AquaBeacon/mechanical/parts/common/exterior/cots/td04a_transducer/ref/user_photo_metal_replacement_20261021.png

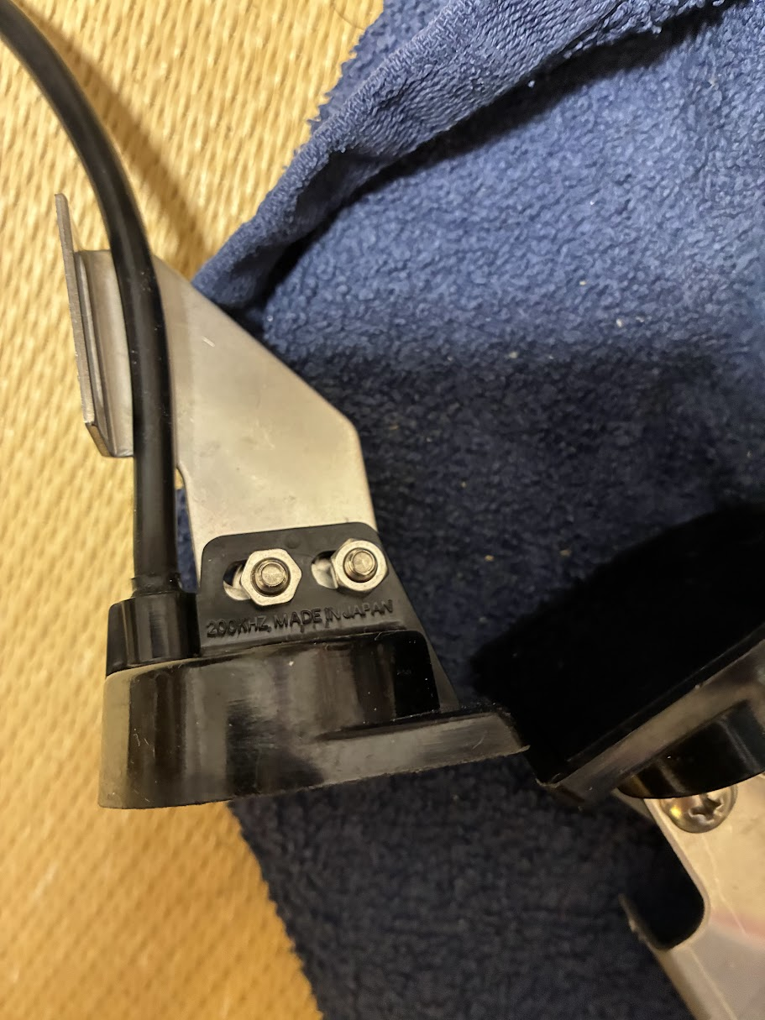
parts/common/exterior/cots/td04a_transducer/ref/user_photo_metal_replacement_20261021.png
