AquaBeacon/mechanical/docs/README.md

# 設計資料

- [AquaBeacon_機体設計](AquaBeacon_機体設計.md)
- [child_simple_mount_interface](child_simple_mount_interface.md)
- [子機横置き側面twist取付規格](child_horizontal_twist_interface.md)
- [design-workflow](design-workflow.md)
- [OpenSCAD / FreeCAD CAD基盤・編集手順・モデル分担](cad-foundation.md)
- [folder-organization](folder-organization.md)
- [X1C造形性監査](X1C造形性監査.md)
- [子機フランジねじ穴検証](子機フランジねじ穴検証.md)
- [子機内装_サービス設計](子機内装_サービス設計.md)
- [子機内装_収まり検討](子機内装_収まり検討.md)
- [子機外装_topopt実行計画_20260910](子機外装_topopt実行計画_20260910.md)
- [子機外装_改善要件](子機外装_改善要件.md)
- [子機外装フレーム再設計_要件](子機外装フレーム再設計_要件.md)
- [親機内装_収まり検討](親機内装_収まり検討.md)
- [部品一覧](部品一覧.md)
- [配線・ケーブル計画](配線・ケーブル計画.md)

- [親機・北側ペネトレータと床板の改訂](../assemblies/parent_hand_service/plate_access_report.md)（2026-10-27、現行の締結・着脱・印刷手順）
