AquaBeacon/mechanical/assemblies/parent_spar_concept/README.md

**印刷一式:** [parts/PRINT.md](parts/PRINT.md)（STL・数量・モディファイア） · **確認画像:** [_work/images/](_work/images/)

# parent_spar_concept

- [parent_spar_concept.md](parent_spar_concept.md)
- [adapter.step](adapter.step)
- [adapter.stl](adapter.stl)
- [coupler.step](coupler.step)
- [coupler.stl](coupler.stl)
- [disk.step](disk.step)
- [disk.stl](disk.stl)
- [fin.step](fin.step)
- [fin.stl](fin.stl)
- [hub.step](hub.step)
- [hub.stl](hub.stl)
- [parent_spar_concept.scad](parent_spar_concept.scad)

構成と既存の未検証事項は上の設計説明を参照してください。
