AquaBeacon/mechanical/spec/child_interior_reinforcement/README.md

> 2026-09-27現行: Bambu PLA Matte向け、60 mm根元・20 mm固定座・局所フランジ受け足、前側梁10 mm。印刷設定と解析の限界は spec/child_interior_reinforcement/PLA_MATTE_REVISION.md。以下の旧寸法・材料待ち記述は履歴です。

> 2026-09-27現行版：下リブ廃止、WetLink M10×5実配置、電池サービスねじをZ36へ移動。手順と検証は `spec/child_interior_reinforcement/SERVICE_REVISION.md`。以下は旧版の履歴を含みます。

> 現行版: 印刷部品による閉じた耳・31 mm根元補強。追加の金属スリーブ・板は廃止。強度解析は材料／荷重条件待ち。詳しくは `spec/child_interior_reinforcement/PRINTED_REINFORCEMENT.md`。以下は過去の履歴を含む。

# C-MAIN縦置き内装の固定部補強・LCD撤去

**現行は破損報告を受けた再補強版。[CRUSH_PROOF.md](CRUSH_PROOF.md)を参照。**
以下は最初の補強版の記録。

2026-09-26。対象構成はユーザー確認済み。

## 変更

デッキ左右ラグを丸い点状パッドから接線方向11.4 mmの丸端パッドへ変更。
基板端とチューブの間は狭いため、半径方向の最小肉厚は約0.8 mmを維持し、
接線方向の肉とデッキへ荷重を伝える斜めリブを増やした。
ラグ根元はX44.5..49.3、根元リブはZ20..29。
M3穴位置、MF10スペーサ、ラグ厚5.5、固定ねじM3×10は従来と同じ。

LCD、ベゼル、ヒンジ枠、上下アーチ、LCD専用ねじ・フォーム・ハーネスを組立から除外。
旧LCD部品ファイルは過去構成用に保存。
下アーチは専用child_flange_braceへ置換して3点固定を維持。
C-MAIN上側はM3×8なべねじ2本で固定する。

## 印刷と組立

交換する印刷部品はchild_vtray_deck_t200とchild_flange_brace。
デッキは板を寝かせてボス側を上、ブレースはZ5面をベッドへ。
外周5周以上を目安に固定耳と根元を密に充填する。
LCD用スペーサは下側のMF30 / MF17各1本のみ再使用し、上側は撤去。
新しくM3×8なべねじ2本を用意する。
フランジねじは樹脂が変形するほど締め込まない。

強度改善は形状に基づく設計判断。破壊荷重や安全率は未測定。
STL/STEP生成、基板穴照合、容器包絡、接触検査の結果は同フォルダのログに保存。
deck_before.scadとplacement_before.jsonは変更前の記録。

## 検証結果

- 基板3枚の取付穴位置・ねじ径：全点一致（holes.log）。
- チューブ包絡：干渉なし。デッキ最小すきま1.01 mm、ブレース1.11 mm。
  既存センタリングリブ0.50 mm、ライト配線0.54 mmは狭隙間WARN。
- 最終補強部：trimeshで水密、一体形状、周辺部品との新規干渉なし
  （changed_contacts.log）。スペーサ端面付近は梁を絞り、金属座の逃げを維持。
- 全内装接触検査：浮き部品なし。ただし既存の配線包絡同士、配線と基板等の
  重なりがあるため、全アセンブリを干渉ゼロと判定してはいない。
- OpenSCAD出力とFreeCAD STEP：外形・体積照合済み。
  旧inspect_meshの生エッジ判定はブレースの丸め誤差を開放辺と報告するが、
  頂点統合後のtrimesh検査では水密・1成分。
- 最終組立STEPを読み戻して配置照合：内装72部品、縦置き全体79部品とも
  NGゼロ（assembly_final.log）。

接触検査はサンプリング方式。実物の嵌合と耐荷重確認は未実施。
