AquaBeacon/mechanical/assemblies/parent_hand_service/retrofit_report.md

2026-10-24追補：Sony固定板は割れ対策の厚3.2 mm版を1個再印刷する。基板を1.6 mm上げる。再使用の対象からこの板を除外する。詳細は [増厚報告](sony_plate_thickening_report.md)。

# 親機内装・床板再利用改良（2026-10-24）

状態：実物嵌合確認用の試作設計。印刷入口は [parts/PRINT.md](parts/PRINT.md)。最終検査の機械可読記録は `_work/analysis/retrofit_20261024/release_record.json` と各 survey JSON。実物組立、積層強度、疲労、クリープ、防水性能は未認定。

## 再利用と交換

- 最下段 `floor_plate` はSCAD・STEP・STLのSHA-256を変更前と照合し、形状・穴を変更しない。再印刷・穴拡大・追加穴あけは不要。
- LiPo台・蓋・固定具、GNSS／磁気センサ支持枠、アンテナ鋼板を再利用する。
- MAIN固定板・アンテナラック・従来のMAIN/Sony/GNSSスペーサを新しい枠と固定柱へ交換する。
- コード巻リングはケーブル入口を上へ開いた `ann_mb1_coax_ring_service` に交換する。容器ねじの工具通路、床側の既存穴、巻き領域OD100/ID75/H10は維持する。
- 交換印刷は16種類16個。Sony固定板を含む。旧 `cradle_nut_keeper` 4個は使用しない。購入品の同軸ケーブル参照モデルは印刷しない。

## 配置

| 対象 | 変更 |
|---|---|
| MAIN基板 | 上へ3 mm、基板下面Z45。固定板の梁下面はZ37.1 |
| アンテナ・鋼板 | 南へ12 mm、上へ8.8 mm。アンテナ上端Z95.9 |
| 電源基板 | 元の向き（追加180°回転なし）のまま、南へ11 mm、上へ5.5 mm。基板下面Z33.8 |
| GNSS・磁気センサ支持枠と実装品 | 上へ16 mm。ユニバーサル基板下面Z72 |
| Sony・LiPo・TX | 位置を維持 |

RTCは現行CADの部品上端に10 mmを追加した予約空間で確認する。実測高さではない。アンテナ棚を南へ逃がし、ケーブルもこの予約空間から外す。

**ふた屋根Z97.1に対するアンテナ上の公称すきまは1.2 mm。** ケースの実寸・反り・アンテナ実物を確認し、ふたで押し込んで閉じない。既存ケースCADは図面由来で、実物測定済みを意味しない。

XTは差込方向20 mm、断面はCADコネクタ外形の各側へ2 mm追加した仮包絡。スイッチ操作は直径12 mmの西側進入包絡で検査する。実際のプラグ、指、工具の寸法は別途照合する。

## 締結の成立経路

床板上面へ開いた旧ナット穴を、上方向の引抜きを受ける面として使用しない。旧MAIN用4個とSony左奥の旧床ナットは取り除く。

| 締結 | 頭の座面から反力まで |
|---|---|
| GNSS/Sony柱の床固定 | 床裏のM3×20頭 → 座金 → 床板 → 柱下面 → 樹脂下穴。下側の公称かかり9.54 mm |
| コード巻・床側受け4点 | 床裏M3×20頭 → 座金 → 床板 → リング → 受けの樹脂下穴。公称かかり6.54 mm |
| 整備用4本 | M3×8頭Z36.84 → MAIN枠の足 → 床側受け上面Z33.4 → 樹脂下穴。公称かかり4.56 mm。床側ねじとの先端間隔0.50 mm |
| GNSS支持枠 | M3×10頭Z68.5 → 支持枠 → 柱上端Z66 → 樹脂下穴。キーを除く柱本体へのかかり7.5 mm |
| Sony固定板 | M3×10頭Z63.7 → 厚3.2 mmの固定板 → 柱上端Z60.5 → 樹脂下穴。キーを除く柱本体へのかかり6.8 mm |
| MAIN基板 | M3×8頭 → PCB → 一体ボス座面 → 樹脂下穴のねじ山。公称かかり6.35 mm、先端からボス下面まで1.5 mm |
| 電源基板 | M3×6頭 → PCB → アダプタ座面 → 樹脂下穴のねじ山。公称かかり4.35 mm、先端からボス下面まで1.15 mm |
| アダプタと床 | M3×8頭 → 1 mm沈めたねじ頭座面（残厚2 mm）→ アダプタ → 既存電源基板ボスの既存ねじ穴。公称かかり6 mm。樹脂ねじ部の保持力は実物未検証 |
| アンテナ棚とMAIN枠 | M3×30頭 → 棚 → Z50の接合面とキー → 下枠の樹脂下穴。キーを除く本体へのかかり7.6 mm。組立後はこの4本を整備で外さない |
| 鋼板・アンテナ | M3×8／M4×14頭 → 鋼板またはアンテナ足と鋼板 → 棚 → 下面から入れた六角ナット。上側の屋根が締付け力を受ける |

Sony左奥X144/Y211.5の床裏には容器ボスがあるため、そこへ裏ナット／ねじ頭を置かない。隣の既存GNSS床穴X135/Y219を使う低い連結部と2本の柱を一体化する。穴の追加はない。連結部の荷重下の変形・強度は未認定。

スペーサ・床側受け・MAIN枠の接合柱には内部ナット穴を設けない。旧ナットと抜け止めは使わない。アンテナ棚下面の6個は、印刷姿勢で上へ開く座のため継続する。樹脂下穴の締付け強度と繰返し着脱寿命は未検証。

## ねじとナット

改良部の必要数。既存部品から同じ規格のものは再利用できる。首下長の最大は30 mmで、50 mmを超えるねじは使わない。

| 金具 | 個数 | 用途 |
|---|---:|---|
| M3×6 | 4 | 電源基板を樹脂下穴へ直接固定 |
| M3×8 | 16 | 整備4、MAIN4、電源アダプタ4、鋼板4 |
| M3×10 | 8 | GNSS枠4、Sony固定板4 |
| M3×20 | 11 | 床裏から柱7・コード巻受け4 |
| M3×30 | 4 | アンテナ棚とMAIN枠 |
| M4×14 | 2 | アンテナ足 |
| M3ナット AF5.5×厚2.4 | 4 | アンテナ棚の鋼板固定。底面に開いた座のみ |
| M4ナット AF7×厚3.2 | 2 | アンテナ足 |
| M3座金 外径7／内径3.2／厚0.5 | 11 | 床裏 |
| M3×12 | 4 | 既存GNSSユニバーサル基板のM3×10から交換。既存M3ナット4個を再利用 |

ケース固定、LiPo、Sony基板、TX、磁気センサの金具は既存構成を引き継ぐ。新しい金具寸法は設計包絡であり、手持ち品の実測値ではない。六角穴頭の公称包絡はM3が径5.5×高さ3、M4が径7×高さ4。実物の頭・ナット・ねじ先端面取りを確認する。

## 組立順序

1. 電源とLiPoを外し、既存内装をケースから取り出す。床板・LiPo固定具を傷めず旧支柱と不要な床ナットを取り外す。
2. 内部ナット穴のない床側受け4個をコード巻リングに合わせ、床裏から座金＋M3×20を受けの下穴へ直接締める。床板とリングを確実に挟む。
3. GNSS/Sony固定柱を共有柱も含め床裏から7本のM3×20で直接固定する。上側の支持枠・固定板はM3×10を柱へ直接締める。
4. 電源アダプタを既存4穴にM3×8で固定し、元の向きの電源基板をM3×6で樹脂下穴へ直接取り付ける。XTの先20 mmとスイッチ操作路を空ける。
5. 既存GNSS／磁気センサ枠、新しい厚3.2 mmのSony固定板と実装品を新しい柱へ取り付ける。GNSSユニバーサル基板の4本はM3×12へ交換する。
6. MAIN基板をM3×8でMAIN枠の樹脂下穴へ直接取り付ける。アンテナ棚をキーに合わせて載せ、M3×30を4本締める。棚下面のナットを入れ、鋼板M3×8・アンテナM4×14を固定する。棚が分かれるので、実装済みMAINを狭い屋根の下へ滑り込ませる必要はない。
7. 同軸を巻き、左側の開いた入口へ2本の引出しを通す。アンテナ側の約235 mmの整備ループを確保する。ループを締め付けて固定しない。
8. 床をケースへ戻し、容器固定ねじを操作する。MAIN＋アンテナを載せ、整備用M3×8を4本締める。配線を戻し、ふたと各部品の実物クリアランスを確認する。

## 日常のコード巻整備

電源を切り、MAINにつながる必要な配線とGNSS側SMAを外す。床側受けへ締まる**M3×8の4本だけ**を外す。アンテナ側の余長を自由にし、MAIN＋アンテナを一緒に上へ持ち上げる。MAIN枠の側壁・アンテナ棚は一緒に残り、短い受けとコード巻は床側に残る。

上方120 mmの剛体部品の全経路を保守的な連続包絡で検査する。ケーブルは剛体移動させず、余長をゆっくり解く。端を引っ張らない。ケーブル変形・実際の巻き量・コネクタ取り外しの実物試験は未実施。

南西と北西の容器固定ねじはユニットを外してから既存の傾斜工具路で操作できる。南東側は既存LiPo台の手順を引き継ぐ。工具穴を配線で塞がない。

## 印刷

PETG、0.4 mmノズル、0.2 mm積層、壁4周、100%充填を基準とする。配布STLは製造設定の姿勢に合わせてベッド上へ移動済み。

- MAIN枠：下側をベッドへ。梁下面に必要な局所サポートは、組立前に開いた下面から除去する。
- アンテナ棚：鋼板の座面をベッドへ向ける。基本形状はこの姿勢で立ち上がる。
- 固定柱・受け・アダプタ・リング：平らな下面をベッドへ。細い柱にはブリムを付ける。
- 旧抜け止め4個：今回の内部ナット穴なし版では使用も印刷もしない。
- 側入れナット座の幅約6.7 mmは橋渡しとして扱い、取り出せない支持材を入れない。穴・座面・入口のバリを除去し、別体のナットで嵌合を確かめる。

閉メッシュ、CAD干渉、締結経路の形状検査は、実印刷や締付け強度の合格を意味しない。検査結果と未検証範囲は release_record と survey JSON を参照する。

## 再生成

形状の正本は `scad/lib/parent_service_retrofit.py`。既存 `spec/build_parent_hand_service.py --service-retrofit` から生成する。MAIN固定板の共通関数を再利用し、床板生成は実行しない。リング改訂は既存の `ann_mb1_coax_ring.step` への局所的な入口加工で、元のリングを上書きしない。各部品は従来の部品フォルダ内に1か所だけ置く。

独立FreeCAD検査用の入口は `spec/build_parent_service_retrofit_candidate.py`。配置、金具、サービス動作の検査後に `spec/publish_parent_service_retrofit.py` で反映し、assemblyを再ビルドして印刷一式を同期する。過去の裸の全体生成手順で古い配置へ戻さない。

## スライス確認結果（2026-10-24）

X1C／0.4 mm／Generic PETG／0.2 mm／壁4周／100%充填で2プレートをスライスした。設定済み [プレート1](print_jobs/retrofit_20261024/retrofit_plate_1.3mf) と [プレート2](print_jobs/retrofit_20261024/retrofit_plate_2.3mf) をプロジェクトとして開く。2枚で16個。予測は約161 g、合計約6時間20分（実印刷時間ではない）。

全19個に初層と上端付近の外周出力があり、造形範囲内に収まる。自動サポート45°、橋渡し除外OFF、局所支持材禁止を有効にした。ナット座・盲穴内部・抜け止め溝の検査域に支持材経路なし。MAIN枠の床面から3.7 mmまでの開いた梁下面、リング下面、Sony固定板の底面へ開いた位置決め凹部4か所の局所支持材は組立前に除去する。スペーサの縦下穴内には支持材経路がない。ボルト穴の下の空間にも支持材があるため、下側から完全に除去してからねじを入れる。

[実出力層・プレート1](_work/images/retrofit_plate_1_layers.png) と [プレート2](_work/images/retrofit_plate_2_layers.png) を確認した。小さな橋渡し、PETGの垂れ、嵌合と実締付けは実印刷で確認する。STLで再スライスする場合は parts/modifiers の該当ファイルを支持材禁止として読み込み、部品と同じ座標を保持する。モディファイア自体を印刷しない。

今回の基板直接固定版は2プレートともスライサが正常終了し、16個の実G-code経路と支持材禁止領域を検査した。前版の終了タイムアウトと回復検証は履歴として `_work/analysis/retrofit_20261024/slicing/timeout_recovery_review.json` に残す。

16種類のOpenSCAD再レンダリングは閉メッシュで、元STLとの外形差0.01 mm未満・体積差0.1%未満。棚下面のナット締結形状6箇所、基板の樹脂直接固定8箇所、支柱等の樹脂直接固定27箇所、床裏座面11箇所、選択した干渉1454組、剛体取り外し全経路を検査した。全組合せの接触検査、振動・衝撃強度や実物の合格を意味しない。

## 組立出力とリポジトリ検査

閉状態137部品、整備姿勢129部品のSTEP再読込・配置検査は不一致0。組立表示は [閉状態](closed.step) と [整備姿勢](service.step)。[閉状態画像](_work/images/retrofit_closed.png) と [取り外し画像](_work/images/retrofit_service.png) を確認済み。

親機改良の印刷一式と作業ファイル配置の検査は合格。全構成の検査には既存の別構成6件の更新不整合が残る（parent_integrated、parent_interior_p1/p2、parent_rope_float、parent_service_review、parent_spar_bolted）。対象は既存 parent_interior_layout.py や旧リポ固定具・説明の不一致で、今回の改良形状を反映する目的では変更していない。ツールテスト42件中41件合格、子機クランプの既存材料カード不足による1件のエラーは未解消。

改良前配置から検査を再実行するときは placement_before_retrofit.json を入力依存ファイルに含める。検証の元入力と生成元のハッシュは各release runのjob.jsonに保存されている。現行配置へ同じ移動量を二重に適用しない。

## 電源基板の元の向きとPico高さの追補

ユーザー指定により電源基板の追加180°回転を取り消した。旧位置から南11 mm・上5.5 mmに置き、XTの前方20 mm（断面はコネクタ外形に各側2 mm追加）を空ける。MAIN枠は後端中央だけに逃げを設け、四隅のボスと左右の支持経路を残した。床板・LiPo固定具は変更しない。直前版から設計形状を変更した印刷部品は main_service_frame と power_adapter。再生成時の面分割で他STLのハッシュが変わる場合がある。

Pico 2 WはMAIN基板上面Z46.6から17 mm、上端Z63.6の包絡で確認した。XYは22×54.6 mm（モデル外形へ片側0.5 mm追加）。アンテナ棚まで3.8 mm、鋼板まで8.8 mm。高さ18 mmの確認用包絡でも棚まで2.8 mm残る。Pico包絡を含む上方120 mmの整備動作も検査した。表示用MAIN基板の既存STEPには低いPico参照モデルが含まれるため、高さ判定は表示の見た目ではなくこの実測条件の包絡による。

今回の検査入力・出力は `_work/analysis/retrofit_20261024/orientation_review`、採用した各CAD runは更新済みrelease_record.json。14 mm以上の前方移動案には干渉があり採用していない。固定ねじの頭を1 mm沈めた4箇所は、下向き0.1 mmの反力面検査で頭と座面、アダプタと床ボスの接触を確認した。樹脂ねじ部の実物保持力、プラグ実物、手作業の取り回しは未試験。

## 基板の樹脂直接固定への変更

MAIN4か所・電源基板4か所のナット穴を廃止し、子機child_vtray_deckの公称Ø2.8 mmを参考に、内接径2.8 mmの補正八角下穴へM3ねじを直接締める。MAINはM3×8、電源基板はM3×6。穴入口は0.15 mm面取り。既存のボス外形・座面高さ・基板配置を維持し、初回は基板を載せる前にねじを垂直に手で馴染ませ、切粉を除く。電動工具で締め込まない。

締結経路はねじ頭→PCB→樹脂座面→下穴に形成されるねじ山。図面上のかかり長さは完全な有効ねじ山長さや強度保証ではない。実物のねじ形状、PETGの成形誤差、締付けトルク、繰返し脱着寿命は未確認。下穴とねじ山包絡の干渉は意図したかみ合いとして、他部品との干渉から区別して検査する。8か所の軸方向12断面、下穴の貫通、先端余裕、PCBを介した両座面の反力を記録する。

この段階では日常整備の4本・床側・棚接合をナット式としていたが、次節の改訂で樹脂直接固定へ変更した。既存のGNSS・Sony・磁気センサ固定具はこの変更の対象外。最下段プレートの再印刷・追加加工は不要。今回再印刷する変更部品はMAIN枠と電源アダプタの2種類。検査記録は `_work/analysis/retrofit_20261024/direct_pcb/`。

変更部品の確認画像：[MAIN枠](_work/images/main_service_frame_direct_pcb.png)、[電源アダプタ](_work/images/power_adapter_direct_pcb.png)。

## スペーサ内部ナット穴の廃止（現行）

造形失敗への対応として、GNSS/Sony支柱7部品、床側受け4部品、MAIN枠の棚接合柱4か所から、計27か所の内部ナット穴を撤去した。縦方向の内接径2.8 mm下穴へM3ねじを直接締める。側入れ穴・閉じた六角空洞・ナット抜け止め溝をなくした。抜け止め4個は構成から除外し、印刷一式は16種類16個となる。

床側受けは下M3×20／上M3×8で先端間隔0.50 mm（公称）。実ねじの長さ・先端を確認し、長いねじに置き換えない。底側の固定は床板とリングを挟み、整備時は上側の4本だけを外す。ナットが落ちる構造はなくなるが、樹脂ねじの摩耗寿命は未確認。最下段プレートとLiPo固定具の再印刷・加工は不要。

直前の基板直接固定版からの変更対象はMAIN枠、床側受け4種、GNSS/Sony支柱7種。アンテナ棚の下面に開いたナット座6個はスペーサ内部の空洞ではなく、印刷時に上へ開くため残す。既存GNSS基板・磁気センサ等の金具は継続。検査記録は `_work/analysis/retrofit_20261024/plain_spacers/`。

並行作業で確定したSony固定板の厚さ3.2 mm・基板高さ+1.6 mmも取り込み、印刷一式へSony固定板を追加する。支持面Z60.5は維持、上側M3×10の頭座はZ63.7。Sony板は旧品再使用ではなく新版を印刷する。基板下面はZ67.2となり、再生成後の周囲との干渉を追加検査する。

[スペーサの外観と縦断面](_work/images/plain_spacers_review.png)：手前は完成形、奥は検査用の半断面。床側受け・GNSS柱・Sony柱とも縦下穴だけで、内部ナット座と横挿入穴はない。断面モデル自体は印刷しない。
