AquaBeacon/mechanical/assemblies/parent_hand_service/sony_plate_thickening_report.md

現行スペーサは後続改訂で内部ナット穴を廃止し、M3×10を樹脂下穴へ直接締める。増厚寸法・座面高さは本書の値を継続する。最新の支柱固定・スライス結果は [内装改良報告](retrofit_report.md) を参照。以下のナット保持検査は増厚時点の履歴。

# SPRESENSE固定板の増厚 — 2026-10-24

ねじ止め時に固定板が割れた実物報告を受け、`sony_mount_plate` の肉抜き板と支柱ねじ座を厚1.6→3.2 mmへ変更した。設計寸法は `scad/lib/parent_gnss.py`、形状の正本は既存 `scad/lib/parent_corner_mounts.py` の `sony_shapes`。対象だけの再生成入口は `spec/build_parent_sony_plate.py`（既存CadServiceのbuild_native）。

再印刷は [parts/sony_mount_plate.stl](parts/sony_mount_plate.stl) **1個**。印刷入口は [parts/PRINT.md](parts/PRINT.md)。PETG、0.2 mm層、4周壁、100%充填、板下面をベッドへ向ける。既存の柱・穴位置・位置決めキー・板外形64×84 mmは維持する。キー穴入口は既存の取合い寸法、外周・肉抜き縁は既存0.15 mm面取り。

板下面Z60.5、板上面Z63.7、基板ねじ座上面Z67.15。基板原点はZ65.6→67.2、基板用M2.5×6ねじ頭の座面はZ68.8。基板裏面と板の公称余裕0.55 mm、TX予約上面と板下面の隙間0.305 mmは維持。基板と配線を外して交換し、上側の基板を元より1.6 mm高く取り付ける。

締結経路は、支柱固定用M3×10の頭座面Z63.7→厚3.2 mmの固定板→支柱上面Z60.5→支柱の反力部。ねじ先端Z53.7、支柱側の公称かかり6.8 mm。基板用M2.5×6は基板厚1.6 mmを挟み、ねじ座へ約4.35 mmかかる。ねじ先端Z62.8で板下面より2.3 mm上にある。上面へ抜けるナットだけに頼った固定として扱わず、今回の配置にある支柱ナットの+Z保持面と着座も検査した。支柱上部は組付け前にアクセスでき、板を外す際は基板を先に外す。

検査記録は [_work/analysis/sony_plate_thickening_20261024/geometry_checks.json](_work/analysis/sony_plate_thickening_20261024/geometry_checks.json)。FreeCAD有効単一ソリッド、保存・再読込、閉STL、周辺形状との干渉、支柱ねじ4本の頭座・穴通過・かかり、ナット保持面、基板ねじ4本の長さを確認した。旧薄板は同解析フォルダ内のhistoryへ保持する。

X1C・0.4 mm・Generic PETG・0.2 mm層・4壁・100%充填で実スライス済み。見積り9.34 g、30分29秒。45°自動支持・全表面・橋の支持除外なしで104移動の支持押出しがある。下面のキー穴付近の支持を除去し、座面と穴を確認する。初層・キー穴天井・板上面・ねじ座の実経路を確認した。[設定済み3MFと検査記録](print_jobs/sony_plate_thickening_20261024/README.md)。

厚くした形状の幾何・スライス検査であり、締付トルク・樹脂ねじの保持力・反復寿命・割れ防止の実物保証ではない。実印刷後は座面のバリや支持材を除去し、基板を反らせない範囲で締める。旧Sony板のスライス・強度記録を新版の合格根拠には使わない。

印刷一式は17種類20個（今回再印刷するのはSony板1個）。対象の出所・数量検査と作業ファイル整理検査は合格。全体出所チェックでは対象外の親機6構成に再ビルド／再同期の指摘が残る。共通テスト42件は41件合格、対象外 `child_wte4_suspension_clamp/spec/bambu_petg_basic_material.json` 欠落で1件エラー。今回の部品形状の不合格ではなく、全リポジトリ合格とは報告しない。ログは同解析フォルダの `global_parts_check.log` と `unittest.log`。

統合版のスライス確認：`print_jobs/retrofit_20261024/retrofit_plate_2.3mf` に厚3.2 mmの板を1個配置。X1C・Generic PETG・0.4 mmノズル・0.2 mm積層・壁4周・100%充填で実G-codeを確認。底面に開く位置決め凹部4か所の支持材は、組立前に下側から除去する。支持材不要ではなく、実印刷・嵌合・締付けは未確認。出力ハッシュは同フォルダmanifest.json。
