AquaBeacon/mechanical/assemblies/parent_hand_service/unified_support_report.md

# 2026-10-29 床板下面の開放ナット座

現行の印刷入口は [parts/PRINT.md](parts/PRINT.md)。床板の裏面からM3ナットを差し込める六角くぼみを11か所設け、上からの貫通ねじで固定する。ナットは印刷完了後に取り付ける。印刷途中の埋込みや横挿入トンネルはない。

## 形状と締結

ナットは対辺5.5 mm・厚さ2.4 mmの既存M3モデル、六角くぼみは対辺5.8 mm・深さ2.6 mm。入口に0.15 mmの案内面を設ける。床板下面Z8.84、ナット受け面Z11.44、床板上面Z18.8。受け面から床上面まで7.36 mmを残す。六角の回り止め面と平らな反力面は機能面として角を保持する。

右端2か所はケース壁へ部品を広げず、既存の床端にくぼみが一部開く。ナットの回転と締付け方向の移動が残る面で止まることを検査対象とする。緩めたナットを下向きに保持する構造ではないため、組立時はケース外で床を横向きにし、指でナットを押さえてねじを数山かける。接着剤は不要。

| 固定箇所 | ねじ・ナット | 締結経路 |
|---|---|---|
| MAINの4点 | M3×30＋M3ナット、各4 | 頭（Z35.6）→MAIN枠→床側受け→同軸リング→床板→下面ナット |
| GNSS支持枠4点 | M3×65＋M3ナット、各4 | 頭→GNSS固定板→50 mmの足→床板→下面ナット |
| Sony支持枠3点 | M3×65＋M3ナット、各3 | 頭→Sony固定板→50 mmの足→床板→下面ナット |
| Sony後左1点 | M3×10、1本 | 上板→足の樹脂下穴。ケースのボスを避け、床貫通ねじは追加しない |

締めると、上のねじ頭が上板／枠を下へ押し、下面ナットが床板内の受け面へ上向きに引かれる。この経路で床板を挟む。床用の座金9枚と、従来の下面からのねじ11本は使用しない。長いねじの経路は通し穴へ変更し、樹脂ねじとの二重締結にしない。

Sony/GNSSの各4本の足は一体構造のまま。床上面から上板下面まで50.0 mm、位置決めキーは別に0.8 mm。基板・配線の高さと配置、M4頭逃げ、北側ペネトレータ2個を残して内装を引き抜く形状は維持する。

## 組立・取り外し

ケース外で床板・受け・同軸リング・支持枠・上板を合わせる。下面からナットをくぼみへ入れ、上からねじを差し、床を横向きにしてナットを指で仮保持しながら数山かける。全ねじを軽く合わせてから締める。MAINはアンテナ棚を取り付ける前に固定する。Sony後右のねじはSPRESENSE基板が工具通路を塞ぐため、支持枠のねじを先に締め、その後で基板を取り付ける。分解・増締めは先にSPRESENSE基板の固定4本を外して基板を退避する。基板を載せたままでの工具アクセスは未達であり、保証しない。蓋を外した状態で上側から工具を入れる。

内装全体の取り出しはケース側配線とM4固定3本を外し、真上へ120 mm持ち上げる手順を維持する。ナットは締結中には床裏へ抜けない。支持枠やMAINを分解するときは内装をケース外へ出し、ねじを抜く前に床裏のナットを受ける。

## 印刷

再印刷は床板、MAIN枠、Sony支持枠、GNSS支持枠の4個。一式は15種類・各1個で、上板などは再使用する。PETG／X1C 0.4 mm／0.2 mm・壁4周・100%充填。下面をベッドへ置く元の印刷姿勢を維持する。床のナット座は下面へ開いており、天井の短い橋（最大約6.7 mm）は局所支持材禁止モディファイアを使って検査する。実造形の橋品質は試作確認。印刷途中でナットを挿入する停止工程はない。

変更前の形状・配置・文書は `_work/analysis/underside_nuts_20261029/history/` に保存。既存Python生成元を更新し、STLとSTEPを同じ形状から生成する。位置と個数はplacement.jsonが正本。

幾何検査と実物の締付け強度を区別する。樹脂の座面耐力・クリープ・波浪・実印刷・実工具・ハーネスの余裕は未認定。

## 検証記録（2026-10-29）

組立CADの357項目がPASS。11か所について、下面からの連続挿入、ナットとケースの非干渉、締付け方向への移動が床の受け面で止まること、両方向10°の回転が六角面で止まること、ねじの全ナット厚へのかかり、上側の座面と工具通路を検査した。足の一体性・50 mm、M4頭、蓋・実装部品との干渉、M10を残す引抜き経路も再検査した。

Sony後右は、基板を装着したままでは工具が干渉する。これは合格に読み替えず、SPRESENSE基板を外すことを作業の前提条件として記録した。締結済みのねじ頭と基板自体は非干渉。

根拠は [_work/analysis/underside_nuts_20261029/assembly_checks.json](_work/analysis/underside_nuts_20261029/assembly_checks.json)。[底面図](_work/images/underside_nut_floor.png)と[GNSS締結断面](_work/images/underside_nut_clamp_section.png)を保存した。

同時に変更された電池本体・蓋は上方取り外し版を保持する。電池側の交換部品と手順は [電池蓋の改訂報告](battery_top_lid_report.md) を参照。今回の床・支持枠4部品の交換とは別の変更である。

共通ツールの単体テストは42件中41件成功。既存の子機用bambu_petg_basic_material.json欠落により1件失敗。記録は `_work/logs/underside_nuts_unit_tests.log`。

### 印刷データの検査

変更4部品を2プレートへ配置し、支持材自動検出を有効にしてスライスした。ナット座11か所と検査対象のねじ通路に支持材押出しは0。床のナット座付近でブリッジの経路を確認した。4部品とも最初のモデル外周はZ0.2 mm、最終外周はモデル上端まで出力されている。実物のブリッジ品質と締付け強度は未確認。

- [プレート1：床板](print_jobs/underside_nuts_20261029/parent_underside_nuts_1.3mf)
- [プレート2：MAIN枠・Sony支持枠・GNSS支持枠](print_jobs/underside_nuts_20261029/parent_underside_nuts_2.3mf)
- [設定・STLハッシュ・G-code検査記録](print_jobs/underside_nuts_20261029/manifest.json)

局所支持材禁止モディファイアはparts/modifiersへ同梱。変更していない関連7部品は現行生成元から再生成し、既存STLと完全に同じSHA-256であることを確認して鮮度を揃えた（`_work/analysis/underside_nuts_20261029/unchanged_rebuild_checks.json`）。電池側の部品データは置換していない。

組立状態・サービス状態のSTL/STEPを再生成し、STEP照合も完了。印刷用4部品は3MF記録のSHA-256と一致。parent_hand_serviceの印刷一式検査と作業ファイル配置検査はPASS。全構成の検査では対象外7構成に既存の未同期／管理外ファイル等が残る（`_work/logs/underside_nuts_all_parts_check.log`）。

---

以下は2026-10-28以前の変更履歴。床下面から樹脂下穴へ締める手順・ねじ長・旧3MFを今回へ適用しない。

# 一体支持枠と埋め込みナット廃止（2026-10-27）

現行の設計方針と手順はこの文書を正本とする。[印刷入口はparts/PRINT.md](parts/PRINT.md)。前回の床内部へ横からナットを挿入する構造と、独立したSony／GNSS柱は廃止する。埋め込みナットを残した前回のSTL・3MFを今回の部品と混ぜない。検査結果は末尾へ追記する。実印刷・締付け・強度の認定ではなく、嵌合確認用の試作。

## 足を一部品へまとめる

SPRESENSE側はsony_support_frame、GNSS側はgnss_support_frameを各1個使う。それぞれ4本の足を下側の連結材でつないだ単一ソリッドで、組立時に個別の足を支えたり向きを合わせたりする必要をなくす。上の固定板は別部品として着脱する。

両方の足の長さは、床板上面Z18.8から固定板下面Z68.8までの50.0 mm。位置決めキーの高さ0.8 mmは足の長さに含めない。SPRESENSE固定板・基板一式は前回より8.3 mm、GNSS固定板・基板・磁気センサは2.8 mm上へ移動する。基板の穴配置と取付相手は維持する。配線には高さ変更分の余裕が必要。

Sony側は北へ開いたU字枠。前側の連結材は幅4 mm・高さ4 mm、中心Y131.4で、電池台の北端とTX基板の下面ピンの間を通す。TXの実取付穴に対応する床側座へ半径3.8 mmの逃げを設け、前側に公称2.3 mmの連結幅を残す。後側のTXねじ座と北側ペネトレータへ連結材を渡さない。GNSS側の左連結材は北西のM4頭とケース隅の柱を回避して曲げる。足と連結材は下面をベッドへ向ける原姿勢で印刷する。外周と接合部に0.1 mm、穴口に0.15 mmの面取りを設ける。ねじ下穴の指定断面と平らな接合面は機能寸法を優先する。

## 埋め込みナットを使わない締結

床板は普通の通し穴に戻し、内部の六角穴、横挿入口、ナットを覆う屋根をなくす。床の下面からねじを上向きに入れ、支持部品の樹脂下穴へ締める。頭と支持部品の間に床板を必ず挟む。樹脂下穴はM3用の内接径2.8 mm、8角形とし、既存の直接ねじ止めと同じ設計値を使う。ねじ山の耐力・適切な締付けトルク・繰返し着脱は実物確認が必要。

| 箇所 | ねじ | 固定の経路 |
|---|---|---|
| MAIN枠の床固定4点 | M3×30、下面から上向き | 頭 → 外付け座金 → 床 → 同軸リング → 床側受け → MAIN枠の樹脂下穴。公称かかり4.94 mm |
| GNSS支持枠の床固定4点 | M3×16、下面から上向き | 頭 → 外付け座金 → 床 → 一体支持枠の樹脂下穴。公称かかり5.54 mm |
| Sony支持枠の床固定3点 | M3×16、下面から上向き | 頭 → 床 → 一体支持枠の樹脂下穴。左前のみ外付け座金を使用し公称かかり5.54 mm、右2点は頭を直接座面に当て公称6.34 mm |
| GNSS固定板4点 | M3×10、上から | 頭 → 固定板 → 50 mmの足の上端・樹脂下穴。公称かかり7.5 mm |
| Sony固定板4点 | M3×10、上から | 頭 → 固定板 → 50 mmの足の上端・樹脂下穴。公称かかり6.8 mm |

Sony後左の足の下にはケースの既存ボスがあるため、新しい床貫通ねじは追加しない。床に着座させ、他の3本へ連続する枠で保持する。以前のGNSS／Sony共有柱と柱内部のナットは使わない。

右端のSony床ねじ2点は、座金と座面をケース壁へ拡張せず、既存のM3頭径5.5 mmを床下面の深さ0.3 mm・径5.7 mmの開放座ぐりへ直接当てる。旧穴入口の面取りを座面から除去し、平らな環状座面で受ける。これは埋め込みナット穴ではない。座ぐりの反力面の縁は機能面として保持する。頭の座面と穴の間の公称半径方向肉厚は1.0 mm。座面の接触とケースとの干渉を検査対象に含める。この寸法を締付け強度の保証として扱わない。

前回のM3×60／65の長い貫通ねじ、床ナット11個、Sony共有柱のナットは使用しない。床固定用のM3座金は外径7・厚0.5 mmを9枚使用する。固定板の上向き位置決めキーはねじの代わりの抜け止めではない。

ほかの印刷部品のナット埋め込みも廃止する。電池蓋は従来のM3×12を、電池台の縦2.8 mm下穴へ直接締める（公称かかり9 mm）。アンテナ棚の鋼板とアンテナは、棚下面へ露出したナットと座金で挟む。鋼板用はM3×10／M3ナット／M3座金を各4、アンテナ用はM4×18／M4ナット／M4座金を各2。ナットは棚をMAIN枠へ載せる前に外から保持して締める。磁気センサも底面へ露出したナイロンM2ナット・厚0.5 mmの座金とM2×10で固定する。GNSS基板の既存の下面露出ナット、ケースの購入品インサート、WetLink付属ナットは維持する。

## 組立と取外し

1. 床板をケースの外で組む。2個の支持枠とMAIN側の受け・同軸リングを載せ、床下面からねじで固定する。ナットの挿入や仮保持は不要。
2. 各上板へ基板を取り付ける。GNSS基板と磁気センサのナットは、上板を足へ載せる前に下から保持して締める。
3. 上板を4本の足のキーへ合わせ、それぞれ4本のM3×10で固定する。
4. アンテナ棚は外付けナットで鋼板・アンテナを先に固定し、その後でMAIN枠へ取り付ける。
5. 電池蓋をM3×12で台の縦下穴へ固定する。下穴を空回りさせる締付けや長すぎるねじを使わない。
6. WetLink M10と付属ナットを2個ともケースへ残し、北側の切欠きを合わせて内装を下ろす。ケースのM4固定3本を締め、配線を接続する。
7. 内装を取り出すときは配線とM4固定3本を外し、真上へ120 mm持ち上げてから箱の横へ移す。床下面のねじを外す必要はない。WetLinkナットへの専用レンチ操作は内装取外し後に行う。

北側穴は、A面を外から見た左端から35／60 mm、箱座標X175／150、外底面から高さ30〜35 mm。M4頭の逃げ10.8 mmと北側の開放切欠きは維持する。実M4の頭高さ・首下長さは未測定で、頭10×高さ5 mm、首下12 mmの参照包絡を継続する。専用M10レンチの通路は検査するが、任意のスパナ、ラチェットの柄、実ケーブルは共通の保証対象ではない。

## 印刷するもの

一式は15種類15個。変更する印刷部品は、床板、MAIN枠、アンテナ棚、電池台、GNSS固定板、Sony一体支持枠、GNSS一体支持枠の7個。Sony上板、同軸リング、電池蓋、電源アダプタ、MAIN側の床受け4個は同じ形状の既存品を再使用できる。

PETG／X1C 0.4 mm／0.2 mm積層／壁4周／100%充填を引き継ぐ。アンテナ棚は上面をベッドへ向けて反転、それ以外の変更部品は下面をベッドへ向ける。同梱STLは製造姿勢へ変換済みで、部品配置の回転を追加しない。支持枠には3 mmの外ブリムを使用する。ナットをまたぐ大きい屋根はなく、縦の樹脂下穴の止まり部分だけに最大約3.2 mmの小さい橋が残る。これはナット埋め込み穴ではない。実際の橋の品質とねじの嵌合は試作で確認する。

印刷一式の支持材禁止モディファイアも同じparts内へ含める。スライスでは支持材検出を有効にして下穴内の押出しを検査する。単に支持材を無効化した結果を造形成立の証拠にしない。

## 正本と検証

寸法と締結表はscad/lib/parent_service_datums.py、支持枠とMAIN／棚は既存parent_service_retrofit.py、床はparent_floor_access.py、電池台とGNSS上板は既存の生成元を更新する。出力SCAD、印刷STL、STEPを別々に設計しない。配置・数量の正本はplacement.json。

再生成は次の順で、各段階の成功を確認する。

```powershell
python spec/revise_parent_floor_access.py
python spec/revise_parent_floor_access.py --related
python spec/publish_parent_plate_access.py --prepare
python spec/revise_parent_floor_access.py --verify
python spec/publish_parent_plate_access.py
python spec/publish_parent_plate_access.py --assemblies
python spec/slice_parent_plate_access.py
python tools/assembly_parts.py check parent_hand_service
```

今回の変更前の原本と印刷形状は、_work/analysis/unified_support_20261027/history/へ保存する。前回のplate_access_report.mdと解析記録は履歴として保持する。STLの閉メッシュ、配置照合、干渉、締結経路、造形、実物の強度を区別して報告する。材料下穴の耐力、締付けトルク、クリープ、波浪、実配線、密閉・防水は未確認。

## 2026-10-28 引継ぎ後の検証結果

組立CADの239項目がすべてPASS。各4本の足は肩まで50.0 mm、キーを含むSTL高さは50.8 mm。両支持枠は単一ソリッド・閉メッシュ。床・上板との着座、樹脂下穴のかかりと底付き余裕、外付けナットの反力面、蓋との非干渉、M4頭、M10を残した連続引抜きとケース外での専用工具経路を確認した。

引継ぎ候補にあったSony前側連結材とTX取付座の干渉を、連結材移動と取付座の局所逃げで解消。右側床ねじ2点の座面は浅い座ぐりで平面化し、接触面積13.610 mm²を確認した。接触面積のみで強度を認定していない。全形状の新規剛性解析・実締付け・実印刷・実配線は未確認。

検査詳細は [_work/analysis/unified_support_20261027/assembly_checks.json](_work/analysis/unified_support_20261027/assembly_checks.json)。各生成と検査の入力ハッシュ・STEP/STL再読込は同フォルダのfloor_run.json、related_run.json、verification_run.jsonが指す独立runへ保持。確認画像は [_work/images/unified_support_assembly.png](_work/images/unified_support_assembly.png)（支持枠を青、対象基板を緑で表示。他部品は一部省略）。

共通ツールの単体テストは42件中41件成功。子機用のbambu_petg_basic_material.jsonが存在しないため1件失敗しており、親機の形状検査とは別の既存リソース欠落として記録する。

### スライスと納品

変更7部品をX1C／0.4 mm／PETG／0.2 mm・壁4周・100%充填で3プレートへ配置。支持材自動検出45°と橋の支持を有効にし、機能穴だけを局所モディファイアで除外した。全7部品で最初のモデル外周がZ0.2 mm、最後の外周が外形高さまであること、検査対象の下穴・座ぐりに支持材押出しが0であることをG-codeで確認。Sony/GNSSの止まり穴の短い橋の出力も記録した。実造形の橋品質と樹脂ねじの嵌合は未確認で、全面サポート不要とは認定していない。

- [プレート1：床板](print_jobs/unified_support_20261027/parent_unified_support_1.3mf)
- [プレート2：MAIN枠・アンテナ棚・Sony支持枠](print_jobs/unified_support_20261027/parent_unified_support_2.3mf)
- [プレート3：電池台・GNSS支持枠・GNSS固定板](print_jobs/unified_support_20261027/parent_unified_support_3.3mf)

STLハッシュ・配置・設定・検査結果は [スライスmanifest](print_jobs/unified_support_20261027/manifest.json)。同じ部品をpartsのSTLから重複印刷しない。追加した座ぐり・MAIN下穴・電池蓋下穴の支持材禁止形状はspec/slice_parent_plate_access.pyが生成し、parts/modifiersへ同梱する。印刷部品ではない。

現行parent_hand_serviceの出所・数量・鮮度チェックはPASS。全構成チェックでは他の7構成に不一致が残る。parent_integrated等の派生／旧構成は今回更新していない。詳細は [_work/logs/unified_support_all_parts_check.log](_work/logs/unified_support_all_parts_check.log)。画像・中間ファイルの整理検査はPASS。

閉状態のparent_hand_service.step／closed.stepと整備状態service.stepを配置正本から再生成し、各STEPの再読込検査が成功。今回起動したCAD・OpenSCAD・スライサの記録PIDと開始時刻を照合し、残存プロセスがないことを確認した。
