AquaBeacon/mechanical/assemblies/parent_hand_service/battery_box_report.md

# 親機LiPoボックス：左右端から出るコードへの対応

2026-10-11。子機内装の端面リード逃げ・着脱板を参考にし、親機は既存の上蓋を維持して配線側端面を全面開放した。中央16 mmの窓と上の屋根では左右端の線が通らないため、床より上を内幅40 mm×高さ26 mmで開放。0.2 mm面取り。配線側の端フォーム2枚も省いた。

ボックスの開放端

電池と蓋の上抜き（確認用の分解表示）

## 変更範囲

変更した形状はbattery_baseと、同じボックスに入れる非印刷フォームbattery_pads_open_endだけ。外形・床厚3 mm・床固定4穴・蓋4穴・蓋・ねじ・ナット・電池の位置は維持。MAIN、SPRESENSE、TX、PWR、GNSS、アンテナ、容器、スペーサは変更しない。配置JSONの変更行はlipo_ret_padsの参照先だけ。全体STEP（closed 128項目・service 126項目）はこの配置から再出力し、各配置と一致した。

変更前の他形状/印刷コピーのSHA-256は維持。共有フォルダのSTL鮮度確認のため兄弟部品は既存STEPから実際に再メッシュし、元と同一バイト列であることを確認した。形状は変更していない。

## 収納・組立

内寸106×40×26 mm、公称電池102×34×23 mm。商品公差上限104×36×25 mmの剛体も干渉0。最大個体では公称向けフォームをそのまま使えないので、端・側・上の厚みを現物に合わせて選ぶ。配線端は開放され剛性ストッパがないため、残したフォームを軽く圧縮して保持する。保持力と波浪・クリープの実証は今回行っていない。

電源を外す→蓋のM3ねじ4本を外す→上蓋を上へ抜く→左右の線と電池を一緒に上へ抜く。箱を容器に入れたまま操作できる（容器の蓋は開ける）。

## 検証

23項目の局所検査PASS：開口全面、端フォーム除去、公称と最大電池本体、取付穴、周辺全部品、変更範囲。別途、独立OpenSCADレンダリングとSTEP/STLの一致、閉メッシュ、既存の電池上抜き・蓋・工具・両SD、スイッチ・TX上20 mm・容器閉蓋の再検査もPASS。証跡は_work/analysis/battery_box_20261011/と既存チェックJSON。線径・端子外形・外部曲げは未実測なので、実ケーブル全経路の干渉合格とは扱わない。

## 印刷

入口は[parts/PRINT.md](parts/PRINT.md)。交換用はそのフォルダのbattery_base.stlを1個。床下面をベッドへ、既存PETG・0.2 mm・4周・100%インフィル。自動サポート45°の同一X1Cプロファイルでは45.20 g、うちサポート1.89 g。ナット横穴等の短い屋根にはサポートが残るので除去後に穴・開口を確認。蓋・ほかの部品は再印刷不要。フォームは印刷しない。

設計正本：spec/build_parent_hand_service.pyのbuild_battery_base()。単独生成は--battery-only。全体生成元も同じフォームバリアントを選ぶ。旧ボックスは_work/analysis/battery_box_20261011/history/に保存。

現在の親機印刷一式・作業ファイル整理はPASS。全体の印刷一式検査では既存のchild_interior未管理3MF、parent_oneplate/parent_service_reviewの古い出力が残る。tools/testsは42件中、既存の子機材料JSON欠落で1件エラー。対象外部品は変更していない。旧ボックスのユーザー保存3MFはprint_jobs/battery_box_before_20261011/へ同一バイト列で移し保持した。
