AquaBeacon/mechanical/assemblies/parent_hand_service/battery_side_grooves_report.md

# 親機バッテリーボックス：端から全長差込みの側溝

2026-10-13。ユーザー指定の「端から全長分差し込む方式」を採用。長い側壁2面へ溝を掘り、蓋の両縁を配線側の端から107.4 mm全長にわたって案内する。突き当ててM3×12ねじ1本で固定する。

## 形状

溝は内面から深さ1.2 mm。外側に1.3 mmの壁を残す。溝の上面と蓋の縁を45°の斜面にし、片側の公称すきま0.3 mmを設けた。蓋は幅44.8 mmの平板に両側レールとねじ座の耳を一体化。両側レールが上への抜けを止め、既存位置のねじ1本が端方向への抜けを止める。

扱い縁は蓋0.15 mm、側溝0.025 mmの面取り。小さな側溝と既存の入口面取りが交差するため、外形・すきまを保持する局所寸法を選んだ。ねじ穴入口は0.15 mm、ナット差込み口は0.1 mm。ナット保持角と斜め天井内部の機能稜を維持する。

電池寸法、公称102×34×23 mm・最大剛体包絡104×36×25 mm、フォーム4枚、電池下の8 mm工具穴、配線端40×26 mm開口、蓋上面Z52を維持。最下段、MAIN固定板、同軸巻き部のSCAD・STEP・STLは変更前と同一SHA-256。

途中まで差し込んだ蓋

両側溝と蓋の断面

## 操作

取り付けは電池とフォームを収め、両側の縁を溝へ合わせて配線側から北へ約108 mm差し込み、M3×12ねじとM3ナット各1個で固定する。ナットは六角方向を合わせて側面から入れる。

**全長分の引出し空間が必要なため、防水容器内の取付位置では蓋を引き抜けない。** 電池交換は以下の順序で行う。

1. ケースのふたを開け、電源を切って電池リードを外す。
2. 蓋を付けたまま、電池台の既存M3×8固定ねじ4本を外す。
3. 閉じた電池ボックスを上へ約90 mm持ち上げ、容器の上で保持する。他の基板は外さない。
4. 蓋のM3×12ねじ1本を外し、配線側へ約108 mm引き抜く。
5. 電池を上へ取り出す。戻すときは逆順。

台の固定ねじ4本と、蓋の固定ねじ1本を区別する。南東の容器固定ねじは、電池ボックスを持ち上げると露出する。南西・北西の容器固定ねじへの従来の工具姿勢は維持する。ボックスを持ち上げる経路へ配線を結束しない。

## 印刷

入口は [parts/PRINT.md](parts/PRINT.md)。**電池台 `battery_base` と蓋 `parent_lipo_retainer_lid_slide` を各1個再印刷する。** 以前の2 mmフック版と組み合わせない。

電池台は [設定済み3MF](print_jobs/battery_side_grooves_20261013/battery_base.3mf) をBambu Studioでプロジェクトとして開く。ナット座と両側溝の支持材禁止パーツを組込み済み。STLなら、`parts/modifiers/` の2種類を電池台へ支持材禁止パーツとして追加し、同梱座標を維持する。モディファイアは印刷しない。以前のねじ穴対策を引き継ぎ、側溝内部に支持材を生成しない設定を追加した。

蓋は [設定済み3MF](print_jobs/battery_side_grooves_20261013/parent_lipo_retainer_lid_slide.3mf) または同梱STLを使用。平らな上面をベッドへ向けた姿勢に変換済み。指定スライスでは蓋の支持材は0 g。電池台は底面を下にし、他の取付座の支持材を除去する。

PETG、X1Cの0.4 mmノズル、0.2 mm積層、4周壁、100%インフィル、自動支持45°／ブリッジ除外。3MFと対応STLのSHA-256を同じ `print_jobs` の `manifest.json` に記録する。実印刷で溝のバリ・反り・全長の嵌合を確認する。

## 検証

`battery_slide_lid_checks.json`：実配置の静的干渉、閉じた電池ボックスの連続90 mm上抜き、蓋を付けたままの台固定ねじ4本への工具経路、持上げ後の蓋の連続108 mm引抜き、両側レールによる直接持上げの阻止、ねじによるスライド阻止、最大電池包絡、ナット挿入と保持を検査。

スライド経路には斜め断面を保つレールの正確な連続押出しを使い、面取り済みの実蓋が検査包絡に収まることも確認する。動作位置の飛び飛びのサンプルだけで判定していない。ボックスの上抜きはソリッドごとの保守的な直方体包絡を用いる。

`battery_nut_print_checks.json`：実G-codeを読み、ナット座・ねじ通路・左右の側溝に支持材の押出しが0件であることを確認。閉メッシュ、OpenSCAD独立レンダリングとSTEP/STL外形・体積、両組立STEPと配置も確認する。集約は `validation_current.json`。

幾何形状と指定スライス設定の検証であり、実印刷の嵌合・反り・摩耗・締付け・強度は未検証。以前の2 mm方式の操作記録は履歴。現行の電池交換は上記の全長差込み方式を使う。

解析・変更前原本は `_work/analysis/battery_side_grooves_20261013/`。再生成は既存 `spec/build_parent_hand_service.py --battery-only`、`spec/export_parent_lipo_retainer.py --slide-lid-only`、`spec/refresh_parent_case_screw_meshes.py --battery-side-grooves`、`spec/slice_parent_simple_stack.py --battery-side-grooves after battery_base parent_lipo_retainer_lid_slide`、`spec/prepare_parent_battery_support_project.py --battery-side-grooves`。印刷一式を同期・検査して使用する。
