AquaBeacon/mechanical/assemblies/parent_hand_service/case_fit_report.md

> 履歴：MAIN/Sony支持簡略化前の結果です。現行は[corner_mount_report.md](corner_mount_report.md)を参照。容器形状と訂正履歴は保持しています。

# 親機：防水容器CADと内装嵌合の訂正

2026-10-11。メーカーPDF/DXFを読み直した参照CADで、床・ボス・四隅と本体／ふたの誤りを修正した。メーカー製STEPではなく、未図示の成形勾配と実物公差は未確認。原本は[メーカー図面](https://www.takachi-el.co.jp/assets/attachments/images/BCAS212310G.pdf)、再生成元はspec/build_bcas212310g.py。

| 訂正 | 現行 |
|---|---|
| 床 | 厚3 mm。誤っていた中央中実台を撤去 |
| 内側ボス | 床上7 mm、上面Z10。インサート4＋タップ12 |
| 四隅・壁 | DXFのC形隔壁と断面の側壁勾配 |
| ふた | 本体と別体、屋根下面Z97.1 |
| 内装床 | 四隅0.5 mm逃げ、全ボス逃げ、4座面がZ10へ接触 |
| 固定 | M4×12ボタン4本、公称ねじ込み5.2 mm。型番・実深さ要確認 |
| 配置 | LiPo北3.6、TX南4、GNSS後左脚東2.6 mm。基板高さ維持 |
| GNSS工具 | 後左脚と磁気センサの支柱の間に上方工具逃げ |

床と容器の平面確認

## 検証

図面由来CADに対し、部品の実STEP干渉、床板の上からの連続挿入、本体／ふたの閉鎖、4接触座、LiPoと蓋の取り出し、両SD・両電源スイッチ、TX実装全外形の上20 mm、箱外MAIN USB、GNSS／LIS3MDL操作、取付穴・工具、組立順、8本ランナーを検査しPASS。結果はvalidation_current.jsonと個別JSON。実物の嵌合や配線の把持を保証するものではない。

M3ナット座は床格子下面までつながる。Sony後左座の下面の一部は近傍タップボスを逃がし、残る3方向は格子下面まで連続、ボス上面より上は4方向とも連続。床自体は1連結ソリッド。旧「4方向とも全高」の検査は必須ボス逃げを不具合と数えたため、実ボス高さで区切って検証する。剛性の認定には使用しない。

## 印刷

入口は[parts/PRINT.md](parts/PRINT.md)。11種類各1個、ランナー切離し後18部品。PETG・0.4 mmノズル・0.2 mm積層・4周壁・100%インフィル。全11形状を実スライスし、STLハッシュを照合した。
使用量合計560.87 g、うちサポート11.64 g。8本スペーサセットのサポートは0 g。首の2層の押出し経路を確認。結果・3MF・ログは_work/analysis/case_cad_correction_20261010/slicing/。

## 適用限界

今回変更した床・Sony／GNSS台・支持位置の剛性解析は未実施。旧2g解析を現行合格として表示しない。旧Sony20Nの変位・強度不合格は履歴に保持し、解消済みと扱わない。メッシュ収束、実締結・緩み・クリープ・波浪試験も未完了。製造リリースは取合い試作。

ユーザーはメーカーSTEPを所有していないと確認済み。四隅の未図示断面・成形公差、実インサートとねじ、XH・LiPo実寸とリード、5 m同軸の実巻きは現物照合が必要。容器モデルを共有する他の旧内装・外装構成は今回再検証していない。旧CAD・入力・検査は各_work/analysis/内のbeforeに保持。
