AquaBeacon/mechanical/assemblies/parent_hand_service/corner_mount_report.md

> 履歴：固定板を付ける前の形状です。現行は[fixed_plate_report.md](fixed_plate_report.md)を参照。

# 親機：MAIN／SPRESENSEの支持簡略化

2026-10-11。MAIN/Sonyの広いキャリアを撤去し、ねじ穴付近だけの支持へ変更。MAINは直立スペーサ3本＋前左支持腕1個、Sonyは外側の柱4本＋独立支持腕4個。基板高さ42/65.6 mm、4点固定、既存ねじと床ナットを維持。ピンの配置に沿った逃げ加工は不要。

MAIN前左穴の真下は同軸収納環に重なるため、小さな支持腕で外側の床座から支える。Sony穴直下はTXの上方20 mm予約に重なるため、外側の柱から腕を伸ばす。MAIN腕下面Z33.1（同軸上面32.3）、Sony腕下面Z60.5（TX予約上面60.195）。実公差は未検証。

MAIN支持・基板を12 mm浮かせた確認図

Sony支持・基板を12 mm浮かせた確認図

印刷入口は[parts/PRINT.md](parts/PRINT.md)。9種類各1枚、16個の小部品を1枚のランナーで印刷し、切離し後は合計24個。PETG0.2 mm、4周壁、100%インフィル。座面・穴・キーを削らず、側面の首とバリだけを除く。実切離し力・嵌合・締付け・波浪・クリープと現行剛性は未認定。

検証集約はvalidation_current.json。容器の未図示成形形状・公差、配線把持、実巻きは現物確認。旧支持板と変更前の解析は履歴として保持。

## 検証結果

図面由来容器CADと閉蓋、部品間干渉、4点の実取付穴、床固定、連続した組立経路、工具経路、LiPo・両SD・両電源スイッチ、箱外MAIN USB、GNSS取出し、TX上方20 mm、同軸収納包絡を再検査しPASS。実物の公差・配線把持を保証するものではない。

OpenSCAD独立レンダリングとSTEP/STL外形・体積、閉メッシュ、2つの組立STEP、16個のランナー部品と切離し後17連結成分（廃棄ランナー含む）も確認。首の0.2/0.4 mm両層に実G-codeの押出しを確認した。

X1 Carbon・0.4 mmノズル・PETG・0.2 mm積層・4周壁・100%インフィルで全9形状を実スライス。合計459.19 g（前版560.87 gから101.68 g削減）、サポート8.66 g。16個ランナーのサポートは1.77 g。結果・3MF・設定は_work/analysis/corner_mounts_20261011/slicing/。

右側Sony座の床側はTX予約外へ収める。組立検査ではMAIN円柱に角箱を当てて生じた偽干渉を、連続円柱包絡で再検査し、Sonyは実形状が空けるキー穴を検証した連続包絡で再検査した。途中の不合格結果も同解析フォルダへ保存。小部品を世界座標で評価するとFreeCAD Mesh.Volumeの丸め誤差が大きいため、メッシュ頂点を局所原点へ移し倍精度で体積を求めた。許容値は緩和していない。

現行支持の剛性解析・メッシュ収束、実締結・波浪・クリープは未実施。旧解析は現行の合格根拠に使用しない。取合い試作の状態を維持する。既存スライサプロジェクトを変更せずprint_jobs/history_from_parts_20261011へ保存し、移動元とSHAをmigration.jsonに記録した。
