AquaBeacon/mechanical/assemblies/parent_hand_service/rigidity_report.md

> **旧昇降キャリアの履歴です。現行の固定式内装には適用しません。** 2026-10-09以降の波揺れ対策は [wave_rigidity_report.md](wave_rigidity_report.md) を参照。

# 20 N・ケース基準変位0.2 mm以下の検証状況

**保証は未成立。製造リリースなし。** 本文・CAD・解析ログは試作改訂の記録であり、保証書ではない。

ユーザー条件は、USB・SDへの20 N荷重でケースを基準にしたコネクタ変位0.2 mm以下。主要部材は3Dプリント、金属ねじ締結は許可済み。ケース内への収納、蓋の閉鎖、基板を外さず整備位置で操作できること、電池の6面保持を継承する。

## 今回のCAD改訂

- デッキ：下面54.5 mm、上面58.8 mm、厚さ4.3 mm。MAINの裏面部品それぞれに0.4 mmの逃げを持つ剛性ベッドを追加。実際のKiCad部品ソリッドを読み込み、保守的な部品外形で逃げを生成する。PCBデータ自体は変更しない。
- Sony側：下段TX上端40.2 mmを避け、下面41.5 mmからデッキへ繋がる下面補強を追加。Sony MAIN/EXTのWeb取得STEPは継続使用。IMUは包絡形状のため詳細支持の根拠にしない。
- 支柱：5本、断面8×26 mm、長さ96.7 mm。中心(11.5,88)、(132,88)、(21,187)、(127.5,190)、(142,110) mm。第五支柱はSony側補強の支持を増やす。工具経路を確保するため基板間へ配置する。
- 締結：各支柱に購入金属M3×110六角穴付きねじ2本、床の捕捉ナット2個、上下ワッシャ各2枚。合計ねじ10本、ナット10個、ワッシャ20枚。床ナットは設置前に捕捉ポケットへ挿入し、その後は上方だけから締結する。
- [ねじメーカー寸法](https://products.coldheaders.com/item/alloy-steel-metric-head-screws/alloy-steel-metric-socket-head-cap-screws/m3-0-5-diameter-and-110-millimeter-mm-length-all)の最大頭径5.5 mm、頭高3 mm、六角穴2.5 mmをCADへ反映。メーカーHTMLをrefに保存。ねじ山・締付け予圧・実際の捕捉ナット保持力は再現していない。
- 支柱・長ねじ・上側ワッシャをケース内南側へ5段で収納する。ストラップ上端60.8 mm。底側ナットとワッシャは床へ固定して残す。

解析入力のPETG材料カードは未測定の基準値。キャリアはbuild_axis=Z、4周壁・100%インフィルを想定する。印刷機・実際の樹脂・含水状態・積層方向・温度・締付け・クリープは実測で確定する。疎なインフィルを、この実体ソリッド解析と同じ剛性として扱わない。

## 解析の適用範囲

既存topoptのGmsh・CalculiX経路を使用する。デッキ単体の支柱上面を理想的に固定し、MAINのUSB/SD近傍支持とSonyの前後取付ポストへ20 Nを与える。これは**コネクタ変位の全体解析ではない**。基板のたわみ、Sony内部接合、床・支柱・長ねじ・ケースのたわみ、接触・ねじ締結のすべりを含まない。

`rigidity/baseline_study.json`は改訂前の入力。最初の8 mm指定メッシュでは大きなたわみが出たが、次の4 mm指定メッシュでGmshが異常終了したため、収束済み結果は得られていない。途中値を最終値に使わない。

`rigidity/revised_ccx.log`は最初の増厚・リブ改訂の試行記録であり、現在のCADの解析結果ではない。その形状はその後さらに変更した。`rigidity/iteration_*/`に各試行のSTEP/STL・study・SHA256・実行コマンド・終了コード・ログを保存する。最新CADと解析入力のSHA256が一致することを確認する。旧ログから現行CADの合格を推定しない。

通常のHXT方式でメッシュ生成が繰り返し失敗したため、[Gmsh公式文書](https://gmsh.info/doc/texinfo/)のAlgorithm3D=1（Delaunay）でも試行する。`run_ccx_delaunay.py`は既存のwrite_geo関数へalgorithm=1を渡す設定用アダプターで、ソルバや有限要素計算を再実装・改変していない。表面細分化、荷重写像、CalculiX、収束判定は同じ既存処理を使う。

ツールのPASS表示だけでは0.2 mmの合否を判断しない。最大変位、最悪要素の強度、メッシュ品質、メッシュ収束、解析範囲、現在の形状との一致を別に確認する。単体解析が通っても全体保証にはしない。

## 実物確認と受入記録

`rigidity_acceptance.json`が保証判定の台帳。`rigidity_physical_tests.csv`は空欄の実測記録様式であり、測定値を仮定して記入していない。収納・整備の2姿勢×5ポート×XYZ両方向＝60ケース。実際のコネクタ許容荷重を確認し、まず同等のダミー基板・荷重治具で検証する。

荷重は0→5→10→15→20→0 N。ケースへ固定した変位計でコネクタ部を測定する。20 N時は変位の絶対値＋校正で確定した測定不確かさが0.2 mm以下、すべり・緩み・割れなし、除荷後の残留変位0.02 mm以下を受入条件とする。実測で問題があればCADへ反映して再試験する。

Sony MAIN/IMUの実際の積層・固定方法、ケースの床ボスと蓋形状、印刷材料の実特性、全体荷重経路が未確定。現状で「20 N・0.2 mm以下を保証済み」と宣言する根拠はない。

## 記録済み解析と現行改訂の区別

4支柱版のiteration_06では、STEPをGmsh OpenCASCADEで読み、既存CalculiX経路で8/4/2 mm指定の3メッシュを解析した。Sony後方Z荷重の最大変位は0.43642 / 0.45766 / 0.46423 mm、最細メッシュの最悪要素安全率は0.372。0.2 mmを超え、強度・メッシュ収束も不合格。この値は現行5支柱版の解析値ではない。

run_ccx_native_step.pyはメッシュ入力生成だけをSTEP方式に置き換える。既存の荷重写像・有限要素計算・判定は変更していない。mesher_override.jsonのSTEP SHA256と設定が実際のメッシュ入力であり、既存CLIが出力するSTL表面細分化の記録はこの方式のメッシュ根拠には使わない。

Sony公式組立説明ではMAINとEXTの間に4個の付属スペーサを使用する。現行モデルはその内部取付の詳細を未再現。Sonyの内部固定、IMU詳細形状、MAIN基板の上向き荷重、ケース・床・支柱・締結部の全体変位は未検証であり、キャリア単体の解析だけでは保証できない。

5支柱版のiteration_07は現行キャリアとSHA256が一致する粗メッシュ確認。8 mm指定で最大変位0.14176 mm、ツール判定PASS。ただし単一メッシュで収束を確認しておらず、設計保証に使用しない。iteration_08は同じ現行形状の3段階メッシュ確認。最終結果はrigidity_analysis_status.jsonと原本ccx_summary.jsonを参照する。

## 保証判定を更新できる条件

実物の樹脂・印刷条件・基板積層・ケース寸法を確定し、閉じた収納姿勢のガイド遊びと、整備姿勢の締結部を含めた荷重経路を評価する。現在の片側0.3 mmのガイド隙間は0.2 mmの保証根拠にはならない。MAIN下面支持の上向き拘束も未検証。これらを解消する前にキャリア単体の合格を全体の合格へ転記しない。

rigidity_physical_tests.csvの60行には実測値のみを記入する。実際の組立品・荷重治具・校正済み変位計の測定が必要なため、CAD作業と数値解析だけではこの欄は埋まらない。現在は0/60ケースのままである。

## 現行5支柱版の完了した解析（iteration_08）

| メッシュ指定 mm | 最大変位 mm | p99.5基準最小安全率 | 最悪要素最小安全率 | ツール判定 |
|---:|---:|---:|---:|---|
| 8.0 | 0.14176 | 15.969 | 2.140 | PASS |
| 4.0 | 0.14335 | 24.947 | 1.917 | PASS |
| 2.0 | 0.14242 | 32.474 | 1.207 | FAIL |

最細メッシュのSony後方Z荷重は最悪要素安全率1.207で、ツールの絶対最小1.5を下回る。p99.5値が高くても、この不合格を打ち消さない。4→2 mmの最大変位変化は0.653%だが、p99.5応力変化は37.01%で収束基準5%を満たさない。収束した強度結果として扱わず、保証・製造承認なし。ホットスポットは(131.4,74.95,54.5) mmの切欠き付近。有限の角丸・実際の荷重伝達を含む再設計と解析が残る。

この解析は現行キャリアSTEP/STLと照合済み。12条件は理想固定されたキャリアに対する正方向荷重であり、線形・接触なしの単体モデル内で逆向きの変位絶対値は同じでも、実際の接触・抜去・基板の挙動を保証しない。全体保証はNOT_ESTABLISHEDを維持する。
