AquaBeacon/mechanical/assemblies/parent_hand_service/simple_stack_report.md

> 履歴：2026-10-11の容器訂正前の形状・結果です。現行の床・台・支持位置の剛性根拠に使用しないでください。現行は[case_fit_report.md](case_fit_report.md)を参照。

# 親機：ナット座とスペーサ積み上げ改訂

2026-10-10。ナット座下面の隙間をなくし、基板高さを維持。Sonyの3面壁を外して印刷スペーサ4本と上台へ分割した。位置決め突起と既存M3×45の共締めを使用する。GNSS既存4支柱と合わせ8本を1枚の切離しランナーで印刷する。

印刷は11種類・各1個、切離し後18部品。ランナーは組立に使用しない。側面接続部1.2×0.4×自由長1 mm。首をCADで切ると8支柱＋ランナーの9連結成分となり、各支柱の元形状・座面・キーを欠損しないことを検査する。実切離し力は未測定。

| 変更部品 | 使用量g | サポートg |
|---|---:|---:|
| floor_plate | 235.68 | 0.88 |
| sony_upper_carrier | 21.19 | 1.61 |
| parent_stack_spacer_set | 13.01 | 0.00 |

同じローカルX1C／0.4 mm／PETG／0.2 mm・4周壁・100%インフィル設定。前版合計621.09 g→今回560.45 g（9.76%削減）、サポート21.16→11.97 g。今回変更した3種を実スライスし、残る8種はSTLハッシュ一致を確認して前回の同設定結果を参照した。スペーサセットのサポートは0 g、全体には局所支持が残る。

入口は[parts/PRINT.md](parts/PRINT.md)。実際の解析・3MF・ログは`_work/analysis/simple_stack_20261010/`、集約は[simple_stack_checks.json](simple_stack_checks.json)。3MFは比較用の解析出力で、印刷入口は同梱STL。前版の結果は履歴。

参考剛性ではSonyの波2gは約0.070 mm、20Nは約1.13 mmで旧目標未達。予圧・すべり・メッシュ密度収束と実物試験は未完了。詳細は[wave_rigidity_report.md](wave_rigidity_report.md)。
