AquaBeacon/mechanical/assemblies/parent_spar_bolted/hardware_contacts.txt

part                         nearest                          gap  status
disk                         hub_-295                        0.00  ok
fin_0                        disk                            0.12  ok
fin_90                       hub_-295                        0.25  ok
fin_180                      disk                            0.18  ok
fin_270                      disk                            0.08  ok
hub_-295                     disk                            0.00  ok
hub_-202                     washer_m5x1_030                 0.01  ok
beam_lower                   beam_upper                      0.00  ok
beam_upper                   beam_lower                      0.00  ok
coupler_front                washer_m5x1_062                 0.01  ok
coupler_back                 washer_m6x1_046                 0.01  ok
float_bottom                 washer_m6x1_178                 0.02  ok
float_body_0                 float_lid_0                     0.00  ok
float_lid_0                  float_body_0                    0.00  ok
float_body_1                 float_lid_0                     0.00  ok
float_lid_1                  float_body_1                    0.00  ok
float_top                    float_lid_1                     0.00  ok
ballast_body                 disk                            0.00  ok
ballast_lid                  ballast_body                    0.00  ok
camera_bridge                washer_m5x1_230                 0.01  ok
gps_bridge                   gps_ann_mb1                     0.00  ok
deck                         float_top                       0.01  ok
camera_mount                 washer_m5x1_221                 0.01  ok
gps_ann_mb1                  gps_bridge                      0.00  ok
ballast_rings                washer_m8x1_102                 0.03  ok
screw_m5x40_000              nut_m5_003                      0.01  ok
washer_m5x1_001              screw_m5x40_000                 0.01  ok
washer_m5x1_002              nut_m5_003                      0.01  ok
nut_m5_003                   washer_m5x1_002                 0.01  ok
screw_m5x40_004              washer_m5x1_005                 0.01  ok
washer_m5x1_005              screw_m5x40_004                 0.01  ok
washer_m5x1_006              nut_m5_007                      0.01  ok
nut_m5_007                   washer_m5x1_006                 0.01  ok
screw_m5x40_008              nut_m5_011                      0.01  ok
washer_m5x1_009              hub_-295                        0.01  ok
washer_m5x1_010              nut_m5_011                      0.01  ok
nut_m5_011                   washer_m5x1_010                 0.01  ok
screw_m5x40_012              washer_m5x1_013                 0.02  ok
washer_m5x1_013              hub_-202                        0.01  ok
washer_m5x1_014              nut_m5_015                      0.01  ok
nut_m5_015                   washer_m5x1_014                 0.01  ok
screw_m5x40_016              washer_m5x1_017                 0.01  ok
washer_m5x1_017              screw_m5x40_016                 0.01  ok
washer_m5x1_018              nut_m5_019                      0.01  ok
nut_m5_019                   washer_m5x1_018                 0.01  ok
screw_m5x40_020              nut_m5_023                      0.01  ok
washer_m5x1_021              hub_-202                        0.01  ok
washer_m5x1_022              nut_m5_023                      0.00  ok
nut_m5_023                   washer_m5x1_022                 0.00  ok
screw_m5x40_024              washer_m5x1_025                 0.01  ok
washer_m5x1_025              hub_-295                        0.01  ok
washer_m5x1_026              nut_m5_027                      0.00  ok
nut_m5_027                   washer_m5x1_026                 0.00  ok
screw_m5x40_028              nut_m5_031                      0.01  ok
washer_m5x1_029              screw_m5x40_028                 0.01  ok
washer_m5x1_030              nut_m5_031                      0.00  ok
nut_m5_031                   washer_m5x1_030                 0.00  ok
screw_m6x100_032             washer_m6x1_033                 0.02  ok
washer_m6x1_033              hub_-295                        0.02  ok
washer_m6x1_034              nut_m6_035                      0.01  ok
nut_m6_035                   washer_m6x1_034                 0.01  ok
screw_m6x100_036             nut_m6_039                      0.01  ok
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
washer_m4x1_255              screw_m4x16_254                 0.00  ok
screw_m5x20_256              nut_m5_257                      0.01  ok
nut_m5_257                   screw_m5x20_256                 0.01  ok

penetrations (surface samples inside the other part):
  none
