AquaBeacon/mechanical/spec/child_interior_reinforcement/BOLTED_MOUNT_REVISION.md

# 電池締結とフランジ根元の印刷補強（2026-10-01着手）

対象は確認済みの200 mm縦置き内装、35×26×110 mm電池、BR-101040下フランジ。
M3ねじ・普通ナットを使用し、補強構造は3Dプリントで作る方針をユーザー確認済み。
印刷入口は [child_interior/parts/PRINT.md](../../assemblies/child_interior/parts/PRINT.md)。
同じ内装を使う `child_vertical_assembly` にも反映する。300 mm版は対象外。

## 設計変更

- 電池ケースの4つの取付部を、樹脂への4 mmセルフタップからM3×12＋普通M3ナットへ変更。
  穴位置X±24 / 世界Z32・110は維持。各耳に深さ8 mm・Z長14 mmの一体パッドを設け、
  ナット座よりデッキ側に5.5 mmの樹脂断面を残す。取付面をデッキへ密着させて締結する。
  樹脂ねじ山の抜けが主固定を決める構成を改める。
- 床板はM3×10皿＋普通M3ナット1個。側面ボスはZ長14 mm・Y深さ9 mm、床板タブもZ長14 mm。
  ねじ軸は従来のX22.5 / 世界Z36。ボスを電池・フォームの外側へ置き、窓とフックを維持する。
  ナット座までの樹脂厚3.5 mm、床板厚3 mm、皿頭の差し込みを含むねじ先端突出は公称1.1 mm。
  +X側フォームの既存切欠きをR3.1→R3.4へ広げ、六角ナットの角を逃がす。
- デッキ左右の根元をX37→28から接続し、軸方向60→80 mm、通常部の厚み6.5→7.5 mmへ変更。
  広い一体リブと既存のフランジ受け足で曲げと圧縮を分担する。基板裏の2.54 mmピン列6本を逃がす。
  基板自体を補強材として扱わない。ケーブルスリットとレールのねじ頭の逃げは維持する。
- 前側ブレースの梁10→12 mm、ウェブ20→24 mm、フランジ座の接線方向12→20 mm。
  MF30/MF12スペーサとM3×12なべねじは維持する。
- 前側フランジねじはM3×18→M3×16。座厚12 mmに対するフランジねじ込みを6→4 mmへ修正。
  既存記録の4〜5 mmかかり・6 mm超禁止に従う。左右MF10スペーサとM3×18は維持する。

`scad/lib/child_interior_mounts.scad` が電池締結位置と普通ナット受け寸法の共通定義。
ナットは既存購入品モデルの二面幅5.5 mm・厚さ2.4 mm。ナット受けは5.7 mm・深さ2.6 mm。
ナイロックやフランジナットはこのポケットに適合しない。

## 組立・電池交換

1. 電池ケース取付部4か所とサービスボス1か所に普通M3ナットを入れる。
   ポケットの口は外側Xへ開く。回り止めの形状であり、未締結時の脱落を保証するスナップではない。
   ナットを押さえながら仮締めする。工具経路を確保するためケーブルレールは後から取り付ける。
2. ケースをデッキ下面へ密着させ、デッキ側からM3×12を4本入れる。
   ナットが座ったところで止める。印刷樹脂を潰して増し締めしない。
3. 既存のフランジ受け足を面へ当て、左右MF10とM3×18、前側M3×16で固定する。
   反りで受け足が浮く場合は締付けで引き寄せない。PCB取付とレール・配線を復旧する。
4. 電池交換はチューブを外し、XT30を抜く→床板M3×10皿を外す→床板を−Zへ2 mmスライド→−Yへ抜く。
   フランジ固定・ケース・基板は外さない。サービスナットの紛失に注意する。

追加で必要な普通M3ナットは5個。電池ケースのM3×8を4本ともM3×12へ、床板のM3×8皿をM3×10皿へ、
前側フランジのM3×18をM3×16へ交換する。その他の既存ねじとスペーサは組立配置どおり使う。
補強用金属板・スリーブ・インサートは追加しない。

## 印刷

印刷一式のSTLは指定姿勢へ回転済み。デッキ+90°、ケース−90°、床板+90°、ブレース0°。
PLA Matte・0.4 mmノズル・0.2 mm層、壁8周、上下面6層を引き継ぐ。
ケース・床板・ブレースは100%充填を試作条件とする。デッキ通常部15%、左右の根元は同梱モディファイアで100%。
モディファイアも拡幅・延長済み。ケースのナット受けは短いブリッジを含むので、スライス断面で屋根と空洞を確認する。
実スライサのサポート量・実造形での締付けは未測定。

外周パッド・床板は面取り0.3 mm、根元・梁の独立プリズム端縁も0.3 mmの丸め、窓の平面角はR0.6。
根元の凹側R3を維持。ナット回り止めの六角角部、ねじ平座、フック・壁の指定嵌合面、
フランジ環状接触面は機能面として既存の形状・寸法を優先する。
既存形状の全稜線を仕上げ直した変更ではなく、全稜線の仕上げ確認は未完了。

## 検証と強度の扱い

幾何検証の結果は `assemblies/child_interior/_work/logs/bolted_*` に保存。
最終形状の4部品は水密・一体、STEPは読み戻して有効な1ソリッドを確認。
STEP/STLの外形差は0.001 mm未満、体積差は0.001%未満。
追加ねじ・ナット・挿入の122交差、周辺・工具・床板移動の107交差、ねじ頭の78交差でエラー0。
MAIN/PWR実取付穴とRX外周クランプは一致、印刷姿勢の平坦な底面も確認済み。
OpenSCADレンダリング、閉メッシュ・一体性、STEP/STL外形・体積、周辺部品の干渉、
実ナットの取付と挿入経路、ねじ頭、工具、床板の2 mmスライドを確認する。
既存の基板取付穴検査、全体組立の配置検査、印刷一式の出所・ハッシュ検査も実行する。
最終組立STEPは内装構成84項目・子機全体91項目で配置不一致0件。
内装だけの既存別名STEPも再生成し、74項目で配置不一致0件。
管理ツールの14テスト合格、画像・中間ファイルの配置検査合格。
対象2構成の印刷一式検査は合格。リポジトリ全体検査では作業中に別構成の
`over_center_latch`、`parent_hand_service`、`child_clamp_suspension` の未同期を検出しており、全体合格とはしていない。
この記録は今回の対象以外の設計・生成データの整合性を保証しない。
ケース最小径方向すきま2.89 mm、ブレース1.00 mm、床板0.71 mm。
既存のデッキ0.59 mm・上リブ0.50 mm・上RXクランプ0.70 mm・LED配線0.54 mmも狭隙間として残る。

200 g・腕180 mm・5gは過去の比較条件で、根元曲げモーメントは約1.77 N·m。
電池単体の質量・実衝撃条件は未確定であり、この200 g条件を電池質量の確定値とはしない。
以前のPLA Matte解析は未収束。今回の形状へその安全率を転用しない。
今回の変更は締結先と荷重を分散する形状の改善であり、許容荷重・締付トルク・反復寿命の保証ではない。

仮組みでは普通ナットの嵌合、チューブとの狭隙間、受け足の全面接触を確認する。
電池を入れる前にダミー重量で各横方向を静荷重から確認し、白化・耳の浮き・残留変形を点検する。
反復交換後もナット座と皿座の変形を確認する。5gの実物試験とメッシュ収束を伴う材料・接触解析は未実施。

再生成時は元SCADをビルドし、`sync_bolted_mount.py` で既存配置へこの締結を反映する。
旧 `scad/lib/sync_child_interior.py` はLCDありの履歴構成を生成するため、この現行構成へ使用しない。
旧3MFは履歴として保持し、今回のSTLを再読み込みしてスライスする。

グループ限定STEPはグループ限定の配置JSONで照合する。全体91項目の配置で内装だけの74項目STEPを
照合した初回診断は17件MISSINGとなるが、その17項目は容器・外装・ペネトレータであり、内装限定には含めない。
正しい照合は `bolted_interior_step_filtered_check.log`（74項目・0 NG）。初回ログは解析フォルダへ保持する。
