AquaBeacon/mechanical/spec/over_center_latch/HOLDING_CALCULATION.md

# 継ぎ目から7.5 mmへ寄せたDJI式ラッチ（2026-10-10）

爪・受けを継ぎ目へ移動。接触面中心X=9.6、継ぎ目X=2.1で7.5 mm。受け基準X=12.4、閉角150°、開き角100°。保持段を抜けてから上蓋を18°持ち上げる検査軌道です。台の外形と世界座標の6取付穴、80°面、台厚6/8 mm、後端操作部を維持。閉時40 Nはゴム概算による目標で、実測校正が必要です。

機構とCADの最新結果は下記の生成記録を参照。構造解析は位置変更前の記録を保存し、今回の強度評価として使用しません。

- 機構：assemblies/over_center_latch/_work/analysis/kinematics/report.json
- CAD：同_work/analysis/verification/transverse_sweep.json、step_report.json
- 変更前一式：parts/common/jigs/over_center_latch/_work/analysis/dji_groove40N_near_seam_20261010/before

今回の実STL検査：7種類は閉メッシュ・正体積・単一成分・ゼロ面積面なし。273姿勢／51断面／292,383組の干渉検査、取付穴6本と工具通路、ゴム全面支持、後端の直接着座は合格。

## 今回の機構概算

| 項目 | 値 |
|---|---:|
| 閉時水平締付力 | 40.00 N |
| 死点角 | 137.209° |
| 死点から閉位置まで | 12.791° |
| 途中最大水平締付力 | 57.25 N |
| 最大リンク合計圧縮力 | 80.12 N |
| 最大鉛直操作力 | 3.80 N |
| 閉時の台着座反力 | 2.34 N |
| 閉時ゴム圧縮 | 0.4328 mm |
| 最大局所ゴム圧縮 | 0.6724 mm |

摩擦・PETGの変形・ゴム積層の接着と横膨れ・軸のガタを含まない公称概算です。実測校正と今回の形状に対する強度検証が必要です。短くした水平距離だけで力倍率を求めず、80°面と保持段の反力を含むB回りのモーメントを解いています。

## 材料と構造解析の前提

[Bambu PETG Basic TDS V3.0](https://store.bblcdn.com/s1/default/cb94589bf7994fdcbfa833badefae9cd/Bambu_PETG_Basic_Technical_Data_Sheet.pdf)の既存カードを使用。XY/Z引張強度51±1/35±6 MPa、弾性率2780±65/2550±100 MPaから、50/29 MPaと2715/2450 MPaを採用。統計的な保証下限ではない。ポアソン比0.35、せん断弾性率、圧縮強度、せん断強度は既存の推定値で実測ではない。

X1C、PETG Basic、0.4 mmノズル、0.2 mm層、6周壁、100%充填、乾燥材料。積層法線Y、ラスタX。主な締付荷重X/Zを層内へ置く。通常荷重の要求安全率3、最大変位0.5 mm。これを下げて合格を作らない。

解析は既存topoptのSTL用ボクセルFEA。最適化や単純形状への置換は行わない。爪位置変更前のSTLを閉配置へ変換して独立解析用STLを作り、原本と解析入力のSHA-256を記録する。

- レバー：B穴周囲を支持し、最大リンク荷重・最大操作力の姿勢を閉フレームへ変換したゴム、保持段、手の力を別々の領域へ与える。閉40 N＋手100 Nでは後端の台着座をZ拘束で加える。
- リンク：左右共通の1個をAで支持し、最大リンク荷重の半分をBへ与える。
- 固定台：4個の取付座を支持し、Aの反力と閉時の後端着座反力を別々に与える。100 Nの手押しをすべてA軸へ載せない。
- 受け：2個の取付座を支持し、80°面のゴム反力と保持段の反力を別領域へ与える。

穴の周囲の固定は実ピンの片側接触・回転を近似する。保持段の角の接触、ゴム層のせん断・偶力伝達、造形公差と締付力の連成、クリープ、湿潤条件、疲労は未解決。実物の定格保証を行わない。

## 旧形状の検証結果（現在の形状の強度根拠には使用しない）

**形状検査は合格。強度検証は未完了で、実用強度を保証する完成版ではない。** 古い200 N版の数値は今回の根拠に使わない。

変更前STLは全7種類が閉メッシュ、単一成分、正体積で、ゼロ面積三角形なし。273姿勢・51断面、292,383組の断面干渉検査、6個の取付穴・工具通路、ゴムの全面支持、後端の直接着座、底肉2 mmを検査した。変更前STEPも全7種類が単一の有効なソリッド。STLとの体積差は最大0.00063%、4姿勢の最大剛体交差体積は0.000371 mm³で、検査上限0.005 mm³以内。組立は8ソリッドで配置体積が一致する。これらは形状検査であり強度の証明ではない。

解析用STLのSHA-256、変更前STLと解析時の原本の一致をreport_strength.pyで照合した。再ビルドでSTLの面の保存順序が変わった部品は、保存した原本と全頂点・全三角形面が厳密に一致することを確認している。この照合結果を、assembly内のverification/strength_report.jsonへ保存した。下表は最も細かいメッシュの参考値。各部品で最悪要素安全率とp99.5安全率の最小、最大変位の最大を示す。これらの項目は必ずしも同じ荷重ケースで最大になるとは限らない。

| 部品 | 粗／中／細 mm | 最悪要素SF | p99.5 SF | 最大変位 mm | メッシュ収束 |
|---|---|---:|---:|---:|---|
| 左右共通リンク1個 | 0.6 / 0.3 / 0.15 | 4.03 | 16.94 | 0.0112 | FAIL |
| 爪付き上蓋レバー | 1.0 / 0.5 / 0.25 | 3.30 | 11.62 | 0.2924 | 全ケースではFAIL |
| 固定台 | 1.0 / 0.5 / 0.25 | 0.47 | 7.37 | 0.3732 | FAIL |
| 受け付き台 | 1.2 / 0.6 / 0.3 | 1.80 | 21.75 | 0.0517 | FAIL |

レバーは通常最大リンク荷重と閉40 N＋手100 Nを含め、最悪要素SF3以上・変位0.5 mm未満まで改善した。ただし通常最大操作力だけが収束PASSで、他のケースは最大応力位置の移動が許容値を越える。固定台の通常最大リンク荷重は最悪SF1.14、変位0.1802 mm。追加100 N手押しでは取付座を固定した領域の端に最悪SF0.47が出ており、局所強度を合格として扱わない。受けの通常開閉最大荷重も溝端の局所SF1.80で、接触・局所応力の検証が残る。ネイティブの単一メッシュ判定がp99.5基準でPASSでも、最悪要素値や収束FAILを隠して完成扱いしない。

CalculiXの別メッシュによる照合は、Gmshが再分割したSTLシェルを生成できず失敗した。CCXの強度結果はない。修復の試行で形状体積が変わった解析用メッシュも不採用で、印刷データへ反映していない。0.2 mmの細分割はメモリ不足、並列試行はメモリ確保のため中断し、0.25 mmの逐次実行へ変更した。合格閾値・荷重・材料は下げていない。

実用へ進めるには、実際の台取付・ねじ座面・ピン接触を定義した局所解析と収束確認、印刷した試験体での締付力40 Nの校正、死点付近の最大荷重、繰返しとへたりを確認する。100 Nの手押し耐力は認定しない。

機構テスト2件は合格。全体テスト21件は20件合格、今回のラッチとは無関係の既存PETG材料カード欠落で1件エラー。ラッチの印刷一式検査と作業ファイル整理検査は合格。全assembly検査にはchild_interiorの既存3MF未管理2件が残り、削除・変更していない。

- 機構計算：assembly内_work/analysis/kinematics/report.json。
- CAD：assembly内_work/analysis/verification/transverse_sweep.json、step_report.json。
- 構造：リンク・レバー・固定台は部品内_work/analysis/dji_groove40N_20261010_ribs55_plate6_h05_serial、受けはdji_groove40N_20261010_ribs55_plate6。CCX失敗ログは同名末尾_ccx。初期形状・補強途中・中断した解析も保持する。
- 旧版：同ケースのbefore。以前の解析・印刷履歴も保持。
