AquaBeacon/mechanical/spec/over_center_latch/REFERENCE_REVIEW.md

# 一般的な印刷用トグルラッチの参照

以下は日付ごとの設計履歴。最新寸法と保持力計算は[HOLDING_CALCULATION.md](HOLDING_CALCULATION.md)と部品parameters.jsonを正本とする。

2026-10-01。ユーザー指定検索語：`over center latch 3D print`。防水ケース交換部品の外形より、一般的なドローラッチ／トグルラッチの操作と形状を参考にする。

## 候補

| 作者の公開ページ | 取得できた情報 | 設計への参照点 |
|---|---|---|
| [Over-Center Draw Latch / enrohtkcalb](https://www.thingiverse.com/thing:1321152) | 作者ページのタイトルと検索結果。本文・ファイルの内容は未取得 | 検索語に一致する箱用ドローラッチの候補。未取得の寸法やライセンスを決めつけない |
| [Self-Locking Toggle Latch / Xphi21](https://makerworld.com/en/models/1054989-self-locking-toggle-latch) | 検索エンジン経由の作者ページ画像・説明。φ3 mm金属軸、試験台、弾性材を用いた予圧の説明 | 金属軸を用いた印刷ラッチと、固定側・受け側を別々に取り付ける構成。説明中のTPUを手持ちの厚1 mm EPDMと同一特性として扱わない |
| [Toggle latch / Flasheek](https://www.printables.com/model/1493099-toggle-latch) | 検索取得の作者本文：汎用にも使用するケース用ラッチ、PETG、側面を下に印刷、フックはサポート使用、M3取付ねじ。取得本文ではCC0 | PETGのケース用ラッチとしての形状と印刷姿勢。印刷軸をそのまま採用せず、今回のM3金属軸条件を維持する |
| [Over-Center Toggle Latch / TECbot](https://www.printables.com/model/1548353-over-center-toggle-latch) | 2026-10-02にユーザー指定。ブラウザで作者本文・斜視画像・側面画像を確認。一体のループ、小さい固定受け、起倒レバー。作者は受けを低く取り付けてループが中央ピボットを越える必要を説明。90°取付の受け、M5主要軸。CC BY-NC-SA | 一体の樹脂U字フックと小さい受けの構成、死点を越えられる取付高さ、軸周辺の干渉回避を照合。今回のM3設計に寸法やメッシュを転用しない |
| [Heavy Duty Toggle Latch / ddarcyy](https://makerworld.com/en/models/556603-heavy-duty-toggle-latch) | 作者ページ画像と検索説明：M4金具、腕の長さ・ナット位置で張力調整 | 予圧調整を操作とは独立させる構成の参考。作者の強度・材料設定は今回の試作品へ移さない |

検索結果には印刷用モデルと金属製品の可視化CADが混在するため、商品タイトルのみで造形可能性や機構成立を判断しない。初回のページ直接取得にはエラーがあり、検索索引の作者説明・画像情報を使用した。TECbotの指定ページについては2026-10-02にブラウザで本文と画像を直接確認した。STL/STEPファイルはダウンロード・寸法測定していない。

## 今回の設計基準への反映

- 通常のレバー起倒と、リンク／ループを受けから外す操作を参考にする。
- 前回試作の横方向のフック振りと厚い積層台座は、一般的なケース用ラッチの操作姿勢として採用を確定していない。前回の幾何検査は、一般的な製品との形状・操作の一致を示さない。
- 実用部分は固定側台座、起倒レバー、引張リンク／ループ、独立した小さい受け。確認用のスライドガイドは実用部品と分ける。
- リンクがレバーを閉じる終盤で死点を越え、張力が閉ストッパー方向へ働く条件、M3金属軸、EPDMの予圧、素手での脱着を維持する。
- レバー解除後、リンク／ループを受けから持ち上げて外す方式を採用した。現行の実配置・掃引検査と操作動画をassembly側に保存している。
- AB≈15、BC≈20 mmは試作の開始値であり、金属軸と受けの干渉回避が必要ならパラメータで調整し、変更理由を記録する。

## 指定参考モデルとの照合（2026-10-02）

現在の設計は上下起倒レバー、左右アームと丸い掛かり部を一体化した樹脂U字フック、上方へ外せる小さい中央受け。金属ねじはA・BのM3軸だけで、Cは樹脂の接触部の仮想中心とする。BCはA支持部・Bスペーサーと受け先端の離隔を確保するため26 mmに変更済み。

指定モデルの作者説明で注意されている取付高さの問題を、今回のモデルではA/B/C座標と受け位置の計算で確認する。現行の閉角度183.8226°、Bの死点越え1.0 mm、張力1 N当たりの閉方向モーメント0.42362 N·mm。C高さの片側0.15 mmの変動を含む幾何検査でも死点越えは最小0.79598 mm。ただし軸穴・取付穴など全公差を含む保証ではない。

指定モデルの受けは作者の用途に合わせた90°取付。今回は同一面上へのねじ取付を前提とし、閉時全高13.5 mmとした。1 mm EPDMを受けの引張荷重経路に挟み、閉時0.15 mm、死点で最大0.16413 mm圧縮する。取付先の硬い基準面が接触した状態で予圧を持たせ、横ずれ・高さずれは取付先の位置決め形状で拘束する。EPDMの反力とPETGの耐荷重・長期保持力は実物で未測定。

この照合でCAD寸法を変更する必要はなく、参照記録を現行設計に更新した。設計元、配置、印刷データ、操作動画は現行の樹脂U字フック版。機構計算と実形状の検証は `assemblies/over_center_latch/_work/analysis/` の各reportを参照する。検索例の寸法やSTLは流用していない。

### 追加改良：幅広の操作端（2026-10-02）
指定ページの作者説明を再取得し、死点越えと軸頭の干渉回避を再確認した。現行の機構を保ち、細い4 mm幅のレバー先端を12 mmへ拡幅した。これは今回の独自の操作性改善であり、参考STLの転用ではない。取付寸法とM3軸を保持し、再生成後の実メッシュで動作掃引を検査する。

## カバー形レバーへの変更（2026-10-03）
ユーザーが前回提示のGoProハウジング風の方向を採用。[randeng / GoPro Hero 3 case latch](https://cults3d.com/en/3d-model/gadget/gopro-hero-3-case-latch)の公開説明と画像を外形の参考とした。STLのコピーや寸法転用は行わず、既存M3/EPDM/台一体機構に独自の幅広押し面・側縁・フック逃げ溝を追加した。2本の逃げ溝は既存のU字フックの起倒・離脱を通すため。B軸ねじ頭は側縁内に収めるが工具穴から見える。受け側フックはカバー外に残る。実メッシュの全高は20.898 mm（台底基準）で、旧版18.498 mmから約2.4 mm増加。操作力・防水・耐荷重は未検証。

## 追加ロックを使わない保持改善（2026-10-04）

ユーザーの実物評価を受け、外観の変更だけでは初期保持力が小さいことを計算で確認。[Southcoの説明](https://southco.com/latches/draw-latches)にあるガスケット圧縮とオーバーセンター作用を参考に、AB/BC=12/23 mm、死点越え3 mm、カバー端23 mm、初期圧縮0.30 mmへ変更。独立した二次ロックは追加しない。具体的なカメラケースの内部寸法を実測したものではない。条件付き計算と実測で残る項目は上記計算書へ記録した。
