AquaBeacon/mechanical/assemblies/child_horizontal_plate_frame/parts/DESIGN_NOTES.md

# 設計・印刷条件の控え（自動生成）

以下は設計元の文書を転記したものです。リンク先は元フォルダ基準です。印刷条件と未検証事項を確認してください。

## child_horizontal_plate_frame/README.md

## 2026-10-29 素手で着脱するカメラ接続（試作・現行）

子機の接続中心は (-122, 113, 130) mm。既存の4穴を使い、側板側2本はM3×18、ガード共締め2本は従来のM3×25からM3×30へ交換する。フレームとガードの形状は変更しない。

カメラ1台分の新しい印刷品は、共通カメラ本体1個、その機体用の受け1個、指掛け付きUスペーサ2個、手回しノブ2個、ノブ蓋2個。前側押さえは後続の右5 mm追加移動で更新。フレーム・ガード・ライトは維持。変更した本体と押さえは `print_jobs/camera_clamp_right5_20261029/`、受けと手回し部品は `print_jobs/camera_hand_release_20261029/` を参照する。購入金具は各機に六角頭M3×30 2本（頭部二面幅5.5 mm・厚さ2 mmを仮定）とM3普通ナット2個。従来のソケットねじ・ワッシャはこの接続に使わない。部品の入手状態と現物寸法は未確認。

初回のみ受けを既存フレームに固定し、各ねじをノブ上側から通して蓋を押し込み、六角頭を囲む。蓋の突起は保持用で、締付力はねじ頭→ノブの厚1 mmの印刷床→カメラ耳→Uスペーサ→受け→ナット屋根で受ける。初回の受け固定には工具が必要。ノブ床の強度、クリープ、蓋の弾性と繰り返し保持は未検証。蓋は中央円盤に4本の弧状アームを持つ。アームを長さ約6.8 mm・幅1.75 mmの直線片とみなし、先端を0.15 mm曲げた簡易見積りは表面ひずみ約0.9%であり、曲がった実形状や積層を含む強度解析ではない。

通常の取外しはカメラを支え、各ノブをねじ山が外れるまで緩める。必要に応じてノブを約0.5 mm持ち上げ、頭の座面が約3.8 mm上がった状態にする。先にUスペーサの指掛けをつまんで接続座標の−Xへ抜き、次に各ねじ・ノブを受けの外側へ横に滑らせて外す。その後カメラを60°回して軸方向に引き抜く。取付は逆順で、カメラを回してからねじを横から入れ、スペーサを入れてノブを手で締める。落下防止コードを別に取り付ける。

親子の実メッシュで、接触・ナット反力・ノブの六角回り止め・蓋の引抜き障害と、上記の離散位置を検査した。指先φ9 mmからφ16 mmへ広がる長さ25 mmの指2本を同時に仮定した進入・引抜きも検査した。手全体、連続掃引、実物寸法、濡れた手での操作、締付力、振動・強度・爪の耐久は未認定。ケース幅95 mmは仮値、厚さ41 mmは既存実測値。特に解除途中のノブと仮ケースのZ方向すきまは約0.4 mmのため、現物の形状と寸法で確認する。詳しい結果は `_work/analysis/clamp_right5_20261029/geometry_hand_checks.json`。既存節の数値・94項目等は旧版の履歴であり今回に流用しない。

## 履歴：2026-10-29 工具締付け版（上記の素手着脱版に置換）

**履歴：この節は前側押さえの追加移動前の工具締付け版。** 各機で共通カメラ本体1個、専用受け1個、Uスペーサ2個を交換する。旧カメラの3MFを使わない。全機体のSTL一覧と今回の交換分を混同しない。

子機受けは既存穴Y60/Z100・160と、前側ガードのY98/Z100・176を使う2列4点支持。取付列の間隔38 mm。既存側板・ガードの穴・形状・配置を維持し、ガード固定のM3×25をM3×30へ2本交換して厚4 mmの治具を共締めする。最初の2点は既存M3×18を使用。カメラの向きは維持し、治具の接続中心だけを前方へ10 mm移して(-122,105,130)とする。Y60/Z120・140には直径8 mmの工具通路を残す。

回転後、Uスペーサ2個を差し込み、M3×30ソケット2本・外径7×厚0.5 mmワッシャ2枚・M3普通ナット2個で接合面を締め付ける。旧横ロックねじ・ノブ・ゴム2枚は廃止。解除はカメラを支え、両ねじとワッシャを外し、スペーサを接続座標−Xへ14 mm以上抜いてから60°回して引き抜く。独立落下防止コードを使用する。

[設計寸法・締結経路・組立手順](../../parts/child/exterior/printed/dji_osmo_action6_mount_m3/README.md)。ケース厚さ41 mmのみ実測、幅95 mm・高さ75 mmなどは既存仮値。仮ケースと直径8 mm工具の横方向余裕は0.5 mm。実物で工具が通ることと接触位置を確認する。

### 検証状況

最終R1の正式STLで、閉メッシュ・単一連結、両機の静止干渉、接触座面、ナットの回り止めと引抜き反力、横挿入の掃引包絡、ねじのかかりと底付き、子機4点の締結経路、工具通路、スペーサ抜去と回転解除を検査し94項目PASS。非カメラSTL90件は作業前SHA-256と一致。回転は5°刻み、スペーサ抜去は0.5 mm刻みのサンプル検査であり、連続すきまの保証ではない。実物の締結力・濡れた状態の保持・クリープ・疲労・強度は未認定。

[機械可読検査結果](../child_horizontal_plate_frame/_work/analysis/camera_fixture_20261029/fixture_checks.json) / [設計条件](../child_horizontal_plate_frame/_work/analysis/camera_fixture_20261029/design_contract.json)。STEP・スライス・印刷セットの最終検査状況はこの節末の納品記録を参照。

### 再生成

共通治具：`python spec/build_camera_mount_m3.py --twist-only`。子機受けは既存SCADの`part="camera_receiver"`をレンダー、親機受けは既存`qr_source()`から生成してfemaleをレンダーする。旧`spec/configure_camera_twist.py`は廃止。配置は`python spec/configure_camera_fixture_clamp.py`、検査は`python spec/verify_camera_fixture_clamp.py`、STEPと組立は`python spec/export_camera_fixture_clamp.py`。変更しない既存バリアントは同値再レンダーで元のSTLバイト列を維持する。最後に対象assemblyの`tools/assembly_parts.py sync`と`check`を行う。

印刷入口：[parts/PRINT.md](parts/PRINT.md)。カメラ本体は底板下、受けは取付面下、スペーサは平面下。Generic PETG・0.1 mm・6壁・15% Gyroidを検証条件とする。カメラ裏側・C爪の支持材、受けナット溝屋根のブリッジを確認し、機能面を傷つけず支持材を除去する。

### 納品検査（2026-10-29）

変更4形状のSTEPは保存後に再読込し、全て有効な1ソリッド、STLとの外形差0.01 mm未満・体積差0.0025未満を確認。[STEP照合](../child_horizontal_plate_frame/_work/analysis/camera_fixture_20261029/step_checks.json)。親機全体STEPは107配置・0 NG、両機の組立STLと確認SCADを更新済み。

X1C／0.4 mm／Generic PETG／0.1 mm／6壁／15% Gyroid／自動支持（ベッドのみ）で4形状をスライスし、警告なし・造形域内。壁・支持・ナット溝屋根前後の層を確認した。スペーサは支持検出を有効にして支持0。これは実印刷の成功保証ではない。親受けの張り出し下面とカメラ裏側の支持材を除去し、ナット挿入溝と締結面を確認する。

[今回のスライス記録](print_jobs/camera_fixture_clamp_20261029/README.md)。3MFは1形状1個ずつ。スペーサは各機2個、両機で計4個必要。共通カメラ本体は両機で計2個必要。旧3MFは履歴として保持する。

対象2構成の印刷一式の出所・個数・更新状態はPASS。workspace整理検査もPASS。全体チェックには今回触れていない親機内装系6構成の既存未同期が残る。tools/testsは42件中41件PASS、既存材料カード`child_wte4_suspension_clamp/spec/bambu_petg_basic_material.json`欠落による1件ERROR。今回の治具検査とは分けて扱う。

治具の取付状態

---

## 2026-10-29 カメラ前側押さえの追加移動

前側L字押さえと本体取付床・M4穴を正面から右へさらに5 mm移動。局所座標の接触帯 X=5.5..30.5、M4軸 X=11.5, 24.5。M5爪への干渉を避けるため足に局所逃げを設ける。カメラ姿勢と素手で着脱する回転接続は維持。変更した本体・押さえの3MFは print_jobs/camera_clamp_right5_20261029/、それ以外は従来の手操作版を使う。実物での締付け・保持・干渉は未確認。

## 2026-10-26 カメラ押さえ（履歴：下記の右5 mm追加移動で置換）

現行の印刷一式は21種類29個。

背板に追加していた四角い突出パッドを撤去。元の背板を後側の当たり面とし、前側押さえも位置を合わせて41 mmの間隔を維持する。実物のM5軸からケース背面までの距離は未測定。実測厚さ41 mmに合わせ、幅25 mmの前側押さえと取付穴・ねじを正面から見て右へ12 mm移動。左端から12〜37 mmの範囲を前後で挟む。中央M5固定爪と横方向に2.85 mm離し、20 mm移動版の足の切欠きは廃止。camera_mount_twist本体1個とcamera_front_clamp前側押さえ1個へ更新。追加はM4×16ソケット2本、M4ナット2個、外径9×厚0.8 mmワッシャ2枚。前側のL字足をカメラ下側へ反転し、元の左右底面受けを撤去。前方への張り出しは16 mm短縮。前側は0..3 mm開けて位置合わせし、下面からM4ねじを締める。ねじ頭とワッシャは底面に埋め込み、ナットは足の上側へ入れる。R1外縁・R3根元フィレット付き。背面下側20 mmの逃げを維持する。

[寸法・締結経路・印刷・検証](../../parts/child/exterior/printed/dji_osmo_action6_mount_m3/README.md)。ケースの幅・高さ・M5軸からの位置は既存仮値で、実物の新方式の保持力は未認定。親子共通2部品の印刷ジョブはparent_exterior/print_jobs/camera_clamp_clearance_20261026/。印刷入口はparts/PRINT.md。旧カメラ用3MFは使わない。

## 2026-10-25 カメラ旧版の実物評価（履歴）

2026-10-24版は実物で十分に回転を止められなかった。旧版の再印刷指示は取り消し、上記の前後押さえ方式へ更新した。

## 2026-10-25 TD04A固定治具 Rev.6（現行）

TD04A改訂時点の印刷一式は20種類28個。共通治具をM4・12 mmピッチ（実測前）、穴列基準でケーブル逃げ60 mmへ更新。親機は送受信面下向き、子機は上向き。旧TD04Aモデルは使用しない。[設計・ねじ・未確認事項](../../parts/common/exterior/printed/td04a_bracket_mount/README.md)。現行データはparts/PRINT.md。下記の旧TD04A支持・押さえ金具の記述と古い全体個数は今回の配置に適用しない。実物の耳厚・正確なピッチ・本体・配線根元・締結・強度は未検証。

# 子機・横置き4枚フレーム＋ライト・C式カメラ

## 2026-10-24 カメラ底面受けの更新（旧版）

カメラ背面下側の突起に対し、左右受けを背面から20.5 mm前方へ退避した共通camera_mount_twistへ更新。背板・C接続・M5軸・配置は維持。カメラ治具1個を再印刷する。左右受けの範囲で床上Z=8..36.5の背面20 mm空間を確保し、中央M5爪と床は残す。実ケースの突起高さ・幅、接触と締結・回転保持力・強度は未検証。

[寸法と検証の詳細](../../parts/child/exterior/printed/dji_osmo_action6_mount_m3/README.md)。2026-10-21のカメラ3MFは旧形状の履歴。現行STLはparts/内を使い、新しい共通カメラ3MFは親機のprint_jobs/camera_bottom_clearance_20261024/に保存する。下記の旧カメラの支持位置・スライス時間・質量は今回の結果に適用しない。

2026-10-21。改良済みcamera_mountにCオスを一体化し、ライトと同じ60°回転・横ノブで固定する。ライトは右前の上向きを維持し、カメラは左前に追加。外側から見て右へ90°回し、カメラ上方向が機体+Zを向く通常の横向きへ修正。外側の「○△○」回転止めと不要な底板延長を取り除き、マウントを88×61.45×84.5 mmへ小型化した。配置の正本は[placement.json](placement.json)、現行の印刷入口は[parts/PRINT.md](parts/PRINT.md)。19種類27個、未印刷15種類22個。印刷済みの側板2・底板1・クランプ上下各1の設計元STLはSHAを保持する。

左前カメラと右前ライト

## カメラの取付とネジ

- 左側板外面X=-122、既存Y=60・Z=100/160の2穴を利用。専用バリアントchild_horizontal_twist_mount_camera_receiverは厚4 mmの平坦な取付足とCメスを一体化し、M3×18ソケット2本、頭側φ7×0.5ワッシャ2枚、内側M3ナット2個で固定する。穴あけと印刷済み側板の再印刷は不要。
- C中心は(-122,95,130)。左側U=-Y方向へ35 mmオフセットし、Cの面内角は90°。ノブ軸を機体+Zへ向け、中央Y±45の手の進入域を空ける。カメラケースの既存仮包絡はY=47.5..142.5・Z=126.5..201.5、マウントはY=51..139・Z=90..174.5にある。
- camera_mount_twistは親機と同じSTL。底面受けを上記の前方位置へ更新し、M5軸を維持して、Cオスと接続板を一体化する。背面M3穴に取付ねじは使わない。
- ロックは六角頭M3×40、既存φ16ノブ、M3ナット、φ7×厚0.5ワッシャ、5×8×厚1 mmゴム2枚。メス固定2本を先に締め、カメラを差込位置から60°回して停止してから横ノブで固定する。
- 解除はカメラを支え、ノブ・ロックボルト・ワッシャを+Zへ45 mm以上抜き、左外側から見て時計回り60°、機体外側の-Xへ抜く。CADは80 mm抜去まで確認する。落下防止コードは別に掛ける。

2本の固定ねじはメス足4＋ワッシャ0.5＋側板12を通り、内側ナット先端へ1.9 mm突出する。実ネジ・ナット・ワッシャを含む静止干渉、カメラ装着前のφ3×70 mm直線六角キー、上向きロックボルト45 mm抜去、5°刻み60°回転・80 mm抜去、ノブ全周＋半径3 mmの局所操作余裕、中央の手の予約領域と既存ケーブル予約領域を検査した。[今回の幾何検査](_work/analysis/camera_twist_20261021/geometry_checks.json)。φ3は直線工具包絡でありL字キーの曲がり・手全体の実物適合ではない。

## 既存フレームとライト

基本フレームは左右側板2・底板1・上部1。244×230×230 mm、前後の保護延長込み244×350×230 mm。厚8の4枚の延長は側板内側に固定。後端配線保護はエンドキャップ外面から50 mmで、既存φ75×50 mmの予約空間を維持する。上部フレームのφ10工具穴6本はクランプ締付ねじの真上を維持する。

右前ライトのC中心(122,80,130)、ライト軸X161/Y80、上向き+Z、保持区間Z89.5..170.5、側板からの突出59.5 mm、横ノブ+Yを維持する。33×81 mmの既存保持半割と押さえを流用。[側面twist規格](../../docs/child_horizontal_twist_interface.md)と[一体治具説明](../../parts/child/exterior/printed/child_horizontal_twist_mount/README.md)を参照。ライトの再生成でもカメラの配置・取付位置の状態・行順を保持する。

## 印刷・再生成

印刷データはparts内に実ファイルとして揃える。一体カメラは底板下、専用メスは取付足下。追加2部品はX1C・0.4 mm・Generic PETG、0.1 mm層・6壁・15% Gyroid・5 mmブリム、45°のベッドからの自動サポートを有効にしてスライス。カメラ背面の接続板・軸・爪の外部支持を除去してからCに入れる。メスの支持経路は最初の0.2 mm層のみで、側面・嵌合域へ支持は生成されていない。[専用メス3MF](print_jobs/camera_twist_20261021/child_horizontal_twist_mount_camera_receiver/child_horizontal_twist_mount_camera_receiver.3mf)は1個入り、約1時間16分・20.5 g。カメラ3MFは[親機側](../parent_exterior/print_jobs/camera_twist_20261021/camera_mount_twist/camera_mount_twist.3mf)の同一STL用を使えるが、STL一式はこのparts内だけで揃う。追加ノブは既存品をもう1個印刷する。

既存フレームとライトは従来のX1C・Bambu PETG Basic、8壁・100%、製造メタデータの姿勢を継続する。既存のprint_jobsはライトまでの旧構成であり、全19種類27個入りのジョブではない。今回のメス・カメラとノブを旧ジョブだけで揃えた扱いにしない。

parts直下にあった既存ライト用メスの3MFは、元のバイト列を保持して[print_jobsの履歴](print_jobs/history/imported_20261021/README.md)へ移動する。出所とSHAを同所に記録し、今回のカメラ用メス3MFと混ぜない。

python spec/build_camera_mount_m3.py --twist-only → python spec/configure_camera_twist.py → python spec/verify_camera_twist.py。ライトの回帰検査はpython tools/check_child_horizontal_accessories.py。全体SCADとSTLを更新し、python tools/assembly_parts.py sync child_horizontal_plate_frame → checkを実行する。交換用STEPは追加2部品で有効ソリッド・外形・体積を確認し、子機全体のSTEPは従来どおり未納品。全体SCAD/STLを確認用に使う。既存フレームの生成・検査は[基本部品説明](../../parts/child/exterior/printed/child_horizontal_plate_frame/README.md)。

今回の実メッシュ・警告なしスライスは合格。実印刷・C嵌合・実ケース・M5つまみ・画角・水流荷重・層間強度・クリープは未認定。95×45.9×75 mmのケースと底面高さは既存仮値。ライト実物の頭部・ボタン・配線と手袋は未モデル化。共通42テストは41件合格・既存の材料JSON欠落1件でエラー。[変更前の説明・配置・印刷一式](_work/analysis/camera_twist_20261021/history/snapshot.json)も保持する。

90°回転前の配置・説明・メス形状は[_workの履歴](_work/analysis/camera_upright_20261021/history/snapshot.json)、旧メス3MFは[portrait履歴](print_jobs/history/camera_portrait_20261021/)へ保持する。Cの取付位置と面内90°の向きを維持する。今回カメラ本体STLは前壁なしの小型版へ更新する。

前壁付きカメラの旧配置・説明は[_workの履歴](_work/analysis/compact_camera_20261021/history/)。現行の前壁なしカメラを1個印刷し、旧「○△○」前壁付きSTL/3MFへ戻さない。メス・ノブ・側板の再印刷は不要。

[TD04A改訂後の全体確認画像](_work/images/td04a_cable_r6.png)。幾何・STL/STEP・外装側ナット保持・スライス結果は[共通治具の検証](../td04a_fixture/_work/analysis/validation_summary.json)。センサー側の実締結成立・実物適合・強度は未検証。

parts直下の既存ノブ3MFをバイト列を保持してprint_jobs/history/imported_during_td04a_r6/へ移動。移動元・先とSHA-256は同所のmove_record.jsonに記録した。STLへの適合やスライス設定は未確認の履歴。

## parts/child/exterior/printed/child_horizontal_plate_frame/README.md

# 子機・横向き容器の4枚フレーム

2026-10-12更新。トップフレームにクランプ締付ねじ用の工具穴6か所を追加。X1 Carbon / Bambu PETG Basicの嵌合・荷重試験用（fit_prototype）。[組立説明](../../../../../assemblies/child_horizontal_plate_frame/README.md)、[配置正本](../../../../../assemblies/child_horizontal_plate_frame/placement.json)、[印刷入口](../../../../../assemblies/child_horizontal_plate_frame/parts/PRINT.md)を参照する。

寸法・取合いは共通 [child_horizontal_plate_interfaces.scad](../../../../../scad/lib/child_horizontal_plate_interfaces.scad)、形状は [SCAD](child_horizontal_plate_frame.scad)。元の生成ツール [prepare_child_horizontal_plate_frame.py](../../../../../tools/prepare_child_horizontal_plate_frame.py)を使う。

## 印刷済みと未印刷

側板2枚・底板1枚と、別設計元の上下クランプ各1個は印刷済み。形状・配置・設計元STLのSHA-256を固定する。共通SCAD更新後は照合用メッシュを別出力し、元STLと一致することを検証してバイト列を保持する。側板・底板のナット受けと丸穴は既存形状を継続する。共通のef_boreを変更せず、未印刷部品だけef_poly_boreを使う。

これから印刷するのは上部1、前保護延長左右各1、後保護延長左右各1、回転止め左右各1、支持治具4、C押さえ4の計15個。全体数量20個と取り違えない。左右側板・支持治具は180°回転で同じSTL、延長と回転止めは左右鏡像を別STLへ反映する。

## 開放ナット式

上部・支持治具・回転止めの六角ナット保持溝を廃止する。ナットを回り止めする埋込み形状を設けず、貫通ねじと普通M3ナットを使い、開放部からスパナで押さえる。既存取付穴位置は保持する。

支持治具は取付足厚8 mm、側板厚12 mm、ピッチ20×24 mm、ねじ中心Y=±50/±70・Z42/66。下クランプ取付面Z75.2と40×20 mm穴配置、支持梁厚17 mmを保持する。ナット側にもφ7×0.5 mmワッシャを置き、M3×25各4本。M3×30も幾何検査する。上段の梁には側端へ開いた工具通路と、ねじ先端を逃がす貫通穴を設ける。支持治具は広いガセット面をベッドへ向ける。

回転止めは広い底面が印刷ベッドに接するよう、manufacturing.jsonで設計元STLからX=90°回転する。配布STLではこの回転を反映済み。組立姿勢は保持する。回転止めは取付足厚8 mm、Y−98・Z122/142。M3×25各2本、M3×30も幾何検査する。工具は+Y側から入れる。公式蓋輪郭・隙間0.55 mm・受け奥行7.1 mmは保持する。取付足と受けの根元のR/面取りを継続する。

上部→側板は厚12 mmの接合座へ普通ナットとワッシャを置き、上から工具を入れる。側板厚12 mmを含みM3×30各2本、計4本。M3×40も幾何検査する。ねじ先端を逃がす穴は開放部の先まで通す。上クランプ→上部の8本は印刷済みクランプの受けを使い、M3×18を保持する。

## クランプ締付ねじへの上側工具穴

トップフレーム `top` に、クランプ上下を締めるM3×30の6軸と同軸の工具穴を追加した。既存8か所のクランプ取付穴とは用途が異なる。正本SCADの `hf_stations` と `hf_ear_rows` を使い、穴位置を別に手入力しない。機体XYの中心は左X−67.8481/Y−70・−50・50・70、右X67.8481/Y−60・60。厚10 mmを鉛直に貫通する。

工具軸は既存の仮包絡φ8×長70 mmを使い、半径1 mmの隙間から穴の内接円径φ10 mmを導出する。穴は補正した正12角形、両入口0.4 mm面取り。工具の持ち手をフレーム上へ出せる軸長を実物で確認する。縁に近い左側の内寄り2軸の周囲は局所的に広げ、穴中心から外周までの公称半径9.5 mmを確保した。外周のR2と0.6 mm面取りを維持し、入り隅も共通仕上げを通す。元のフレーム外形、接合座、取付穴、上面Z210.8は保持する。

[工具・穴断面の検査](../../../../../assemblies/child_horizontal_plate_frame/_work/analysis/top_clamp_access/validation.json)と[上面図](../../../../../assemblies/child_horizontal_plate_frame/_work/images/top_clamp_access.png)を参照。6本すべてのねじ頭からフレーム上まで、容器・クランプ・金具・ライトを装着した状態で工具軸の干渉を検査する。穴の両入口と中央断面、隣の輪郭までの残存肉厚、既存8か所の取付ねじの座面も照合する。工具径は仮定、PETGの強度認定は含まない。

6軸の工具進入、内接円径10の中央断面と入口面取り、既存8か所の座面は合格。両入口から0.001 mm内側と厚さ中央で調べた残存肉厚は最小3.3008 mm。変更したトップは閉メッシュ・単一連結・退化面0、従来の底面を下に実スライスしサポート押出0。0.2 mm層・PETG Basicの1個見積りは291.77 g・約6時間。その他9バリアントの頂点・外形・体積は変更前と一致し、全品の位置と全ねじ配置を保持した。再生成で変わったSTLの並びに合わせてスライスも更新した。

## 穴・面取り・印刷

未印刷6種類のM3穴は正八角形、内接円径3.5 mm、頂点径約3.788 mm。共通ef_poly_boreで半径をcos(180/8)により補正し、入口を0.3 mm面取りする。既存工具通路は保持し、新しい上側の工具穴φ10は正12角形・両入口0.4 mm面取り。外形R2・0.6 mm面取り、開放部のR0.5・0.3 mm面取りを使用する。印刷済み受けの六角角部は回り止めの機能形状として保持する。

保護延長厚8、前端Y174・後端Y−176、持ち手90×34、後方配線予約50 mmを保持する。C押さえの穴位置と既存底板の受けを保持する。B4個のM5固定、C2個の53 mm胴部保持、在庫質量2.24 kgは変更しない。

manufacturing.jsonの印刷姿勢を使用し、0.2 mm・8周・100%・5 mmブリム・サポート無効を使用する。支持治具の開放部の奥行を14→8 mmへ短縮し、短いブリッジとする。小径横穴は八角形の屋根を短いブリッジで印刷する。ブリムを除去して実物嵌合を確認する。旧3MFは履歴へ保存し、未印刷9種類・15個だけを現行スライス対象とする。印刷済み部品の再印刷は不要。

## 検証と制限

[開放ナット検査](../../../../../assemblies/child_horizontal_plate_frame/_work/analysis/open_nut_fastening/validation.json)は印刷済みSTLと配置、32組の開放ナット、代替ねじ、各種類の八角穴断面・座面の残存材料を検査する。スパナは頭幅10・厚2.6 mm・到達35 mmの仮包絡で、実工具を照合する。側板の取付穴・容器の挿入・回転止め・持ち手・配線予約・M5固定は既存検査を再実行する。

開放部付近の断面プローブで支持治具3.70 mm、回転止め2.50 mm、上部側方材8.50 mmの残存肉厚を確認する。開放部で支持梁の局所断面が変わるため、PETGの実荷重・締付け・層間強度・湿潤保持・クリープ試験が必要。強度認証を主張しない。全種類のSTEP変換・読戻しは未完了で、旧STEPは現行形状として使わない。

2026-10-10までの設計・検査・スライス説明は[変更前履歴](../../../../../assemblies/child_horizontal_plate_frame/_work/intermediate/history/before_open_nut_fastening/parts/child/exterior/printed/child_horizontal_plate_frame/README.md)に保持する。

[サポートなし検査](../../../../../assemblies/child_horizontal_plate_frame/_work/analysis/support_free/validation.json)は未印刷9種類・15個すべて合格。3MFのenable_support=0とG-codeのサポート押出量0、現STLのSHA、造形範囲を確認し、屋根の投影局所幅は最大7.71 mm。物理的なブリッジ品質は初回印刷で確認する。

## 内側の保護延長（Rev.3）

現構成はguard_front_inner / guard_rear_innerを使い、左X−110〜−102・右X102〜110の側板内面へ取り付ける。固定穴Y±98・Z100/176は従来位置、外側からM3×25、内側に普通ナットと0.5 mmワッシャ。左右各前後2本ずつ計8本、両側ワッシャ16枚。旧側板内側のナット受けは延長で覆われ、延長の内向き面でナットを工具保持する。M3×30も幾何検査する。

上部の12×28接合座と後部回転止めの24×35取付足には1 mmの逃げを設け、端から開ける。後部の工具は+Y側へ通せる。前後の端位置・厚8・既存固定穴は保持し、幅は260→244 mm。旧guard_front / guard_rearは外側配置の履歴用バリアントとして保持し、現行placementと印刷一式へ含めない。

後部延長の回転止めの逃げは、取付足に加えて斜めの腕まで開き、既存窓につなぐ。細い残材を作らず、上下・後端の外周材で連結する。

## parts/child/exterior/printed/child_horizontal_twist_mount/README.md

## 2026-10-29 素手着脱への改訂（現行）

カメラ専用の受けは外向きのねじ横抜き溝付き。初回固定は工具を使用し、以後のカメラ着脱はノブと指掛けスペーサで行う。現行条件・締結経路・制約は各assembly READMEの最上段を参照。旧横ボルト・旧ゴム方式は使用しない。

# 2026-10-29 カメラ専用4点支持受け

カメラ専用 `camera_receiver` 分岐を追加。既存 `frame_receiver` と `light_twist` はライト用として形状・配置を維持する。カメラ用STLは `child_horizontal_twist_mount_camera_receiver.stl`。

子機外面X=-122上の既存穴だけを使う。Y60/Z100・160のM3×18を維持し、Y98/Z100・176の前側ガード固定を共締めする。後者はM3×25をM3×30へ2本交換し、頭側ワッシャを受けの外へ4 mm移す。内側ガード・ワッシャ・ナット位置はそのまま。38 mm離れた2列4点で受けを支える。側板・ガードに加工や再印刷は不要。

取付足厚4 mm。Y60/Z120・140には直径8 mmの工具通路を残す。C中心は(-122,105,130)へ前方10 mm移動し、カメラの向きを維持。カメラ側の全構成部品を一緒に移し、ライトは移さない。中央の手の予約域Y=-45..45を避ける。

各締結経路はねじ頭→頭側ワッシャ→受け足→側板→（ガード側の2点はガード・内側ワッシャ）→ナット。側板側2点のナットは内面の既存六角座へ入り、締付方向の底面を使う。ガード側は既存内側ワッシャとナットで受け・側板・ガードを共締めする。

共通接続形状は `scad/lib/camera_rotary_joint.scad`。組立・解除は[カメラ共通説明](../dji_osmo_action6_mount_m3/README.md)、検証結果と印刷入口は[子機assembly](../../../../../assemblies/child_horizontal_plate_frame/README.md)。実物の保持力・材料強度は未認定。後続の旧日付の記録は履歴。

---

# 子機側面・一体型twist治具 Rev.4

正本は child_horizontal_twist_mount.scad。frame_receiver（フレーム台座＋Cメス）、light_twist（既存ライト保持半割＋Cオス）の2バリアント。各1個、単一連結の印刷部品。既存33×81筒と押さえを流用。差し込み姿勢から60°回して停止すると上向き、その横の水平ノブで締めて固定する。QR面内角0°、ノブ軸は機体+Y。

[組立SCAD](../../../../../assemblies/child_horizontal_plate_frame/child_horizontal_plate_frame_light_view.scad) をOpenSCADで開きF5。`pose="locked"` は固定位置、`pose="entry"` は差込位置、`show_frame=false` は治具単体。こちらは配置正本から生成される確認ビュー。

寸法・取合い・中央の手の予約空間・印刷・金具・検証は [共通規格](../../../../../docs/child_horizontal_twist_interface.md)。位置・数量の正本は [assembly](../../../../../assemblies/child_horizontal_plate_frame/placement.json)。C形状は既存公開モジュールを再利用し、ライトは元のhalf_holder(front,mount_plate)を呼ぶ。寸法は共通SCADへ生成される。

製造メタデータの姿勢：frame_receiverは0°、light_twistはX90°で筒軸垂直・下端をベッドへ。一体2部品は0.1 mm層。メスは厚4の平坦な一体足、N=0で段差なし・サポート無効。ライトオスだけベッドからの外部サポートを使う。新しい接続部はR2・面取り0.6、M3穴入口0.3。C爪・カム・ゴム座と既存ホルダーの嵌合形状を保持する。

旧frame_adapter/light_adapterの設計と印刷一式はassembly内のRev.1履歴へ保持。現行variantsとplacementには含めない。カメラは2026-10-21に一体Cオス付き部品を追加した。下のカメラ用メス節を参照。TD04Aは今後の設計。

一体部品のCGAL出力に生じる数値的なT頂点の退化三角形は、既存clean_stl_degenerates.pyのEdge Flipだけで処理する。頂点・面数を保持し、外形・体積・双方向表面誤差0.001 mm以内、閉メッシュ、単一連結を検査する。Rev.4ではメス10面・オス1面を処理し、表面誤差最大4.00e−8 mm、体積・外形差0。底板同士は中央部だけ0.05 mm重ね、旧底板の角を重複させない。再生成ツールと製造メタデータへ同じ処理を組み込んだ。

Rev.4：追加フレーム4枚は引き続き側板内側、台座M3×18各2本、ライト軸X161/Y80、突出59.5 mm。ノブ中心(136,105.5,130)、水平+Y軸。平坦な厚4足の入り隅をR2に仕上げ、既存32×32のC底板4穴を復元する。CのN=4以上の嵌合形状は保持する。Rev.3までの生成元・配置・印刷一式をassemblyのside_twist_r3履歴へ保存。

## カメラ用メス（2026-10-21）

camera_receiverバリアントは同じframe_receiver()にreceiver_u=-35、dock_rotation=90を与える。左前の既存Y60/Z100・160穴、厚4の足、M3×18・内側ナットを流用。C中心(-122,95,130)、ノブ軸+Z。カメラを外側から見て右へ90°回し、通常の横向きにする。ライト用の2バリアントのメッシュは別途再レンダリング・全頂点比較し、元のバイト列を保持した。カメラ側は同じcamera_mount_twistを親子で共用。専用メスは取付足下、0.1 mm・Generic PETG・6壁・15% Gyroid・5 mmブリム、自動支持有効・ベッドからのみ。実支持経路は0.2 mmの初層だけ。部品STEPは単一有効ソリッドで外形・体積がSTLと一致。配置・数量・組付けは[assembly説明](../../../../../assemblies/child_horizontal_plate_frame/README.md)。

## parts/child/exterior/printed/child_simple_light_mount/child_simple_light_mount.md

# 子機シンプル筐体用 水中ライトマウント（試作）

2026-10-11：ユーザー確認により、この本体・押さえを [横置きフレームのtwist取付](../../../../../docs/child_horizontal_twist_interface.md)へ形状変更なしで流用する。上向き、内径33・保持長81。配置と数量は新assemblyのplacement.json、印刷入口は `assemblies/child_horizontal_plate_frame/parts/PRINT.md`。これはライト実物の実測寸法を新たに確定したという意味ではない。過去のシンプル筐体構成も保持する。

2026-09-17 r2：サポート削減・控えめな肉抜き。ユーザー確認済み：背面中央のM3・40×40 mm接続、参考STLの短い筒がライト用。
元STLは `ref/Light_Gassyli_Holder.stl` に保存。短い筒の内径33・外径39・高さ81 mmを測定。
**33 mmは参考ホルダーの内径であり、ライト実物の測定値ではない。**
ガスボンベ保持部は含めず、ライトを横から着脱する二分割クランプとして再設計した。

完成形

## データ

- 本体：[STL](child_simple_light_mount_base.stl) / [STEP](child_simple_light_mount_base.step)
- 押さえ：[STL](child_simple_light_mount_cap.stl) / [STEP](child_simple_light_mount_cap.step)
- [パラメトリックSCAD](child_simple_light_mount.scad)
- [筐体に取り付けた組立STEP](../../../../../assemblies/child_simple_light_mount/child_simple_light_mount.step)
- [印刷用STL・手順](../../../../../print_jobs/child_simple_light_mount/PRINT.md)

## 寸法と取り付け

| 項目 | mm |
|---|---:|
| クランプ公称内径 / 保持長 | 33 / 81 |
| 筒の肉厚 | 4 |
| 半割間の締め隙間 | 1.5 |
| 接続板の規格座面 / 下側の造形用延長 | 60×60×6 / 10.5 |
| 筐体接続穴 | 40×40、4×Ø3.45（24角補正） |
| 全体外形 | 65×61×81 |
| 接続面からライト中心まで | 40.5 |
| 接続板と筒の最小隙間 | 14 |

CHILD-SIMPLE-M3-40x40 Rev.1に対応。共通寸法は `scad/lib/child_simple_frame.scad` から読み込む。
ローカル原点は接続面中心。+Yが筐体から外向き、Zがライト軸。
機体配置は `translate([0,-82,100]) rotate([0,0,180])`。
ライト軸は機体 (0,-122.5) に位置し、保持部はz=59.5～140.5。
TD04A座面下端z=160に対してマウント本体は19.5 mm下。
取付穴配列は上下反転取付可。r2の造形向きは必ず指定の+Zを上にする。ライトの発光端・スイッチ・頭部形状と照射方向は未確定。

## 締結と組立

- 筐体接続：M3×20ボルト4本、M3ナット4個、平ワッシャ8枚。
- クランプ：M3×20ボルト4本、M3ナット4個、平ワッシャ8枚。
- ナット厚は3～4 mm、ワッシャは各0.5 mm想定。実際のねじ先端と掛かりを確認する。
- 埋め込みナット・インサートは不要。

1. 穴のバリとサポートを取り、必要ならØ3.4～3.5で通し穴を仕上げる。
2. 接続板の外側からボルトを通し、筐体裏にワッシャとナットを取り付ける。
   外側は14 mmの隙間へ短腕のL型六角レンチを横差しする。長いドライバーの直進経路は筒が遮る。
3. ライトを本体の半円へ載せて押さえを取り付け、4本を均等に締める。
   半割の隙間を無理にゼロにしない。33 mmより細い場合は実測して `lm_holder_id` を変更する。
   肉厚、レンズ、ボタン、防水シール部を圧迫しない。
4. ライト自身のストラップ穴から機体へ独立した落下防止コードを掛ける。
   この部品は底止めのない摩擦保持なので、上下方向の抜け止めを実物で確認する。

## r2：サポート削減・肉抜き

保持径33、長さ81、M3・40×40の穴中心、筐体上の位置は維持。
接続板と中央支持部を印刷底面までつなぎ、下側のねじ耳の1 mmの浮きを解消。
上側の耳は約54°で立ち上がる斜面。横向きの穴はM3円形クリアランスを含む尖り屋根付きに変更。
接続板に20×30の菱形窓を2個、筒の側面に幅14×高さ46の菱形窓を追加。
上下のクランプ帯、中央支持部、ねじ座を残した。印刷底面が広がり、初層で全体が連続する。

X1C / Generic PETG / 0.20 mm / 6壁 / 100%充填 / 5 mmブリム、2部品同時のオフライン比較：

| 比較 | 旧r1 | 新r2 |
|---|---:|---:|
| 材料（ブリム・サポート込み） | 99.87 g | 86.52 g |
| 時間 | 3時間00分11秒 | 2時間52分45秒 |
| 自動サポートでのサポート生成 | あり | 0 |

材料約13.4%減、時間約4.1%短縮。スライサー見積りで、実機測定ではない。
自動サポート有効/無効の両方でr2の時間・材料は同値、警告なし。
[比較ログ](../../../../../print_jobs/child_simple_light_mount/slice_validation/comparison.json)。
印刷用3MFはサポートOFF。旧データは `ref/r1/` に履歴として保存（印刷には使わない）。

## 荷重と検証

仮定：ライト0.5 kg、取り回し係数5、25 N。実重量・水流・引っ掛け荷重は未確定。
本体の4ボルト周辺を固定し保持部に3方向から25 Nを加え、PETG充実材・Z積層で再解析した。

- 本体・押さえ：trimeshで閉メッシュ・各1連結ソリッド、FreeCADで有効ソリッドを確認。
  簡易inspect_meshの1 µm丸め検査は微小辺を潰し「open edge」を表示するが、
  高精度頂点による全辺の共有数検査とFreeCAD検査では閉じている。
- STEPは今回CSG変換器の押出し処理が失敗したため、STLからのファセットソリッド。
  パラメトリック修正はSCADを使用する。STLとSTEPの形状を照合する。
- [CAD検査](verification/cad_checks.json)：23/23 PASS。筐体接触、干渉、穴・頭・横差しレンチ・裏側工具空間。
- [FEA収束結果](verification/fea/child_simple_light_mount_base_fea_convergence.json)：3/1.5/0.75 mm。
  **3ケースとも収束未合格。改訂前の解析値はこの形状に適用しない。**
  最細格子の横荷重変位0.215 mmは参考値に留め、強度認定には使用しない。
  接触/摩擦、押さえ、締付け力、疲労・クリープは未評価で、引き続き嵌合確認用試作。

## 部品外の考慮・要確認

参考は保持具だけなので、ライト頭部の外形・長さ・ボタン位置・電池交換方向・ケーブルの有無は不明。
ライト実体を含めたTD04A・ケーブル・照射範囲との干渉確認は完了していない。
端部は貫通して水抜きを確保。実際のケーブルは筒端から出し、曲げ半径と余長を実物で決め、筐体側へ別固定する。
筒で覆われる長さは81 mm。放熱部や操作部がこの区間にあるライトは、保持位置または窓形状の変更が必要。
まず嵌合と脱着を確認する試作とし、実使用前に抜け・緩み・変形を実物で確認する。

## 横置きRev.2の一体型への流用

2026-10-11ユーザー指定：固定治具とtwistを一体化し、上向き照射。half_holder(front=false,mount_plate=false)で既存台座・背骨を省き、筒・耳・窓・穴を同じ形状で再利用する。押さえは既存STLを共用。元のbase/capは別レンダリングで頂点・体積一致を確認しSTLハッシュを保持した。一体型の位置・造形向き・外部サポートは[Rev.2規格](../../../../../docs/child_horizontal_twist_interface.md)を参照。

## parts/child/exterior/printed/child_wte4_petg_clamp/README.md

# 公式4インチ取合いのPETGクランプ

2026-10-07ユーザー指定「Blue Robotics公式4インチクランプを元に、PETG用の改良版を今回作る」を実装する独立部品。**fit_prototype**。既存 `child_wte4_suspension_clamp` の最適化メッシュや原本を変更せず、この新設計を最適化後処理と称さない。

公式 [製品](https://bluerobotics.com/store/watertight-enclosures/enclosure-clamp/) と [取付ガイド](https://bluerobotics.com/learn/watertight-enclosure-clamps-guide/) の4インチを参照する。メーカーSTEP原本は [BR-102678-004 Rev C](../child_wte4_suspension_clamp/ref/WTE4_CLAMP_BR-102710-004/BR-102678-004_RevC.STEP) にある。元の取付面は中心から62.8 mm、取付軸X±20・軸方向±10（40×20 mm）。締結軸X−67.848に2本、X+67.848に1本を解析面から読み取った。参照は購入品寸法の利用で、メーカー材質/耐荷重を印刷品へ引き継がない。

## 改良内容

- 取付面62.8 mm・40×20 mmの穴配置を保持する。クランプからフレームに向かう延長脚・長い耳を作らない。フレームの支持面をこの位置へ合わせる。
- 帯幅を30から40 mm、外周肉厚を8 mmにする。取付面では外周を62.8 mmに切りそろえる。最大横幅は元CADより増えるが、増分はリング・締結部の局所肉厚でありフレームへ届かせる腕ではない。耳のねじへφ8工具を入れる通路を確保する。
- アルミ用M4ねじ穴をM3普通ナット方式へ変更する。φ3.5穴、二面幅5.8・厚2.8のポケット。M3 AF5.5・厚2.4普通ナットのモデルで確認する。取付ナットは軸方向両面から差す。溝の二面幅を保ち、上下ナットの入口を分離する。
- 2026-10-08ユーザー指定で、前後120 mm間隔の2組を上側どうし・下側どうしで連結する。`upper_linked` と `lower_linked` を各1個、計2個印刷する。帯幅40 mmと前後の取付位置を保ち、全長160 mm。左右45°の肩に幅12×厚5.2 mmの連結材を2本ずつ設け、根元は1 mmの45°面取り、縦の稜線はR2、端部は0.6 mm面取りとする。連結材と根元は既存リングの肉厚範囲内に収める。
- 下側だけ耳の外面に普通ナットの受けを持つ。耳の締結はM3×30、各位置3本・計6本。上下は分離でき、下側を側板へ固定して容器を上から載せ、前後一体の上側を被せる。取付ねじ、ナット差込み溝、保護材4枚は従来どおり。単独の `upper` / `lower` は同じ設計元に比較・履歴用バリアントとして保持し、このassemblyの印刷対象から外す。
- ゴム厚は1 mmで確定（2026-10-08ユーザー確認）。内径は114.3 mmの容器と1 mm保護材を前提にφ115.9 mm。これは片側のゴムを1.0から0.8 mmへ圧縮する計算で、圧縮量0.2 mm（20%）と合わせ面隙間1.6 mmは仮値。容器の径公差±0.8 mmを締付けで無理に吸収せず、実物の寸法と保持力を確認して保護材/圧縮設定を調整する。

寸法は [共有インターフェース](../../../../../scad/lib/child_horizontal_plate_interfaces.scad)、形状は [SCAD](child_wte4_petg_clamp.scad)。上固定はM3×18を各半体4本、下固定はM3×25を各半体4本。φ7・厚0.5ワッシャを使用し、変更するとねじ先端余裕が変わる。取付ねじ先端はアクリル外形と直接干渉しないことを実メッシュでも確認する。締付トルク値はまだ指定しない。

X1 Carbon / PETG Basic / 0.4 mmノズル / 0.2 mm積層 / 8周 / 100%インフィル / 5 mmブリム。断面をベッドへ、軸方向+Zに160 mm積層する。上の帯の下面、横穴、ナット溝と連結材の内側は自動サポートを検査・除去する。80 mmの帯間を無支持で橋渡ししない。外周/断面入口0.6 mm、穴0.3 mm、ナット入口0.25 mm、面内R2。ナット回り止めの内角・平面座面は機能上保持する。

印刷一式・配置・ねじ数量は [assembly](../../../../../assemblies/child_horizontal_plate_frame/README.md) の正本へ集約する。荷重解析・造形実験・湿潤保持/クリープ試験による認証はまだない。保護材の実厚と圧縮量を確認してから本容器を締める。

STEPの全体変換は未完了。今回の現行モデルはSCADとSTLを参照する。

`python tools/check_child_horizontal_clamp_links.py` は既存半体2個ぶんの材料保持、前後一体の閉メッシュ、中央断面の連結材2本と寸法、容器の上からの挿入を検査する。全体のねじ・工具・配線予約はassemblyの通常検査を併用する。軸方向連結の追加による強度向上は実物試験前で主張しない。

## X1 Carbon向けトポロジー最適化（2026-10-08〜09、試行不採用）

ユーザー指定により対象を前後一体のクランプ上下に限定する。現行STLは軸方向+Z、全長160 mmで縦に印刷している。24姿勢の造形性比較でも+Zが最良だが、これは荷重未入力の印刷指標だけの順位で、強度による順位ではない。上側の帯の下面と穴にはサポートが必要。上半体の45°判定で、ベッド接触を除く要サポート表面は2144.7 mm²。

`spec/prepare_topology_inputs.py` は既存SCADの輪郭と各半体から、連続した半円筒状の設計領域、ゴム接触面・取付座・締結耳の保持領域、既存の穴とナット差込み経路を生成する。探索を既存2本の連結材の形だけに制限しない。入力形状は `_work/analysis/topology_print/`、入力生成SCADは `_work/intermediate/topology_print/` に保存し、印刷用部品として配布しない。

条件正本は `spec/print_topology_request.json`。材料はBambu PETG Basic、X1C 0.4 mmノズル・0.2 mm積層を引き継ぎ、Z積層の異方性と自己支持条件を入れる。密度場を直接平滑化し、機能寸法だけ局所復元する。長い水平ブリッジ、閉じ込めたサポート、接触面のサポート傷、連結性・最小肉厚を検査し、完成形状を再解析・実スライスしてから採用する。

容器と中身は1 kg未満、取り扱いは自重の2倍で十分とのユーザー回答（2026-10-08）により、上限1 kg・2g・合力19.6133 Nとする。`spec/author_print_topology_studies.py` が上下のnative topopt studyを生成する。3軸の取り扱い、組立途中で片側ステーションだけが固定された場合の3軸伝達、仮の締付軸力150 N/本を別ケースで扱う。線形解析で50/100/150 N/本の感度を確認するが、実測値や締付トルクの指定ではない。要求安全率2、変位上限1 mmは解析上の仮条件。汎用PETG異方性カードを用い、X1C実測の層間特性・湿潤滑り・クリープを保証しない。

実行済みの探索は2 mm解析ボクセル・6 mmフィルタ・+Z自己支持条件・自由領域体積率0.35、100反復。保持領域は予想完成体積の約63%を占め、主な自由領域は帯間の接続と非機能部分である。上下とも700回の線形ソルブは収束したが、最適化の終了理由は `max_iterations`。密度変数の収束、しきい値0.5の体積上限、4 mm部分を2 mmボクセルで評価する解像度は不合格であり、全体合格とは扱わない。

`upper_run03` と `lower_run05` の保存密度場をnative `extract` で直接平滑化し、`finish_print_topology.py` で機能CADを局所復元した。下側にはplacementから算出したC押さえのφ8工具通路＋片側0.5 mm余裕を設計障害物として加えた。単純な梁・リングへの再構成は行っていない。`quality_finish_surface.py` は密度由来の表面をMeshLabで整理する。数値不正面を除くためのMeshFixは体積・連結・Euler数を検査し、穴が埋まった試行は棄却した。

干渉検査を通った候補は `_work/analysis/topology_print/upper_run03/local_finish_clearance/simplified_0.0001.stl` と `lower_run05/local_finish_clearance/finished_interfaces.stl`。各1個の閉メッシュで自己交差なし。ナット入口に片側0.05 mmの仕上げ余裕（平行面間5.9 mm、深さ2.9 mm）を追加し、上側ワッシャ座面を0.05 mmだけ局所的にさらった。`check_topology_assembly.py` で構造部品、ねじ、工具、ナット挿入、配線・手・保護帯、容器の10段階の持上げ経路を検査した。これは現行の印刷用STLではない。

候補上側を実際のBambu Studioで縦向き・0.2 mm・8周・100%・PETG Basicとしてスライスした結果、樹状サポート込み238.78 g・28,914秒（約8時間2分）、サポート25.44 g。現行上側も同じ樹状設定で比較すると216.26 g・24,419秒（約6時間47分）、サポート24.95 g。候補は総量が約10.4%、時間が約18.4%増え、印刷改善にならなかった。記録は `baseline/slice_upper_tree` と `upper_run03/slice_local_tree`。通常サポートと樹状サポートを混ぜた比較で軽量化を主張しない。樹状設定は比較試験のみで、現行の製造設定は変更していない。

完成形状のCalculiX再解析は収束を確認できず、不採用とした。上側の局所仕上げ後メッシュに対し、片側固定X荷重の最悪要素安全率は12 mmで1.027、6 mmで0.447。3 mmではGmshが終了コード3221225477で停止し、収束結果はない。p99.5の値だけで局所不合格を隠さない。下側でも数値不正面やメモリ不足が生じ、完成品の強度を確認できていない。記録は `upper_run03/ccx_finished_bounded`。解析領域を狭めて軽くする操作は行っていない。

最初の最適化で仮定した広い締付パッチの一部が拘束領域と重なっていた。元studyは `_work/intermediate/topology_print/*_study_preload_broad_patch.json` に保存した。現在のstudyは実際の6か所のねじ座面へ150 Nずつ（合計900 N）を与える条件で、荷重を減らしていない。下記の連結部分の再最適化は、この修正済み条件で最初から実行した。

次に `spec/prepare_connection_topology.py` で、元の滑らかな40 mm帯を全体保持領域とし、帯間だけを自由領域にした。これは再最適化前の入力条件であり、最適化結果を単純な帯・梁へ置き換える処理ではない。現行CADの体積から1%減を目標に自由領域率を約0.0514と算出した。保持領域は予想完成体積の約95%なので、クランプ全体を最適化したとは扱わない。上下とも2 mmボクセル・6 mmフィルタ・+Z自己支持・100反復を実行し、700/700ソルブ、保持領域の連結、体積制約は合格した。しかし密度・目的関数・形状は未収束で、終了理由は `max_iterations`。

この連結案も不採用。両端固定の取り扱いでは変位約0.052 mm以下だが、片側ステーションだけの固定では、上側は57.6〜106.5 mm、下側は252.2〜421.5 mmの線形解析変位となり、仮の1 mm上限を大幅に超える。この大変形値は実際の変形量の予測には使わず、連結部の剛性が不足する診断とする。片側固定のp99.5安全率も上側最小1.15・下側最小0.59で要求2を満たさない。全ケースで最小4 mm部分が2要素しかなく、解像度検査も不合格。これを平滑化・局所復元だけで合格品にすることはしない。完成形状のCalculiX収束・実スライス・サポート除去性の検査へ進めていない。記録は `connection_only/{upper,lower}_run01/opt` と `connection_only/rejection_summary.json`。

**トポロジー最適化による採用形状は得られていない。** 現行の連結版SCAD/STL・印刷姿勢・製造設定を保持し、探索メッシュを印刷一式へ配布しない。現行品も耐荷重認証済みではない。再開する場合は、必要な組立荷重条件、自由領域の体積配分・最小部材厚、ボクセル解像度と反復収束を見直し、完成形状の再解析と同条件のスライス比較をやり直す。状態の記録は `_work/analysis/topology_print/execution.json`。

## parts/child/exterior/printed/dji_osmo_action6_mount_m3/README.md

## 2026-10-29 素手で着脱するカメラ接続（試作・現行）

カメラ1台分の新しい印刷品は、共通カメラ本体1個、その機体用の受け1個、指掛け付きUスペーサ2個、手回しノブ2個、ノブ蓋2個。前側押さえ、フレーム、ガード、ライトは変更していない。旧カメラ接続用3MFは使わず、今回の `print_jobs/camera_hand_release_20261029/` を参照する。購入金具は各機に六角頭M3×30 2本（頭部二面幅5.5 mm・厚さ2 mmを仮定）とM3普通ナット2個。従来のソケットねじ・ワッシャはこの接続に使わない。部品の入手状態と現物寸法は未確認。

初回のみ受けを既存フレームに固定し、各ねじをノブ上側から通して蓋を押し込み、六角頭を囲む。蓋の突起は保持用で、締付力はねじ頭→ノブの厚1 mmの印刷床→カメラ耳→Uスペーサ→受け→ナット屋根で受ける。初回の受け固定には工具が必要。ノブ床の強度、クリープ、蓋の弾性と繰り返し保持は未検証。蓋は中央円盤に4本の弧状アームを持つ。アームを長さ約6.8 mm・幅1.75 mmの直線片とみなし、先端を0.15 mm曲げた簡易見積りは表面ひずみ約0.9%であり、曲がった実形状や積層を含む強度解析ではない。

通常の取外しはカメラを支え、各ノブをねじ山が外れるまで緩める。必要に応じてノブを約0.5 mm持ち上げ、頭の座面が約3.8 mm上がった状態にする。先にUスペーサの指掛けをつまんで接続座標の−Xへ抜き、次に各ねじ・ノブを受けの外側へ横に滑らせて外す。その後カメラを60°回して軸方向に引き抜く。取付は逆順で、カメラを回してからねじを横から入れ、スペーサを入れてノブを手で締める。落下防止コードを別に取り付ける。

親子の実メッシュで、接触・ナット反力・ノブの六角回り止め・蓋の引抜き障害と、上記の離散位置を検査した。指先φ9 mmからφ16 mmへ広がる長さ25 mmの指2本を同時に仮定した進入・引抜きも検査した。手全体、連続掃引、実物寸法、濡れた手での操作、締付力、振動・強度・爪の耐久は未認定。ケース幅95 mmは仮値、厚さ41 mmは既存実測値。特に解除途中のノブと仮ケースのZ方向すきまは約0.4 mmのため、現物の形状と寸法で確認する。詳しい結果は 各assemblyの `_work/analysis/camera_hand_release_20261029/geometry_checks.json`。既存節の数値・94項目等は旧版の履歴であり今回に流用しない。

# 履歴：2026-10-29 工具締付け版（上記の素手着脱版に置換）

対象はカメラ固定治具だけ。既存の親機外装・子機フレーム・ガード・ライトは形状と配置を維持する。以下は工具締付け版の履歴であり、現在は上記の素手着脱版を使う。**この改訂の検証状況は両assembly READMEを参照。実物の保持力・強度は未認定。**

## 交換部品と締結

各機で共通カメラ本体 `camera_mount_twist` 1個、専用受け1個、共通 `camera_rotary_spacer` 2個を印刷する。ケースを挟む既存 `camera_front_clamp` はそのまま使用。ケースの実測厚さ41 mm、M5軸、前後押さえは変更しない。ケース幅95 mm・高さ75 mm等は既存仮値であり、実物での工具余裕を確認する。

回転接続は60°の着脱を残し、固定後にM3×30ソケットねじ2本、外径7×厚0.5 mmワッシャ2枚、M3普通ナット（AF5.5・厚2.4 mm）2個で締め付ける。旧横ロックねじ・ノブ・ゴム2枚は使用しない。

受け座標の締付軸はX=0,Y=±52 mm。締結経路は、ねじ頭座面Z31→ワッシャZ30.5..31→カメラ側耳Z18.5..30.5→着脱UスペーサZ8..18.5→受け側耳Z0..8→ナット上面の屋根Z4.8。ナットは横から挿入し、締結時に+Zへ引かれて屋根で止まる。締結位置のナットはZ2.4..4.8。ねじ先端Z1、穴底Z0.5、ナットから1.4 mm突出。ねじ山はナット全厚2.4 mmにかかる。

ナットの回り止めと上向き抜け止めを別々に検査する。ナットの外向き挿入溝は組立用なので、ねじを外したときにナットが横へ落ちないよう扱う。接着剤を締結反力の代用にしない。スペーサの公称厚さ10.5 mmは面間寸法と一致する。印刷後、支持材や初層の張り出しを除去し、手で挿入できることを確認する。入らないものをねじで無理に押し込まない。

## 組立と解除

1. 受けを外装へ取り付ける。子機はカメラを取り付ける前に4点を締結する。
2. 受けのナット2個を横から入れる。カメラを差し込み、60°回して固定位置へ合わせる。
3. Uスペーサ2個を接続座標の+X方向へ差し込み、M3×30とワッシャを装着する。左右を交互に締め、各接触面が着座していることを確認する。規定トルク・保持荷重は実測未認定。
4. 解除時はカメラを支え、両ねじとワッシャを完全に取り外す。Uスペーサを接続座標の−Xへ14 mm以上抜く。その後に60°回して外へ引き抜く。スペーサを残したまま回さない。独立落下防止コードを使う。

## 正本・印刷・検証

共通接続形状の正本は `scad/lib/camera_rotary_joint.scad`、カメラ本体とスペーサの生成は `spec/build_camera_mount_m3.py`。子機受けは既存 `child_horizontal_twist_mount.scad` の `camera_receiver` 専用分岐、親機受けは `spec/parent_exterior_revision_sources.py` の `qr_source()`。ライトの旧Cモジュールは変更しない。

配置は各assemblyの `placement.json`、配置更新は `spec/configure_camera_fixture_clamp.py`。旧 `configure_camera_twist.py` は旧形状へ戻すため実行禁止。検証は `spec/verify_camera_fixture_clamp.py`。交換部品STEPと組立の更新は `spec/export_camera_fixture_clamp.py`。印刷一式の入口は各assemblyの `parts/PRINT.md`。

カメラ本体は既存と同じ底板下、受けは外装取付面を下、Uスペーサは厚さ10.5 mm方向を積層方向にする。新規耳は面取り0.4 mm、外周R2、スペーサ外周R1.2・面取り0.4 mm、穴入口0.25 mm。Cの機能面は接触・挿入条件を優先する。カメラ背面とC爪、受けのナット溝屋根は支持／ブリッジの確認対象。スライスの有無と結果はassemblyの検証欄に記録する。

CADの閉メッシュ・干渉・締結経路・スライスと、実印刷・濡れた状態の保持力・クリープ・疲労は区別する。荷重、材料物性、積層方向を使う強度解析は今回未実施。

---

# 2026-10-29 前側押さえをさらに右へ5 mm移動

前側L字押さえと本体取付床・M4穴をローカル −X へ5 mm移動。接触帯 X=5.5..30.5、M4軸 X=11.5, 24.5。M5爪を避ける局所逃げを追加し、カメラ姿勢と素手着脱式回転接続を維持する。実物の締結・保持は未確認。

# 履歴：幅25 mm・右へ12 mm移動した前後押さえ（2026-10-29で置換）

2026-10-26位置改訂。前側押さえ・床延長・取付穴を正面から見て右へ12 mm（ローカルX=-12 mm）移動。背板から前へ張り出していた四角い追加パッドを撤去し、元の背板を直接後側の当たり面として使う。前側押さえの足をカメラ側へ反転し、元の左右底面受けは撤去。前方端をY=45.49から29.49へ16 mm短縮。ユーザー実測のケース厚さ41 mmを採用。2026-10-24の底面受けだけでは回転保持が不十分だったため、正面から見て左端から12〜37 mmの幅25 mmを後側受けと別体の前側押さえで挟む。実物での新方式の回転保持・強度はまだ未検証。

## 現行の部品と位置

親機・子機は共通でcamera_mount_twist（Cオス一体の本体）1個とcamera_front_clamp（前側押さえ）1個を使う。追加購入品は各機M4×16ソケットねじ2本、M4普通ナット2個（二面幅7・厚3.2）、外径9・内径4.3・厚0.8 mmワッシャ2枚。元のカメラM5固定とCロックは継続する。

座標は+Yがカメラ正面、+Zがカメラ上。正面側から見る左は+X。ケース幅95 mmは既存仮値なので、押さえの対象域はX=10.5..35.5（旧X=22.5..47.5）。ねじ中心はX=16.5,29.5。背板の既存面Y=-23.45を後側基準とし、前側の当たり面をY=17.55に合わせ、公称41 mmの間隔を維持する。ケース参照モデルも同じ背面基準へ移した。実物のM5軸とケース背面の距離は未測定なので、実物の取付角・当たりの確認が必要。旧45.9 mmはC接続／背板位置の互換用寸法だけに残し、ケース厚さとして使わない。

前後受けの公称間隔41 mm。前側押さえは長穴で外向きに0..3 mm開け、ケースに当ててから固定する。後側は追加パッドではなく元の背板。前側25 mmの接触帯に対し、背板との重なり幅は25 mm（X=10.5..35.5、中央開口と既存取付穴があるため全面接触ではなく、右寄りの帯と上側で受ける）。前側接触高さはケース底から約1..30.5 mm。ケース幅95・高さ75、M5軸から底まで12.5 mm、実物のM5軸からケース背面までの距離は引き続き未測定。今回確認できた実測値は厚さ41 mmだけ。左右／上下の正確な接触位置とボタン・ケース継ぎ目・画角は実物確認が必要。

左右の底面受けを撤去し、背面下側の突起に対する背面20 mmの空間も維持する。前側押さえの内向き足はY=0.55..25.55、床延長はY=3..29.5。中央M5爪と床は残す。中央固定爪と押さえを横方向に分離し、公称2.85 mmの隙間を確保。20 mm移動版で追加した切欠きを廃止し、通常のL字足へ戻した。元の背板がケース背面を受け、底面の突起を挟まない。

## フィレットと印刷

新しい前側押さえ・前側床延長の外縁はR1の3Dフィレット。前側押さえの立ち上がり根元はR3の凹フィレット。既存背板の外縁もR1、後側補強リブの輪郭もR1に変更。ねじ座面・ナットの回り止め・M5嵌合・C摺動面は機能面を保持し、穴／長穴入口は0.25〜0.3 mm面取り。メッシュ近似による外形誤差は約0.01 mm。

本体は底板、前側押さえは足の下面をベッドへ向ける。X1C・0.4 mm・Generic PETG・0.1 mm層・6壁・15% Gyroid・ブリム5 mm、ベッドからの自動支持。本体下面のねじ頭用座ぐりとC部の支持材を除去してから組む。前側押さえも自動支持を有効にしてスライスする。足・ナット座付近の支持材を除去し、ナットが座面まで挿入できることを確認する。印刷入口は各assemblyのparts/PRINT.md。旧camera_clamp_right20_20261026、camera_left_clamp_flush_20261025、camera_left_clamp_inward_20261025、camera_left_clamp_20261025、camera_bottom_clearance_20261024、camera_twist_20261021のカメラ3MFは旧形状であり今回使わない。

## 締結と組立（内向きL字・下面から締付け）

1. 前側押さえの足の上側からM4ナット2個を入れる。ナットはZ=10.6..13.8、長穴状の六角座はX方向で回り止めし、下側の座面Z=10.6が締付け時の下向き反力を受ける。座の下の肉厚は2.6 mm。ケース装着前にナットを入れる。
2. 本体下面からワッシャとM4×16ソケットねじを入れ、前側押さえへ仮止めする。ケースをM5取付部へ装着して背側受けへ当て、前側押さえを寄せてから下面から2本を交互に締める。0..3 mmの位置調整は手で行う。
3. 締結経路はねじ頭座面Z=4→ワッシャ0.8→本体床の反力面Z=4.8→本体床上面Z=8→前側足の下面→ナット下面Z=10.6。ナットは-Zへ引かれて足の座面で止まり、ねじ頭・ワッシャは+Zへ引かれて本体の段付き穴の天井で止まる。D9.6の座ぐりに頭とワッシャを収納し、ねじ頭下面はZ=0で突出しない。段付き穴上の肉厚3.2 mm。M4×16を流用し、先端Z=20、ナット上端から6.2 mm突出するがケース底Z=36.5まで16.5 mm残す。かかりはナット全厚3.2 mm。工具はY=11.5の穴に本体下面側から入れる。
4. 前後の押さえがケースの回転に反力を与える。長穴部の位置保持はねじの締付けによる摩擦に依存するため、濡れた状態での滑り・締付トルク・長期クリープは実物試験が必要。防水ケースを変形させる過大な締付けは避ける。独立落下防止コードを使う。

## 正本と検証

正本：spec/build_camera_mount_m3.py。camera_mount.scad、camera_left_clamp.scad、camera_front_clamp.scad、camera_case_41mm.scadは生成物。再生成はpython spec/build_camera_mount_m3.py --parts-only。配置はspec/configure_camera_left_clamp.py、検証はspec/verify_camera_left_clamp.py、STEP・組立はspec/export_camera_left_clamp.py。支持形状を変更したため旧底面受け検査のPASSを流用しない。

結果は_work/analysis/clamp_clearance_20261026/。閉メッシュ、前後接触、±0.5°の剛体回転阻止、背面退避、ねじ・工具、ナットの挿入／回り止め／-Z保持、親子組立干渉、C離脱経路を分けて検査する。離脱経路は離散検査で連続掃引保証ではない。CAD接触・回転阻止は実物の締結成立や保持力の保証ではない。旧版と文書の原本は同解析フォルダのhistory/に保存。

## parts/common/exterior/printed/td04a_bracket_mount/README.md

# TD04A固定治具 Rev.6：12 mmピッチ・ケーブル逃げ60 mm

2026-10-25ユーザー指定。正本はtd04a_bracket_mount.scad。旧TD04A本体モデルは使用しない。過去の10 mmピッチと親機形状保持の条件を今回の指定で更新した。旧データはassemblies/td04a_fixture/_work/analysis/cable_clearance_r6/history/に保持。

- TD04A取付はM4貫通ねじ＋普通ナット2組、CADの穴中心間隔12 mm、内接クリアランス径4.5 mm。「約12 mm」の指定であり実測一致の認定ではない。
- 送受信面は親機-Z、子機+Z。取付面はその面に直角という既存の取合いを引き継ぐ。本体の仮形状は表示しない。
- 穴列から外装側へ60 mmを確保。板厚5 mm、穴列オフセット65 mm、治具長75 mm。親機はフランジ下面から穴列まで60 mm。子機は穴列より下へ60 mmの予約域。図の幅12×奥行15 mmは検査用の仮幅で、実ケーブルの根元・曲げ半径まで確認した意味ではない。

## 実配置と締結経路

親機：parent_exteriorの既存XY=(65,-55),(85,-55)のM5穴を使用。治具原点(53,-55,-20)、Z回転-90度。接触面Z=-20、治具下面Z=-25、M4穴列Z=-85。M5×40皿頭→主プレート→治具5 mm→M5ワッシャ1 mm→M5ナット4 mm。ワッシャZ=-26..-25、ナットZ=-30..-26。皿ねじの先端Z=-40.8、ナット下面からの突出10.8 mm。防水容器を外して上から皿頭へ工具を入れ、下からナットを保持して組み立てる。既存ねじ先端の突出は長めなので、TD04A実物との干渉を初回確認する。ナットは下から工具で保持し、締付時の+Z移動はワッシャと治具下面で受け、主プレートを挟む。旧押さえ金具・クランプねじ・TD04A参照モデルは今回の配置から外す。親機内外装統合等の旧構成へは自動反映しない。

子機：child_horizontal_plate_frameの既存右後側M3縦2穴を使用。治具原点(122,-74,108)、穴列X=148/160・Y=-74・Z=173。M3×20頭→φ7×0.5ワッシャ→治具5 mm→側板12 mm（内側2.8 mmナット座）→M3ナット。既存のナット座肩が締付時の+Xを受ける。内側からナットを入れ、外側から締める。側板加工なし。ねじ先端はナットから2.9 mm突出。穴位置・工具通路・ナット挿入・ケースとの干渉を検査し、軸方向保持は連続掃引形状でも検査する。

センサー側は後方からM4ねじ頭→φ9×0.8ワッシャ→治具5 mm→実物の取付耳→φ9×0.8ワッシャ→ナット3.2 mm。耳厚3 mmの仮定ではM4×14、先端突出1.2 mm。ナットはスパナで回り止めし、締付時に取付耳をワッシャ越しに受ける。耳厚・座面・穴縁肉厚は未採寸のため、センサー側の締結成立は未達。実物に合わせてねじ長さを決める。接着剤を保持に使わない。

## 印刷と検証の範囲

親機外形26×42×75、子機45×26×75 mm。親機[0,-90,0]でL字側面下、子機[0,0,0]でL字下端下。外周R1.5、内角R3、端面取り0.6、穴入口0.3、穴先端R0.15 mm。横穴は印刷+Zへ屋根を向ける。PETG Basic/X1C/0.4ノズル/0.2層/8壁/100%/ブリム5 mmを試作条件とする。実造形・荷重・クリープは未検証。

印刷入口は各assemblyのparts/PRINT.md。各外装に1個ずつを同梱し、td04a_fixtureのpartsは同じ2部品の比較用一式。両方を重複印刷しない。旧Rev.5の3MFは現行形状に使わない。

再生成：python spec/rebuild_td04a_fixture.py → python spec/install_td04a_fixture.py → python spec/check_td04a_fixture.py → python spec/check_td04a_exteriors.py。外装組立はbuild.ps1 -Assembliesで再生成、印刷一式を同期する。SCADが正本、STEPは交換形状。閉メッシュ・外形・干渉・ナット保持・スライスと実物締結・強度は別の検査。

Rev.6検証：部品67項目・外装8項目・STEP読戻しは合格。スライスと実G-codeの監査も合格。自動支持は少量を提案しており、支持無効試作の実印刷は未確認。共通42テストは41合格、既存材料JSON欠落1エラー。

## parts/common/jigs/quick_release_prototypes/quick_release_prototypes.md

# 小型オス／メス脱着インターフェース3案

2026-10-11：側面機器接続用 `twist_male_mount` を同じSCADのバリアントとして追加。[取付規格](../../../../docs/child_horizontal_twist_interface.md)。既存9種類の比較試作は保持する。追加オスの裏側32×32の4穴へ90°皿座（深1.45）を設け、M3×18皿ねじの頭を回転面の0.425 mm内側へ置く。裏へナットや普通ねじ頭を出すとメス側壁へ当たる。これはRev.1の別体接続用バリアントとして保持する。現行Rev.2は公開twist_male/femaleモジュールを治具へ直接unionして一体化し、別体オスと皿ねじを使わない。軸・爪・カム・ゴム・横穴は元と同じ。[既存9分岐の形状照合](_work/analysis/mount_variant_equivalence/validation.json)。追加オスにSTEPはなく、標準オスのSTEPを使わない。

使用構成: [quick_release_trials](../../../../assemblies/quick_release_trials/README.md)。印刷入口: [PRINT.md](../../../../assemblies/quick_release_trials/parts/PRINT.md)。原本は同階層のquick_release_prototypes.scad、単位mm。公開モジュールをuseして組み込む。荷重集中の少ない機体・テザー固定用の比較試作で、取付先・金具寸法は仮定。耐荷重・疲労・実物の脱着は未検証。

## 2026-09-28: 固定ナット内蔵と取付面

従来の固定側金具は六角ボルト頭だった。今回、左右を入れ替え、左に固定ナット、右に手回しボルトを置く。突出した薄い頭受けを廃止し、40 mmプレート外形内の一体ブロックへ六角ナットを埋め込む。締付力はナットの内側端面と本体壁で受け、圧入の引抜き抵抗には依存しない。

ナットポケットは対辺5.75、深さ2.55、上向き開放。仮定のナット対辺5.5・厚さ2.4に対し、軸方向余裕0.15を外側に設け、内側端面を荷重受けにする。左外側の残り壁厚はA=3.35、C=4.35。接着前には上へ抜ける。初回に金属と使用樹脂に対応する少量のエポキシをナットの外側端面・ポケット外壁側に点付けして脱落を防ぐ。ねじ山、荷重受け端面、摺動面へ付けない。六角輪郭が回転を抑え、接着剤は脱落防止だけを担当する。接着保持は実物で検証する。接着なしの固定ふたは含まない。

ノブにはボルト頭を入れる。底厚3.8で頭を受け、六角輪郭でトルクを伝える。頭にも少量の接着剤を点付けしてノブとボルトを一体で持てるようにする。硬化後に使用する。初回組付け後の脱着は素手。

## A: 蟻溝と可動押さえ

オス、メス、可動押さえslide_gib、Ø22ノブの4点。蟻溝は長さ20、首幅14、頭幅22、高さ6。上側オス板4→10 mm、下側メス板4 mm。オス外形40×40×16。

締結配置はオスtranslate([-0.5,0,25]) rotate([180,0,0])、押さえはネイティブ座標、ノブtranslate([18.5,0,12]) rotate([0,90,0])。軸X方向、Y=0、Z=12。固定ナットX=-16.5〜-14.1、頭下面X=22.3、M3×40先端X=-17.7。右ワッシャ1枚を介して押さえを締め、斜面と床へレールを押し付ける。スライド方向の保持は摩擦に依存する。

約3回転緩め（1.5 mm）、押さえを+Xへ1 mm指でずらし、オスを-Yへ約23 mm以上引く。オスのØ4.0開放スロットによりボルトを抜かず解除できる。3回転緩めた公称ねじ掛かり2.1 mm。緩め過ぎるとボルトが外れる。押さえは自動復帰しない。

取付はオス後端M3二穴（ネイティブX=±16、Y=+16）、メス32×32四穴。ノブ回転包絡Z=1〜23は下側取付面Z=0から1 mm、上側Z=25から2 mm内側。厚くしたオス板の取付ねじ長さは取付先に合わせて増やす。

## B: 窓から出る爪

爪の機能形状は維持し、取付板・メス外周を丸めた。腕長36、厚1.4、高さ4、中心舌幅6・長さ24。オス40×48×4、メス40×39×10。メス外側X=±13.8に対し爪端X=±15.3、片側1.5 mm突出。窓前縁Y=15.0に爪肩Y=15.15が掛かる。

オス配置translate([0,-0.15,3.3])。両爪を内側につまんで-Yへ約40 mm引く。検査の先端6 mmせん断は運動包絡の近似で、弾性・操作力の証明ではない。オス取付32ピッチ二穴、メスX=±16・Y=-8/23の四穴、頭逃げØ6.3。白化・亀裂・永久変形を実物で確認する。

## C: 整列板と横貫通ロック

オス、メス、Ø16ノブの3点。オス板4→6 mm、メス板4 mm、双方40×40・32×32四穴。軸Ø14×8、二爪外端半径10.5・厚3、リングØ28×14。メス外形40×40×18（突出受け廃止）、オス40×40×14。

固定状態translate([0,0,24.5]) rotate([180,0,0])、Z回転0°で上下板が整列。差込時Z回転-60°、反時計回り60°で整列。上面中央の締結穴はない。M3×40を右から右メス壁→オス横穴→左固定ナットへ入れる。軸X方向、Y=0、Z=14、Ø3.45。ナットX=-15.5〜-13.1、頭下面X=24.3、先端X=-15.7。右ワッシャ1枚、ノブtranslate([20.5,0,14]) rotate([0,90,0])。

約5.2回転でねじを外し、ノブ付きボルトを右へ抜く。右へ約45 mmの抜去空間を仮確保。右ワッシャを回収し、時計回り60°戻して+Zへ約10 mm持上げる。固定ナットはメス内に残る。ボルトを残して回転しない。横ねじは回転・軸方向移動を形状で止め、傾斜溝で回すほどオスを引き込み、蓋下面のくぼみに収めた2か所のゴムパッドを圧縮して軸方向の遊びを詰める。

ノブ回転包絡Z=6〜22は下側Z=0から6 mm、上側Z=24.5から2.5 mm内側。側面の指用空間は別途必要。

## 内部サポートを減らす形状・姿勢

- ナット挿入口は上向き開放で天井なし。
- 横穴は上向き45°屋根付き。A押さえは外側X面を下にして穴を縦向きに印刷。
- C爪下面に高さ1.5 mmの45°斜面を設け、回転溝天井も対応する斜面にする。爪の外端2 mmは平らな接触面とし、溝の外端約2 mmに平らな受け面を残す。短い橋と小さな穴縁張出しはスライスで確認する。
- Aオスの開放スロットには約4 mmの短い橋が残る。Bメスは入口を上にする。
- まずサポートOFFでスライスし、橋の第一層と爪根元を確認。必要なら除去できる外側だけ手動サポート、ナットポケット・横穴・C回転溝内はサポート禁止にする。全プリンタでサポート不要を保証しない。

## 金具・造形（仮定、実物を測る）

A/C合計M3×40六角ボルト2本、M3六角ナット2個、M3平ワッシャ2枚。旧CのM3×50は長過ぎるため使わない。並目0.5、頭対辺5.5・高さ2.12、ナット対辺5.5・厚2.4、ワッシャ外径7・内径3.2・厚0.5。SCADのmetal_*とポケット寸法は仮定。所有金具を実測する。キャップボルト頭は別形状。取付先へのM3ねじ・ナットは別途。

9種類9点。PETG、0.4 mmノズル、0.2 mm層、5周壁、上下6層、40% infillを比較開始条件とする。Bの腕がスライスで途切れないことを確認。A押さえとBメスに5 mm brimを仮推奨。STLは姿勢変換・接地済み。姿勢の正本はmanufacturing.json。

公開モジュール: slide_male, slide_female, slide_gib, snap_male, snap_female, twist_male, twist_female, hand_knob, placed_knob, fixed_nut。取付面は原則ネイティブZ=0。SCADをuseしunionで組み込む。寸法変更時は両側・配置・検証を再生成する。

## 検証範囲

OpenSCADレンダリング、閉メッシュ・単一連結体・外形・体積、離散解除経路、ナット挿入、金具干渉、取付穴、ノブと上下取付面の空間、STEP整合を検査する。締結接触は微小な仮移動で検出し、強度計算ではない。実公差、接着保持、保持力・疲労・操作力は未検証。無荷重10回→100回で緩み、脱落、ガタ、白化、亀裂を確認してから実荷重条件を決める。

## 外周フィレット

2026-09-28追加: A/B/Cの取付板外周の縦角をR3、露出する上側の縁をR0.8で丸めた。固定ナット受け・C側面の受け・Bメス外周は縦角R1／上縁R0.8。手回しノブの自由端もR0.8。SCADのtouch_filletとplate_corner_rで調整する。円弧は15°ごとの断面で近似した。取付面・印刷底面は平坦を保ち、爪の係止面、蟻溝、六角ポケットと穴径は維持する。反対側の縁も円弧で丸め、底面側は45°面取りへ接続する（既定の底面逃げ約0.47 mm、最小0.35 mm）。取付面の中央は平坦を保ち、新しい内部サポート形状を追加しない。

フィレット版の干渉・接触検査は、レンダリング済みの閉メッシュとplacement.jsonの締結配置を再利用する。金具形状と押さえの運動はSCAD、Bの変形包絡は従来のせん断近似を使う。

## C: 蓋下面のくぼみと1 mmゴム（2026-10-01）

厚さ1 mmのゴムを**5×8×1 mm、2枚**切り、Cオス（蓋）の下面、中心からX=±10.5 mmにある**5.4×8.4 mm、深さ0.40 mm**の開放くぼみに入れる。片側0.20 mmの横余裕を設け、ゴムを平らな底へ薄く接着する。各40 mm²、合計80 mm²の貼付面積（初期案の約3.3倍）。くぼみの壁が剥がれ・ずれを抑える。角は手切りの矩形ゴムが入るよう直角に残した機能面。ゴム、接着剤は印刷部品に含めない。

リング上面Z=18.0、固定時の蓋下面Z=18.5。ゴム1.0 mmのうち0.40 mmをくぼみに収め、0.60 mmを突出させる。平坦なメス上面との公称圧縮量は**0.10 mm**（厚さの10%）。差込位置の蓋下面Z=19.1から60°の回転で0.60 mm引き込み、固定位置Z=18.5、上側取付面Z=24.5になる。横M3の軸Z=14とM3×40ボルトは維持し、オス横穴のネイティブ高さを追従させた。解除時は横ねじを抜き、60°戻してゴム圧縮を解く。

くぼみは蓋を造形すると上向きに開放され、内部サポートは不要。くぼみの下に1 mm以上連続した床があること、2枚とも取り付け先の受け面が連続していることをメッシュで検査する。接着層の厚さは公称圧縮量に含めず、薄く塗布して底まで押し込む。実測厚さ・材質・硬さと印刷誤差により手応えは変わる。ゴムが抜ける、はみ出す、固くて終端へ届かない場合は無理に回さない。

形状検査は蓋を0.005 mm刻みで持ち上げ、カム接触が公称圧縮0.10 mmの範囲内で生じることを確認する。実際の圧縮力・接着保持力・耐荷重・疲労は未検証。Cオス・メスは0.1 mm層を試作開始条件とする。調整は`twist_pad_depth`（くぼみ深さ）か`twist_pad_compression`（公称圧縮）で行い、変更後はSCAD・横穴・配置・STL/STEPを一緒に再生成する。

## parts/child/exterior/printed/child_horizontal_plate_frame/README.md

# 子機・横向き容器の4枚フレーム

2026-10-12更新。トップフレームにクランプ締付ねじ用の工具穴6か所を追加。X1 Carbon / Bambu PETG Basicの嵌合・荷重試験用（fit_prototype）。[組立説明](../../../../../assemblies/child_horizontal_plate_frame/README.md)、[配置正本](../../../../../assemblies/child_horizontal_plate_frame/placement.json)、[印刷入口](../../../../../assemblies/child_horizontal_plate_frame/parts/PRINT.md)を参照する。

寸法・取合いは共通 [child_horizontal_plate_interfaces.scad](../../../../../scad/lib/child_horizontal_plate_interfaces.scad)、形状は [SCAD](child_horizontal_plate_frame.scad)。元の生成ツール [prepare_child_horizontal_plate_frame.py](../../../../../tools/prepare_child_horizontal_plate_frame.py)を使う。

## 印刷済みと未印刷

側板2枚・底板1枚と、別設計元の上下クランプ各1個は印刷済み。形状・配置・設計元STLのSHA-256を固定する。共通SCAD更新後は照合用メッシュを別出力し、元STLと一致することを検証してバイト列を保持する。側板・底板のナット受けと丸穴は既存形状を継続する。共通のef_boreを変更せず、未印刷部品だけef_poly_boreを使う。

これから印刷するのは上部1、前保護延長左右各1、後保護延長左右各1、回転止め左右各1、支持治具4、C押さえ4の計15個。全体数量20個と取り違えない。左右側板・支持治具は180°回転で同じSTL、延長と回転止めは左右鏡像を別STLへ反映する。

## 開放ナット式

上部・支持治具・回転止めの六角ナット保持溝を廃止する。ナットを回り止めする埋込み形状を設けず、貫通ねじと普通M3ナットを使い、開放部からスパナで押さえる。既存取付穴位置は保持する。

支持治具は取付足厚8 mm、側板厚12 mm、ピッチ20×24 mm、ねじ中心Y=±50/±70・Z42/66。下クランプ取付面Z75.2と40×20 mm穴配置、支持梁厚17 mmを保持する。ナット側にもφ7×0.5 mmワッシャを置き、M3×25各4本。M3×30も幾何検査する。上段の梁には側端へ開いた工具通路と、ねじ先端を逃がす貫通穴を設ける。支持治具は広いガセット面をベッドへ向ける。

回転止めは広い底面が印刷ベッドに接するよう、manufacturing.jsonで設計元STLからX=90°回転する。配布STLではこの回転を反映済み。組立姿勢は保持する。回転止めは取付足厚8 mm、Y−98・Z122/142。M3×25各2本、M3×30も幾何検査する。工具は+Y側から入れる。公式蓋輪郭・隙間0.55 mm・受け奥行7.1 mmは保持する。取付足と受けの根元のR/面取りを継続する。

上部→側板は厚12 mmの接合座へ普通ナットとワッシャを置き、上から工具を入れる。側板厚12 mmを含みM3×30各2本、計4本。M3×40も幾何検査する。ねじ先端を逃がす穴は開放部の先まで通す。上クランプ→上部の8本は印刷済みクランプの受けを使い、M3×18を保持する。

## クランプ締付ねじへの上側工具穴

トップフレーム `top` に、クランプ上下を締めるM3×30の6軸と同軸の工具穴を追加した。既存8か所のクランプ取付穴とは用途が異なる。正本SCADの `hf_stations` と `hf_ear_rows` を使い、穴位置を別に手入力しない。機体XYの中心は左X−67.8481/Y−70・−50・50・70、右X67.8481/Y−60・60。厚10 mmを鉛直に貫通する。

工具軸は既存の仮包絡φ8×長70 mmを使い、半径1 mmの隙間から穴の内接円径φ10 mmを導出する。穴は補正した正12角形、両入口0.4 mm面取り。工具の持ち手をフレーム上へ出せる軸長を実物で確認する。縁に近い左側の内寄り2軸の周囲は局所的に広げ、穴中心から外周までの公称半径9.5 mmを確保した。外周のR2と0.6 mm面取りを維持し、入り隅も共通仕上げを通す。元のフレーム外形、接合座、取付穴、上面Z210.8は保持する。

[工具・穴断面の検査](../../../../../assemblies/child_horizontal_plate_frame/_work/analysis/top_clamp_access/validation.json)と[上面図](../../../../../assemblies/child_horizontal_plate_frame/_work/images/top_clamp_access.png)を参照。6本すべてのねじ頭からフレーム上まで、容器・クランプ・金具・ライトを装着した状態で工具軸の干渉を検査する。穴の両入口と中央断面、隣の輪郭までの残存肉厚、既存8か所の取付ねじの座面も照合する。工具径は仮定、PETGの強度認定は含まない。

6軸の工具進入、内接円径10の中央断面と入口面取り、既存8か所の座面は合格。両入口から0.001 mm内側と厚さ中央で調べた残存肉厚は最小3.3008 mm。変更したトップは閉メッシュ・単一連結・退化面0、従来の底面を下に実スライスしサポート押出0。0.2 mm層・PETG Basicの1個見積りは291.77 g・約6時間。その他9バリアントの頂点・外形・体積は変更前と一致し、全品の位置と全ねじ配置を保持した。再生成で変わったSTLの並びに合わせてスライスも更新した。

## 穴・面取り・印刷

未印刷6種類のM3穴は正八角形、内接円径3.5 mm、頂点径約3.788 mm。共通ef_poly_boreで半径をcos(180/8)により補正し、入口を0.3 mm面取りする。既存工具通路は保持し、新しい上側の工具穴φ10は正12角形・両入口0.4 mm面取り。外形R2・0.6 mm面取り、開放部のR0.5・0.3 mm面取りを使用する。印刷済み受けの六角角部は回り止めの機能形状として保持する。

保護延長厚8、前端Y174・後端Y−176、持ち手90×34、後方配線予約50 mmを保持する。C押さえの穴位置と既存底板の受けを保持する。B4個のM5固定、C2個の53 mm胴部保持、在庫質量2.24 kgは変更しない。

manufacturing.jsonの印刷姿勢を使用し、0.2 mm・8周・100%・5 mmブリム・サポート無効を使用する。支持治具の開放部の奥行を14→8 mmへ短縮し、短いブリッジとする。小径横穴は八角形の屋根を短いブリッジで印刷する。ブリムを除去して実物嵌合を確認する。旧3MFは履歴へ保存し、未印刷9種類・15個だけを現行スライス対象とする。印刷済み部品の再印刷は不要。

## 検証と制限

[開放ナット検査](../../../../../assemblies/child_horizontal_plate_frame/_work/analysis/open_nut_fastening/validation.json)は印刷済みSTLと配置、32組の開放ナット、代替ねじ、各種類の八角穴断面・座面の残存材料を検査する。スパナは頭幅10・厚2.6 mm・到達35 mmの仮包絡で、実工具を照合する。側板の取付穴・容器の挿入・回転止め・持ち手・配線予約・M5固定は既存検査を再実行する。

開放部付近の断面プローブで支持治具3.70 mm、回転止め2.50 mm、上部側方材8.50 mmの残存肉厚を確認する。開放部で支持梁の局所断面が変わるため、PETGの実荷重・締付け・層間強度・湿潤保持・クリープ試験が必要。強度認証を主張しない。全種類のSTEP変換・読戻しは未完了で、旧STEPは現行形状として使わない。

2026-10-10までの設計・検査・スライス説明は[変更前履歴](../../../../../assemblies/child_horizontal_plate_frame/_work/intermediate/history/before_open_nut_fastening/parts/child/exterior/printed/child_horizontal_plate_frame/README.md)に保持する。

[サポートなし検査](../../../../../assemblies/child_horizontal_plate_frame/_work/analysis/support_free/validation.json)は未印刷9種類・15個すべて合格。3MFのenable_support=0とG-codeのサポート押出量0、現STLのSHA、造形範囲を確認し、屋根の投影局所幅は最大7.71 mm。物理的なブリッジ品質は初回印刷で確認する。

## 内側の保護延長（Rev.3）

現構成はguard_front_inner / guard_rear_innerを使い、左X−110〜−102・右X102〜110の側板内面へ取り付ける。固定穴Y±98・Z100/176は従来位置、外側からM3×25、内側に普通ナットと0.5 mmワッシャ。左右各前後2本ずつ計8本、両側ワッシャ16枚。旧側板内側のナット受けは延長で覆われ、延長の内向き面でナットを工具保持する。M3×30も幾何検査する。

上部の12×28接合座と後部回転止めの24×35取付足には1 mmの逃げを設け、端から開ける。後部の工具は+Y側へ通せる。前後の端位置・厚8・既存固定穴は保持し、幅は260→244 mm。旧guard_front / guard_rearは外側配置の履歴用バリアントとして保持し、現行placementと印刷一式へ含めない。

後部延長の回転止めの逃げは、取付足に加えて斜めの腕まで開き、既存窓につなぐ。細い残材を作らず、上下・後端の外周材で連結する。

## parts/child/exterior/printed/child_wte4_petg_clamp/README.md

# 公式4インチ取合いのPETGクランプ

2026-10-07ユーザー指定「Blue Robotics公式4インチクランプを元に、PETG用の改良版を今回作る」を実装する独立部品。**fit_prototype**。既存 `child_wte4_suspension_clamp` の最適化メッシュや原本を変更せず、この新設計を最適化後処理と称さない。

公式 [製品](https://bluerobotics.com/store/watertight-enclosures/enclosure-clamp/) と [取付ガイド](https://bluerobotics.com/learn/watertight-enclosure-clamps-guide/) の4インチを参照する。メーカーSTEP原本は [BR-102678-004 Rev C](../child_wte4_suspension_clamp/ref/WTE4_CLAMP_BR-102710-004/BR-102678-004_RevC.STEP) にある。元の取付面は中心から62.8 mm、取付軸X±20・軸方向±10（40×20 mm）。締結軸X−67.848に2本、X+67.848に1本を解析面から読み取った。参照は購入品寸法の利用で、メーカー材質/耐荷重を印刷品へ引き継がない。

## 改良内容

- 取付面62.8 mm・40×20 mmの穴配置を保持する。クランプからフレームに向かう延長脚・長い耳を作らない。フレームの支持面をこの位置へ合わせる。
- 帯幅を30から40 mm、外周肉厚を8 mmにする。取付面では外周を62.8 mmに切りそろえる。最大横幅は元CADより増えるが、増分はリング・締結部の局所肉厚でありフレームへ届かせる腕ではない。耳のねじへφ8工具を入れる通路を確保する。
- アルミ用M4ねじ穴をM3普通ナット方式へ変更する。φ3.5穴、二面幅5.8・厚2.8のポケット。M3 AF5.5・厚2.4普通ナットのモデルで確認する。取付ナットは軸方向両面から差す。溝の二面幅を保ち、上下ナットの入口を分離する。
- 2026-10-08ユーザー指定で、前後120 mm間隔の2組を上側どうし・下側どうしで連結する。`upper_linked` と `lower_linked` を各1個、計2個印刷する。帯幅40 mmと前後の取付位置を保ち、全長160 mm。左右45°の肩に幅12×厚5.2 mmの連結材を2本ずつ設け、根元は1 mmの45°面取り、縦の稜線はR2、端部は0.6 mm面取りとする。連結材と根元は既存リングの肉厚範囲内に収める。
- 下側だけ耳の外面に普通ナットの受けを持つ。耳の締結はM3×30、各位置3本・計6本。上下は分離でき、下側を側板へ固定して容器を上から載せ、前後一体の上側を被せる。取付ねじ、ナット差込み溝、保護材4枚は従来どおり。単独の `upper` / `lower` は同じ設計元に比較・履歴用バリアントとして保持し、このassemblyの印刷対象から外す。
- ゴム厚は1 mmで確定（2026-10-08ユーザー確認）。内径は114.3 mmの容器と1 mm保護材を前提にφ115.9 mm。これは片側のゴムを1.0から0.8 mmへ圧縮する計算で、圧縮量0.2 mm（20%）と合わせ面隙間1.6 mmは仮値。容器の径公差±0.8 mmを締付けで無理に吸収せず、実物の寸法と保持力を確認して保護材/圧縮設定を調整する。

寸法は [共有インターフェース](../../../../../scad/lib/child_horizontal_plate_interfaces.scad)、形状は [SCAD](child_wte4_petg_clamp.scad)。上固定はM3×18を各半体4本、下固定はM3×25を各半体4本。φ7・厚0.5ワッシャを使用し、変更するとねじ先端余裕が変わる。取付ねじ先端はアクリル外形と直接干渉しないことを実メッシュでも確認する。締付トルク値はまだ指定しない。

X1 Carbon / PETG Basic / 0.4 mmノズル / 0.2 mm積層 / 8周 / 100%インフィル / 5 mmブリム。断面をベッドへ、軸方向+Zに160 mm積層する。上の帯の下面、横穴、ナット溝と連結材の内側は自動サポートを検査・除去する。80 mmの帯間を無支持で橋渡ししない。外周/断面入口0.6 mm、穴0.3 mm、ナット入口0.25 mm、面内R2。ナット回り止めの内角・平面座面は機能上保持する。

印刷一式・配置・ねじ数量は [assembly](../../../../../assemblies/child_horizontal_plate_frame/README.md) の正本へ集約する。荷重解析・造形実験・湿潤保持/クリープ試験による認証はまだない。保護材の実厚と圧縮量を確認してから本容器を締める。

STEPの全体変換は未完了。今回の現行モデルはSCADとSTLを参照する。

`python tools/check_child_horizontal_clamp_links.py` は既存半体2個ぶんの材料保持、前後一体の閉メッシュ、中央断面の連結材2本と寸法、容器の上からの挿入を検査する。全体のねじ・工具・配線予約はassemblyの通常検査を併用する。軸方向連結の追加による強度向上は実物試験前で主張しない。

## X1 Carbon向けトポロジー最適化（2026-10-08〜09、試行不採用）

ユーザー指定により対象を前後一体のクランプ上下に限定する。現行STLは軸方向+Z、全長160 mmで縦に印刷している。24姿勢の造形性比較でも+Zが最良だが、これは荷重未入力の印刷指標だけの順位で、強度による順位ではない。上側の帯の下面と穴にはサポートが必要。上半体の45°判定で、ベッド接触を除く要サポート表面は2144.7 mm²。

`spec/prepare_topology_inputs.py` は既存SCADの輪郭と各半体から、連続した半円筒状の設計領域、ゴム接触面・取付座・締結耳の保持領域、既存の穴とナット差込み経路を生成する。探索を既存2本の連結材の形だけに制限しない。入力形状は `_work/analysis/topology_print/`、入力生成SCADは `_work/intermediate/topology_print/` に保存し、印刷用部品として配布しない。

条件正本は `spec/print_topology_request.json`。材料はBambu PETG Basic、X1C 0.4 mmノズル・0.2 mm積層を引き継ぎ、Z積層の異方性と自己支持条件を入れる。密度場を直接平滑化し、機能寸法だけ局所復元する。長い水平ブリッジ、閉じ込めたサポート、接触面のサポート傷、連結性・最小肉厚を検査し、完成形状を再解析・実スライスしてから採用する。

容器と中身は1 kg未満、取り扱いは自重の2倍で十分とのユーザー回答（2026-10-08）により、上限1 kg・2g・合力19.6133 Nとする。`spec/author_print_topology_studies.py` が上下のnative topopt studyを生成する。3軸の取り扱い、組立途中で片側ステーションだけが固定された場合の3軸伝達、仮の締付軸力150 N/本を別ケースで扱う。線形解析で50/100/150 N/本の感度を確認するが、実測値や締付トルクの指定ではない。要求安全率2、変位上限1 mmは解析上の仮条件。汎用PETG異方性カードを用い、X1C実測の層間特性・湿潤滑り・クリープを保証しない。

実行済みの探索は2 mm解析ボクセル・6 mmフィルタ・+Z自己支持条件・自由領域体積率0.35、100反復。保持領域は予想完成体積の約63%を占め、主な自由領域は帯間の接続と非機能部分である。上下とも700回の線形ソルブは収束したが、最適化の終了理由は `max_iterations`。密度変数の収束、しきい値0.5の体積上限、4 mm部分を2 mmボクセルで評価する解像度は不合格であり、全体合格とは扱わない。

`upper_run03` と `lower_run05` の保存密度場をnative `extract` で直接平滑化し、`finish_print_topology.py` で機能CADを局所復元した。下側にはplacementから算出したC押さえのφ8工具通路＋片側0.5 mm余裕を設計障害物として加えた。単純な梁・リングへの再構成は行っていない。`quality_finish_surface.py` は密度由来の表面をMeshLabで整理する。数値不正面を除くためのMeshFixは体積・連結・Euler数を検査し、穴が埋まった試行は棄却した。

干渉検査を通った候補は `_work/analysis/topology_print/upper_run03/local_finish_clearance/simplified_0.0001.stl` と `lower_run05/local_finish_clearance/finished_interfaces.stl`。各1個の閉メッシュで自己交差なし。ナット入口に片側0.05 mmの仕上げ余裕（平行面間5.9 mm、深さ2.9 mm）を追加し、上側ワッシャ座面を0.05 mmだけ局所的にさらった。`check_topology_assembly.py` で構造部品、ねじ、工具、ナット挿入、配線・手・保護帯、容器の10段階の持上げ経路を検査した。これは現行の印刷用STLではない。

候補上側を実際のBambu Studioで縦向き・0.2 mm・8周・100%・PETG Basicとしてスライスした結果、樹状サポート込み238.78 g・28,914秒（約8時間2分）、サポート25.44 g。現行上側も同じ樹状設定で比較すると216.26 g・24,419秒（約6時間47分）、サポート24.95 g。候補は総量が約10.4%、時間が約18.4%増え、印刷改善にならなかった。記録は `baseline/slice_upper_tree` と `upper_run03/slice_local_tree`。通常サポートと樹状サポートを混ぜた比較で軽量化を主張しない。樹状設定は比較試験のみで、現行の製造設定は変更していない。

完成形状のCalculiX再解析は収束を確認できず、不採用とした。上側の局所仕上げ後メッシュに対し、片側固定X荷重の最悪要素安全率は12 mmで1.027、6 mmで0.447。3 mmではGmshが終了コード3221225477で停止し、収束結果はない。p99.5の値だけで局所不合格を隠さない。下側でも数値不正面やメモリ不足が生じ、完成品の強度を確認できていない。記録は `upper_run03/ccx_finished_bounded`。解析領域を狭めて軽くする操作は行っていない。

最初の最適化で仮定した広い締付パッチの一部が拘束領域と重なっていた。元studyは `_work/intermediate/topology_print/*_study_preload_broad_patch.json` に保存した。現在のstudyは実際の6か所のねじ座面へ150 Nずつ（合計900 N）を与える条件で、荷重を減らしていない。下記の連結部分の再最適化は、この修正済み条件で最初から実行した。

次に `spec/prepare_connection_topology.py` で、元の滑らかな40 mm帯を全体保持領域とし、帯間だけを自由領域にした。これは再最適化前の入力条件であり、最適化結果を単純な帯・梁へ置き換える処理ではない。現行CADの体積から1%減を目標に自由領域率を約0.0514と算出した。保持領域は予想完成体積の約95%なので、クランプ全体を最適化したとは扱わない。上下とも2 mmボクセル・6 mmフィルタ・+Z自己支持・100反復を実行し、700/700ソルブ、保持領域の連結、体積制約は合格した。しかし密度・目的関数・形状は未収束で、終了理由は `max_iterations`。

この連結案も不採用。両端固定の取り扱いでは変位約0.052 mm以下だが、片側ステーションだけの固定では、上側は57.6〜106.5 mm、下側は252.2〜421.5 mmの線形解析変位となり、仮の1 mm上限を大幅に超える。この大変形値は実際の変形量の予測には使わず、連結部の剛性が不足する診断とする。片側固定のp99.5安全率も上側最小1.15・下側最小0.59で要求2を満たさない。全ケースで最小4 mm部分が2要素しかなく、解像度検査も不合格。これを平滑化・局所復元だけで合格品にすることはしない。完成形状のCalculiX収束・実スライス・サポート除去性の検査へ進めていない。記録は `connection_only/{upper,lower}_run01/opt` と `connection_only/rejection_summary.json`。

**トポロジー最適化による採用形状は得られていない。** 現行の連結版SCAD/STL・印刷姿勢・製造設定を保持し、探索メッシュを印刷一式へ配布しない。現行品も耐荷重認証済みではない。再開する場合は、必要な組立荷重条件、自由領域の体積配分・最小部材厚、ボクセル解像度と反復収束を見直し、完成形状の再解析と同条件のスライス比較をやり直す。状態の記録は `_work/analysis/topology_print/execution.json`。

## parts/child/exterior/printed/child_horizontal_twist_mount/README.md

## 2026-10-29 素手着脱への改訂（現行）

カメラ専用の受けは外向きのねじ横抜き溝付き。初回固定は工具を使用し、以後のカメラ着脱はノブと指掛けスペーサで行う。現行条件・締結経路・制約は各assembly READMEの最上段を参照。旧横ボルト・旧ゴム方式は使用しない。

# 2026-10-29 カメラ専用4点支持受け

カメラ専用 `camera_receiver` 分岐を追加。既存 `frame_receiver` と `light_twist` はライト用として形状・配置を維持する。カメラ用STLは `child_horizontal_twist_mount_camera_receiver.stl`。

子機外面X=-122上の既存穴だけを使う。Y60/Z100・160のM3×18を維持し、Y98/Z100・176の前側ガード固定を共締めする。後者はM3×25をM3×30へ2本交換し、頭側ワッシャを受けの外へ4 mm移す。内側ガード・ワッシャ・ナット位置はそのまま。38 mm離れた2列4点で受けを支える。側板・ガードに加工や再印刷は不要。

取付足厚4 mm。Y60/Z120・140には直径8 mmの工具通路を残す。C中心は(-122,105,130)へ前方10 mm移動し、カメラの向きを維持。カメラ側の全構成部品を一緒に移し、ライトは移さない。中央の手の予約域Y=-45..45を避ける。

各締結経路はねじ頭→頭側ワッシャ→受け足→側板→（ガード側の2点はガード・内側ワッシャ）→ナット。側板側2点のナットは内面の既存六角座へ入り、締付方向の底面を使う。ガード側は既存内側ワッシャとナットで受け・側板・ガードを共締めする。

共通接続形状は `scad/lib/camera_rotary_joint.scad`。組立・解除は[カメラ共通説明](../dji_osmo_action6_mount_m3/README.md)、検証結果と印刷入口は[子機assembly](../../../../../assemblies/child_horizontal_plate_frame/README.md)。実物の保持力・材料強度は未認定。後続の旧日付の記録は履歴。

---

# 子機側面・一体型twist治具 Rev.4

正本は child_horizontal_twist_mount.scad。frame_receiver（フレーム台座＋Cメス）、light_twist（既存ライト保持半割＋Cオス）の2バリアント。各1個、単一連結の印刷部品。既存33×81筒と押さえを流用。差し込み姿勢から60°回して停止すると上向き、その横の水平ノブで締めて固定する。QR面内角0°、ノブ軸は機体+Y。

[組立SCAD](../../../../../assemblies/child_horizontal_plate_frame/child_horizontal_plate_frame_light_view.scad) をOpenSCADで開きF5。`pose="locked"` は固定位置、`pose="entry"` は差込位置、`show_frame=false` は治具単体。こちらは配置正本から生成される確認ビュー。

寸法・取合い・中央の手の予約空間・印刷・金具・検証は [共通規格](../../../../../docs/child_horizontal_twist_interface.md)。位置・数量の正本は [assembly](../../../../../assemblies/child_horizontal_plate_frame/placement.json)。C形状は既存公開モジュールを再利用し、ライトは元のhalf_holder(front,mount_plate)を呼ぶ。寸法は共通SCADへ生成される。

製造メタデータの姿勢：frame_receiverは0°、light_twistはX90°で筒軸垂直・下端をベッドへ。一体2部品は0.1 mm層。メスは厚4の平坦な一体足、N=0で段差なし・サポート無効。ライトオスだけベッドからの外部サポートを使う。新しい接続部はR2・面取り0.6、M3穴入口0.3。C爪・カム・ゴム座と既存ホルダーの嵌合形状を保持する。

旧frame_adapter/light_adapterの設計と印刷一式はassembly内のRev.1履歴へ保持。現行variantsとplacementには含めない。カメラは2026-10-21に一体Cオス付き部品を追加した。下のカメラ用メス節を参照。TD04Aは今後の設計。

一体部品のCGAL出力に生じる数値的なT頂点の退化三角形は、既存clean_stl_degenerates.pyのEdge Flipだけで処理する。頂点・面数を保持し、外形・体積・双方向表面誤差0.001 mm以内、閉メッシュ、単一連結を検査する。Rev.4ではメス10面・オス1面を処理し、表面誤差最大4.00e−8 mm、体積・外形差0。底板同士は中央部だけ0.05 mm重ね、旧底板の角を重複させない。再生成ツールと製造メタデータへ同じ処理を組み込んだ。

Rev.4：追加フレーム4枚は引き続き側板内側、台座M3×18各2本、ライト軸X161/Y80、突出59.5 mm。ノブ中心(136,105.5,130)、水平+Y軸。平坦な厚4足の入り隅をR2に仕上げ、既存32×32のC底板4穴を復元する。CのN=4以上の嵌合形状は保持する。Rev.3までの生成元・配置・印刷一式をassemblyのside_twist_r3履歴へ保存。

## カメラ用メス（2026-10-21）

camera_receiverバリアントは同じframe_receiver()にreceiver_u=-35、dock_rotation=90を与える。左前の既存Y60/Z100・160穴、厚4の足、M3×18・内側ナットを流用。C中心(-122,95,130)、ノブ軸+Z。カメラを外側から見て右へ90°回し、通常の横向きにする。ライト用の2バリアントのメッシュは別途再レンダリング・全頂点比較し、元のバイト列を保持した。カメラ側は同じcamera_mount_twistを親子で共用。専用メスは取付足下、0.1 mm・Generic PETG・6壁・15% Gyroid・5 mmブリム、自動支持有効・ベッドからのみ。実支持経路は0.2 mmの初層だけ。部品STEPは単一有効ソリッドで外形・体積がSTLと一致。配置・数量・組付けは[assembly説明](../../../../../assemblies/child_horizontal_plate_frame/README.md)。

## docs/child_horizontal_twist_interface.md

# 子機横置きフレーム・側面twist取付規格 Rev.4

## カメラの追加（2026-10-21）

改良camera_mountを再利用した一体Cオスを親機と子機で共用。子機はleft_front、取付足の2穴をそのまま使い、U=-35、C面内90°、中心(-122,95,130)、ノブ軸+Z。メスは同一SCADのcamera_receiverバリアント。C機能面・カム移動・横ボルトは上記Rev.4と同じ。機器の実寸は既存の仮ケース包絡を引き継ぎ、実測済みへ昇格しない。ライト用right_frontの位置とメッシュバイト列は保持。

カメラの静止干渉、持ち手、ケーブル予約、+Zへ45 mmロックボルト抜去、5°刻み60°回転と80 mm外向き抜去、ノブ周囲3 mmを検査。カメラ側の接続板にのみ1.2 mmの局所逃げを加え、元C形状を保持する。詳細・現行数量・印刷条件は[子機外装](../assemblies/child_horizontal_plate_frame/README.md)、[共有カメラ部品](../parts/child/exterior/printed/dji_osmo_action6_mount_m3/README.md)を優先。以下の「カメラ未設計」と数量は2026-10-12時点のライト単独記録。

2026-10-12。**CHILD-HORIZONTAL-TWIST-C-R4**。対象は [child_horizontal_plate_frame](../assemblies/child_horizontal_plate_frame/README.md)。フレーム台座とtwistメス、ライト保持半割とtwistオスをそれぞれ一体化。差し込み位置から60°回して停止した位置でライトが上を向き、その横の水平ノブを締める。カメラ・TD04Aも機器治具にCオスを直接組み込む。

表示は [全体SCAD](../assemblies/child_horizontal_plate_frame/child_horizontal_plate_frame_view.scad) または [ライトSCAD](../assemblies/child_horizontal_plate_frame/child_horizontal_plate_frame_light_view.scad) をOpenSCADで開きF5。ライトSCADの `pose="locked"` が固定位置、`pose="entry"` が差し込み位置。`show_frame=false` でライト治具だけ表示する。全体ビューの `show_accessories=true` は生成元の配置JSONで定義する。

## 配置と持ち手

単位mm。機体X=左右、Y=容器軸、+Y=ドーム、Z=上。今回の右側ローカルU=+Y、V=+Z、N=+X。配置の正本はassemblyの `placement.json`。

| 項目 | Rev.4 |
|---|---|
| 既存側板外面 | X=122 |
| フレーム固定穴 | Y=60、Z=100/160、60ピッチの既存2穴 |
| 一体台座のフレーム接触部 | 24×84、厚4、外周R2、縁0.6面取り |
| 台座固定 | M3×18 2本、既存側板内側のM3ナット受け、頭側ワッシャ厚0.5 |
| twist中心 | (122,80,130)、側板外面からN=0 |
| 固定時のオス外側面 | 側板外面からN=24.5 |
| ライト軸 | X=161、Y=80、Z方向上向き |
| ノブ軸と中心 | 水平+Y、中心(136,105.5,130)、ライト軸の横・高さ130 |
| 保持区間 | Z=89.5〜170.5、参考内径33・長さ81 |
| ホルダー最外面 | X=181.5、側板から59.5 |
| 変更前との差 | Rev.2の68.5→59.5、9 mm削減。Rev.1の123.5からは64 mm削減 |
| 側面中央の予約領域 | Y=−45〜45、Z=40〜210、側板外面から外側150の手の進入域 |

既存の90×34の指通し穴と内側の手の予約領域を維持する。追加部品は前端側へ寄せ、外側からの中央90幅の通路を空ける。照合対象はCADの予約領域で、実際の手袋・手の大きさの適合は実物で確認する。フレーム台座の最も中央寄りの端はY=48、ホルダー耳の端はY=47.5。

前後・左右4枚の保護延長は側板の内面へ固定する（左X−110〜−102、右X102〜110）。上部フレームと後部の回転止めに1 mmの設計逃げを設けたinnerバリアントを使う。延長固定は外側からM3×25、内向き面に普通M3ナットとワッシャ、両側ワッシャ計2枚。保護延長込みの幅は260→244。メスの底面N=0は側板外面へ直接接し、厚4の固定足とCの底板が同一平面で一体化する。段差・張出し台座下の支持部を設けない。既存側板・底板・クランプ上下の印刷済み5個は形状・STLハッシュを保持する。

右前の1組を実装・検証した。他の側のY=±60列はカメラ・TD04A用の接続候補で、機器型番・寸法・画角・音響面は未確定。左右や前後を変える場合、中央から離す方向の台座オフセットと金具、保護延長、着脱経路を再設計・検査する。Rev.4のライト配置を無検査で反転しない。

## 一体化するCインターフェース

形状の正本は [quick_release_prototypes.scad](../parts/common/jigs/quick_release_prototypes/quick_release_prototypes.scad)。今回のSCADは公開モジュール `twist_female()` と `twist_male()` を直接利用し、元のCの爪・カム・ロック穴・ゴムくぼみを維持する。共通寸法は生成ツールが `scad/lib/child_horizontal_twist_interface.scad` へ出力し、手入力でコピーしない。

| 項目 | 値 |
|---|---|
| 基準板 | 40×40、既存32×32穴は位置基準として残る |
| 軸と爪 | 軸φ14×8、爪外半径10.5、リングφ28 |
| メス底面からオス外側面 | 24.5 |
| QR面内角 | U/V面で0°、横ロック穴を水平U方向へ向ける |
| 着脱 | 横ボルト全体を抜く→時計回り60°解除→外側N方向へ抜く |
| 回転中のカム移動 | 60°でN方向へ0.60 |
| ロック | 六角頭M3×40、AF5.5×厚2.4ナット、φ7×厚0.5ワッシャ、既存φ16ノブ |
| ゴム | 5×8×1を2枚、オスくぼみに薄く接着、公称圧縮0.10 |

qX=U、qY=V、qZ=N。オスはqX回り180°反転して固定する。ノブ付きボルトはqX正方向（機体+Y）へ45 mm以上抜く。ワッシャは脱落防止式ではない。回転方向は機体の右外側から側板へ見た向きで記す。

メスの非嵌合底板N=0〜4だけを、固定足と共通の平坦な外形へ置き換える。足と40×40板の入り隅をR2、縁を0.6面取りに仕上げ、既存32×32の4穴を最後に復元する。N=4以上のCリング・爪受け・カム・ロック穴は元モジュールのまま。オスの爪・カム・ゴム座も保持し、検査では元のCメッシュとの局所差分を照合する。

機器側治具はオス板の外側へ直接unionし、裏面の爪・カム・ゴム面へ材料や金具を出さない。Rev.1のライト変換板、メス取付4本、皿ねじ4本、ホルダー台座取付4本は廃止。別体オス・別体メスも今回の印刷一式に含めない。`twist_male_mount` は旧版の別体接続用として保持し、Rev.4のライトには使わない。

## ライト保持部

ユーザー確認済みの既存33×81ホルダーを流用し、上向きに照射する。元の `half_holder()` に台座を省く引数を追加した。既存ベースと押さえ分岐の外形・全頂点・体積が同じことを別出力で確認し、既存STLのバイト列を保持する。一体オスは同じ筒・耳・穴・窓を使い、旧60×60取付板と14の工具隙間を省き、C板の外側6 mmを筒の背面へ重ねて一体化する。C板側だけ筒の空間を切り抜き、既存の33径筒をunionする。重なる円周の数値的な一致を避けるため、C板の切抜きだけ半径0.02の逃げを加える。筒内径は元の33のまま、背面C板は最も薄い中央で約4 mmを残す。既存押さえをそのまま使用する。

半割の締結はM3×20 4本、ナット4個、両側ワッシャ8枚。耳の中心はローカル横±26、上下±32.5、厚6、分割隙間1.5。保持は摩擦式で底止めがなく、上下は開放。ライトから機体へ独立した落下防止コードを掛ける。

33は参考ホルダー内径で、ライト実測径ではない。実ライトの頭・ボタン・全長・電池交換部・ケーブルをモデル化していない。新しい台座接続部は外周R2、縁0.6面取り。既存の筒端・耳・窓は確認済み保持形状を維持する。Cの爪・カム・ゴムくぼみと既存ホルダーの耳・分割面・窓・端部は、確認済みの嵌合形状を保持する例外。全体への一括平滑化は行わない。

## 組立と印刷

追加の印刷部品は4種類各1個：一体フレームメス、一体ライトオス、既存押さえ、既存ノブ。追加金具はM3×18 2本、M3×20 4本、六角頭M3×40 1本、M3ナット7個、φ7×0.5ワッシャ11枚、ゴム2枚。金具・ゴムは印刷しない。

1. 一体台座を側板のY60/Z100・160へM3×18で固定する。内側の既存ナット受けを使い、ライトユニットを装着する前に締める。
2. ナットとノブ内の六角ボルト頭を元のCの手順で少量のエポキシで保持する。ゴム2枚をオスのくぼみに薄く接着し硬化させる。
3. ライトを一体オスの筒へ置き、既存押さえを4本のM3×20で均等に締める。1.5の隙間を無理に潰さない。
4. 固定姿勢から時計回り60°傾けた差込姿勢で取り付け、反時計回り60°でカムの端まで回す。ライトの照射軸が鉛直上向きに整列したら、ライト横の水平ノブ・M3ボルトとワッシャで固定する。斜めの差込位置では横ボルトが貫通しない。

印刷入口は [parts/PRINT.md](../assemblies/child_horizontal_plate_frame/parts/PRINT.md)。X1C / Bambu PETG Basic、0.4ノズル、8壁、100%充填、5 mmブリム。一体2部品は0.1 mm、押さえとノブは0.2 mm。一体メスはフレーム接触面を下、一体オスは筒軸を垂直・下端を下（製造X90°回転）。印刷STLへ姿勢を反映する。

段差をなくした一体メスは接触面全体をベッドへ置き、サポート無効。一体ライトオスだけベッドからの外部サポートを使い、横向き軸・爪・C板下面を支える。造形物上からのサポートは無効、上下離隔0.2。垂直の33径筒内へサポートを入れない。C摺動面は除去後に実物で照合する。Rev.2の段差付きメスの3MFは現行形状へ流用しない。機構内の短い橋・横穴は初回印刷で確認する。

[実メッシュ検査](../assemblies/child_horizontal_plate_frame/_work/analysis/side_twist_mount/validation.json)は閉メッシュ・単一連結、既存部品・金具の干渉、参考ゲージφ32.98×81、中央の手の予約空間、工具、5°刻みの解除回転、ボルト45抜去、N40抜去、固定時の上向き軸、水平ノブの全周回転と半径方向3 mmの操作余裕を検査する。3 mmは局所的な指の余裕で、手全体・手袋の適合モデルではない。[実スライスとサポート検出](../assemblies/child_horizontal_plate_frame/_work/analysis/side_twist_mount/slicing.json)に形状ハッシュ、積層と実3MFの設定を記録する。離散的な剛体CAD検査とスライサー検査であり、実嵌合・強度・接着・摩擦・クリープ・水流荷重は未認定。元のライト治具のFEA収束未合格を流用で合格と扱わない。

## 再生成と履歴

Rev.3の斜めノブ・段差なし台座の生成元、配置、文書、STL、検査を [side_twist_r3履歴](../assemblies/child_horizontal_plate_frame/_work/intermediate/history/side_twist_r3/) へ、3MFを [印刷履歴](../assemblies/child_horizontal_plate_frame/print_jobs/history/side_twist_r3/) へ保存した。

`python tools/build_child_horizontal_accessories.py` → `python tools/check_child_horizontal_accessories.py` → `python tools/review_child_horizontal_accessories.py` → `python tools/assembly_parts.py sync child_horizontal_plate_frame`。全フレームも生成する場合は最初に `--rebuild-frame` を付ける。

Rev.2の段差付き台座・外側延長の配置、生成元、印刷一式、検証は[_work/intermediate/history/side_twist_r2/](../assemblies/child_horizontal_plate_frame/_work/intermediate/history/side_twist_r2/)に保存し、3MFは[print_jobs/history/side_twist_r2/](../assemblies/child_horizontal_plate_frame/print_jobs/history/side_twist_r2/)に保存した。

Rev.1の配置・設計元・印刷一式・検証記録は [履歴](../assemblies/child_horizontal_plate_frame/_work/intermediate/history/side_twist_r1/history.json)へ保持した。現行の配置・印刷には使用しない。

一体部品のCGAL出力に生じる数値的なT頂点の退化三角形は、既存clean_stl_degenerates.pyのEdge Flipだけで処理する。頂点・面数を保持し、外形・体積・双方向表面誤差0.001 mm以内、閉メッシュ、単一連結を検査する。Rev.4の表面誤差は最大4.00e−8 mm、体積・外形差0。メス底板の結合は中央部だけ0.05 mm重ね、旧底板の角を重複させない。形状の単純化・穴埋め・一括平滑化は行わない。再生成ツールと製造メタデータへ同じ処理を組み込んだ。

後部延長の回転止めの逃げは、取付足に加えて斜めの腕まで開き、既存窓につなぐ。細い残材を作らず、上下・後端の外周材で連結する。
