AquaBeacon/mechanical/assemblies/child_simple_assembly/parts/DESIGN_NOTES.md

# 設計・印刷条件の控え（自動生成）

以下は設計元の文書を転記したものです。リンク先は元フォルダ基準です。印刷条件と未検証事項を確認してください。

## child_simple_assembly/README.md

**印刷一式:** [parts/PRINT.md](parts/PRINT.md)（STL・数量・モディファイア） · **確認画像:** [_work/images/](_work/images/)

# 子機のシンプル筐体 — M3拡張マウント付き

2026-09-17 r3。rear中央にライト用M3 40×40穴を追加。印刷済みfrontとガードの形状・締結位置は維持。ユーザー確認済みの **WTE4 Ø114.3 × 200 mm・縦置き**用。
前枠・後枠・下部ガードの3部品構成。カメラ、TD04Aとその専用マウントは後付けする。
既存の複雑な外装とは別の設計。形状ソースは [共有SCAD](../../scad/lib/child_simple_frame.scad)。

**r2の接続変更**：灰色ガードの4支柱に枠を載せる段差を追加。各支柱はM3×35の貫通ボルト2本と外から手が届くナットで固定する。インサートの熱圧入・ナットの埋め込み・先入れは不要。容器を入れた後でもナットを交換できる。

前側からの組立

## 開くファイル

- [組立STEP](child_simple_assembly.step)：Fusion 360等で確認。耐圧容器を含む8部品。
- [組立SCAD](child_simple_assembly_view.scad)：色分け表示。`placement.json`から生成。
- [印刷用STL](../../print_jobs/child_simple/PRINT.md)：各部品を印刷向きに配置済み。
- [スライス済み3MFと印刷手順](../../print_jobs/child_simple/START_HERE.md)：X1 Carbon／PETG、3部品を個別プレートで印刷。
- [前枠](../../parts/child/exterior/printed/child_simple_front/child_simple_front.step) / [後枠](../../parts/child/exterior/printed/child_simple_rear/child_simple_rear.step) / [ガード](../../parts/child/exterior/printed/child_simple_guard/child_simple_guard.step)

## 寸法と構成

単位mm。X=左右、+Y=カメラ正面、Z=上。チューブ下端をz=0とする。

| 項目 | 寸法・仕様 |
|---|---|
| 外装本体 | 幅220 × 奥行168 × 高さ305（z=-85～220、マウント・ねじ頭を除く） |
| 参考ドームを含む高さ | 約346.25（z=-85～261.25） |
| 前枠 | 220 × 82 × 238 |
| 後枠 | 220 × 82 × 239 |
| 下部ガード | 220 × 168 × 97 |
| 保持内径 | Ø116.7、2 mm EVAを片側1.2 mm程度に圧縮する想定 |
| 下キャップ～接地面 | 71.2（キャップ下面z=-13.8、接地面z=-85） |
| 下キャップ～ガード上面 | 51.2（ただし中央の180×128開口は下まで貫通） |
| 輪郭 | 上下の段差受け＋中央帯＋縦リブ。側面・底面は水が抜ける開放構造 |
| 分割締結 | 左右各2本、合計M3×4。ヒンジは使わず前枠を取り外す |
| 吊り下げ | 左右2点、各Ø10穴。前後の穴を一緒に通す |

**この外装自体は防水・耐圧容器ではない。** 防水は既存のチューブ、キャップ、シールで行う。

## 後付けマウントの穴位置

**規格参照：[CHILD-SIMPLE-M3-40x40 / Rev.1](../../docs/child_simple_mount_interface.md)**。後付けマウント設計時はこの文書の寸法・座標・締結方法に合わせる。

3か所とも **M3通し穴4個（設計径Ø3.45）、40 × 40ピッチ、座面60 × 60、厚さ8**。
FDMの穴縮みを考慮した通し穴であり、樹脂ねじ山ではない。別体のM3ナットを使う。
既存HP40のM5マウントとはねじ規格が異なる。

| 用途 | 外側座面中心 | 穴中心座標 | ボルト軸 |
|---|---|---|---|
| カメラ用ブリッジ | (0, +82, 100) | x=±20、z=80/120、y=82 | Y |
| TD04A用マウント | (0, -82, 190) | x=±20、z=170/210、y=-82 | Y |
| 水中ライト用マウント（r3追加） | (0, -82, 100) | x=±20、z=80/120、y=-82 | Y |

カメラ2台の150 mm基線は後付けブリッジ側で決める。筐体の40 mmピッチは基線ではない。
TD04Aは背面の縦座面にL字マウントを追加し、振動面を上へ向ける想定。
マウントはドームと干渉させず、カメラのレンズ前に筐体を出さないよう設計する。
マウントの裏にM3ナットと外径10 mmの工具が入る空間を検査する。

## ねじ・消耗品

| 品目 | 数量 | 用途 |
|---|---:|---|
| M3×30ボルト | 4 | 前後枠の締結：樹脂合計20 mm |
| M3×35ボルト | 8 | ガード固定：樹脂合計28 mm。支柱ごとに縦ピッチ12 mmで2本 |
| M3ナット／ロックナット | 12 | 枠4個＋ガード8個。ガードは対辺5.5・厚4 mm以下で検査。すべて外から装着 |
| M3平ワッシャ（厚0.5 mm想定） | 24 | 枠締結8枚＋ガード16枚。各ボルトの頭側・ナット側 |
| M3ボルト＋ナット | 12組、後日 | カメラ4・TD04A4・ライト4。ねじ長さはマウント厚が決まってから選ぶ |
| 2 mm EVAまたは同等の緩衝材 | 適量 | チューブに当たる上下帯・中央帯。段差受けには厚く貼らない |
| 結束バンド・保護スリーブ | 適量 | 下部支柱のスロットで配線保持 |
| 吊りロープ | 2点分 | 前後枠のØ10穴を一緒に通し、擦れ対策を行う |

ねじ長の確認：`挟む樹脂厚＋マウント厚＋ワッシャ厚＋ナット厚＋約1 mm`。
ガードのボルトはチューブから離れたx=±100を前後方向に通す。ねじ長・両側ワッシャを確認する。

### 灰色ガードとの接続

接続部拡大・金色は外付けナット

図は接続1か所の切り出し。金色が外付けナット、青が枠、灰色がガード。ねじ・ナットは説明用の簡略表示。

- 枠の張り出し部：厚16 mm。ガード側の重ね部：厚12 mm。貫通穴Ø3.45。
- 各接続の穴中心はx=±100、z=-7/+5、軸はY。前側はy=17～45、後側はy=-45～-17。
- ボルト頭とナットは露出し、外径10 mm工具の直線進入空間を確保する。
- 枠の下面z=-19がガードの段差に載る。1支柱あたり20×16=320 mm²の受け面、4支柱合計1280 mm²。
- 静置時の下向き荷重は受け面で伝え、ボルトは抜け・横ずれを押さえる。2本のボルトで接続の回転を抑える。
- 受け面は引き離す力を負担しない。落下・横荷重・持ち上げ時も含めた実使用強度は検証結果の制約に従う。

## 組立・取り外し

1. 印刷サポートとバリを除去。M3穴を確認し、必要ならØ3.4～3.5のドリルで仕上げる。
2. 内周の保持帯に緩衝材を貼る。後枠へ容器を入れ、下キャップと上ドームリングの段差を溝に合わせる。
3. 前枠を被せ、M3×30の4本を交互に締める。合わせ面が当たるまで均等に締め、アクリルを局所的に押さない。
4. 枠をガードの4つの段差に載せる。各支柱にM3×35を2本ずつ通し、両側ワッシャと外付けナットで締める。埋め込み作業はない。
5. 下キャップからの配線をガード内へ収め、支柱へ結束する。吊りロープは左右とも前後2枚を貫通させる。

容器の取り外し：前側のガードボルト4本と前後締結4本を外し、前枠を+Yへ外して容器を取り出す。
前側マウントに配線がある場合はサービスループを確保し、コネクタを引っ張らない。

## 部品外の考慮・未反映

- 下キャップの中央を開放。ペネトレータ突出20 mm仮定で、先端から接地面まで51.2 mm。
- ケーブル外径・最小曲げ半径・実際のペネトレータは未確定。中央開口と前後の窓で逃がすが、実配線で床に触れないことを確認する。
- テザー主張力をペネトレータへ掛けない。スロットは配線整理用で、テザー用ストレインリリーフの荷重能力は未検証。
- ドームの上部は露出させる。輸送時は緩衝材で保護する。
- カメラ、TD04A、専用マウント、ライト、バラスト、内装、ねじ・ロープ・EVA・実配線は組立STEPに含めていない。
- 外形220×168は外装だけの寸法。後付けマウントまで含めた外形・視野・音響遮蔽は後工程で確認する。
- バラストの保持機構と全備状態の吊り姿勢は未設計。このモデルだけでは水中姿勢・浮力を保証しない。

## 寸法の確認が残る箇所

ユーザーが確認したのは縦置き構成とチューブ径・長さ。
ドーム参考モデルはリングØ114.3×6、旧外装はØ120.3×6.5を仮定していた。
本設計は外径120.3＋逃げで溝を作り、上端の内半径49のリップで小さい方のリングも受ける。
実物の `dome_ring_clearance_od` / `dome_ring_height` / `dome_neck_radius` は印刷前に確認する。
チューブ径公差とEVAの硬さに合わせ、`eva_compression`を調整する。

## 検証

最終結果は [検証結果](verification.md)。形状の検査と実使用の強度認定は分けて記載している。

再生成：リポジトリ直下から各部品フォルダを`build.ps1 -Paths`へ渡し、次に
`build.ps1 -Assemblies -Paths assemblies/child_simple_assembly`を実行する。
`spec/verify_child_simple_cad.py`はFreeCADCmdで実行し、`spec/check_child_simple.py`はPythonで実行する。

## parts/child/exterior/printed/child_simple_front/child_simple_front.md

# child_simple_front

前枠。カメラ用ブリッジのM3 40×40穴を前面中央に設置。

## 主要寸法・インタフェース

- マウント共通規格：[CHILD-SIMPLE-M3-40x40 / Rev.1](../../../../../docs/child_simple_mount_interface.md)。後付けカメラマウント設計時に参照する。

- 外形：220 × 82 × 238 mm。樹脂実体の体積：469.6 cm³。
- 設計の正本：[共有パラメータ](../../../../../scad/lib/child_simple_frame.scad)。
- 対象：WTE4 Ø114.3×200の縦置き子機。2026-09-16ユーザー確認済み。
- 寸法と穴座標・ねじ一覧：[組立仕様](../../../../../assemblies/child_simple_assembly/README.md)。

## 印刷向き

[印刷条件と配置済みSTL](../../../../../print_jobs/child_simple/PRINT.md)。PETG、サポートあり。未スライス・未印刷。

## 検証・荷重ケース

STL閉メッシュ、単一連結体。STEPソリッド検査と容器・ねじの干渉検査は通過。
100 Nのマウント荷重、300 Nの保持／着底・輸送荷重のうち該当ケースをFEAで検査した。
**メッシュ収束は不合格。要求安全率4を下回る最悪要素もあり、強度合格品ではない。**
たわみ・安全率と境界条件の限界：[検証結果](../../../../../assemblies/child_simple_assembly/verification.md)。

## 部品外の考慮・要確認

ナット、工具、配線用の空間を確保。ガードのナットは外付けで、容器の装着後でも交換できる。
ドームリング実寸、EVA締め代、実配線、ねじの緩み対策、吊り状態は現物確認が必要。
カメラ・TD04Aと専用マウント、バラスト、ケーブルの最終配置は未反映。

## parts/child/exterior/printed/child_simple_guard/child_simple_guard.md

# child_simple_guard

下部配線ガードr2。4支柱の段差で枠を支え、M3×35の8本と外付けナットで固定。埋め込み・先入れ不要。

## 主要寸法・インタフェース

- 外形：220 × 168 × 97 mm。樹脂実体の体積：407.9 cm³。
- 設計の正本：[共有パラメータ](../../../../../scad/lib/child_simple_frame.scad)。
- 対象：WTE4 Ø114.3×200の縦置き子機。2026-09-16ユーザー確認済み。
- 寸法と穴座標・ねじ一覧：[組立仕様](../../../../../assemblies/child_simple_assembly/README.md)。

## 印刷向き

[印刷条件と配置済みSTL](../../../../../print_jobs/child_simple/PRINT.md)。PETG、サポートあり。未スライス・未印刷。

## 検証・荷重ケース

STL閉メッシュ、単一連結体。STEPソリッド検査と容器・ねじの干渉検査は通過。
100 Nのマウント荷重、300 Nの保持／着底・輸送荷重のうち該当ケースをFEAで検査した。
**メッシュ収束は不合格。要求安全率4を下回る最悪要素もあり、強度合格品ではない。**
たわみ・安全率と境界条件の限界：[検証結果](../../../../../assemblies/child_simple_assembly/verification.md)。

## 部品外の考慮・要確認

ナット、工具、配線用の空間を確保。ガードのナットは外付けで、容器の装着後でも交換できる。
ドームリング実寸、EVA締め代、実配線、ねじの緩み対策、吊り状態は現物確認が必要。
カメラ・TD04Aと専用マウント、バラスト、ケーブルの最終配置は未反映。

## parts/child/exterior/printed/child_simple_rear/child_simple_rear.md

# child_simple_rear

後枠r3。TD04A用M3 40×40穴を背面上部、ライト用M3 40×40穴を中央に設置。ライト用穴は2026-09-17ユーザー確認済み。穴径Ø3.45、中心x=±20・z=80/120、外側座面y=-82。外付けM3ナットを使用し、埋め込み不要。

## 主要寸法・インタフェース

- マウント共通規格：[CHILD-SIMPLE-M3-40x40 / Rev.1](../../../../../docs/child_simple_mount_interface.md)。TD04A用・ライト用の取り違え防止に参照する。

- 外形：220 × 82 × 239 mm。樹脂実体の体積：520.2 cm³。
- 設計の正本：[共有パラメータ](../../../../../scad/lib/child_simple_frame.scad)。
- 対象：WTE4 Ø114.3×200の縦置き子機。2026-09-16ユーザー確認済み。
- 寸法と穴座標・ねじ一覧：[組立仕様](../../../../../assemblies/child_simple_assembly/README.md)。

## 印刷向き

[印刷条件と配置済みSTL](../../../../../print_jobs/child_simple/PRINT.md)。PETG、サポートあり。r3スライス済み・未印刷。frontは既に印刷済みで変更不要。

## 検証・荷重ケース

STL閉メッシュ、単一連結体。STEPソリッド検査と容器・ねじの干渉検査は通過。
旧r2について100 Nのマウント荷重、300 Nの保持／着底・輸送荷重をFEAで検査した。r3形状のFEAは未実施。
**メッシュ収束は不合格。要求安全率4を下回る最悪要素もあり、強度合格品ではない。**
たわみ・安全率と境界条件の限界：[検証結果](../../../../../assemblies/child_simple_assembly/verification.md)。

## 部品外の考慮・要確認

ナット、工具、配線用の空間を確保。ガードのナットは外付けで、容器の装着後でも交換できる。
ドームリング実寸、EVA締め代、実配線、ねじの緩み対策、吊り状態は現物確認が必要。
カメラ・TD04A・ライトと専用マウント、バラスト、ケーブルの最終配置は未反映。
