AquaBeacon/mechanical/assemblies/child_vertical_assembly/parts/DESIGN_NOTES.md

# 設計・印刷条件の控え（自動生成）

以下は設計元の文書を転記したものです。リンク先は元フォルダ基準です。印刷条件と未検証事項を確認してください。

## child_vertical_assembly/README.md

**印刷一式:** [parts/PRINT.md](parts/PRINT.md)（STL・数量・モディファイア） · **確認画像:** [_work/images/](_work/images/)

2026-10-07：未使用ケーブルレール2本と固定ねじ8本を撤去。デッキの既存穴は残置（使用不要）。バッテリーの普通M3ナット5個は横差しポケットに収まり、樹脂との重なり・横挿入・床板着脱の122検査で干渉なし。ナットの熱圧入や造形途中の埋込みは不要。 詳細は[ねじ組立手順](../../spec/child_interior_reinforcement/FASTENER_ASSEMBLY.md)。

# child_vertical_assembly

- [child_vertical_assembly.md](child_vertical_assembly.md)
- [child_lcd_service_view.scad](child_lcd_service_view.scad)
- [child_vertical_assembly.step](child_vertical_assembly.step)
- [child_vertical_assembly.stl](child_vertical_assembly.stl)
- [child_vertical_assembly_interior.step](child_vertical_assembly_interior.step)
- [child_vertical_assembly_interior.stl](child_vertical_assembly_interior.stl)
- [child_vertical_assembly_view.scad](child_vertical_assembly_view.scad)

構成と既存の未検証事項は上の設計説明を参照してください。

現行内装はM3統一・サポート削減版。[変更と印刷設定](../../spec/child_interior_reinforcement/M3_SUPPORT_REVISION.md)。RXのØ2.2基板穴は未使用、M3外周クランプ4組で保持。印刷一式には必要な鏡像STLとモディファイアを含み、印刷姿勢へ回転済みです。

現行締結は [電池・フランジ補強改訂](../../spec/child_interior_reinforcement/BOLTED_MOUNT_REVISION.md)。電池ケースM3×12＋普通ナット4組、床板M3×10皿＋普通ナット1組、前側フランジM3×16。デッキ根元80 mm・一体リブ拡幅、ブレース梁12 mm。強度試験は未実施です。

2026-10-04：RXクランプを左右連結して8→4個、フランジブレースの途中のくびれを補強、床板窓とケース取付部を改訂。[設計・印刷・配線変更](../../spec/child_interior_reinforcement/PRINT_STRENGTH_REVISION.md)。

2026-10-06：[ねじ一覧・工具条件・組立順](../../spec/child_interior_reinforcement/FASTENER_ASSEMBLY.md)を追加。レールねじの工具通路を修正。MF10スペーサのオス突出長は現物確認待ち。
# 2026-10-21 子機内装スペーサ更新

2026-10-21 通し穴改訂：スペーサ外側を二面幅5.5 mmの六角、穴を内接径3.5 mmに変更。M3ねじが滑って通り、タップ不要。10 mm×2・12 mm×1・30 mm×1をつなぎ付き1セットで印刷する。左右フランジは首下26 mmのM3なべねじ2本（必要ならM3×30を26 mmに切断・面取り）、ブレースはM3×30／×45スタッド各1本＋普通M3ナット2個で固定。以前の短いスタッドと上ねじ4本は使わない。[設計・取付・印刷条件](../../parts/child/interior/printed/child_spacer_set/child_spacer_set.md)。実物の嵌合・締結強度は未検証。

## parts/child/exterior/printed/child_bottom_guard/child_bottom_guard.md

# child_bottom_guard — 下部ガード / 脚 / バラスト座

| 項目 | 値 |
|---|---|
| 区分 | 子機 / 外装 / 3Dプリント |
| 設計ソース | `child_bottom_guard.scad` |
| 個数 | 1 |
| 外形 | **Ø198 × 55 mm** (z -37..18) |
| 体積 | 250.8 cm³ (STEP) → PETG 約 190 g |
| STEP | 1 ソリッド / 130 面 |

## 役割

縦置き子機の一番下。**4 つの役目を 1 部品で持つ**。

1. **アルミエンドキャップとペネトレータを着底衝撃から守る**
   (スキッド底面 z=-37 が、ペネトレータ先端より約 3mm 下)
2. **容器の重量を 3 点パッド (r 42..50) で受ける** — シェルのクランプ力に頼らない
   軸方向ストッパ。アクリルチューブに軸方向の摩擦荷重を掛けない
3. **陸上で自立させる脚** (スキッドリング Ø198)。ドームを接地させずに置ける
4. **バラスト (鉛) の取付座**。M6 ×5 の取付位置を変えて**吊り姿勢をトリムする**

## ケーブルの逃げ (★ 最重要)

**中央 r<42 は完全に素通し。後方 (-Y) ±40° のセクタには構造物を置いていない。**

| ケーブル | 経路 |
|---|---|
| テザー | キャップ → 真下 → リング後方の結束スロット (±10°) でストレインリリーフ → 機体外周を上へ |
| TD04A | キャップ → 後方セクタ → 後半シェルのパイロン内 (導管) → 上のソケット |
| ライト | キャップ → 後方セクタ → 機体外周 → 前半シェルのデッキ結束スロット → ライト |

**ペネトレータの締付け (バルクヘッド 3.5 N·m / プラグ 約 14 N·m) は、
このガードを外した状態で行うこと。** ガードは M5 ×4 で後半シェルの底フレアに
留まっているだけなので、工具アクセスのために外せる。

## 主要寸法

| 変数 | 値 | 意味 |
|---|---|---|
| `cap_z` | -13.8 | アルミキャップ下面 (STL 実測から導出) |
| `pad_r0..r1` / `pad_w` | 42..50 / 24 | キャップ支持パッド ×3 |
| `pen_or` | 39 | ペネトレータ外形の外端半径 (BCD/2 28 + 六角半幅 11) |
| `cap_scr_bcd` | 108 | キャップ取付 M3 の BCD **要確認** |
| `ring_r0..r1` / `ring_z0..z1` | 79..99 / -37..-25 | スキッドリング |
| `spoke_w` / `spoke_t` | 30 / 6 | スポーク ×3 (リング ↔ 支柱) |
| `arm_a` | 60 / 180 / 300 | スポーク・支柱の方位角 (0 = 真後ろ) |
| `lug_r` / `lug_a` / `lug_z1` | 70 / ±40, ±68 / 18 | シェルへの取付ラグ ×4 |
| `leg_w` / `leg_t` / `leg_ang` | 24 / 20 / 21.6° | 脚 ×4 (垂直からの傾き) |
| `bal_d` / `bal_r` / `bal_a` | 6.5 / 89 / 0, ±100, ±140 | バラスト M6 ×5 |

支持パッドの半径は「**ペネトレータ (r≤39) より外、キャップの M3 頭 (r=54) より内**」
の隙間に置いてある。r 42..50 はこの窓のほぼ中央。

## インタフェース (**二重定義。片方だけ直さないこと**)

`child_shell_aft` と共有: `lug_r=70` ↔ `guard_r=70`、`lug_a=[40,-40,68,-68]` ↔
`guard_a`、`lug_z1=18` ↔ `shell_z0=18`。

締結は **M5 ×4 (M5×30)**。ナットは後半シェル側のフレア上面のポケットに入る。

## 干渉チェック (`.scad` 冒頭の assert — 実際に止まったもの)

1. **脚の根元がリングの帯幅からはみ出して宙に浮く** → リング幅を 12 → 20mm に広げた
   (Ø190 → Ø198)。「assert を緩める」のではなく形状を直した
2. **バラスト穴の干渉判定が方位角の巻き戻しを扱えていなかった** (a=0 と a=180 を
   「同じ角度」と誤判定) → `angdiff()` を導入して弦長で判定するよう直した

常時検査しているもの:

- 支持パッドがペネトレータにもキャップの M3 頭にも掛からないこと
- **真後ろのケーブル用セクタが ±25° 以上開いていること** (**現在 ±40°**)
- 支柱がスポークの上に載ること / 支柱の下端がスポーク上面と一致すること
- 脚の傾き < 45° (**現在 21.6°** → 無サポート) / 脚がラグ下面を支えられる太さか
- スキッド径 ≤250 / 全高が 300 枠を超えないこと / ベッド高さに入ること
- バラスト穴・結束スロットが脚/スポークに掛からないこと

## 強度

| 項目 | 値 |
|---|---|
| 容器の自重 (1.85kg × 3g = 54N) を 4 本の脚で受ける | 脚断面 24×20 → **0.03 MPa** |
| 陸上で自立 (全備 5.7kg) | リング全周で受ける → 無視できる |
| 着底衝撃 | **塑性変形で吸収する前提の消耗品**。割れたら刷り直す |

ガードは「壊れることで容器とペネトレータを守る」部品。
**強度を上げすぎない方がよい** (硬くすると衝撃がキャップへ抜ける)。

## 印刷向き

**このまま。** スキッドリング底面 (z=-37) が約 6700mm² のベッド接地面。
脚は垂直から 21.6° なのでサポート不要。スポークもベッドに接する層にある。

## 部品外の考慮

- **バラストは 1.1〜2.2 kg の鉛**を M6 ×5 の好きな位置に付ける
  (浮力の見積りは `docs/AquaBeacon_機体設計.md`)。
  **前後の取付位置で吊り姿勢 (前傾/後傾) をトリムできる** — 重心が吊り点より
  約 6mm 前にあるので、後ろ寄り (a=0 付近) に置くと水平に近づく。
- 鉛は**海水で溶出する**。エポキシで包むか、ステンレスの錘を使うこと。
- **陸上での置き方**: 3 本脚 + リングで自立する。傾転角は約 33°
  (重心 z≈69 / 脚半径 99)。**波打ち際や船上では必ず固縛すること。**
- リング後方の結束スロット ×2 は**テザーのストレインリリーフ**。
  張力はここで受け、ペネトレータのシール部には掛けない。
- 砂地に着底するとリングの中に砂が入る。**引き上げ後に真水で洗うこと**
  (中央が開いているので流し落とせる)。
- ガードを外さないとペネトレータの工具が入らない。**分解順序**:
  ガード (M5×4) → 前半シェル (M5 蝶ボルト ×4) → 容器を真上へ。
  ただし**内部アクセスだけならドームを開ければよく、ガードもシェルも外さない**。

## 要確認

1. **キャップ取付 M3 の BCD** (`cap_scr_bcd = 108` は公称からの推定)。
   実物で M3 頭の位置を測り、支持パッド r 42..50 と当たらないことを確認する
2. **ペネトレータの突出量**。`ring_z0 = -37` は「キャップ下面から 23.2mm」で
   決めている。実物が長ければ `ring_z0` を下げる (ただし全高 300 の枠を食う)
3. 実際に必要なバラスト量 (浮力計算は仮値だらけ)。**進水前にプールで実測すること**
4. M5×30 ×4 / M6 ボルト (バラスト用、長さは鉛の厚みによる)

## parts/child/exterior/printed/child_cam_lid/child_cam_lid.md

# child_cam_lid — カメラポッド 押え蓋

| 項目 | 値 |
|---|---|
| 区分 | 子機 / 外装 / 3Dプリント |
| 設計ソース | `child_cam_lid.scad` |
| 個数 | **2** (左右。形状は X 対称なので同じ物) |
| 外形 | 90.4 × 47.7 × 15 mm (板 10 + 押えパッド 5) |
| 体積 | 42.9 cm³ (STEP) → PETG 約 38 g |
| STEP | 1 ソリッド / 36 面 |

## 役割

`child_shell_fwd` のカメラポッドに落とし込んだ DJI Osmo Action 6 を上から押さえる。
**M4 蝶ボルト 2 本で着脱 (数秒)。**

押えパッドの下面に **EVA スポンジ 2mm** を貼る。締めると 0.6mm 潰れて、
カメラをポッド底の位置決めパッド ×3 へ押し付ける = **Z の再現性**が出る。

## 主要寸法

| 変数 | 値 | 意味 |
|---|---|---|
| `lid_t` | 10 | 板厚 |
| `lid_ov` | 1.5 | ポッド側壁より外へ出す量 (ねじの端距離 + 水切り) |
| `lid_hw` (導出) | 45.2 | 半幅 |
| `pad_h` (導出) | 5.0 | 押えパッド高さ = `gap 6.4 − foam 2.0 + preload 0.6` |
| `rim_t` / `rim_h` / `rim_clr` | 3 / 2 / 0.5 | 位置決めリム (クレードルに落として蓋の XY を決める) |
| `sc_x` / `sc_y` (導出) | ±40.2 / 19.7 | M4 蝶ボルト |
| `win_hw` / `win_y0..y1` | 25 / 4..20 | 上面ボタンのアクセス窓 **位置は要実測** |

## インタフェース (**二重定義。片方だけ直さないこと**)

`child_shell_fwd` と共有: `cam_w=72.8` / `cam_h=47.2` / `cam_d=33.1` / `cam_clr=0.6` /
`lens_y=110` / `cam_ax_z=115` / `pod_wall=7` / `pod_rear=6` / `hood=8` /
`pod_top=145` / `lid_sc_y=90`。

ねじは **M4 蝶ボルト ×2**、相手はポッド側壁上面の **Ø3.3 下穴へのタッピング**
(深さ 12mm)。着脱を繰り返すなら Ø5.6×8 の M4 熱圧入インサートに置換すること。

## アセンブリ配置

`translate([±75, 70.3, 145])` (= `[±(base_line/2 − lens_dx), in_y0 − pod_rear, pod_top]`)。

## 干渉チェック (`.scad` 冒頭の assert)

- 押えパッド高さが正 (`pod_top` を上げすぎるとパッドが伸びて折れる)
- 押え代の計算整合 (`pad_h + foam − preload == gap`)
- 位置決めリムがカメラ上面に当たらないこと (リム 2mm < gap 6.4)
- **蓋ねじがクレードル内腔に掛からないこと** / 外側端距離 ≥2mm
  → ここで実際に 0.25mm 足りずに止まり、`lid_ov = 1.5` を追加した
- 位置決めリムがクレードルに落ちる幅であること
- **蓋込みの全幅 ≤ 250** (蓋がポッドより広いので、機体の最大幅を決めるのはこの部品)
- アクセス窓がリム/ねじに掛からないこと

## 印刷向き

**上下逆さま** (z=`lid_t` の平面をベッドに置く)。押えパッドと位置決めリムが
上を向くのでサポート不要。接地面 90.4 × 47.7 で安定。

## 部品外の考慮

- **上面ボタンのアクセス窓の位置は仮値**。実機で合わなければ `win_*` を直すか、
  `win_on = false` で塞ぐ (窓なしの方が保護は良い)。
- 蓋を開けないと電池・SD が触れない。**入水前に充電・設定・時刻同期を済ませる**。
- EVA スポンジは消耗品。潰れたら交換する (BOM に予備を入れること)。
- 蓋の水抜き穴 (Ø6 ×2、前寄り) は塞がないこと。クレードルは水没する前提。
- 蝶ボルトは水中で回すことがある。**ステンレス (A2/A4) を使い、
  PETG のタッピング部が痩せてきたらインサートへ移行する**。

## 要確認

1. Osmo Action 6 の**上面ボタンの位置** → `win_*`
2. カメラ上面が本当に平らか (突起があると押えパッドが当たる) → `pad_h`
3. M4 蝶ボルトの入手 (M4×20、4 本)

## parts/child/exterior/printed/child_light_clamp/child_light_clamp.md

# child_light_clamp — 水中ライト 割りクランプ 上半分

| 項目 | 値 |
|---|---|
| 区分 | 子機 / 外装 / 3Dプリント |
| 設計ソース | `child_light_clamp.scad` |
| 個数 | 1 |
| 外形 | 70 × 40 × 28.5 mm |
| 体積 | 52.9 cm³ (STEP) → PETG 約 47 g |
| STEP | 1 ソリッド / 20 面 |

## 役割

水中ライトの胴を挟む割りクランプの**上半分**。下半分は `child_shell_fwd` の
鞍座 (`light_saddle`) と一体。M4 ×4 で締める。

ライトはカメラと**同じ +Y 方向**を向く。ライト軸 = Y なので、**鞍座の 40mm の範囲で
前後にスライドできる** (スロットは不要)。バックスキャッタが出たら後ろへ下げる。

## 主要寸法

| 変数 | 値 | 意味 |
|---|---|---|
| `light_d` | **40** | ライト胴径 **要選定・要実測** |
| `grip_clr` | 0.4 | 締め代を残すためのすきま (ゴムシート前提) |
| `blk_h` | 30 | ライト軸から上のブロック高さ (頂部肉厚 9.8) |
| `gap_z` | 1.5 | 合わせ面のすきま。締めるとゴムが潰れて効く |
| `light_m4x` / `light_m4y` | ±28 / 86, 110 | M4 (グローバル座標) |
| `tie_x` / `tie_w` / `tie_h` | ±30 / 4 / 8 | 結束スロット (前後 M4 の中間) |

## インタフェース (**二重定義。片方だけ直さないこと**)

`child_shell_fwd` と共有: `light_d=40` / `light_y0=78` / `light_y1=118` /
`light_m4x=28` / `light_m4y=[86,110]` / `light_blk=35` / `light_z=58`。

**`light_d` を変えたら両方を再ビルドすること。** シェル側は鞍座の半円と、
ライトが画角に入らないかの assert がこの値に依存している。

M4 ×4 の相手はシェル側鞍座の **Ø3.3 下穴へのタッピング** (深さ 14mm)。

## アセンブリ配置

`translate([0, 78, 58])` (= `[0, light_y0, light_z]`)。

## 干渉チェック (`.scad` 冒頭の assert)

- 鞍の頂部肉厚 ≥8mm (**現在 9.8mm**)
- M4 が鞍の半円に掛からないこと / 外側端距離
- **結束スロットがブロックからはみ出さないこと** → ここで実際に止まり、
  スロットを M4 の外側から**前後 M4 の中間**へ移した
- 結束スロットが M4 に掛からないこと
- 合わせ面のすきま `gap_z > 0.8` (締め代が取れること)

## 印刷向き

**上下逆さま** (z=`blk_h` の平面をベッドに置く)。鞍の半円が上を向くのでサポート不要。

## 部品外の考慮

- **ライトは未選定。`light_d = 40` は仮値。** 製品が決まるまでこのクランプは仮設計。
  胴が円筒でない製品 (角形・フランジ付き) なら形状から作り直しになる。
- **ゴム/EVA シート (1〜2mm) を鞍面に貼る**こと。樹脂とアルミ胴が直接こすれると
  ライトに傷が付き、締め付けも滑る。`gap_z = 1.5` はその圧縮代。
- ライトの**配線はクランプの結束スロット → デッキの結束スロット → 機体外周 →
  下のキャップのペネトレータ**。前半シェルを外すときに突っ張らないよう
  **サービスループ 150mm 以上**。
- **光量は控えめでよい** (`../docs/AquaBeacon_確定仕様メモ.md`: 親機カメラ用ビーコン、数W)。
  発熱は水中なら問題ないが、**空中での連続点灯は避ける**。
- カメラ同期用に「潜行前後に既知時刻でブリンク」させる運用がある。
  **点滅を制御できる製品か、外部から給電/制御できる製品を選ぶこと。**

## 要確認

1. **製品の選定** → 胴径・胴長・重量・配光・ケーブル外径
2. ケーブル外径 → WetLink ペネトレータの型番 (4.5〜8.5mm)
3. 点滅制御の方式 (容器内の基板から制御するか、独立電源か)
4. 浮力。ライトは中身が詰まっていて負の浮力が大きいことが多い。
   バラスト量の見積り (`docs/AquaBeacon_機体設計.md`) に反映すること

## parts/child/exterior/printed/child_shell_aft/child_shell_aft.md

# child_shell_aft — 子機 外装 後半シェル (縦置き構成)

| 項目 | 値 |
|---|---|
| 区分 | 子機 / 外装 / 3Dプリント |
| 設計ソース | `child_shell_aft.scad` |
| 個数 | 1 |
| 外形 | 196 × 121 × 234 mm (x ±98 / y -115..+6 / z 18..252) |
| 体積 | 781.7 cm³ (STEP) → PETG 実重量の目安 **約 500 g** |
| STEP | 1 ソリッド / 301 面 |
| 素材 | PETG (X1-Carbon) |

## 役割

耐圧容器 (WTE4 4″×200mm) を縦置きで抱える 2 枚シェルの**常設側**。
manafish ROV と同じく「容器を 3Dプリント部品で挟む」構成で、
前半シェル (`child_shell_fwd`) を M5 蝶ボルト 4 本で外すと容器が真上に抜ける。

1 部品で以下を兼ねる。

| 機能 | 実装 |
|---|---|
| 容器の保持 | 内径 Ø116.7 の半円筒スキン (肉厚 6)。EVA/ゴムシート 1.2mm を貼って締める |
| **吊り点** | 吊り耳 ×2 (x=±80, z=234, Ø16 穴)。ロープは**2点ブライドル**で上へ |
| **取っ手** | 後部パイロン内の六角バー (握り径 26、指スペース 43mm) |
| TD04A の保持 | パイロン屋根 (z=182, y=-86) に `xdcr_socket` を M5×4 で上向き固定 |
| ケーブル導管 | パイロン内部が後方に開いた空洞。下から上まで素通し |
| 下部ガード取付 | 底フレアのボス ×4 (r=70, 方位角 ±40 / ±68) |
| ドームの保護 | 吊り耳がドーム両脇に立ち上がり、横倒し時の当たりを受ける |

## 主要寸法

| 変数 | 値 | 意味 |
|---|---|---|
| `bore_d` (導出) | 116.7 | `tube_od 114.3 + 2×pad_t 1.2` |
| `skin_t` / `skin_r` | 6 / 64.35 | スキン肉厚 / 外半径 |
| `shell_z0` / `shell_z1` | 18 / 190 | シェル下端 / 上端 |
| `flare_r` / `flare_h` | 78 / 10 | 底フレア (ベッド接地面 + ガード取付座) |
| `rail_x0..x1` / `rail_t` | 56..80 / 10 | 合わせ面レール |
| `bolt_x` / `bolt_z` | 70 / [42, 150] | 締結 M5 ×4 (蝶ボルト M5×35) |
| `pin_z` / `pin_d` | 100 / 6 | 位置決めピン (前半シェル側は Ø6.4 穴) |
| `eye_x` / `eye_z` / `eye_d` | 80 / 234 / 16 | ロープ穴 (Ø10 ロープ / M10 シャックル) |
| `py_x` / `py_y` / `py_z1` | 50 / -115 / 182 | パイロン (半幅 / 後端 / 屋根上面) |
| `grip_z` / `grip_d` | 118 / 30 | 取っ手バー (六角・頂点下向き) |
| `xd_y` / `xd_pitch` | -86 / 40 | TD04A ソケットの中心 y / M5 4穴ピッチ |
| `guard_r` / `guard_a` | 70 / [40,-40,68,-68] | 下部ガード取付ボス |

## インタフェース (**二重定義。片方だけ直さないこと**)

| 相手 | 共有している値 |
|---|---|
| `child_shell_fwd` | `skin_t=6` / `shell_z0=18` / `shell_z1=190` / `rail_x0=56` / `rail_x1=80` / `rail_t=10` / `bolt_x=70` / `bolt_z=[42,150]` / `pin_z=100` / `flare_r=78` / `flare_h=10` / `tube_od=114.3` / `pad_t=1.2` |
| `child_bottom_guard` | `guard_r=70` / `guard_a=[40,-40,68,-68]` / `shell_z0=18` (= ガードの `lug_r` / `lug_a` / `lug_z1`) |
| `xdcr_socket` | `base_w=60` / `hole_p=40` (ソケット側) ↔ `xd_pitch=40` |
| `wte4_dome_cap` | `dome_ring_od=114.3` → 逃げ径 Ø122.3 |

ボルトボスは **y = -24..0 の 24mm 厚**。前半シェルのボス 14mm と合わせて
M5×35 蝶ボルトが、後半シェルのナットトラップ (y=-16..-20.4、横挿し) に届く。

## 干渉チェック (`.scad` 冒頭の assert — 実際に止まったもの)

自動チェック (watertight / ソリッド数) では**捕まらない**ものだけを assert にしてある。
下の 3 つは今回の設計中に実際に assert が止めて、**形状の方を直した**。

1. **取っ手バーが屋根の中央リブと干渉** → リブ下端を 128 → 145 へ上げた
2. **TD04A の前側取付穴の真上をスキンの外向きカラーが覆い、下穴が「閉じた空洞」になった**
   → 上カラーを廃止 (丸めは Fusion で付ける)。ソリッドが 3 個に分離していた
3. **結束スロットの角がパイロン下面の 45° 斜面にちょうど接して非マニフォールド**
   → スロット z を 70 → 74 に逃がし、斜面との離れを検査する assert を追加

そのほか常時検査しているもの:

- 吊り耳ボスの最内点がドーム抜き取り経路 (Ø122.3) の外にあること (**現在 r=65.8 / 必要 62.2**)
- 締結 M5 とナットがチューブ穴に噛まないこと / ナットがレール内に収まること
- 吊り耳がボルトボスと重ならないこと (重なるとナットの横挿しスロットが塞がれて**組めない**)
- 取っ手の指スペース ≥ 35mm (**現在 43mm**)、握り径 24〜34 (**現在 26.0**)
- 内部空洞がスキンを食わないこと (食うとチューブが露出して保護にならない)
- ガード取付ボスが空洞/レールに掛からないこと・底フレア内に収まること
- 通水穴・結束スロットがレール/パイロン/吊り耳/45°斜面に掛からないこと
- 全幅 ≤ 250 / 後端 ≤ 125

ビルド後は `_work/images/child_shell_aft_preview.png` の front / top / side を目視すること。

## 強度

| 項目 | 値 |
|---|---|
| PETG 設計許容応力 | XY 12 MPa / Z(層間) 6 MPa (極限 45 / 25 MPa に安全率 4) |
| 吊り荷重 (全備 5.7kg × 動的 3g、ブライドル 30°) | **1 耳あたり 99 N** |
| ロープ穴上部のせん断抜け (10mm × 24mm × 2面) | 0.21 MPa → **安全率 29** |
| Ø16 穴の支圧 (16 × 24) | 0.26 MPa |
| 吊り耳 根元の曲げ (16 × 40 断面、腕 50mm) | 1.17 MPa → 安全率 10 |

吊り耳は**積層に垂直な引張**を受ける最悪方向なので、スライサで
**壁 5 本以上・インフィル 40% 以上**にすること。それでも上表の余裕がある。

## 印刷向き

- **このまま (Z が積層方向)。サポート不要。**
- 底フレア (z 18..28) がベッド接地面。**ブリム 3mm 推奨**
- パイロン下面は 45°、吊り耳の外側下面も 45° に逃がしてある
- 取っ手バーは六角の頂点下向き (下面 60°)、横穴はすべてティアドロップ

## 部品外の考慮

- **ロープは 2 点ブライドル**。1 点吊りにすると吊り耳 1 個に全荷重が掛かり、
  さらに機体が回りやすくなる。ブライドルの脚長で吊り姿勢 (前後の傾き) を調整する。
  重心が吊り点より約 6mm 前にあるので、**バラストを後ろ寄りに置いて合わせる**
  (`child_bottom_guard` の M6 穴 5 箇所)。
- **テザーは下のキャップから出て、機体の外を回って上へ戻る**。パイロン側壁の
  結束スロット (y=-85/-100 × z=74/92/158) に沿わせ、上端でロープに巻き付ける。
  **テザーの張力はロープで受け、ペネトレータには掛けない。**
- **TD04A のビーム (指向角 22°) は上向き**。ドーム・吊り耳・ロープのどれも
  ビーム内に入らない配置にしてある (振動子軸 r=86、最寄りの吊り耳まで 110mm、
  11° の円錐がそこへ届くのは面から 567mm 上)。**ただしブライドルのロープは
  約 440mm 上でビームに入る** — 細径なので影響は小さいが、実験時に確認すること。
- **取っ手はパイロンの後ろから手を入れて握る**。窓は下端 (45°斜面) から z=140 まで
  開いているので、グローブをしたままでも入る。
- パイロン内部は下も後ろも開いているので**水は溜まらない**。前面には Ø16 の
  通水穴 ×6 を開けてチューブの目視点検もできるようにしてある。
- **陸上ではドームが上を向く**。`child_bottom_guard` の脚で自立するので、
  ドームを直接接地させない。
- アクリル/PC は有機溶剤に弱い。スキン内面に貼る EVA シートの接着剤に注意。

## 要確認

1. `wte4_dome_cap` の押えリング OD → 逃げ径 Ø122.3 の妥当性 (現在 114.3+8 で設計)
2. TD04A の胴長 → 振動子上端が z=243 でドーム頂点 (261) より低いことの確認。
   胴長 73mm を超えるとドームより高くなる (全高は変わらないが見た目と保護が変わる)
3. M5 蝶ボルトの入手 (M5×35、4 本)。ナットは M5 六角 ×4 (横挿し)
4. スキン内面の EVA/ゴムシートの厚み実測 → `pad_t = 1.2` の調整

## parts/child/exterior/printed/child_shell_fwd/child_shell_fwd.md

# child_shell_fwd — 子機 外装 前半シェル (縦置き構成)

| 項目 | 値 |
|---|---|
| 区分 | 子機 / 外装 / 3Dプリント |
| 設計ソース | `child_shell_fwd.scad` |
| 個数 | 1 |
| 外形 | 237.4 × 122 × 172 mm (x ±118.7 / y 0..122 / z 18..190) |
| 体積 | 945.4 cm³ (STEP) → PETG 実重量の目安 **約 600 g** |
| STEP | 1 ソリッド / 270 面 |
| 素材 | PETG (X1-Carbon) |

## 役割

耐圧容器を挟む 2 枚シェルの**ゲート側**。M5 蝶ボルト 4 本を外すと、
カメラ 2 台とライトごと丸ごと前へ抜け、容器が真上に取り出せる。

### ★ 基線 150.0mm を 1 部品で持つ

左右のカメラポッドを**分けずに 1 部品に一体化**してある。
組立誤差でレンズ間隔が変わらないので、**基線 150.0mm は「単一部品の寸法」として
後の解析で信頼できる**。レンズ位置は機体座標で **(±75.0, 110.0, 115.0)**。

ただし絶対値の保証は設計の役目ではない。**運用前にステレオキャリブレーションで
実測すること。** この部品の役目は「基線を安定させ、着脱で変わらないようにする」こと。

## 主要寸法

| 変数 | 値 | 意味 |
|---|---|---|
| `base_line` | **150** | レンズ間隔 |
| `lens_y` / `cam_ax_z` | 110 / 115 | レンズ面の y / レンズ軸の z |
| `cam_w/h/d` | 72.8 / 47.2 / 33.1 | Osmo Action 6 実寸 |
| `cam_clr` | 0.6 | クレードルのクリアランス (両側合計) |
| `lens_dx` | 0 | レンズ軸の本体X中心からのずれ **要実測** |
| `pod_wall` / `pod_floor` / `pod_rear` | 7 / 6 / 6 | ポッド 側壁 / 床 / 後壁 |
| `hood` | 8 | 側壁・床がレンズ面より前へ出る量 |
| `pod_top` | 145 | 側壁上端 (= 蓋の座。カメラ上面 +6.4) |
| `tab_t` / `tab_z1` | 3 / 102 | 前抜け止めタブ |
| `fin_x` | 34.3 / 60 / 90 / 115.2 | 縦フィン (片側 4 枚) |
| `deck_z1` / `deck_y1` / `deck_ch` | 30 / 122 / 45 | 底デッキ (= 前方バンパ) |
| `rim_y0` / `rim_z1` | 114 / 46 | 前縁リム |
| `light_d` / `light_z` | 40 / 58 | ライト胴径 **要選定** / 軸 z |

## インタフェース (**二重定義。片方だけ直さないこと**)

| 相手 | 共有している値 |
|---|---|
| `child_shell_aft` | `skin_t=6` / `shell_z0=18` / `shell_z1=190` / `rail_x0=56` / `rail_x1=80` / `rail_t=10` / `bolt_x=70` / `bolt_z=[42,150]` / `pin_z=100` / `flare_r=78` / `flare_h=10` / `tube_od=114.3` / `pad_t=1.2` |
| `child_cam_lid` | `cam_w/h/d` / `cam_clr` / `lens_y` / `cam_ax_z` / `pod_wall` / `pod_rear` / `hood` / `pod_top=145` / `lid_sc_y=90` |
| `child_light_clamp` | `light_d=40` / `light_y0=78` / `light_y1=118` / `light_m4x=28` / `light_m4y=[86,110]` / `light_blk=35` / `light_z=58` |
| `action_camera` | `cam_*` / `cam_fov_d=155` |

## カメラの保持

上から落とし込むクレードル + 押え蓋 (M4 蝶ボルト ×2)。**着脱 5 秒**。

| 基準 | 実装 |
|---|---|
| Z | 床の位置決めパッド ×3 (Ø8 × 0.8)。カメラ底面が z=91.4 |
| XY | クレードル内寸 73.4 × 33.7 (片側 0.3mm クリア) |
| 押え | 蓋のパッドに EVA 2mm → 締結で 0.6mm 潰れて予圧 |
| 前抜け止め | 側壁内側の 3mm タブ (z 90.6..102)。上から落とし込むときは当たらない |

## 画角 (FOV 155° 対角) の扱い

**前面は完全開放**。155° の画角を蹴らずにレンズの前へ構造物を置くのは幾何学的に
不可能なので、「前は開ける・横と上下と下からの衝撃だけ受ける」という割り切りにした。

- **フード**: 側壁と床がレンズ面より 8mm 前へ出る。
  `8 × tan(77.5°) = 36.1mm < 対角基準 43.8mm` → **余裕 7.7mm** で画角を蹴らない (assert)
- **前方衝突**: 底デッキ前縁 (y=122) がカメラ (y=118) より 4mm 前に出て最初に当たる
- **画角に入らないことを assert で検査しているもの**: フード側壁 / フード床 /
  前抜け止めタブ / ライト (上端 z=78, 前端 y=118) / 前縁リム (z=46) / 底デッキ (z=30)

**VSLAM では自機の写り込みを必ずマスクすること。** 上記は「画角の外」を計算で
保証しているが、`cam_fov_h/v` は 155° 対角からの**推定値**なので実機で 1 枚撮って確認する。

## 干渉チェック (`.scad` 冒頭の assert — 実際に止まったもの)

1. **ポッド後壁がスキンに 0.05mm 食い込む** → `lens_y` を 106 → 110 に前進させた
2. **蓋ねじの外側端距離が 0.25mm 足りない** → 蓋を側壁より 1.5mm 広げた (`lid_ov`)

そのほか常時検査しているもの: 全幅 ≤250 / 前端 ≤125 / **ベッド 256 に入ること** /
フードの画角余裕 / ライト・リム・デッキが画角外 / 締結 M5 とピン穴の位置 /
左右ポッドが中央で衝突しないこと / ライト鞍座とポッドの干渉 (Z で逃げている) /
**フィン間隔 ≤40mm** (ポッド床をブリッジで架けられる上限) / 通水穴がフィン・レール・鞍座に
掛からないこと / 蓋ねじまわりの側壁残肉。

**カメラポッドの前面開放カットがフード側壁と抜け止めタブまで削っていた**のは
assert では捕まらず、モジュールの読み直しで見つけた。preview の目視は必須。

## 強度

| 項目 | 値 |
|---|---|
| カメラ+ポッドの片持ち (0.3kg × 3g = 9N、腕 100mm) | フィン 4 枚で受けて **0.005 MPa** |
| 底デッキ (バンパ) の局所曲げ | 衝撃は塑性変形で吸収する前提。**割れたら刷り直す消耗品** |

構造的な律速はここではなく、**大面積 (237mm) の反り**。ブリム必須。

## 印刷向き

- **このまま (Z が積層方向)。サポート不要。**
- 底デッキ (z 18..30) が約 200cm² のベッド接地面 → 反りに強い
- カメラクレードルは**開口が上**なので無サポート
- ポッド床はフィン間 (最大 34mm) のブリッジ
- **幅 237.4mm は X1-Carbon (256) にブリム 3mm 込みでぎりぎり。ベッド中央に置くこと**
  (`assert(2*half_w + 6 <= 256)` で検査している)

## 部品外の考慮

- **ライトのケーブル**: 下のキャップ → ガード後方 → 機体外周 → デッキの結束スロット
  (x=±60/±100, y=96) → ライト。**前半シェルを外すときに突っ張らないよう、
  サービスループを 150mm 以上取ること。**
- **バックスキャッタ**: ライトがレンズから 75mm しか離れていない。濁った水では
  後方散乱が出る。ライトは鞍座の 40mm 範囲で軸方向に下げられるので現場で調整する。
- **ライトの光がレンズに直接入らない**こと。ライト上端 z=78 はレンズ軸 115 より
  37mm 下、かつ前へ 8mm しか出ていないので直射は入らない。
- カメラの**背面スクリーンは装着状態では見えない** (ポッド後壁の Ø14 通水穴から
  一部のみ)。**前面スクリーンは前が開いているので見える** → 録画状態はこれで確認する。
- 電池・SD の交換は蓋を開けてカメラを外して行う。**入水前に充電・設定・時刻同期を済ませる**。
- 前半シェルを外すと**カメラ 2 台ごと外れる**。基線は変わらないが、
  **容器に対する相対位置は再現しない**ので、外部標定が要る用途では毎回較正する。

## 要確認

1. **レンズ軸の本体X中心からのずれ** → `lens_dx` (現在 0)。ずれると全幅が変わる
2. 水平/垂直の実画角 → `cam_fov_h=145` / `cam_fov_v=105` (155° 対角からの推定)
3. **ライトの選定** → `light_d = 40` は仮値。決まったら
   `child_light_clamp` と**両方**再ビルドする
4. レンズ前面が本体前面からどれだけ凹んでいるか (フード 8mm の余裕に効く。有利側)
5. PETG 237mm 幅の反り。1 枚目でだめならブリム幅を増やす / `base_line` を 120 に落とす

## parts/child/interior/printed/child_flange_brace/child_flange_brace.md

> 2026-10-04現行：小部品連結・フランジ梁・床板窓・ケース耳の改訂は [設計記録](../../../../../spec/child_interior_reinforcement/PRINT_STRENGTH_REVISION.md)。以下の旧版寸法・個数・配線記述より優先します。

> 現行：電池はM3ねじ＋普通ナット5個による締結、デッキ根元と前側ブレースを印刷補強。詳細は `spec/child_interior_reinforcement/BOLTED_MOUNT_REVISION.md`。以下の旧寸法・ねじ・PASS記述は履歴で、今回の強度保証には使わない。

> 現行: M3統一・サポート削減版。印刷姿勢・変更は spec/child_interior_reinforcement/M3_SUPPORT_REVISION.md。以下は旧版履歴を含みます。

> 2026-09-27現行: Bambu PLA Matte向け、60 mm根元・20 mm固定座・局所フランジ受け足、前側梁10 mm。印刷設定と解析の限界は spec/child_interior_reinforcement/PLA_MATTE_REVISION.md。以下の旧寸法・材料待ち記述は履歴です。

> 現行版: 印刷部品による閉じた耳・31 mm根元補強。追加の金属スリーブ・板は廃止。強度解析は材料／荷重条件待ち。詳しくは `spec/child_interior_reinforcement/PRINTED_REINFORCEMENT.md`。以下は過去の履歴を含む。

# child_flange_brace — LCD撤去後の下フランジ固定ブレース

現行再補強版：本体8 mm厚、前側フォーク12 mm厚、皿ねじなし。
左右はM3 MF30/MF12、M3×12なべ、5.7 mm鋼製スリーブと1 mm押さえ板を使用。
前側は12.2 mm鋼製スリーブと1.5 mm押さえ板、M3×18なべ。
各押さえ板と樹脂の隙間0.2 mm。以下の旧寸法は履歴。

2026-09-26。旧LCD支持アーチの下側を構造専用に置換した。
既存BR-101040下フランジ、200 mm縦置き内装をユーザー確認済み。

- C-MAINの下側2穴をM3 MF30 / MF17スペーサで共締め。
- ブレースのねじは従来どおりM3×10皿ねじ。
- フランジBCD94の90°穴へM3×12。座面Z27、ねじ込み4 mm。
- アーチ幅4.8→6.4 mm、固定耳ウェブ幅5.2→12 mm。
- 固定耳は接線方向に11.2 mmへ拡幅。チューブまで約1.1 mm。
- LCDヒンジとLCD固定用の下穴を撤去。

印刷はモデル上面Z5をベッドへ向けて裏返す。0.4 mmノズル、
外周5周以上、0.2 mm積層を目安にし、固定耳は密な充填にする。
形状補強であり、許容荷重を実験で保証したものではない。

## parts/child/interior/printed/child_rx_edge_clamp/child_rx_edge_clamp.md

> 2026-10-04現行：小部品連結・フランジ梁・床板窓・ケース耳の改訂は [設計記録](../../../../../spec/child_interior_reinforcement/PRINT_STRENGTH_REVISION.md)。以下の旧版寸法・個数・配線記述より優先します。

# child_rx_edge_clamp — RX基板のM3外周クランプ

2026-09-27、ユーザー承認の基板無加工方式。RXの既存Ø2.2穴は使用しない。左右2か所ずつ、計4組のベースと押さえ板を使う。

ベースM3×8はデッキ4 mmを通り樹脂へ4 mm、押さえM3×8は板2.6 mmを通り樹脂へ5.4 mmかかる。両ねじ軸をZ方向6 mmずらして先端同士の衝突を防ぐ。通し穴Ø3.4、樹脂下穴Ø2.5。露出するなべ頭はØ6.6の空間を確保する。

基板外縁X±34に対し外側柱は0.35 mm離す。押さえは外縁から2.2 mmだけ内側に掛かる。支持面Y-16、押さえ面Y-17.6。基板形状モデルとの体積干渉は検査するが、実物の外縁にある部品・銅箔・配線は仮組みでも確認する。基板がたわむほど締め込まない。

基準部品は右上。assemblyの鏡像で左右と下側を生成する。印刷一式には変換済みの別STLを含む。ベースはY=-10面を下、押さえ板はY=-20.6面を下にする。45°の受けでサポートを減らす。PLA Matte、0.2 mm、壁8周、100%インフィルを出発点とする。

## parts/child/interior/printed/child_spacer_set/child_spacer_set.md

# child_interior：六角・M3通し穴スペーサ4個セット

2026-10-21 通し穴改訂。正本は`child_spacer_set.scad`。配置・製造参照は
`spec/child_interior_reinforcement/sync_printed_spacers.py`で更新する。
ユーザー指定に従い、外側は二面幅5.5 mmの六角、穴はM3ねじが滑って通る
**内接径3.5 mmの12角補正穴**に変更。タップ加工は不要。

| 本体長さ | 個数 | 取付先 | 通しスタッド | 下端突出 | 上側固定 |
|---|---:|---|---|---:|---|
| 10 mm | 2 | 左右フランジ、Z19..29 | M3×26なべねじ | フランジへ4 mm | 12 mm座の上のねじ頭 |
| 12 mm | 1 | ブレース右、Y4.6..16.6 | 金属M3×30 | 6 mm | 5.5 mm座の上に普通M3ナット |
| 30 mm | 1 | ブレース左、Y4.6..34.6 | 金属M3×45 | 6 mm | 5.5 mm座の上に普通M3ナット |

**印刷は`child_spacer_set_set.stl`を1個だけ。** 左から10/10/12/30 mm。
個別body STLは組立モデル用。切離し用ランナーと幅0.8×厚さ0.4 mmのつなぎを維持する。
外形の6面は平面、縦の角はR0.2、上下端と穴入口は0.2 mm面取り。
穴の頂点径は約3.624 mm、内接径3.5 mm。M3呼び径に対して直径0.5 mmの余裕。
中央部の保守的な最小肉厚は約0.94 mm。面取り端の座面はさらに狭いため、締め潰さない。
12角穴の縦稜線は機能断面を維持し、ねじ山を利かせず使用する。

## 金属部品と組立

左右フランジは**首下26 mmのM3なべねじ2本**。12 mm座＋10 mm本体を貫通して
フランジに4 mm入る。必要なら既存M3×30を首下26 mmに切り、切断端を面取りする。
M3×25ではかかりが3 mmとなるため使用しない。M3×30をそのままねじ込まない。
ここは周囲のデッキに通常ソケットが当たるため、従来と同じなべ頭＋軸径4 mmドライバーを使う。

ブレースは金属M3×30／×45の全ねじスタッド各1本と普通M3ナット2個
（二面幅5.5／厚さ2.4 mm）。平先の全ねじ棒または頭なしねじを使用する。
スタッドの工具用穴／把持方法は実物に合わせ、スペーサの穴内でねじ止めしない。
以前の短いM3×8／×10スタッドと、左右M3×16・ブレースM3×12の上ねじ4本は使わない。

1. スペーサを冷却後にランナーから折り離し、つなぎ跡とバリを面一に除く。
2. M3ねじが全長を手で滑って通ることを確認する。実印刷の収縮は機種・材料に依存する。
   渋い場合は穴だけを3.5 mmドリルで軽くさらう。圧入・ねじ込みはしない。
3. 左右フランジはM3×26なべねじを12 mm座とスペーサへ通し、フランジに4 mm入れる。
   フランジの底付きと着座を確認する。
4. ブレース用スタッドの下端はMAIN基板1.6 mm＋デッキ4.4 mmの計6 mm入れる。
   スペーサと5.5 mm取付座を通し、上側から普通M3ナットを締める。
   座面が接したところで止める。緩み・樹脂の潰れは実物確認。

ナット外側への公称ねじ突出はブレース右4.1 mm、左1.1 mm。
相対する2本のねじを穴内で突き合わせる構成は廃止。ブレース右は長めの先端を指や配線へ当てない。
ブレースの工具検査は外径8 mm／内径6.6 mm／長さ50 mmのソケット包絡。
左右フランジを含むなべねじには軸径4 mm／長さ50 mmドライバー包絡。
チューブを外して締める。ソケット実物とナットの回転・保持は仮組みで確認する。

## 印刷

PETG、0.4 mmノズル、積層0.20 mm、壁4周以上、100%充填を推奨。
軸をZに立て、Z0をベッドへ置く。つなぎは2層、ランナーは幅2×厚0.6 mm。
本体の根元を支えてランナーを曲げて折る。長い本体の先端を持ってねじらず、
折れにくければニッパーでつなぎのみ切る。破断用のつなぎの縁は面取りの例外。
スライサのオブジェクト分割は使わない。支持が必要な閉じた屋根や水平穴は設けていない。

## 検証と履歴

今回の幾何・穴ゲージ・干渉・ソケット通路の結果は
`assemblies/child_interior/_work/analysis/printed_spacers_clearance/`。
スライスのSHA-256・プリセット・G-code・3MFは
`assemblies/child_interior/print_jobs/child_spacer_set/`。
確認画像は本部品の`_work/images/`。STLから検証付きで作成するSTEPはファセット形状で、設計履歴ではない。

旧Ø2.5タップ式の設計説明は上記解析フォルダの`previous_tapped_design.md`、
旧スライス一式は`print_jobs/child_spacer_set_tapped_20261021/`に保持した。
旧方式の検証結果を今回へ流用しない。

実物の滑り、折り取りやすさ、締付けトルク、クリープ・締結強度は未検証の取合い試作。
幾何検査や追加サポート0というスライス結果は、実印刷成功や強度の保証ではない。

### 通し穴改訂の確認結果

- 3寸法と連結セットは閉メッシュ・各1連結成分。セット36.29×8.75×30 mm、約1052 mm³。
  中央断面の穴内接径は約3.500 mm。直径3.0／3.5 mmの全長ゲージと重なりなし。
- 六角本体は旧購入品六角胴の外形内。取付済み本体・ねじ・ナットの未解決干渉0。
  ブレースの外径8 mmソケット2経路、なべねじの軸径4 mm工具23本分で未解決干渉0。
  左右フランジの通常ソケットはデッキへ当たるため不採用とし、M3×26なべで固定する。
- X1C／Bambu PETG Basic／0.20 mm／壁4周／100%で20分24秒、1.27 gの見積り。
  サポートnormal(auto)、閾値45°、全面自動検出有効でサポート材押出0。
  最初の2層に4本すべてのつなぎ経路が残ることをG-codeと経路画像で確認。
- 基板取付穴の照合・内装包絡検査に合格。実印刷の滑り・強度は未検証。

管理ツール42テスト中41成功、1件は対象外の旧クランプ材料JSON欠落による既存エラー。全体印刷一式検査にも対象外の親機構成の未同期が残る。詳細は今回の_work/logs/spacer_clearance_*。

## parts/child/interior/printed/child_vtray_batt_box/child_vtray_batt_box.md

> 2026-10-04現行：小部品連結・フランジ梁・床板窓・ケース耳の改訂は [設計記録](../../../../../spec/child_interior_reinforcement/PRINT_STRENGTH_REVISION.md)。以下の旧版寸法・個数・配線記述より優先します。

2026-10-07確認：普通M3ナット5個は横差しポケット。熱圧入・造形途中の埋込みは不要。ケース4個は左右外側から、床板用1個は右外側から挿入する。CADの樹脂重なり・挿入経路・床板着脱は122検査で干渉なし。ケースねじ先端の公称突出0.1 mmは実物で確認。詳細は spec/child_interior_reinforcement/FASTENER_ASSEMBLY.md。

> 現行：電池はM3ねじ＋普通ナット5個による締結、デッキ根元と前側ブレースを印刷補強。詳細は `spec/child_interior_reinforcement/BOLTED_MOUNT_REVISION.md`。以下の旧寸法・ねじ・PASS記述は履歴で、今回の強度保証には使わない。

> 現行: M3統一・サポート削減版。印刷姿勢・変更は spec/child_interior_reinforcement/M3_SUPPORT_REVISION.md。以下は旧版履歴を含みます。

> 2026-09-27現行版：下リブ廃止、WetLink M10×5実配置、電池サービスねじをZ36へ移動。手順と検証は `spec/child_interior_reinforcement/SERVICE_REVISION.md`。以下は旧版の履歴を含みます。

# child_vtray_batt_box — 子機 縦置き内装 LiPo ベイ (∩ チャンネル、2026-09-03 作り直し)

| 項目 | 値 |
|---|---|
| 区分 | 子機 / 内装 / 3Dプリント |
| 設計ソース | `child_vtray_batt_box.scad` |
| 個数 | 1 |
| 外形 | **54.0 × 33.0 × 119.5 mm** (耳込み。箱本体幅 46、世界 z 14..133.5) |
| 体積 | **30.0 cm³** (PLA 約 37 g) |
| STEP | 1 ソリッド (cube / cylinder のみ。STL と体積一致 0.0 %) |
| 相手部品 | [`child_vtray_batt_floor`](../child_vtray_batt_floor/child_vtray_batt_floor.md) (着脱床板) |

## 役割

`child_vtray_deck` の**下面**にボルト留めして、
[`lipo_35x26x110`](../../cots/lipo_35x26x110/lipo_35x26x110.md) (35 × 26 × 110、
ユーザー指定 2026-09-03) を抱える ∩ チャンネル。上 (+Y) はデッキ板、下 (−Y) は
**着脱床板** `child_vtray_batt_floor` が塞ぐ。**皿ねじ 1 本で床板が外れ、電池だけを
−Y へ取り出せる** (箱・MAIN・RX はそのまま)。

旧設計 (Zeee 102 × 34 × 23、+Z ゲートで軸方向に抜く) からの変更点:

| 項目 | 旧 | 新 | 理由 |
|---|---|---|---|
| 電池の向き | リード +Z (上) 出し | **リード −Z (下) 出し** | リードは電池上面の 35mm 辺の両端から出る。+Z 側は RX 基板 (z=134) まで 4mm しか無く曲げられない |
| −Z 端 | 固定端壁 z 20..23 | **固定端壁 z 14..20** (幅広部の外、貫通口 Ø88.5 の中)。外形を r=43.5 の円で切る | 電池 110 + 端部 2 で軸長 112 が要る。6t にして床板の皿ねじ下穴 (Ø2.5) を受ける |
| −Z 端壁 | 全面 | **中央の柱 (x ±10.5) だけ**。両端は床板上面〜電池上面 (y −40..−14) を外壁まで抜く**リード切欠き** | 両リードが端壁の中で ±X に曲がって出る (下ポケットに落とさない) |
| +Z 端 | ゲート板 (M3×2) | **床から立つリップ** 1.5t × 10 (y −43..−33、z 132..133.5) + 両端に床板フックのスロット | RX まで 0.5mm。リップ上面は RX 部品の Y 帯 (≥ −31.4) に入らない |
| 床 | 一体 | **別部品 (着脱)** | 電池を頻繁に出し入れする |
| 内幅 | 37 | **40** (側面フォーム 2t ×2) | 床板のフック (x 18.4..19.7) を電池 (半幅 ≤ 18) の外に置く |
| 床角 | 角 | 壁の外側下角 45° 面取り 3 | 電池が厚くなった分の径方向余裕 |
| 取付耳 | 3t、下面 45° 楔 | **4t 角形** | 立てずに耳の面を下にして印刷するので楔不要 |

## 主要寸法

| 変数 | 値 | 意味 |
|---|---|---|
| `lipo_w / lipo_h / lipo_l` | 35 / 26 / 110 | LiPo 外形 (ユーザー指定。**実測で確定**) |
| `lipo_tol` | 1 | ばらつき見込み (フォームの圧縮で吸収) |
| `pad_t / fit_clear / end_slack` | 3 / 4 / 2 | 上面フォーム 3t / 側面フォーム 2t ×2 / 端面フォーム 1t ×2 |
| 導出: 内寸 | **40 × 30 × 112** | W × H × (端壁上面〜リップ) |
| `wall_t / floor_t / end_t` | 3 / 3 / 6 | 側壁 / 床板厚 (壁がこの分下へ伸びる) / −Z 端壁 |
| `slot_x0` | 10.5 | リード切欠きの内側 X (±)。外側は外壁 (23) まで貫通 |
| `lip_t / lip_h` | 1.5 / 7 | +Z リップ (床板上面から 7、床板厚を含めて 10) |
| `hook_w / hook_h / hook_clear` | 1.3 / 3 / 0.3 | 床板フックのスロット (x 18.1..20、y −40.8..−37.2) |
| `floor_pilot_d / floor_pilot_l` | 2.5 / 6 | 床板の皿ねじ下穴 (柱の下面 y −40 から +Y、x 0 / z 17) |
| `ear_x / ear_t / ear_hx / ear_hz` | 27 / 4 / ±24 / [12, 90] | 取付耳 (ねじ穴は世界 z 32 / 110) |
| `r_end` (導出) | 43.5 | 端壁外形の円半径 = (88.5 − 1)/2 − 0.25 |

座標は `child_vtray_deck` と同じ。原点は箱の Z 始点 (= 幅広部下端 z=20)・軸心。
アセンブリでは `translate([0,0,20])` → **世界 z 14..133.5**。

## インタフェース

| 相手 | 締結 / 取合い |
|---|---|
| `child_vtray_deck` | デッキ上から M3×8 ×4 → 耳の Ø2.8 セルフタップ (X ±24, 世界 Z 32 / 110)。デッキ 4 + 耳 4 でねじ先端が耳下面と面一 |
| `child_vtray_batt_floor` | 床板は壁の間 (x ±19.7) に入り、+Z 端のフック 2 個がリップのスロットへ (2mm)、−Z 端のタブが柱の下 (z 14..20) で **M3×8 皿ねじ 1 本** |
| `lipo_35x26x110` | 嵌合のみ。床板に載り、−Z は端壁の柱、+Z はリップ、上はデッキ (フォーム 3t) |
| `foam_pad` `clipo_top / clipo_side ×2 / clipo_end ×2` | 上 3t (106×33) / 側 2t (106×24) / 端 1t (20×24、柱の範囲) |
| RX 基板 (デッキ下面 z ≥ 134) | 箱上端 133.5 → すきま 0.5 |
| 下フランジ貫通口 Ø88.5 | 端壁 (z 14..19 が貫通口の中) は r 43.5 |
| ハーネス | 電源リードは +X の切欠きから +X レールの XT30 ペア (z 25..55) へ、充電リードは −X の切欠きから下リブの結束スロットへ (`parts/common/cabling/child_harness`) |

**`child_vtray_deck.scad` の `box_hx` / `box_hz` / `box_len` (113.5) / `box_below` (6) / `deck_y0`、
`child_vtray_batt_floor.scad` の `cav_x` (20) / `floor_y1` / `floor_t` / `cav_l` / `lip_t` / `end_t` / `slot_x0` / `hook_w`
と同じ値をこのファイルにも書いている。片方だけ直さないこと。**

## 干渉チェック (`.scad` の assert)

- 面取り後の壁の角 2 点がチューブ内壁 (r 48.3) の内側 → 最小すきま **3.4mm**
- 内寸が LiPo の最大寸法以上 / 端壁が下リブ帯 (z 9) に入らない / 柱が円で細くならない / 耳の帯まで円の内側
- リード切欠きが電池の縁を覆わない / 皿ねじ下穴の周りに 1.75mm 以上の肉
- 箱上端 + 0.5 ≤ RX 基板 z 134 / リップ上面 ≤ RX 部品 Y 帯 − 1
- フックスロットの下の肉 ≥ 2.0 (片持ち 1.7 で 25 N に耐える最小) / フックが電池 (半幅 18) の外
- 耳のねじ穴が耳の中 (縁 0.6 以上)

## 荷重ケースと強度

| ケース | 荷重 | 受ける部位 | 結果 (`quick_strength.py`, PLA) |
|---|---|---|---|
| 電池自重 (約 250 g 想定、型番未確定) × 落下係数 10 | 25 N (−Z) | −Z 端壁の柱 21 × 6t、スパン 26 | **PASS** (余裕大) |
| 径方向の衝撃 (−Y、床板が押される) | 25 N → フック 2 個 + 皿ねじで分担 | リップのフック下の肉 (片持ち 1.7、断面 1.5 × 2.2)、分布荷重 12.5 N | σ ≈ 11 MPa (面内、許容 23) **PASS** |
| 径方向の慣性 | 25 N / 4 本 | 耳の M3 セルフタップ 4mm | **PASS** |

## 印刷向き・条件

**耳の面 (y = −10) を下にして印刷** (足場 54 × 119.5、高さ 33)。壁・端壁・柱・耳は垂直、
リップ (40 幅 × 1.5t) だけが壁間をブリッジする。サポート無し・PLA・0.2mm 層・壁 4 本・
インフィル 25〜30 % Gyroid。皿ねじ下穴 (Ø2.5、深さ 6) は水平の穴になるので、必要なら Ø2.5 で
さらってからねじ込む。

## 部品外の考慮

- **電池の出し入れ** (内装をチューブから抜いた状態): XT30 を抜く → 床板の皿ねじ (−Z 端、y −42 面) を
  外す → 床板を −Z へ 2mm ずらしてフックを外し −Y へ抜く → 電池を −Y へ引き出す。
  入れるときは電池を箱へ押し込み (側面フォームで仮保持)、床板を −Z に 2mm ずらした位置で
  当てて +Z へ押し、皿ねじ。**MAIN も箱も外さない。**
- **リードの経路**: 電池の −Z 端面 (z 21) から両リードが −Z へ出て、端壁の切欠き (z 14..20) の中で
  ±X に曲がる。電源リード (+X) は +X レールの XT30 ペア (z 25..55) へ (切って 60〜70mm に詰め、
  XT30 メスを付ける)。充電リード (−X、約 50mm) は下リブの結束スロット (−26, −19) へ。
  詳細は `parts/common/cabling/child_harness`。
- **充電は内装をチューブから抜いて**充電リードで行うか、電池を取り出して行う。容器内では充電しない。
- LiPo は膨らむ。上面フォーム 3t を必ず入れる。
- 床板の窓は軽量化と目視点検用。

## 要確認

1. 電池の型番・容量・質量・実測外形 (35 × 26 × 110 はユーザー指定値)
2. リード出口の正確な位置 (35mm 辺の端から何 mm か) と線径 → `slot_x0` の確定
3. 充電リードのコネクタ種別と寸法
4. フックとスロットの嵌合 (片側 0.3) は印刷後に現物合わせ

## 履歴

- 2026-08-03: ゲートを box_len の内側へ / 2026-08-28: フランジアンカーをデッキへ移設
- 2026-09-03 (1): 電池 35 × 26 × 110・リード −Z 出しに合わせて作り直し (+Z リップ、端壁 z 16..20)
- 2026-09-03 (2): 電池だけを取り出せるよう ∩ + 着脱床板に変更。内幅 40、端壁 6t、耳の面を下にして印刷。
  旧 `child_vtray_batt_gate` は廃止 (フォルダは履歴として残置)

## parts/child/interior/printed/child_vtray_batt_floor/child_vtray_batt_floor.md

> 2026-10-04現行：小部品連結・フランジ梁・床板窓・ケース耳の改訂は [設計記録](../../../../../spec/child_interior_reinforcement/PRINT_STRENGTH_REVISION.md)。以下の旧版寸法・個数・配線記述より優先します。

> 現行：電池はM3ねじ＋普通ナット5個による締結、デッキ根元と前側ブレースを印刷補強。詳細は `spec/child_interior_reinforcement/BOLTED_MOUNT_REVISION.md`。以下の旧寸法・ねじ・PASS記述は履歴で、今回の強度保証には使わない。

> 現行: M3統一・サポート削減版。印刷姿勢・変更は spec/child_interior_reinforcement/M3_SUPPORT_REVISION.md。以下は旧版履歴を含みます。

> 2026-09-27現行版：下リブ廃止、WetLink M10×5実配置、電池サービスねじをZ36へ移動。手順と検証は `spec/child_interior_reinforcement/SERVICE_REVISION.md`。以下は旧版の履歴を含みます。

# child_vtray_batt_floor — 子機 縦置き内装 LiPo ベイの着脱床板

| 項目 | 値 |
|---|---|
| 区分 | 子機 / 内装 / 3Dプリント |
| 設計ソース | `child_vtray_batt_floor.scad` |
| 個数 | 1 |
| 外形 | **39.4 × 5.0 × 119.5 mm** (板 39.4 × 3 × 111.5 + −Z タブ + フック) |
| 体積 | **10.3 cm³** (PLA 約 13 g) |
| STEP | 1 ソリッド (cube / cylinder のみ) |
| 相手部品 | [`child_vtray_batt_box`](../child_vtray_batt_box/child_vtray_batt_box.md) |

## 役割

∩ チャンネルの電池箱の底を塞ぐ板。**皿ねじ 1 本**で着脱でき、外すと電池が −Y へ出る。

| 端 | 保持 |
|---|---|
| +Z | 板の両縁のフック (1.3 × 3 × 2mm 突出、x 18.4..19.7 / y −40.5..−37.5) がリップのスロットに入り、−Y への抜けを止める |
| −Z | 板を端壁の下 (z 14..20) まで延ばしたタブ (x ±7、3t) に **M3×8 皿ねじ**。端壁の柱の下穴 (Ø2.5、深さ 6) へ +Y に締める |

着脱: 皿ねじを外す → 板を −Z へ 2mm ずらしてフックを外す → −Y へ抜く。
取付は逆: 電池を箱へ入れて押さえ、板を −Z に 2mm ずらした位置で −Y から当て、+Z へ 2mm 押して
フックを入れ、皿ねじ。

## 主要寸法

| 変数 | 値 | 意味 |
|---|---|---|
| `cav_x / floor_y1 / floor_t` | 20 / −40 / 3 | 箱の内幅の半分 / 板の上面 / 板厚 (箱と共通) |
| `side_clear / end_clear` | 0.3 / 0.5 | 壁との片側すきま / +Z 端とリップのすきま |
| 導出: 板 | **39.4 × 3 × 111.5** | x ±19.7、y −43..−40、z 20..131.5 (世界) |
| `hook_w / hook_h / hook_l / hook_base` | 1.3 / 3 / 2 / 4 | フック (厚み / 高さ / スロットへの突出 / 板上の根元) |
| `tab_x / tab_t / screw_z` | 7 / 3 / −3 | −Z タブ (半幅 / 厚み / ねじの Z = 世界 17) |
| `screw_d / csk_d` | 3.4 / 5.8 | M3 バカ穴 / 90° 皿座ぐり (JIS M3 頭 5.5) |
| `win_z / win_l / win_w` | [34, 78] / 26 / 20 | 軽量化・確認窓 |

タブの半幅を 7 に絞ってあるのは、タブが下フランジ貫通口 (r 43.75) の中 (z 14..19) にあるため
(rad(7, −43) = 43.6)。板と面一 (3t) なので寝かせて印刷してもサポート不要。皿頭 (1.25) は板に沈む。

## インタフェース

| 相手 | 取合い |
|---|---|
| `child_vtray_batt_box` | 壁の間 x ±19.7 / リップのスロット (x 18.1..20、y −40.8..−37.2) / 柱の下穴 (x 0、z 17) |
| `lipo_35x26x110` | 電池 (x ±17.5、公差 +0.5) が板に載る。フックは電池の外 (x ≥ 18.4) |
| `screw_m3x8_flat` | 皿ねじ。頭は y −43 面に面一 → 貫通口の中で r 43.1 |

**`child_vtray_batt_box.scad` の `cav_x` / `floor_y1` / `floor_t` / `cav_l` / `lip_t` / `end_t` / `slot_x0` / `hook_w` / `hook_h`
と同じ値を書いている。片方だけ直さないこと。**

## 干渉チェック (`.scad` の assert)

- タブが柱 (x ±10.5) より狭い / 皿座ぐりがタブの縁・厚みを抜かない / タブが貫通口 r 43.75 の中 (rad(7, −43) = 43.6)
- フックがリップを突き抜けない (hook_l ≤ lip_t + 0.5) / 窓が板の端にかからない

## 荷重ケースと強度

| ケース | 荷重 | 部位 | 結果 |
|---|---|---|---|
| 径方向の衝撃 (−Y) 25 N (電池 250 g × 10) | 単純支持 (両端) スパン 111.5、板 39.4 × 3 | 手計算: σ ≈ 6 MPa、中央たわみ ≈ 1.4 mm (フォームが吸収) | PASS |
| 同 | フック 1 個 12.5 N、断面 1.3 × 3 (せん断) | ≈ 3 MPa | PASS |
| 同 | 皿ねじ M3、柱への食い込み 5mm | `quick_strength.py boss` PASS | PASS |

## 印刷向き・条件

**板を寝かせ、フックとタブを上**にして印刷。サポート不要。PLA・0.2mm 層・壁 3 本・インフィル 30 %。
皿座ぐりは下面側 (ベッド側) に来るので、ベッドの初層が座ぐりのエッジを潰さないようブリム無しで印刷する。

## 部品外の考慮

- 皿ねじは −Z 端の y −43 面 (電池箱の下、下リブの 8mm 上) にあり、内装をチューブから抜けば
  −Y 側からドライバが届く。下キャップ側のハーネス (リブの開口 x ±20) が上を通るので、
  結束は皿ねじの真上を避ける。
- フックのスロット嵌合 (片側 0.3) は印刷後に現物合わせ。きつければフックを削る。

## 要確認

1. フック / タブの嵌合クリアランス (印刷後)
2. 電池の実寸 (幅 35 + 公差) とフック (x ≥ 18.4) の干渉

## parts/child/interior/printed/child_vtray_deck/child_vtray_deck.md

> 2026-10-06：200 mm版にレール固定ねじ用φ4.6工具通路を追加。ねじ座は維持。[締結手順](../../../../../spec/child_interior_reinforcement/FASTENER_ASSEMBLY.md)。

> 現行：電池はM3ねじ＋普通ナット5個による締結、デッキ根元と前側ブレースを印刷補強。詳細は `spec/child_interior_reinforcement/BOLTED_MOUNT_REVISION.md`。以下の旧寸法・ねじ・PASS記述は履歴で、今回の強度保証には使わない。

> 現行: M3統一・サポート削減版。印刷姿勢・変更は spec/child_interior_reinforcement/M3_SUPPORT_REVISION.md。以下は旧版履歴を含みます。

> 2026-09-27現行: Bambu PLA Matte向け、60 mm根元・20 mm固定座・局所フランジ受け足、前側梁10 mm。印刷設定と解析の限界は spec/child_interior_reinforcement/PLA_MATTE_REVISION.md。以下の旧寸法・材料待ち記述は履歴です。

> 現行版: 印刷部品による閉じた耳・31 mm根元補強。追加の金属スリーブ・板は廃止。強度解析は材料／荷重条件待ち。詳しくは `spec/child_interior_reinforcement/PRINTED_REINFORCEMENT.md`。以下は過去の履歴を含む。

# child_vtray_deck — 子機 縦置き内装スレッドの背骨

現行再補強版：左右フォーク12 mm厚、根元幅8.7 mm・接続長21 mm。
C-MAINボス9 mm。金属スリーブ／押さえ板を使って樹脂への締め付けを逃がす。
以下の旧ラグ寸法を現行版へ適用しないこと。

2026-09-26：左右フランジ固定ラグを接線方向11.4 mmへ拡幅し、
Z20..29に斜め根元リブを追加。半径方向は基板とチューブの制約があり、
最小肉厚約0.8 mmを維持する。穴位置・ラグ厚5.5・MF10・M3×10は変更なし。
下記のラグ寸法は旧版の履歴。現行値はSCADと補強記録を参照。

| 項目 | 値 |
|---|---|
| 区分 | 子機 / 内装 / 3Dプリント |
| 設計ソース | `child_vtray_deck.scad` |
| 個数 | 1 |
| バリアント | `t200` (97 × 14 × 204 / 64.7 cm³ / 136面) / `t300` (97 × 14 × 304 / 101.9 cm³ / 136面) |
| 対象アセンブリ | `assemblies/child_vertical_assembly` (**縦置き構成 B 専用**) |

## 役割

WTE4 アクリルチューブ (ID 101.6) へ**立てたまま上から落とし込む**内装の背骨。
配置の根拠は `docs/子機内装_収まり検討.md`。

| 面 | 載るもの |
|---|---|
| 上面 下部 (z 20..124) | `CHILD_MAIN v4.1` 104 × 88 — M3 ボス ×4 (高さ7) |
| 上面 上部 (z 126..188) | `CHILD_PWR v2.1` 62 × 70 — M3 ボス ×4 (高さ10) |
| 下面 下部 (z 20..132) | `child_vtray_batt_box` を M3 ×4 でボルト留め (シェル 20..129 + ゲート 129..132) |
| 下面 上部 (z 134..180) | `RX_improved_mini` 68 × 46 を **90度回して吊る** — Ø2.4 貫通穴 + **M2 スペーサ 6mm (購入品)**。★実基板の穴は Ø2.2 = M2 で、M3 は通らない |
| 左右 | ケーブル通路 (デッキのスリット 14 × 26 ×3箇所で上下面をつなぐ) |
| 下面 左右 | `child_vtray_cable_rail` ×2 を M3 ×4 (X = ±30.3 / ±41.7、Z = 37 / 77) |

**RX をデッキ下面へ移したのが `CHILD_PWR` の面積を稼ぐ肝。**
3 枚とも上面に並べると PWR の軸長が 18mm しか残らない
([収まり検討](../../../../../docs/子機内装_収まり検討.md) §4)。

## 軸方向の位置決め — ねじを使わない

デッキ中央部の幅 **93mm はフランジ貫通口 Ø88.5 を通らない**。
これを利用して、**上下フランジのピストン内端面 (z = 19 / tube_len − 19) に
突き当てて軸方向を止めている**。両端の幅 76mm の細い部分だけが貫通口へ入る。

→ 追加の固定具は不要。内装は上フランジを抜いて上から落とし込むだけ。

## 主要寸法

| 変数 | 値 | 意味 |
|---|---|---|
| `tube_id` | 101.6 | アクリル内径 (実測) |
| `tube_len` | 200 / 300 | バリアントで切替 |
| `wall_clear` | 2.5 | アクリル内壁と内装・部品の最小すきま |
| `deck_w / deck_wn / sh_w` | 93 / 76 / 84 | 中央部 / 端部 / リブ位置決めショルダー の幅 |
| `deck_t / deck_y0` | 4 / −10 | 板厚 / 下面 Y |
| `main_boss_h` | 7 | MAIN の裏面リード 4.75 の逃げ |
| `pwr_boss_h` | 10 | PWR の裏面リード 8.15 の逃げ |
| `rx_stand` | 6 | RX を吊る **M2** スペーサ (購入品) の長さ |
| `pwr_l` | 56 (t200) / 100.4 (t300) | **CHILD_PWR の軸長予算** |
| `pwr_tip_h` | 21.0 | 貫通口へ出る先端 10mm の高さ上限 |
| `pad_x / pad_len` | 48.5 / 12 | 振れ止めパッド (3箇所) |
| `cable_x / cable_w / cable_l` | 36 / 14 / 26 | 配線スリット (Z = 58 / 96 / 157) |
| `rail_x / rail_hx / rail_hz` | 36 / 5.7 / [37, 77] | ケーブルレール取付 Ø3.4 |

座標は **X = 幅 / Y = 積み方向 / Z = チューブ軸 (Z=0 はアクリル下端面)**。
アセンブリでの変換が不要になるよう、最初からチューブ座標で書いてある。

## インタフェース

| 相手 | 締結 | 共有している値 |
|---|---|---|
| `child_vtray_batt_box` | デッキ上から M3 ×4 (X = ±24, Z = box_z0 + 12 / 90) | `box_hx` / `box_hz` / `box_len` / `deck_y0` |
| `child_vtray_rib` ×2 | 先端から差し込み → 内側ショルダー (幅 84) 1 本に当てる。先端側は板を貫く M2.5×6 なべ (下穴 Ø2.0、`stop_z`) で抜け止め。2026-09-03 に先端側ショルダーを廃止 (スロット 76.4 を越えられず嵌まらなかった) | `deck_wn` / `deck_t` / `deck_y0` / `rib_thk` |
| `child_main` | M3 セルフタップ ×4 | 取付穴ピッチ 95 × 61.5 |
| `rx_improved_mini` | **M2 スペーサ 6mm ×4** (デッキ下面へ吊る) | 取付穴ピッチ 63 × 41 |
| `child_vtray_cable_rail` ×2 | デッキ上から M3 ×4 → レール側壁へセルフタップ | `rail_x` ↔ `mount_x` / `rail_hz` ↔ `mount_y + 20` |
| `child_pwr` (t200) | M3 セルフタップ ×4 | 取付穴ピッチ **54 × 62** |

**`child_vtray_batt_box.scad` と `child_vtray_rib.scad` に同じ値を書いている
箇所がある** (`deck_y0` / `deck_t` / `deck_wn` / `ear_hx` ↔ `box_hx`)。
片方だけ直さないこと。

## 干渉チェック (`.scad` の assert)

- 断面のすべての角の**軸心距離**をチューブ内壁と比較 (デッキ隅・MAIN の高背/低背
  ゾーン・裏面リード・RX・ボス・振れ止めパッド)
- 端部とショルダーが**貫通口 Ø88.5 を通る**こと / 中央部が**通らない**こと
  (通ってしまうと軸方向ストッパにならない)
- ボス高さが各基板の裏面リード突出より大きいこと
- 軸方向に基板同士が重ならないこと、幅広部からはみ出さないこと
- **配線スリットがボスの足元を抜いていないこと** ← これを外すと
  ボスがデッキから切り離されて別ソリッドになる。**実際に起きた**ので assert を追加した
- `CHILD_PWR` が上リブ帯に食い込まないこと。**assert のメッセージが
  「軸長は最大 ○○mm」を直接教えてくれる** (t200 で 57mm)
- `CHILD_PWR` の先端が貫通口へ出るなら、その部分が Ø87.5 に収まる高さであること
- `RX` (デッキ下面) が幅広部を超えないこと (下面の RX は断面が大きく貫通口へ出せない)

ビルド後は `_preview.png` の front / top でボスとスリットが離れているか目視すること。

### 最小すきま (t200 / t300 とも同じ)

| 箇所 | アクリル内壁まで |
|---|---|
| `CHILD_MAIN` 高背ゾーン (DS3231) | **3.8 mm** |
| `CHILD_PWR` 高背部 (予算いっぱい) | 5.3 mm |
| `RX` (デッキ下面) の部品先端 | 4.5 mm |
| デッキ中央部の隅 | 3.2 mm |
| 振れ止めパッド | 1.5 mm (意図的) |

## 印刷向き

**デッキ板をベッドに寝かせ、ボス側を上。サポート不要。**
t200 で 204mm、t300 で 304mm と長いので**ブリム必須・ベッド中央**。
反りやすいので大面積の 1 層目に注意すること。

全てのスタンドオフは Ø8 の円筒ボスで、デッキ上面から立ち上がるだけ。
RX 用は貫通穴なので下向きの張り出しは無い → 片面だけに構造がある形になり、
寝かせて印刷できる。

## 部品外の考慮

- **内部にアクセスするには上フランジを抜く必要がある。** 幅 93mm の中央部は
  貫通口を通らないため。ドームの M3 を外すだけでは基板に手が届かない。
  ロッキングコードを抜く工具スペースを実物で確認すること。
- **ケーブルは全部 下キャップから**来る。下リブの大開口 → デッキ左右の
  配線スリット → 基板側。リブの結束スロットでストレインリリーフを取る。
- **LiPo のリードは +Z (上) 向き**。`CHILD_MAIN` の `J_PWR1` は基板下端 (z≈21) に
  あるので **110mm 以上の余長**が要る。足りなければ LiPo を逆向きに入れる。
- **上面の基板は真上 (+Y) から、RX は真下 (−Y) からねじが入る。**
  MAIN の上に棚を張り出さないので、どの基板も工具が入る。
- 組立順は **箱 → RX (スペーサ) → デッキ上面の基板 → LCD支持アーチ**。
  箱の取付ねじ頭は `CHILD_MAIN` の下に隠れるが、通常の電池交換は＋Zゲートだけを
  外すのでMAINを外す必要はない。
- RX と MAIN をつなぐ 6 芯 (`J_RX1` ↔ RX `J2`) は**デッキを貫通する**。
  配線スリット (X = ±36, Z = 159) を通すこと。
- デッキは中央 149mm が無支持。LiPo 箱 (深さ 31mm の U 溝) が梁として効いている。
  箱を外した状態で長時間立てて置かないこと。

## 要確認

1. LiPo の実測 (102 × 34 × 23 ±2) → `child_vtray_batt_box` のベイ内寸
2. 下フランジM3 BCD94の穴位相・タップ深さと10mmスペーサの現物確認
3. 上フランジを抜く運用の工具アクセス
4. 印刷後の反り。204mm の細長い板なので、実物で真直度を確認すること

## 2026-08-28 固定: 下フランジ固定ラグを追加

`child_vtray_batt_box` の二股アンカーはデッキ板とケーブルレールを貫通していた (`check_asm_contacts.py` で
2.7 mm) ので、アンカーを**デッキ側のラグ**へ移した。デッキ上面 (y=-6) から x 44.8..48.5 に張り出し、
BCD94 (±47, 0) に Ø3.4 の穴、z 29..34.5 (厚 5.5)。下フランジ内面 (z=19) に立てた M3 MF10 スペーサの
上端 (z=29) に直接載せ、M3×10 なべで締める (シム・ワッシャ無し: Ø7 ワッシャは MAIN 基板端 44 に当たる)。
assert: チューブまで ≥1 mm、MAIN 基板端まで ≥0.5、幅広部内、MAIN/PWR ボスと不干渉。
変数: `flange_bcd` / `anchor_spacer` / `anchor_t` / `anchor_od` / `anchor_x_in` / `anchor_x_out` / `main_edge_x`。

## 2026-09-03: 下フランジ固定は 3 点 (このラグ 0°/180° + 下 LCD アーチの耳 90°)

フランジ BR-101040 内面の 4× M3 BCD94 のうち、90° (0, +47) はデッキから届かない (C-MAIN が間にあり、
r=47 の弧は DS3231 スタック (42, 21.1) に当たる) ので `child_lcd_support_lower` の耳が受け持つ。
270° (0, −47) は電池箱の床 (y −43) が塞ぐため未使用。詳細は `assemblies/child_interior/child_interior.md`。
`flange_bcd` / `flange_ins` は `child_lcd_support.scad` の `flange_bcd` / `flange_face_z` と二重定義。

## parts/child/interior/printed/child_vtray_rib/child_vtray_rib.md

> 現行: M3統一・サポート削減版。印刷姿勢・変更は spec/child_interior_reinforcement/M3_SUPPORT_REVISION.md。以下は旧版履歴を含みます。

# child_vtray_rib — 子機 縦置き内装 センタリング バルクヘッド

| 項目 | 値 |
|---|---|
| 区分 | 子機 / 内装 / 3Dプリント |
| 設計ソース | `child_vtray_rib.scad` |
| 個数 | **2** (上下フランジの貫通口内に 1 枚ずつ) |
| 外形 | Ø87.5 × t6 |
| 体積 | 26.5 cm³ |
| STEP | 1 ソリッド / 21 面 |

## 役割

`child_vtray_deck` の**両端 (幅 76mm の細い部分)** に挿して、内装を
フランジ貫通口 (Ø88.5) の中心に保持する。上下 2 枚で内装の姿勢が決まる。

軸方向は、デッキ先端から差し込んで**内側ショルダー (幅 84mm) 1 本**に当て、先端側は
デッキ板を貫く **M2.5×6 なべ (頭 Ø4.5、板上面に座る)** で抜け止めする。
**2026-09-03 変更**: 以前は先端側にもショルダーがあり、リブのスロット (76.4) が
幅 84 のショルダーを越えられず物理的に嵌められなかった (人間指摘)。先端側ショルダーを
廃止し、止めねじに置き換えた。組立: リブをデッキ先端に通す → ショルダーまで押し込む →
M2.5 を板上面から締める (先端が板下面に 2mm 出てリブを止める)。
挿入経路の掃引検査 (デッキ ∩ リブ掃引体積 = 空) は `assemblies/child_interior/views/rib_sweep.scad`。

中央下寄りは**ケーブル通路**として大きく開けてある。下キャップのペネトレータから
来るケーブルはすべてここを通る。

## 主要寸法

| 変数 | 値 | 意味 |
|---|---|---|
| `flange_bore / bore_clear` | 88.5 / 1.0 | 貫通口Ø (実測) / 径クリアランス → 外径 Ø87.5 |
| `rib_t` | 6 | 板厚 |
| `lead_chamfer` | 0.8 | 両面外周の挿入ガード面取り |
| `deck_wn / deck_t / deck_y0` | 76 / 4 / −10 | デッキ端部の断面 (deck と一致させること) |
| `slot_clear` | 0.4 | 嵌合クリアランス (片側 0.2) → スロット 76.4 × 4.4 |
| `duct_w / duct_y0 / duct_y1` | 40 / −36 / −14 | ケーブル通路 (40 × 22) |
| `tie_x / tie_y / tie_w / tie_l` | ±26 / −19 / 3.5 / 10 | 結束バンド スロット |
| `side_d / side_x / side_y` | 14 / ±29 / 12 | 上側の補助通し穴 (基板側へ上げる線用) |

導出: スロット横に残る肉 **5.55mm** — ここでリブの上下がつながっている。

## インタフェース

| 相手 | 締結 |
|---|---|
| `child_vtray_deck` | 嵌合 + M2.5×6 止めねじ。内側ショルダーと止めねじ頭の間 (Z 方向 7mm) に収まる |
| アクリルチューブ / フランジ | Ø87.5 で貫通口 Ø88.5 に対し片側 0.5mm |

**`child_vtray_deck.scad` の `deck_wn` / `deck_t` / `deck_y0` と同じ値を
このファイルにも書いている。片方だけ直さないこと。**

## 干渉チェック (`.scad` の assert)

- 嵌合スロットの角が円板の縁からはみ出さないこと
  (はみ出すとリブが 2 枚に割れる)
- スロット横に残る肉が `min_web` 以上 ← **最初 `deck_wn = 82` で 2.55mm しか
  残らず assert が止まった**。デッキ端部を 76 に細くして 5.55mm を確保した
- ケーブル通路・結束スロット・補助通し穴が円板の中に収まること
- 各開口が嵌合スロットに食い込まないこと

## 印刷向き

**円板を寝かせて (Z を上に) 印刷。** 全フィーチャが貫通なのでサポート不要。
外周両面の0.8mm面取りが、フランジ穴とアクリル内壁への引っ掛かりを防ぐ。

## 部品外の考慮

- **下側のリブがケーブルの要**。テザー / 振動子 / ライトの 3 本 + 予備が
  下キャップのペネトレータ (M10 ×5) からここを通って基板側へ上がる。
  通路 40 × 22 = 880mm² に対し、Ø7.5 のケーブル 4 本で約 177mm² なので余裕はある。
- **ストレインリリーフは結束スロット (±26) で取る。** ペネトレータのシール部に
  引張をかけないこと。
- リブは薄い (t6) わりに開口が多い。**印刷は壁 4 本以上・インフィル 30% 以上**を
  推奨。とくにスロット横の 5.55mm の肉は割れやすい。
- 上側のリブは配線が通らないなら塞いでもよいが、**同じ部品を 2 枚使う**方が
  管理が楽なので同形状にしてある。

## 要確認

1. 貫通口 Ø88.5 の実物ノギス確認 (STL からの読み取り値)
2. ケーブル実本数・実外径 → 通路 40 × 22 の妥当性
3. ショルダー嵌合のがたつき (Z 方向 1mm の遊びがある)。大きければ
   `child_vtray_deck.rib_gap` を詰める

## parts/common/exterior/printed/xdcr_socket/xdcr_socket.md

# xdcr_socket — TD04A 振動子ソケット (子機/親機 共用)

| 項目 | 値 |
|---|---|
| 区分 | 共通 / 外装 / 3Dプリント |
| 設計ソース | `xdcr_socket.scad` (バリアント定義 `variants.txt`) |
| 個数 | 子機 1 (`_child`) / 親機 1 (`_parent`) |
| 外形 (`_child` / `_parent`) | **50 × 50 × 38 mm** (2026-09-04 base_w 60→50。親機バリアントも同形状 tilt 0) |
| 体積 (`_child`) | 36.1 cm³ |
| STEP (`_child`) | 1 ソリッド / 31 面 |

## 役割

円筒ソケットに TD04A を差し込み、結束バンド 2 本で保持する。

| バリアント | `tilt_deg` | 取付先 | 状態 |
|---|---|---|---|
| `xdcr_socket_child` | 0 (垂直)、**base_w=50** (2026-09-04) | frame2: `child_core_frame` ペデスタル HP1 (0, −85, z218.5) へ M5×4。開口 = 上向き。(旧: `child_frame_plate` 後方コーナー) | **ビルド可** |
| `xdcr_socket_parent` | **0** (2026-09-04) | `parent_deck` キール南 HP40 座 (0, −70, −60) の下面。開口 = 下向き (X 軸 180° 回転) | **ビルド可** (child と同形状 50 × 50 × 38) |

## 親機バリアント (2026-09-04 改訂: tilt 0)

親機は支柱 (マスト) 無しになり、TD04A はデッキ下面の HP40 座 (M5 ×4 @ 40 = 本部品の
`hole_p`) に**傾き無し・開口下向き**で付ける。`variants.txt` の `parent` は
`tilt_deg=0 base_w=50` で child と同形状 (アセンブリが参照する名前として分けている)。

旧 parent (tilt_deg = 20、マストヘッド用) は assert
「M5頭がスカートと干渉: 頭内縁 24.03 < スカート半径 34.03」で停止したまま**廃止**
(傾きが要るなら HP40 側に楔アダプタを作る)。
底の Ø9 は下向きでは水抜きにならないが、ソケット開口が下なので水は溜まらない。

## 主要寸法

| 変数 | 値 | 意味 |
|---|---|---|
| `tilt_deg` | 0 / 20 | ソケット軸の傾き |
| `base_w / base_t` | 60 / 6 | 取付ベース |
| `hole_p / m5_d` | 40 / 5.3 | M5 4 穴ピッチ ← `child_frame_plate.xd_pitch` |
| `xdcr_d` | 26.4 | TD04A 胴径 26.0 (**要実測**) + 0.4 |
| `wall / depth / floor_t` | 5 / 32 / 6 | ソケット肉厚 / 差込み深さ / 底厚 |
| `cable_d` | 9 | 底のケーブル/水抜き穴 |
| `tie_w / tie_t / tie_z` | 5.5 / 3 / [12, 24] | 結束バンドスロット |

## 干渉チェック (`.scad` 冒頭の assert)

- 傾き ≤ 25°
- M5 穴の端距離
- 傾きでソケットがベースから大きくはみ出さないこと
- **M5 頭 (Ø8.5) がスカートに乗り上げないこと** ← 親機バリアントはここで止まる

## 印刷向き

ベースを下に平置き。ソケットは垂直円筒で無サポート
(tilt > 0 のときはスカートが 45° を保証する形状になっている)。

## 部品外の考慮

- 底の Ø9 は**ケーブル出しと水抜きを兼ねる**。塞がないこと。
  親機 (下向き) では水抜きにならないので、別途排水を考えること。
- 振動子の**放射面を塞がない**。ソケットは胴を掴むだけで、放射面は開口から出る。
- **ケーブル 3m + 3P プラグ**が付いてくる (`td04a_transducer.md` 参照)。
  プラグは水中コネクタではないので、子機では容器内 or 水面上に収める。
- 結束バンド (4.8mm 帯) は消耗品。締め直しのため**工具/指が入る**こと。
- 気泡が振動子面に残ると測距できない。設置後に**面を撫でて泡を抜く**運用手順が要る。

## 要確認

1. TD04A 胴径・胴長の実測 → `xdcr_d` / `depth` の確定 (最重要)
2. 親機バリアントの設計方針決定 (上記 3 案)
3. ケーブル外径 → ペネトレータ型番

## spec/child_interior_reinforcement/PLA_MATTE_REVISION.md

# PLA Matte向けの固定根元補強（2026-09-27）

現行部品は `child_vtray_deck_t200` と `child_flange_brace`。STL / STEP / SCADを更新する。LCDと下側の円形リブは廃止したまま。

## 形状

- デッキ左右の固定座を接線方向20 mmへ拡大。根元をX37から始め、Z20..80の60 mmにわたってデッキへつなぐ。根元の内側フィレットR3、自由外縁R0.8を維持。
- 局所的な受け足を左右に追加。フランジの環状面に当たる公称Z19の面から固定座まで接続し、圧縮荷重を分散する。内径側はR44.6で逃がす。円形フレームは復活させない。
- 受け足はY-10..10に限定し、ケーブルレールと干渉しない。スペーサには直径6.8 mmの逃げを設け、既存MF10とM3×18を使用する。
- 前側ブレースの梁幅を8→10 mm、取付部のウェブ幅を16→20 mmへ拡大。
- PCB裏面ピン2本、レールねじ頭、ケーブルスリットを逃がす。取付穴位置は変更しない。

受け足の接触面は平面のまま残す。ねじを締めても割れない絶対的なトルク上限は未測定。印刷樹脂が沈むまで締め込まず、座面が接したところで止める。既存スペーサを省略しない。

## 印刷設定の出発点

0.4 mmノズルを想定。Bambu Lab PLA Matte、積層0.20 mm、壁8周、上下面6層、通常インフィル15%。デッキは板を寝かせ、ボス側を上にする（解析の積層軸Y）。ブレースは広い平面を下に置き、100%インフィル。

`pla_matte_lever/root_dense_modifier.stl` をデッキと同じオブジェクトに読み込み、Bambu Studioで「モディファイア」に変更。座標を保持し、左右の根元・受け足・固定座を100%インフィルに指定する。自動整列でモディファイアだけを移動させない。スライス断面で空洞が残らないことを確認する。壁数を増やすだけでは大型の座の内部が埋まるとは限らないため、局所100%を併用する。

寸法穴の仕上がりと受け足の接触を仮組みで確認する。造形収縮や反りで足が浮く場合は、ねじの締め付けで引き寄せない。

## 荷重と解析の限界

200 gを固定面から180 mm離した静荷重は約0.35 N·m。解析では200 gに5gの加速度を仮定した9.81 Nを先端に与え、部品自重も5gとしている。この5gは比較用の設計仮定で、実測の衝撃条件ではない。

[Bambu公式PLA Matte TDS V3.0](https://store.bblcdn.com/eff154c269404bf6a7baf48385a16e5a.pdf) はXY引張強さ30±5 MPa、Z方向22±4 MPaを掲載している。ただし試験片は100%インフィル、試験前に55℃・8時間の処理を受けている。通常15%インフィルの未処理部品へそのまま適用できない。

topoptの既存一般PLAカードで補助解析を実行する。Matte専用カードではなく、モデルは全面100%充填である。局所密度やねじの締付け、スペーサの柔軟性、接触の開閉は表現しない。左右ねじ穴のみを拘束し、前側ブレースと受け足の接触には解析上の支持を与えていない。したがって材料・組立の実物強度保証には使用しない。メッシュ収束判定と生データは `pla_matte_lever` に保存する。

更新形状を1.6 / 0.8 / 0.4 mmで計算した結果、topoptの収束判定は全4ケースFAIL。最細メッシュでは板に垂直な5g荷重の変位約12.5 mm、p99.5安全率5.39以上に対し、最悪要素の安全率は約1.3である。安全率4・変位1 mmの仮要求を満たす保証は得られていない。ねじ拘束端のホットスポットもメッシュで移動しており、これらは未収束の参考値である。以前の形状とは包絡とグリッド原点も異なるため、改善率は算出しない。

この解析を「PLA Matteで安全率5以上」として使用しない。受け足と前側支持の実接触、および通常部15%の内部構造を含む組立状態での評価と実物試験が必要。今回の納品は根元の断面拡大・荷重分散を行った試作形状であり、強度認証済み部品ではない。

## 組立とサービス

WetLink M10×5と出口付近の配線逃げ、電池サービスねじへの直径6 mm工具アクセス、床板の2 mm下降と引き抜き経路を維持する。サービス作業はアクリルチューブを外して行う。配線の全経路と曲げ半径は実配線に合わせて確認が必要。

最終の実物確認は200 g相当を搭載し、横向きの各方向で根元の浮き・白化・残留変形を確認する。初回は静荷重から始める。反復荷重と締付けに対する寿命は未測定。

## 今回の幾何検証

デッキとブレースのSTLは水密の一体形状。対応するSTEPは有効な単一ソリッドで、STLとの体積差は0.001%未満。組立STEPは内装75項目、子機全体82項目、いずれも配置検査0 NG。対象は200 mm構成（t200）。t300の既存出力は今回更新していない。

基板取付穴12点は一致。容器包絡に新規の干渉なし。元からの上側リブ0.50 mm・LED配線0.54 mmの狭隙間WARNは残る。変更した印刷部品と周辺部品の実体交差、配線出口の予約空間、工具・床板の移動検査は83交差チェックでエラー0。これは全ハーネスの実配線確認を置き換えるものではない。

ログ: `pla_matte_lever/assemblies.log`, `service.log`, `holes.log`, `envelope.log`。解析FAILは `after.log` および `after_fea/deck_after_fea_convergence.json` に保存。

## spec/child_interior_reinforcement/SERVICE_REVISION.md

> 2026-09-27現行: Bambu PLA Matte向け、60 mm根元・20 mm固定座・局所フランジ受け足、前側梁10 mm。印刷設定と解析の限界は spec/child_interior_reinforcement/PLA_MATTE_REVISION.md。以下の旧寸法・材料待ち記述は履歴です。

# 下フランジ固定状態でのバッテリー交換 / ペネトレータ対応

2026-09-27現行版。200 mm縦置き構成。ユーザー確認：WetLink M10を5穴に実装、配線の余裕も必要。

## 構造と交換手順

下円形センタリングリブとその抜け止めねじを廃止。デッキ下尾部も廃止し、デッキ材料の始点を世界Z20に変更。
左右の補強耳と前側ブレースの3点で下フランジへ固定。上リブは保持。
キャップの外面Z-13.8、板厚10。WetLink M10ねじ長20なので内側先端はZ6.2。
ナットはAF16 / 高さ8（Z-3.8..4.2）。全5穴に占有モデルを実配置した。
外側形状は総高26の保守的占有モデル、頭とプラグの境界は仮値。

電池のサービスねじは世界(X,Y,Z)=(22.5,-43,36)へ移設。既存M3×8皿ねじを使用。
床板の下端はZ22.5。ねじを外し、床板を-Zへ2 mm動かすと下端Z20.5となり、
フランジ内面Z19に対して1.5 mmの余裕が残る。その後-Yへ抜いて電池を取り出す。
箱側壁にはスライドするタブの逃げと深さ6の下穴を追加。
側面フォームは長さ102、Z23..125に短縮し、+X側は新ボス周辺に切欠きを追加。
チューブとバッテリーのXT30を外して交換する。内装の下フランジ固定は外さない。
チューブ装着中の交換には対応しない。

## 配線空間 / 検証

非製造の配線余裕モデル：5本それぞれ直径9、内側先端から中心Z14まで。
球状端を含む上端はZ18.5で、デッキ始点まで1.5 mmの余裕。
これは出口付近の余裕空間であり、全コネクタまでの配線形状を確定したものではない。
実配線束径・曲げ半径・サービスループ量は実機に合わせて確認する。

verify_service_access.py / service_checks.json：体積交差をManifoldカーネルで確認。
- 変更した印刷部品と近傍剛体・フォーム：交差なし（ねじの噛み合い・既存ハーネス包絡は対象外）。
- 5本のペネトレータとキャップ穴：交差体積0。
- 直径9の配線余裕と変更印刷部品：交差なし。
- 直径6の工具軸、-Y側からねじ座まで：交差なし（チューブを外した状態）。
- 床板の-Z 2 mm / -Y 45 mmまで、29姿勢で干渉なし。
- PCB穴12箇所はKiCad基板と一致。変更部品STLは閉じた一体立体。
- 組立STEPはchild_interior 75部品、child_vertical_assembly 82部品、いずれも配置検証0 NG。
- 箱・床板STEPはFreeCADでvalid / 1 solid。デッキSTEPは検証済みのファセットソリッド。
- 旧サンプル検査で見逃していたMAIN裏面ピンとの小さな交差も、デッキの局所逃げで解消。

新しい補強部の強度解析は、材料・搭載重量・荷重条件の回答待ち。安全率・締付トルクは未保証。
既存ハーネス包絡モデル同士やPCBとの重なりは残り、本検証は配線全体の無干渉を保証しない。

寸法出典：https://bluerobotics.com/wp-content/uploads/2026/04/WLP-DATASHEET-v1.5.pdf

## spec/child_interior_reinforcement/M3_SUPPORT_REVISION.md

# M3統一とサポート削減（2026-09-27）

現行対象は200 mm耐圧容器の子機縦置き内装。印刷の入口は `assemblies/child_interior/parts/PRINT.md`。このpartsフォルダには印刷姿勢を反映したSTL・鏡像部品・モディファイアを実ファイルとして同梱する。

## 変更

- デッキ左右固定座のY=-10より下の張り出しをなくし、板と固定座の印刷底面をそろえた。デッキ全体を浮かせるサポートを避ける。
- 横向きのフランジねじ穴・頭の逃げ・スペーサ逃げに45°屋根を追加。ブレースの横向きM3穴にも屋根を追加。
- 前側ブレースの梁底面を固定耳とそろえ、梁下のサポートを避ける。
- 電池箱の約40 mmの横桁を、左右の45°付き端受けに置き換える。床板フック先端の下面も45°へ変更。
- RX基板は外周を押さえるM3クランプ4組へ変更。元のØ2.2穴はそのまま残し、使用しない。PCBのドリル径や購入基板を変更していない。
- 上側リブの抜け止めはM3×6へ変更し、デッキ先端に0.5 mmの肉を追加。リブ側にねじ頭の逃げを設けた。
- なべ頭の空間はØ6.6 mmで検査。加工する逃げ穴は多角形の誤差を見込みØ6.8 mm。電池サービスねじの皿頭座は既存Ø5.8、直径6 mm工具経路を維持。

「M3」は呼び径。通し穴はØ3.4、樹脂セルフタップ下穴はØ2.5〜2.8であり、すべての穴を直径3 mmにする意味ではない。既存ねじ・スペーサ以外の金属補強を追加しない。

## 印刷

| 部品 | 設計座標からのX回転 | ベッド面 |
|---|---:|---|
| デッキt200 | +90° | Y=-10 |
| 前側ブレース | 0° | Z=-3 |
| 電池箱 | -90° | Y=-10 |
| 電池床板 | +90° | Y=-43 |
| RXベース | -90° | Y=-10 |
| RX押さえ板 | +90° | Y=-20.6 |

印刷一式は上記回転済みなので、スライサで再度90°回転しない。平面を下に置く。壁8周、層0.2 mm、通常インフィル15%、固定根元は同梱モディファイアで100%、ブレースとRXクランプは100%を出発点とする。

長い浮いた面をなくし、横穴の屋根と張り出しを45°へ変更した。小さい角丸・フックの切欠きなどには短いブリッジが残る。スライサ実行によるサポート量の測定はしていないため、全条件でサポートゼロとは断定しない。最初はサポートOFFでプレビューし、必要な箇所だけペイント指定する。ねじ穴・座面・PCBの当たり面にサポートを詰め込まない。

## 取付と検証

RXはベースを先にデッキへM3×8で固定し、基板を受けに載せ、押さえ板をM3×8で留める。PWR基板を載せる前にベース側ねじを締める。基板が反るほど締め込まない。外縁の部品・銅箔は実物も確認する。

上側RX取付座はフランジの貫通口へ入るため、デッキ側の追加幅とクランプの尾部を容器内へ絞った。最小公称隙間はデッキ0.59 mm、上側クランプ0.70 mm。既存の上側リブ0.50 mmとLED配線0.54 mmも狭隙間なので、反り・バリを除いて仮組みする。デッキ先端Z202.5は上キャップ内面Z203.8より内側に収まる。

根元は60 mm・固定座20 mmを維持。今回形状の強度解析は更新しておらず、以前の未収束解析を今回の安全率として流用しない。

## 最終検査

- 変更した印刷STLは水密、一体形状。対応STEPは有効な単一ソリッドで、STLとの体積差0.005%未満。
- MAIN / PWRの取付穴8点は実KiCadと一致。RXクランプの4か所は実基板外形・組立ねじ配置と一致し、既存穴を使わないことを検査。
- 印刷部品と周辺部品・工具・床板移動の107交差検査でエラー0。上側リブと上下フランジも対象。
- なべ頭Ø6.6予約空間の78交差検査でエラー0。内装の固定ねじにM2 / M2.5が残っていない。
- 主要6部品の指定姿勢で平坦なベッド接触面を確認。スライサによる実サポート量の測定は未実施。
- 組立STEPの内装79項目、子機全体86項目で配置検査0 NG。容器包絡にFAILなし。狭隙間WARNは上記のとおり。

証跡は `assemblies/child_interior/_work/logs/m3_*.log` と `m3_print_check.json`。管理ツールの既存9テストも合格。

## spec/child_interior_reinforcement/BOLTED_MOUNT_REVISION.md

# 電池締結とフランジ根元の印刷補強（2026-10-01着手）

対象は確認済みの200 mm縦置き内装、35×26×110 mm電池、BR-101040下フランジ。
M3ねじ・普通ナットを使用し、補強構造は3Dプリントで作る方針をユーザー確認済み。
印刷入口は [child_interior/parts/PRINT.md](../../assemblies/child_interior/parts/PRINT.md)。
同じ内装を使う `child_vertical_assembly` にも反映する。300 mm版は対象外。

## 設計変更

- 電池ケースの4つの取付部を、樹脂への4 mmセルフタップからM3×12＋普通M3ナットへ変更。
  穴位置X±24 / 世界Z32・110は維持。各耳に深さ8 mm・Z長14 mmの一体パッドを設け、
  ナット座よりデッキ側に5.5 mmの樹脂断面を残す。取付面をデッキへ密着させて締結する。
  樹脂ねじ山の抜けが主固定を決める構成を改める。
- 床板はM3×10皿＋普通M3ナット1個。側面ボスはZ長14 mm・Y深さ9 mm、床板タブもZ長14 mm。
  ねじ軸は従来のX22.5 / 世界Z36。ボスを電池・フォームの外側へ置き、窓とフックを維持する。
  ナット座までの樹脂厚3.5 mm、床板厚3 mm、皿頭の差し込みを含むねじ先端突出は公称1.1 mm。
  +X側フォームの既存切欠きをR3.1→R3.4へ広げ、六角ナットの角を逃がす。
- デッキ左右の根元をX37→28から接続し、軸方向60→80 mm、通常部の厚み6.5→7.5 mmへ変更。
  広い一体リブと既存のフランジ受け足で曲げと圧縮を分担する。基板裏の2.54 mmピン列6本を逃がす。
  基板自体を補強材として扱わない。ケーブルスリットとレールのねじ頭の逃げは維持する。
- 前側ブレースの梁10→12 mm、ウェブ20→24 mm、フランジ座の接線方向12→20 mm。
  MF30/MF12スペーサとM3×12なべねじは維持する。
- 前側フランジねじはM3×18→M3×16。座厚12 mmに対するフランジねじ込みを6→4 mmへ修正。
  既存記録の4〜5 mmかかり・6 mm超禁止に従う。左右MF10スペーサとM3×18は維持する。

`scad/lib/child_interior_mounts.scad` が電池締結位置と普通ナット受け寸法の共通定義。
ナットは既存購入品モデルの二面幅5.5 mm・厚さ2.4 mm。ナット受けは5.7 mm・深さ2.6 mm。
ナイロックやフランジナットはこのポケットに適合しない。

## 組立・電池交換

1. 電池ケース取付部4か所とサービスボス1か所に普通M3ナットを入れる。
   ポケットの口は外側Xへ開く。回り止めの形状であり、未締結時の脱落を保証するスナップではない。
   ナットを押さえながら仮締めする。工具経路を確保するためケーブルレールは後から取り付ける。
2. ケースをデッキ下面へ密着させ、デッキ側からM3×12を4本入れる。
   ナットが座ったところで止める。印刷樹脂を潰して増し締めしない。
3. 既存のフランジ受け足を面へ当て、左右MF10とM3×18、前側M3×16で固定する。
   反りで受け足が浮く場合は締付けで引き寄せない。PCB取付とレール・配線を復旧する。
4. 電池交換はチューブを外し、XT30を抜く→床板M3×10皿を外す→床板を−Zへ2 mmスライド→−Yへ抜く。
   フランジ固定・ケース・基板は外さない。サービスナットの紛失に注意する。

追加で必要な普通M3ナットは5個。電池ケースのM3×8を4本ともM3×12へ、床板のM3×8皿をM3×10皿へ、
前側フランジのM3×18をM3×16へ交換する。その他の既存ねじとスペーサは組立配置どおり使う。
補強用金属板・スリーブ・インサートは追加しない。

## 印刷

印刷一式のSTLは指定姿勢へ回転済み。デッキ+90°、ケース−90°、床板+90°、ブレース0°。
PLA Matte・0.4 mmノズル・0.2 mm層、壁8周、上下面6層を引き継ぐ。
ケース・床板・ブレースは100%充填を試作条件とする。デッキ通常部15%、左右の根元は同梱モディファイアで100%。
モディファイアも拡幅・延長済み。ケースのナット受けは短いブリッジを含むので、スライス断面で屋根と空洞を確認する。
実スライサのサポート量・実造形での締付けは未測定。

外周パッド・床板は面取り0.3 mm、根元・梁の独立プリズム端縁も0.3 mmの丸め、窓の平面角はR0.6。
根元の凹側R3を維持。ナット回り止めの六角角部、ねじ平座、フック・壁の指定嵌合面、
フランジ環状接触面は機能面として既存の形状・寸法を優先する。
既存形状の全稜線を仕上げ直した変更ではなく、全稜線の仕上げ確認は未完了。

## 検証と強度の扱い

幾何検証の結果は `assemblies/child_interior/_work/logs/bolted_*` に保存。
最終形状の4部品は水密・一体、STEPは読み戻して有効な1ソリッドを確認。
STEP/STLの外形差は0.001 mm未満、体積差は0.001%未満。
追加ねじ・ナット・挿入の122交差、周辺・工具・床板移動の107交差、ねじ頭の78交差でエラー0。
MAIN/PWR実取付穴とRX外周クランプは一致、印刷姿勢の平坦な底面も確認済み。
OpenSCADレンダリング、閉メッシュ・一体性、STEP/STL外形・体積、周辺部品の干渉、
実ナットの取付と挿入経路、ねじ頭、工具、床板の2 mmスライドを確認する。
既存の基板取付穴検査、全体組立の配置検査、印刷一式の出所・ハッシュ検査も実行する。
最終組立STEPは内装構成84項目・子機全体91項目で配置不一致0件。
内装だけの既存別名STEPも再生成し、74項目で配置不一致0件。
管理ツールの14テスト合格、画像・中間ファイルの配置検査合格。
対象2構成の印刷一式検査は合格。リポジトリ全体検査では作業中に別構成の
`over_center_latch`、`parent_hand_service`、`child_clamp_suspension` の未同期を検出しており、全体合格とはしていない。
この記録は今回の対象以外の設計・生成データの整合性を保証しない。
ケース最小径方向すきま2.89 mm、ブレース1.00 mm、床板0.71 mm。
既存のデッキ0.59 mm・上リブ0.50 mm・上RXクランプ0.70 mm・LED配線0.54 mmも狭隙間として残る。

200 g・腕180 mm・5gは過去の比較条件で、根元曲げモーメントは約1.77 N·m。
電池単体の質量・実衝撃条件は未確定であり、この200 g条件を電池質量の確定値とはしない。
以前のPLA Matte解析は未収束。今回の形状へその安全率を転用しない。
今回の変更は締結先と荷重を分散する形状の改善であり、許容荷重・締付トルク・反復寿命の保証ではない。

仮組みでは普通ナットの嵌合、チューブとの狭隙間、受け足の全面接触を確認する。
電池を入れる前にダミー重量で各横方向を静荷重から確認し、白化・耳の浮き・残留変形を点検する。
反復交換後もナット座と皿座の変形を確認する。5gの実物試験とメッシュ収束を伴う材料・接触解析は未実施。

再生成時は元SCADをビルドし、`sync_bolted_mount.py` で既存配置へこの締結を反映する。
旧 `scad/lib/sync_child_interior.py` はLCDありの履歴構成を生成するため、この現行構成へ使用しない。
旧3MFは履歴として保持し、今回のSTLを再読み込みしてスライスする。

グループ限定STEPはグループ限定の配置JSONで照合する。全体91項目の配置で内装だけの74項目STEPを
照合した初回診断は17件MISSINGとなるが、その17項目は容器・外装・ペネトレータであり、内装限定には含めない。
正しい照合は `bolted_interior_step_filtered_check.log`（74項目・0 NG）。初回ログは解析フォルダへ保持する。

## spec/child_interior_reinforcement/PRINT_STRENGTH_REVISION.md

# 子機内装：小部品の連結・フランジ補強・配線逃げ（2026-10-04）

対象は既存の200 mm構成、PLA Matte／0.4 mmノズル／X1C。
ユーザーの重点は「小さすぎる部品」「フランジねじ固定部」「固定後のペネトレータ干渉」。
既存の電池・基板・WetLink M10×5・M3普通ナット締結を引き継ぐ。

## 設計変更

- RXクランプを左右それぞれ連結。個別ベース4個＋押さえ4個から、連結ベース2個＋押さえ2個へ。
  接触点Z140.5/174.5、基板支持面Y−16、押さえ面Y−17.6と全ねじ軸は維持する。
  連結部は幅3 mm、外側X39.2..42.2（左側は鏡像）。電線を通すX36周辺を開ける。
  ベースは約53 mm長、押さえは41 mm長。新規部品の正本は既存SCADの`base_pair`/`cap_pair`。
  旧`base`/`cap`は履歴として保持し、現行印刷一式には入れない。
- 前側フランジブレースの途中の折れ曲がりは、旧4.8 mmのくびれから12 mmの梁で連続させる。
  スペーサ座付近の逃げ、フランジ座12 mm厚、M3×16のねじ込み4 mmは維持する。
  既存XH9電源コネクタとの重なりを除くため、X35.1/Y19.7までの貫通逃げを設ける。
- 電池床板の確認窓を20×26→14×22 mm、平面角R0.6→R3、両面入口0.3 mm面取り。
  窓脇の公称帯幅は9.7→12.7 mm。板厚3 mm、フック・皿座・着脱経路は維持する。
- ケースの4つの取付パッドは、両端各4 mmの45°斜面で耳へつなぐ。
  穴・ナット座・電池空間・最大外形を維持する。

変更した連結梁の縁は0.2 mm、薄い押さえ接触部は0.1 mmの面取り。
既存の基板接触面・ねじ座・下穴・フック嵌合形状は機能を優先する。
全既存部品の全稜線を仕上げ直したものではない。

## 配線と組立

左右クランプはベースをデッキへ固定→基板→連結押さえの順で組む。
左右の鏡像STLは別ファイル。既存M3×8の本数は変わらない。
両端を交互に少しずつ締め、基板をたわませない。

RX/LED/電池配線は下側クランプの外面より外（Y−25.5付近）へ迂回する。
クランプの連結梁と基板の間へ束を無理に押し込まない。
温度配線のレール進入口は既存窓の世界Z90..104へ合わせる。
配線占有モデルは`parts/common/cabling/child_harness/child_harness.scad`を更新する。
実ケーブルの曲げ半径と固定点は現物で確認する。CADの折れ線は配線経路の占有モデル。

## 印刷

入口は各assemblyの`parts/PRINT.md`。STLは印刷姿勢へ回転済み。
連結ベースはY−10面、連結押さえはY−20.6面をベッドへ向ける。
PLA Matte／0.4 mmノズル／0.2 mm層、壁8周、上下面6層を継続。
連結クランプ・ブレース・ケース・床板は100%充填。
デッキは通常15%、同梱の根元モディファイア領域100%。
新しい連結梁と床板窓は平置きし、追加の支持材を必要とする屋根を作らない。
短いナットポケットのブリッジなど既存箇所はスライス断面で確認する。
実スライサのサポート量・反り・実物嵌合は未検証。

## 検証

再生成後に`verify_print_strength.py`、既存の締結・工具・床板移動検査、
ねじ頭空間、実基板穴、STEP/STL照合、組立配置、印刷一式検査を実行する。
今回のログ・比較用原本は`assemblies/child_interior/_work/`に保存する。
形状を補強した設計変更であり、許容荷重や強度倍率を保証しない。
PLA Matteの材料試験・積層方向を含む収束解析・実物荷重試験は未実施。
フランジ受け足の全面接触、ねじ穴の嵌合、締付けによる白化は仮組みで点検する。

再生成：変更部品を`build.ps1`でビルドし、`sync_paired_clamps.py`で現行2構成を更新。
旧`sync_bolted_mount.py`等で個別クランプの配置に戻さないこと。

## 生成データの扱い

フランジブレースと配線モデルは`manufacturing.json`の`step_coplanar_merge`で検証済みSTLからSTEPを生成する。CSG取り込みによる体積差・配線外形差を避けるため。ケースは既存の微小退化三角形を数値溶接＋Edge Flipで除去し、移動量・体積差・面の一致と閉メッシュを検査する。設定は設計元に保存済み。

既存の`parts/child_flange_brace.3mf`は内容を変えず`print_jobs/child_flange_brace.3mf`へ移動。移動元とSHA-256は`print_jobs/retained_flange_job.json`へ記録。今回のSTL・設定との一致を保証しない履歴であり、再読み込みしてスライスする。

## 最終部品検証結果

- 変更した印刷5形状は閉メッシュ・一体。ネイティブ検査でも非多様体・退化面なし。
- 印刷5形状と変更した配線4形状は有効なSTEP。STL外形との差は最大0.000001 mm未満、体積差は最大0.025%未満。
- ペネトレータ5本×印刷部品11個の55組は、すべて少なくとも7.8 mmの軸方向分離がある。これはモデル寸法に基づく保守的な距離下限で、実測値ではない。
- ハーネスとの境界箱が重なる36組で体積干渉なし。既存の直径9 mm配線予約空間、工具、床板2 mmスライドを含む95交差と、ナット・挿入・ねじの122交差もエラー0。
- なべねじ頭の78交差、MAIN/PWRの実基板穴、RX外周クランプ配置も合格。穴検査は連結部品の元SCADからピッチを読み、4接触点を確認するよう更新。
- 管理ツール14テスト合格。実スライス・実造形・実荷重試験は未実施。

ログは`assemblies/child_interior/_work/logs/print_strength_*`、比較数値は`_work/analysis/print_strength_20261004/geometry.json`と`step.json`。

対象2構成の印刷一式は出所・個数・SHA-256・更新状態の検査に合格。内装80項目と内装限定70項目のSTEP配置照合は不一致0件。リポジトリ全体検査では対象外の`child_exterior_structure`と`over_center_latch`に未同期を検出したため、全体合格とはしていない。

子機全体87項目も最終STEP配置照合で不一致0件。内装・子機全体・内装限定の3つのSTEPを更新済み。配線STLは再生成時の桁丸めによる微小接続不良を避けるため、バイナリ出力を設計元の製造設定に保存した。

## spec/child_interior_reinforcement/FASTENER_ASSEMBLY.md

# 子機内装：ねじ固定・工具・組立順（2026-10-21）

2026-10-21 通し穴改訂：スペーサ外側を二面幅5.5 mmの六角、穴を内接径3.5 mmに変更。M3ねじが滑って通り、タップ不要。10 mm×2・12 mm×1・30 mm×1をつなぎ付き1セットで印刷する。左右フランジは首下26 mmのM3なべねじ2本（必要ならM3×30を26 mmに切断・面取り）、ブレースはM3×30／×45スタッド各1本＋普通M3ナット2個で固定。以前の短いスタッドと上ねじ4本は使わない。[設計・取付・印刷条件](../../parts/child/interior/printed/child_spacer_set/child_spacer_set.md)。実物の嵌合・締結強度は未検証。

現行200 mm構成用。ねじ頭が収まるだけではドライバーが通らない箇所があったため、工具通路と組立順を追加検証した。

## 必要なねじ

| 固定先 | ねじ | 個数 | 公称かかり・条件 |
|---|---|---:|---|
| 左右フランジ／印刷10 mmスペーサ | M3×26なべ | 2 | 首下26 mm＝座12＋スペーサ10＋フランジかかり4。M3×30を切断・面取りしてもよい |
| 前側フランジ | M3×16なべ | 1 | 樹脂座12 mmを通り4 mm |
| ブレース／印刷30・12 mmスペーサ | 左M3×45／右M3×30通しスタッド＋普通M3ナット | 各1組 | 下端突出6 mm、スペーサと5.5 mm座を貫通。ナット先端突出1.1／4.1 mm |
| 電池ケース | M3×12なべ | 4 | デッキ4 mm＋ナット座前5.5 mm、普通ナット2.4 mm。ねじ先端の公称突出0.1 mm |
| 着脱床板 | M3×10皿 | 1 | 普通M3ナット。公称突出1.1 mm。皿ねじは頭込み長さ |
| RXベース | M3×8なべ | 4 | デッキ4 mmを通り樹脂へ4 mm |
| RX押さえ | M3×8なべ | 4 | 押さえ2.6 mmを通り樹脂へ5.4 mm |
| PWR基板 | M3×8なべ | 4 | 基板を通して既存樹脂ボスへ固定 |
| MAIN上側 | M3×8なべ | 2 | 基板を通して既存樹脂ボスへ固定 |
| 上リブ抜け止め | M3×6なべ | 1 | 既存デッキ下穴へ固定 |

合計23本＋金属通しスタッド2本、普通M3ナット7個（二面幅5.5／厚2.4 mm）。
電池ケースのナット先の余裕は小さいため、実ねじの先端面取り・長さ公差・ナットの完全な着座を仮組みで確認する。
図の公称かかりを、そのまま有効ねじ山長さや締結強度とは見なさない。
樹脂下穴を使うRX・基板固定は、繰返し脱着寿命・許容トルクを未検証。

## 工具と順序

検査した工具包絡は、頭から外へ伸びる軸径4 mm・長さ50 mmの直線円柱。
先端はねじ頭に合うものを使う。実物のビット先端、段付き部分、ハンドル形状までは保証しない。
太い6 mm軸は左右フランジねじと上リブなどで干渉する。無理に斜め締めしない。

1. チューブと上フランジを外した状態で組む。
2. 電池ケースの普通ナットを入れ、MAIN基板・ハーネスを付ける前にケースをデッキへ固定する。
3. 基板・RXベース・ブレースを取り付ける。PWR上側2本とRX上側ベース2本は、上フランジを戻す前に締める。
4. RX押さえを締める際は、下側ねじの正面にあるRX・LED・電池ハーネスを退避させる。締結後に既定経路へ戻す。
5. 左右フランジはM3×26なべを12 mm座＋10 mm滑り穴スペーサへ通してフランジに4 mm入れる。ブレースは左M3×45／右M3×30を基板＋デッキへ6 mm入れ、滑り穴スペーサと取付座を通し上ナットで固定する。底付きと完全着座を仮組みで確認する。樹脂をねじで潰さない。
6. 基板をたわませず、各ねじを交互に少しずつ締める。上フランジとチューブは最後に戻す。

電池交換は従来どおり、チューブを外し、XT30を抜き、床板の皿ねじ1本を外して床板を−Zへ2 mm、その後−Yへ抜く。
ケース固定ねじの再締結はMAIN基板を外して行う。

## 2026-10-06の形状変更（履歴：レールは撤去済み）

デッキの既存レールねじ頭用Ø6.8×深さ4 mmの逃げより上へ、Ø4.6 mmの工具通路を延長。
ねじ座面を残し、φ4 mm軸に片側0.3 mmの隙間を確保した。実際に工具を塞いでいたのは世界Z37の4か所。
変更は`tube_len=200`に限定。300 mm版の形状は変更しない。
造形時はデッキを既定の姿勢へ寝かせるため、追加通路は造形方向に開口する。
STLは元SCADから再レンダリングし、STEPは検証済みメッシュから生成する。

## 旧購入品の履歴：MF10のオスねじ突出長（印刷本体では上記の4 mmを使用）

現行購入品モデルは`stud_l=6`。一方、既存取付記録はフランジへ4〜5 mmのねじ込みを指定している。
ユーザーへ実物の突出長を確認中。フランジの底付き・スペーサの完全着座は確定していない。
6 mmをそのまま使用可能と判断しない。実物寸法が分かってから、適合するスペーサ／取合いを確定する。
勝手に購入品モデルを4 mmへ短縮したり、樹脂を締付けで潰して帳尻を合わせたりしない。

## 検証の範囲

`verify_fastener_access.py`は25本×3種類の工具包絡を記録する。
φ4 mm軸と上記の組立順を受入条件とし、工具と部品の未解決干渉0件。
φ6 mmと先端φ2.5／軸φ4 mmは比較用であり、全工具が使用可能という結果ではない。
ログと詳細は`assemblies/child_interior/_work/logs/fastener_*`と
`_work/analysis/fastener_access_20261006/access.json`。
ねじ頭・ナット・工具・床板の運動・基板取付穴も再検査する。
材料強度、適正締付トルク、有効ねじ山、実物の底付きはCADの干渉検査だけでは確定しない。

変更後のデッキは一体の閉メッシュ（ネイティブ検査で開境界・非多様体・退化面0）。工具通路の除去体積は約278 mm³、外形差は0.00001 mm未満。これは形状差の記録で、強度を保証する数値ではない。ねじ頭・ナット挿入・床板着脱・実基板穴の再検査は合格、管理ツール14テスト合格。

`parts/child_flange_brace.3mf`に再保存されていた別版は、以前の履歴を上書きせず`print_jobs/child_flange_brace_20261006.3mf`へ内容を変えず移動。SHA-256と移動記録は同じフォルダの`retained_flange_job_20261006.json`。現行STLとの一致は未検証。

対象2構成の印刷一式検査は合格。全体検査では対象外の`child_clamp_suspension`、`child_exterior_structure`に未同期があり、リポジトリ全体合格とはしていない。

2026-10-06時点の組立STEP読み戻し照合（撤去前の履歴）：内装80項目、全体87項目、内装限定70項目すべて配置不一致0件。MF10実物の突出長確認は、この幾何検証とは別に未完了。

## 2026-10-07：レール撤去とナットの挿入

現行2構成からレール2本・M3×10なべ8本を除外。内装のねじは25本、普通ナットは5個。既存デッキの穴・工具逃げはそのまま残し、印刷済みデッキも流用できる。穴へねじを入れる必要はない。レールの設計元は履歴として保持する。

ナットは樹脂内の空洞に収まるため、一部が隠れて見える。熱圧入・造形途中の埋込みはしない。ケース4個は左右外側から中央へ、床板用1個は右側外側から中央へスライドして入れる。普通M3ナット（二面幅5.5 mm／厚2.4 mm）に対し、ポケット二面幅5.7 mm／厚さ2.6 mm。ケースのポケットは下面にも開いているので、締結前は指などで脱落を防ぐ。

CAD検査ではナットと樹脂の重なりなし。5個を外側6 mmから0.5 mm刻みで挿入し、床板の着脱も含む122検査で干渉なし。実印刷の穴収縮は含まないため、ナットを押し込む前にバリを除き、無理な圧入はしない。ケースねじの公称突出0.1 mmという小さい余裕は引き続き仮組み確認が必要。

ケーブル経路の形状は維持する。旧レールの結束点・窓位置は現行の固定箇所として使わない。実際の配線保持箇所は仮組みで確認し、ペネトレータや基板コネクタに引張力が掛からないようにする。

確認図：[ケース側ナットの着座／挿入方向](../../assemblies/child_interior/_work/images/battery_nut_insertion.png)。部分切り出し表示。

2026-10-07検証結果：内装70／全体77／内装限定60項目のSTEP読み戻しはすべて配置不一致0。工具75経路（25本×3径）、受入対象のφ4 mmで未解決干渉0。ナット・挿入122、サービス95、なべ頭62の干渉検査でエラー0。基板取付穴照合と管理ツール14テストに合格。対象2構成の印刷一式検査に合格。全体検査では対象外の child_clamp_suspension、child_exterior_structure、over_center_latch、parent_hand_service に未同期が残る。実物の強度・ねじ締付トルク・MF10突出長は未検証。

## parts/child/interior/printed/child_spacer_set/child_spacer_set.md

# child_interior：六角・M3通し穴スペーサ4個セット

2026-10-21 通し穴改訂。正本は`child_spacer_set.scad`。配置・製造参照は
`spec/child_interior_reinforcement/sync_printed_spacers.py`で更新する。
ユーザー指定に従い、外側は二面幅5.5 mmの六角、穴はM3ねじが滑って通る
**内接径3.5 mmの12角補正穴**に変更。タップ加工は不要。

| 本体長さ | 個数 | 取付先 | 通しスタッド | 下端突出 | 上側固定 |
|---|---:|---|---|---:|---|
| 10 mm | 2 | 左右フランジ、Z19..29 | M3×26なべねじ | フランジへ4 mm | 12 mm座の上のねじ頭 |
| 12 mm | 1 | ブレース右、Y4.6..16.6 | 金属M3×30 | 6 mm | 5.5 mm座の上に普通M3ナット |
| 30 mm | 1 | ブレース左、Y4.6..34.6 | 金属M3×45 | 6 mm | 5.5 mm座の上に普通M3ナット |

**印刷は`child_spacer_set_set.stl`を1個だけ。** 左から10/10/12/30 mm。
個別body STLは組立モデル用。切離し用ランナーと幅0.8×厚さ0.4 mmのつなぎを維持する。
外形の6面は平面、縦の角はR0.2、上下端と穴入口は0.2 mm面取り。
穴の頂点径は約3.624 mm、内接径3.5 mm。M3呼び径に対して直径0.5 mmの余裕。
中央部の保守的な最小肉厚は約0.94 mm。面取り端の座面はさらに狭いため、締め潰さない。
12角穴の縦稜線は機能断面を維持し、ねじ山を利かせず使用する。

## 金属部品と組立

左右フランジは**首下26 mmのM3なべねじ2本**。12 mm座＋10 mm本体を貫通して
フランジに4 mm入る。必要なら既存M3×30を首下26 mmに切り、切断端を面取りする。
M3×25ではかかりが3 mmとなるため使用しない。M3×30をそのままねじ込まない。
ここは周囲のデッキに通常ソケットが当たるため、従来と同じなべ頭＋軸径4 mmドライバーを使う。

ブレースは金属M3×30／×45の全ねじスタッド各1本と普通M3ナット2個
（二面幅5.5／厚さ2.4 mm）。平先の全ねじ棒または頭なしねじを使用する。
スタッドの工具用穴／把持方法は実物に合わせ、スペーサの穴内でねじ止めしない。
以前の短いM3×8／×10スタッドと、左右M3×16・ブレースM3×12の上ねじ4本は使わない。

1. スペーサを冷却後にランナーから折り離し、つなぎ跡とバリを面一に除く。
2. M3ねじが全長を手で滑って通ることを確認する。実印刷の収縮は機種・材料に依存する。
   渋い場合は穴だけを3.5 mmドリルで軽くさらう。圧入・ねじ込みはしない。
3. 左右フランジはM3×26なべねじを12 mm座とスペーサへ通し、フランジに4 mm入れる。
   フランジの底付きと着座を確認する。
4. ブレース用スタッドの下端はMAIN基板1.6 mm＋デッキ4.4 mmの計6 mm入れる。
   スペーサと5.5 mm取付座を通し、上側から普通M3ナットを締める。
   座面が接したところで止める。緩み・樹脂の潰れは実物確認。

ナット外側への公称ねじ突出はブレース右4.1 mm、左1.1 mm。
相対する2本のねじを穴内で突き合わせる構成は廃止。ブレース右は長めの先端を指や配線へ当てない。
ブレースの工具検査は外径8 mm／内径6.6 mm／長さ50 mmのソケット包絡。
左右フランジを含むなべねじには軸径4 mm／長さ50 mmドライバー包絡。
チューブを外して締める。ソケット実物とナットの回転・保持は仮組みで確認する。

## 印刷

PETG、0.4 mmノズル、積層0.20 mm、壁4周以上、100%充填を推奨。
軸をZに立て、Z0をベッドへ置く。つなぎは2層、ランナーは幅2×厚0.6 mm。
本体の根元を支えてランナーを曲げて折る。長い本体の先端を持ってねじらず、
折れにくければニッパーでつなぎのみ切る。破断用のつなぎの縁は面取りの例外。
スライサのオブジェクト分割は使わない。支持が必要な閉じた屋根や水平穴は設けていない。

## 検証と履歴

今回の幾何・穴ゲージ・干渉・ソケット通路の結果は
`assemblies/child_interior/_work/analysis/printed_spacers_clearance/`。
スライスのSHA-256・プリセット・G-code・3MFは
`assemblies/child_interior/print_jobs/child_spacer_set/`。
確認画像は本部品の`_work/images/`。STLから検証付きで作成するSTEPはファセット形状で、設計履歴ではない。

旧Ø2.5タップ式の設計説明は上記解析フォルダの`previous_tapped_design.md`、
旧スライス一式は`print_jobs/child_spacer_set_tapped_20261021/`に保持した。
旧方式の検証結果を今回へ流用しない。

実物の滑り、折り取りやすさ、締付けトルク、クリープ・締結強度は未検証の取合い試作。
幾何検査や追加サポート0というスライス結果は、実印刷成功や強度の保証ではない。

### 通し穴改訂の確認結果

- 3寸法と連結セットは閉メッシュ・各1連結成分。セット36.29×8.75×30 mm、約1052 mm³。
  中央断面の穴内接径は約3.500 mm。直径3.0／3.5 mmの全長ゲージと重なりなし。
- 六角本体は旧購入品六角胴の外形内。取付済み本体・ねじ・ナットの未解決干渉0。
  ブレースの外径8 mmソケット2経路、なべねじの軸径4 mm工具23本分で未解決干渉0。
  左右フランジの通常ソケットはデッキへ当たるため不採用とし、M3×26なべで固定する。
- X1C／Bambu PETG Basic／0.20 mm／壁4周／100%で20分24秒、1.27 gの見積り。
  サポートnormal(auto)、閾値45°、全面自動検出有効でサポート材押出0。
  最初の2層に4本すべてのつなぎ経路が残ることをG-codeと経路画像で確認。
- 基板取付穴の照合・内装包絡検査に合格。実印刷の滑り・強度は未検証。

管理ツール42テスト中41成功、1件は対象外の旧クランプ材料JSON欠落による既存エラー。全体印刷一式検査にも対象外の親機構成の未同期が残る。詳細は今回の_work/logs/spacer_clearance_*。
