AquaBeacon/mechanical/assemblies/nut_driver_af10/parts/DESIGN_NOTES.md

# 設計・印刷条件の控え（自動生成）

以下は設計元の文書を転記したものです。リンク先は元フォルダ基準です。印刷条件と未検証事項を確認してください。

## nut_driver_af10/README.md

# 対辺10 mm 六角ナット回し（片面蓋・指穴付き）

独立した手回し治具1個。構成の正本は `placement.json`、設計正本は [共通治具](../../parts/common/jigs/nut_driver_af10/README.md)。2026-10-25に片面蓋と指穴を追加した現行版。

印刷は [parts/PRINT.md](parts/PRINT.md) から。本体72 × 32 × 10 mm、六角ポケット対辺10.05 mm、指穴径22 mmを両端に配置。ナット軸から20 mmの位置に指先を掛けてぐるぐる回す。

片面の一体蓋は厚さ3 mmでナットの飛び出しを止める。開口側からは取り外せる。**ポケット深さ7 mmと蓋のボルト逃げ穴径7 mmは、ナット厚み・ボルト径未確認の仮設定**。実寸を確認して印刷する。

蓋の平面をベッドへ、六角開口を上に印刷する。PETGまたはPLA、0.4 mmノズル、0.2 mm積層、外周6周以上、充填80〜100%を試作条件とする。CAD上のナット挿入・蓋方向の通過阻止と閉メッシュを確認。実物嵌合・スライス・操作感・実機干渉・許容トルクは未検証。手回しの仮締め用。

2026-10-26：対辺全体の余裕を0.05 mm（片側0.025 mm）に変更。

## parts/common/jigs/nut_driver_af10/README.md

# 対辺10 mm 六角ナット回し（片面蓋・指穴付き）

正本は `nut_driver_af10.scad`。2026-10-25改訂：旧貫通六角穴から、片面蓋を一体化した六角ポケットへ変更し、両端に指穴を追加。旧版の44 × 24 mmモデルは現行印刷対象ではない。

## 寸法と仮設定

- 本体72 × 32 × 10 mm。六角穴対辺10.05 mm（指定ナット対辺10 mm、合計すきま0.05 mm（片側0.025 mm））。
- 六角ポケット深さ7 mm、蓋厚3 mm。**ナット厚み未確認のため深さ7 mmは仮設定**。実ナットが7 mmを超える場合は開口側へ突出する。直線駆動面は入口面取りを除いて約6.5 mm。
- 蓋のボルト逃げ穴：対辺径7 mmの補正32角穴。**ボルト径未確認のため7 mmは仮設定**。M6と確定したものではない。検査では径6.5 mmの包絡が通ることを確認。
- 指穴：内接径22 mm、中心X=±20 mm（ナット軸から20 mm）。大きい指や手袋の寸法は未確認。
- 外周上下・指穴入口面取り0.6 mm、六角入口0.4 mm、ボルト穴両入口0.3 mm、六角頂点R0.05 mm、ポケット底の角は0.01 mm面取り。底の面取りはナットすきま内で平らな受け面を維持。

## 使い方と保持経路

六角の開口側をナットへかぶせ、片方の指穴に指先を掛けて円を描くように回す。指穴は握りと一体で、独立した回転軸やベアリングではない。もう片方の指穴は持ち替えや逆回転に使える。周囲には本体の回転包絡（半径約36 mm）と指の空間が必要。実機干渉は未検証。

蓋は印刷座標Z=0〜3 mm、六角開口はZ=10 mm。ナットがZ負方向へ進むと、その端面が蓋内側の受け面に当たり、径7 mmのボルト穴からは抜けない。ボルトのみが蓋を通過する。開口側（Z正方向）への抜け止めはなく、両側保持の構造ではない。ナットは軸方向から挿入・取り外しできる。接着剤・追加ねじ・着脱蓋は不要。

駆動経路は指→指穴周囲→中央の肉→六角面→ナット。蓋は一方向の抜け止めであり、固定対象を締め付けるためのナット座ではない。手回しの仮締め用で、許容トルクや本締め強度は未評価。

## 印刷と検証

蓋側の平面を下（Z=0）、六角開口を上に印刷する。上下反転するとポケットの天井が生じるため、指定姿勢を守る。鉛直の指穴・ボルト穴・上面開放ポケットで、横穴や閉じた天井はない。下側の外周面取りは約45度。PETGまたはPLA、0.4 mmノズル、0.2 mm積層、外周6周以上、充填80〜100%を試作開始条件とする。サポートなしの実スライス、実ナット嵌合、指の操作感は未検証。

OpenSCAD出力成功。STLは閉メッシュ、法線方向整合、単一成分、外形72 × 32 × 10 mm。高さ0.01〜9.99 mmの11断面を検査。ポケット最下部を含め対辺10 mmのナット包絡が入る。蓋内部の全形状区間を断面と単調な面取り形状で追い、ナット包絡と蓋の重なり面積は各検査断面で35 mm²超。これは幾何学的な通過阻止の確認で、破壊強度・本締め成立を示さない。数値は `_work/analysis/geometry/validation.json`、画像は `_work/images/nut_driver_af10_preview.png`。

再生成入口は `./build.ps1 parts/common/jigs/nut_driver_af10 -NoStep`。この環境でランチャー経由のOpenSCAD read_symlinkエラーが出る場合、同じOpenSCAD CLIへ絶対パスと部品フォルダの作業ディレクトリを渡す。検証は `python spec/verify_nut_driver_af10.py`、納品同期は `python tools/assembly_parts.py sync nut_driver_af10`。

印刷の入口は [PRINT.md](../../../../assemblies/nut_driver_af10/parts/PRINT.md)。寸法を変えるときは正本SCADを変更し、STLを再生成してから同期する。

2026-10-26改訂：指定により対辺全体の余裕を0.05 mmへ縮小。実物嵌合は未検証。細かな角仕上げはCAD上の寸法であり、造形再現性は未評価。
