AquaBeacon/mechanical/assemblies/parent_exterior/parts/DESIGN_NOTES.md

# 設計・印刷条件の控え（自動生成）

以下は設計元の文書を転記したものです。リンク先は元フォルダ基準です。印刷条件と未検証事項を確認してください。

## parent_exterior/README.md

## 2026-10-29 素手で着脱するカメラ接続（試作・現行）

カメラ1台分の新しい印刷品は、共通カメラ本体1個、その機体用の受け1個、指掛け付きUスペーサ2個、手回しノブ2個、ノブ蓋2個。前側押さえは後続の右5 mm追加移動で更新。フレーム・ガード・ライトは維持。変更した本体と押さえは `print_jobs/camera_clamp_right5_20261029/`、受けと手回し部品は `print_jobs/camera_hand_release_20261029/` を参照する。購入金具は各機に六角頭M3×30 2本（頭部二面幅5.5 mm・厚さ2 mmを仮定）とM3普通ナット2個。従来のソケットねじ・ワッシャはこの接続に使わない。部品の入手状態と現物寸法は未確認。

初回のみ受けを既存フレームに固定し、各ねじをノブ上側から通して蓋を押し込み、六角頭を囲む。蓋の突起は保持用で、締付力はねじ頭→ノブの厚1 mmの印刷床→カメラ耳→Uスペーサ→受け→ナット屋根で受ける。初回の受け固定には工具が必要。ノブ床の強度、クリープ、蓋の弾性と繰り返し保持は未検証。蓋は中央円盤に4本の弧状アームを持つ。アームを長さ約6.8 mm・幅1.75 mmの直線片とみなし、先端を0.15 mm曲げた簡易見積りは表面ひずみ約0.9%であり、曲がった実形状や積層を含む強度解析ではない。

通常の取外しはカメラを支え、各ノブをねじ山が外れるまで緩める。必要に応じてノブを約0.5 mm持ち上げ、頭の座面が約3.8 mm上がった状態にする。先にUスペーサの指掛けをつまんで接続座標の−Xへ抜き、次に各ねじ・ノブを受けの外側へ横に滑らせて外す。その後カメラを60°回して軸方向に引き抜く。取付は逆順で、カメラを回してからねじを横から入れ、スペーサを入れてノブを手で締める。落下防止コードを別に取り付ける。

親子の実メッシュで、接触・ナット反力・ノブの六角回り止め・蓋の引抜き障害と、上記の離散位置を検査した。指先φ9 mmからφ16 mmへ広がる長さ25 mmの指2本を同時に仮定した進入・引抜きも検査した。手全体、連続掃引、実物寸法、濡れた手での操作、締付力、振動・強度・爪の耐久は未認定。ケース幅95 mmは仮値、厚さ41 mmは既存実測値。特に解除途中のノブと仮ケースのZ方向すきまは約0.4 mmのため、現物の形状と寸法で確認する。詳しい結果は `_work/analysis/clamp_right5_20261029/geometry_hand_checks.json`。既存節の数値・94項目等は旧版の履歴であり今回に流用しない。

## 履歴：2026-10-29 工具締付け版（上記の素手着脱版に置換）

**履歴：この節は前側押さえの追加移動前の工具締付け版。** 各機で共通カメラ本体1個、専用受け1個、Uスペーサ2個を交換する。旧カメラの3MFを使わない。全機体のSTL一覧と今回の交換分を混同しない。

親機外装の40×40 mm取付穴、受け背面、カメラの配置は維持する。外装プレートの加工・再印刷は不要。既存受けを新しい受けへ交換する。

回転後、Uスペーサ2個を差し込み、M3×30ソケット2本・外径7×厚0.5 mmワッシャ2枚・M3普通ナット2個で接合面を締め付ける。旧横ロックねじ・ノブ・ゴム2枚は廃止。解除はカメラを支え、両ねじとワッシャを外し、スペーサを接続座標−Xへ14 mm以上抜いてから60°回して引き抜く。独立落下防止コードを使用する。

[設計寸法・締結経路・組立手順](../../parts/child/exterior/printed/dji_osmo_action6_mount_m3/README.md)。ケース厚さ41 mmのみ実測、幅95 mm・高さ75 mmなどは既存仮値。仮ケースと直径8 mm工具の横方向余裕は0.5 mm。実物で工具が通ることと接触位置を確認する。

### 検証状況

最終R1の正式STLで、閉メッシュ・単一連結、両機の静止干渉、接触座面、ナットの回り止めと引抜き反力、横挿入の掃引包絡、ねじのかかりと底付き、子機4点の締結経路、工具通路、スペーサ抜去と回転解除を検査し94項目PASS。非カメラSTL90件は作業前SHA-256と一致。回転は5°刻み、スペーサ抜去は0.5 mm刻みのサンプル検査であり、連続すきまの保証ではない。実物の締結力・濡れた状態の保持・クリープ・疲労・強度は未認定。

[機械可読検査結果](../child_horizontal_plate_frame/_work/analysis/camera_fixture_20261029/fixture_checks.json) / [設計条件](../child_horizontal_plate_frame/_work/analysis/camera_fixture_20261029/design_contract.json)。STEP・スライス・印刷セットの最終検査状況はこの節末の納品記録を参照。

### 再生成

共通治具：`python spec/build_camera_mount_m3.py --twist-only`。子機受けは既存SCADの`part="camera_receiver"`をレンダー、親機受けは既存`qr_source()`から生成してfemaleをレンダーする。旧`spec/configure_camera_twist.py`は廃止。配置は`python spec/configure_camera_fixture_clamp.py`、検査は`python spec/verify_camera_fixture_clamp.py`、STEPと組立は`python spec/export_camera_fixture_clamp.py`。変更しない既存バリアントは同値再レンダーで元のSTLバイト列を維持する。最後に対象assemblyの`tools/assembly_parts.py sync`と`check`を行う。

印刷入口：[parts/PRINT.md](parts/PRINT.md)。カメラ本体は底板下、受けは取付面下、スペーサは平面下。Generic PETG・0.1 mm・6壁・15% Gyroidを検証条件とする。カメラ裏側・C爪の支持材、受けナット溝屋根のブリッジを確認し、機能面を傷つけず支持材を除去する。

### 納品検査（2026-10-29）

変更4形状のSTEPは保存後に再読込し、全て有効な1ソリッド、STLとの外形差0.01 mm未満・体積差0.0025未満を確認。[STEP照合](../child_horizontal_plate_frame/_work/analysis/camera_fixture_20261029/step_checks.json)。親機全体STEPは107配置・0 NG、両機の組立STLと確認SCADを更新済み。

X1C／0.4 mm／Generic PETG／0.1 mm／6壁／15% Gyroid／自動支持（ベッドのみ）で4形状をスライスし、警告なし・造形域内。壁・支持・ナット溝屋根前後の層を確認した。スペーサは支持検出を有効にして支持0。これは実印刷の成功保証ではない。親受けの張り出し下面とカメラ裏側の支持材を除去し、ナット挿入溝と締結面を確認する。

[今回のスライス記録](print_jobs/camera_fixture_clamp_20261029/README.md)。3MFは1形状1個ずつ。スペーサは各機2個、両機で計4個必要。共通カメラ本体は両機で計2個必要。旧3MFは履歴として保持する。

対象2構成の印刷一式の出所・個数・更新状態はPASS。workspace整理検査もPASS。全体チェックには今回触れていない親機内装系6構成の既存未同期が残る。tools/testsは42件中41件PASS、既存材料カード`child_wte4_suspension_clamp/spec/bambu_petg_basic_material.json`欠落による1件ERROR。今回の治具検査とは分けて扱う。

治具の取付状態

---

## 2026-10-29 カメラ前側押さえの追加移動

前側L字押さえと本体取付床・M4穴を正面から右へさらに5 mm移動。局所座標の接触帯 X=5.5..30.5、M4軸 X=11.5, 24.5。M5爪への干渉を避けるため足に局所逃げを設ける。カメラ姿勢と素手で着脱する回転接続は維持。変更した本体・押さえの3MFは print_jobs/camera_clamp_right5_20261029/、それ以外は従来の手操作版を使う。実物での締付け・保持・干渉は未確認。

## 2026-10-26 カメラ押さえ（履歴：下記の右5 mm追加移動で置換）

現行の印刷一式は13種類16個。

背板に追加していた四角い突出パッドを撤去。元の背板を後側の当たり面とし、前側押さえも位置を合わせて41 mmの間隔を維持する。実物のM5軸からケース背面までの距離は未測定。実測厚さ41 mmに合わせ、幅25 mmの前側押さえと取付穴・ねじを正面から見て右へ12 mm移動。左端から12〜37 mmの範囲を前後で挟む。中央M5固定爪と横方向に2.85 mm離し、20 mm移動版の足の切欠きは廃止。camera_mount_twist本体1個とcamera_front_clamp前側押さえ1個へ更新。追加はM4×16ソケット2本、M4ナット2個、外径9×厚0.8 mmワッシャ2枚。前側のL字足をカメラ下側へ反転し、元の左右底面受けを撤去。前方への張り出しは16 mm短縮。前側は0..3 mm開けて位置合わせし、下面からM4ねじを締める。ねじ頭とワッシャは底面に埋め込み、ナットは足の上側へ入れる。R1外縁・R3根元フィレット付き。背面下側20 mmの逃げを維持する。

[寸法・締結経路・印刷・検証](../../parts/child/exterior/printed/dji_osmo_action6_mount_m3/README.md)。ケースの幅・高さ・M5軸からの位置は既存仮値で、実物の新方式の保持力は未認定。親子共通2部品の印刷ジョブはparent_exterior/print_jobs/camera_clamp_clearance_20261026/。印刷入口はparts/PRINT.md。旧カメラ用3MFは使わない。

## 2026-10-25 カメラ旧版の実物評価（履歴）

2026-10-24版は実物で十分に回転を止められなかった。旧版の再印刷指示は取り消し、上記の前後押さえ方式へ更新した。

## 2026-10-25 TD04A固定治具 Rev.6（現行）

TD04A改訂時点の印刷一式は12種類15個。共通治具をM4・12 mmピッチ（実測前）、穴列基準でケーブル逃げ60 mmへ更新。親機は送受信面下向き、子機は上向き。旧TD04Aモデルは使用しない。[設計・ねじ・未確認事項](../../parts/common/exterior/printed/td04a_bracket_mount/README.md)。現行データはparts/PRINT.md。下記の旧TD04A支持・押さえ金具の記述と古い全体個数は今回の配置に適用しない。実物の耳厚・正確なピッチ・本体・配線根元・締結・強度は未検証。

# 親機外装・後付け位置決めプレート Rev.7

## 2026-10-24 カメラ底面受けの更新（旧版）

カメラ背面下側の突起に対し、左右受けを背面から20.5 mm前方へ退避した共通camera_mount_twistへ更新。背板・C接続・M5軸・配置は維持。カメラ治具1個を再印刷する。左右受けの範囲で床上Z=8..36.5の背面20 mm空間を確保し、中央M5爪と床は残す。実ケースの突起高さ・幅、接触と締結・回転保持力・強度は未検証。

[寸法と検証の詳細](../../parts/child/exterior/printed/dji_osmo_action6_mount_m3/README.md)。2026-10-21のカメラ3MFは旧形状の履歴。現行STLはparts/内を使い、新しい共通カメラ3MFは親機のprint_jobs/camera_bottom_clearance_20261024/に保存する。下記の旧カメラの支持位置・スライス時間・質量は今回の結果に適用しない。

2026-10-22。防水容器の下側プレートから位置決め部を分離し、左右レール2個・前後アーム2個を後からねじ止めする方式へ変更。配置の正本は[placement.json](placement.json)、印刷入口は[parts/PRINT.md](parts/PRINT.md)。全体は13種類16個。

**上側押さえ1個と脚2個は印刷済み。形状と配置を維持し、旧印刷データとの形状差0を確認した。再印刷は不要。今回変更した印刷物は下側プレート1個と位置決め部4個の計5個。** カメラは2026-10-21の小型・Cオス一体型を継続し、別体オス・旧角度ストップを追加しない。

parts/に保存されていた上側押さえと脚の3MFは、3部品とも回転・平行移動を除いて現行STLと一致することを照合し、[印刷済みジョブの履歴](print_jobs/printed_upper_and_skids_20261021/README.md)へ原本のまま移動した。元の保存層厚0.28 mmは保持する。

## 下側プレートと後付け位置決め部

主プレートはタブ込み240×134×20 mmの平板。三点支持Z=0、主面Z=-0.8、下面Z=-20、既存のM5全ねじ穴・カメラCメス・TD04A・ロープ穴と予備M4穴15箇所は維持する。元の一体アームや柱はプレートに残さない。

下側プレート単体

| 別体部品 | 個数 | プレートへの固定 | ナットの装着 |
|---|---:|---|---|
| 左右レール | 各1 | M4×20ソケット 各2本・上から | プレート下面の六角ポケット、脚より先に挿入 |
| 前後アーム | 各1 | M4×25ソケット 各2本・下から | プレート上面の六角ポケット、箱を載せる前に挿入 |

取付用は合計M4×20が4本、M4×25が4本、M4普通ナット（二面幅7・厚3.2 mm）が8個。左右のねじ座面Z=1.3、ナット上面Z=-12.3、ねじ先端Z=-18.7で、脚上面Z=-20に対し1.3 mmの隙間。下面から入れたナットを六角穴の天井で受けるため、締付時に上へ抜けない。

前後アームは厚12 mm、下面Z=-32・プレートとの接触面Z=-20。ねじ頭座面Z=-27.3、ナット底Z=-7.3、先端Z=-2.3で箱底へ出ない。固定端Y=115、左側基準X=-105、押しねじの位置と既存圧力パッド3個は維持する。横方向の押しねじは位置調整用で、上記8本の取付ねじとは別。

左右レールは長さ98 mmの一体部品。ロープ穴の外周を回る約3.2 mm以上の背骨を設け、小さな分断片を作らない。前後アームも小片へ分割せず、根元の丸め・補強を維持する。箱・カメラ・TD04Aを外し、ナット・位置決め部を締結してから脚と箱を装着する。既存の脚を加工する必要はない。

今回の5個の3MF・材料・設定・STLハッシュは[変更分の印刷ジョブ](print_jobs/removable_locators_20261022/README.md)。旧Rev.6主プレートの3MFを新しい平板として使わない。

位置決め部をねじ止めした状態

今回の5個はX1C・0.4 mm・PETG Basic・0.2 mm層・8壁・100%充填。前後アームはY=90°で側面を下、左右レールと平板は底面を下。45°の自動支持を有効・モデル上も許可した検査では、ナット穴・通し穴と縁/補強部に少量の支持材が残る。印刷ジョブに実経路の図と見積りを記載する。箱・脚を付ける前に穴内と座面から除去する。全品支持材0という条件ではない。

下面のカメラ接続

## カメラの接続とネジ

- 印刷するカメラ部品はcamera_mount_twist.stl。60×60×厚6 mmの接続板とCオスを一体化し、旧別体QRオス、M3×14ねじ4本・ナット4個を省く。左右受けは上記の前方位置へ更新し、M5軸とC接続位置は保持する。元の背面M3穴には取付ねじを追加しない。
- Cメスは現行主プレートの40×40 mm穴へM3×25・M3ナット各4個で固定。頭座面Z=-27.4、ナット底Z=-6.5、先端Z=-2.4で箱底Z=0へ出ない。箱を載せる前にナットを入れる。
- 六角頭M3×40、既存φ16ノブ、M3ナット、φ7×厚0.5ワッシャ、5×8×厚1 mmゴム2枚を流用。カメラを支え、横ボルト・ワッシャ・ノブを機体+Yへ45 mm以上抜き、下から見て時計回り60°回して下へ抜く。独立落下防止コードを使う。
- 接続板だけに深さ1.2 mm・入口0.3 mmの開放逃げを追加し、ノブ周囲の操作余地を作る。C爪・カム・ゴム座の機能形状は変更しない。
- 外側の「○△○」前壁と不要な底板延長を廃止。親機の別体角度ストップ、左右の橋固定ねじ・調整M4ねじ・ナット類も取り外す。M5固定とZ=36.5の左右底面受けは維持する。

## その他の外装と取付

Rev.7平板の主面232×134 mm、公称厚20 mm、Z=-20..-0.8。三点基準のみZ=0。予備M4穴15個は[穴配置JSON](../../spec/parent_oneplate_mounting_pattern.json)が正本。厚7 mm・径12 mmの参考治具とM4×25の例のみ検証済み。未知の治具全体の干渉・荷重まで保証しない。予備穴のナットは箱を載せる前に入れる。

TD04A支持はXY=(65,-55),(85,-55)、上面Z=-20へM5×40皿ねじ2本・ワッシャ・ナット各2個で固定。頭上面Z=-0.8、ワッシャZ=-29、ナット底Z=-33。M4クランプ中心Z=-35、金属ブラケット基準X=43・Z=-27を維持。M5全ねじ180 mmを4本、下側ワッシャZ=-31・ナットZ=-35、上側ワッシャZ=122.3・ナットZ=123.3。地上自立時はカメラユニットとTD04A本体・押さえ板・M4押さえねじを外す。接地面Z=-72より上へ配線を保持する。

## 印刷・検証・再生成

parts内の現行STLをPRINT.mdの数量だけ使う。一体カメラは底板下、X1C・0.4 mm・Generic PETG、0.1 mm層、6壁、15% Gyroid、ブリム5 mm、ベッドからの自動サポート。背面接続板・軸・爪の外部支持を除去できる姿勢で、実G-codeの支持はZ=0.2..34.7にある。C摺動面を傷つけずに取り除き、初回は実メスとの嵌合を確認する。[今回のカメラ3MF](print_jobs/camera_twist_20261021/camera_mount_twist/camera_mount_twist.3mf)は1個入り、約5時間18分・106.0 g。他部品は従来のPETG Basic・8壁・100%充填と製造メタデータの姿勢を継続する。

旧[x1c_petg_rev6](print_jobs/x1c_petg_rev6/README.md)の6プレートは変更前の履歴。旧カメラ・別体オス・旧一体位置決め主プレートを含むため、現行一式として印刷しない。camera_twist_20261021の3MFは現行カメラ1個用。Rev.7の5個の3MFは今回変更したプレートと位置決め部だけで、全13種類16個のジョブではない。

C一体化時点（2026-10-21）は全配置73部品のSTEP照合0 NG、当時9種類のSTEP有効性・外形・体積、ネジを含む干渉、Cの60°回転・80 mm抜去、ロック45 mm抜去を検査した。[当時の幾何検査](_work/analysis/support_reduction/geometry_checks.json)、[当時のSTEP検査](_work/analysis/support_reduction/step_checks.json)、[現行カメラのスライス](print_jobs/camera_twist_20261021/camera_mount_twist/validation.json)。実印刷・実ケース・ケーブル・画角・強度・クリープは未認定。

Rev.7では全配置93部品・現行13種類のSTEPとSTLを照合。実体の干渉0、取付8穴の通過・頭/ナット座・ねじ先端と工具、予備15穴・ロープ4箇所、Cの脱着経路を再検査した。印刷済み上側押さえ・脚の形状差は0。[今回の幾何検査](_work/analysis/removable_locators_20261022/geometry_checks.json)、[STEP検査](_work/analysis/removable_locators_20261022/step_checks.json)、[保存3MFと全層の経路検査](_work/analysis/removable_locators_20261022/slice_checks.json)。直前の73部品・9種類の記録はC一体化時点の履歴。

今回の再生成はspec/prepare_parent_oneplate.py、配置はspec/configure_parent_exterior_removable_locators.py。検査はspec/verify_parent_exterior_removable_locators.py、交換用STEP・組立はspec/export_parent_exterior_removable_locators.py、スライスはspec/slice_parent_exterior_removable_locators.py、印刷ジョブ説明はspec/finalize_parent_exterior_removable_locators.py。その後tools/assembly_parts.py sync parent_exteriorを実行する。[変更前の正本・印刷済み部品の参照](_work/analysis/removable_locators_20261022/history/snapshot.json)を保持する。

Rev.7の対象印刷一式はcheck合格、整理検査も合格。全体チェックでは対象外の既存構成に出所不整合・未管理3MFが残る。共通テスト42件は41件合格・既存child_wte4_suspension_clampの材料JSON欠落1件でエラー。今回のログは_work/logs/removable_locators_global_parts_check.log、removable_locators_tidy_check.log、removable_locators_unittest.log。

設計元はspec/build_camera_mount_m3.py --twist-only。既存camera_mount.scadを再利用する生成バリアントで、出力を手編集しない。配置はspec/configure_camera_twist.py、検査はspec/verify_camera_twist.pyとspec/verify_parent_exterior_support_reduction.py、交換用STEPと組立STLの更新はspec/export_camera_twist.py、スライスはspec/slice_camera_twist.py。その後tools/assembly_parts.py sync parent_exteriorとcheckを行う。主プレート等は既存spec/prepare_parent_oneplate.py系統が正本のまま。

[変更前の配置・説明・印刷一式](_work/analysis/camera_twist_20261021/history/snapshot.json)を保持。共通42テストは41件合格・既存の材料JSON欠落1件でエラー。対象外の印刷一式には既存の出所不整合があり、今回の検査と分けて記録する。

前壁付きの設計元・STL・STEPはカメラ部品の_work/analysis/compact_front_20261021/history/、親機の旧配置・説明は[_workの履歴](_work/analysis/compact_camera_20261021/history/)、旧カメラ3MFは[print_jobsの履歴](print_jobs/history/camera_with_front_stop_20261021/)へ保持する。別体角度ストップを現行印刷一式へ戻さない。

[TD04A改訂後の全体確認画像](_work/images/td04a_cable_r6.png)。幾何・STL/STEP・外装側ナット保持・スライス結果は[共通治具の検証](../td04a_fixture/_work/analysis/validation_summary.json)。センサー側の実締結成立・実物適合・強度は未検証。

## parts/child/exterior/printed/dji_osmo_action6_mount_m3/README.md

## 2026-10-29 素手で着脱するカメラ接続（試作・現行）

カメラ1台分の新しい印刷品は、共通カメラ本体1個、その機体用の受け1個、指掛け付きUスペーサ2個、手回しノブ2個、ノブ蓋2個。前側押さえ、フレーム、ガード、ライトは変更していない。旧カメラ接続用3MFは使わず、今回の `print_jobs/camera_hand_release_20261029/` を参照する。購入金具は各機に六角頭M3×30 2本（頭部二面幅5.5 mm・厚さ2 mmを仮定）とM3普通ナット2個。従来のソケットねじ・ワッシャはこの接続に使わない。部品の入手状態と現物寸法は未確認。

初回のみ受けを既存フレームに固定し、各ねじをノブ上側から通して蓋を押し込み、六角頭を囲む。蓋の突起は保持用で、締付力はねじ頭→ノブの厚1 mmの印刷床→カメラ耳→Uスペーサ→受け→ナット屋根で受ける。初回の受け固定には工具が必要。ノブ床の強度、クリープ、蓋の弾性と繰り返し保持は未検証。蓋は中央円盤に4本の弧状アームを持つ。アームを長さ約6.8 mm・幅1.75 mmの直線片とみなし、先端を0.15 mm曲げた簡易見積りは表面ひずみ約0.9%であり、曲がった実形状や積層を含む強度解析ではない。

通常の取外しはカメラを支え、各ノブをねじ山が外れるまで緩める。必要に応じてノブを約0.5 mm持ち上げ、頭の座面が約3.8 mm上がった状態にする。先にUスペーサの指掛けをつまんで接続座標の−Xへ抜き、次に各ねじ・ノブを受けの外側へ横に滑らせて外す。その後カメラを60°回して軸方向に引き抜く。取付は逆順で、カメラを回してからねじを横から入れ、スペーサを入れてノブを手で締める。落下防止コードを別に取り付ける。

親子の実メッシュで、接触・ナット反力・ノブの六角回り止め・蓋の引抜き障害と、上記の離散位置を検査した。指先φ9 mmからφ16 mmへ広がる長さ25 mmの指2本を同時に仮定した進入・引抜きも検査した。手全体、連続掃引、実物寸法、濡れた手での操作、締付力、振動・強度・爪の耐久は未認定。ケース幅95 mmは仮値、厚さ41 mmは既存実測値。特に解除途中のノブと仮ケースのZ方向すきまは約0.4 mmのため、現物の形状と寸法で確認する。詳しい結果は 各assemblyの `_work/analysis/camera_hand_release_20261029/geometry_checks.json`。既存節の数値・94項目等は旧版の履歴であり今回に流用しない。

# 履歴：2026-10-29 工具締付け版（上記の素手着脱版に置換）

対象はカメラ固定治具だけ。既存の親機外装・子機フレーム・ガード・ライトは形状と配置を維持する。以下は工具締付け版の履歴であり、現在は上記の素手着脱版を使う。**この改訂の検証状況は両assembly READMEを参照。実物の保持力・強度は未認定。**

## 交換部品と締結

各機で共通カメラ本体 `camera_mount_twist` 1個、専用受け1個、共通 `camera_rotary_spacer` 2個を印刷する。ケースを挟む既存 `camera_front_clamp` はそのまま使用。ケースの実測厚さ41 mm、M5軸、前後押さえは変更しない。ケース幅95 mm・高さ75 mm等は既存仮値であり、実物での工具余裕を確認する。

回転接続は60°の着脱を残し、固定後にM3×30ソケットねじ2本、外径7×厚0.5 mmワッシャ2枚、M3普通ナット（AF5.5・厚2.4 mm）2個で締め付ける。旧横ロックねじ・ノブ・ゴム2枚は使用しない。

受け座標の締付軸はX=0,Y=±52 mm。締結経路は、ねじ頭座面Z31→ワッシャZ30.5..31→カメラ側耳Z18.5..30.5→着脱UスペーサZ8..18.5→受け側耳Z0..8→ナット上面の屋根Z4.8。ナットは横から挿入し、締結時に+Zへ引かれて屋根で止まる。締結位置のナットはZ2.4..4.8。ねじ先端Z1、穴底Z0.5、ナットから1.4 mm突出。ねじ山はナット全厚2.4 mmにかかる。

ナットの回り止めと上向き抜け止めを別々に検査する。ナットの外向き挿入溝は組立用なので、ねじを外したときにナットが横へ落ちないよう扱う。接着剤を締結反力の代用にしない。スペーサの公称厚さ10.5 mmは面間寸法と一致する。印刷後、支持材や初層の張り出しを除去し、手で挿入できることを確認する。入らないものをねじで無理に押し込まない。

## 組立と解除

1. 受けを外装へ取り付ける。子機はカメラを取り付ける前に4点を締結する。
2. 受けのナット2個を横から入れる。カメラを差し込み、60°回して固定位置へ合わせる。
3. Uスペーサ2個を接続座標の+X方向へ差し込み、M3×30とワッシャを装着する。左右を交互に締め、各接触面が着座していることを確認する。規定トルク・保持荷重は実測未認定。
4. 解除時はカメラを支え、両ねじとワッシャを完全に取り外す。Uスペーサを接続座標の−Xへ14 mm以上抜く。その後に60°回して外へ引き抜く。スペーサを残したまま回さない。独立落下防止コードを使う。

## 正本・印刷・検証

共通接続形状の正本は `scad/lib/camera_rotary_joint.scad`、カメラ本体とスペーサの生成は `spec/build_camera_mount_m3.py`。子機受けは既存 `child_horizontal_twist_mount.scad` の `camera_receiver` 専用分岐、親機受けは `spec/parent_exterior_revision_sources.py` の `qr_source()`。ライトの旧Cモジュールは変更しない。

配置は各assemblyの `placement.json`、配置更新は `spec/configure_camera_fixture_clamp.py`。旧 `configure_camera_twist.py` は旧形状へ戻すため実行禁止。検証は `spec/verify_camera_fixture_clamp.py`。交換部品STEPと組立の更新は `spec/export_camera_fixture_clamp.py`。印刷一式の入口は各assemblyの `parts/PRINT.md`。

カメラ本体は既存と同じ底板下、受けは外装取付面を下、Uスペーサは厚さ10.5 mm方向を積層方向にする。新規耳は面取り0.4 mm、外周R2、スペーサ外周R1.2・面取り0.4 mm、穴入口0.25 mm。Cの機能面は接触・挿入条件を優先する。カメラ背面とC爪、受けのナット溝屋根は支持／ブリッジの確認対象。スライスの有無と結果はassemblyの検証欄に記録する。

CADの閉メッシュ・干渉・締結経路・スライスと、実印刷・濡れた状態の保持力・クリープ・疲労は区別する。荷重、材料物性、積層方向を使う強度解析は今回未実施。

---

# 2026-10-29 前側押さえをさらに右へ5 mm移動

前側L字押さえと本体取付床・M4穴をローカル −X へ5 mm移動。接触帯 X=5.5..30.5、M4軸 X=11.5, 24.5。M5爪を避ける局所逃げを追加し、カメラ姿勢と素手着脱式回転接続を維持する。実物の締結・保持は未確認。

# 履歴：幅25 mm・右へ12 mm移動した前後押さえ（2026-10-29で置換）

2026-10-26位置改訂。前側押さえ・床延長・取付穴を正面から見て右へ12 mm（ローカルX=-12 mm）移動。背板から前へ張り出していた四角い追加パッドを撤去し、元の背板を直接後側の当たり面として使う。前側押さえの足をカメラ側へ反転し、元の左右底面受けは撤去。前方端をY=45.49から29.49へ16 mm短縮。ユーザー実測のケース厚さ41 mmを採用。2026-10-24の底面受けだけでは回転保持が不十分だったため、正面から見て左端から12〜37 mmの幅25 mmを後側受けと別体の前側押さえで挟む。実物での新方式の回転保持・強度はまだ未検証。

## 現行の部品と位置

親機・子機は共通でcamera_mount_twist（Cオス一体の本体）1個とcamera_front_clamp（前側押さえ）1個を使う。追加購入品は各機M4×16ソケットねじ2本、M4普通ナット2個（二面幅7・厚3.2）、外径9・内径4.3・厚0.8 mmワッシャ2枚。元のカメラM5固定とCロックは継続する。

座標は+Yがカメラ正面、+Zがカメラ上。正面側から見る左は+X。ケース幅95 mmは既存仮値なので、押さえの対象域はX=10.5..35.5（旧X=22.5..47.5）。ねじ中心はX=16.5,29.5。背板の既存面Y=-23.45を後側基準とし、前側の当たり面をY=17.55に合わせ、公称41 mmの間隔を維持する。ケース参照モデルも同じ背面基準へ移した。実物のM5軸とケース背面の距離は未測定なので、実物の取付角・当たりの確認が必要。旧45.9 mmはC接続／背板位置の互換用寸法だけに残し、ケース厚さとして使わない。

前後受けの公称間隔41 mm。前側押さえは長穴で外向きに0..3 mm開け、ケースに当ててから固定する。後側は追加パッドではなく元の背板。前側25 mmの接触帯に対し、背板との重なり幅は25 mm（X=10.5..35.5、中央開口と既存取付穴があるため全面接触ではなく、右寄りの帯と上側で受ける）。前側接触高さはケース底から約1..30.5 mm。ケース幅95・高さ75、M5軸から底まで12.5 mm、実物のM5軸からケース背面までの距離は引き続き未測定。今回確認できた実測値は厚さ41 mmだけ。左右／上下の正確な接触位置とボタン・ケース継ぎ目・画角は実物確認が必要。

左右の底面受けを撤去し、背面下側の突起に対する背面20 mmの空間も維持する。前側押さえの内向き足はY=0.55..25.55、床延長はY=3..29.5。中央M5爪と床は残す。中央固定爪と押さえを横方向に分離し、公称2.85 mmの隙間を確保。20 mm移動版で追加した切欠きを廃止し、通常のL字足へ戻した。元の背板がケース背面を受け、底面の突起を挟まない。

## フィレットと印刷

新しい前側押さえ・前側床延長の外縁はR1の3Dフィレット。前側押さえの立ち上がり根元はR3の凹フィレット。既存背板の外縁もR1、後側補強リブの輪郭もR1に変更。ねじ座面・ナットの回り止め・M5嵌合・C摺動面は機能面を保持し、穴／長穴入口は0.25〜0.3 mm面取り。メッシュ近似による外形誤差は約0.01 mm。

本体は底板、前側押さえは足の下面をベッドへ向ける。X1C・0.4 mm・Generic PETG・0.1 mm層・6壁・15% Gyroid・ブリム5 mm、ベッドからの自動支持。本体下面のねじ頭用座ぐりとC部の支持材を除去してから組む。前側押さえも自動支持を有効にしてスライスする。足・ナット座付近の支持材を除去し、ナットが座面まで挿入できることを確認する。印刷入口は各assemblyのparts/PRINT.md。旧camera_clamp_right20_20261026、camera_left_clamp_flush_20261025、camera_left_clamp_inward_20261025、camera_left_clamp_20261025、camera_bottom_clearance_20261024、camera_twist_20261021のカメラ3MFは旧形状であり今回使わない。

## 締結と組立（内向きL字・下面から締付け）

1. 前側押さえの足の上側からM4ナット2個を入れる。ナットはZ=10.6..13.8、長穴状の六角座はX方向で回り止めし、下側の座面Z=10.6が締付け時の下向き反力を受ける。座の下の肉厚は2.6 mm。ケース装着前にナットを入れる。
2. 本体下面からワッシャとM4×16ソケットねじを入れ、前側押さえへ仮止めする。ケースをM5取付部へ装着して背側受けへ当て、前側押さえを寄せてから下面から2本を交互に締める。0..3 mmの位置調整は手で行う。
3. 締結経路はねじ頭座面Z=4→ワッシャ0.8→本体床の反力面Z=4.8→本体床上面Z=8→前側足の下面→ナット下面Z=10.6。ナットは-Zへ引かれて足の座面で止まり、ねじ頭・ワッシャは+Zへ引かれて本体の段付き穴の天井で止まる。D9.6の座ぐりに頭とワッシャを収納し、ねじ頭下面はZ=0で突出しない。段付き穴上の肉厚3.2 mm。M4×16を流用し、先端Z=20、ナット上端から6.2 mm突出するがケース底Z=36.5まで16.5 mm残す。かかりはナット全厚3.2 mm。工具はY=11.5の穴に本体下面側から入れる。
4. 前後の押さえがケースの回転に反力を与える。長穴部の位置保持はねじの締付けによる摩擦に依存するため、濡れた状態での滑り・締付トルク・長期クリープは実物試験が必要。防水ケースを変形させる過大な締付けは避ける。独立落下防止コードを使う。

## 正本と検証

正本：spec/build_camera_mount_m3.py。camera_mount.scad、camera_left_clamp.scad、camera_front_clamp.scad、camera_case_41mm.scadは生成物。再生成はpython spec/build_camera_mount_m3.py --parts-only。配置はspec/configure_camera_left_clamp.py、検証はspec/verify_camera_left_clamp.py、STEP・組立はspec/export_camera_left_clamp.py。支持形状を変更したため旧底面受け検査のPASSを流用しない。

結果は_work/analysis/clamp_clearance_20261026/。閉メッシュ、前後接触、±0.5°の剛体回転阻止、背面退避、ねじ・工具、ナットの挿入／回り止め／-Z保持、親子組立干渉、C離脱経路を分けて検査する。離脱経路は離散検査で連続掃引保証ではない。CAD接触・回転阻止は実物の締結成立や保持力の保証ではない。旧版と文書の原本は同解析フォルダのhistory/に保存。

## parts/common/exterior/printed/td04a_bracket_mount/README.md

# TD04A固定治具 Rev.6：12 mmピッチ・ケーブル逃げ60 mm

2026-10-25ユーザー指定。正本はtd04a_bracket_mount.scad。旧TD04A本体モデルは使用しない。過去の10 mmピッチと親機形状保持の条件を今回の指定で更新した。旧データはassemblies/td04a_fixture/_work/analysis/cable_clearance_r6/history/に保持。

- TD04A取付はM4貫通ねじ＋普通ナット2組、CADの穴中心間隔12 mm、内接クリアランス径4.5 mm。「約12 mm」の指定であり実測一致の認定ではない。
- 送受信面は親機-Z、子機+Z。取付面はその面に直角という既存の取合いを引き継ぐ。本体の仮形状は表示しない。
- 穴列から外装側へ60 mmを確保。板厚5 mm、穴列オフセット65 mm、治具長75 mm。親機はフランジ下面から穴列まで60 mm。子機は穴列より下へ60 mmの予約域。図の幅12×奥行15 mmは検査用の仮幅で、実ケーブルの根元・曲げ半径まで確認した意味ではない。

## 実配置と締結経路

親機：parent_exteriorの既存XY=(65,-55),(85,-55)のM5穴を使用。治具原点(53,-55,-20)、Z回転-90度。接触面Z=-20、治具下面Z=-25、M4穴列Z=-85。M5×40皿頭→主プレート→治具5 mm→M5ワッシャ1 mm→M5ナット4 mm。ワッシャZ=-26..-25、ナットZ=-30..-26。皿ねじの先端Z=-40.8、ナット下面からの突出10.8 mm。防水容器を外して上から皿頭へ工具を入れ、下からナットを保持して組み立てる。既存ねじ先端の突出は長めなので、TD04A実物との干渉を初回確認する。ナットは下から工具で保持し、締付時の+Z移動はワッシャと治具下面で受け、主プレートを挟む。旧押さえ金具・クランプねじ・TD04A参照モデルは今回の配置から外す。親機内外装統合等の旧構成へは自動反映しない。

子機：child_horizontal_plate_frameの既存右後側M3縦2穴を使用。治具原点(122,-74,108)、穴列X=148/160・Y=-74・Z=173。M3×20頭→φ7×0.5ワッシャ→治具5 mm→側板12 mm（内側2.8 mmナット座）→M3ナット。既存のナット座肩が締付時の+Xを受ける。内側からナットを入れ、外側から締める。側板加工なし。ねじ先端はナットから2.9 mm突出。穴位置・工具通路・ナット挿入・ケースとの干渉を検査し、軸方向保持は連続掃引形状でも検査する。

センサー側は後方からM4ねじ頭→φ9×0.8ワッシャ→治具5 mm→実物の取付耳→φ9×0.8ワッシャ→ナット3.2 mm。耳厚3 mmの仮定ではM4×14、先端突出1.2 mm。ナットはスパナで回り止めし、締付時に取付耳をワッシャ越しに受ける。耳厚・座面・穴縁肉厚は未採寸のため、センサー側の締結成立は未達。実物に合わせてねじ長さを決める。接着剤を保持に使わない。

## 印刷と検証の範囲

親機外形26×42×75、子機45×26×75 mm。親機[0,-90,0]でL字側面下、子機[0,0,0]でL字下端下。外周R1.5、内角R3、端面取り0.6、穴入口0.3、穴先端R0.15 mm。横穴は印刷+Zへ屋根を向ける。PETG Basic/X1C/0.4ノズル/0.2層/8壁/100%/ブリム5 mmを試作条件とする。実造形・荷重・クリープは未検証。

印刷入口は各assemblyのparts/PRINT.md。各外装に1個ずつを同梱し、td04a_fixtureのpartsは同じ2部品の比較用一式。両方を重複印刷しない。旧Rev.5の3MFは現行形状に使わない。

再生成：python spec/rebuild_td04a_fixture.py → python spec/install_td04a_fixture.py → python spec/check_td04a_fixture.py → python spec/check_td04a_exteriors.py。外装組立はbuild.ps1 -Assembliesで再生成、印刷一式を同期する。SCADが正本、STEPは交換形状。閉メッシュ・外形・干渉・ナット保持・スライスと実物締結・強度は別の検査。

Rev.6検証：部品67項目・外装8項目・STEP読戻しは合格。スライスと実G-codeの監査も合格。自動支持は少量を提案しており、支持無効試作の実印刷は未確認。共通42テストは41合格、既存材料JSON欠落1エラー。

## parts/parent/exterior/printed/parent_oneplate_bar/README.md

# 親機・一体型上側押さえフレーム Rev.3

正本はspec/parent_exterior_revision_sources.py（prepare_parent_oneplate.py経由）。従来の中実バー2本を、幅16 mm・厚20 mmの左右レールで一体化する。外形244×146×20 mm、中央開口は直線部180×74 mm、内隅R4。バー断面244×36×20 mm、M5穴4個のピッチ220×110 mm、箱上パッド4箇所と座面高さは維持する。追加レールは箱の蓋上面から2 mm離す設計。旧バー2個の代わりに本品1個を使用する。

平坦面Z=0を下にPETG Basic、0.2 mm層・8壁・100%充填・3 mmブリム、サポートなしで印刷する。外周・内隅を丸め、上下0.6 mmとねじ穴入口0.3 mmを面取り。M5×180全ねじ4本と金属ワッシャを使用し、対角順に軽く締める。許容トルク・クリープ・実保持力は未認定。

旧バーと配置・検証資料はassemblies/parent_exterior/_work/analysis/upper_clamp/history/に保存。既存部品名parent_oneplate_barは参照互換のため維持する。

## parts/parent/exterior/printed/parent_oneplate_box_locator/README.md

# 親機箱の後付け位置決め部 Rev.7

2026-10-22。side_left/side_right/end_fixed/end_pushの4個を主プレートへ後からねじ止めする。正本はspec/prepare_parent_oneplate.pyとspec/parent_oneplate_frame_sources.py。既存バリアントを更新し、旧一体版を現行印刷物へ混ぜない。

左右レールは長さ98 mm・幅15/14.5 mm。固定基準X=-105、押しねじ中心Z=12/Y=±38を維持。主プレート上面Z=-0.8へ載せ、上からM4×20ソケット各2本。頭座面Z=1.3。ロープ穴を迂回する約3.2 mm以上の外側背骨を残し、内側の薄い三日月部分を開放。小さな分断片を作らない。根元の局所補強は0.7 mm。

前後アームは幅20 mm・長さ74/80 mm・厚12 mm、下面Z=-32、接触面Z=-20。固定端Y=115、押しねじ高さZ=9を維持。下からM4×25ソケット各2本、頭座面Z=-27.3。ナットはプレート上面へ。既存の脚は変更しない。

左右は底面を下、前後はY=90°で側面を下に印刷。ねじ穴と前後アームのナット屋根は、その印刷上向きへ55°形状を向ける。外周R1〜2、縁0.4 mm・穴入口0.3 mm。PETG Basic・0.4 mm・0.2 mm層・8壁・100%・ブリム3 mm。自動支持では縁・補強部に少量が残るため、印刷ジョブの図で確認して除去する。座面・基準面へ残さない。

pressure_padは従来のM4ねじ頭径7×高さ4 mm用カップを3個継続し、独立した固定ねじは不要。底を下、0.2 mm層。箱を外すと脱落し得るため回収する。

取付金具はM4×20が4本・M4×25が4本・M4普通ナット（二面幅7×厚3.2）8個。横押し調整ねじとは別。ナットと位置決め部を締結してから脚と箱を装着する。実箱の補正値は未実測のまま0。実印刷・強度・反復位置決めは未認定。検査と印刷入口はassemblies/parent_exterior/README.md。

## parts/parent/exterior/printed/parent_oneplate_camera_qr/README.md

## 2026-10-29 素手着脱への改訂（現行）

カメラ専用の受けは外向きのねじ横抜き溝付き。初回固定は工具を使用し、以後のカメラ着脱はノブと指掛けスペーサで行う。現行条件・締結経路・制約は各assembly READMEの最上段を参照。旧横ボルト・旧ゴム方式は使用しない。

# 2026-10-29 カメラ受け・軸方向締付け改訂

既存親機外装の40×40 mm穴配置、受け背面Z=-10、カメラの配置は維持する。受けとカメラ側治具を交換し、2本の軸方向M3×30と着脱Uスペーサで締め付ける。既存外装の加工・再印刷は不要。旧横ロック・ノブ・ゴムは使わない。

正本は `spec/parent_exterior_revision_sources.py` の `qr_source()` と、共通の `scad/lib/camera_rotary_joint.scad`。生成SCADを手編集しない。既存の別体QRオスは現行assemblyに追加しない。

締結・解除・材料と仮寸法は[カメラ共通説明](../../../../child/exterior/printed/dji_osmo_action6_mount_m3/README.md)、検証状況と印刷入口は[親機assembly](../../../../../assemblies/parent_exterior/README.md)。後続の旧日付の記録は履歴。

---

> 2026-10-21：親機外装の現行構成はfemaleのみを使用する。maleは旧別体アダプタのバリアントとして保持し、現行のオスはcamera_mount_twistへ一体化した。下記male用M3×14・ナット各4個は現行構成では使わない。取付・数量は[親機外装](../../../../../assemblies/parent_exterior/README.md)を参照。

# 親機カメラ・C式クイックリリース

正本はspec/parent_exterior_revision_sources.py。共通quick_release_prototypes.scadのtwist_female()/twist_male()を直接再利用する。子機のC式と同じ60°回転・M3横ロック・厚1 mmゴム2枚。嵌合面・爪・カム・ゴム座は形状保持の例外とし、加工や一括丸めをしない。追加60×60取付板（female厚10、male厚6 mm）はR3・縁0.5 mm、穴入口0.3 mm。

Rev.4のfemaleは60×60×10 mm取付板で、平板下面Z=-20へM3×25 4本・ナット4個で直接固定する。ナット底Z=-6.5、ねじ先端Z=-2.4で箱底へ出ない。maleの取付板は厚6 mmのまま、既存マウント背面40×40穴へM3×14 4本・ナット4個。カメラ・C嵌合部・回転軸の位置はRev.3から維持し、マウント・角度ストップごと着脱する。オスのカメラ接触面はZ=-60.5。

横ロックは六角頭M3×40、M3ナット、φ7×0.5ワッシャ、既存φ16ノブ。横ボルト・ワッシャを抜き、下から見て時計回り60°回し、下へ抜く。取付けは逆手順。カメラに独立落下防止コードを付ける。ケース/TD04A参照形状は既存仮寸法を引き継ぐ。実ケーブル、手袋、締結・嵌合試験は別途必要。

female/maleとも追加板の平坦な外側面を下に印刷。PETG Basic・0.1 mm層。閉じたC機構内部へサポートを詰めない。初回に爪・カム・ゴム圧縮と横ボルトの通りを確認する。

## parts/parent/exterior/printed/parent_oneplate_frame/README.md

# 親機・後付け位置決め用の下側プレート Rev.7

2026-10-22。正本はspec/prepare_parent_oneplate.pyとspec/parent_oneplate_frame_sources.py。主面232×134 mm、公称厚20 mm、主面Z=-20..-0.8、三点支持のみZ=0。ロープタブ込み240×134×20 mm。位置決め部4個は別体とし、印刷後にねじ止めする。印刷済みの上側押さえ・脚の取合いを維持。

左右レール：XY=(±110,±8)、上からM4×20ソケット4本。下面の六角穴は天井Z=-12.3、ナット底Z=-15.5。ねじ先端Z=-18.7で脚より1.3 mm上。下面からナットを入れ、レールを締結してから脚を付ける。ナット上面を天井で受けるため締付時に上へ抜けない。

前後アーム：XY=(94,52),(94,62),(-94,-52),(-94,-62)、下からM4×25ソケット4本。ナット底Z=-7.3、頭座面Z=-27.3、先端Z=-2.3で箱底へ出ない。箱を載せる前に上面へナットを入れる。M4普通ナットは計8個。ねじ長さを変更した場合は再検査する。

径10.5 mmの縦ロープ穴4個（X=±111.5/Y=±23）、M5ロッド穴、TD04AとカメラCメス、予備M4穴15箇所を維持。穴配置はspec/parent_oneplate_mounting_pattern.json。厚7 mm・径12 mm治具とM4×25の取付例は先端Z=-2。未知の治具全体は別途検査する。

下面をベッドへ。PETG Basic・X1C・0.4 mm・0.2 mm層・8壁・100%・2 mmブリム。45°自動支持・モデル上も許可したスライスでは、下面ナット座の天井に少量の支持材が残る。六角穴から除去しナットが天井まで入ることを確認する。外周R3・縁0.4 mm・穴入口0.3 mm、機能座面を保持する。

実ねじ・工具・ロープ・印刷済み脚の検査と印刷入口はassemblies/parent_exterior/README.md。実印刷・嵌合・締結・強度・クリープ・浮力は未認定。

## parts/parent/exterior/printed/parent_oneplate_stand/README.md

# 親機・地上自立用スキッド

正本はspec/parent_exterior_revision_sources.py。同じ部品を2個。機体X=±116へ配置し左だけZ180°回転する。M5ロッド穴は機体X=±110/Y=±55。上面Z=-20、接地面Z=-72。カメラユニットとTD04A本体を外して置く。TD支持部は残せる。設計上の底面すきまと支持多角形はassemblyの検査記録を参照。内装の実質量・重心による転倒余裕は実測が必要。

X側面を下にする製造Y90°姿勢。穴軸は水平なので上向き屋根を付ける。R2の内側接続、縁0.6 mm面取り。M5×180全ねじ4本と上下ワッシャ・ナットでフレーム、脚、上側バーを共締めする。旧150 mm全ねじは長さ不足。
