AquaBeacon/mechanical/assemblies/parent_hand_service/parts/DESIGN_NOTES.md

# 設計・印刷条件の控え（自動生成）

以下は設計元の文書を転記したものです。リンク先は元フォルダ基準です。印刷条件と未検証事項を確認してください。

## parent_hand_service/README.md

## 2026-10-29 電池蓋を上方取り外しへ変更

電池蓋はM3×12ねじ1本を外し、真上に持ち上げる方式へ変更。本体の固定ねじ4本は外さない。本体と蓋を各1個再印刷する。旧スライド手順は履歴。詳しくは [電池蓋の改訂報告](battery_top_lid_report.md)。

# 親機内装：床板下面の開放ナット座（2026-10-29）

現行は [改訂報告](unified_support_report.md) と [印刷入口](parts/PRINT.md)。床板裏面にM3ナット用の六角くぼみ11か所を設け、上からの貫通ねじで固定する。印刷後にナットを入れられる。Sony/GNSSの一体支持枠と足長50 mmは維持する。

再印刷は床板・MAIN枠・Sony支持枠・GNSS支持枠の4個。一式は15種類15個。MAIN用M3×30を4本、支持枠用M3×65を7本、床下面M3ナット11個。Sony後左は既存M3×10。実物の締付け強度は未確認。

---

以下は改訂履歴。旧締結手順と旧3MFを混ぜない。

# 親機内装：50 mm一体支持枠・埋め込みナット廃止（2026-10-28）

現行手順は [一体支持枠の改訂報告](unified_support_report.md)、印刷入口は [parts/PRINT.md](parts/PRINT.md)。SPRESENSEとGNSSの足はそれぞれ4本を一体化し、床板上面から固定板下面まで50.0 mmを確保する。埋め込みナットを廃止し、床下面から樹脂下穴へねじ止めする。上板は着脱式。

変更部品は床板・MAIN枠・アンテナ棚・電池台・GNSS固定板・Sony支持枠・GNSS支持枠の7個。一式は15種類15個。北側ペネトレータ2個を残して取り出す切欠きとM4頭径10 mm用の逃げを維持する。前版の独立柱・ナット埋め込みSTL/3MFは混ぜない。

配置の正本はplacement.json。実印刷・樹脂ねじの締付け耐力・実配線・強度は未確認。検証記録と試作用3MFは改訂報告を参照。

---

以下は改訂履歴。旧数量・ナット・独立柱の手順を現行へ適用しない。

# 親機内装：2026-10-27 北側ペネトレータ対応

現行の変更と組立手順は [床板改訂報告](plate_access_report.md)、印刷入口は [parts/PRINT.md](parts/PRINT.md)。床板を交換し、WetLink M10の本体・付属ナットを残して内装を上へ抜ける構成へ改訂する。M4頭逃げは10.8 mm。床ナット11個を横挿入・屋根保持にする。

再印刷は床板、Sony固定板、Sony前左柱0、共有柱、電池台、同軸リングを各1個、計6個。一式は20種類20個。TXは西1／南5 mm、Sony側の2軸も改訂報告の位置へ移動する。ケース側配線とM4固定3本を外して内装を引き抜き、空いたケース内でM10専用レンチを操作する手順を対象とする。

試作用3MFは [床板のプレート1](print_jobs/plate_access_20261027/parent_plate_access_1.3mf) と [残り5部品のプレート2](print_jobs/plate_access_20261027/parent_plate_access_2.3mf)。X1C／0.4 mm・PETGの設定、STLハッシュ、ナット通路の支持材検査は同フォルダのmanifest.jsonを参照。ナット座の屋根の実造形・保持耐力は未確認。

[閉状態](parent_hand_service.step)／[箱外の整備確認姿勢](service.step)。位置・バリアント・必要個数はplacement.jsonが正本。実ねじの頭高さ・首下長さ、実工具・印刷・締付け・強度は未確認で、状態は嵌合確認用試作。

---

以下は変更前の記録。床板の再使用、床裏の座金、旧配置・旧数量の指示は今回の改訂に使わず、上の報告を参照する。

2026-10-24 追補：工具穴周囲の薄壁を残さず、案内筒と接する外壁を半径7 mmの範囲・底板上面Z3 mmから上へ除去。外周へ開いた切欠き。底板と4取付座は保持。110°の電源側開放を維持。単一ソリッド・閉メッシュ・STEP再読込・工具通路・案内壁除去を確認。印刷は本リング1個のみ。実物と再スライスは未確認。一式全体の鮮度検査は前回同様未完了。

2026-10-24 同軸リングのみ改訂：工具通路を4.2→8 mmへ拡大。電源基板側（+Y）の外側壁を35〜145°の110°分開放。底板・4か所の取付座は保持。原姿勢で1個再印刷。工具通路・単一ソリッド・閉メッシュ・STEP再読込を確認。実工具、XT実物、再スライス、強度は未確認。全体STEPは今回再生成していない。切欠き縦端0.2 mm面取り。工具口と既存面取り交差の微小縁は造形後にバリを除去。

2026-10-24 MAIN下面・独立スペーサ改訂：格子下面の3.7 mmの浮きを解消。独立スペーサ12軸は対辺3.5 mmの通し穴と多角形外形。一体の基板ねじ座は2.8 mm下穴を維持。現行の金具・手順は assemblies/parent_hand_service/frame_spacer_printability_report.md を参照。床裏のナットを保持して締める構成に変更。以下の全スペーサ直接締結・整備用M3×8・最長30 mmの記述は変更前の履歴。

2026-10-24 SPRESENSE固定板増厚：ねじ止め時の割れに対応し、板厚1.6→3.2 mm。固定板1個を再印刷。基板とねじ座を1.6 mm上げ、支柱接合面は維持。現行手順は assemblies/parent_hand_service/sony_plate_thickening_report.md（リポジトリ基準）。下記の厚1.6 mm・Sony板再印刷不要の記述は変更前の履歴。

2026-10-24 現行：スペーサ・床側受け・棚接合柱の内部ナット穴27か所を廃止。内接径2.8 mmの縦下穴へ直接締結する。抜け止め4個は不要。印刷一式は16種類16個。以下のナット式の記述は変更履歴であり、現行の手順と数量は改良報告・parts/PRINT.mdを参照。

2026-10-24 基板直接固定：MAINはM3×8を4本、電源基板はM3×6を4本で樹脂下穴（内接径2.8 mm）へ直接固定。基板用ナット8個を廃止。MAIN枠と電源アダプタだけ変更し、床板・LiPo・整備ねじ4本の構造は維持。現行の数量と手順はretrofit_report.mdおよびparts/PRINT.mdを参照。

2026-10-24追補：電源基板は元の向きへ戻し、南11 mm・上5.5 mm。Pico 2 Wは基板上17 mm（追加確認18 mm）で干渉なし。更新内容と金具は [改良報告](retrofit_report.md)。

# 2026-10-24 親機内装改良・嵌合確認用試作

現行配置は `placement.json`。印刷入口は [parts/PRINT.md](parts/PRINT.md)、組立と締結の詳細は [改良報告](retrofit_report.md)。以下の旧柱・旧MAIN固定板の印刷案内は履歴であり、今回の改良部品と混ぜない。

最下段床板とLiPo固定具を無加工で再使用する。MAIN＋アンテナは4本の整備ねじと配線を外して一緒に持ち上げる。新規締結は最長30 mm。RTCの追加10 mm包絡、XT前方20 mm、電源スイッチ操作路を検査した配置を採用する。アンテナ上面と蓋の公称すきまは1.2 mmで、実物嵌合・ケーブルの取り回し・締付け強度は未確認。

追加印刷は16種類19個。床裏からの組み直しが必要。旧全長貫通ねじと上面開放ナット座を改良構成に使わない。

# 親機内装：操作アクセスとスペーサ積み上げ

追加依頼のMAIN用4本だけの多角形STLは [MAIN_spacers_polygon_4.stl](print_jobs/main_polygon_4/MAIN_spacers_polygon_4.stl)。外側六角形、穴は対辺3.45 mmの八角形、高さ14.3 mm、2×2配置でつなぎなし。このファイルを1個読み込むと4本を印刷できる。以下の従来の丸柱・12本セットとの重複印刷を避ける。全体組立は元の参照構成を保持し、今回の4本は同じ高さ・取付包絡の印刷バリアント。

2026-10-22：MAIN用14.3 mm柱4本を含む全スペーサを、種類別STLとして印刷一式へ追加した。MAIN×4、Sony左／右各2、GNSS前／後各2、計12本。内装一式は13種類20個。Sony右2本は、ナット穴へ落ち込まない5×9×高さ1.2 mmの下端を追加。取付位置・軸外径・キー・組立高さは維持。旧ランナーとの重複印刷を避ける。詳細は [スペーサ印刷・取付一覧](spacer_delivery_report.md)。

2026-10-13 全長側溝改訂：蓋を端から全長107.4 mmの両側溝へ差し込み、M3×12ねじ1本で固定。開く際は台の固定ねじ4本を外して閉じた電池ボックスを上へ約90 mm持ち上げ、蓋を南108 mm引き抜く。基板・最下段・同軸巻き部は変更なし。電池台と蓋を各1個再印刷。現行手順はbattery_side_grooves_report.md。

2026-10-13：電池下の工具穴を8 mmへ拡大。蓋は2 mmスライド＋M3×12ねじ1本。ナット差込み口を50°の斜め天井にし、局所サポート禁止設定を同梱。電池台の設定済み3MFと詳しい手順はbattery_tool_nut_access_report.md。最下段とコード巻き部の形状は変更なし。

2026-10-12 子機参照改訂：現行child_vtray_batt_floorの2本の端フック（厚1.3・高さ3・差込2・根元4 mm）と片側0.3 mmのすきまを親機へ反映。蓋を南2 mmの位置から下ろし、北へ2 mm差し込んでM3×12ねじ1本を締める。外すときはねじを外し南2 mm戻して上へ抜く。電池台と蓋だけ再印刷。床板・MAIN固定板・子機部品は変更なし。 現行詳細は [battery_slide_lid_report.md](battery_slide_lid_report.md)。

2026-10-12：容器固定ねじは南西・南東・北西のM4×12を各1本、計3本。最下段floor_plateはSCAD/STEP/STLすべて変更前と同一。再印刷はmain_mount_plate、battery_base、ann_mb1_coax_ring各1個だけ。長軸2.5 mmボールポイント六角レンチを使い、南西は南西方向へ10°、北西は西方向へ10°傾ける。南東は電池蓋とねじ1本、LiPo、上面フォームを外して電池台のØ4.2穴から操作する。北東ねじは使用しない。工具穴へコードを通さず、同軸束は新しい囲いの外へ収める。リング下面の局所支持を除去し工具穴を確認。実工具の嵌合、5 m巻き容量・R20曲げと3点固定の強度は未認定。 詳細は [case_screw_access_report.md](case_screw_access_report.md)。

2026-10-11センサ治具改訂：ユニバーサル基板の実測穴ピッチ75×55 mm、四隅から2.5 mmに合わせ、M3×10／M3ナット各4で貫通固定。前後押さえ2個を廃止。GNSS一式を西へ6 mm移し、基板下面Z56は維持。LIS3MDLは同じZ56へ20 mm下げ、四隅の座を結ぶ低い矩形枠をGNSS側梁と後梁へ接続した。持ち上げる片持ち棚は廃止。変更部の印刷はGNSS台1個だけ。詳細は [sensor_mount_report.md](sensor_mount_report.md)。

2026-10-11改訂。BCAS212310GのメーカーPDF/DXFを読み直し、床厚3 mm、ボス上面Z10、12個のタップボス、四隅の成形壁、本体とふたを修正した。メーカーSTEPは未入手で、図面にない成形勾配と公差は未確認。床板は四隅と全ボスを逃がし、4点の座をボス上面まで延ばす。LiPoを北へ3.6 mm、TXを南へ4 mm、GNSS後左脚を東へ2.6 mm移動。基板高さ、ナット座下面の連結、開放積み上げを維持する。今回のMAIN/Sony固定板は、大きな矩形肉抜きと4点の ねじ座で構成し、ピンごとの逃げ加工を使わない。LiPo配線端の最新修正は [battery_box_report.md](battery_box_report.md)。固定板の記録は [fixed_plate_report.md](fixed_plate_report.md)。容器訂正の履歴は [case_fit_report.md](case_fit_report.md)。

印刷入口は [parts/PRINT.md](parts/PRINT.md)。組立は [closed.step](closed.step)、箱外確認は [service.step](service.step)。位置・バリアント・必要個数の正本は `placement.json`。現行サービス姿勢はMAIN＋アンテナをZ方向へ120 mm持ち上げた確認姿勢。配線と4本の整備ねじを外し、ケーブルを解放してから持ち上げる。

## 印刷とスペーサ

**13種類のSTL、計20個**を表の数量だけ印刷する。スペーサは `main_corner_column.stl` ×4、`sony_column_left.stl`／`sony_column_right.stl`／`gnss_column_front.stl`／`gnss_column_rear.stl` を各2本、計12本。他の8部品は各1個。旧 `parent_stack_spacer_set.stl` にも12本が含まれるため、追加印刷しない。旧版を印刷済みならSony右2本だけ新版へ交換する。MAINの基板直下の座は `main_mount_plate.stl` に一体化しており、この板も必要。PWR・TX・電池・アンテナの支持は既存印刷部品に一体化しており、購入hex_spacerは使用しない。

PETG、0.2 mm積層、4周壁、100%インフィル。アンテナ台はX180°。MAIN/Sony固定板は下面をベッドへ向ける原姿勢。柱も原姿勢で、平らな下面をベッドへ、穴と突起を上向きにする。印刷向きは設計元 `manufacturing.json` が正本、同梱STLはその向きへ変換済み。柱には外側3 mmブリムを付け、冷却後に取り除く。座面・突起・穴を削らない。旧ランナーを印刷済みの場合は、側面の接続首だけを切り離して使用できる。嵌合と締付けは試作確認。

個別スペーサの検証は [spacer_delivery_report.md](spacer_delivery_report.md)、[spacer_delivery_checks.json](spacer_delivery_checks.json)。他部品のスライスと検証は [fixed_plate_report.md](fixed_plate_report.md) と電池・センサ等の各改訂レポートを参照。サポートは局所的に残る。`stack_spacer_checks.json` は旧ランナーの記録。`simple_stack_report.md`、`print_economy_report.md` は改訂前履歴で、今回の形状にそのまま適用しない。

## 操作と配置

- **LiPo：** 箱内でふたを開け、電源を切りリードを外す。電源リードと台固定ねじ4本を外し、閉じた電池ボックスを上へ約90 mm持ち上げる。蓋のM3ねじ1本を外し、南108 mmへ引き抜いて電池を取り出す。公称102×34×23、X153–187/Y22.6–124.6/Z23–46、蓋Z49–52。他の基板と同軸を動かさない。
- **両microSD：** 箱内の設置高さで南へ水平に抜き、上へ取り出す。MAIN口X62/Y26.29/Z44.5、Sony口X165.16/Y134.72/Z68。
- **両電源スイッチ：** PWR原点X25.8/Y115/Z28.3、Z回転90°。SW_PWR中心X33.26/Y199.54、SW_TX中心X63.34/Y130.46。Ø20の指の進入経路とØ12のレバー動作包絡を確保。
- **TX：** 原点X148/Y140.5/Z24.8、Z回転90°。実装上端40.195、予約Z40.195–60.195、X148–198/Y136.5–211.926。印刷スペーサはこのXY外形の外に置く。
- **SPRESENSE：** 原点X202.34/Y208/Z65.6、Z回転180°。厚1.6 mmの肉抜き固定板と4点のねじ座。板下面Z60.5、上面62.1、ねじ座上面65.55。TX予約上面60.195との間は0.305 mm、裏面部品最下端62.65との間は0.55 mm。左右スペーサ本体41.7 mm＋位置決め突起0.8 mm、床上18.8から接合面60.5へ。左Ø7、右Ø5.4、穴Ø3.45。専用追加バッテリーなし。
- **MAIN固定板：** 厚2.4 mm、下面33.1、上面35.5、ねじ座上面41.95。裏面部品最下端37.245との余裕1.745 mm。柱4本は14.3 mm、ねじ穴に対応する上の座だけを浮かせる。
- **MAIN USB：** MAIN原点X18/Y112/Z42、USB口X39.11/Y24.73/Z46.6。内装を箱から取り出して南から接続する。無分解での取り出しではなく、各上部モジュールとケース側ハーネスを先に外す。
- **GNSS：** 60×80ユニバーサル基板X69–129/Y139–219/Z56–57.6。穴はX71.5／126.5、Y141.5／216.5、ピッチ55×75 mm（箱のX/Y）。M3×10／M3ナット各4で四隅を貫通固定。印刷穴は対辺3.45 mmの補正八角穴、入口0.2 mm逃げ。ねじとナット、SMA/XHを外して基板一式を上へ取り出す。GNSS受信基板・ヘッダー・SMAも西6 mm、同軸の端の直線だけ6 mm短縮。基板穴径3.2 mmはM3用の仮包絡で、実穴径は未実測。
- **アンテナと同軸：** ANN-MB1は箱内、中心X60/Y60、下面64.6・上端87.1。88×60×1鋼板上。切らない5 m同軸用にOD100/ID75/H10、Z22.3–32.3を予約し、中心Ø75を全高で空洞にする。外壁4窓へ柔らかい糸を通し、結び目を含め包絡内に収める。指定包絡は実際の5 m巻き容量を保証しない。設計曲げ半径R20以上、MAIN固定板下面Z33.1との公称隙間0.8 mm。
- **LIS3MDL：** Adafruit4479／SwitchScience6266の公式完成基板STEP。原点X62.78/Y195/Z56、Z回転90°、下面はGNSSユニバーサル基板と同じ高さ。公式Ø2.5穴、ピッチ20.32×12.7へナイロンM2×8／M2ナット各4で固定。四隅の座を低い矩形枠でつなぎ、両縦梁をGNSS後梁、前後横梁をGNSS西側梁へ接続。後ろ2座の下は既存M2ナット用に局所的に逃がす。南QTの指の把持空間はSMAと重なるため、SMAを外し同軸をアンテナ後方へ退避してからQTを抜く。北QTは箱内で使わない。ANN-MB1は磁石内蔵のため通電・送信状態で測定と校正を行い、精度は未認定。

ケースはBCAS212310G、公称外形210×230×100.3。図面由来のふた屋根下面Z97.1、アンテナ上の余裕10 mm。外底面基準Z0に対して外側のボス足はZ−1まで伸びるため、モデル総高さ101.3と公称高さを区別する。南壁のテザーX28／TD04A X120、Z65は加工計画で、ケース原本は未加工。アンテナ引込みは不要。図面の内寸は全高さに共通する直方体の空間ではなく、四隅に張り出しがある。

## 組立

1. 床板を上から入れ、M4×12低頭ボタン3本でケースへ固定（南西25/25・南東185/25・北西25/205、頭座16.8）。北東185/205はねじを入れない。床板の座下面は実ボス上面Z10へ接する。公称ねじ込み5.2 mm、購入ねじ型番・インサート実深さは実物確認。床上からM3ナット16個を六角穴へ入れる（AF5.5、厚2.4、下面16.2、Z回転30°）。東端の一部開放穴は台を載せるまで仮保持する。
2. 同軸リング、空のアンテナラックをキーで合わせ、M3×50の4本で共締め。MAIN柱4本と固定板を、北92 mm／上14.2 mmから南へ滑らせ下げる。MAIN基板は北92 mm／上4.8 mmから南へ滑らせ下げる。固定板前左M3×25を1本、柱と基板共締めM3×30を3本、残る基板穴M3×8を1本。鋼板は上からM3×6／ナット各4、アンテナはM4×12／ナット各2で固定する。
3. PWRとTXを固定した後、切り離したSonyスペーサ4本を床へ置く。固定板のキー穴を合わせ、M3×50を4本、頭座62.1で床ナットへ締める。Sony基板はM2.5×6の4本。TXの周囲に壁はない。
4. GNSS前支柱2本・後支柱2本を床へ置き、上台のキー穴を合わせ、M3×40を4本、頭座52.5で共締め。GNSS基板をM3×10／ナット各4で四隅固定し、LIS3MDLをナイロンM2×8／ナット各4で固定して、同軸・配線を取り付ける。
5. 電池台と電池を取り付け、蓋を配線側の端から両側溝へ全長分滑らせ、M3×12ねじ1本を締める。配線をスイッチ・SD・電池の取り出し経路へ結束しない。整備は逆順。南西・北西のケース固定ねじは内装を組み付けたまま、南東はLiPo・蓋・上面フォームだけを外して操作する。詳しい工具姿勢はcase_screw_access_report.mdを参照。

今回の工具穴は電池台・同軸リング0.2 mm、MAIN固定板0.15 mm面取り。囲い外周0.2 mm、長い縦の根元0.1 mm面取り。外周は既存0.05–0.25 mm面取り、新スペーサは0.1–0.15 mm面取り。座面・穴・キーと切離し首の機能寸法は保持。配線の正本は [配線・ケーブル計画](../../docs/配線・ケーブル計画.md)。

## 検証と適用限界

個別レポートは `switch_tx_access_checks.json`、`battery_sd_access_checks.json`、`gnss_access_checks.json`、`magnetometer_access_checks.json`、`mount_axis_checks.json`、`wave_retention_checks.json`、`wave_assembly_checks.json`、`stack_spacer_checks.json`、`scad_step_checks.json`、`assembly_checks.json`。センサ改訂は `sensor_mount_checks.json` と [sensor_mount_report.md](sensor_mount_report.md)、今回の集約は `validation_current.json`。

旧形状の剛性結果は [wave_rigidity_report.md](wave_rigidity_report.md) に保持する。今回の床板・MAIN/Sony支持・GNSS台と支持位置の変更には適用しない。ねじ、接触座、位置決めキーの幾何学的保持を再検査するが、現行形状の剛性解析と収束検証、実ボルト予圧・すべり・緩み・クリープ・波浪試験は未完了。旧SonyのUSB/SD20N不合格も解消済みと扱わない。製造リリースは取合い試作のまま。

XH極数・取付辺・高さ、ヘッダー高さ、LiPo実寸とプラグ、同軸径・実巻き・尾線、ケースボス、ハーネス保持、QT配線先は未確定。閉蓋受信・磁気精度・防水・放熱も実物確認。前版の正本・印刷一式・解析は `_work/analysis/simple_stack_20261010/history/` に保存。旧昇降構成、探索モデル、最適化生メッシュを現行部品へ昇格していない。

## 2026-10-11 LiPo配線端の全面開放

変更はLiPoボックスだけ。子機の着脱板と端面リード逃げを参考に、親機の配線側（ボックス局所−X、箱座標では南側）を内幅40 mm、床上26 mmの全域で開放した。従来の中央16 mm窓とその屋根を廃止し、左右端から出るコードを塞がない。開口縁は0.2 mm面取り。床厚3 mm、箱外形、4取付穴、蓋、ねじ・ナット、電池位置は維持した。基板・容器・アンテナ・スペーサは変更していない。

配線側の端フォーム2枚を省いた非印刷バリアント `battery_pads_open_end` を使用する。上面・側面・反対端の4枚は従来形状のまま。蓋の4本を外して電池と左右の線を一緒に上へ出し入れできる。開放端に剛性ストッパはなく、残したフォームを実物に合わせて軽く圧縮し保持する。

収納は公称102×34×23 mm、商品公差上限104×36×25 mmの剛体包絡を確認する。最大個体では端/側/上フォームを公称の2/3/3 mmのまま使えないので現物に合わせて薄くする。線径・端子外形・外部への曲げ経路は未実測。組立や強度の実物検証を済ませた扱いにはしない。

設計元は `spec/build_parent_hand_service.py --battery-only`。既存の全体ビルドもこの同じボックスとフォームを生成する。検証と印刷入口は assemblies/parent_hand_service/battery_box_report.md と同assemblyのparts/PRINT.md。

## parts/parent/interior/printed/ann_mb1_internal_rack/README.md

# 2026-10-29 床下面ナットへの貫通固定

現行は [改訂報告](../../../../../assemblies/parent_hand_service/unified_support_report.md)。床の下面開放六角くぼみへM3ナットを入れ、上からの貫通ねじで床板まで挟む。MAIN枠とSony/GNSS支持枠の対象穴は通し穴。足の一体化・50 mmは維持。以下は変更前の履歴。

# 2026-10-28 埋め込みナット廃止

現行のアンテナ棚は鋼板・アンテナ用のナットを棚下面へ露出させ、外付け座金で反力を受ける。MAIN枠の床固定は下面からM3×30を入れ、床・同軸リング・床側受けを挟んで枠の樹脂下穴へ締める。埋め込みナットは使用しない。

金具・組立順・未検証範囲は [改訂報告](../../../../../assemblies/parent_hand_service/unified_support_report.md)。以下は旧版履歴。

2026-10-27 北側ペネトレータ対応：parent_hand_serviceのann_mb1_coax_ring_serviceは、ケースM4の約10 mm頭に合わせて下面の逃げを拡大。8 mmの工具通路と110°の側壁開放、4支持点は維持。床ナットは床内部へ横挿入して屋根で保持する構成に追従する。実物・強度は未確認。詳しくは assemblies/parent_hand_service/plate_access_report.md（リポジトリ基準）。

2026-10-24 追補：工具穴周囲の薄壁を残さず、案内筒と接する外壁を半径7 mmの範囲・底板上面Z3 mmから上へ除去。外周へ開いた切欠き。底板と4取付座は保持。110°の電源側開放を維持。単一ソリッド・閉メッシュ・STEP再読込・工具通路・案内壁除去を確認。印刷は本リング1個のみ。実物と再スライスは未確認。一式全体の鮮度検査は前回同様未完了。

2026-10-24 同軸リングのみ改訂：工具通路を4.2→8 mmへ拡大。電源基板側（+Y）の外側壁を35〜145°の110°分開放。底板・4か所の取付座は保持。原姿勢で1個再印刷。工具通路・単一ソリッド・閉メッシュ・STEP再読込を確認。実工具、XT実物、再スライス、強度は未確認。全体STEPは今回再生成していない。切欠き縦端0.2 mm面取り。工具口と既存面取り交差の微小縁は造形後にバリを除去。

2026-10-24 MAIN下面・独立スペーサ改訂：格子下面の3.7 mmの浮きを解消。独立スペーサ12軸は対辺3.5 mmの通し穴と多角形外形。一体の基板ねじ座は2.8 mm下穴を維持。現行の金具・手順は assemblies/parent_hand_service/frame_spacer_printability_report.md を参照。床裏のナットを保持して締める構成に変更。以下の全スペーサ直接締結・整備用M3×8・最長30 mmの記述は変更前の履歴。

2026-10-24 現行parent_hand_service：固定柱・床側受けは内部ナット穴を廃止し、内接径2.8 mmの縦下穴へ直接締結する。cradle_nut_keeperは旧版部品で現行構成では使用しない。数量・ねじ長・手順は assemblies/parent_hand_service/retrofit_report.md と parts/PRINT.md を参照。

## 2026-10-24 内装改良バリアント

設計元は `scad/lib/parent_service_retrofit.py`、生成入口は `spec/build_parent_hand_service.py --service-retrofit`。旧部品は保持し、現行内装の選択は `assemblies/parent_hand_service/placement.json` に従う。新規バリアントの手順・再使用範囲・金具は [改良報告](../../../../../assemblies/parent_hand_service/retrofit_report.md)。STLの姿勢は manufacturing.json を使い、支持材禁止モディファイアは部品として印刷しない。実物検証前の試作。

# ann_mb1_internal_rack：現行の印刷削減改訂

2026-10-12：容器固定ねじは南西・南東・北西のM4×12を各1本、計3本。最下段floor_plateはSCAD/STEP/STLすべて変更前と同一。再印刷はmain_mount_plate、battery_base、ann_mb1_coax_ring各1個だけ。長軸2.5 mmボールポイント六角レンチを使い、南西は南西方向へ10°、北西は西方向へ10°傾ける。南東は電池蓋とねじ4本、LiPo、上面フォームを外して電池台のØ4.2穴から操作する。北東ねじは使用しない。工具穴へコードを通さず、同軸束は新しい囲いの外へ収める。リング下面の局所支持を除去し工具穴を確認。実工具の嵌合、5 m巻き容量・R20曲げと3点固定の強度は未認定。 設計条件はscad/lib/parent_case_access.py、生成は既存spec/build_parent_hand_service.pyとspec/build_parent_gnss.pyを継続。

2026-10-09。現行はann_mb1_internal_rack（天板＋柱、X180°印刷）とann_mb1_coax_ring（底を下）に分割。柱脚とリングをØ5.4×H0.8キー／Ø5.6穴で合わせ、既存4本M3×50で床ナットへ共締め。リングの原点・コイル占有領域と4留め窓は従来通り。

生成元、共通寸法、配置は既存の一か所を継続。印刷姿勢の正本はmanufacturing.json、印刷入口はassemblies/parent_hand_service/parts/PRINT.md。PETG0.2 mm・4周壁・100%インフィル、局所自動支持。操作／同軸包絡／工具経路は再検査。解析・実締結の適用限界は同assemblyのwave_rigidity_report.mdとprint_economy_report.md。新しいキーの嵌合と揺動・緩みを実物で確認する。

## 改訂前の説明（履歴、現行印刷には上記を適用）

# ANN-MB1箱内アンテナ台

生成元`spec/build_parent_gnss.py`、共通寸法`scad/lib/parent_gnss.py`。現行parent_hand_service専用の配置はassemblyのplacement.jsonを参照。

ユーザー指定の同軸占有領域OD100/ID75/H10、中心X60/Y60、Z22.3–32.3を確保。中心Ø75はこの全高で空洞。切らない5 mケーブルの実巻き容量・尾線は現物確認。ラック外径106の環状底と、MAINの横を通るX12/134・Y25/95の4支柱、鋼板下面Z63.6の支持天板を持つ。MAIN実装部品の下側包絡に0.4 mm逃げを付けて天板下面を局所切欠きする。

鋼板88×60×1は購入素材から加工し、印刷しない。穴はX20/Y38.5、100/35、20/85、100/75。前左はMAIN取付工具、後右は実部品を避ける。アンテナはM4×12を2本、鋼板はM3×6を4本。ナットはラック上から六角ポケットへ入れる（M3下面Z61.2、M4下面Z60.4）。ラック主要形状を結合前0.2 mm面取り、STLは閉メッシュを検査。

PETG 0.2 mm・4周壁、天板と横梁にサポート。放熱・受信・構造強度は未認定。`stored_prop_rail`は旧保管案で現行印刷に含めない。メーカー資料は購入品ref/、確認画像はassembly _work/images/。

2026-10-09 波揺れ改訂：現行assemblyのREADMEとwave_rigidity_report.mdを参照。床下面に高さ5 mmの格子・外周リブ、ケースM4×8ボタンねじ4点固定、MAINの支持面をZ41.95へ変更、Sony台に3面の壁と実部品逃げ付きベッドを追加。アンテナ台は左Ø7.8／右Ø6.8支柱・側梁・厚5 mm天板、南西ケースねじ頭の下面逃げØ8.4貫通、外壁4か所の編糸窓を持つ。主要扱い稜は結合前0.2 mm面取り、後加工の部品逃げ・座面・留め穴は機能寸法を保持しバリを除く。巻き束は糸込みでOD100/ID75/H10に保持。PETG 0.2 mm・4周壁・100%インフィル、積層Z。取付ねじの締付け・緩み・実寸・樹脂クリープは実物で確認する。

上締め改訂：床側16個のM3六角ナットへ長ねじで締結。MAINは台前左M3×25＋基板共締めM3×30×3、SonyはM3×45×4、GNSSはM3×40×4、アンテナはM3×50×4。床下面から締める旧M3×8×16は現行に使用しない。組立は現行assemblyのREADMEの順序を守る。

MAIN基板はZ+4.8で北から92 mmスライド後、最終XYで下げる。その連続実部品包絡を天板の北へ抜けるチャンネルとして確保。天板前左にMAIN短ねじ用Ø6工具穴。鋼板・アンテナはMAIN固定後に載せる。右前の床側ラジアル腕には実取付穴へ合わせたMAIN支持脚Ø9.6の逃げを追加した。鋼板が支持面へ当たること、六角ポケットの回り止め・ねじ締付けは実物で照合する。

## parts/parent/interior/printed/gnss_universal_carrier/README.md

# 2026-10-29 床下面ナットへの貫通固定

現行は [改訂報告](../../../../../assemblies/parent_hand_service/unified_support_report.md)。床の下面開放六角くぼみへM3ナットを入れ、上からの貫通ねじで床板まで挟む。MAIN枠とSony/GNSS支持枠の対象穴は通し穴。足の一体化・50 mmは維持。以下は変更前の履歴。

# 2026-10-28 GNSS一体支持枠

現行はgnss_support_frameの一部品で4本の足を連結し、床上面から固定板下面まで50.0 mmを確保。旧共有柱・独立柱は現行配置では使わない。床下面のM3×16と上板のM3×10を樹脂下穴へ締める。磁気センサのナットは屋根付き穴を廃止し、下面へ露出したナットと座金へ変更。

設計正本はparent_service_retrofit.pyと既存build_parent_gnss.py。寸法・組立・検証は [改訂報告](../../../../../assemblies/parent_hand_service/unified_support_report.md)、印刷入口はassemblyのparts/PRINT.md。以下は旧版履歴。

2026-10-27 北側ペネトレータ対応：parent_hand_serviceのgnss_sony_shared_columnを改訂。Sony側の軸はX142.5／Y202.5。GNSS側X135／Y219から西寄りの折れた下端橋で接続し、M10とTXの通り道を避ける。Sony側ナットの屋根Z58.1と側面挿入、支柱上面は維持。床側のGNSS軸は新しい床内部のM3ナットで固定し、床裏座金は使わない。詳しくは assemblies/parent_hand_service/plate_access_report.md（リポジトリ基準）。

2026-10-24 MAIN下面・独立スペーサ改訂：格子下面の3.7 mmの浮きを解消。独立スペーサ12軸は対辺3.5 mmの通し穴と多角形外形。一体の基板ねじ座は2.8 mm下穴を維持。現行の金具・手順は assemblies/parent_hand_service/frame_spacer_printability_report.md を参照。床裏のナットを保持して締める構成に変更。以下の全スペーサ直接締結・整備用M3×8・最長30 mmの記述は変更前の履歴。

2026-10-24 現行parent_hand_service：固定柱・床側受けは内部ナット穴を廃止し、内接径2.8 mmの縦下穴へ直接締結する。cradle_nut_keeperは旧版部品で現行構成では使用しない。数量・ねじ長・手順は assemblies/parent_hand_service/retrofit_report.md と parts/PRINT.md を参照。

## 2026-10-24 内装改良バリアント

設計元は `scad/lib/parent_service_retrofit.py`、生成入口は `spec/build_parent_hand_service.py --service-retrofit`。旧部品は保持し、現行内装の選択は `assemblies/parent_hand_service/placement.json` に従う。新規バリアントの手順・再使用範囲・金具は [改良報告](../../../../../assemblies/parent_hand_service/retrofit_report.md)。STLの姿勢は manufacturing.json を使い、支持材禁止モディファイアは部品として印刷しない。実物検証前の試作。

# GNSS・磁気センサの同じ高さの四隅固定台

2026-10-11現行改訂。設計正本は `spec/build_parent_gnss.py`、寸法は `scad/lib/parent_gnss.py`。部分ビルドはFreeCADCmdに `spec/build_parent_gnss.py --pass --fixtures-only` を渡す。生成SCADとSTLを手編集しない。配置・数量は `assemblies/parent_hand_service/placement.json`。

60×80 mm基板の四隅から2.5 mm、箱X/Yの穴ピッチ55×75 mm（ユーザー確認）。基板X69–129/Y139–219/Z56–57.6。穴X71.5／126.5、Y141.5／216.5。対辺3.45 mmの補正八角貫通穴と0.2 mm入口逃げ。M3×10とM3ナット各4、ナット下面Z47.6、頭座57.6。前後押さえは現行構成から外し、旧ファイルは履歴として保持。支柱・床側4取合いは維持し、GNSS一式だけ西6 mmへ移動。

LIS3MDL基板下面Z56。公式4穴へ既存ナイロンM2×8／ナット各4で貫通固定。厚4 mm・幅5.8 mmの低い矩形枠が四隅をつなぎ、両縦梁は後梁、前後横梁はGNSS西側梁へ接続する。4座の上面Z56、枠下面51.5。後梁の下でナットが干渉しないよう局所逃げを設ける。立ち上げるマストは廃止。南QTは先にSMAを外し同軸を退避してから把持する。

印刷姿勢は下面Z50をベッド、キー穴が下、四隅の座が上。PETG、0.2 mm、4周壁、100%インフィル。センサ枠下面Z51.5の張出しとM2ナット座の屋根は局所支持を確認し、支持は開放部から除去する。外形と穴・根元は生成時に面取り、実面取り値はdimensions.json。既存M3柱キー・ねじ座の機能面は寸法を維持する。印刷入口は assembly parts/PRINT.md。現行の結果と限界は sensor_mount_report.md。強度・剛性解析、繰返し荷重、クリープ、実印刷・磁気校正は未検証。

## 以下は改訂前の履歴

2026-10-11：訂正した容器の北西成形壁を避け、後左脚と上台のキー軸を(22.6,219)へ移動し、後梁を短縮。基板と棚の高さは維持。現行親機の前／後支柱は各2本を共通のparent_stack_spacer_setへ含める。個別支柱STLを重複印刷しない。原形・取合いはこのフォルダの既存STEPから参照し、ランナー側で再定義しない。旧剛性結果は改訂形状に適用しない。

# gnss_universal_carrier：現行の印刷削減改訂

2026-10-09。現行はgnss_universal_carrier（上台・一体LIS3MDL棚）、gnss_column_front×2、gnss_column_rear×2、前後押さえ各1。上台下面Z50、柱本体H31.2＋キー0.8。前柱9×9、後柱8×6、キーは各幅／奥行から2を引いた寸法、ポケットは0.2大きい。全て底を下、支柱キーを上に印刷。既存4本M3×40で床側M3ナットへ共締め。GNSS長梁下の支持は不要、LIS3MDL棚など局所支持は残す。

生成元、共通寸法、配置は既存の一か所を継続。印刷姿勢の正本はmanufacturing.json、印刷入口はassemblies/parent_hand_service/parts/PRINT.md。PETG0.2 mm・4周壁・100%インフィル、局所自動支持。操作／同軸包絡／工具経路は再検査。解析・実締結の適用限界は同assemblyのwave_rigidity_report.mdとprint_economy_report.md。新しいキーの嵌合と揺動・緩みを実物で確認する。

## 改訂前の説明（履歴、現行印刷には上記を適用）

# GNSS 60×80ユニバーサル基板台・LIS3MDL固定棚

生成元`spec/build_parent_gnss.py`、共通寸法`scad/lib/parent_gnss.py`。基板X75–135/Y139–219/Z56–57.6、脚(13,145)/(135,145)/(20,219)/(135,219)。電源基板の両スイッチとTX上方20 mmを避け、GNSS一式を上方へ抜ける位置。

未知のユニバーサル基板取付穴は仮定せず、前後押さえ2個・M2×6ねじ4本で端を保持。前側は`gnss_edge_cap_front`、後側は`gnss_edge_cap`。異なる穴位置を混同しない。脚は床下面からM3×8で固定。最終面取りは台0.05 mm、押さえ0.15 mm。基板挿入面は機能寸法を保持する。

SMA・XHを外し、押さえを外して基板一式をまっすぐ上へ抜く。MAIN／Sonyの取り外し・昇降は不要。XH型番・極数・辺・高さとヘッダー7 mmは未確定。PETG、梁と端の段差にサポート。強度と実ケーブル保持は未認定。操作手順と印刷入口はassembly READMEとparts/PRINT.md。

2026-10-09：後梁X28/Y219からLIS3MDL用の片持ち棚を追加。基板はX45–62.78/Y195–220.4、下面Z76。棚下面Z71.5、厚4 mm、幅5.8 mmの2本の腕と4座面。メーカーEAGLE由来の穴軸はX47.54／60.24、Y197.54／217.86。支持穴Ø2.45へナイロンM2×8ボルト・M2ナットを各4個で貫通締結する。基板裏にナットを入れ、上から締める。近傍の鋼製締結具は避ける。

GNSSの基板保持・取り出し領域には棚を張り出さない。同軸の設計経路より上に棚を置き、Ø5の同軸クリアランス包絡、両スイッチ、電池・SD経路を再検査する。センサは南向きQTを外し4本のねじ・ナットを外せば上へ取り出せる。PETG、追加棚下面もサポートを使用。面取りは生成結果の`ann_mb1_internal_rack/dimensions.json`に実値を記録する。基板挿入面のみ機能寸法を保持する。

ANN-MB1底面の磁石から距離を取るため北西後端に配置。センサ・ねじ・QTプラグの詳細と磁気校正条件は[購入品説明](../../cots/adafruit_lis3mdl/README.md)。棚の強度・繰返し耐久・方位精度は未認定。

2026-10-09 波揺れ改訂：前支柱9×9／後8×6 mm、梁下面Z50・上面Z56。側面ストッパー4個は片側公称0.2 mmの空きでユニバーサル基板の横ずれを止める。XH領域Y168–192には張り出さない。前梁に3×3の留め穴2個（X65/70、Y143–146）を設け、線を柔らかく保持する。PETG 0.2 mm・4周壁・100%インフィル、組立Z方向を積層Zとする。解析と実物受入条件は現行assemblyのwave_rigidity_report.md。

上締め改訂：床側16個のM3六角ナットへ長ねじで締結。MAINは台前左M3×25＋基板共締めM3×30×3、SonyはM3×45×4、GNSSはM3×40×4、アンテナはM3×50×4。床下面から締める旧M3×8×16は現行に使用しない。組立は現行assemblyのREADMEの順序を守る。

## parts/parent/interior/printed/parent_hand_service/README.md

## 2026-10-29 電池蓋を上方取り外しへ変更

電池蓋はM3×12ねじ1本を外し、真上に持ち上げる方式へ変更。本体の固定ねじ4本は外さない。本体と蓋を各1個再印刷する。旧スライド手順は履歴。詳しくは [電池蓋の改訂報告](../../../../../assemblies/parent_hand_service/battery_top_lid_report.md)。

# 2026-10-29 床下面ナットへの貫通固定

現行は [改訂報告](../../../../../assemblies/parent_hand_service/unified_support_report.md)。床の下面開放六角くぼみへM3ナットを入れ、上からの貫通ねじで床板まで挟む。MAIN枠とSony/GNSS支持枠の対象穴は通し穴。足の一体化・50 mmは維持。以下は変更前の履歴。

# 2026-10-28 一体支持枠・埋め込みナット廃止

現行の説明は [改訂報告](../../../../../assemblies/parent_hand_service/unified_support_report.md)。Sonyの4本の足をsony_support_frameの1部品へ統合し、肩まで50.0 mm、キー0.8 mmを別に確保。床の内部ナット穴と電池蓋用ナット穴を廃止。床は通し穴、支持部品と電池蓋は内接径2.8 mmの樹脂下穴へ締結する。

設計正本は既存Python生成元。製造姿勢はmanufacturing.json、使用バリアントと数量はassemblyのplacement.json。印刷入口はassemblyのparts/PRINT.md。以下は旧版履歴。

# 2026-10-27 北側ペネトレータ対応

現行の説明・寸法・締結手順は [床板改訂報告](../../../../../assemblies/parent_hand_service/plate_access_report.md)。印刷入口は [PRINT.md](../../../../../assemblies/parent_hand_service/parts/PRINT.md)。この改訂ではfloor_plate、sony_mount_plate、sony_fixed_column_0、battery_baseを交換する。共有柱と同軸リングは各共通部品フォルダの同じ正本を更新する。

床の生成元はspec/build_parent_hand_service.py／spec/parent_switch_tx_body.py、局所形状はscad/lib/parent_floor_access.py。既存の同じ生成元から作り、出力SCADを手編集しない。床M3ナット11か所は対辺5.8 mmの横挿入穴、上の屋根で+Zの抜けを受ける。M4頭口10.8 mm、電池台は配線端へ開放した頭通路。床・固定板・柱は原姿勢の下面をベッドへ向ける。

以下の床板無加工再使用・床裏座金・旧取付軸は改訂履歴。実ねじ・工具・嵌合・印刷・強度は試作確認。

2026-10-24 MAIN下面・独立スペーサ改訂：格子下面の3.7 mmの浮きを解消。独立スペーサ12軸は対辺3.5 mmの通し穴と多角形外形。一体の基板ねじ座は2.8 mm下穴を維持。現行の金具・手順は assemblies/parent_hand_service/frame_spacer_printability_report.md を参照。床裏のナットを保持して締める構成に変更。以下の全スペーサ直接締結・整備用M3×8・最長30 mmの記述は変更前の履歴。

2026-10-24 SPRESENSE固定板増厚：ねじ止め時の割れに対応し、板厚1.6→3.2 mm。固定板1個を再印刷。基板とねじ座を1.6 mm上げ、支柱接合面は維持。現行手順は assemblies/parent_hand_service/sony_plate_thickening_report.md（リポジトリ基準）。下記の厚1.6 mm・Sony板再印刷不要の記述は変更前の履歴。

2026-10-24 現行：スペーサ・床側受け・棚接合柱の内部ナット穴27か所を廃止。内接径2.8 mmの縦下穴へ直接締結する。抜け止め4個は不要。印刷一式は16種類16個。以下のナット式の記述は変更履歴であり、現行の手順と数量は改良報告・parts/PRINT.mdを参照。

2026-10-24 基板直接固定：MAINはM3×8を4本、電源基板はM3×6を4本で樹脂下穴（内接径2.8 mm）へ直接固定。基板用ナット8個を廃止。MAIN枠と電源アダプタだけ変更し、床板・LiPo・整備ねじ4本の構造は維持。現行の数量と手順はretrofit_report.mdおよびparts/PRINT.mdを参照。

## 2026-10-24 内装改良バリアント

設計元は `scad/lib/parent_service_retrofit.py`、生成入口は `spec/build_parent_hand_service.py --service-retrofit`。旧部品は保持し、現行内装の選択は `assemblies/parent_hand_service/placement.json` に従う。新規バリアントの手順・再使用範囲・金具は [改良報告](../../../../../assemblies/parent_hand_service/retrofit_report.md)。STLの姿勢は manufacturing.json を使い、支持材禁止モディファイアは部品として印刷しない。実物検証前の試作。

電源基板は元の向きで南11 mm・上5.5 mm。MAIN枠の後端中央に逃げを追加し、電源アダプタの床固定はM3×8を4本、頭を1 mm沈める。Pico 2 Wの基板上17 mm包絡からアンテナ棚まで3.8 mmを確認。床板とLiPo固定具は変更しない。

# 親機：固定板とねじ座

2026-10-13 全長側溝改訂：蓋を端から全長107.4 mmの両側溝へ差し込み、M3×12ねじ1本で固定。開く際は台の固定ねじ4本を外して閉じた電池ボックスを上へ約90 mm持ち上げ、蓋を南108 mm引き抜く。基板・最下段・同軸巻き部は変更なし。電池台と蓋を各1個再印刷。現行手順はbattery_side_grooves_report.md。

2026-10-13：電池下の工具穴を8 mmへ拡大。蓋は2 mmスライド＋M3×12ねじ1本。ナット差込み口を50°の斜め天井にし、局所サポート禁止設定を同梱。電池台の設定済み3MFと詳しい手順はbattery_tool_nut_access_report.md。最下段とコード巻き部の形状は変更なし。

2026-10-12 子機参照改訂：現行child_vtray_batt_floorの2本の端フック（厚1.3・高さ3・差込2・根元4 mm）と片側0.3 mmのすきまを親機へ反映。蓋を南2 mmの位置から下ろし、北へ2 mm差し込んでM3×12ねじ1本を締める。外すときはねじを外し南2 mm戻して上へ抜く。電池台と蓋だけ再印刷。床板・MAIN固定板・子機部品は変更なし。 共通生成元scad/lib/parent_battery_slide.pyが子機の現行SCADを直接読み、フック寸法を引き継ぐ。

2026-10-12：容器固定ねじは南西・南東・北西のM4×12を各1本、計3本。最下段floor_plateはSCAD/STEP/STLすべて変更前と同一。再印刷はmain_mount_plate、battery_base、ann_mb1_coax_ring各1個だけ。長軸2.5 mmボールポイント六角レンチを使い、南西は南西方向へ10°、北西は西方向へ10°傾ける。南東は電池蓋とねじ1本、LiPo、上面フォームを外して電池台のØ4.2穴から操作する。北東ねじは使用しない。工具穴へコードを通さず、同軸束は新しい囲いの外へ収める。リング下面の局所支持を除去し工具穴を確認。実工具の嵌合、5 m巻き容量・R20曲げと3点固定の強度は未認定。 設計条件はscad/lib/parent_case_access.py、生成は既存spec/build_parent_hand_service.pyとspec/build_parent_gnss.pyを継続。

2026-10-11。MAIN/Sonyの両方に固定板を設ける。大きな矩形肉抜きで材料を減らし、ねじ座4点で基板を浮かせる。ピンごとの切欠きは使わない。板下面を平らにし、下の柱を分離して印刷支持を減らす。

MAIN板はmain_mount_plate、厚2.4・下面33.1・座上面41.95。main_corner_columnは高さ14.3を4本。Sony板はsony_mount_plate、厚1.6・下面60.5・座上面65.55。Sony柱4本は41.7＋キー0.8。Sony床ねじはM3×50を4本、頭座62.1。基板高さ42/65.6とMAIN/PCBねじは維持。

正本はspec/build_parent_hand_service.py、spec/parent_switch_tx_body.py、共通形状はscad/lib/parent_corner_mounts.py、共通寸法はscad/lib/parent_gnss.py。配置はassemblyのplacement.json。旧支持板・独立支持腕は履歴で現行の非印刷ファイル。旧解析を現行剛性の認定に使わない。

両板と柱は下面をベッドへ向ける。扱い稜と穴入口は0.15 mm面取り、座面・キー・パイロットは機能寸法を保持。GNSSを含む12本の柱をランナー1枚へまとめる。印刷入口はassemblies/parent_hand_service/parts/PRINT.md、最新検証はfixed_plate_report.md。実締付け・嵌合・波浪・クリープは未認定。

## 過去の説明（履歴）

# 親機：ねじ穴付近だけの基板支持

2026-10-11。MAINは直立スペーサ3本と前左支持腕1個、SPRESENSEは床からの柱4本に載る独立支持腕4個へ変更。PCB高さ42/65.6 mmを維持し、広い支持板と部品・ピンごとの逃げ加工を撤去。MAIN前左は同軸リングを避け、Sonyの柱はTX予約外に置き、腕下面をZ60.5へ置く。基板下に全体を覆う板はない。

正本は既存spec/build_parent_hand_service.pyとspec/parent_switch_tx_body.py、支持形状の共通関数はscad/lib/parent_corner_mounts.py。配置・数量はassemblies/parent_hand_service/placement.json。main_corner_columnを3個、main_offset_cornerを1個、sony_corner_0..3を各1個使う。これらはGNSS/Sony柱とともに16個のランナー1枚へ組み込む。個別STLを追加印刷しない。

扱い稜と穴入口は0.15 mm面取り。座面・パイロット・キーの機能寸法は保持。MAIN直立柱はZ上向き、支持腕はX180度、Sony角3だけさらにZ90度。印刷・サポートは同assemblyのparts/PRINT.mdとcorner_mount_report.mdを参照。旧main_lower_carrier/sony_upper_carrierは履歴の非印刷ファイルで、現行配置に含めない。

実嵌合、締付け、波浪、樹脂クリープと現行剛性は未認定。

## 過去の説明（履歴）

# parent_hand_service：容器図面の訂正に対応

2026-10-11。メーカーPDF/DXF由来のBCAS本体・ふたに合わせ、床四隅の成形壁と全16ボスを逃がし、M4接触座をZ10まで延長した。M4×12ボタン4本で固定する。LiPo北3.6 mm、TX南4 mm、GNSS後左脚東2.6 mmの移動とSony後梁の短縮を生成元へ反映。PCB高さ、床M3ナット座下面の連結、開放積み上げを維持。印刷入口はassemblies/parent_hand_service/parts/PRINT.md、現行検証は同assemblyのcase_fit_report.md。過去の剛性解析は変更形状には適用できず、実物公差と剛性は未認定。

## スペーサ積み上げ改訂の履歴

2026-10-10。Sony囲い壁を撤去して、上台と独立した印刷スペーサ4本で積み上げる。床ナット座は格子下面Z8.84までつなぎ、ケースボスとの重なりだけを逃がす。床上18.8、PCB高さ・ねじ頭座・ナット高さは維持。MAIN・PWR・TX・電池の一体支持は印刷部品のまま。スペーサセットは parts/common/interior/printed/stack_spacers に一か所だけ定義し、GNSS既存支柱も再利用して8本を切離しランナーへまとめる。

生成元はspec/build_parent_hand_service.py、spec/parent_switch_tx_body.py、共通寸法はscad/lib/parent_gnss.py。印刷入口と今回の条件はassemblies/parent_hand_service/parts/PRINT.md。実印刷と実波浪での保持は未認定。

## 以前の説明（履歴）

# parent_hand_service：現行の印刷削減改訂

2026-10-09。現行床は幅7.5・高さ9.96 mmの開放格子。PWR/TX/LiPo支持座とM4座・M3ナット座を維持。MAIN/Sonyは支持面を下にするX180°で印刷。Sony配線窓は幅24・最大高さ13、印刷時45°の屋根。MAINのSD/USB領域は支持板を残す。

生成元、共通寸法、配置は既存の一か所を継続。印刷姿勢の正本はmanufacturing.json、印刷入口はassemblies/parent_hand_service/parts/PRINT.md。PETG0.2 mm・4周壁・100%インフィル、局所自動支持。操作／同軸包絡／工具経路は再検査。解析・実締結の適用限界は同assemblyのwave_rigidity_report.mdとprint_economy_report.md。新しいキーの嵌合と揺動・緩みを実物で確認する。

## 改訂前の説明（履歴、現行印刷には上記を適用）

# 親機内装の共通設計元

`spec/build_parent_hand_service.py`と`spec/parent_switch_tx_body.py`が同じパラメータからSTEP/STL/SCADを生成。寸法の正本は`scad/lib/parent_gnss.py`、配置は`assemblies/parent_hand_service/placement.json`。

現行は`floor_plate`、`battery_base`、`main_lower_carrier`、`sony_upper_carrier`。MAINをアンテナ下へ移し、電源2スイッチの上方を空ける。Sony棚下面Z61.5で、TX実装上端Z40.195から20 mmの予約領域を避ける。MAIN USBは箱外、両SDとLiPoは箱内で操作する。

2026-10-09：LIS3MDL磁気センサをX62.78/Y195/Z76・Z回転90°へ追加。固定棚は[既存GNSS台](../gnss_universal_carrier/README.md)の一体バリアントとして生成し、このフォルダに重複定義しない。公式完成基板STEP、ナイロンM2×8／M2ナット各4個を組立へ追加した。磁気精度・実プラグは実機確認。

旧`lift_carrier`、`guide_*`、`service_prop_*`は履歴。現行構成へ混ぜない。金属ピン・長ねじ・ストラップ・蓋予約・`tx_top_keepout`は印刷しない。LiPoフォームと捕捉ナット、`lid_narrow`は既存設計を再利用。

PETG 0.2 mm・4周壁の取合い試作。床下面とキャリア棚／段差にサポート。新キャリア外周・支柱0.15 mm、床外周0.25、穴入口0.4 mm逃げ。実部品の逃げ、基板接触・ねじ座・パイロット・フォーム／ナット保持の機能稜は寸法を維持。強度・熱・反復操作は未認定。詳しくはassembly READMEとparts/PRINT.mdを参照。

2026-10-09 波揺れ改訂：現行assemblyのREADMEとwave_rigidity_report.mdを参照。床下面に高さ5 mmの格子・外周リブ、ケースM4×8ボタンねじ4点固定、MAINの支持面をZ41.95へ変更、Sony台に3面の壁と実部品逃げ付きベッドを追加。アンテナ台は左Ø7.8／右Ø6.8支柱・側梁・厚5 mm天板、南西ケースねじ頭の下面逃げØ8.4貫通、外壁4か所の編糸窓を持つ。主要扱い稜は結合前0.2 mm面取り、後加工の部品逃げ・座面・留め穴は機能寸法を保持しバリを除く。巻き束は糸込みでOD100/ID75/H10に保持。PETG 0.2 mm・4周壁・100%インフィル、積層Z。取付ねじの締付け・緩み・実寸・樹脂クリープは実物で確認する。

上締め改訂：床側16個のM3六角ナットへ長ねじで締結。MAINは台前左M3×25＋基板共締めM3×30×3、SonyはM3×45×4、GNSSはM3×40×4、アンテナはM3×50×4。床下面から締める旧M3×8×16は現行に使用しない。組立は現行assemblyのREADMEの順序を守る。

## 2026-10-11 LiPo配線端の全面開放

変更はLiPoボックスだけ。子機の着脱板と端面リード逃げを参考に、親機の配線側（ボックス局所−X、箱座標では南側）を内幅40 mm、床上26 mmの全域で開放した。従来の中央16 mm窓とその屋根を廃止し、左右端から出るコードを塞がない。開口縁は0.2 mm面取り。床厚3 mm、箱外形、4取付穴、蓋、ねじ・ナット、電池位置は維持した。基板・容器・アンテナ・スペーサは変更していない。

配線側の端フォーム2枚を省いた非印刷バリアント `battery_pads_open_end` を使用する。上面・側面・反対端の4枚は従来形状のまま。蓋の4本を外して電池と左右の線を一緒に上へ出し入れできる。開放端に剛性ストッパはなく、残したフォームを実物に合わせて軽く圧縮し保持する。

収納は公称102×34×23 mm、商品公差上限104×36×25 mmの剛体包絡を確認する。最大個体では端/側/上フォームを公称の2/3/3 mmのまま使えないので現物に合わせて薄くする。線径・端子外形・外部への曲げ経路は未実測。組立や強度の実物検証を済ませた扱いにはしない。

設計元は `spec/build_parent_hand_service.py --battery-only`。既存の全体ビルドもこの同じボックスとフォームを生成する。検証と印刷入口は assemblies/parent_hand_service/battery_box_report.md と同assemblyのparts/PRINT.md。
# MAINスペーサ4本の多角形STL（2026-10-22追加依頼）

`main_corner_column_polygon_4.stl` はMAIN用4本だけを並べた印刷バリアント。外側は六角形（元のØ7 mm包絡内、頂点と上下縁は0.1 mm面取り）、高さ14.3 mm、穴は内接径／対辺3.45 mmの補正八角形、穴口0.15 mm面取り。穴の縦8稜は指定の機能形状として保持する。元のM3通しねじとMAIN固定板を使い、柱にタップしない。

生成元は `spec/build_parent_main_polygon.py`。既存 `main_corner_column.step` から高さ・外形・穴径を取得する。単体の `main_corner_column_polygon` と4本入りの同名 `_4` は同じ生成元の出力で、4本のピッチ12 mm、2×2配置、つなぎなし、平らな下面Z0・穴は上向き。配布STLは `assemblies/parent_hand_service/print_jobs/main_polygon_4/MAIN_spacers_polygon_4.stl`。SHAと検証結果は隣のmanifest.json。PETG・0.4 mmノズル・0.2 mm積層・壁4周・100%充填を想定し、小さい接地面には3 mmブリムを推奨。実物の嵌合・締付けは未検証。

今回の依頼用の4本だけを印刷する場合に、このSTLを1個読み込む。従来の単体丸柱4本や12本入り3MFと重複印刷しない。既存の全体組立・13種類20個の一式は丸柱の参照構成を保持する。4か所すべてで床への着座・上側の接触・干渉を検証した多角形の印刷バリアントであり、全体の再配置は行っていない。

## parts/parent/interior/printed/parent_lipo_retainer/parent_lipo_retainer.md

# parent_lipo_retainer — 親機LiPoの6面保持

2026-10-13 全長側溝改訂：蓋を端から全長107.4 mmの両側溝へ差し込み、M3×12ねじ1本で固定。開く際は台の固定ねじ4本を外して閉じた電池ボックスを上へ約90 mm持ち上げ、蓋を南108 mm引き抜く。基板・最下段・同軸巻き部は変更なし。電池台と蓋を各1個再印刷。現行手順はbattery_side_grooves_report.md。

2026-10-13：電池下の工具穴を8 mmへ拡大。蓋は2 mmスライド＋M3×12ねじ1本。ナット差込み口を50°の斜め天井にし、局所サポート禁止設定を同梱。電池台の設定済み3MFと詳しい手順はbattery_tool_nut_access_report.md。最下段とコード巻き部の形状は変更なし。

2026-10-12 子機参照改訂：現行child_vtray_batt_floorの2本の端フック（厚1.3・高さ3・差込2・根元4 mm）と片側0.3 mmのすきまを親機へ反映。蓋を南2 mmの位置から下ろし、北へ2 mm差し込んでM3×12ねじ1本を締める。外すときはねじを外し南2 mm戻して上へ抜く。電池台と蓋だけ再印刷。床板・MAIN固定板・子機部品は変更なし。 共通生成元scad/lib/parent_battery_slide.pyが子機の現行SCADを直接読み、フック寸法を引き継ぐ。

2026-10-02：親機引上げ内装では`parent_lipo_retainer_lid_narrow`を使用。元のlidに`west_trim=0.6`を適用し、西縁だけ0.6 mm狭めてガイドと離す。元のボルト穴・フォーム接触・厚み3 mmは保持。`spec/prepare_parent_lipo_retainer.py`と`export_parent_lipo_retainer.py`で再生成。旧構成の標準lidは変更しない。現行配置は`assemblies/parent_hand_service/placement.json`を参照。

子機の `child_vtray_batt_box` と `child_vtray_batt_floor` の「端壁・側壁・着脱板＋フォーム」を参考にした。
親機のZeee 102×34×23 mmを、床・両端・両側・ねじ止め上蓋で保持する。
ベルクロによる固定から、**M3×12ねじ4本で閉じる剛性上蓋**へ変更。
ねじは側面から挿入するM3ナット4個で受ける。上蓋は支柱上端に当たって止まり、締め付け量で電池厚を決めない。

| 部位 | 公称パックに対する設計 |
|---|---|
| 前後（X） | 片側2 mmの端フォーム。西端はリード開口を避けて2分割 |
| 左右（Y） | 片側3 mm、長さ63 mmの側フォーム |
| 上下（Z） | 床で下面を支持、上面3 mmフォーム＋3 mm厚の固定蓋 |
| トレイ固定 | 従来のMAIN穴103×75.5 mmとM3 MF25×4。M3×8×4で支持スペーサへ固定 |
| 蓋固定 | M3×12なべねじ×4、M3ナット（対辺5.5、厚2.4）×4 |
| 外形 | ベイ111×45 mm、蓋111×53×3 mm。ベースは従来の支持レールを含む |
| 高さ | トレイ下面51.4、蓋下面80.4、蓋上面83.4、ねじ頭上85.4 mm（箱座標） |
| 箱蓋まで | パッキン面90.9を基準として5.5 mm |

原点とMAIN取付穴は旧 `parent_lipo_tray` と同じ。現行のサービス改訂では箱(20,48.5,51.4)へ配置。
ベースのMAIN固定穴は全高さの工具逃げを設け、ねじの頭は床厚3 mmの座に載る。
上蓋のナットは上下2.5 mmの横穴へ挿入。上蓋を締めるとナット上面が横穴の屋根に当たる。
ねじを電池へ向ける部品はない。工具は全て蓋開放後に上から入れられる。

## 電池交換

1. 電源コネクタを外す。
2. 上蓋のM3×12ねじ4本を外し、蓋（上面フォーム付き）を真上へ持ち上げる。
3. 電池を真上へ引き出す。トレイ、MAIN、Sony基板は外さない。
4. 電池とリードを収め、上蓋を支柱に当たるまで締める。

フォームは剛性部品側へ薄いテープで固定し、電池には貼り付けない。
上記フォーム厚は**装着時の厚み**。公称寸法に対する自由厚の例は上3.5、側3.5、端2.5 mmで、0.5 mmの軽い圧縮を想定。
実購入パックの寸法は未実測・商品値±2 mmなので、実寸に合わせフォームと薄いシムを選ぶ。
厚い個体へ同じフォームを無理に押し込まない。上蓋の高さは `lipo_h` と `top_gap` で調整する。
リード出口の現物位置も未確定。西端16 mmの開口は旧トレイのリード逃げを継承した位置。

## 検証

`verification.json`：公称パックの6方向すべてで床／フォームとの距離0、剛性ベースへの食い込み0。
上面フォームと上蓋、上蓋と支柱は接触。ベース／蓋は各STEP 1有効ソリッド、STL閉メッシュ。
STEP/STLの外形差ほぼ0、体積差0.013%未満。
詳細な振動・落下・フォーム保持力の実測は未実施。6面保持を検証した機械レビュー形状である。

## 出力と印刷

`parent_lipo_retainer.scad` の `part` を base / lid / pads / assembly で切り替える。
ベースと蓋をPETGで別々に平置き印刷。padsはフォームの裁断・配置用モデルで、印刷しない。
ベースのナット横穴は2.5 mm高の短いブリッジ。必要なら糸引きを除去してナットを挿す。
寸法データは `dimensions.json`、生成元は `spec/prepare_parent_lipo_retainer.py` と `spec/export_parent_lipo_retainer.py`。

組立状態の追加検査：`assemblies/parent_service_review/battery_retention_checks.json`。
新ベース／上蓋と既存部品の18組、直径8 mmのドライバー4経路、上蓋30 mm／電池35 mmの上抜き経路はすべて干渉0。
`support_checks.json` でM3ナット4個と屋根、ベースとMAIN支持スペーサ4個の接触も確認した。
アセンブリSTEPは28部品で読み戻し、配置不一致0。

## assemblies/parent_hand_service/unified_support_report.md

# 2026-10-29 床板下面の開放ナット座

現行の印刷入口は [parts/PRINT.md](parts/PRINT.md)。床板の裏面からM3ナットを差し込める六角くぼみを11か所設け、上からの貫通ねじで固定する。ナットは印刷完了後に取り付ける。印刷途中の埋込みや横挿入トンネルはない。

## 形状と締結

ナットは対辺5.5 mm・厚さ2.4 mmの既存M3モデル、六角くぼみは対辺5.8 mm・深さ2.6 mm。入口に0.15 mmの案内面を設ける。床板下面Z8.84、ナット受け面Z11.44、床板上面Z18.8。受け面から床上面まで7.36 mmを残す。六角の回り止め面と平らな反力面は機能面として角を保持する。

右端2か所はケース壁へ部品を広げず、既存の床端にくぼみが一部開く。ナットの回転と締付け方向の移動が残る面で止まることを検査対象とする。緩めたナットを下向きに保持する構造ではないため、組立時はケース外で床を横向きにし、指でナットを押さえてねじを数山かける。接着剤は不要。

| 固定箇所 | ねじ・ナット | 締結経路 |
|---|---|---|
| MAINの4点 | M3×30＋M3ナット、各4 | 頭（Z35.6）→MAIN枠→床側受け→同軸リング→床板→下面ナット |
| GNSS支持枠4点 | M3×65＋M3ナット、各4 | 頭→GNSS固定板→50 mmの足→床板→下面ナット |
| Sony支持枠3点 | M3×65＋M3ナット、各3 | 頭→Sony固定板→50 mmの足→床板→下面ナット |
| Sony後左1点 | M3×10、1本 | 上板→足の樹脂下穴。ケースのボスを避け、床貫通ねじは追加しない |

締めると、上のねじ頭が上板／枠を下へ押し、下面ナットが床板内の受け面へ上向きに引かれる。この経路で床板を挟む。床用の座金9枚と、従来の下面からのねじ11本は使用しない。長いねじの経路は通し穴へ変更し、樹脂ねじとの二重締結にしない。

Sony/GNSSの各4本の足は一体構造のまま。床上面から上板下面まで50.0 mm、位置決めキーは別に0.8 mm。基板・配線の高さと配置、M4頭逃げ、北側ペネトレータ2個を残して内装を引き抜く形状は維持する。

## 組立・取り外し

ケース外で床板・受け・同軸リング・支持枠・上板を合わせる。下面からナットをくぼみへ入れ、上からねじを差し、床を横向きにしてナットを指で仮保持しながら数山かける。全ねじを軽く合わせてから締める。MAINはアンテナ棚を取り付ける前に固定する。Sony後右のねじはSPRESENSE基板が工具通路を塞ぐため、支持枠のねじを先に締め、その後で基板を取り付ける。分解・増締めは先にSPRESENSE基板の固定4本を外して基板を退避する。基板を載せたままでの工具アクセスは未達であり、保証しない。蓋を外した状態で上側から工具を入れる。

内装全体の取り出しはケース側配線とM4固定3本を外し、真上へ120 mm持ち上げる手順を維持する。ナットは締結中には床裏へ抜けない。支持枠やMAINを分解するときは内装をケース外へ出し、ねじを抜く前に床裏のナットを受ける。

## 印刷

再印刷は床板、MAIN枠、Sony支持枠、GNSS支持枠の4個。一式は15種類・各1個で、上板などは再使用する。PETG／X1C 0.4 mm／0.2 mm・壁4周・100%充填。下面をベッドへ置く元の印刷姿勢を維持する。床のナット座は下面へ開いており、天井の短い橋（最大約6.7 mm）は局所支持材禁止モディファイアを使って検査する。実造形の橋品質は試作確認。印刷途中でナットを挿入する停止工程はない。

変更前の形状・配置・文書は `_work/analysis/underside_nuts_20261029/history/` に保存。既存Python生成元を更新し、STLとSTEPを同じ形状から生成する。位置と個数はplacement.jsonが正本。

幾何検査と実物の締付け強度を区別する。樹脂の座面耐力・クリープ・波浪・実印刷・実工具・ハーネスの余裕は未認定。

## 検証記録（2026-10-29）

組立CADの357項目がPASS。11か所について、下面からの連続挿入、ナットとケースの非干渉、締付け方向への移動が床の受け面で止まること、両方向10°の回転が六角面で止まること、ねじの全ナット厚へのかかり、上側の座面と工具通路を検査した。足の一体性・50 mm、M4頭、蓋・実装部品との干渉、M10を残す引抜き経路も再検査した。

Sony後右は、基板を装着したままでは工具が干渉する。これは合格に読み替えず、SPRESENSE基板を外すことを作業の前提条件として記録した。締結済みのねじ頭と基板自体は非干渉。

根拠は [_work/analysis/underside_nuts_20261029/assembly_checks.json](_work/analysis/underside_nuts_20261029/assembly_checks.json)。[底面図](_work/images/underside_nut_floor.png)と[GNSS締結断面](_work/images/underside_nut_clamp_section.png)を保存した。

同時に変更された電池本体・蓋は上方取り外し版を保持する。電池側の交換部品と手順は [電池蓋の改訂報告](battery_top_lid_report.md) を参照。今回の床・支持枠4部品の交換とは別の変更である。

共通ツールの単体テストは42件中41件成功。既存の子機用bambu_petg_basic_material.json欠落により1件失敗。記録は `_work/logs/underside_nuts_unit_tests.log`。

### 印刷データの検査

変更4部品を2プレートへ配置し、支持材自動検出を有効にしてスライスした。ナット座11か所と検査対象のねじ通路に支持材押出しは0。床のナット座付近でブリッジの経路を確認した。4部品とも最初のモデル外周はZ0.2 mm、最終外周はモデル上端まで出力されている。実物のブリッジ品質と締付け強度は未確認。

- [プレート1：床板](print_jobs/underside_nuts_20261029/parent_underside_nuts_1.3mf)
- [プレート2：MAIN枠・Sony支持枠・GNSS支持枠](print_jobs/underside_nuts_20261029/parent_underside_nuts_2.3mf)
- [設定・STLハッシュ・G-code検査記録](print_jobs/underside_nuts_20261029/manifest.json)

局所支持材禁止モディファイアはparts/modifiersへ同梱。変更していない関連7部品は現行生成元から再生成し、既存STLと完全に同じSHA-256であることを確認して鮮度を揃えた（`_work/analysis/underside_nuts_20261029/unchanged_rebuild_checks.json`）。電池側の部品データは置換していない。

組立状態・サービス状態のSTL/STEPを再生成し、STEP照合も完了。印刷用4部品は3MF記録のSHA-256と一致。parent_hand_serviceの印刷一式検査と作業ファイル配置検査はPASS。全構成の検査では対象外7構成に既存の未同期／管理外ファイル等が残る（`_work/logs/underside_nuts_all_parts_check.log`）。

---

以下は2026-10-28以前の変更履歴。床下面から樹脂下穴へ締める手順・ねじ長・旧3MFを今回へ適用しない。

# 一体支持枠と埋め込みナット廃止（2026-10-27）

現行の設計方針と手順はこの文書を正本とする。[印刷入口はparts/PRINT.md](parts/PRINT.md)。前回の床内部へ横からナットを挿入する構造と、独立したSony／GNSS柱は廃止する。埋め込みナットを残した前回のSTL・3MFを今回の部品と混ぜない。検査結果は末尾へ追記する。実印刷・締付け・強度の認定ではなく、嵌合確認用の試作。

## 足を一部品へまとめる

SPRESENSE側はsony_support_frame、GNSS側はgnss_support_frameを各1個使う。それぞれ4本の足を下側の連結材でつないだ単一ソリッドで、組立時に個別の足を支えたり向きを合わせたりする必要をなくす。上の固定板は別部品として着脱する。

両方の足の長さは、床板上面Z18.8から固定板下面Z68.8までの50.0 mm。位置決めキーの高さ0.8 mmは足の長さに含めない。SPRESENSE固定板・基板一式は前回より8.3 mm、GNSS固定板・基板・磁気センサは2.8 mm上へ移動する。基板の穴配置と取付相手は維持する。配線には高さ変更分の余裕が必要。

Sony側は北へ開いたU字枠。前側の連結材は幅4 mm・高さ4 mm、中心Y131.4で、電池台の北端とTX基板の下面ピンの間を通す。TXの実取付穴に対応する床側座へ半径3.8 mmの逃げを設け、前側に公称2.3 mmの連結幅を残す。後側のTXねじ座と北側ペネトレータへ連結材を渡さない。GNSS側の左連結材は北西のM4頭とケース隅の柱を回避して曲げる。足と連結材は下面をベッドへ向ける原姿勢で印刷する。外周と接合部に0.1 mm、穴口に0.15 mmの面取りを設ける。ねじ下穴の指定断面と平らな接合面は機能寸法を優先する。

## 埋め込みナットを使わない締結

床板は普通の通し穴に戻し、内部の六角穴、横挿入口、ナットを覆う屋根をなくす。床の下面からねじを上向きに入れ、支持部品の樹脂下穴へ締める。頭と支持部品の間に床板を必ず挟む。樹脂下穴はM3用の内接径2.8 mm、8角形とし、既存の直接ねじ止めと同じ設計値を使う。ねじ山の耐力・適切な締付けトルク・繰返し着脱は実物確認が必要。

| 箇所 | ねじ | 固定の経路 |
|---|---|---|
| MAIN枠の床固定4点 | M3×30、下面から上向き | 頭 → 外付け座金 → 床 → 同軸リング → 床側受け → MAIN枠の樹脂下穴。公称かかり4.94 mm |
| GNSS支持枠の床固定4点 | M3×16、下面から上向き | 頭 → 外付け座金 → 床 → 一体支持枠の樹脂下穴。公称かかり5.54 mm |
| Sony支持枠の床固定3点 | M3×16、下面から上向き | 頭 → 床 → 一体支持枠の樹脂下穴。左前のみ外付け座金を使用し公称かかり5.54 mm、右2点は頭を直接座面に当て公称6.34 mm |
| GNSS固定板4点 | M3×10、上から | 頭 → 固定板 → 50 mmの足の上端・樹脂下穴。公称かかり7.5 mm |
| Sony固定板4点 | M3×10、上から | 頭 → 固定板 → 50 mmの足の上端・樹脂下穴。公称かかり6.8 mm |

Sony後左の足の下にはケースの既存ボスがあるため、新しい床貫通ねじは追加しない。床に着座させ、他の3本へ連続する枠で保持する。以前のGNSS／Sony共有柱と柱内部のナットは使わない。

右端のSony床ねじ2点は、座金と座面をケース壁へ拡張せず、既存のM3頭径5.5 mmを床下面の深さ0.3 mm・径5.7 mmの開放座ぐりへ直接当てる。旧穴入口の面取りを座面から除去し、平らな環状座面で受ける。これは埋め込みナット穴ではない。座ぐりの反力面の縁は機能面として保持する。頭の座面と穴の間の公称半径方向肉厚は1.0 mm。座面の接触とケースとの干渉を検査対象に含める。この寸法を締付け強度の保証として扱わない。

前回のM3×60／65の長い貫通ねじ、床ナット11個、Sony共有柱のナットは使用しない。床固定用のM3座金は外径7・厚0.5 mmを9枚使用する。固定板の上向き位置決めキーはねじの代わりの抜け止めではない。

ほかの印刷部品のナット埋め込みも廃止する。電池蓋は従来のM3×12を、電池台の縦2.8 mm下穴へ直接締める（公称かかり9 mm）。アンテナ棚の鋼板とアンテナは、棚下面へ露出したナットと座金で挟む。鋼板用はM3×10／M3ナット／M3座金を各4、アンテナ用はM4×18／M4ナット／M4座金を各2。ナットは棚をMAIN枠へ載せる前に外から保持して締める。磁気センサも底面へ露出したナイロンM2ナット・厚0.5 mmの座金とM2×10で固定する。GNSS基板の既存の下面露出ナット、ケースの購入品インサート、WetLink付属ナットは維持する。

## 組立と取外し

1. 床板をケースの外で組む。2個の支持枠とMAIN側の受け・同軸リングを載せ、床下面からねじで固定する。ナットの挿入や仮保持は不要。
2. 各上板へ基板を取り付ける。GNSS基板と磁気センサのナットは、上板を足へ載せる前に下から保持して締める。
3. 上板を4本の足のキーへ合わせ、それぞれ4本のM3×10で固定する。
4. アンテナ棚は外付けナットで鋼板・アンテナを先に固定し、その後でMAIN枠へ取り付ける。
5. 電池蓋をM3×12で台の縦下穴へ固定する。下穴を空回りさせる締付けや長すぎるねじを使わない。
6. WetLink M10と付属ナットを2個ともケースへ残し、北側の切欠きを合わせて内装を下ろす。ケースのM4固定3本を締め、配線を接続する。
7. 内装を取り出すときは配線とM4固定3本を外し、真上へ120 mm持ち上げてから箱の横へ移す。床下面のねじを外す必要はない。WetLinkナットへの専用レンチ操作は内装取外し後に行う。

北側穴は、A面を外から見た左端から35／60 mm、箱座標X175／150、外底面から高さ30〜35 mm。M4頭の逃げ10.8 mmと北側の開放切欠きは維持する。実M4の頭高さ・首下長さは未測定で、頭10×高さ5 mm、首下12 mmの参照包絡を継続する。専用M10レンチの通路は検査するが、任意のスパナ、ラチェットの柄、実ケーブルは共通の保証対象ではない。

## 印刷するもの

一式は15種類15個。変更する印刷部品は、床板、MAIN枠、アンテナ棚、電池台、GNSS固定板、Sony一体支持枠、GNSS一体支持枠の7個。Sony上板、同軸リング、電池蓋、電源アダプタ、MAIN側の床受け4個は同じ形状の既存品を再使用できる。

PETG／X1C 0.4 mm／0.2 mm積層／壁4周／100%充填を引き継ぐ。アンテナ棚は上面をベッドへ向けて反転、それ以外の変更部品は下面をベッドへ向ける。同梱STLは製造姿勢へ変換済みで、部品配置の回転を追加しない。支持枠には3 mmの外ブリムを使用する。ナットをまたぐ大きい屋根はなく、縦の樹脂下穴の止まり部分だけに最大約3.2 mmの小さい橋が残る。これはナット埋め込み穴ではない。実際の橋の品質とねじの嵌合は試作で確認する。

印刷一式の支持材禁止モディファイアも同じparts内へ含める。スライスでは支持材検出を有効にして下穴内の押出しを検査する。単に支持材を無効化した結果を造形成立の証拠にしない。

## 正本と検証

寸法と締結表はscad/lib/parent_service_datums.py、支持枠とMAIN／棚は既存parent_service_retrofit.py、床はparent_floor_access.py、電池台とGNSS上板は既存の生成元を更新する。出力SCAD、印刷STL、STEPを別々に設計しない。配置・数量の正本はplacement.json。

再生成は次の順で、各段階の成功を確認する。

```powershell
python spec/revise_parent_floor_access.py
python spec/revise_parent_floor_access.py --related
python spec/publish_parent_plate_access.py --prepare
python spec/revise_parent_floor_access.py --verify
python spec/publish_parent_plate_access.py
python spec/publish_parent_plate_access.py --assemblies
python spec/slice_parent_plate_access.py
python tools/assembly_parts.py check parent_hand_service
```

今回の変更前の原本と印刷形状は、_work/analysis/unified_support_20261027/history/へ保存する。前回のplate_access_report.mdと解析記録は履歴として保持する。STLの閉メッシュ、配置照合、干渉、締結経路、造形、実物の強度を区別して報告する。材料下穴の耐力、締付けトルク、クリープ、波浪、実配線、密閉・防水は未確認。

## 2026-10-28 引継ぎ後の検証結果

組立CADの239項目がすべてPASS。各4本の足は肩まで50.0 mm、キーを含むSTL高さは50.8 mm。両支持枠は単一ソリッド・閉メッシュ。床・上板との着座、樹脂下穴のかかりと底付き余裕、外付けナットの反力面、蓋との非干渉、M4頭、M10を残した連続引抜きとケース外での専用工具経路を確認した。

引継ぎ候補にあったSony前側連結材とTX取付座の干渉を、連結材移動と取付座の局所逃げで解消。右側床ねじ2点の座面は浅い座ぐりで平面化し、接触面積13.610 mm²を確認した。接触面積のみで強度を認定していない。全形状の新規剛性解析・実締付け・実印刷・実配線は未確認。

検査詳細は [_work/analysis/unified_support_20261027/assembly_checks.json](_work/analysis/unified_support_20261027/assembly_checks.json)。各生成と検査の入力ハッシュ・STEP/STL再読込は同フォルダのfloor_run.json、related_run.json、verification_run.jsonが指す独立runへ保持。確認画像は [_work/images/unified_support_assembly.png](_work/images/unified_support_assembly.png)（支持枠を青、対象基板を緑で表示。他部品は一部省略）。

共通ツールの単体テストは42件中41件成功。子機用のbambu_petg_basic_material.jsonが存在しないため1件失敗しており、親機の形状検査とは別の既存リソース欠落として記録する。

### スライスと納品

変更7部品をX1C／0.4 mm／PETG／0.2 mm・壁4周・100%充填で3プレートへ配置。支持材自動検出45°と橋の支持を有効にし、機能穴だけを局所モディファイアで除外した。全7部品で最初のモデル外周がZ0.2 mm、最後の外周が外形高さまであること、検査対象の下穴・座ぐりに支持材押出しが0であることをG-codeで確認。Sony/GNSSの止まり穴の短い橋の出力も記録した。実造形の橋品質と樹脂ねじの嵌合は未確認で、全面サポート不要とは認定していない。

- [プレート1：床板](print_jobs/unified_support_20261027/parent_unified_support_1.3mf)
- [プレート2：MAIN枠・アンテナ棚・Sony支持枠](print_jobs/unified_support_20261027/parent_unified_support_2.3mf)
- [プレート3：電池台・GNSS支持枠・GNSS固定板](print_jobs/unified_support_20261027/parent_unified_support_3.3mf)

STLハッシュ・配置・設定・検査結果は [スライスmanifest](print_jobs/unified_support_20261027/manifest.json)。同じ部品をpartsのSTLから重複印刷しない。追加した座ぐり・MAIN下穴・電池蓋下穴の支持材禁止形状はspec/slice_parent_plate_access.pyが生成し、parts/modifiersへ同梱する。印刷部品ではない。

現行parent_hand_serviceの出所・数量・鮮度チェックはPASS。全構成チェックでは他の7構成に不一致が残る。parent_integrated等の派生／旧構成は今回更新していない。詳細は [_work/logs/unified_support_all_parts_check.log](_work/logs/unified_support_all_parts_check.log)。画像・中間ファイルの整理検査はPASS。

閉状態のparent_hand_service.step／closed.stepと整備状態service.stepを配置正本から再生成し、各STEPの再読込検査が成功。今回起動したCAD・OpenSCAD・スライサの記録PIDと開始時刻を照合し、残存プロセスがないことを確認した。

## assemblies/parent_hand_service/battery_top_lid_report.md

# 電池ボックス：上方取り外し蓋（2026-10-29）

全長スライド溝を廃止し、蓋を真上へ外す構造へ変更。ボックスを持ち上げるために底の固定ねじ4本を外す操作は不要。防水容器の外蓋を開け、電池蓋のM3×12を1本外してから、蓋を上へ取り外す。

再印刷は **battery_base と parent_lipo_retainer_lid_slide を各1個**。後者は既存参照との互換性のためファイル名だけを保持しており、形状はスライド式ではない。旧蓋と新本体、または新蓋と旧本体を組み合わせない。印刷用データの入口は [parts/PRINT.md](parts/PRINT.md)。

## 構造と締結

- 蓋厚3 mm、上面補強リブ高さ3 mm。下面は平面で、電池上面の既存フォームに接する。
- M3×12はボックス局所座標X50／Y5の1か所。蓋の通し穴は対辺3.45 mmの補正八角形、ボックスの樹脂下穴は直径2.8 mm。新しいナットは不要。
- ねじ頭座面Z32 → 蓋3 mm → ボックス一体ボス上面Z29 → ボス内部の樹脂ねじ部、の順に荷重を伝える。ねじ先端Z20、下穴底Z18で底付き余裕2 mm、名目ねじかかり9 mm。ねじは蓋をボックスへ押さえ付ける。
- 4本の位置決めピンは局所X12／91、Y5／50。1.4 mm角、高さ2 mm。蓋の2.0 mm角の穴に片側0.3 mmのすきまで入り、横ずれを抑える。ピンに上向きの抜け止めはなく、ねじを外せば真上へ離れる。
- 電池の位置、既存フォーム、配線側の開口、床への取付4か所は維持。配線をねじ座や位置決めピンへ挟まない。

樹脂への直接ねじ固定は既存方式を継承する。CADで確認できるのは座面・経路・名目かかり長さであり、ねじ山の破損荷重、繰返し開閉、蓋のたわみ、波浪荷重やPETGのクリープの保証ではない。実物で過締めせず、嵌合と保持を確認する。

## 印刷とエッジ

ボックスは底面をベッド、蓋は平らな下面をベッドとして双方とも原姿勢（回転0°）。位置決めピンとリブは上へ積層する。旧側溝用・旧ナット用のサポート禁止モディファイアは使用しない。ねじ下穴は縦向きの盲穴で、空洞上の屋根を持たない。下穴底の既存45°逃げにスライサが微小な支持材を生成するため、`battery_lid_pilot_support_blocker` を新しい穴位置X50／Y5へ移動して同梱した。これは印刷する部品ではなく、穴内だけのサポート禁止設定として使う。

蓋の縁・リブ・穴口は0.15 mmを基本に面取り、ピンは0.1 mm面取り。ボックスの既存面取りと機能接触面は継承する。樹脂下穴は既存の円形2.8 mmの嵌合を保持する。

## 生成と証拠

正本は `scad/lib/parent_battery_slide.py` と `spec/build_parent_hand_service.py` の電池生成部。新しい基盤レシピ `spec/build_parent_battery_top_lid.py` は同じ正本を呼び出す。SCAD／STEP／STLは同じ形状からの生成物。過去の解析・印刷ジョブは履歴として残す。

再生成：`python -X utf8 spec/revise_parent_battery_top_lid.py`。配置検証：同コマンドに `--verify`。検証後の同期：`python -X utf8 spec/publish_parent_battery_top_lid.py`。

今回の記録は [_work/analysis/battery_top_lid_20261029/](_work/analysis/battery_top_lid_20261029/)。`build_run.json` は形状の保存・再読込、`checks.json` は取外しと締結経路、`mesh_checks.json` は閉メッシュとOpenSCAD照合、`slice_checks.json` はスライサ処理結果。実物の印刷・実配線・保持強度は未検証。

X1C／0.4 mm・PETG・積層0.2 mm、4壁、充填100%の既存プロファイルでスライスを確認した。支持材検出45°を有効にし、本体は上記穴内禁止設定を併用。最終結果は本体・蓋とも支持材0。実造形の保証ではない。PC上の一時CAD／スライサ処理はタイムアウト付きで実行し、PIDと終了状態を解析フォルダへ記録している。

全体の既存ツールテストは42件中41件成功。電池変更とは別の `test_clamp_bambu_material` は、子機クランプの既存材料JSON欠落でエラー。今回そのファイルや子機形状は変更していない。

対象 `parent_hand_service` の印刷一式チェックと作業ファイル配置チェックはPASS。全構成チェックには子機の未管理3MF、および旧親機構成の出所・文書不一致が残る（`_work/logs/battery_top_lid_all_parts_check.log`）。この電池変更で旧構成を一括更新せず、検証済み範囲を本構成へ限定した。共有生成元の更新をフォルダ単位で検出するため、同梱の他部品は既存STEPを再メッシュし、形状の保存・再読込と閉メッシュを照合した。これらの部品を新設計へ置き換えたものではない。

本体と蓋の分解表示

## assemblies/parent_hand_service/plate_access_report.md

# 北側ペネトレータと床板の改訂（2026-10-27）

印刷入口は [parts/PRINT.md](parts/PRINT.md)。この改訂では床板も交換する。以前の「床板は無加工で再使用」「床裏のナットと座金を押さえて締める」という手順に優先する。状態は実物嵌合確認用の試作。強度・実印刷・実工具での操作は未認定。

## 確認した取合い

- WetLink M10をA側（北壁。本体側面外面Y=228.3、蓋外形の北端Y=230）に2個。A面を外から見た左端から35／60 mmで、箱座標X=175／150 mm。穴中心高さは外底面から30〜35 mm。表示モデルは32.5 mm、引抜き検査は高さ範囲全体を含む包絡で行う。
- 付属ナットも取付状態のまま残す。メーカーのナット・専用レンチのSTEPを使用する。対辺16 mmは[メーカーの組立資料](https://bluerobotics.com/learn/wetlink-penetrator-installation-guide/)でも確認した。
- ケース固定ねじはM4、頭径は約10 mm。頭の逃げは内接径10.8 mm。検査用の頭包絡は直径10×高さ5 mm、首下12 mmは旧モデルから引き継いだ仮定。高さ5 mmや首下12 mmを実物の確定寸法として扱わない。実ねじの頭高さ・首下長さ・工具は要確認。

ケース購入品の原本は未加工の参照モデルを維持する。ペネトレータは指定された既存穴の取付位置へ表示しており、ケース壁と本体ねじ部が重なる箇所は穴加工を前提とする。この改訂でケースへの穴加工や密閉の検証を完了した意味ではない。

## 変更した形状と配置

床の北端に、ねじ部とナットの通過幅を分けた開放切欠きを作った。ねじ部はX=144.2〜180.8、Y=207.2125から北側へ、ナット部はX=140.2〜184.8、Y=215.2から北側へ開放する。内部突出部に片側0.8 mmの設計すきまを取る。2本の溝の間に孤立する格子片を残さず、まとめて取り除く。ケース取付の使用3点は維持し、北東のM4穴は従来どおり使わない。

TX基板は西1 mm・南5 mmへ移動し、原点をX147／Y135.5／Z24.8にした。取付穴と床の支持座、上部20 mmの予約空間も追従する。基板自体のCAD・穴配置は変更しない。

Sony側の床取付軸は次のとおり。基板の4穴と高さ、板厚3.2 mm、支柱接合面Z60.5は維持する。移動後の格子から離れるPCBねじ座には短い支持腕をつなぎ、浮いたねじ座を残さない。

| 軸 | 改訂後X／Y [mm] | 対応する支持部品 |
|---|---|---|
| 前左0 | 142.5／134.5 | sony_fixed_column_0 |
| 前右1 | 201／134.5 | sony_fixed_column_1（形状・位置は従来どおり） |
| 後左2 | 142.5／202.5 | gnss_sony_shared_column |
| 後右3 | 201／204.5 | sony_fixed_column_3（形状・位置は従来どおり） |

同軸リング下面もM4頭に合わせて逃がす。電池台の旧8 mm工具穴は10.8 mmへ広げ、配線側の端まで開放して薄い残片を作らない。電池の収納・蓋の固定・ケースのM4座面高さは維持する。

## ナットの保持と締結経路

床側のM3ナット11か所を、上面開放穴と床裏の座金から、床の内部へ横から挿入するナット座へ変更した。六角穴は対辺5.8 mm、底Z13.0、屋根下面Z15.6。標準の対辺5.5×厚2.4 mmナットは締結後の下面Z13.2／上面Z15.6。屋根厚は端部面取りを除いて公称3.2 mm。

| 締結 | 継続使用するねじ | 反力までの経路 |
|---|---|---|
| MAIN枠4軸 | M3×30、4本 | 頭 → MAIN枠 → 床側受け → 同軸リング → 床 → 床の屋根 → M3ナット |
| GNSS4軸 | M3×65、4本 | 頭 → GNSS台 → 支柱 → 床 → 床の屋根 → M3ナット |
| Sony独立3軸 | M3×60、3本 | 頭 → Sony固定板 → 支柱 → 床 → 床の屋根 → M3ナット |
| 共有柱のSony側1軸 | M3×10、1本 | 頭 → Sony固定板 → 共有柱の上面・屋根 → 側面挿入ナット。共有柱は連続した橋と隣のGNSS床軸で固定 |

床ナット11個は再使用できる。従来の床裏の座金11枚はこの改訂では使わない。他の基板・アンテナ・電池のナットと混同しない。ねじ長さと先端位置は従来と同じで、GNSSねじ先端とケース床との公称余裕は0.5 mm。実ねじ長さ・有効ねじ部・実ケース床との余裕は実物で確認する。

六角面は回り止め、屋根は締付け時の+Z方向の抜け止め、底は逆向きの脱落止めとなる。挿入中は横口から出られるため、ねじが掛かるまでは指・工具で仮保持する。ねじが掛かった後は軸が横抜けを止める。ナットの挿入口、平らな反力面、六角の機能稜は指定断面を維持し、面取りで保持面を削らない。床外周・切欠き・M4口の扱い稜は面取りする。

挿入方向と作業セルの座標は [_work/analysis/plate_access_20261027/candidate_checks.json](_work/analysis/plate_access_20261027/candidate_checks.json) の各ラベルに記録する。床をケースへ入れる前に、上の板・支柱を載せない状態でナットを入れる。

## 組立と整備

1. 床板をケースの外で組む。床ナット11個を横から入れ、ねじが掛かるまで仮保持する。共有柱のSony側ナットも側面から入れる。
2. 支柱・同軸リング・固定板を載せ、表のM3ねじで固定する。固定対象の床を必ず締結経路に含める。TX基板を改訂後の4座へ取り付ける。
3. 2個のペネトレータとナットをケースへ残した状態で、北側切欠きを合わせて内装を下ろす。M4ねじ3本でケースへ固定し、配線を接続する。
4. 取り出すときは、蓋を外し、電源を切り、ケース側の配線を解放する。M4固定3本を外し、内装一式をまっすぐ上へ120 mm持ち上げてから横へ移す。ナット座の横口を配線で塞がない。ケーブルを引っ張って取り出さない。
5. ペネトレータのナットを操作する場合は内装を取り出してから、ケース内側へレンチを入れる。口をケース内面から約0.5 mm控え、ナットの軸長8 mmのうち約7.5 mmへ掛ける工具位置とする。検査対象はメーカーのM10専用レンチ（外径20.5、軸方向60 mm）と、挿入・360°回転の包絡。2個とも残した状態を検査する。ラチェット・横棒・任意のスパナまで共通に保証したものではない。外側本体を保持する工具も実物で確認する。

service.stepは、ケースとペネトレータを残し、内装一式を箱の横へ出した確認姿勢。実際の引抜きは最初に上方向へ行う。

## 再印刷する部品

床板、Sony固定板、Sony前左柱0、共有柱、電池台、同軸リングを各1個、計6個交換する。Sony右柱1／3など、形状が同じ部品まで重複して印刷しない。一式の入口はparts/PRINT.md。新しい床板を加えた全一式は20種類20個。既存の蓋とGNSS台も含め、このpartsだけで全体を印刷できる。既に使っている同じ形状の部品は再使用し、再印刷は上の6個に限る。

PETG、X1C／0.4 mm、0.2 mm積層、壁4周、100%充填を従来条件として引き継ぐ。6部品は原姿勢の下面をベッドへ向ける。同梱STLはベッドへ変換済み。ナット座・通し穴の支持材禁止モディファイアも同じparts内に同梱する。橋の造形と実物のねじ嵌合は試作確認が必要。

ナット座の屋根は短いブリッジを含む。G-codeの線分端と下層断面の照合では、すべての端が下層に載るという条件を満たしていない。サポートをナットの通路から排除できても、屋根の造形成立や保持耐力を保証しない。試作時は横口から屋根の垂れ・空洞・層間剥離を観察し、ナットの挿入と締付けを確認する。現段階を「サポートなし造形を実証済み」と扱わない。

床板の確認画像：

改訂床板

内装取外し後の専用レンチ位置：

ペネトレータを残した工具進入

## 正本と検証記録

床の既存生成元はspec/build_parent_hand_service.py／spec/parent_switch_tx_body.pyを継続する。新しい局所形状はscad/lib/parent_floor_access.py、寸法はscad/lib/parent_gnss.py。Sonyの支持形状、同軸リング、電池台も既存モジュールを更新した。生成SCADと印刷用STLを手編集しない。

メーカー原本はparts/common/exterior/cots/wetlink_penetrator_m10/ref/へ保存。ナットとレンチはメーカーSTEPを用いる。本体のメーカーSTEPは開いた面モデルを含むため、ソリッドへ補修して採用せず、従来のSCAD本体参考形状を継続する。STEPと同梱STLでは原点が異なるため、使用したSTEPからSTLを再生成する。

再生成・検証入口：

```powershell
python spec/revise_parent_floor_access.py
python spec/revise_parent_floor_access.py --related
python spec/publish_parent_plate_access.py --prepare
python spec/revise_parent_floor_access.py --verify
python spec/publish_parent_plate_access.py
python spec/publish_parent_plate_access.py --assemblies
python spec/slice_parent_plate_access.py
python spec/check_parent_plate_access_delivery.py
python tools/assembly_parts.py check parent_hand_service
```

段階ごとに成功を確認してから次のコマンドへ進む。解析・検査は_work/analysis/plate_access_20261027/、CAD基盤の入力スナップショット・再読込結果は同フォルダの*_run.jsonから参照できる。source hashを照合した床の基礎形状キャッシュのみ再利用し、条件が変われば作り直す。

閉メッシュ、STEP/STL整合、ナットの連続挿入と軸方向保持、締結座面、変更部の干渉、引抜きと工具包絡、スライス、実物試験は別々に評価する。最終の実行結果はassembly_checks.jsonとpublication.json、スライスの記録を参照。ケーブル実寸とサービスループ、実ねじ・実工具・印刷品、公差、締付けトルク、屋根の耐力、クリープ、波浪、密閉防水は未確認。旧形状のFEA・実験結果を今回の強度認定に流用しない。

## 最終検証の範囲

| 検査 | 結果と根拠 |
|---|---|
| 部品の再生成・交換形式 | 既存Python正本から再生成し、OpenSCADレンダリング、STL閉メッシュ、STEP再読込と外形・体積を確認。関連13部品は旧形状との外形・体積の差が0。床・関連部品の*_run.jsonとpublication.jsonに記録 |
| 干渉・締結・整備経路 | [149項目すべて合格](_work/analysis/plate_access_20261027/assembly_checks.json)。連続したナット挿入・引抜き、締結方向の抜け止め、座面、ペネトレータを残す引抜き、専用レンチの進入・回転を含む |
| 全体STEP | 閉状態127項目、整備状態126項目とも配置との照合で0 NG。これは全体STEPの配置照合であり、全ての旧部品の強度・実物嵌合の再認定ではない |
| 印刷一式 | 20種類20個、モディファイア17個。対象の出所・数量・古さ・コピー一致検査が合格 |
| スライス | [試作3MFと設定](print_jobs/plate_access_20261027/manifest.json)。6部品を2プレートに分け、全品の初層・最終層と、ナット通路を横切る支持材の押出しが0であることを確認。3MFのハッシュと最終STL6個のハッシュを照合 |
| 下向き面の抽出 | 最終印刷姿勢で6部品を45°条件で解析。[_work/analysis/plate_access_20261027/overhang/](_work/analysis/plate_access_20261027/overhang/)に数値を保存。面積の抽出はブリッジの造形成立の認定と区別する |
| 作業ファイル | tidy_workspace検査合格。確認画像・ログ・中間ファイルは_work内 |
| ツールの単体検査 | 42件中、失敗0・エラー1。子機クランプの既存材料ファイルbambu_petg_basic_material.jsonが欠落しており、test_clamp_bambu_materialがエラー。今回の変更で仮の材料値を作って通していない |

全構成の印刷一式検査には、対象外の7構成の指摘が残る。parent_integrated、parent_interior_p1、parent_interior_p2、parent_rope_float、parent_service_review、parent_spar_boltedはCAD／設定と印刷一式の不一致、child_horizontal_plate_frameは管理外camera_front_clamp.3mf。旧構成をこの改訂の現行部品へ昇格・再生成して解消した扱いにはしない。[全構成の結果](_work/analysis/plate_access_20261027/all_print_sets_check.log)と[単体検査の詳細](_work/analysis/plate_access_20261027/unittest.log)を保持する。

parts内に以前からあった2026-10-24の単品3MF2個は、ハッシュを保持して[print_jobsの履歴](print_jobs/single_part_history_20261024/manifest.json)へ移動した。元STL・材料・設定との対応は未確認で、今回の試作3MFとして使わない。

実物試験と屋根の造形確認が残るため、状態は嵌合確認用試作を維持する。今回起動したCAD・スライサー・検査の一時プロセスは検査後に終了する。

## assemblies/parent_hand_service/retrofit_report.md

2026-10-24追補：Sony固定板は割れ対策の厚3.2 mm版を1個再印刷する。基板を1.6 mm上げる。再使用の対象からこの板を除外する。詳細は [増厚報告](sony_plate_thickening_report.md)。

# 親機内装・床板再利用改良（2026-10-24）

状態：実物嵌合確認用の試作設計。印刷入口は [parts/PRINT.md](parts/PRINT.md)。最終検査の機械可読記録は `_work/analysis/retrofit_20261024/release_record.json` と各 survey JSON。実物組立、積層強度、疲労、クリープ、防水性能は未認定。

## 再利用と交換

- 最下段 `floor_plate` はSCAD・STEP・STLのSHA-256を変更前と照合し、形状・穴を変更しない。再印刷・穴拡大・追加穴あけは不要。
- LiPo台・蓋・固定具、GNSS／磁気センサ支持枠、アンテナ鋼板を再利用する。
- MAIN固定板・アンテナラック・従来のMAIN/Sony/GNSSスペーサを新しい枠と固定柱へ交換する。
- コード巻リングはケーブル入口を上へ開いた `ann_mb1_coax_ring_service` に交換する。容器ねじの工具通路、床側の既存穴、巻き領域OD100/ID75/H10は維持する。
- 交換印刷は16種類16個。Sony固定板を含む。旧 `cradle_nut_keeper` 4個は使用しない。購入品の同軸ケーブル参照モデルは印刷しない。

## 配置

| 対象 | 変更 |
|---|---|
| MAIN基板 | 上へ3 mm、基板下面Z45。固定板の梁下面はZ37.1 |
| アンテナ・鋼板 | 南へ12 mm、上へ8.8 mm。アンテナ上端Z95.9 |
| 電源基板 | 元の向き（追加180°回転なし）のまま、南へ11 mm、上へ5.5 mm。基板下面Z33.8 |
| GNSS・磁気センサ支持枠と実装品 | 上へ16 mm。ユニバーサル基板下面Z72 |
| Sony・LiPo・TX | 位置を維持 |

RTCは現行CADの部品上端に10 mmを追加した予約空間で確認する。実測高さではない。アンテナ棚を南へ逃がし、ケーブルもこの予約空間から外す。

**ふた屋根Z97.1に対するアンテナ上の公称すきまは1.2 mm。** ケースの実寸・反り・アンテナ実物を確認し、ふたで押し込んで閉じない。既存ケースCADは図面由来で、実物測定済みを意味しない。

XTは差込方向20 mm、断面はCADコネクタ外形の各側へ2 mm追加した仮包絡。スイッチ操作は直径12 mmの西側進入包絡で検査する。実際のプラグ、指、工具の寸法は別途照合する。

## 締結の成立経路

床板上面へ開いた旧ナット穴を、上方向の引抜きを受ける面として使用しない。旧MAIN用4個とSony左奥の旧床ナットは取り除く。

| 締結 | 頭の座面から反力まで |
|---|---|
| GNSS/Sony柱の床固定 | 床裏のM3×20頭 → 座金 → 床板 → 柱下面 → 樹脂下穴。下側の公称かかり9.54 mm |
| コード巻・床側受け4点 | 床裏M3×20頭 → 座金 → 床板 → リング → 受けの樹脂下穴。公称かかり6.54 mm |
| 整備用4本 | M3×8頭Z36.84 → MAIN枠の足 → 床側受け上面Z33.4 → 樹脂下穴。公称かかり4.56 mm。床側ねじとの先端間隔0.50 mm |
| GNSS支持枠 | M3×10頭Z68.5 → 支持枠 → 柱上端Z66 → 樹脂下穴。キーを除く柱本体へのかかり7.5 mm |
| Sony固定板 | M3×10頭Z63.7 → 厚3.2 mmの固定板 → 柱上端Z60.5 → 樹脂下穴。キーを除く柱本体へのかかり6.8 mm |
| MAIN基板 | M3×8頭 → PCB → 一体ボス座面 → 樹脂下穴のねじ山。公称かかり6.35 mm、先端からボス下面まで1.5 mm |
| 電源基板 | M3×6頭 → PCB → アダプタ座面 → 樹脂下穴のねじ山。公称かかり4.35 mm、先端からボス下面まで1.15 mm |
| アダプタと床 | M3×8頭 → 1 mm沈めたねじ頭座面（残厚2 mm）→ アダプタ → 既存電源基板ボスの既存ねじ穴。公称かかり6 mm。樹脂ねじ部の保持力は実物未検証 |
| アンテナ棚とMAIN枠 | M3×30頭 → 棚 → Z50の接合面とキー → 下枠の樹脂下穴。キーを除く本体へのかかり7.6 mm。組立後はこの4本を整備で外さない |
| 鋼板・アンテナ | M3×8／M4×14頭 → 鋼板またはアンテナ足と鋼板 → 棚 → 下面から入れた六角ナット。上側の屋根が締付け力を受ける |

Sony左奥X144/Y211.5の床裏には容器ボスがあるため、そこへ裏ナット／ねじ頭を置かない。隣の既存GNSS床穴X135/Y219を使う低い連結部と2本の柱を一体化する。穴の追加はない。連結部の荷重下の変形・強度は未認定。

スペーサ・床側受け・MAIN枠の接合柱には内部ナット穴を設けない。旧ナットと抜け止めは使わない。アンテナ棚下面の6個は、印刷姿勢で上へ開く座のため継続する。樹脂下穴の締付け強度と繰返し着脱寿命は未検証。

## ねじとナット

改良部の必要数。既存部品から同じ規格のものは再利用できる。首下長の最大は30 mmで、50 mmを超えるねじは使わない。

| 金具 | 個数 | 用途 |
|---|---:|---|
| M3×6 | 4 | 電源基板を樹脂下穴へ直接固定 |
| M3×8 | 16 | 整備4、MAIN4、電源アダプタ4、鋼板4 |
| M3×10 | 8 | GNSS枠4、Sony固定板4 |
| M3×20 | 11 | 床裏から柱7・コード巻受け4 |
| M3×30 | 4 | アンテナ棚とMAIN枠 |
| M4×14 | 2 | アンテナ足 |
| M3ナット AF5.5×厚2.4 | 4 | アンテナ棚の鋼板固定。底面に開いた座のみ |
| M4ナット AF7×厚3.2 | 2 | アンテナ足 |
| M3座金 外径7／内径3.2／厚0.5 | 11 | 床裏 |
| M3×12 | 4 | 既存GNSSユニバーサル基板のM3×10から交換。既存M3ナット4個を再利用 |

ケース固定、LiPo、Sony基板、TX、磁気センサの金具は既存構成を引き継ぐ。新しい金具寸法は設計包絡であり、手持ち品の実測値ではない。六角穴頭の公称包絡はM3が径5.5×高さ3、M4が径7×高さ4。実物の頭・ナット・ねじ先端面取りを確認する。

## 組立順序

1. 電源とLiPoを外し、既存内装をケースから取り出す。床板・LiPo固定具を傷めず旧支柱と不要な床ナットを取り外す。
2. 内部ナット穴のない床側受け4個をコード巻リングに合わせ、床裏から座金＋M3×20を受けの下穴へ直接締める。床板とリングを確実に挟む。
3. GNSS/Sony固定柱を共有柱も含め床裏から7本のM3×20で直接固定する。上側の支持枠・固定板はM3×10を柱へ直接締める。
4. 電源アダプタを既存4穴にM3×8で固定し、元の向きの電源基板をM3×6で樹脂下穴へ直接取り付ける。XTの先20 mmとスイッチ操作路を空ける。
5. 既存GNSS／磁気センサ枠、新しい厚3.2 mmのSony固定板と実装品を新しい柱へ取り付ける。GNSSユニバーサル基板の4本はM3×12へ交換する。
6. MAIN基板をM3×8でMAIN枠の樹脂下穴へ直接取り付ける。アンテナ棚をキーに合わせて載せ、M3×30を4本締める。棚下面のナットを入れ、鋼板M3×8・アンテナM4×14を固定する。棚が分かれるので、実装済みMAINを狭い屋根の下へ滑り込ませる必要はない。
7. 同軸を巻き、左側の開いた入口へ2本の引出しを通す。アンテナ側の約235 mmの整備ループを確保する。ループを締め付けて固定しない。
8. 床をケースへ戻し、容器固定ねじを操作する。MAIN＋アンテナを載せ、整備用M3×8を4本締める。配線を戻し、ふたと各部品の実物クリアランスを確認する。

## 日常のコード巻整備

電源を切り、MAINにつながる必要な配線とGNSS側SMAを外す。床側受けへ締まる**M3×8の4本だけ**を外す。アンテナ側の余長を自由にし、MAIN＋アンテナを一緒に上へ持ち上げる。MAIN枠の側壁・アンテナ棚は一緒に残り、短い受けとコード巻は床側に残る。

上方120 mmの剛体部品の全経路を保守的な連続包絡で検査する。ケーブルは剛体移動させず、余長をゆっくり解く。端を引っ張らない。ケーブル変形・実際の巻き量・コネクタ取り外しの実物試験は未実施。

南西と北西の容器固定ねじはユニットを外してから既存の傾斜工具路で操作できる。南東側は既存LiPo台の手順を引き継ぐ。工具穴を配線で塞がない。

## 印刷

PETG、0.4 mmノズル、0.2 mm積層、壁4周、100%充填を基準とする。配布STLは製造設定の姿勢に合わせてベッド上へ移動済み。

- MAIN枠：下側をベッドへ。梁下面に必要な局所サポートは、組立前に開いた下面から除去する。
- アンテナ棚：鋼板の座面をベッドへ向ける。基本形状はこの姿勢で立ち上がる。
- 固定柱・受け・アダプタ・リング：平らな下面をベッドへ。細い柱にはブリムを付ける。
- 旧抜け止め4個：今回の内部ナット穴なし版では使用も印刷もしない。
- 側入れナット座の幅約6.7 mmは橋渡しとして扱い、取り出せない支持材を入れない。穴・座面・入口のバリを除去し、別体のナットで嵌合を確かめる。

閉メッシュ、CAD干渉、締結経路の形状検査は、実印刷や締付け強度の合格を意味しない。検査結果と未検証範囲は release_record と survey JSON を参照する。

## 再生成

形状の正本は `scad/lib/parent_service_retrofit.py`。既存 `spec/build_parent_hand_service.py --service-retrofit` から生成する。MAIN固定板の共通関数を再利用し、床板生成は実行しない。リング改訂は既存の `ann_mb1_coax_ring.step` への局所的な入口加工で、元のリングを上書きしない。各部品は従来の部品フォルダ内に1か所だけ置く。

独立FreeCAD検査用の入口は `spec/build_parent_service_retrofit_candidate.py`。配置、金具、サービス動作の検査後に `spec/publish_parent_service_retrofit.py` で反映し、assemblyを再ビルドして印刷一式を同期する。過去の裸の全体生成手順で古い配置へ戻さない。

## スライス確認結果（2026-10-24）

X1C／0.4 mm／Generic PETG／0.2 mm／壁4周／100%充填で2プレートをスライスした。設定済み [プレート1](print_jobs/retrofit_20261024/retrofit_plate_1.3mf) と [プレート2](print_jobs/retrofit_20261024/retrofit_plate_2.3mf) をプロジェクトとして開く。2枚で16個。予測は約161 g、合計約6時間20分（実印刷時間ではない）。

全19個に初層と上端付近の外周出力があり、造形範囲内に収まる。自動サポート45°、橋渡し除外OFF、局所支持材禁止を有効にした。ナット座・盲穴内部・抜け止め溝の検査域に支持材経路なし。MAIN枠の床面から3.7 mmまでの開いた梁下面、リング下面、Sony固定板の底面へ開いた位置決め凹部4か所の局所支持材は組立前に除去する。スペーサの縦下穴内には支持材経路がない。ボルト穴の下の空間にも支持材があるため、下側から完全に除去してからねじを入れる。

[実出力層・プレート1](_work/images/retrofit_plate_1_layers.png) と [プレート2](_work/images/retrofit_plate_2_layers.png) を確認した。小さな橋渡し、PETGの垂れ、嵌合と実締付けは実印刷で確認する。STLで再スライスする場合は parts/modifiers の該当ファイルを支持材禁止として読み込み、部品と同じ座標を保持する。モディファイア自体を印刷しない。

今回の基板直接固定版は2プレートともスライサが正常終了し、16個の実G-code経路と支持材禁止領域を検査した。前版の終了タイムアウトと回復検証は履歴として `_work/analysis/retrofit_20261024/slicing/timeout_recovery_review.json` に残す。

16種類のOpenSCAD再レンダリングは閉メッシュで、元STLとの外形差0.01 mm未満・体積差0.1%未満。棚下面のナット締結形状6箇所、基板の樹脂直接固定8箇所、支柱等の樹脂直接固定27箇所、床裏座面11箇所、選択した干渉1454組、剛体取り外し全経路を検査した。全組合せの接触検査、振動・衝撃強度や実物の合格を意味しない。

## 組立出力とリポジトリ検査

閉状態137部品、整備姿勢129部品のSTEP再読込・配置検査は不一致0。組立表示は [閉状態](closed.step) と [整備姿勢](service.step)。[閉状態画像](_work/images/retrofit_closed.png) と [取り外し画像](_work/images/retrofit_service.png) を確認済み。

親機改良の印刷一式と作業ファイル配置の検査は合格。全構成の検査には既存の別構成6件の更新不整合が残る（parent_integrated、parent_interior_p1/p2、parent_rope_float、parent_service_review、parent_spar_bolted）。対象は既存 parent_interior_layout.py や旧リポ固定具・説明の不一致で、今回の改良形状を反映する目的では変更していない。ツールテスト42件中41件合格、子機クランプの既存材料カード不足による1件のエラーは未解消。

改良前配置から検査を再実行するときは placement_before_retrofit.json を入力依存ファイルに含める。検証の元入力と生成元のハッシュは各release runのjob.jsonに保存されている。現行配置へ同じ移動量を二重に適用しない。

## 電源基板の元の向きとPico高さの追補

ユーザー指定により電源基板の追加180°回転を取り消した。旧位置から南11 mm・上5.5 mmに置き、XTの前方20 mm（断面はコネクタ外形に各側2 mm追加）を空ける。MAIN枠は後端中央だけに逃げを設け、四隅のボスと左右の支持経路を残した。床板・LiPo固定具は変更しない。直前版から設計形状を変更した印刷部品は main_service_frame と power_adapter。再生成時の面分割で他STLのハッシュが変わる場合がある。

Pico 2 WはMAIN基板上面Z46.6から17 mm、上端Z63.6の包絡で確認した。XYは22×54.6 mm（モデル外形へ片側0.5 mm追加）。アンテナ棚まで3.8 mm、鋼板まで8.8 mm。高さ18 mmの確認用包絡でも棚まで2.8 mm残る。Pico包絡を含む上方120 mmの整備動作も検査した。表示用MAIN基板の既存STEPには低いPico参照モデルが含まれるため、高さ判定は表示の見た目ではなくこの実測条件の包絡による。

今回の検査入力・出力は `_work/analysis/retrofit_20261024/orientation_review`、採用した各CAD runは更新済みrelease_record.json。14 mm以上の前方移動案には干渉があり採用していない。固定ねじの頭を1 mm沈めた4箇所は、下向き0.1 mmの反力面検査で頭と座面、アダプタと床ボスの接触を確認した。樹脂ねじ部の実物保持力、プラグ実物、手作業の取り回しは未試験。

## 基板の樹脂直接固定への変更

MAIN4か所・電源基板4か所のナット穴を廃止し、子機child_vtray_deckの公称Ø2.8 mmを参考に、内接径2.8 mmの補正八角下穴へM3ねじを直接締める。MAINはM3×8、電源基板はM3×6。穴入口は0.15 mm面取り。既存のボス外形・座面高さ・基板配置を維持し、初回は基板を載せる前にねじを垂直に手で馴染ませ、切粉を除く。電動工具で締め込まない。

締結経路はねじ頭→PCB→樹脂座面→下穴に形成されるねじ山。図面上のかかり長さは完全な有効ねじ山長さや強度保証ではない。実物のねじ形状、PETGの成形誤差、締付けトルク、繰返し脱着寿命は未確認。下穴とねじ山包絡の干渉は意図したかみ合いとして、他部品との干渉から区別して検査する。8か所の軸方向12断面、下穴の貫通、先端余裕、PCBを介した両座面の反力を記録する。

この段階では日常整備の4本・床側・棚接合をナット式としていたが、次節の改訂で樹脂直接固定へ変更した。既存のGNSS・Sony・磁気センサ固定具はこの変更の対象外。最下段プレートの再印刷・追加加工は不要。今回再印刷する変更部品はMAIN枠と電源アダプタの2種類。検査記録は `_work/analysis/retrofit_20261024/direct_pcb/`。

変更部品の確認画像：[MAIN枠](_work/images/main_service_frame_direct_pcb.png)、[電源アダプタ](_work/images/power_adapter_direct_pcb.png)。

## スペーサ内部ナット穴の廃止（現行）

造形失敗への対応として、GNSS/Sony支柱7部品、床側受け4部品、MAIN枠の棚接合柱4か所から、計27か所の内部ナット穴を撤去した。縦方向の内接径2.8 mm下穴へM3ねじを直接締める。側入れ穴・閉じた六角空洞・ナット抜け止め溝をなくした。抜け止め4個は構成から除外し、印刷一式は16種類16個となる。

床側受けは下M3×20／上M3×8で先端間隔0.50 mm（公称）。実ねじの長さ・先端を確認し、長いねじに置き換えない。底側の固定は床板とリングを挟み、整備時は上側の4本だけを外す。ナットが落ちる構造はなくなるが、樹脂ねじの摩耗寿命は未確認。最下段プレートとLiPo固定具の再印刷・加工は不要。

直前の基板直接固定版からの変更対象はMAIN枠、床側受け4種、GNSS/Sony支柱7種。アンテナ棚の下面に開いたナット座6個はスペーサ内部の空洞ではなく、印刷時に上へ開くため残す。既存GNSS基板・磁気センサ等の金具は継続。検査記録は `_work/analysis/retrofit_20261024/plain_spacers/`。

並行作業で確定したSony固定板の厚さ3.2 mm・基板高さ+1.6 mmも取り込み、印刷一式へSony固定板を追加する。支持面Z60.5は維持、上側M3×10の頭座はZ63.7。Sony板は旧品再使用ではなく新版を印刷する。基板下面はZ67.2となり、再生成後の周囲との干渉を追加検査する。

[スペーサの外観と縦断面](_work/images/plain_spacers_review.png)：手前は完成形、奥は検査用の半断面。床側受け・GNSS柱・Sony柱とも縦下穴だけで、内部ナット座と横挿入穴はない。断面モデル自体は印刷しない。

## docs/配線・ケーブル計画.md

2026-10-28 親機内装：Sony足とGNSS足を50 mmへ統一。Sony一式は前版から8.3 mm、GNSS・磁気センサは2.8 mm上昇。同軸の参照経路を更新し、実ハーネスの余長・曲げ・抜差しは実物確認。現行手順は assemblies/parent_hand_service/unified_support_report.md。

2026-10-24 親機整備手順更新：MAIN枠の独立スペーサは通し穴・M3×30・床裏ナットへ変更。MAINを外す際は配線とSMAを解放し、床板をケースから取り出して裏ナットを保持する。旧M3×8の4本だけを上から外す手順は使わない。配置とケーブル形状は維持。詳しくは ../assemblies/parent_hand_service/frame_spacer_printability_report.md。

## 2026-10-24 親機内装改良

電源基板は元の向きのまま南へ11 mm、上へ5.5 mm。XT差込口前方20 mmを空ける。MAINは上へ3 mm、GNSS／磁気センサ一式は上へ16 mm、アンテナは南へ12 mm・上へ8.8 mm。現行配置は parent_hand_service/placement.json。

同軸はR20 mmの引出しとアンテナ側約235 mmの自由な整備ループを確保する。新リングの上面開放入口を使い、工具路を塞がない。整備時は電源・MAIN配線・受信機側SMAを外し、ループを解放してMAIN＋アンテナを持ち上げる。ケーブルの実変形と巻き量は未検証。詳細は [改良報告](../assemblies/parent_hand_service/retrofit_report.md)。

# 配線・ケーブル計画 (部品外事項)

## C一体カメラの着脱域（2026-10-21）

親機は既存カメラ位置を維持し、横ロックの+Yへ45 mm抜去、下から見て時計回り60°回転、下へ80 mmの経路を保持。子機は通常の横向きへ右90°修正。左前のC中心(-122,95,130)、ロックボルト+Zへ45 mm、左外側から見て時計回り60°、外側-Xへ80 mm。既存の後端予約空間と中央Y±45の持ち手進入域はCADで避ける。実カメラのケーブル有無・外径・曲げ半径・視野は未確認。カメラと機体の独立落下防止コード、配線と張力逃がしをこの回転・抜去域へ固定横断させない。現行カメラは取付済みで、下のライト単独節の「カメラ予約」は旧記録。

## 横置きフレームの上向きライト（2026-10-12）

[側面twist規格](child_horizontal_twist_interface.md) Rev.4でright_frontへ既存33×81保持形状を一体twistとして配置。一体化したライト軸の参考位置X161/Y80、保持区間Z89.5〜170.5。60°回して固定すると上向き、横のノブは水平+Y。実ライトのケーブル有無・端子・曲げ半径は未確定。配線がある場合は筒の端から出し、機体側に別の張力逃がしと着脱用余長を設ける。+Y方向45 mmの横ボルト抜去、時計回り60°のユニット回転、N方向40 mmの検査済み持上げ経路へ固定配線を渡さない。独立した落下防止コードもこの経路を妨げないよう調整する。側面中央Y±45の手の通路にも固定配線を渡さない。カメラ・TD04Aは取付位置の予約で、機器と実配線は今後設計する。後部の既存φ75×長50 mm予約空間は保持する。

## 親機・箱位置決めフレーム（2026-10-10）

[parent_oneplate](../assemblies/parent_exterior/README.md)は箱を三点支持と左右・端面ストップで位置決めする。既存の南壁ペネトレータ2個と箱内の配線配置は変更しない。TD04A線は支持金具から箱側へ既存引込み経路に沿わせ、フレーム・箱の位置決め面や圧力パッドの下を通さない。カメラストップ周辺にもケーブルを挟まない。今回のCADはケーブル外径、実曲げ半径、コネクタ、余長を確定していないため、実配線を通して接触・張力逃がし・箱の着脱経路を確認する。

## 子機4枚フレームの後端保護（2026-10-08）

[child_horizontal_plate_frame](../assemblies/child_horizontal_plate_frame/README.md)の配線保護長さは、ユーザー指定の**エンドキャップ外面から50 mm**。容器軸はY、キャップ外面Y=−114、配線予約の後端Y=−164、側面の保護延長はY=−176までとして12 mmの余裕を取る。予約空間は軸中心のφ75×50 mm円筒。φ75は仮値で、コネクタ・ケーブル外径・曲げ半径・保持具の実物確認が残る。

5個のM10穴の実CAD軸にφ26×26 mmの仮ペネトレータ包絡、φ30×35 mmの仮工具包絡を置き、延長部と回転止めとの干渉を検査する。蓋のM3ねじ6本にはφ8×35 mmの工具経路を確認する。左右の窪みは蓋外周の突起だけを受け、中央の配線空間を通らない。延長部は前後左右に分割して着脱できる。テザーの張力保持・曲げ半径の承認経路や防水性能の検証は含まない。既存の80 mm保護長の旧ガードへこの50 mm指定を遡って適用しない。

## 親機ケース内GNSS・電源操作・LIS3MDL（2026-10-09・現行内装）

[parent_hand_service](../assemblies/parent_hand_service/README.md)が正本。GNSSとアンテナは箱内。ふたを開け、電源基板のSW_PWR・SW_TX、LiPo、両SDを設置高さのまま操作。各スイッチのØ20指経路とTX実装上端から上20 mmの予約領域へ配線・保持具を通さない。

| 接続 | 現行計画 | 未確定・検証 |
|---|---|---|
| ANN-MB1 → GNSS | 付属約5 mを切らずSMA接続。中心X60/Y60、OD100/ID75/H10、Z22.3–32.3へ余長を収納。アンテナ後方から西側X20付近を経てSMAへ接続 | 同軸外径2.8は仮、実巻き・尾線・根元保持は現物確認。設計R20以上、メーカー許容の認定ではない |
| GNSS → 親機基板 | 60×80基板X75–135/Y139–219/Z56のXHから配線。西辺L字型14.8×24×6.6の仮包絡 | 極数・型番・実装辺・高さ・電気的極割当未定。昇降配線は廃止、上方抜出し前にXH/SMAを外す |
| LIS3MDL磁気センサ | X44–61.78/Y195–220.4/下面Z76、GNSS台北西後端の一体棚。南向きQT端に幅6×奥行15×高さ5 mmを確保。北端QTは箱内で使用しない | ケーブル・接続先・実プラグ未定。近傍に鋼製締結具を使わず、電源・大電流配線を束ねない。ANN-MB1の内蔵磁石を含め、完成・通電・送信状態で測定範囲・飽和の有無を確認し磁気測定・校正。操作経路とGNSS抜出し領域を横断しない |
| 親機LiPo | 電池X153–187/Y22.6–124.6/Z23–46。リードを外し、蓋4ねじを外して上へ抜く | 実プラグ・リード長・結束位置は未定。電池と蓋の上方経路を横断しない |
| MAIN / SPRESENSE | 両SDは南向き、箱内でカードを抜き上げる。MAIN USBは箱外で南側から接続 | ケース側ハーネスとケース固定部を解放して取り出す。ケース固定方法と無分解取り出し手順は未認定 |
| 外部引込み | 南壁テザーX28 / TD04A X120、Z65の加工計画 | テザー位置はMAIN SDの手前経路を避け変更。ケース原本未加工、既加工ケースとの実位置照合が必要 |

2026-10-11容器訂正：LiPoを北3.6 mm、TXを南4 mm、GNSS後左脚を東2.6 mm移動した。TX予約空間X148–198/Y136.5–211.926/Z40.195–60.195を配線禁止とする。ケースは本体とふたを分けた未加工の図面由来モデルで、南壁の実肉厚・成形勾配・ペネトレータの座面を実物で照合する。旧穴位置や仮壁厚を現行加工寸法に転用しない。

SPRESENSE専用追加バッテリーは省略し、親機LiPoは残す。閉蓋GNSS受信、放熱、実スイッチ把持、反復接続、配線保持は実機確認。旧61 mm昇降・GNSS東方向抜出し・旧グランド／ブリッジトレイ計画を現行構成へ適用しない。

## 子機外装Blenderイメージ（2026-10-07・横置き案）

[クランプ穴固定の外装試作](../assemblies/child_exterior_horizontal/README.md)は、下記の仮配線をplacement.jsonへ引き継ぎます。クランプ24軸には接続部・側板・中央接合板を通るØ10.5工具通路を用意し、配線をこの通路へ結束しません。振動子の支柱を右後方Y=−110へ離し、上の交換橋板で機器位置へ渡してクランプ・工具経路を避けます。後部バンパーは固定ねじで着脱。端末の抜差し、実ケーブル曲げ半径と保持具は未確定で、完成機のケーブル干渉確認は未完了です。ライトの配線は実電源方式の決定後に追加し、カメラ保持ストラップの位置はレンズ・ラッチ・ケース開閉を遮らない実物取合いで決めます。

[child_exterior_concept](../assemblies/child_exterior_concept/README.md)は探索構成。容器軸は+Y、後部5穴キャップは−Y。上向きTD04Aから桃色経路を右後側へ降ろし、後部キャップへ渡します。黄緑テザーは後部キャップから左後側、フレーム後方上部へ抜きます。仮経路の正本はplacement.json。ライトは上向きですが型番・電源方式が未選定で、今回はライト線を表示していません。カメラは前方の独立防水ケースです。

旧可動ガード・A/Cへの結束経路は履歴へ保存。横置き案の後部バンパーは固定・着脱想定で、旧86姿勢の検査結果は適用しません。具体的な貫通穴、コネクタ、テザーの張力保持、ケーブル外径・曲げ半径・余長、バンパーの工具アクセスは製作前に確認。内装と内部ハーネスは今回変更しておらず、横置き時の固定と接続方向の検証が別途必要です。以下の従来構成の配線表は履歴・共通情報として保持します。

## テザーの保管・輸送治具（2026-09-26）

[両側開口リール](../parts/common/jigs/tether_open_reel/tether_open_reel.md)は標準Fathom 30 m用の独立した保管治具。一つの巻き収納部、中央開口と横入れ溝を両側に設け、側板は爪2個、外周カバーは印刷クリップ4個で着脱する。巻き始めの端は中央側、巻き終わりは外側に残す。両端接続時は必要な長さを手でほどき、機器を回してねじれを逃がさない。溝縁へ折り返さず端末の余長と曲げ半径75 mm以上を確保する。実巻き・コネクタの収まり・繰返し嵌合は未確認。

## 子機シンプル筐体案（2026-09-16）

[新しい3部品外装r2](../assemblies/child_simple_assembly/README.md)では、下キャップ下面から接地面まで71.2 mm、中央開口180×128 mmを確保した。ガード支柱4本に結束用スロット各2個。配線を支柱へ沿わせ、容器取り出し時の余長を残す。前枠の取り外しには前側ガードボルト4本と前後締結4本を外す。ガードは段差で支え、外付けM3ナットで固定するため先入れは不要。テザー主張力用の固定、ケーブル外径と曲げ半径、コネクタ、ライト・TD04Aの実配線は未検証。ガードがあっても中央開口からケーブルが床に垂れないよう現物で確認する。

親機の現行外装は[最下部の下向きカメラ・TD04A版](../assemblies/parent_bottom_sensors/README.md)。TD04Aケーブルは下部支持板の背面から支柱に沿わせ、既存デッキの南縁へ上げる。下部支持板に直径8の結索穴を4個設けた。ケーブルはクランプ上端から出し、センサー交換用の余長と着脱時の引張り逃がしを残す。外径・曲げ半径・コネクタ処理は実測未確定。カメラに外部ケーブルを付ける場合も支持板背面へ回すが、既存防水ケースの端子使用可否は未確認。

機体設計で見落としやすい「部品ではないが場所を取るもの」をまとめる。
**部品を配置したら、必ずこの表を更新してから次のアセンブリに進むこと。**

> 2026-08-02: 縦置き内装は下リブ40×22、左右デッキスリット16×30、
> フランジ固定アンカー、LCD裏のサービス空間まで実装済み。

## 1. ケーブル一覧

| # | ケーブル | 区間 | 外径 | 曲げ半径 | 状態 | 詳細 |
|---|---|---|---|---|---|---|
| C1 | テザー (電源 + RS485) | 子機 ↔ 親機 | 未定 | 未定 | **未選定** | `parts/common/cabling/tether_cable/` |
| C2 | TD04A 振動子 (子機) | ソケット → 後方キャップ → RX 基板 | 未実測 | 未実測 | 現物 3m / 3P プラグ | `parts/common/exterior/cots/td04a_transducer/` |
| C3 | TD04A 振動子 (親機) | 最下部クランプ → 支持板背面 → 支柱沿い → デッキ南縁 → 南壁ペネトレータ（2026-09-10。経路長・余長は実機調整） | 同上 | 同上 | 同上 | 同上 |
| C4 | 水中ライト | 前縁 → 後方キャップ → 容器内 | 未定 | 未定 | **未選定** | `parts/child/exterior/cots/dive_light/` |
| C5 | ~~カメラポッド電源 (2 線)~~ | — | — | — | **不要 (2026-09-04)**: 親機カメラは Osmo Action 6 (独立電源・ケーブル無し) | — |
| C6 | 子機 内部ハーネス | 基板 ↔ LiPo ↔ 各所 | — | — | ✅ **設計完了** (2026-09-03) | `parts/common/cabling/child_harness/` (9 本、世界座標 keep-out モデル、推奨カット長あり) |
| C7 | 親機 内部ハーネス | プレート上 7 モジュール間 | — | — | **未設計** | 同上 |
| C8 | LCD XH7ハーネス | C-MAIN J_LCD1 → LCD I2Cキャリア | 束径目標≤5 | ≥20 | ✅ 経路確保 | LCD裏で折返し、電源線と分離 |

**C1・C4・C5 の外径が決まらないとペネトレータの型番が決まらない**
(WetLink は 4.5 / 5.5 / 6.5 / 7.5 / 8.5 mm のいずれか)。ここが設計上の律速。

**C2 / C3 (TD04A) は 3P プラグ付きの完成品ケーブル。プラグはペネトレータを通らない。**
ペネトレータで通すなら**ケーブルを切って容器内で端子台に落とす**しかない
(3m は延長できないので、切る位置 = 実機での据付長を先に決めること)。

## 2. 貫通部 (ペネトレータ / グランド)

### 子機 — 後方エンドキャップ (M10 × 5、BCD 56、72° 間隔、1 個が真下)

| 穴 | 用途 | ケーブル |
|---|---|---|
| 1 | テザー | C1 |
| 2 | 振動子 | C2 |
| 3 | ライト | C4 |
| 4 | 予備 / 将来センサ | — |
| 5 | 予備 | ブランクプラグ |

- 未使用穴には**必ずブランクプラグ**。
- 締付トルク: バルクヘッド 3.5 N·m / プラグ 約 14 N·m。
  **トルクレンチが入る周囲クリアランス**をアセンブリで確認すること。
- 前方キャップは**貫通なし** (前端はケーブル余裕ゾーン 30mm のみ)。

### 親機

| 場所 | 用途 | 備考 |
|---|---|---|
| ~~カメラポッド後面 M10 ×1~~ | ~~C5~~ | **不要 (2026-09-04、ポッド保留)** |
| ~~ボックス底 マストクランプ M5×4 + パイプ穴~~ | — | **不要 (2026-09-04 支柱無し)**。箱底の貫通は無し。箱固定は箱底コーナー外部取付穴 Ø4.2 ×4 (ガスケット外) → `parent_deck` |
| ボックス **南壁 (Y=0) z=65** WetLink M10 ペネトレータ ×2 ✅ **モデル化済 2026-08-29** | x=120 → C1 (テザー) / x=85 → C3 (TD04A) | 壁厚 3.1mm、バカ穴 Ø10.2 (`bcas212310g.scad` の `pen_x` / `pen_z`)。落とし先: C1→P-MAIN `J_TETH1` (箱 x≈123)、C3→TX (右列)。**箱内に出るのは素の導体** (外被は濡れ側のプラグで終端) → 容器内に端子台が要る |
| ボックス 南壁 予備 | (C5 は不要になった) | **未配置**。3 本目を足すときは `pen_x` に追加して assert を通し、`parent_deck` の南縁切欠き (X −30..25) の範囲も広げること |
| ボックス **北壁 上部** グランド ×1 | GPS ANN-MB1-00 アンテナ線 | 落とし先: P-MAIN `J_GNSS1` |
| ボックス底 ビューポート Ø30 (+X53) | 光学窓 (**パターン2のみ**) | `parent_cam_port` 未設計。ケーブルは通さない |

(旧 `parent_plate` 175×180 の引込みゾーン表は 2026-08-28 の改版で廃止。
現行配置は [親機内装_収まり検討.md](親機内装_収まり検討.md) §7 と
`spec/parent_layout_p{1,2}.png` を正とする)

## 3. 配線路

### 子機 — 構成 A (横置き / `child_assembly`)

| 区間 | 通り道 | 現状 |
|---|---|---|
| フレームプレート上 (ライト・振動子) | 40mm グリッド穴に結束バンドで固定 | 結束点は穴のみ。金具なし |
| 後方キャップ → トレイ | チューブ内、`child_tray_rib` の**中央切欠き (40 × 14)** ×3 | リブ 3 枚とも同位置なので直線に通せる |
| デッキ前端 → 外 | デッキ前端の **Ø9 通し穴 ×2** | ケーブル余裕ゾーン 30mm |
| RX 基板 ↔ LiPo | デッキ上 | **明示的な配線路なし → 要検討** |
| 振動子ソケット底 | **Ø9 (ケーブル出し + 水抜き兼用)** | 塞がないこと |

### 子機 — 構成 B (縦置き吊り下げ / `child_vertical_assembly`)

**容器は縦置き。ペネトレータは全部「下」を向く。テザーは下から出て機体の外を
回って上へ戻り、吊りロープに沿って親機へ行く。**

| 区間 | 通り道 | 現状 |
|---|---|---|
| 下キャップ → 機体の外 | `child_guard_ring` の中央 (r<55) と**後方セクタ 230..310** を `child_cable_cover` が覆い、出口は側面 Ø14 ×3 (z −40)。中央素通しは維持 | ✅ 構造物なし。assert で検査。**トルクレンチアクセスはカバーを外した状態で確保** (カバー付けたままでは工具アクセス不可) |
| テザー ストレインリリーフ | `child_cable_cover` のクランプ座 (EVA t2、M5×2、ピッチ 18) が主。`child_guard_ring` 結束スロット補助 | ✅ **張力はクランプ座で受け、ペネトレータに掛けない** (2026-09-04) |
| テザー → 上 (親機へ) | 機体外周 → `child_core_frame` **背面ケーブル溝 ×2** (x ±18、幅10×深8、y −101..−93、z −17..182) → **z=90 スロットでパイロン空洞へ入り手穴 (z115..145) を裏から迂回** → **z=155 スロットで溝へ戻す** → **ペデスタル縦穴 Ø12 (±18,−92) で座面 z218.5 へ抜ける** | ✅ **v4 実装済**。結束スロット 5.5×3 @ z 0/30/60/90/155 (手穴とは 8mm 以上)。**溝 x13..23 は手穴 x±26 と重なるので、手穴帯だけ空洞を通す**。旧 `child_shell_aft` の側壁スロットは廃止 |
| 縦向きライト | `child_core_frame` **HP2/HP3 の中央 Ø14** (x ±44, y −75, z 100) → パイロン内空洞 → 背面溝の結束スロット → 下へ | ✅ **v4 実装済** (改善要件 §3.1 / C4)。ケーブルは HP2/3 座内で止まる穴から外周を回して背面溝へ |
| TD04A → ソケット | 後方セクタ → **パイロン内部の空洞 (導管、y −87..−64 に縮小)** → **HP1 ペデスタルの中央 Ø14 (0,−85) → 座面 z218.5** → ソケット底の Ø9 | ✅ v4 で HP1 を z190 の屋根直付けから z218.5 のペデスタルへ移設 (旧位置はソケット台座が容器に 3〜4mm 貫通していた) |
| 前向きライト | ゲート HP-L (0,15) のユーザ設計クランプ。Ø14 穴は座内で止まる (深さ 12)。旧 `child_light_clamp` / `child_shell_fwd` 行は廃止 | ✅ HP-L に置き換え (2026-09-04)。クランプ設計・ケーブル経路は外部設計 |
| 下キャップ → 内装 | 下リブ40×22開口 → デッキ左右スリット (z 96、窓経由) → −X レール −Z 端から溝内 (z 20 まで) へ、+X も同様にレール −Z 端へ | ✅ 下リブで引張止め。結束点 z 30/55/82/112/125 (≤30mm間隔)。窓により貫通 0 |
| LiPo 電源リード → CHILD_PWR `J_BAT` | 電池リード (+X 切欠きから) → −Z 端からトラフへ → XT30 ペア (z 25..55) → ピグテール (トラフ上へ) → +X スリット (z 96、窓経由) → XT30 パッド直付け | ✅ XT30 嵌合不可 (壁 14mm): 基板側はパッド (5mm ピッチ THT) へ直付け (ユーザー確認済み 2026-09-03) |
| LiPo 充電リード | −X 切欠きから下リブ結束スロット (−26, −19) 付近へ XH4 プラグ結束、外部へ | ✅ 29mm に短縮。充電は内装をチューブから抜いた状態で行う |
| 内装へのアクセス | **上フランジを抜いて内装を真上に引き出す** | ✅ ドームの M3 を外し、上フランジを抜く。デッキ幅 93 > 貫通口 Ø88.5 のため必須 |

**曲げ半径の制約 (構成 B 固有)**: キャップ下面 (z=-13.8) からスキッド底面
(z=-37) まで 23mm しかない。ここでケーブルを真下から水平へ曲げると
**曲げ半径 40mm 程度が上限**になる。→ **テザーは最小曲げ半径 40mm 以下の
細径ケーブルを選ぶこと。** 太いケーブルを使う場合は、後方セクタへ
斜めに逃がして半径を稼ぐ (セクタは ±40° 開けてある)。

> **2026-09-04 評価**: 23mm ではペネトレータ突出 20 を引くと 3mm しか残らず、
> ケーブルは曲げ半径ぶん**スキッドより下に垂れる** (立て置きで踏む)。全高上限が 400 に緩和されたので
> `child_guard_ring` の `ring_z0` を **−60** に下げ (キャップ下 46mm。ペネトレータ突出 20 の下に 26mm 残るので、ケーブルは半分曲がった状態でカバーの側面穴 (z −40) から出て、曲げをカバーの外で完了する)、
> 後方セクタにケーブルカバー + クランプ座 (テザー張力をここで受ける)、パイロン背面に
> ケーブル溝 ×2 を設ける。詳細は [子機外装_改善要件.md](子機外装_改善要件.md) §3.3〜3.4。

**ドームには貫通部を作らない。** 吊り荷重とシールを分離するため。
内部アクセスはドームを開けて上から。このときシェルもガードも外さない。

### 親機

| 区間 | 通り道 | 現状 |
|---|---|---|
| ~~マストヘッド → ボックス~~ → **デッキ下 (TD04A) → ボックス** (2026-09-04) | 南座ソケット底穴 Ø9 / HP40 中央 Ø14 → キール壁間の通路 → キール南端壁のフェアリード Ø8 (張力止め) → デッキ南縁切欠き (X −30..25、深さ 8) → 箱の南壁外を上る (落差 65) → WetLink | ✅ 経路あり (`parent_deck`)。テザー (C1) も同じフェアリードで張力止めしてキール真下から水中へ |
| ボックス内 モジュール間 | プレート上。中央通路 (x≈115) と東縁 (x≈176) の**結束バンドスロット 3×10 ×5** (`parent_plate` 2026-08-28 改版で追加) | ✅ 結束点あり。グランド (壁上部) からはサービスループで降ろす |
| LiPo (ブリッジトレイ z≈54, MAIN 上) → P-PWR `J_BAT` | リードはトレイ西端壁の切欠き → プレート西縁沿いに北へ降りる → `J_BAT` (プレート (8.8,157.1)、開口 -X 向き、z≈25) | ⚠ 落差 30 + 北へ 120 → **実長 ≥150 mm が要る**。足りなければ LiPo を東向きにして東縁経由 |
| Pi Zero → GS カメラ (パターン2) | CSI 200mm 標準ケーブル、経路 ≈60mm | ✅ 余裕 |

### 試験治具 (E1。機体ではないが C2/C3 の実長を食う)

| 区間 | 通り道 | 現状 |
|---|---|---|
| ポール治具 | クレードル下の結束スロット ×2 → ポールに沿って水面上へ | `xdcr_pole_jig` |
| プールサイド治具 | `xdcr_clamp` 端壁スロット → foot 立ち下がり (結束 ×2) → 継手 → hook 支柱 (結束 ×3) → デッキ板の縁 | `xdcr_poolside_jig` |

**TD04A のケーブルは 3m 固定で延長も交換もできない。** プールサイド治具の場合、
水中側の経路が約 0.4m なので**縁から機器置き場まで 2.5m を超えると届かない**。
どちらの治具でも**ストレインリリーフを結束バンドで取り、3P プラグは水に浸けない**。

## 4. 必ず守るルール

1. **ストレインリリーフ**: 張力はケーブルではなく機体側で受ける。
   ペネトレータのシール部に引張をかけない。→ 子機は `child_cable_cover` のクランプで設計済み (2026-09-04)、親機は `parent_deck` キール南端のフェアリード Ø8 ×2 (結束バンド / 結び目で止める)。
2. **サービスループ**: トレイ / プレートを引き出せる余長を必ず取る。
   余長がないと保守のたびにコネクタを抜くことになり断線する。
3. **最小曲げ半径**を守る。特に同軸 (C2/C3) とシールド線。
   容器内で半径が取れるかを `assemblies/` のモデルで確認する。
4. **カメラ視野に配線を入れない**。ケーブルはプレート下面か縁に沿わせる。
   子機の Osmo Action 6 は **FOV 155°** と非常に広い。`child_osmo_holder` は
   「防水ケース前面より前に出る構造を作らない」方針で画角を確保している
   (前リップだけが前に出て、余裕 5.8°)。**同じ考え方をケーブルにも適用し、
   ケース前面より前 (+Y 側) にケーブルを通さないこと。**
   子機 Osmo 自体は独立電源・独立記録なので**カメラ側のケーブルは無い**。
   有線化する場合はアーム上の配線路と結束点が新規に必要 (**未設計**)。
5. **電源とデータを離す**。RS485 はツイストペア + シールド。
6. **振動する場所 (マスト) では必ず固定**する。
7. **コネクタは引き出し方向に対して抜ける向きに付けない**。
8. **未使用の貫通穴はブランクプラグ**で塞ぐ。

## 5. その他の部品外事項

| 項目 | 状態 |
|---|---|
| 工具アクセス (ペネトレータのトルクレンチ、ボルトのドライバ) | アセンブリで都度確認 |
| バラスト / おもり (子機: プレート下スロット、親機: マスト下端 0.4kg) | 実機で調整 |
| O リング・面ファスナー・結束バンド (消耗品) | BOM に交換分を入れること |
| 異種金属接触腐食 (アルミ ↔ ステンレスボルト) | 海水運用時に防食対策を検討 |
| 乾燥剤 (カメラポッドの曇り対策) | **未検討** |
| 陸上での置き方 | ✅ **ガードリング −60 でケーブルを踏まない。輸送はヒンジ側 (−X) を下にした横倒し + `child_dome_cap_transport`** |

## 更新履歴

- 親機の現行版は `parent_rope_float`。左右の浮きは中心穴に紐を通し、デッキ前後の紐穴へ結ぶ。紐とケーブルを束ねて可動浮きの動きを止めない。浮きへの剛体固定は行わない。

- 2026-09-10：親機縦長ねじ固定版は `assemblies/parent_spar_bolted/`。既存南壁ペネトレータを維持し、カメラは北側・箱のすぐ下、GPS台は右舷後方。GPS引込みとTD04A・テザーの張力止めは未設計。浮体段を分解するときにケーブルを金属ねじ棒やパッキン面へ挟まない。余長はフィンまで垂らさず、箱側に保持する。

- ケーブル / 貫通部 / 配線路を変更したら、対応する部品の `.md` と
  `assemblies/*/placement.json` も合わせて更新すること。

## 親機統合で見つかった取合い（2026-09-10）

最新の検討先は [parent_integrated](../assemblies/parent_integrated/README.md)。
テザーのペネトレータと電池トレイ南東レールに干渉を検出した。
内側突出は旧資料14.5 mmと保存STL20 mmで不一致。実厚・突出・ナットと工具の
必要空間を実測してから、トレイの逃げまたは貫通位置を確定する。
既存資料のプラグ切断指示は確定仕様として扱わず、プラグ形状と通線方法を確認する。
GPS引込・箱内端子台・ストレインリリーフ・配線・LCD支持は統合モデルにも未反映。
PWRは3.5 mm上がるので、給電線の余長とスイッチ操作空間を再確認する。

## TD04Aケーブル外径確定（2026-09-10）

2026-10-21：[TD04A治具Rev.5](../assemblies/td04a_fixture/README.md)。親機は下向きの承認形状を保持。子機は右後側の側板M3/20 mmへ固定して上向きにする取付例。側板Y=-60 / Z120,140付近で、M3の外側ドライバーと内側ナット挿入経路を空ける。TD04Aは側板の外へ張り出す。全体の実配置とケーブル経路は未変更。外径5 mm・仮の曲げR30を継承し、根元の実寸と曲げ・配線余長は現物確認する。

ユーザー指定は外径5 mm。外部経路・曲げ空間を
[parent_td04a_cable](../parts/common/cabling/parent_td04a_cable/parent_td04a_cable.md)に記録。
TD→支持板既存Ø8穴→円盤外側→箱TD引込口。経路長739.5 mm＋別途内装長・余長。
曲げR30は仮。固定具・コネクタ通過・シール型番・箱内導体の配線は未確定。

## 子機・一体式エンドキャップガード（2026-09-27）

方向合わせ帯をキャップ面より下側に設け、上側のねじ頭逃げと分離した。中央Ø75×H80と仮ねじ頭Ø7×H4の予約空間は、修正後の開閉角でも確認する。変更のたびに開閉GIFを提示する。

[child_endcap_guard](../assemblies/child_endcap_guard/README.md)は受けと側面ケージが一体の可動部品。受けごと蓋のように開閉する。キャップ外面から80 mm、中央Ø75 mmを全高さで空け、側面窓と先端は開放。固定側蝶番は仮配置で、クランプ取付と閉止ラッチは今後の設計。ペネトレーター・センサの型番・実配線経路は今回未提示。予約空間の開閉検査を行うが、実ケーブルの曲げ、引掛かりと張力止めは実装時に確認する。ガードをストレインリリーフに使わない。旧 `child_cable_cover` のM5クランプ座をこの構成へ流用したものではない。

## 子機シンプル筐体のライトマウント（2026-09-17）

[専用マウント](../parts/child/exterior/printed/child_simple_light_mount/child_simple_light_mount.md)を背面中央へ追加。
参考ホルダーの内径33×保持長81に基づく。ライト実体・ケーブルの有無と外径は未確定。
配線がある場合は筒の端から引き出し、曲げ半径・余長を実物で決め、筐体へ別固定する。
上のTD04A座面と保持部の間は19.5 mmだが、ライト頭部を含む干渉は未確認。
独立した落下防止コードをライト自身から機体へ掛ける。

同ガードの印刷性修正では窓上端を45°の尖りアーチにした。側面開口と先端開放を維持するが、丸桟案より壁面が増えるため、水流とセンサ応答は新形状で実機確認する。

ガード根元のR2化に伴い、面上Z=4.4〜7.6 mmで内半径58→56.5 mmの傾斜棚を追加。中央Ø75 mmを空け、6本のねじ頭高さ4 mmと仮ペネトレーター・開閉軌跡との干渉を再確認する。

## 子機・新外装フレームAの下部アクセス（2026-10-01）

[フレームA](../assemblies/child_exterior_structure/README.md)は下部開口294×112 mm、
中央270×100 mmを板厚全体で空ける。ガードを開け、ケーブルのサービスループを
通路から退避して機体下部へ手を入れる。分割接合板はA外側に置く。
今回はAのみを設計し、配線経路やクランプ・ガードの配置を変更していない。
C・ガード・実ケーブルを追加した完成機で、開口を塞がないこと、曲げ半径と
開閉時の引掛かり・張力止めを確認する。

## 2026-10-04 子機内装・連結クランプ

RX・LED・電池線は下側RXクランプの外側Y−25.5付近を経由。左右X36の通路を用い、連結梁X39.2..42.2（左は鏡像）を避ける。温度線は世界Z90..104の通路を通す（2026-10-07：レール撤去済み）。電源XH9コネクタにはフランジブレース側の逃げを追加。詳しくは[設計記録](../spec/child_interior_reinforcement/PRINT_STRENGTH_REVISION.md)。実ケーブルの曲げ半径と固定点は仮組みで確認する。

## 子機内装：2026-10-07更新

2026-10-07：未使用ケーブルレール2本と固定ねじ8本を撤去。デッキの既存穴は残置（使用不要）。バッテリーの普通M3ナット5個は横差しポケットに収まり、樹脂との重なり・横挿入・床板着脱の122検査で干渉なし。ナットの熱圧入や造形途中の埋込みは不要。 配線モデルの経路は維持。旧レールの結束点・窓の記述は旧構成の記録であり、現行の固定点ではない。実配線の保持位置と引張止めは仮組みで確認する。

### 親機の波揺れ対策（2026-10-09）

親機現行parent_hand_serviceの同軸巻き束はラック外壁4窓へ柔らかい編糸を通して保持する。結び目込みでOD100/ID75/H10へ収め、中央Ø75は全高で空ける。糸を締めて同軸を潰さず、収納高さと全5 mの容量を実物で確認する。GNSS前梁X65/70の2留め穴でXH配線を保持し、SMA・XH・南側QTへ張力を掛けない。余長は電池・両SD・スイッチの操作／抜出し経路へ垂らさず、基板抜出し時は留めを解除する。実ケーブル／コネクタ型番・配線径は未確定。

2026-10-09上締め改訂：MAINの段階的スライド組立を先に行い、その後GNSS・アンテナの同軸と電源ハーネスを取り付ける。床をケースから外す際はコネクタを外してモジュールを逆順で撤去する。電池／両SDの通常サービス経路は維持。

## 親機印刷削減改訂（2026-10-09）

同軸リングとアンテナ台を分割し既存4本の長ねじで共締め。OD100/ID75/H10、尾線の曲げ半径R20、4留め窓、操作経路は維持。Sonyの東西／前壁の窓は幅24 mm・最大高さ13 mmの尖った屋根に変更。GNSS支柱は分割し上台のキー穴へ合わせて既存ねじで共締め。前梁の配線留め穴・XH仮包絡・抜差し余長は維持。床の肉抜き穴を使う場合もケースねじと操作経路を塞がず、実ハーネスを確認する。印刷入口は親機assemblyのparts/PRINT.md。

## 親機の上段支持改訂（2026-10-10）

Sony上台の囲い壁を撤去し、4本の印刷スペーサで支える。TX四周は開放し、TX実装上端から上20 mmの予約を維持する。配線を長ねじ・キー・SD・スイッチの経路に固定しない。電池・同軸リング・XH候補の位置と箱外MAIN USBの接続方針は継続。スペーサのランナーは印刷後に取り除き、ケースに入れない。

2026-10-11親機支持簡略化：MAIN/Sony支持板を撤去し、ねじ穴付近だけの座と支持腕へ変更。基板・SD・スイッチ・USB・同軸・XHの座標は維持。MAIN腕下面Z33.1、Sony腕下面Z60.5。空いた基板裏へ配線を寄せる場合も、ねじ座・TX予約・同軸収納・電池/SD経路を塞がない。実ハーネスと曲げは現物確認。

2026-10-11親機の両固定板：MAIN板Z33.1..35.5、Sony板Z60.5..62.1、ねじ座だけを基板まで上げる。大きな矩形肉抜きから配線を通せる。基板・SD・スイッチ・USB・同軸・XHの座標は維持。Sony柱は41.7 mmへ延長し、固定M3×50/頭座62.1。工具・カード・電池・TX予約を塞がない。実ハーネスは現物確認。

2026-10-11 親機LiPo：コードは端面の左右から出る（ユーザー確認）。ボックス局所−X面を床上から蓋下面まで内幅40 mmで全面開放し、この面の端フォーム2枚を省く。線を中央へ無理に寄せず、蓋を外して左右の線と電池を一緒に上へ出す。ほかの配線・部品配置は変更しない。線径、端子、外部曲げ半径は未実測。

2026-10-11センサ治具改訂：GNSSユニバーサル基板はX69–129/Y139–219、下面Z56。GNSS受信基板・ヘッダー・SMA・XH仮包絡も西6 mm、同軸の受信側直線区間のみ6 mm短縮し曲げR20を維持。磁気センサ下面をZ76からZ56へ変更。南QTのコネクタ自体は干渉しないが、指の把持包絡は接続済みSMAと重なる。センサ着脱はSMAを外し同軸をアンテナ後方へ退避、QTを抜き、ナイロンM2×8とナット各4を外して上へ抜く。配線先とQTケーブル型番は引き続き未選定。位置変更後の通電・送信時磁気測定と校正、実コネクタ把持と余長を確認する。

## 親機の容器固定ねじアクセス（2026-10-12）

2026-10-12：容器固定ねじは南西・南東・北西のM4×12を各1本、計3本。最下段floor_plateはSCAD/STEP/STLすべて変更前と同一。再印刷はmain_mount_plate、battery_base、ann_mb1_coax_ring各1個だけ。長軸2.5 mmボールポイント六角レンチを使い、南西は南西方向へ10°、北西は西方向へ10°傾ける。南東は電池蓋とねじ4本、LiPo、上面フォームを外して電池台のØ4.2穴から操作する。北東ねじは使用しない。工具穴へコードを通さず、同軸束は新しい囲いの外へ収める。リング下面の局所支持を除去し工具穴を確認。実工具の嵌合、5 m巻き容量・R20曲げと3点固定の強度は未認定。 同軸の内孔Ø75と最大外径Ø100・高さ10は維持し、南西のØ11.4囲いの外側に0.2 mmの余裕を設けて巻く。5 mを切らずに収まる容量と設計R20以上の曲げは現物確認し、細い囲いにコードを巻き付けない。固定ねじの工具経路とアンテナの長ねじへ配線を結束しない。

## 親機電池蓋のスライド嵌合（2026-10-12）

2026-10-12 電池蓋1本ねじ改訂：battery_baseとparent_lipo_retainer_lid_slide各1個だけ再印刷。蓋は上面をベッドへ向けるX180°で、同梱STLは変換済み。電池台は従来姿勢。M3×12ねじとM3ナットを各1個だけ使用し、ほか3個の蓋ねじ・ナットは使わない。配線側から蓋を載せ北へ4 mm滑らせ、3爪を掛けてねじ1本で抜け止め。開くときは電源リードを外し、ねじ1本を外して蓋を南へ4 mm戻し、上へ持ち上げる。最下段floor_plate・MAIN固定板・ケース工具穴は変更なし。試作で嵌合、フォーム、リードと反復操作を確認。 南4 mmの解除経路へ電池リードを固定しない。蓋と一緒に動く上面フォームがリードを巻き込まないよう、線を全面開放した配線端の下方へ逃がす。実端子と余長は未実測。

## 親機蓋・子機の端フック方式（2026-10-12）

2026-10-12 子機参照改訂：現行child_vtray_batt_floorの2本の端フック（厚1.3・高さ3・差込2・根元4 mm）と片側0.3 mmのすきまを親機へ反映。3爪方式を置き換える。蓋を南2 mmの位置から下ろし、北へ2 mm差し込んでM3×12ねじ1本を締める。外すときはねじを外し南2 mm戻して上へ抜く。電池台と蓋だけ再印刷。床板・MAIN固定板・子機部品は変更なし。 配線端の40×26 mm開口と容器固定ねじ工具穴は維持。後端の2フックは公称電池・最大剛体包絡とフォームの外側へ置く。従来の南4 mm移動記述は旧方式、現在は南2 mm。

2026-10-13 親機電池台：工具穴8 mm、蓋は2 mmスライド＋ねじ1本。ナット座の斜め天井と支持材禁止パーツを使用。設定済み3MFはassemblies/parent_hand_service/print_jobs/battery_tool_nut_access_20261013/battery_base.3mf。印刷入口は同assemblyのparts/PRINT.md。配線端開口、電池位置、最下段と同軸巻き部は変更なし。

2026-10-13 全長側溝版：親機の電池蓋は両側の溝へ端から全長分を差し込み、ねじ1本で固定。開く際は台固定ねじ4本を外して閉じたボックスを上へ約90 mm持ち上げ、蓋を108 mm引き抜く。電源リードを先に外し、ボックスの持上げ経路へ配線を結束しない。現行印刷はassemblies/parent_hand_service/parts/PRINT.md、詳細はbattery_side_grooves_report.md。

## 親機外装Rev.2・カメラQR（2026-10-19）

parent_exteriorのカメラマウントを共通C式で着脱する。カメラ位置は旧配置から36.5 mm下がる。横ロックボルトは機体+Yへ45 mm抜き、カメラ全体を下から見て時計回り60°回して下へ抜く。設計の機器参照形状ではこの動作を検査するが、実ケーブルの曲げ半径とコネクタ寸法は未確定。配線が回転・下降を拘束しない余長を設け、必要なケーブルは先に外す。ケーブルを持って本体を吊らない。独立落下防止コードを設ける。地上自立時はカメラユニットとTD04Aを外し、残る配線・コネクタを接地面Z=-72より上へ保持する。箱の貫通口は従来位置を維持。

2026-10-20 Rev.4：parent_exteriorの平板化でもTD04A・カメラと貫通口の座標は維持する。治具の取付ナットはプレート内のポケットへ沈め、箱底とのすきまを配線路に使わない。脚を付ける前に側面治具を締め、箱を載せる前にTD支持・QRメスを締める。実ケーブルの回転・抜去余長は従来の確認事項を引き継ぐ。

2026-10-20 Rev.5：親機の位置決め部一体化と予備M4穴追加でも機器・貫通口の配置は維持。予備ナット座と箱底のすきまを配線路に使わず、将来の治具・ねじ・工具と実配線は追加時に再確認する。

## 2026-10-25 TD04A治具の改訂

親機外装・子機横置き外装に共通td04a_bracket_mount Rev.6を配置。M4貫通＋ナット・穴中心12 mm（概数）、穴列を基準にケーブル側へ60 mm。送受信面は親機下・子機上。旧TD04A本体モデルは根拠にしない。ケーブル根元と曲げ半径・実物耳厚は未検証。[詳細](../parts/common/exterior/printed/td04a_bracket_mount/README.md)。

## 2026-10-27 北側ペネトレータ対応

親機の実物配置に合わせ、WetLink M10の2個をSPRESENSE側のA面へ記録した。箱座標X150／175、中心高さ30〜35 mm。既存ケースCADの本体側面外面はY228.3、蓋外形北端はY230。各穴の信号割当は未指定なので、配置モデルのラベルはpen_north_150／175とする。M10付属ナットを含む開放切欠きから内装を上へ取り出す。ケース側の配線は先に解放する。ナットの挿入口と引抜き経路を結束位置に使わない。

TX原点はX147／Y135.5／Z24.8（西1、南5 mm）。基板上20 mmの予約も同時に移す。ケース内の素線、端子、サービスループ、曲げ半径、ストレインリリーフの実物寸法は未モデル化で、干渉検査完了とはしない。機械側の手順と限界は [床板改訂報告](../assemblies/parent_hand_service/plate_access_report.md)。

## assemblies/parent_hand_service/sony_plate_thickening_report.md

現行スペーサは後続改訂で内部ナット穴を廃止し、M3×10を樹脂下穴へ直接締める。増厚寸法・座面高さは本書の値を継続する。最新の支柱固定・スライス結果は [内装改良報告](retrofit_report.md) を参照。以下のナット保持検査は増厚時点の履歴。

# SPRESENSE固定板の増厚 — 2026-10-24

ねじ止め時に固定板が割れた実物報告を受け、`sony_mount_plate` の肉抜き板と支柱ねじ座を厚1.6→3.2 mmへ変更した。設計寸法は `scad/lib/parent_gnss.py`、形状の正本は既存 `scad/lib/parent_corner_mounts.py` の `sony_shapes`。対象だけの再生成入口は `spec/build_parent_sony_plate.py`（既存CadServiceのbuild_native）。

再印刷は [parts/sony_mount_plate.stl](parts/sony_mount_plate.stl) **1個**。印刷入口は [parts/PRINT.md](parts/PRINT.md)。PETG、0.2 mm層、4周壁、100%充填、板下面をベッドへ向ける。既存の柱・穴位置・位置決めキー・板外形64×84 mmは維持する。キー穴入口は既存の取合い寸法、外周・肉抜き縁は既存0.15 mm面取り。

板下面Z60.5、板上面Z63.7、基板ねじ座上面Z67.15。基板原点はZ65.6→67.2、基板用M2.5×6ねじ頭の座面はZ68.8。基板裏面と板の公称余裕0.55 mm、TX予約上面と板下面の隙間0.305 mmは維持。基板と配線を外して交換し、上側の基板を元より1.6 mm高く取り付ける。

締結経路は、支柱固定用M3×10の頭座面Z63.7→厚3.2 mmの固定板→支柱上面Z60.5→支柱の反力部。ねじ先端Z53.7、支柱側の公称かかり6.8 mm。基板用M2.5×6は基板厚1.6 mmを挟み、ねじ座へ約4.35 mmかかる。ねじ先端Z62.8で板下面より2.3 mm上にある。上面へ抜けるナットだけに頼った固定として扱わず、今回の配置にある支柱ナットの+Z保持面と着座も検査した。支柱上部は組付け前にアクセスでき、板を外す際は基板を先に外す。

検査記録は [_work/analysis/sony_plate_thickening_20261024/geometry_checks.json](_work/analysis/sony_plate_thickening_20261024/geometry_checks.json)。FreeCAD有効単一ソリッド、保存・再読込、閉STL、周辺形状との干渉、支柱ねじ4本の頭座・穴通過・かかり、ナット保持面、基板ねじ4本の長さを確認した。旧薄板は同解析フォルダ内のhistoryへ保持する。

X1C・0.4 mm・Generic PETG・0.2 mm層・4壁・100%充填で実スライス済み。見積り9.34 g、30分29秒。45°自動支持・全表面・橋の支持除外なしで104移動の支持押出しがある。下面のキー穴付近の支持を除去し、座面と穴を確認する。初層・キー穴天井・板上面・ねじ座の実経路を確認した。[設定済み3MFと検査記録](print_jobs/sony_plate_thickening_20261024/README.md)。

厚くした形状の幾何・スライス検査であり、締付トルク・樹脂ねじの保持力・反復寿命・割れ防止の実物保証ではない。実印刷後は座面のバリや支持材を除去し、基板を反らせない範囲で締める。旧Sony板のスライス・強度記録を新版の合格根拠には使わない。

印刷一式は17種類20個（今回再印刷するのはSony板1個）。対象の出所・数量検査と作業ファイル整理検査は合格。全体出所チェックでは対象外の親機6構成に再ビルド／再同期の指摘が残る。共通テスト42件は41件合格、対象外 `child_wte4_suspension_clamp/spec/bambu_petg_basic_material.json` 欠落で1件エラー。今回の部品形状の不合格ではなく、全リポジトリ合格とは報告しない。ログは同解析フォルダの `global_parts_check.log` と `unittest.log`。

統合版のスライス確認：`print_jobs/retrofit_20261024/retrofit_plate_2.3mf` に厚3.2 mmの板を1個配置。X1C・Generic PETG・0.4 mmノズル・0.2 mm積層・壁4周・100%充填で実G-codeを確認。底面に開く位置決め凹部4か所の支持材は、組立前に下側から除去する。支持材不要ではなく、実印刷・嵌合・締付けは未確認。出力ハッシュは同フォルダmanifest.json。

## assemblies/parent_hand_service/frame_spacer_printability_report.md

# MAIN枠の下面と独立スペーサの改訂（2026-10-24）

印刷入口は [parts/PRINT.md](parts/PRINT.md)。本書を、それ以前の「全スペーサを2.8 mm下穴へ直接締結」「整備用M3×8」「最長30 mm」の記述に優先する。基板に一体化したねじ座と、独立したスペーサを区別する。

## 変更

- MAIN固定枠：従来は脚下面Z33.4に対し格子下面Z37.1で、格子の下に3.7 mmの空間があった。実際の格子下面を下方へ延ばし、脚と同じ印刷面に揃える。基板座面Z44.95と格子上面Z39.5は保持する。電源基板の裏を広く逃がし、逃げの上を斜面でつなぐ。個々の電子部品に合わせた小穴にはしない。
- 独立スペーサ：床側受け4本、GNSS側4軸、Sony側4軸、計12軸を対辺3.5 mmの補正八角穴にする。M3ねじの直径に対し公称0.5 mmの余裕。外形は床側受けが八角形、GNSS/Sony柱が面取りした角柱。位置決めキーの丸形状は相手穴との嵌合寸法を保持する。
- MAIN/PWR基板の一体ねじ座とアンテナ棚接合部のねじ込み先は、対辺2.8 mmの樹脂下穴を維持する。通し穴へ広げない。
- 共有柱のSony側1軸は直下にケースボスがあり、床への貫通固定を使えない。穴自体は3.5 mmで全長を通し、Z55.5–58.1の側面挿入ナットを上の屋根で受ける。床への固定は隣のGNSS軸を通るねじと下端の橋で行う。

## 金具と締結経路

| 場所 | ねじ・数量 | ナット・座金 | 締付け経路 |
|---|---|---|---|
| MAIN枠と床側受け | M3×30 ×4 | M3ナット、厚0.5/外径7 mm座金を各4 | 頭座Z35.6 → MAIN枠 → 独立受け → 同軸リング → 床板 → 座金 → 裏ナット |
| GNSS柱4軸（共有柱を含む） | M3×65 ×4 | 同ナット・座金を各4 | 頭座Z68.5 → GNSS台 → 柱 → 床板 → 座金 → 裏ナット |
| Sony独立柱3軸 | M3×60 ×3 | 同ナット・座金を各3 | 頭座Z63.7 → Sony固定板 → 柱 → 床板 → 座金 → 裏ナット |
| 共有柱のSony側 | M3×10 ×1 | M3ナット ×1、座金なし | 頭座Z63.7 → Sony固定板 → 共有柱上面 → 柱内の屋根 → 側面挿入ナット |

追加するナットは計12個、床裏の座金は計11枚。旧スペーサの上下から入れる短いねじ23本を、表の通しねじ12本へ置き換える。これらを重複して入れない。MAIN/PWR基板固定ねじは従来どおりM3×8/M3×6を各4本。Sony基板のM2.5ねじ、その他の基板・電池・ケース固定は既存構成に従う。

裏ナット下面はZ5.94、上面Z8.34、座金上面Z8.84で床の下面に当たる。締付けるとナットは+Zへ引かれ、座金と床板がこれを止める。スペーサと上板だけを締める経路にはしない。MAINねじ先端Z5.6、GNSS先端Z3.5、Sony長ねじ先端Z3.7。呼び寸法で全ナット厚2.4 mmを通る。GNSS先端とケース床との公称余裕が小さいため、実ねじ長とケースの実寸を確認する。

共有柱のナットは+Y側から挿入する。六角面が回り止め、Z58.1の屋根が+Z方向の抜け止めとなり、上面開放穴ではない。内側の六角面と反力面の稜は機能寸法を保持し、外側の挿入口だけを0.1 mm面取りする。MAIN枠の長い直線のベッド側稜は0.05 mm、電源側の扱い稜は生成元の面取り値を使用。基板座との曲面交差、穴の多角形の稜、共面の接合境界は機能面として保持する。

## 組立と印刷

床板をケースから取り出して組む。裏ナットは工具で保持して締める。裏ナットの回り止めを樹脂へ新設した構造ではなく、ナットを押さえる作業が必要。旧床板の上面開放ナット穴を、この締結の抜け止めとして使わない。

1. 共有柱のSony側ナットを側面から入れる。ねじが掛かるまでは手で仮保持する。
2. 柱、GNSS/Sony固定板を置き、長ねじを上から通し、床裏の座金とナットで挟む。共有柱のSony側はM3×10で固定する。締付け前後にキーの着座と先端の突出を確認する。
3. 同軸リング、床側受け、MAIN枠を置き、M3×30を上から通して床裏の座金・ナットへ締める。その後、基板とアンテナ棚を取り付ける。
4. ケースへ戻す前に、全ナット・座金と基板裏の隙間を確認する。分解時も床板ごとケースから取り出し、裏ナットを保持して外す。MAINの4本を抜くと床側受けも未固定になるので、受けとナットを回収する。従来の「床側受けを固定したまま上からM3×8だけ外す」手順は使わない。

16種類16個のSTL一式。今回形状が変わるのはMAIN枠1個と独立スペーサ11個。MAIN枠・柱・受けは原姿勢の下面をベッドへ向ける。同梱STLは製造メタデータに従って変換済み。アンテナ棚のみX180°。PETG、X1C/0.4 mm、0.2 mm積層、4周壁、100%充填、外側3 mmブリムでスライス確認する。新しい共有柱のナットポケットも支持材禁止モディファイアに含める。上の短い橋は工具経路画像で確認し、実物で印刷品質を確認する。

## 再生成と検証記録

正本は `scad/lib/parent_service_retrofit.py`。既存の `spec/build_parent_hand_service.py --service-retrofit` も同じ形状を使用する。今回のスナップショット付き検証・公開入口：

```powershell
python spec/revise_parent_printability.py
python spec/publish_parent_frame_spacers.py
python spec/rebuild_parent_frame_spacer_assemblies.py
python tools/assembly_parts.py sync parent_hand_service
python spec/slice_parent_frame_spacers.py
python spec/review_parent_frame_spacer_paths.py
```

検証記録は `_work/analysis/frame_spacers_20261024/geometry_checks.json`、`publication.json`、`clamp_path_checks.json`、`nut_roof_path_checks.json`、`slicing/plate_*/review.json`。変更前の部品と配置は同じ解析フォルダの `history/` に保持。確認画像は `_work/images/frame_spacers_*`。3MFを利用する場合は `print_jobs/frame_spacers_20261024/` の対象STLハッシュを照合し、従来の3MFを今回の形状として使わない。

形状129項目、締結経路と組立時の工具通路59項目、16部品のOpenSCAD独立レンダリング・閉メッシュ、X1Cの2プレートのスライスを確認。閉状態の組立STEPは138要素・位置不一致0。共有柱のナット穴内の支持材押出は0。工具経路の座標照合ではプリンタ設定のノズルオフセット0x2を補正する。各部品の実造形と橋の品質は未確認。

対象の `assembly_parts.py check parent_hand_service` と作業ファイル整理チェックはPASS。全体チェックに残った `parent_integrated`、`parent_interior_p1/p2`、`parent_rope_float`、`parent_service_review`、`parent_spar_bolted` の6件は、今回未変更の `spec/parent_interior_layout.py` 等と既存印刷一式の不一致。今回の変更ファイルによる不一致ではない。共通ツールテストは42件中41件PASS、既存の `bambu_petg_basic_material.json` 欠落1件ERROR。

閉メッシュ、STEP/STL整合、穴の全長通過、追加材と周辺部品の干渉、ねじ頭・ナットの反力面と全厚かかり、スライスは別々に評価する。検査結果は上記JSONを参照。実物の嵌合、締付けトルク、ナット座の耐力、層間強度、クリープ、波浪荷重は未検証。製造状態は嵌合確認用試作のまま。
