AquaBeacon/mechanical/assemblies/quick_release_trials/parts/DESIGN_NOTES.md

# 設計・印刷条件の控え（自動生成）

以下は設計元の文書を転記したものです。リンク先は元フォルダ基準です。印刷条件と未検証事項を確認してください。

## quick_release_trials/README.md

# 小型脱着治具・比較試作

**印刷入口: [parts/PRINT.md](parts/PRINT.md)**。このpartsフォルダだけコピーして印刷できる。[設計元の説明](../../parts/common/jigs/quick_release_prototypes/quick_release_prototypes.md)、配置の正本はplacement.json。

2026-09-28修正: A/Cの突出した固定側頭受けを廃止し、本体内へ固定ナットを埋め込んだ。右側を手回しボルトに変更。上向き開放の六角ポケットへナットを入れ、少量のエポキシで脱落防止する。締付力は本体壁で受ける。緑ノブが取付面を越えないよう上側板をA=10 mm、C=6 mm厚にした。下側板4 mm。Cの爪下面と回転溝天井を斜面化し、内部サポートを減らした。

| 案 | 構成 | 素手で解除 |
|---|---|---|
| A | 蟻溝＋押さえ、横M3×40、内蔵固定ナット | 約3回転緩め、押さえを外へ1 mmずらしスライド |
| B | 窓から片側1.5 mm出る爪、爪の機能は維持、外周フィレット追加 | 両爪をつまんで引く |
| C | 整列板、横M3×40、内蔵固定ナット | 約5.2回転でねじを外し、ノブ付きボルトを右へ抜き、時計回り60°戻して持上げ |

9種類9点。金具はM3×40六角ボルト2本、M3ナット2個、平ワッシャ2枚。旧CのM3×50は使わない。初回にナットとノブ内ボルト頭へエポキシを点付け、ねじ山に付けず硬化させる。右ワッシャは脱落防止式ではない。接着なしの固定ふたは含まない。金具寸法は仮定で実測が必要。

ノブ回転包絡と取付面の空間: A上側2 mm／下側1 mm、C上側2.5 mm／下側6 mm。側方の指用空間約10 mmとCボルト抜去約45 mmを別途確保する。A引出し約23 mm、B約40 mm、C持上げ約10 mm。厚くした取付板のM3ねじ長さは取付先に合わせる。

PETG、0.4 mmノズル、0.2 mm層、5周壁、上下6層、40% infillを仮比較条件とする。A押さえは外側X面を下、Bメスは入口を上。同梱STLは姿勢・接地済み。まずサポートOFFで短い橋と爪の初層を確認し、必要なら外側だけ局所サポート。ナットポケット・横穴・C回転溝内はサポート禁止。

```powershell
python tools/build_quick_release_prototypes.py --no-step
python tools/build_quick_release_prototypes.py --steps-only
python tools/preview_quick_release_trials.py
python tools/assembly_parts.py check
python tools/tidy_workspace.py check
```

[プレビュー](_work/images/comparison.png)、[C蓋裏のゴムくぼみ](_work/images/preview_C_pocket_empty.png)、[ゴム装着例](_work/images/preview_C_rubber_bond.png)、[形状・干渉](_work/analysis/verification.json)、[締結接触](_work/analysis/locking_verification.json)、[ゴムくぼみ・受け面](_work/analysis/pad_bond_verification.json)、[上下取付面の空間](_work/analysis/top_mount_clearance.json)、[取付穴](_work/analysis/mounting_verification.json)、[STEP](_work/analysis/step_verification.json)。銀色金具は理想形状表示で印刷一式に含めない。組立STL/STEPは印刷部品9点、STEPは面分割ソリッド。

閉メッシュ・寸法・離散経路・ナット挿入・取付穴・組立干渉を検査する。Aは摩擦依存、Cはカム溝とゴムパッドの圧縮で軸方向の遊びを詰める構成。強度、接着保持、実公差、疲労、操作力は未検証。無荷重10回→100回で緩み・ガタ・脱落・白化・亀裂を確認する。

[print_jobs](print_jobs/README.md)の3MFは旧形状の履歴。最新STLから再配置する。

外周フィレット追加: 取付板の縦角R3、上縁R0.8、ナット受け・C側面受け・Bメス外周の縦角R1、ノブ自由端R0.8。取付面と印刷底面は平坦、嵌合・係止面とM3穴は維持する。

組立時に上を向くオス板の反対側の縁も丸め、印刷底面は45°面取りへ接続した。Aメス本体と後端ストッパの露出縁も丸めた。

フィレット版の干渉・接触検査は、レンダリング済みの閉メッシュとplacement.jsonの締結配置を再利用する。金具形状と押さえの運動はSCAD、Bの変形包絡は従来のせん断近似を使う。

Cのゴムくぼみ（2026-10-01）: **5×8×1 mm×2**をCオス（蓋）下面の5.4×8.4×0.4 mmの開放くぼみに薄く接着する。各ゴムは0.6 mm突出し、固定位置ではメスの平らな上面に公称0.10 mm圧縮される。合計貼付面積80 mm²。カム引込み0.60 mm、終端の蓋下面Z=18.5、上側取付面Z=24.5。横M3を抜いてから60°戻す。Cは0.1 mm層で試作する。ゴムはプレビューのみで印刷9部品には含めない。貼付位置と調整方法は設計元を参照する。

## parts/common/jigs/quick_release_prototypes/quick_release_prototypes.md

# 小型オス／メス脱着インターフェース3案

2026-10-11：側面機器接続用 `twist_male_mount` を同じSCADのバリアントとして追加。[取付規格](../../../../docs/child_horizontal_twist_interface.md)。既存9種類の比較試作は保持する。追加オスの裏側32×32の4穴へ90°皿座（深1.45）を設け、M3×18皿ねじの頭を回転面の0.425 mm内側へ置く。裏へナットや普通ねじ頭を出すとメス側壁へ当たる。これはRev.1の別体接続用バリアントとして保持する。現行Rev.2は公開twist_male/femaleモジュールを治具へ直接unionして一体化し、別体オスと皿ねじを使わない。軸・爪・カム・ゴム・横穴は元と同じ。[既存9分岐の形状照合](_work/analysis/mount_variant_equivalence/validation.json)。追加オスにSTEPはなく、標準オスのSTEPを使わない。

使用構成: [quick_release_trials](../../../../assemblies/quick_release_trials/README.md)。印刷入口: [PRINT.md](../../../../assemblies/quick_release_trials/parts/PRINT.md)。原本は同階層のquick_release_prototypes.scad、単位mm。公開モジュールをuseして組み込む。荷重集中の少ない機体・テザー固定用の比較試作で、取付先・金具寸法は仮定。耐荷重・疲労・実物の脱着は未検証。

## 2026-09-28: 固定ナット内蔵と取付面

従来の固定側金具は六角ボルト頭だった。今回、左右を入れ替え、左に固定ナット、右に手回しボルトを置く。突出した薄い頭受けを廃止し、40 mmプレート外形内の一体ブロックへ六角ナットを埋め込む。締付力はナットの内側端面と本体壁で受け、圧入の引抜き抵抗には依存しない。

ナットポケットは対辺5.75、深さ2.55、上向き開放。仮定のナット対辺5.5・厚さ2.4に対し、軸方向余裕0.15を外側に設け、内側端面を荷重受けにする。左外側の残り壁厚はA=3.35、C=4.35。接着前には上へ抜ける。初回に金属と使用樹脂に対応する少量のエポキシをナットの外側端面・ポケット外壁側に点付けして脱落を防ぐ。ねじ山、荷重受け端面、摺動面へ付けない。六角輪郭が回転を抑え、接着剤は脱落防止だけを担当する。接着保持は実物で検証する。接着なしの固定ふたは含まない。

ノブにはボルト頭を入れる。底厚3.8で頭を受け、六角輪郭でトルクを伝える。頭にも少量の接着剤を点付けしてノブとボルトを一体で持てるようにする。硬化後に使用する。初回組付け後の脱着は素手。

## A: 蟻溝と可動押さえ

オス、メス、可動押さえslide_gib、Ø22ノブの4点。蟻溝は長さ20、首幅14、頭幅22、高さ6。上側オス板4→10 mm、下側メス板4 mm。オス外形40×40×16。

締結配置はオスtranslate([-0.5,0,25]) rotate([180,0,0])、押さえはネイティブ座標、ノブtranslate([18.5,0,12]) rotate([0,90,0])。軸X方向、Y=0、Z=12。固定ナットX=-16.5〜-14.1、頭下面X=22.3、M3×40先端X=-17.7。右ワッシャ1枚を介して押さえを締め、斜面と床へレールを押し付ける。スライド方向の保持は摩擦に依存する。

約3回転緩め（1.5 mm）、押さえを+Xへ1 mm指でずらし、オスを-Yへ約23 mm以上引く。オスのØ4.0開放スロットによりボルトを抜かず解除できる。3回転緩めた公称ねじ掛かり2.1 mm。緩め過ぎるとボルトが外れる。押さえは自動復帰しない。

取付はオス後端M3二穴（ネイティブX=±16、Y=+16）、メス32×32四穴。ノブ回転包絡Z=1〜23は下側取付面Z=0から1 mm、上側Z=25から2 mm内側。厚くしたオス板の取付ねじ長さは取付先に合わせて増やす。

## B: 窓から出る爪

爪の機能形状は維持し、取付板・メス外周を丸めた。腕長36、厚1.4、高さ4、中心舌幅6・長さ24。オス40×48×4、メス40×39×10。メス外側X=±13.8に対し爪端X=±15.3、片側1.5 mm突出。窓前縁Y=15.0に爪肩Y=15.15が掛かる。

オス配置translate([0,-0.15,3.3])。両爪を内側につまんで-Yへ約40 mm引く。検査の先端6 mmせん断は運動包絡の近似で、弾性・操作力の証明ではない。オス取付32ピッチ二穴、メスX=±16・Y=-8/23の四穴、頭逃げØ6.3。白化・亀裂・永久変形を実物で確認する。

## C: 整列板と横貫通ロック

オス、メス、Ø16ノブの3点。オス板4→6 mm、メス板4 mm、双方40×40・32×32四穴。軸Ø14×8、二爪外端半径10.5・厚3、リングØ28×14。メス外形40×40×18（突出受け廃止）、オス40×40×14。

固定状態translate([0,0,24.5]) rotate([180,0,0])、Z回転0°で上下板が整列。差込時Z回転-60°、反時計回り60°で整列。上面中央の締結穴はない。M3×40を右から右メス壁→オス横穴→左固定ナットへ入れる。軸X方向、Y=0、Z=14、Ø3.45。ナットX=-15.5〜-13.1、頭下面X=24.3、先端X=-15.7。右ワッシャ1枚、ノブtranslate([20.5,0,14]) rotate([0,90,0])。

約5.2回転でねじを外し、ノブ付きボルトを右へ抜く。右へ約45 mmの抜去空間を仮確保。右ワッシャを回収し、時計回り60°戻して+Zへ約10 mm持上げる。固定ナットはメス内に残る。ボルトを残して回転しない。横ねじは回転・軸方向移動を形状で止め、傾斜溝で回すほどオスを引き込み、蓋下面のくぼみに収めた2か所のゴムパッドを圧縮して軸方向の遊びを詰める。

ノブ回転包絡Z=6〜22は下側Z=0から6 mm、上側Z=24.5から2.5 mm内側。側面の指用空間は別途必要。

## 内部サポートを減らす形状・姿勢

- ナット挿入口は上向き開放で天井なし。
- 横穴は上向き45°屋根付き。A押さえは外側X面を下にして穴を縦向きに印刷。
- C爪下面に高さ1.5 mmの45°斜面を設け、回転溝天井も対応する斜面にする。爪の外端2 mmは平らな接触面とし、溝の外端約2 mmに平らな受け面を残す。短い橋と小さな穴縁張出しはスライスで確認する。
- Aオスの開放スロットには約4 mmの短い橋が残る。Bメスは入口を上にする。
- まずサポートOFFでスライスし、橋の第一層と爪根元を確認。必要なら除去できる外側だけ手動サポート、ナットポケット・横穴・C回転溝内はサポート禁止にする。全プリンタでサポート不要を保証しない。

## 金具・造形（仮定、実物を測る）

A/C合計M3×40六角ボルト2本、M3六角ナット2個、M3平ワッシャ2枚。旧CのM3×50は長過ぎるため使わない。並目0.5、頭対辺5.5・高さ2.12、ナット対辺5.5・厚2.4、ワッシャ外径7・内径3.2・厚0.5。SCADのmetal_*とポケット寸法は仮定。所有金具を実測する。キャップボルト頭は別形状。取付先へのM3ねじ・ナットは別途。

9種類9点。PETG、0.4 mmノズル、0.2 mm層、5周壁、上下6層、40% infillを比較開始条件とする。Bの腕がスライスで途切れないことを確認。A押さえとBメスに5 mm brimを仮推奨。STLは姿勢変換・接地済み。姿勢の正本はmanufacturing.json。

公開モジュール: slide_male, slide_female, slide_gib, snap_male, snap_female, twist_male, twist_female, hand_knob, placed_knob, fixed_nut。取付面は原則ネイティブZ=0。SCADをuseしunionで組み込む。寸法変更時は両側・配置・検証を再生成する。

## 検証範囲

OpenSCADレンダリング、閉メッシュ・単一連結体・外形・体積、離散解除経路、ナット挿入、金具干渉、取付穴、ノブと上下取付面の空間、STEP整合を検査する。締結接触は微小な仮移動で検出し、強度計算ではない。実公差、接着保持、保持力・疲労・操作力は未検証。無荷重10回→100回で緩み、脱落、ガタ、白化、亀裂を確認してから実荷重条件を決める。

## 外周フィレット

2026-09-28追加: A/B/Cの取付板外周の縦角をR3、露出する上側の縁をR0.8で丸めた。固定ナット受け・C側面の受け・Bメス外周は縦角R1／上縁R0.8。手回しノブの自由端もR0.8。SCADのtouch_filletとplate_corner_rで調整する。円弧は15°ごとの断面で近似した。取付面・印刷底面は平坦を保ち、爪の係止面、蟻溝、六角ポケットと穴径は維持する。反対側の縁も円弧で丸め、底面側は45°面取りへ接続する（既定の底面逃げ約0.47 mm、最小0.35 mm）。取付面の中央は平坦を保ち、新しい内部サポート形状を追加しない。

フィレット版の干渉・接触検査は、レンダリング済みの閉メッシュとplacement.jsonの締結配置を再利用する。金具形状と押さえの運動はSCAD、Bの変形包絡は従来のせん断近似を使う。

## C: 蓋下面のくぼみと1 mmゴム（2026-10-01）

厚さ1 mmのゴムを**5×8×1 mm、2枚**切り、Cオス（蓋）の下面、中心からX=±10.5 mmにある**5.4×8.4 mm、深さ0.40 mm**の開放くぼみに入れる。片側0.20 mmの横余裕を設け、ゴムを平らな底へ薄く接着する。各40 mm²、合計80 mm²の貼付面積（初期案の約3.3倍）。くぼみの壁が剥がれ・ずれを抑える。角は手切りの矩形ゴムが入るよう直角に残した機能面。ゴム、接着剤は印刷部品に含めない。

リング上面Z=18.0、固定時の蓋下面Z=18.5。ゴム1.0 mmのうち0.40 mmをくぼみに収め、0.60 mmを突出させる。平坦なメス上面との公称圧縮量は**0.10 mm**（厚さの10%）。差込位置の蓋下面Z=19.1から60°の回転で0.60 mm引き込み、固定位置Z=18.5、上側取付面Z=24.5になる。横M3の軸Z=14とM3×40ボルトは維持し、オス横穴のネイティブ高さを追従させた。解除時は横ねじを抜き、60°戻してゴム圧縮を解く。

くぼみは蓋を造形すると上向きに開放され、内部サポートは不要。くぼみの下に1 mm以上連続した床があること、2枚とも取り付け先の受け面が連続していることをメッシュで検査する。接着層の厚さは公称圧縮量に含めず、薄く塗布して底まで押し込む。実測厚さ・材質・硬さと印刷誤差により手応えは変わる。ゴムが抜ける、はみ出す、固くて終端へ届かない場合は無理に回さない。

形状検査は蓋を0.005 mm刻みで持ち上げ、カム接触が公称圧縮0.10 mmの範囲内で生じることを確認する。実際の圧縮力・接着保持力・耐荷重・疲労は未検証。Cオス・メスは0.1 mm層を試作開始条件とする。調整は`twist_pad_depth`（くぼみ深さ）か`twist_pad_compression`（公称圧縮）で行い、変更後はSCAD・横穴・配置・STL/STEPを一緒に再生成する。
