AquaBeacon/mechanical/assemblies/td04a_fixture/parts/DESIGN_NOTES.md

# 設計・印刷条件の控え（自動生成）

以下は設計元の文書を転記したものです。リンク先は元フォルダ基準です。印刷条件と未検証事項を確認してください。

## td04a_fixture/README.md

# TD04A固定治具 Rev.6

M4貫通穴＋ナット2組、設計ピッチ12 mm（ユーザー指定は約12 mm）、M4穴列基準でケーブル側へ60 mmの空間。送受信面は親機下向き・子機上向き。旧TD04Aモデルは表示・適合判断に使わない。

[印刷入口](parts/PRINT.md) / [設計と締結経路](../../parts/common/exterior/printed/td04a_bracket_mount/README.md) / [配置正本](placement.json)

改訂治具と60 mmの予約域

親機はparent_exteriorの既存M5/20 mm穴、子機はchild_horizontal_plate_frameの既存側面M3/20 mm穴に配置。外装側板・主プレートの再加工は不要。緑の予約域は高さ60 mm、幅と奥行は仮値。青矢印は送受信方向だけを示し、本体形状を表さない。

[幾何検査](_work/analysis/geometry_checks.json)、[外装干渉・連続掃引によるナット保持](_work/analysis/cable_clearance_r6/exterior_checks.json)。耳厚3 mmの仮定でM4×14を表示。実物の正確な穴間隔、耳の厚み・座面、本体、ケーブル根元・曲げ半径、締付・実造形・強度は未確認。センサー側の締結成立を認定しない。

旧Rev.5の履歴は_work/analysis/cable_clearance_r6/history/。旧3MFは使用しない。再生成とねじの順序は設計説明を参照。

## parts/common/exterior/printed/td04a_bracket_mount/README.md

# TD04A固定治具 Rev.6：12 mmピッチ・ケーブル逃げ60 mm

2026-10-25ユーザー指定。正本はtd04a_bracket_mount.scad。旧TD04A本体モデルは使用しない。過去の10 mmピッチと親機形状保持の条件を今回の指定で更新した。旧データはassemblies/td04a_fixture/_work/analysis/cable_clearance_r6/history/に保持。

- TD04A取付はM4貫通ねじ＋普通ナット2組、CADの穴中心間隔12 mm、内接クリアランス径4.5 mm。「約12 mm」の指定であり実測一致の認定ではない。
- 送受信面は親機-Z、子機+Z。取付面はその面に直角という既存の取合いを引き継ぐ。本体の仮形状は表示しない。
- 穴列から外装側へ60 mmを確保。板厚5 mm、穴列オフセット65 mm、治具長75 mm。親機はフランジ下面から穴列まで60 mm。子機は穴列より下へ60 mmの予約域。図の幅12×奥行15 mmは検査用の仮幅で、実ケーブルの根元・曲げ半径まで確認した意味ではない。

## 実配置と締結経路

親機：parent_exteriorの既存XY=(65,-55),(85,-55)のM5穴を使用。治具原点(53,-55,-20)、Z回転-90度。接触面Z=-20、治具下面Z=-25、M4穴列Z=-85。M5×40皿頭→主プレート→治具5 mm→M5ワッシャ1 mm→M5ナット4 mm。ワッシャZ=-26..-25、ナットZ=-30..-26。皿ねじの先端Z=-40.8、ナット下面からの突出10.8 mm。防水容器を外して上から皿頭へ工具を入れ、下からナットを保持して組み立てる。既存ねじ先端の突出は長めなので、TD04A実物との干渉を初回確認する。ナットは下から工具で保持し、締付時の+Z移動はワッシャと治具下面で受け、主プレートを挟む。旧押さえ金具・クランプねじ・TD04A参照モデルは今回の配置から外す。親機内外装統合等の旧構成へは自動反映しない。

子機：child_horizontal_plate_frameの既存右後側M3縦2穴を使用。治具原点(122,-74,108)、穴列X=148/160・Y=-74・Z=173。M3×20頭→φ7×0.5ワッシャ→治具5 mm→側板12 mm（内側2.8 mmナット座）→M3ナット。既存のナット座肩が締付時の+Xを受ける。内側からナットを入れ、外側から締める。側板加工なし。ねじ先端はナットから2.9 mm突出。穴位置・工具通路・ナット挿入・ケースとの干渉を検査し、軸方向保持は連続掃引形状でも検査する。

センサー側は後方からM4ねじ頭→φ9×0.8ワッシャ→治具5 mm→実物の取付耳→φ9×0.8ワッシャ→ナット3.2 mm。耳厚3 mmの仮定ではM4×14、先端突出1.2 mm。ナットはスパナで回り止めし、締付時に取付耳をワッシャ越しに受ける。耳厚・座面・穴縁肉厚は未採寸のため、センサー側の締結成立は未達。実物に合わせてねじ長さを決める。接着剤を保持に使わない。

## 印刷と検証の範囲

親機外形26×42×75、子機45×26×75 mm。親機[0,-90,0]でL字側面下、子機[0,0,0]でL字下端下。外周R1.5、内角R3、端面取り0.6、穴入口0.3、穴先端R0.15 mm。横穴は印刷+Zへ屋根を向ける。PETG Basic/X1C/0.4ノズル/0.2層/8壁/100%/ブリム5 mmを試作条件とする。実造形・荷重・クリープは未検証。

印刷入口は各assemblyのparts/PRINT.md。各外装に1個ずつを同梱し、td04a_fixtureのpartsは同じ2部品の比較用一式。両方を重複印刷しない。旧Rev.5の3MFは現行形状に使わない。

再生成：python spec/rebuild_td04a_fixture.py → python spec/install_td04a_fixture.py → python spec/check_td04a_fixture.py → python spec/check_td04a_exteriors.py。外装組立はbuild.ps1 -Assembliesで再生成、印刷一式を同期する。SCADが正本、STEPは交換形状。閉メッシュ・外形・干渉・ナット保持・スライスと実物締結・強度は別の検査。

Rev.6検証：部品67項目・外装8項目・STEP読戻しは合格。スライスと実G-codeの監査も合格。自動支持は少量を提案しており、支持無効試作の実印刷は未確認。共通42テストは41合格、既存材料JSON欠落1エラー。

## parts/common/exterior/printed/td04a_bracket_mount/README.md

# TD04A固定治具 Rev.6：12 mmピッチ・ケーブル逃げ60 mm

2026-10-25ユーザー指定。正本はtd04a_bracket_mount.scad。旧TD04A本体モデルは使用しない。過去の10 mmピッチと親機形状保持の条件を今回の指定で更新した。旧データはassemblies/td04a_fixture/_work/analysis/cable_clearance_r6/history/に保持。

- TD04A取付はM4貫通ねじ＋普通ナット2組、CADの穴中心間隔12 mm、内接クリアランス径4.5 mm。「約12 mm」の指定であり実測一致の認定ではない。
- 送受信面は親機-Z、子機+Z。取付面はその面に直角という既存の取合いを引き継ぐ。本体の仮形状は表示しない。
- 穴列から外装側へ60 mmを確保。板厚5 mm、穴列オフセット65 mm、治具長75 mm。親機はフランジ下面から穴列まで60 mm。子機は穴列より下へ60 mmの予約域。図の幅12×奥行15 mmは検査用の仮幅で、実ケーブルの根元・曲げ半径まで確認した意味ではない。

## 実配置と締結経路

親機：parent_exteriorの既存XY=(65,-55),(85,-55)のM5穴を使用。治具原点(53,-55,-20)、Z回転-90度。接触面Z=-20、治具下面Z=-25、M4穴列Z=-85。M5×40皿頭→主プレート→治具5 mm→M5ワッシャ1 mm→M5ナット4 mm。ワッシャZ=-26..-25、ナットZ=-30..-26。皿ねじの先端Z=-40.8、ナット下面からの突出10.8 mm。防水容器を外して上から皿頭へ工具を入れ、下からナットを保持して組み立てる。既存ねじ先端の突出は長めなので、TD04A実物との干渉を初回確認する。ナットは下から工具で保持し、締付時の+Z移動はワッシャと治具下面で受け、主プレートを挟む。旧押さえ金具・クランプねじ・TD04A参照モデルは今回の配置から外す。親機内外装統合等の旧構成へは自動反映しない。

子機：child_horizontal_plate_frameの既存右後側M3縦2穴を使用。治具原点(122,-74,108)、穴列X=148/160・Y=-74・Z=173。M3×20頭→φ7×0.5ワッシャ→治具5 mm→側板12 mm（内側2.8 mmナット座）→M3ナット。既存のナット座肩が締付時の+Xを受ける。内側からナットを入れ、外側から締める。側板加工なし。ねじ先端はナットから2.9 mm突出。穴位置・工具通路・ナット挿入・ケースとの干渉を検査し、軸方向保持は連続掃引形状でも検査する。

センサー側は後方からM4ねじ頭→φ9×0.8ワッシャ→治具5 mm→実物の取付耳→φ9×0.8ワッシャ→ナット3.2 mm。耳厚3 mmの仮定ではM4×14、先端突出1.2 mm。ナットはスパナで回り止めし、締付時に取付耳をワッシャ越しに受ける。耳厚・座面・穴縁肉厚は未採寸のため、センサー側の締結成立は未達。実物に合わせてねじ長さを決める。接着剤を保持に使わない。

## 印刷と検証の範囲

親機外形26×42×75、子機45×26×75 mm。親機[0,-90,0]でL字側面下、子機[0,0,0]でL字下端下。外周R1.5、内角R3、端面取り0.6、穴入口0.3、穴先端R0.15 mm。横穴は印刷+Zへ屋根を向ける。PETG Basic/X1C/0.4ノズル/0.2層/8壁/100%/ブリム5 mmを試作条件とする。実造形・荷重・クリープは未検証。

印刷入口は各assemblyのparts/PRINT.md。各外装に1個ずつを同梱し、td04a_fixtureのpartsは同じ2部品の比較用一式。両方を重複印刷しない。旧Rev.5の3MFは現行形状に使わない。

再生成：python spec/rebuild_td04a_fixture.py → python spec/install_td04a_fixture.py → python spec/check_td04a_fixture.py → python spec/check_td04a_exteriors.py。外装組立はbuild.ps1 -Assembliesで再生成、印刷一式を同期する。SCADが正本、STEPは交換形状。閉メッシュ・外形・干渉・ナット保持・スライスと実物締結・強度は別の検査。

Rev.6検証：部品67項目・外装8項目・STEP読戻しは合格。スライスと実G-codeの監査も合格。自動支持は少量を提案しており、支持無効試作の実印刷は未確認。共通42テストは41合格、既存材料JSON欠落1エラー。
