AquaBeacon/mechanical/assemblies/parent_assembly/parts/DESIGN_NOTES.md

# 設計・印刷条件の控え（自動生成）

以下は設計元の文書を転記したものです。リンク先は元フォルダ基準です。印刷条件と未検証事項を確認してください。

## parent_assembly/README.md

**印刷一式:** [parts/PRINT.md](parts/PRINT.md)（STL・数量・モディファイア） · **確認画像:** [_work/images/](_work/images/)

# parent_assembly

- [parent_assembly.md](parent_assembly.md)
- [parent_assembly.step](parent_assembly.step)
- [parent_assembly_view.scad](parent_assembly_view.scad)

構成と既存の未検証事項は上の設計説明を参照してください。

## parts/common/exterior/printed/xdcr_socket/xdcr_socket.md

# xdcr_socket — TD04A 振動子ソケット (子機/親機 共用)

| 項目 | 値 |
|---|---|
| 区分 | 共通 / 外装 / 3Dプリント |
| 設計ソース | `xdcr_socket.scad` (バリアント定義 `variants.txt`) |
| 個数 | 子機 1 (`_child`) / 親機 1 (`_parent`) |
| 外形 (`_child` / `_parent`) | **50 × 50 × 38 mm** (2026-09-04 base_w 60→50。親機バリアントも同形状 tilt 0) |
| 体積 (`_child`) | 36.1 cm³ |
| STEP (`_child`) | 1 ソリッド / 31 面 |

## 役割

円筒ソケットに TD04A を差し込み、結束バンド 2 本で保持する。

| バリアント | `tilt_deg` | 取付先 | 状態 |
|---|---|---|---|
| `xdcr_socket_child` | 0 (垂直)、**base_w=50** (2026-09-04) | frame2: `child_core_frame` ペデスタル HP1 (0, −85, z218.5) へ M5×4。開口 = 上向き。(旧: `child_frame_plate` 後方コーナー) | **ビルド可** |
| `xdcr_socket_parent` | **0** (2026-09-04) | `parent_deck` キール南 HP40 座 (0, −70, −60) の下面。開口 = 下向き (X 軸 180° 回転) | **ビルド可** (child と同形状 50 × 50 × 38) |

## 親機バリアント (2026-09-04 改訂: tilt 0)

親機は支柱 (マスト) 無しになり、TD04A はデッキ下面の HP40 座 (M5 ×4 @ 40 = 本部品の
`hole_p`) に**傾き無し・開口下向き**で付ける。`variants.txt` の `parent` は
`tilt_deg=0 base_w=50` で child と同形状 (アセンブリが参照する名前として分けている)。

旧 parent (tilt_deg = 20、マストヘッド用) は assert
「M5頭がスカートと干渉: 頭内縁 24.03 < スカート半径 34.03」で停止したまま**廃止**
(傾きが要るなら HP40 側に楔アダプタを作る)。
底の Ø9 は下向きでは水抜きにならないが、ソケット開口が下なので水は溜まらない。

## 主要寸法

| 変数 | 値 | 意味 |
|---|---|---|
| `tilt_deg` | 0 / 20 | ソケット軸の傾き |
| `base_w / base_t` | 60 / 6 | 取付ベース |
| `hole_p / m5_d` | 40 / 5.3 | M5 4 穴ピッチ ← `child_frame_plate.xd_pitch` |
| `xdcr_d` | 26.4 | TD04A 胴径 26.0 (**要実測**) + 0.4 |
| `wall / depth / floor_t` | 5 / 32 / 6 | ソケット肉厚 / 差込み深さ / 底厚 |
| `cable_d` | 9 | 底のケーブル/水抜き穴 |
| `tie_w / tie_t / tie_z` | 5.5 / 3 / [12, 24] | 結束バンドスロット |

## 干渉チェック (`.scad` 冒頭の assert)

- 傾き ≤ 25°
- M5 穴の端距離
- 傾きでソケットがベースから大きくはみ出さないこと
- **M5 頭 (Ø8.5) がスカートに乗り上げないこと** ← 親機バリアントはここで止まる

## 印刷向き

ベースを下に平置き。ソケットは垂直円筒で無サポート
(tilt > 0 のときはスカートが 45° を保証する形状になっている)。

## 部品外の考慮

- 底の Ø9 は**ケーブル出しと水抜きを兼ねる**。塞がないこと。
  親機 (下向き) では水抜きにならないので、別途排水を考えること。
- 振動子の**放射面を塞がない**。ソケットは胴を掴むだけで、放射面は開口から出る。
- **ケーブル 3m + 3P プラグ**が付いてくる (`td04a_transducer.md` 参照)。
  プラグは水中コネクタではないので、子機では容器内 or 水面上に収める。
- 結束バンド (4.8mm 帯) は消耗品。締め直しのため**工具/指が入る**こと。
- 気泡が振動子面に残ると測距できない。設置後に**面を撫でて泡を抜く**運用手順が要る。

## 要確認

1. TD04A 胴径・胴長の実測 → `xdcr_d` / `depth` の確定 (最重要)
2. 親機バリアントの設計方針決定 (上記 3 案)
3. ケーブル外径 → ペネトレータ型番

## parts/parent/exterior/printed/parent_deck/parent_deck.md

# parent_deck — 親機 デッキ (防水ボックス台 + 浮子ヨーク取付 + 下面ハードポイント)

| 項目 | 値 |
|---|---|
| 区分 | 親機 / 外装 / 3Dプリント |
| 設計ソース | `parent_deck.scad` |
| 個数 | 1 |
| 外形 | 216 × 236 × 60 mm (デッキ上面 z=0、キール座面 z=−60) |
| 体積 (中実) | 839 cm³ → PETG 壁 4 + インフィル 25 % で **約 0.43 kg** |
| STEP | 1 ソリッド / 219 面 / watertight |

## 役割 (2026-09-04 人間決定の親機外装構成)

- **浮子 2 個・支柱 (マスト) 無し・カメラは Osmo Action 6 + 純正防水ケース (ジグは後日)**。
- タカチ **BCAS212310G** を上に載せ、箱底コーナーの**外部取付穴 Ø4.2 ×4** (図面 E-E、
  箱中心から (±96, ±106)) に上から M4 を通し、デッキの **M4 熱圧入インサート** ×4 で受ける。
- 左右 (±X) 側壁の外面に **HP40 座 ×2 / 側** (Y ±70, z −25) → `parent_float_yoke` (浮子の端受け、
  2026-09-05 にアーチ式クレードルから置換) を M5 ×4 で締結。ヨークを外せば同じ座に別のアクセサリを付けられる (拡張性)。
- 下面中央の**キール** (壁 2 枚 + 端壁 2 枚 + 座板 3 枚) の底面 (z −60) に **HP40 座 ×3**
  (Y −70 / 0 / +70) → 南 = TD04A ソケット (`xdcr_socket_parent`, 開口下向き)、
  北 = **Osmo 固定ジグ用 (予約)**、中央 = 予備。
- 紐穴: 側壁両端 **Ø8 ×4** (X 貫通、Y ±108, z −35) = 吊り索 / 浮子の紐の予備の結び点 (ヨークのフィンに同軸の Ø8 穴があり塞がれない)。
- **南縁ケーブル切欠き** (X −30..25、深さ 8) = 南壁ペネトレータ ×2 (箱 x=85/120 →
  デッキ X −20/+15) から降りるケーブルをデッキ下へ回す。キール南端壁の **Ø8 フェアリード ×2**
  (X ±9, z −30) でテザー / TD04A ケーブルの張力止め (結束バンド or 結び目)。

## 座標系

箱中心 = 原点、デッキ上面 (= 箱底外面) z=0、+Y = 北 (箱の北壁側)。
**箱座標 (x, y) → デッキ (x − 105, y − 115)**。

## 主要寸法

| 変数 | 値 | 意味 |
|---|---|---|
| `plate_x / plate_y / plate_t` | 216 / 236 / 6 | デッキ板 (箱カバー外形 210 × 230 + 3/側) |
| `ear_x / ear_y / ear_pilot_d / ear_pilot_h` | ±96 / ±106 / 5.6 / 9 | 箱固定 M4 インサート下穴 (上から) |
| `lip_t / lip_h` | 17 / 50 | 側壁 (X ±91..±108)。厚 17 = HP40 下穴 9 + 箱取付穴が板内に収まる下限 16 + 1 |
| `hp_lip_y / hp_lip_z` | [−70, 70] / −25 | 側壁 HP40 座中心 (座面 X = ±108) |
| `rope_d / rope_y / rope_z` | 8 / ±108 / −35 | 側壁 紐穴 |
| `win_w / win_h / win_z0` | 36 / 14 / −44 | 側壁の軽量窓 (45° 屋根、X 貫通) |
| `keel_wall_t / keel_wall_x / keel_y / keel_wall_z` | 8 / 16 / ±105 / −50 | キール壁 X ±16..±24 |
| `pad_t / pad_w / hp_keel_y` | 10 / 50 / [−70, 0, 70] | キール座板 (座面 z −60) |
| `end_wall_t / fair_d / fair_x / fair_z` | 6 / 8 / ±9 / −30 | キール端壁とフェアリード |
| `notch_x0 / notch_x1 / notch_d` | −30 / 25 / 8 | 南縁ケーブル切欠き |

HP40 の定数 (`hp_pitch 40 / hp_ins_d 6.4 / hp_ins_h 8 / hp_pad 50 / hp_cable_d 14`) は
`scad/lib/hardpoint.scad` と二重定義 (`use` なので定数が見えない)。

## インタフェース

| 相手 | 内容 |
|---|---|
| `bcas212310g` | 箱底コーナー Ø4.2 ×4 @ (±96, ±106) ← M4 ×16 (上から) → デッキ M4 インサート。箱の胴体 (約 204 × 224) がデッキ板に載る。**ねじの向き (上から / 下から) は現物で要確認** (図面 E-E では 6 厚の足に Ø4.2) |
| `parent_float_yoke` ×4 | 側壁外面 HP40 ×2 / 側 (Y ±70, z −25)。M5 ×25 ×4 / 座。ヨークのアダプタ板 (56 角) は座より 3 大きく、デッキ上面より 3 上・側壁下端より 3 下に出る (デッキ板の縁の外側なので干渉なし) |
| `xdcr_socket_parent` | キール南座 (0, −70, −60)。M5 ×4 @ ±20 (ソケット `hole_p 40` = HP40) |
| Osmo 固定ジグ (未設計) | キール北座 (0, +70, −60)。HP40 アダプタ板 (t6, M5 バカ穴 Ø5.4 ×4, 中央 Ø14) を持たせること |
| `wetlink_penetrator_m10` ×2 | 南壁 (デッキ Y −115) x=−20/+15、軸 z 65、頭は箱外 Y −137..−115 → デッキ南縁 (−118) の外で干渉なし。ケーブルは南縁切欠きから下へ |

## 干渉チェック (`.scad` 冒頭の assert)

- 箱の取付穴 Ø5.6 が側壁の板厚 (X 91..108) に収まる / インサート下穴が側壁を突き抜けない
- 側壁の YZ 面フィーチャ表 (HP40 下穴 ×8 + 中央穴 ×2 + 紐穴 ×2 + 箱取付穴 ×2) を**総当り**で離隔 ≥ 3
- 軽量窓が HP40 座・側壁下端・デッキ板 (45° 屋根の頂点) から離れる
- キール座の HP40 下穴 Ø6.4 @ ±20 が壁 (X ±16..±24) の真下にある (母材) / 座同士 ≥ 座 + 10 / 端壁と重ならない
- フェアリード穴がキール壁・端壁高さに収まる
- 南縁切欠きが箱の胴体壁の下を 3 以上残す / ペネトレータ直下を覆う / 側壁に掛からない
- 250³ 造形枠

実際に止めたもの (2026-09-04): 箱取付穴が側壁板厚 14 に収まらない → 17 へ /
キール座下穴が壁の真下に無い → 壁 X 17 → 16 / キール座が端壁に掛かる → 壁半長 100 → 105。

## 荷重ケースと強度

| ケース | 荷重 | 係数 | 入力 | 受け |
|---|---|---|---|---|
| L1 定常 | 箱+内装 1.05 kg + アクセサリ 0.7 kg | 1 | デッキ板上面 | 側壁 HP40 (ヨーク) |
| **L2 取り回し** | 同上 2.45 kg → **120 N** | 5 | デッキ板上面 | 側壁 HP40 ×8 ボルト (15 N/本) |
| L2b テザー引き | 50 N (−Y) | 3 | キール南端フェアリード | 側壁 |
| L3 落下 | アクセサリ 0.4 kg → 40 N | 10 | キール南座 | 側壁 |

`quick_strength.py` (PETG, 面内): 板 (236 × 94 × 6, 100 N) 0.33 MPa / 0.04 mm ✅、
側壁を片持ち梁 (L236 b14 h50, 175 N 先端) と見ても 7.1 MPa ✅ (たわみ 3.0 mm は片持ち仮定の
過大評価。実際は両ヨーク座 (Y ±70) で支持されるので梁長は 140)、
M5 インサート引抜き 0.25 MPa ✅、M4 インサート (箱固定) ✅。

### FEA 結果 (`fea/study.json` → `topopt fea --voxel 2.16`, 出力 `fea/out/`, 2026-09-04)

PETG 直交異方性カード (`petg_generic_fff_orthotropic_v1`)、build 軸 Z、87,124 要素、
メッシュ解像度 PASS (最薄部 8.6 mm に 4 要素)。支持 = 両側壁の HP40 座面 (X ±108 帯)。

| ケース | 荷重 | 最大変位 | von Mises 最大 | 安全率 (最悪 / p99.5) | 判定 |
|---|---|---|---|---|---|
| L2 持ち上げ | 120 N 下向き (デッキ上面) + 自重 ×5 | 0.15 mm | 1.2 MPa | 30 / 47 | ✅ |
| L3 落下 | 40 N (キール南座) + 自重 ×10 | 0.24 mm | 2.2 MPa | 17 / 37 | ✅ |
| L2b テザー引き | 50 N (−Y, 南端フェアリード) + 自重 ×3 | 0.07 mm | 0.7 MPa | 51 / 133 | ✅ |

ホットスポットは箱取付インサート穴の縁 (±96, ±101) と南端壁の根元 — いずれも SF ≥ 17。
たわみは全ケース 0.25 mm 以下 (許容 1.0)。**律速は強度ではなく浮力** (上記 部品外の考慮)。

## 印刷 (X1-Carbon)

- **上下反転** (デッキ上面をベッドに)。側壁・キール壁・座がベッドから立つ。`topopt overhang`
  (反転 STL): **要サポート面積 3.6 %** = キール座板 (t10) の壁間 32 mm ブリッジ ×3 と側壁窓の
  45° 屋根。**サポート不要** (X1C のブリッジで可。気になれば座板下のみサポート)。
- 主引張 (側壁の曲げ = Y 方向、板の曲げ = XY 面内) は層面内。`topopt print --keep-flat Z` の
  「load vs layers FAIL」は `--load-axis 0,0,1` を与えたためで、実荷重方向 (Y) では PASS。
- 材料 PETG (屋外・水・紫外線なら ASA)。壁 4 本 / インフィル 25 % (ジャイロイド) / 上下 5 層。
- HP40 のインサート下穴 (Ø6.4) は反転印刷で座板側が上面になるので、印刷後にそのまま熱圧入できる。
  側壁の横穴 (Ø6.4 / Ø8 / Ø14) は水平穴 = 上面がやや垂れる。Ø6.4 は熱圧入時に馴染む。
- 反り対策: 216 × 236 の全面ベッド接触。ブリム 5 mm、ベッド中央。

## 部品外の考慮

- **ケーブル**: 南壁ペネトレータ (箱外 z 65) → 南縁切欠き → キール南端フェアリード →
  南座ソケットの底穴 Ø9 / HP40 中央 Ø14。TD04A の 3P プラグは通らないので**箱内で切って
  端子台**に落とす (`wetlink_penetrator_m10.md`)。テザーは南端フェアリードで**張力止め**を
  してからペネトレータへ (シール部に引張をかけない)。
- **喫水**: 浮子軸 z 0・総質量 3.14 kg で喫水線は **z ≈ −2.7** (`spec/parent_hydrostatics.py`) = デッキ板がほぼ全部水中、
  箱底が水面。側壁・キール・TD04A 面 (−104) は水中。デッキは密閉インフィルの PETG なので 0.84 L の浮力体でもある。
  水抜き穴 (キール座の Ø14、側壁窓) から水が入っても抜けるので問題なし。
- **水抜き**: デッキ板上面は箱が覆う。側壁の軽量窓とキール壁間の通路は水が抜ける。
  キール座の中央 Ø14 はケーブル穴兼水抜き。
- **GPS アンテナ**: 箱の蓋の上 (最頂部)。デッキは関与しない。北壁の引込みグランドは未定。
- **工具アクセス**: 箱固定 M4 は蓋を開けて上から (箱内側から) 締める前提。ヨークの M5 は
  ヨーク外面のざぐりから六角レンチで締める (デッキ側はインサート)。
- **持ち上げ**: 側壁の紐穴 ×4 に吊り索を通す。箱の蓋やペネトレータを掴まないこと。

## 要確認

1. **箱の外部取付穴の使い方** (ねじを箱内側から下へ通せるか / 穴が貫通か)。現物で確認 →
   通せなければ下から M4 + 箱内ナット (要防水) に変更
2. 浮子実測 → ヨーク・喫水の再計算 (デッキ自体は変わらない)
3. Osmo 固定ジグ (北座) の設計: 座面 (z −60) が喫水線 (≈ −3) より下なので、ケースをそのまま座に付ければ水中
4. ペネトレータ頭 (箱外 22 mm) とケーブルの曲げ半径 (切欠きまでの落差 65 mm)

## parts/parent/exterior/printed/parent_float_yoke/parent_float_yoke.md

# parent_float_yoke — 親機 浮子ヨーク (紐通し式フロートの端受け)

| 項目 | 値 |
|---|---|
| 区分 | 親機 / 外装 / 3Dプリント |
| 設計ソース | `parent_float_yoke.scad` (バリアント `variants.txt`: `a` = hand +1 / `b` = hand −1 = Y ミラー) |
| 個数 | **4** (a ×2 + b ×2。右舷後 = a、右舷前 = b、左舷後 = b を 180°、左舷前 = a を 180°) |
| 外形 | 113 × 127 × 96 mm (フィン面 X=0、アダプタ下端 z −28、柱下端 z −18、フィン/柱上端 z +68 = デッキ上面 +43) |
| 体積 (中実) | 431 cm³ → PETG 壁 4 + インフィル 25 % で **約 0.2 kg / 個** (水没時は 0.43 L を排水する) |
| STEP | 1 ソリッド / 27 面。STL は trimesh で watertight (inspect_mesh の「97 open edges」は円錐座の重複頂点による誤報) |

## 役割 (2026-09-05 人間指摘への対応)

> **2026-09-05 (2 回目)**: 「バランスが悪そう、浮子を箱と同じ高さに」「箱は防水なので浸かってよい、転倒しない
> ことが優先」→ 浮子軸を z −83 → −40 → **0** (デッキ上面 = 箱底) へ。`spec/parent_hydrostatics.py` で箱・デッキ・
> ヨークの排水量込みの喫水線と GM を掃引し、**縦揺れ GM が最大 (201 mm) になる高さ**を採った。喫水線 z −2.7
> (箱底がほぼ水面)、ペネトレータ (z 65) は水面上 68。`.scad` は `waterline_z` を転記して「ペネトレータ ≥ 30 上」を assert。

浮子は**完全な円筒ではなく、胴を挟んで固定できない**。代わりに**中心の空洞に紐を通し、
両端で受ける**。本部品はその「両端の受け」で、旧 `parent_float_cradle` (アーチで抱える方式) を置き換える。

- `parent_deck` の側壁 HP40 座 (Y ±70, z −25) に **アダプタ板 (56 角、t18、M5 ×4 ざぐり付き)** でボルト留め。
- アダプタ板をそのまま浮子の端まで延ばした**フィン** (縦板 t18、高さ −28..+68 = 96、箱の胴体の脇に沿う) の端に**柱** (t32) を立てる。
  フィンと柱の上端は同じ高さ (グローバル +43、蓋の張出し z 80 より下)。
  **2026-09-05 変更**: 当初の水平の腕 (t10) は FEA でたわみ 1.9〜3.9 mm (許容 1.0) だったため、
  ねじれ・曲げとも一桁硬い縦板に変えた。フィンにはデッキ側壁の紐穴 Ø8 と同軸の通し穴を開け、紐穴を塞がない。
- 柱の内面に **45° の円錐座** (口径 70 → 底径 30、深さ 20)。浮子の先細り端 (仮 Ø40 端面) が
  深さ 15 で座のリムに当たり**自動調心**する。浮力・横力はこの座で受ける (胴には触れない)。
- 柱の軸上に**紐穴 Ø10**、その下に**紐留め穴 Ø8 ×2**。紐は「前ヨーク → 浮子の空洞 → 後ヨーク」と
  通し、外面で結んで張る。張ると浮子の端面リムが円錐座 (深さ 15 の位置) に引き寄せられる (中央にあるとき片側余裕 2)。

## 座標系

ローカル原点 = デッキ側壁 HP40 座の中心 (座面上)。X = 外向き (側壁法線)、Y = 浮子の端の方向
(hand で反転)、Z = 上。デッキ上面 = ローカル z +25。
アセンブリ: 右舷後 `a` を `translate([108, 70, −25])`、右舷前 `b` を `translate([108, −70, −25])`、
左舷は `b` / `a` を `rotate 180°` して `translate([−108, ±70, −25])`。

## 主要寸法

| 変数 | 値 | 意味 |
|---|---|---|
| `fender_d / fender_len / taper_len / end_d / bore_d` | 100 / 300 / 40 / 40 / 15 | 浮子 (**仮値**、`parent_fender` と二重定義) |
| `hp_y / hp_z / deck_lip_z0` | 70 / −25 / −50 | デッキ側壁 HP40 座 (二重定義) |
| `ad_pad / ad_t / cb_d / cb_depth` | 56 / 18 / 9.5 / 8 | アダプタ板 = フィンの厚さ、キャップ頭ざぐり。t14 は紐張力でフィンが Z 軸回りに曲がりたわみ 1.4 → 18 |
| `fin_gap` | 2 | フィン外面と浮子の隙間 (浮子はフィンの高さ帯にあるので最大半径で逃がす) |
| `z_f_global / waterline_z / pen_margin` | 0 / −2.7 / 30 | 浮子軸の高さ (デッキ上面基準) / 喫水線 (`spec/parent_hydrostatics.py` から転記) / ペネトレータ (z 65) の水面上最小高さ → assert |
| `x_f / z_f / fin_top` (導出) | 70 / +25 / +68 | 浮子軸 (グローバル X ±178, z 0、浮子 −50..+50) / フィン・柱の上端 (グローバル +43) |
| `end_slack` | 2 | 浮子が中央にあるときの端面リムと円錐座の片側余裕 |
| `y_p0 / y_p1` (導出) | 67 / 99 | 柱の内面 / 外面 Y (グローバル 137 / 169)。リム当たりは Y 150 |
| `post_t / seat_od / seat_depth / seat_id / post_margin` | 32 / 70 / 20 / 30 / 8 | 柱と円錐座。柱は X 0..113、z −18..+68 (グローバル −43..+43)。t26 は紐張力でたわみ 1.4 → 32 |
| `rope_d / tie_d / tie_dx / tie_dz` | 10 / 8 / ±35 / −30 | 紐穴 / 紐留め穴 (円錐座との肉 7。±30 だと 3.4 で FEA のメッシュ検査に掛かった) |

## インタフェース

| 相手 | 内容 |
|---|---|
| `parent_deck` | 側壁外面 HP40 (X ±108, Y ±70, z −25)。**M5 ×25** ×4 (ざぐり 8 + 板 10 + インサート 8)。ボルト頭 (Y ±20, z ±20) は外側から六角レンチでアクセス可。フィンはデッキ上面より 3 上・側壁下端より 3 下に出るが、デッキ板の縁 (X 108) の外側なので干渉なし。フィンは側壁面に沿って Y 118 (側壁端) まで接し、その先は空中 |
| `parent_fender` | 円錐座 (Ø70/Ø30, 45°) に端面 Ø40 のリムで座る。紐 Ø5〜8 を空洞 Ø15 に通す |
| デッキ側壁の紐穴 (Y ±108, z −35) | ローカル (38, −10)。フィンに同軸の Ø8 通し穴 (ざぐりから 2 以上離す assert) |

## 干渉チェック (`.scad` 冒頭の assert)

- 浮子の胴がフィン外面 (X=18) から 2 以上離れる / **ペネトレータ軸・蓋の合わせ目が喫水線より 30 以上上** / フィン上端が蓋の張出し (z 80) より下 / 浮子上端が蓋より下
- 円錐座の底径が空洞より大きく端面径より小さい (端面のリムで座る) / 端面が座に入る深さ (15) が座の深さ内で、
  片側余裕 (2) より大きい
- ざぐりがアダプタ板に収まる / ざぐり下の板厚 ≥ 5 / フィンの紐通し穴がざぐり・縁・柱から離れる
- 紐留め穴が円錐座・柱の縁から離れる / 浮子の先細り (半角) が円錐座 45° より緩い (リムだけで当たる) / 250³ 枠

実際に止めたもの (2026-09-05): ざぐり Ø10 が座 50 角からはみ出す → アダプタ板を 56 角・ざぐり Ø9.5 に。
`mirror([0,0,0])` (零ベクトル) で非マニフォールド → `if` で分岐。assert で捕まらなかったもの: 浮子とアダプタ板厚の
干渉 (側壁面 X=0 だけ見ていた) → アセンブリの接触検査で貫通 7.6 として発覚、浮子軸を +14 外へ。

## 荷重ケースと強度

| ケース | 荷重 | 係数 | 入力 | 受け |
|---|---|---|---|---|
| L1 定常 | 浮子の浮力の半分 13 N | 1 | 円錐座 | HP40 |
| **L2 持ち上げ** | 65 N 上向き | 5 | 円錐座 | HP40 ×4 ボルト |
| L2r 紐の張力 | 100 N (−Y、柱を浮子側へ) | — | 紐穴 | HP40 |
| L3 横当て | 50 N (+X、柱下端) | 3 | 柱下端 | HP40 |

手計算: フィン (h56 × t18、片持ち 40) は浮力のねじれより**紐の張力 (柱を Y に引く) によるフィンの Z 軸回り曲げ**が
支配的 (荷重点が板面から 70 外)。I = 56×18³/12 = 27k mm⁴。旧・水平腕 (t10) は FEA で 1.9〜3.9 mm と柔らかく不合格、
フィン t14 + 柱 t26 でも紐ケースが 1.4 mm → t18 / t32 で合格。

### FEA 結果 (`fea/study.json` → `topopt fea --voxel 1.8`, 出力 `fea/out/`, 2026-09-05 最終形: 浮子軸 z 0、フィン t18 高 96、柱 t32)

PETG 直交異方性カード、build 軸 X (横倒し印刷)、74,230 要素、メッシュ解像度 PASS (最薄部 7.2 mm に 4 要素)。
支持 = HP40 アダプタ面 (X 0..3、Y ±28、z ±28)。荷重領域: 円錐座 (Ø76 の円筒領域 Y 66..88)、紐穴、柱下端帯。

| ケース | 荷重 | 最大変位 | von Mises 最大 | 安全率 (最悪 / p99.5) | 判定 |
|---|---|---|---|---|---|
| L2 浮子の押上げ | 65 N 上向き (円錐座) + 自重 ×5 | 0.17 mm | 2.7 MPa | 14 / 62 | ✅ |
| L2r 紐の張力 | 100 N (−Y、紐穴) + 自重 ×3 | 0.55 mm | 4.5 MPa | 7.5 / 30 | ✅ |
| L3 横当て | 50 N (+X、柱下端) + 自重 ×3 | 0.16 mm | 1.9 MPa | 18 / 65 | ✅ |

経緯: 水平腕 t10 → 1.9 / 3.9 / 3.1 mm ❌ → フィン t14 (h56) + 柱 t26 → 0.47 / 1.41 / 0.53 ❌ (紐ケース) →
柱 t32 のみ → 1.36 (効かない: 支配は柱ではなくフィンの Z 軸回り曲げ) → フィン t18 → 0.83 ✅ →
浮子を z 0 に上げてフィンを柱上端 (+68) まで高くした深い梁 → **0.55** ✅。
ホットスポットはフィンと柱の付け根 (Y 68, z −16) とアダプタの上縁 (Y 29, z 29)。**Fusion でこの 2 箇所に R3 以上の
フィレット**を付けること。紐の張力 100 N は手で強く張った想定で、実際はそれ以下。

## 印刷 (X1-Carbon)

- **フィンの内面 (X=0 面) をベッドに、+X を上** (横倒し)。フィンは 18 mm 厚の板 (127 × 96) が寝た状態、柱がベッドから立つ壁 (高さ 113)。
  円錐座は 45° で自己支持、紐穴・留め穴は水平穴、ざぐりは垂直穴。**サポート不要**: `topopt overhang` (X 上に回した STL)
  で要サポート面積 **0.8 %** (水平穴の天井のみ)。`topopt print` の「overhang FAIL」はベッド接触面を含む値。
- 主引張: フィンのねじれ・曲げ (Y 方向)・紐の張力 (Y) → 層面内 (層は YZ 面)。
- 材料 PETG (屋外は ASA)。壁 4 本 / インフィル 25 %。a ×2 + b ×2 (スライサでミラーしても可)。

## 部品外の考慮

- **紐の掛け方**: 一方の柱の外面から紐穴 → 円錐座 → 浮子の空洞 → 反対の円錐座 → 紐穴 → 外面で
  留め穴 ×2 に絡めて結ぶ。**張力で浮子を座に引き寄せる**のが固定の本体なので、伸びない紐 (ポリエステル) を使う。
- 浮子の先細り形状が仮値と違えば `seat_od / seat_depth / end_d` を実測に合わせる。端が平ら (先細り無し) なら
  円錐座を浅い皿 (座ぐり) に変える。
- 浮子は端だけで支持されるので、**胴の中央は自由**。波で胴が上下に叩かれる荷重は座のリムに集中する。
  硬い浮子 (EVA) なら問題ないが、柔らかい空気入りなら座に当て板 (ゴム) を入れる。
- 喫水線は `spec/parent_hydrostatics.py` (質量 3.14 kg、箱・デッキ・ヨークの排水量込み) で **z −2.7** = 箱底がほぼ水面。
  浮子は 50 % 強が水中、フィン・柱の下半分とデッキ・キールは水中 (PETG なので問題なし)。箱は防水 (IP65) で人間了承済み。
- 復原力 (同スクリプト): 横揺れ GM 639 mm / 縦揺れ GM 201 mm。浮子軸を −40 に下げると縦揺れ 107、+50 (箱中央) に上げると 169。
- 浮子軸 ±178、全幅 456。浮子 (−50..+50) が箱の下半分と同じ高さにあり、見た目の重心も低い。

## 要確認

1. **浮子の実測** (全長 / 最大径 / 空洞径 / 先細りの長さと端面径 / 質量) → 上の仮値を置換して再ビルド
2. 紐の太さ (紐穴 Ø10、空洞 Ø15 仮)
3. 円錐座と浮子端の当たり (実物で座らせて確認。リム当たりが線接触なら座の角度を浮子の先細り角に合わせる)

## parts/parent/interior/printed/parent_lipo_tray/parent_lipo_tray.md

> 2026-09-26: 親機サービス改訂では、6面保持の [parent_lipo_retainer](../parent_lipo_retainer/parent_lipo_retainer.md) を使用。以下は旧ベルクロトレイの比較資料。

# parent_lipo_tray — 親機 LiPo ブリッジトレイ (P-MAIN 上・最上段)

**2026-08-28 新規 (同日、床置き案から上固定案へ変更 — 人間指示「交換しやすく」)。**
親機内装で「宙に浮いた表示」だった LiPo を実体化する部品。P-MAIN の取付穴 4 点に
M3 オス-メス スペーサ 25 mm (`hex_spacer` m3_mf25) を立て、その上に架ける。
**LiPo は最上段**: 蓋を開け、ベルクロ帯を外せば真上に抜ける。

## 役割・主要寸法

| 項目 | 値 |
|---|---|
| 区分 | 親機 / 内装 / 3Dプリント |
| 収容物 | `lipo_3s_2200_zeee` (102 × 34 × 23、リード -X 端) |
| 外形 | 111 × 45 × 17 (ベイ) + 東西レール 8 × 12 × 88.5 (穴 4 点を結ぶ) |
| 原点 | MAIN 南西取付穴 (プレート (6.5,10) = 箱 (20,23.5)) の直上、トレイ下面 |
| 高さ (箱底外面基準) | トレイ下面 **51.4** = MAIN 基板上面 26.4 + スペーサ 25 / LiPo 下面 54.4 / 上面 **77.4** (蓋パッキン面 90.9、余裕 13.5) |
| MAIN との隙間 | 最高部品 (18.49 → z 44.9) とトレイ下面 6.5 |
| 固定 | M3×6 なべ ×4 → スペーサ (穴 Ø3.4、座 Ø9)。スペーサのオス側は MAIN 穴を通ってプレートの M3 ボス下穴へ (MAIN の固定ねじを兼ねる) |
| 拘束 | 4 側壁 (h14) + 床 + ベルクロ帯 ×2 (幅 20、x=24/79)。上は開放 |
| 水抜き | 床 Ø4 ×2 |
| ベイ位置 | プレート座標 (2.5,15)–(113.5,60)。セル (7,20.5)–(109,54.5)。MAIN の南縁 (SD, y<15) と北縁 (ボタン/LED, y>60) を塞がない |

## インタフェース (二重定義の台帳)

| 変数 | 相手 | 値 |
|---|---|---|
| `lipo_l/w/h` | `lipo_3s_2200_zeee.md` / `child_vtray_batt_box.scad` | 102 / 34 / 23 (商品仕様、実測待ち) |
| `hole_px/py` | `PARENT_MAIN.kicad_pcb` (穴 (4.5,4.5)–(107.5,80)) / `parent_plate.main_h` | 103 × 75.5 |
| `spacer_l` | `hex_spacer` m3_mf25 | 25 |
| `plate_top_z`, `main_top_comp` | `parent_plate` (13.8+5) / `parent_main.md` | 18.8 / 18.49 |
| `LIPO_TRAY`, `LIPO_SPACER` | `spec/parent_interior_layout.py` | (7,20.5,102,34) / 25 |

## 干渉チェック

`.scad` の assert: ベイ中心 = 穴スパン中心 / ベイ壁が穴の座に掛からない / トレイ下面と
MAIN 最高部品 ≥ 3 / LiPo 上面と蓋 ≥ 10 (手掛かり) / 帯スロット ↔ 端壁・水抜き穴 /
レール高さ ≥ 10 (強度) / レールがベイに接続。`spec/parent_interior_layout.py`
`check_lipo_bridge` でも同じ高さとベイ帯 (SD/ボタン回避) を検査。ビルド watertight。

## 荷重ケースと強度

| ケース | 荷重 | 結果 (`quick_strength.py`, PETG, 面内) |
|---|---|---|
| レール (北穴への片持ち近似): LiPo 170 g の半分 × 落下 10 | 8.5 N、L 75、8 × **12** | 応力 3.3 MPa (許容 19)、たわみ 0.59 mm — PASS (t3 では 37 mm で不可 → 高さ 12 に決定) |
| ベイ床 | 17 N 分布、106 × 40 × t3 | 応力 0.48 MPa、たわみ 0.02 mm — PASS |

実際は両端支持 (南北 2 穴) なので片持ち近似より硬い。FEA は省略 (閉形式で SF > 5)。

## 印刷指示

- **向き: 平置き (+Z 上)**。オーバーハング無し、**サポート不要**
- **材料: PETG**、**インフィル 30%**、ウォール 3 周
- X1C 監査: `topopt print` PASS (下記ビルド記録)

## 部品外の考慮

- **電池交換**: 蓋 (ビス 4 本) を開ける → ベルクロ帯 2 本を外す → LiPo を真上に抜く。
  プレートも基板も触らない。上面から蓋まで 13.5 mm の指掛かり
- リードは西端壁の切欠き (幅 20) から出て、プレート西縁沿いに北へ下り P-PWR `J_BAT`
  (プレート (8.8,157.1)、開口 -X 向き、z≈25) へ。トレイ (z 54) からの落差 ≈30 + 北へ ≈120
  → **リード実長 ≥150 mm が要る (現物実測待ち)**。足りなければ LiPo を 180° 逆向き
  (リード東) にして東縁経由も可 (帯・切欠きは対称)
- 東西レールは MAIN の東西縁の真上 (z 51.4) を通る。MAIN 南東角の `J_TETH1` (x≈109.5)
  の直上に東レールの座がある → **テザー線の抜き差し方向 (上向きなら干渉) を要確認**
- LiPo の膨らみ: 幅方向 +3/+3、上は開放。**きつく囲わない**
- **密閉容器内で充電しない**
- 重心: 最重量物が z≈66 (最上段)。箱内装のみの重心は床置き案と ±1 mm しか変わらず、
  復元力はマスト下端バラストで確保する方針 (2026-08-28 判断)

## 要確認

- [ ] LiPo 現物実測 (102×34×23 ±2) → `end_pad` / `side_pad`
- [ ] リード実長 (≥150 mm 必要) と向き
- [ ] `J_TETH1` の抜き差し方向と東レール座の干渉
- [ ] MAIN 最高部品 18.49 の実測 (トレイ下面との隙間 6.5)
- [ ] `part_index.py lock` は人間未確認 (`--confirmed` なし)

## parts/parent/interior/printed/parent_plate/parent_plate.md

# parent_plate — 親機 防水ボックス内 マウントプレート (183×203 t5, 2バリアント)

> **2026-08-28 追記 (浮き部品の実体化・箱図面反映):** LiPo は P-MAIN 上のブリッジトレイ
> `parent_lipo_tray` (MAIN 穴に M3 MF25 スペーサ) で上固定。南側ピンは**タカチ図面 DXF の
> タッピングボス実位置** (65,25)/(105,25) → プレート (51.5,11.5)/(91.5,11.5) に確定。
> LCD 下穴はボス直上を避けて (72,192)/(110,192)。p2: カメラマウント足穴 44 角 + 脚 Ø7.5、
> `vp_off` 53→54。プレート高さは元の z=13.8 (ボス 10 仮) のまま。

**2026-08-28 全面改版。** 旧設計 (175×180、モジュール単位の仮置き) は
アーキテクチャ変更 (UI 基板廃止・RS485/BUCK/RTC の P-MAIN/P-PWR への統合) で
無効になったため破棄した。現行は KiCad 実基板 3 枚 + SPRESENSE 拡張 + LiPo を
載せる。配置の根拠と検証は `spec/parent_interior_layout.py`
(プレビュー: `spec/_work/images/parent_layout_p1.png` / `_p2.png`)。

## 役割

タカチ **BCAS212310G** (選定案・人間確認待ち → `parts/parent/exterior/cots/bcas212310g/`)
の内部ボス (z≈10) に載る、全内装モジュールの取付基準面。
BMP2123Z (純正鉄プレート 183×203) 互換の外形・穴ピッチ。

## バリアント

| 接尾辞 | pattern | 内容 |
|---|---|---|
| `p1` | 1 | 親機カメラ = DJI Osmo Action 6 (外付け)。TX はプレート直付け (121,77) |
| `p2` | 2 | 親機カメラ = Pi Zero 2W + GS カメラ内蔵。底面ビューポート開口 Ø36 (+X53)、カメラマウント下穴、Pi Zero ボス追加。TX は (117,127) で Pi Zero 上に z+30 高架 |

## 配置 (プレート左下原点, 単位 mm)

| モジュール | p1 | p2 | 取付 |
|---|---|---|---|
| P-MAIN 112×88 | (2,2) | 同左 | M3 ボス ×4 (kicad 穴 103×75.5 を y 反転変換)。ボタン/LED/DS3231 縁が北、microSD 縁が南 |
| P-PWR 100×84 | (2,95) | 同左 | M3 ボス ×4 (90×74) |
| SPRESENSE 拡張 68.6×53.5 | (121,2) 90°回転 | 同左 | M3 ボス ×4 (inset 3.5 仮) |
| TX_improved 74×50 | (121,77) 90°回転 | (117,127) 90°回転 | M3 ボス ×4 (42×66)。p2 は 30mm スタンドオフで高架 |
| LiPo 102×34 | **MAIN 上のブリッジトレイ** (`parent_lipo_tray`, セル (7,20.5)-(109,54.5)、下面 z=51.4) | 同左 | MAIN 穴 103×75.5 に `hex_spacer` m3_mf25 ×4 (MAIN 固定ねじ兼用) |
| Pi Zero 2W 30×65 | — | (127,135) 90°回転 | M2.5 ボス ×4 (23×58) |
| GS カメラ | — | ビューポート中心 (144.5,101.5) | `parent_cam_mount` 足穴 M3 下穴 ×4 **44 角** (`cam_hole_sq`)。カメラ自体の穴 34 角はマウント側 |
| LCD ブラケット | 北縁 (30..115, 183..201) | 同左 | M3 下穴 ×2 (仮)。ブラケット別部品・未設計 |

## 主要寸法・箱との取合い

- 外形 183 × 203 × t5、コーナー 45° カット 8 (**仮値**)
- 固定: 北側 2 箇所 M4 皿ねじ (ピッチ 160×180 の北列 → 箱コーナー M4 インサート、
  蓋を開けて上からアクセス可) + 南側位置決めピン Ø3.2 ×2 (`pin_pos` = (51.5,11.5)/(91.5,11.5)
  = 箱の M4 タッピングボス (65,25)/(105,25) 下穴 Ø3.4、**図面 DXF 実座標**。基板の下に
  隠れてよい)。**南側コーナーインサートは基板下で工具が届かないためねじ固定しない**
  (組立順: プレート挿入 → 基板をボスに締結)
- 高さ: プレート下面 z = 3.8 + 10 (ボス高さ仮) = **13.8**、上面 18.8 (箱底外面基準)
- 箱のタッピングボス 10 個のうち 6 個がプレート下に来る (プレート座標 (11.5,61.5)
  (11.5,141.5) (171.5,61.5) (171.5,141.5) (131.5,11.5) (51.5/91.5/131.5,191.5))。
  `.scad` でプレートの切欠きと重ならないことを assert (LCD 下穴を (55,192)→(72,192) に
  移した実例あり)
- M3 ボス Ø7 h6 (下穴 Ø2.6 貫通 = 水抜き兼用)、Pi Zero ボス Ø6 h6 (下穴 Ø2.0)
- 結束バンドスロット 3×10 ×5 (中央通路 x116.5 / 東縁 x176)

## 干渉チェック

`.scad` 内でフィーチャ表 (`feats`) の**総当り検査** (切欠き間ウェブ ≥2、突起間 ≥0.5、
縁 ≥1.5、コーナーカットから ≥ 半径+2)。皿座グリ Ø9 を「ねじ頭の座」、p2 のカメラ
マウント脚 Ø7.5 を「突起」として表に含めている。加えて箱側タッピングボス (図面) と
プレート切欠きの重なりを検査。ビューポートはマストフランジ 70 角 +2 / 浮子開口 Ø140 の成立条件も
assert。ビルドは両バリアントとも watertight、preview 目視済み。

## 荷重ケースと強度

- 荷重: 搭載物 ≈0.85 kg (基板 3 + SPRESENSE + LiPo + ブラケット類) を
  取り回し係数 4 で 37 N 分布荷重。
- `quick_strength.py plate --a 203 --b 183 --t 5 --p 0.001` (PETG, in-plane):
  応力 0.31 MPa (許容 19) **SF≈61**、中央たわみ 0.13 mm (四辺支持)。
  実際は 4 点支持でたわみは数倍になるが 1 mm 未満の見込み。
- FEA は箱実測 → 仮値確定後に実施 (要確認に記載)。

## 印刷

- **向き: 平置き (+Z 上)**。X1C 監査 PASS (最薄部 2.93 mm、荷重は層面内 cos=0)
- **サポート: 下面の位置決めピン 2 本の直下のみ**。他は不要
- 材料 PETG / インフィル 40% / ウォール 3 周

## 部品外の考慮

- 箱壁の貫通は南壁 2 = **WetLink M10 ペネトレータ** (x=120 テザー / x=85 TD04A、軸 z=65。
  2026-08-29 モデル化) / 北壁 1 = GPS 引込み (未定)。プレート上面 z=18.8 に対して
  ペネトレータは z=65 なので当たらないが、**箱内に出るのは素の導体**なので
  端子台とサービスループの置き場がプレート上に要る (未設計)。
  引込みは壁上部 → サービスループでプレートへ降ろす。中央通路 (x≈115) と
  東縁のスロットで結束。詳細は `docs/配線・ケーブル計画.md`
- 電池は最上段 (MAIN 上のブリッジトレイ) = 毎セッションの交換動線を確保 (2026-08-28 人間判断)
- 重心の調整は箱内ではなくマスト下端バラストで行う
- microSD: P-MAIN 南縁 (上向きスロット)・SPRESENSE 拡張 (上面開放) とも上から抜き差し可
- マストクランプ M5×4 のボルト頭 (箱底内側, ±28) はプレート下の空間 (z<10) に収まる
- p2 ビューポートの視野にマストが入る (中心から約 6°)。子機マーカーの隠れは要評価

## 要確認 (これが解消するまで印刷しない)

- [ ] **箱型番の人間承認** (BCAS212310G 選定案)
- [ ] 箱実測 (または 3D STEP): **ボス高さ** (`BOSS_H=10` 仮) / タッピングボスがインサートと同高か / コーナー柱 (`corner_cut=8` 仮、図面上は余裕 ≈4.5)。インサートピッチ 160×180・タッピングボス位置は図面 DXF で確定済み
- [ ] SPRESENSE 拡張ボードの取付穴実測 (`spr_inset=3.5` 仮)
- [x] GS カメラマウント足穴 (`cam_hole_sq=44`、`parent_cam_mount.foot_sq` と二重定義) — 2026-08-28 確定
- [ ] LCD ブラケット穴 (`lcd_pos` 仮 — ブラケット設計時に確定)
- [x] LiPo トレイ (`parent_lipo_tray`)・カメラマウント (`parent_cam_mount`)・TX 高架スペーサ (`hex_spacer` m3_mf25) — 2026-08-28 設計済み
- [ ] LCD ブラケット (`parent_lcd_bracket`) — 未設計
- [ ] 箱仮値確定後に FEA (`topopt fea`)

## インタフェース (二重定義の台帳)

| 変数 | 相手 | 値 |
|---|---|---|
| `px, py, m4_pitch_*, corner_cut` | `bcas212310g.md` / 箱実測 | 183, 203, 160×180, 8 |
| `pin_pos` (← `box_tap_south`), `pin_d` | `bcas212310g.scad tap_pos` (図面 DXF) | (65,25)/(105,25) 箱座標 → (51.5,11.5)/(91.5,11.5)、Ø3.2 (下穴 3.4) |
| `main_h` (MAIN 穴) | `parent_lipo_tray.hole_px/py` | 103 × 75.5 |
| `cam_hole_sq, cam_pilot, cam_leg_d, vp_off` | `parent_cam_mount.scad` (`foot_sq/foot_d/leg_d`) / `spec VP_OFF` | 44, 2.6, 7.5, 54 |
| `lcd_pos` | `parent_lcd_bracket` (未設計) | (72,192)/(110,192) — 箱ボス直上を避けた位置 |
| `main_pos` ほか配置座標 | `spec/parent_interior_layout.py` | 完全一致させること |
| 基板穴ピッチ | `hardware/pcb/*/[*.kicad_pcb]` | MAIN 103×75.5 / PWR 90×74 / TX 42×66 (回転後) |
| `vp_off=53` | `parent_mast_clamp` (フランジ70角) / `parent_float_segment` (ID140) | 成立域 52..55 |
