AquaBeacon/mechanical/assemblies/parent_direct/parts/DESIGN_NOTES.md

# 設計・印刷条件の控え（自動生成）

以下は設計元の文書を転記したものです。リンク先は元フォルダ基準です。印刷条件と未検証事項を確認してください。

## parent_direct/README.md

**印刷一式:** [parts/PRINT.md](parts/PRINT.md)（STL・数量・モディファイア） · **確認画像:** [_work/images/](_work/images/)

# 親機・既存M3カメラマウント直接固定版

ユーザー確認済みの既存マウントは `parts/child/exterior/printed/dji_osmo_action6_mount_m3/camera_mount`（後面M3・40×40 mm）。旧版の底面M5マウントを参照して追加していたカメラ用90°取付台を削除した。既存マウントの後面をフレーム下面と平行に取り付け、カメラを下向きにする。残るL字取付台はTD04A専用。

## 印刷する部品：4種類・5個

|ファイル|個数|内容|
|---|---:|---|
|parent_direct_frame.stl|1|浮子耳、カメラ取付桟、4個のスペーサーを一体化したフレーム|
|parent_light_bar.stl|2|既存の丸角・肉抜き上側バー|
|parent_td_support.stl|1|小型化したTD04A専用支持部|
|parent_light_jaw.stl|1|TD04Aブラケット押さえ板|

カメラ保持マウントは既存品を使用し、印刷ZIPに含めない。上側バーとTD押さえ板は前版から再利用できる。旧 `parent_light_frame` と `parent_light_carrier` は今回のフレームとTD支持部に置き換える。

## カメラ取付

- 後面のM3・40×40 mmを使用。フレーム側穴中心はX=-60/-20、Y=-20/+20。
- 接触面Z=-24。フレーム下面Z=-12から12 mmのスペーサーを一体化し、既存マウントの後方張り出しを箱から逃がす。曲げアダプターではない。
- 各スペーサーにM3熱圧入インサート用φ4.2×深さ7 mmの止まり下穴。M3インサート4個を別途用意する。外径・長さは購入インサート仕様に合わせて調整。
- M3×10ねじ4本を初期値とする。既存マウントの座ぐり後の厚さは4.4 mm、ねじ入り量は約5.6 mm。インサートの有効ねじ長・底付きと、実際のねじ頭が既存座ぐりに収まることを確認する。
- 既存カメラマウントに対し、回転[-90,0,0]、移動[-40,-40,-55.45]。既存後面Y=-31.45がZ=-24になり、カメラ前方+Yが世界座標−Z（下向き）になる。
- マウントの張り出し上端は箱底より約3 mm下。既存後面の穴とスペーサーの軸は一致。新規カメラ用縦板はない。

## その他の金具

- 箱クランプ：M5全ねじ150 mm×4、M5ナット・外径10 mm座金各8、14×24×2 mmゴムパッド×4。
- TD支持部とフレーム：M5×30の90°皿ねじ×2、M5ナット・座金各2。箱を載せる前に組み付ける。
- TD押さえ板：M4×30×2、M4ナット・座金各2。
- 浮子は一体耳のφ10.5を内包する屋根形穴へ紐／金具で接続。
- TD04Aの付属金属ブラケット寸法（仮値：幅24、厚さ2 mm）は実物確認が必要。胴体を挟む旧円筒クランプは使用しない。

## 印刷・検証

フィレットと45°屋根穴を継承。STLは印刷向き、ベッド面Z=0に調整済み。X1 Carbon／PETG／0.20 mm／壁6／上下6層／インフィル40%／ブリム5 mm、自動通常サポートON、しきい値30°、ブリッジにサポートを生成しない設定で全4種類スライス成功。全てSupportセクション0、警告なし。5個の合計見積もり約397.9 g・13時間3分（個別プレートの合計、ブリム込み）。

閉じた単一STLとSTEP単一ソリッドを確認。13部品の構造干渉検査で、印刷部品に関係する体積干渉0件（0.1 mm³超を検出）。金具、工具、ケーブル、ゴム・簡略蓋は干渉検査外。実物適合・強度・締付力・水密・浮力と実機印刷は未検証。M3インサート・ねじは簡略組立表示に含めていない。

`parent_direct_prints.zip`：印刷STL・数量表。`parent_direct_X1C_3mf.zip`：検証済み設定付き3MF。各3MFは部品1個なので、上側バーだけ2回印刷する。`parent_direct_structure.step`：既存マウント等を含む構造組立、金具・ゴム・簡略蓋は除外。

再生成：`python spec/prepare_parent_direct.py`、新規2種類を`build.ps1`でビルド、`python spec/build_parent_direct.py`。検証は`PARENT_VERIFY_NAME=parent_direct`でFreeCADから`spec/verify_parent_open.py`、スライスは`PARENT_SLICE_NAME=parent_direct`で`python spec/slice_parent_light.py`。

## parts/child/exterior/printed/dji_osmo_action6_mount_m3/README.md

# DJI Action 6：背面M3直接固定版

2026-09-17改訂。背板の空き部分へM3・40×40 mmの4穴を設けた一体部品。別体アダプターは不要。ユーザー指定によりインフィル15%に変更。

子機frontへの取付状態

## 印刷するファイル

- [印刷用3MF](../../../../../print_jobs/dji_osmo_action6_mount_m3/camera_mount_x1c_petg.3mf)：1個、印刷向き・15%インフィル設定済み。
- [STL](camera_mount.stl)／[STEP](camera_mount.step)／[SCAD](camera_mount.scad)：部品座標、底面Z=0。
- [機体座標のSTEP](assembly.step)：直接固定する位置の部品1個。筐体やカメラは含まない。
- [印刷手順](../../../../../print_jobs/dji_osmo_action6_mount_m3/PRINT.md)。以前のアダプターは不要。旧データはarchive_adapter_obsoleteに退避。

## 形状変更

- 背面のM3通し穴4個：40×40 mm、設計クリアランス径Ø3.45以上。横穴の上部に45°屋根を設ける。
- 背板厚8 mm。カメラ側から深さ3.6 mm・径6.8 mm以上の座ぐり。M3キャップボルトの頭（径5.5、高さ3 mm）を背板表面より0.6 mm内側に収める。
- 背面リブをx=±38へ移動し、厚さ6 mmにする。筐体の取付板だけでなく補強リブも避ける。背面中央の底板張り出しを幅62 mmで除去し、背板が筐体に直接当たる。
- アダプター接続に使っていた底面M5穴4個とその工具逃げは廃止。追加のM5締結部品は不要。
- 下側M3ボルトに六角レンチを通すため、前側支持壁に径5 mmの屋根付き工具穴2個を追加。
- 前側支持壁と接触座の**+Y方向8 mm移動を維持**。カメラの3枚爪、ねじ軸、背面接触位置、前側座の高さ・幅・奥行は維持。
- 背板と前壁の屋根付き肉抜き窓、底板の側面スロット、底板幅100 mmを維持。根元・穴周りの材料を残す。

## マウント規格とねじ

[CHILD-SIMPLE-M3-40x40 Rev.1](https://github.com/AquaBeacon/docs/blob/main/child_simple_mount_interface.md)に対応。筐体の既存穴は変更しない。

機体座標の取付面中心 `(0,82,100)`、穴中心 `(±20,82,80/120)`。部品のローカル穴中心はx=±20、z=20/60。機体へは `[0,113.45,60]` の移動で配置する。

- **M3×20 キャップボルト4本**（頭径5.5・高さ3 mm）、外付けM3ナット4個、ナット側ワッシャ4枚。
- 頭側は座ぐりへ直接着座。頭側ワッシャは入れない。大径頭・つまみねじはこの座ぐりの対象外。
- 座ぐり後の保持部厚4.4＋筐体厚8＋ワッシャ約0.5＋ナット約2.4 mm。20 mmねじで先端は約4.7 mm突出する計算。実物のねじ・ナットで確認。
- カメラを載せる前に本体を固定する。下2本は前壁の工具穴から2.5 mm六角レンチを通す。工具軸の許容包絡はØ3 mm。大径ドライバービットは使わない。
- カメラ側の既存ねじ・ナットは別途そのまま使用。

## 印刷見積もり

X1 Carbon、0.4 mm、Generic PETG、Textured PEI。0.20 mm、壁6周、上下6層、**Gyroid 15%**、外側ブリム3 mm、**サポートなし**。底板を下に印刷する。

|対象|同じ15%設定の推定時間|材料（ブリム込み）|
|---|---:|---:|
|元の指定STL|3時間16分|110.5 g|
|背面直接固定版|3時間05分|101.0 g|

同じ設定で材料約8.6%、時間約5.2%（約10分）削減。ソリッド体積は144.20→124.78 cm³、約13.5%減。前のアダプター付き2部品セットは廃止し、この1個だけを印刷する。

## 確認範囲

- OpenSCADレンダリング、閉メッシュ、単一連結、有効な単一STEPソリッド、STEP/STLの外形・体積照合を実施。
- 子機frontとの交差体積0 mm³。M3の4穴同軸・貫通、ねじ頭の収まり、前方Ø3 mm工具、後方Ø10 mmナット工具をCAD確認。
- Bambu Studioのスライス成功、警告なし。3MF破損検査、G-code内のサポート経路0。実機印刷は未実施。小さな横穴とナット座の垂れ・バリは印刷後に確認。
- 肉抜きと15%インフィルは軽量化設定であり、強度向上を実証したものではない。変更後の強度解析・荷重試験は未実施。
- 「手前」はカメラ正面の+Yと解釈し、前座はy=24〜30へ移動済み。古いケース仮包絡の前端y=22.95とは一致しないため、再印刷後の接触確認は必要。ユーザーの試作結果を反映した位置変更であり、カメラとの再適合は未検証。

元のTO_printingのSTLは変更していない。再生成は `spec/build_camera_mount_m3.py`、`spec/export_camera_mount_m3.py`、`spec/slice_camera_mount_m3.py`。確認記録はmesh_checks.json、cad_checks.json、印刷フォルダのcomparison.json。
