AquaBeacon/mechanical/assemblies/parent_integrated/parts/DESIGN_NOTES.md

# 設計・印刷条件の控え（自動生成）

以下は設計元の文書を転記したものです。リンク先は元フォルダ基準です。印刷条件と未検証事項を確認してください。

## parent_integrated/README.md

**印刷一式:** [parts/PRINT.md](parts/PRINT.md)（STL・数量・モディファイア） · **確認画像:** [_work/images/](_work/images/)

# 親機 内装・外装の統合設計

2026-09-10。**実測前の統合試作。完成・印刷確定ではない。**

外装は `parent_bottom_sensors`（最下部の下向きOsmoとTD04A、
一体フィン、浮き2個の紐接続）、内装は外付けカメラ用の
`parent_interior_p1` を採用。箱底中心を基準に198部品を配置した。
箱モデルは最新外装の取付穴を反映した表示モデルを使う。

- Fusion用：`parent_integrated.step`
- 全体表示：`_work/images/overview.png` / `parent_integrated_view.scad`
- 箱まわり拡大：`_work/images/closeup.png` / `closeup_view.scad`（蓋包絡を非表示）
- 配置の生成元：`../../spec/integrate_parent.py`
- 元モデルの記録：`sources.json`

## 今回の修正

電源基板PWRの裏面リード8.15 mmに対し元の支持高さは6 mmだった。
統合用 `parent_plate_integrated` ではPWRボスだけ9.5 mmにし、
PWR下面をZ=28.3へ3.5 mm上げた。プレート上面Z=18.8との
リード最小隙間は1.35 mm。MAIN、電池、TX、SPRESENSEの高さは継承する。
既存のP1/P2アセンブリは履歴・比較用に残る。

## 検証と未解決

統合STEP/STLは198部品、欠落0。STEP読み戻し検査は198部品・配置不一致0
（既存検査の外形許容0.5 mm）。全体図と箱まわり拡大図をレンダーして目視確認した。
統合用プレートは閉じたメッシュ・STEP 1ソリッドで、STEP/STL外形差0.00 mm。

内装・箱・ペネトレータ14部品のサンプル検査で浮き0。
PWRとプレートの干渉指摘は解消。SPRESENSEとプレートの干渉指摘は残る。
SPRESENSEの簡易モデルには穴がなく、下面リードも大きな直方体のため、
これを実物の干渉と断定してボスを削らない。実測した穴・下面形状に置換して再検査する。

全外装に対する内装の交差候補4組も別検査した。テザーペネトレータと
電池トレイ南東レールに内部サンプルが検出された。
追加50000点のトレイ側検査でも36点を検出し、範囲は概ね
X=14.10..19.67、Y=−95.91..−95.12、Z=60.08..63.30 mm。
これは既存接触検査の「表面距離0.3 mm未満なら内部判定」という条件では拾えなかった。
保存済みペネトレータSTLは内側Y=−95（箱座標20）まであり、
旧資料の14.5 mmとは一致しない。実物突出量と工具空間を確認して、
トレイ端の逃げまたは引込位置を決める。プラグ切断は前提にしない。

`_work/logs/interior_contacts.log/json` と `cross_contacts.json` が結果。
サンプル検査は厳密な全体積ブーリアン検査ではない。
TXのメッシュが閉じていないため、TX内部を判定する方向の検査は省略される。
ねじ山接触は内装検査の除外対象。固定ねじ全数、配線、LCD、実形状の蓋、
パッキン、工具の動線が未反映なので、干渉確認全体は未完了。

## 後で行う実測（数値はmm）

|優先|測るもの・基準|現状値|反映先／目的|
|---|---|---|---|
|1|箱の内床からプレート支持面までの高さ、支持面同士の高低差|10 仮|箱モデルとP1配置のplate Z、統合再生成|
|1|箱コーナー柱、プレート角逃げ、固定穴ピッチ・深さ|角逃げ8、ピッチ160×180|parent_plateのcorner_cut、m4_pitch_*、pin_h|
|1|SPRESENSE取付穴XY・径、下面突出範囲、高さ|inset3.5、下面3 仮|parent_plateのspr_h、spresense_loggerの実形状|
|1|南壁の実厚、テザー/TD引込の内側突出量とナット外形|資料14.5／STL20で不一致|wetlink参照形状、トレイ逃げ、端子台・工具空間|
|1|PWRの実装後リード突出とコネクタ・スイッチ操作空間|モデル8.15|parent_plate_integratedのpwr_boss_h（現状9.5）|
|2|蓋裏最下部とパッキンの実位置、蓋開閉・着脱空間|資料90.9／上面包絡96.3..100.3|実蓋モデル、電池交換とGPS支持部との取合い|
|2|電池本体、端子、リード出口、ベルクロ厚|102×34×23|parent_lipo_tray、電池包絡、交換経路|
|2|TD04A胴径・長さ・段差・ケーブル出口|26×55 仮|parent_bottom_sensors.scadのtd_d、td_len、clamp_gap|
|2|カメラケース外形、固定部、レンズ位置・画角|95×45.9×75 仮|ケース包絡、下部支持板、TDとの視野離隔|
|2|GPS・各ケーブルのプラグ最大径、外径、必要曲げ半径|未確定|GPS引込、端子台、ストレインリリーフ、配線経路|
|3|完成品質量、浮き寸法・紐長さ、浮きの可動範囲|未確定|浮力・復原性・実機試験。紐浮きを剛体として扱わない|

## 実測後に仕上げる順番

1. 箱、SPRESENSE、引込部を実測形状へ更新し、残る2箇所の干渉を解消する。
2. 内装固定ねじ、LCD支持、端子台、GPS引込、配線固定を追加する。
3. 蓋の着脱、電池の上抜き、基板スイッチ操作、工具アクセスを確認する。
4. 内装・外装の検査を再実行し、荷重条件に基づく強度と印刷姿勢を確定する。
5. 確定した内装を含めて印刷リストを更新する。旧外装ZIPに新プレートは含まれない。

## 再生成

```powershell
./build.ps1 parts/parent/interior/printed/parent_plate_integrated
python spec/integrate_parent.py --check
./build.ps1 -Assemblies assemblies/parent_integrated
```

現時点の`--check`は未解決干渉により終了コード1が正しい。
元P1の箱座標から最新外装の箱座標へ変換するので、旧外装内にある内装コピーに依存しない。
PWRの移動量はビルド済みプレートの高さ差から導出する。元プレートの最高ボスを
別途変更した場合はこの導出方法も見直す。回転の異なる箱座標系には明示的に停止する。

## TD04A 外径5 mmの経路追加（2026-09-10）

[配線設計](../../parts/common/cabling/parent_td04a_cable/parent_td04a_cable.md)を追加。
統合モデルはケーブルを含む199部品、STEP読み戻し配置不一致0。
`_work/images/td04a_route.png`の赤線が外部配線。約739.5 mm、仮の中心線曲げ半径30 mm、
周囲1 mmの静的空間余裕を検査済み。内装の従来の未解決干渉は残る。
固定具、コネクタのØ8穴通過、箱内の導体配線は未確定。
旧項目の「ケーブル外径未確定」はTD04Aに限り5 mmで確定し、他ケーブルは未確定のまま。

## parts/child/exterior/printed/dji_osmo_action6_mount/dji_osmo_action6_mount.md

# DJI osmo Action 6固定部品

2026-09-17：指定STLを元に、前側支持+8 mm・肉抜き・背板へのM3直接固定穴を設けた別版を作成。[M3直接固定版と15%インフィル印刷データ](../dji_osmo_action6_mount_m3/README.md)。アダプター案は廃止。このフォルダの旧モデルは保存。

## 現行：背面板＋前側支持台（2026-09-09）

ユーザー指定に従いFDM印刷用の一体部品へ改訂。ケース後側の底面支持台と側面囲いを廃止し、ケース背面に沿う板で支える。前側の2つの支持面は残した。ケースへの穴あけや接着は想定せず、純正ねじ用の最小限の3枚爪受けを保持して脱落を防ぐ。

固定の考え方：ケース背面を背面板側へ合わせ、前側底面を前側支持面へ合わせて姿勢を決め、純正ねじで底面爪を締結する。板だけでケースを締め付ける機構ではない。穴の遊びと接触部の隙間があるため、実物に合わせたシム調整と保持確認が必要。

- 背面板：幅84 mm、厚8 mm、ケース名目底面から48 mm上まで。
- 背面補強：厚8 mmの三角リブ2本、後方への張り出し18 mm。リブはケースと反対側。
- ベース：厚8 mm。全体外形104×79.45×84.5 mm。
- 前側支持：幅84 mm・厚8 mmの壁に、16×6 mmの接触座2か所。
- ケース後方の底面を持ち上げる支持台は撤去。純正ねじを通す爪以外で底面中央を囲わない。
- 横向きねじ穴：径5.2 mmの円形部分＋上向き45度屋根。上端の垂れを減らすFDM向け形状。印刷中の旧試験片は円穴なので、屋根部のみ差がある。
- 金属ナット座は頂点が上を向く六角穴。樹脂にM5ねじ山を印刷しない。

## 印刷の出発条件

X1 Carbon・0.4 mmノズルを想定。STLはそのままZ=0の広いベース面をベッドに置く。背面板と三角リブを上に積み上げる向き。

| 設定 | 試作の出発値 |
|---|---|
| 材料 | PETG（乾燥条件・温度は使用フィラメント設定に従う） |
| 積層ピッチ | 0.20 mm |
| 壁数 | 6周 |
| 上下面 | 各6層 |
| インフィル | Gyroid 40% |
| ブリム | 外側5〜8 mmを目安に反り対策 |
| サポート | 大きな棚形状はない。スライス後に爪穴・ナット座の天井を確認し、必要箇所だけ追加 |

薄い中央爪が壁で充填されること、穴内部に除去不能なサポートが入らないことをスライサーで確認。FDM積層方向による爪・背面板根元の強度低下を含む実荷重検証は未実施。上記は保証済みの量産条件ではない。印刷時間・材料消費量は未スライスのため未算出。

## 実測・仮値

実測：ケース爪厚3 mm、内側間隔3 mm、穴径5 mm、本体底面→穴中心12.5 mm。受け側中央爪2.7 mm、溝3.3 mm、穴5.2 mmは試作公差。

ケース外形95×45.9×75 mmは図・旧公称値からの仮包絡。背面の凹凸、ヒンジ突出量、実際の爪穴から背面までの前後距離は未確定。現在はねじ軸Y=0に対して背面をY=-22.95 mmと仮置きしている。**ケース背面位置がこの値と違えば板位置を変更する必要がある。** `case_d` と板位置の導出値に依存する。

背面板には0.5 mm、前側支持には0.3 mmの調整余裕を置いている。この隙間が残った状態では回転を拘束できない。硬質シムと必要最小限の傷防止層で実物に合わせる。厚い柔らかいゴムだけで姿勢を決めない。背面が開閉蓋であるため、板を押し当てた時の蓋のたわみ・シール・ヒンジへの影響を実物で確認する。形状未測定なので干渉なしとは判定していない。

純正ねじ露出長17〜18 mmは写真推定。M5普通ナットを仮定した二面幅8.2 mm・深さ4.2 mmの座を設けるが、ねじピッチ・実かかり長・ナット脱落止めは未確定。純正ねじと適合ナットは別部品。

## 組み付けと着脱

1. ケースを背面板と前側支持へ合わせ、シムでガタを調整する。強く締めてケースを変形させない。
2. 爪の穴を合わせ、純正ねじと適合ナットで締結する。
3. 前後・左右へ小さく力をかけ、接触が離れず姿勢が変わらないことを確認する。
4. 取り外しは純正ねじを抜いてケースを前上方へ外す想定。背面蓋の開閉はケースを外して行う。

左右方向の遊び・逆向き荷重での支持面離脱は、この形状だけでゼロにできたとは扱わない。保持力不足なら予圧押さえを追加検討する。現時点で「絶対にずれない」保証はない。

## 検証と機体への影響

OpenSCADでSTL生成成功。trimeshで単一連結・閉じたメッシュを確認。体積144.20 cm³。下向き45度超の面積はベッド接触面を除き41.69 mm²で、局所確認が必要（この数値はスライス検証ではない）。STEPを独立して読み戻し、有効な1ソリッドであることを確認。STEP/STLの外形差0.00 mm、体積差約0.013%。前後プレビューを確認。

FreeCAD変換時に中間再計算とユーザー設定保存の警告が出たため、出力STEPを別プロセスで再読込して検証した。結果は `step_check.json`。

背面のリブにより奥行が54→79.45 mmへ増加。既存ブリッジとの干渉・装着可否は未検証。取り付け穴22×32 mmピッチは維持したが、機体アセンブリへ自動置換していない。レンズ位置、画角、保持荷重、着脱後の姿勢再現性も確認待ち。

旧版は `archive/integrated_bottom_support/`。印刷中の試験片は `archive/osmo_case_fit/`。関連部品はこのフォルダに集約してある。

## parts/parent/exterior/printed/parent_deck/parent_deck.md

# parent_deck — 親機 デッキ (防水ボックス台 + 浮子ヨーク取付 + 下面ハードポイント)

| 項目 | 値 |
|---|---|
| 区分 | 親機 / 外装 / 3Dプリント |
| 設計ソース | `parent_deck.scad` |
| 個数 | 1 |
| 外形 | 216 × 236 × 60 mm (デッキ上面 z=0、キール座面 z=−60) |
| 体積 (中実) | 839 cm³ → PETG 壁 4 + インフィル 25 % で **約 0.43 kg** |
| STEP | 1 ソリッド / 219 面 / watertight |

## 役割 (2026-09-04 人間決定の親機外装構成)

- **浮子 2 個・支柱 (マスト) 無し・カメラは Osmo Action 6 + 純正防水ケース (ジグは後日)**。
- タカチ **BCAS212310G** を上に載せ、箱底コーナーの**外部取付穴 Ø4.2 ×4** (図面 E-E、
  箱中心から (±96, ±106)) に上から M4 を通し、デッキの **M4 熱圧入インサート** ×4 で受ける。
- 左右 (±X) 側壁の外面に **HP40 座 ×2 / 側** (Y ±70, z −25) → `parent_float_yoke` (浮子の端受け、
  2026-09-05 にアーチ式クレードルから置換) を M5 ×4 で締結。ヨークを外せば同じ座に別のアクセサリを付けられる (拡張性)。
- 下面中央の**キール** (壁 2 枚 + 端壁 2 枚 + 座板 3 枚) の底面 (z −60) に **HP40 座 ×3**
  (Y −70 / 0 / +70) → 南 = TD04A ソケット (`xdcr_socket_parent`, 開口下向き)、
  北 = **Osmo 固定ジグ用 (予約)**、中央 = 予備。
- 紐穴: 側壁両端 **Ø8 ×4** (X 貫通、Y ±108, z −35) = 吊り索 / 浮子の紐の予備の結び点 (ヨークのフィンに同軸の Ø8 穴があり塞がれない)。
- **南縁ケーブル切欠き** (X −30..25、深さ 8) = 南壁ペネトレータ ×2 (箱 x=85/120 →
  デッキ X −20/+15) から降りるケーブルをデッキ下へ回す。キール南端壁の **Ø8 フェアリード ×2**
  (X ±9, z −30) でテザー / TD04A ケーブルの張力止め (結束バンド or 結び目)。

## 座標系

箱中心 = 原点、デッキ上面 (= 箱底外面) z=0、+Y = 北 (箱の北壁側)。
**箱座標 (x, y) → デッキ (x − 105, y − 115)**。

## 主要寸法

| 変数 | 値 | 意味 |
|---|---|---|
| `plate_x / plate_y / plate_t` | 216 / 236 / 6 | デッキ板 (箱カバー外形 210 × 230 + 3/側) |
| `ear_x / ear_y / ear_pilot_d / ear_pilot_h` | ±96 / ±106 / 5.6 / 9 | 箱固定 M4 インサート下穴 (上から) |
| `lip_t / lip_h` | 17 / 50 | 側壁 (X ±91..±108)。厚 17 = HP40 下穴 9 + 箱取付穴が板内に収まる下限 16 + 1 |
| `hp_lip_y / hp_lip_z` | [−70, 70] / −25 | 側壁 HP40 座中心 (座面 X = ±108) |
| `rope_d / rope_y / rope_z` | 8 / ±108 / −35 | 側壁 紐穴 |
| `win_w / win_h / win_z0` | 36 / 14 / −44 | 側壁の軽量窓 (45° 屋根、X 貫通) |
| `keel_wall_t / keel_wall_x / keel_y / keel_wall_z` | 8 / 16 / ±105 / −50 | キール壁 X ±16..±24 |
| `pad_t / pad_w / hp_keel_y` | 10 / 50 / [−70, 0, 70] | キール座板 (座面 z −60) |
| `end_wall_t / fair_d / fair_x / fair_z` | 6 / 8 / ±9 / −30 | キール端壁とフェアリード |
| `notch_x0 / notch_x1 / notch_d` | −30 / 25 / 8 | 南縁ケーブル切欠き |

HP40 の定数 (`hp_pitch 40 / hp_ins_d 6.4 / hp_ins_h 8 / hp_pad 50 / hp_cable_d 14`) は
`scad/lib/hardpoint.scad` と二重定義 (`use` なので定数が見えない)。

## インタフェース

| 相手 | 内容 |
|---|---|
| `bcas212310g` | 箱底コーナー Ø4.2 ×4 @ (±96, ±106) ← M4 ×16 (上から) → デッキ M4 インサート。箱の胴体 (約 204 × 224) がデッキ板に載る。**ねじの向き (上から / 下から) は現物で要確認** (図面 E-E では 6 厚の足に Ø4.2) |
| `parent_float_yoke` ×4 | 側壁外面 HP40 ×2 / 側 (Y ±70, z −25)。M5 ×25 ×4 / 座。ヨークのアダプタ板 (56 角) は座より 3 大きく、デッキ上面より 3 上・側壁下端より 3 下に出る (デッキ板の縁の外側なので干渉なし) |
| `xdcr_socket_parent` | キール南座 (0, −70, −60)。M5 ×4 @ ±20 (ソケット `hole_p 40` = HP40) |
| Osmo 固定ジグ (未設計) | キール北座 (0, +70, −60)。HP40 アダプタ板 (t6, M5 バカ穴 Ø5.4 ×4, 中央 Ø14) を持たせること |
| `wetlink_penetrator_m10` ×2 | 南壁 (デッキ Y −115) x=−20/+15、軸 z 65、頭は箱外 Y −137..−115 → デッキ南縁 (−118) の外で干渉なし。ケーブルは南縁切欠きから下へ |

## 干渉チェック (`.scad` 冒頭の assert)

- 箱の取付穴 Ø5.6 が側壁の板厚 (X 91..108) に収まる / インサート下穴が側壁を突き抜けない
- 側壁の YZ 面フィーチャ表 (HP40 下穴 ×8 + 中央穴 ×2 + 紐穴 ×2 + 箱取付穴 ×2) を**総当り**で離隔 ≥ 3
- 軽量窓が HP40 座・側壁下端・デッキ板 (45° 屋根の頂点) から離れる
- キール座の HP40 下穴 Ø6.4 @ ±20 が壁 (X ±16..±24) の真下にある (母材) / 座同士 ≥ 座 + 10 / 端壁と重ならない
- フェアリード穴がキール壁・端壁高さに収まる
- 南縁切欠きが箱の胴体壁の下を 3 以上残す / ペネトレータ直下を覆う / 側壁に掛からない
- 250³ 造形枠

実際に止めたもの (2026-09-04): 箱取付穴が側壁板厚 14 に収まらない → 17 へ /
キール座下穴が壁の真下に無い → 壁 X 17 → 16 / キール座が端壁に掛かる → 壁半長 100 → 105。

## 荷重ケースと強度

| ケース | 荷重 | 係数 | 入力 | 受け |
|---|---|---|---|---|
| L1 定常 | 箱+内装 1.05 kg + アクセサリ 0.7 kg | 1 | デッキ板上面 | 側壁 HP40 (ヨーク) |
| **L2 取り回し** | 同上 2.45 kg → **120 N** | 5 | デッキ板上面 | 側壁 HP40 ×8 ボルト (15 N/本) |
| L2b テザー引き | 50 N (−Y) | 3 | キール南端フェアリード | 側壁 |
| L3 落下 | アクセサリ 0.4 kg → 40 N | 10 | キール南座 | 側壁 |

`quick_strength.py` (PETG, 面内): 板 (236 × 94 × 6, 100 N) 0.33 MPa / 0.04 mm ✅、
側壁を片持ち梁 (L236 b14 h50, 175 N 先端) と見ても 7.1 MPa ✅ (たわみ 3.0 mm は片持ち仮定の
過大評価。実際は両ヨーク座 (Y ±70) で支持されるので梁長は 140)、
M5 インサート引抜き 0.25 MPa ✅、M4 インサート (箱固定) ✅。

### FEA 結果 (`fea/study.json` → `topopt fea --voxel 2.16`, 出力 `fea/out/`, 2026-09-04)

PETG 直交異方性カード (`petg_generic_fff_orthotropic_v1`)、build 軸 Z、87,124 要素、
メッシュ解像度 PASS (最薄部 8.6 mm に 4 要素)。支持 = 両側壁の HP40 座面 (X ±108 帯)。

| ケース | 荷重 | 最大変位 | von Mises 最大 | 安全率 (最悪 / p99.5) | 判定 |
|---|---|---|---|---|---|
| L2 持ち上げ | 120 N 下向き (デッキ上面) + 自重 ×5 | 0.15 mm | 1.2 MPa | 30 / 47 | ✅ |
| L3 落下 | 40 N (キール南座) + 自重 ×10 | 0.24 mm | 2.2 MPa | 17 / 37 | ✅ |
| L2b テザー引き | 50 N (−Y, 南端フェアリード) + 自重 ×3 | 0.07 mm | 0.7 MPa | 51 / 133 | ✅ |

ホットスポットは箱取付インサート穴の縁 (±96, ±101) と南端壁の根元 — いずれも SF ≥ 17。
たわみは全ケース 0.25 mm 以下 (許容 1.0)。**律速は強度ではなく浮力** (上記 部品外の考慮)。

## 印刷 (X1-Carbon)

- **上下反転** (デッキ上面をベッドに)。側壁・キール壁・座がベッドから立つ。`topopt overhang`
  (反転 STL): **要サポート面積 3.6 %** = キール座板 (t10) の壁間 32 mm ブリッジ ×3 と側壁窓の
  45° 屋根。**サポート不要** (X1C のブリッジで可。気になれば座板下のみサポート)。
- 主引張 (側壁の曲げ = Y 方向、板の曲げ = XY 面内) は層面内。`topopt print --keep-flat Z` の
  「load vs layers FAIL」は `--load-axis 0,0,1` を与えたためで、実荷重方向 (Y) では PASS。
- 材料 PETG (屋外・水・紫外線なら ASA)。壁 4 本 / インフィル 25 % (ジャイロイド) / 上下 5 層。
- HP40 のインサート下穴 (Ø6.4) は反転印刷で座板側が上面になるので、印刷後にそのまま熱圧入できる。
  側壁の横穴 (Ø6.4 / Ø8 / Ø14) は水平穴 = 上面がやや垂れる。Ø6.4 は熱圧入時に馴染む。
- 反り対策: 216 × 236 の全面ベッド接触。ブリム 5 mm、ベッド中央。

## 部品外の考慮

- **ケーブル**: 南壁ペネトレータ (箱外 z 65) → 南縁切欠き → キール南端フェアリード →
  南座ソケットの底穴 Ø9 / HP40 中央 Ø14。TD04A の 3P プラグは通らないので**箱内で切って
  端子台**に落とす (`wetlink_penetrator_m10.md`)。テザーは南端フェアリードで**張力止め**を
  してからペネトレータへ (シール部に引張をかけない)。
- **喫水**: 浮子軸 z 0・総質量 3.14 kg で喫水線は **z ≈ −2.7** (`spec/parent_hydrostatics.py`) = デッキ板がほぼ全部水中、
  箱底が水面。側壁・キール・TD04A 面 (−104) は水中。デッキは密閉インフィルの PETG なので 0.84 L の浮力体でもある。
  水抜き穴 (キール座の Ø14、側壁窓) から水が入っても抜けるので問題なし。
- **水抜き**: デッキ板上面は箱が覆う。側壁の軽量窓とキール壁間の通路は水が抜ける。
  キール座の中央 Ø14 はケーブル穴兼水抜き。
- **GPS アンテナ**: 箱の蓋の上 (最頂部)。デッキは関与しない。北壁の引込みグランドは未定。
- **工具アクセス**: 箱固定 M4 は蓋を開けて上から (箱内側から) 締める前提。ヨークの M5 は
  ヨーク外面のざぐりから六角レンチで締める (デッキ側はインサート)。
- **持ち上げ**: 側壁の紐穴 ×4 に吊り索を通す。箱の蓋やペネトレータを掴まないこと。

## 要確認

1. **箱の外部取付穴の使い方** (ねじを箱内側から下へ通せるか / 穴が貫通か)。現物で確認 →
   通せなければ下から M4 + 箱内ナット (要防水) に変更
2. 浮子実測 → ヨーク・喫水の再計算 (デッキ自体は変わらない)
3. Osmo 固定ジグ (北座) の設計: 座面 (z −60) が喫水線 (≈ −3) より下なので、ケースをそのまま座に付ければ水中
4. ペネトレータ頭 (箱外 22 mm) とケーブルの曲げ半径 (切欠きまでの落差 65 mm)

## parts/parent/exterior/printed/parent_fin_cartridge/parent_fin_cartridge.md

# parent_fin_cartridge

2026-09-10 下向きカメラ・TD04A版。数量1。寸法・印刷姿勢は assemblies/parent_bottom_sensors/print_checks.json。

共通パラメータ: scad/lib/parent_bottom_sensors.scad。要確認: TD04A胴径 td_d=26、胴長 td_len=55、締付隙間 clamp_gap=0.5 は実測未確定。既存カメラケース包絡も実測未確定。試作形状であり実荷重・防水性は未評価。

## parts/parent/exterior/printed/parent_rope_keel_adapter/parent_rope_keel_adapter.md

# parent_rope_keel_adapter

浮きを紐で接続する親機用。デッキ中央下面HP40から32角の印刷支柱へ接続する。浮きには接続しない。

外形60×60×48 mm。上板8、支柱差込み40、角穴32.5。M5通し穴4個（40角ピッチ）、横M6通し穴1個。M5×16×4はデッキ既存インサートへ、横M6×60はナットへ締結する。角を開いた4面の支持部により、M5ねじ頭・座金・工具の空間を確保。

`part="print"` が印刷姿勢。上板のデッキ接触面を下にして印刷し、ソケットを上へ向ける。X1 Carbon、0.4 mm、0.20 mm、PETGの既存試作設定を使用。実負荷での強度・疲労・嵌合試験は未実施。

## parts/parent/exterior/printed/parent_sensor_carrier/parent_sensor_carrier.md

# parent_sensor_carrier

2026-09-10 下向きカメラ・TD04A版。数量1。寸法・印刷姿勢は assemblies/parent_bottom_sensors/print_checks.json。

共通パラメータ: scad/lib/parent_bottom_sensors.scad。要確認: TD04A胴径 td_d=26、胴長 td_len=55、締付隙間 clamp_gap=0.5 は実測未確定。既存カメラケース包絡も実測未確定。試作形状であり実荷重・防水性は未評価。

## parts/parent/exterior/printed/parent_spar_ballast_body/parent_spar_ballast_body.md

# parent_spar_ballast_body

親機ねじ固定外装。数量 1。寸法 [120.0, 120.0, 51.0] mm（印刷姿勢）。

設計ソースは `scad/lib/parent_spar_bolted.scad` の `ballast_body`。
印刷用STLは `print_jobs/parent_spar_bolted/parent_spar_ballast_body.stl`。部品フォルダのSTL/STEPは組立座標。

締結表・材料・組立順・未検証条件は `assemblies/parent_spar_bolted/README.md` を参照。
閉じた単一メッシュ・250 mm枠・5 mmブリムを含む保守的なベッド配置を機械確認。
実荷重の安全率・疲労・水密性は未評価。

## parts/parent/exterior/printed/parent_spar_ballast_lid/parent_spar_ballast_lid.md

# parent_spar_ballast_lid

親機ねじ固定外装。数量 1。寸法 [120.0, 120.0, 6.0] mm（印刷姿勢）。

設計ソースは `scad/lib/parent_spar_bolted.scad` の `ballast_lid`。
印刷用STLは `print_jobs/parent_spar_bolted/parent_spar_ballast_lid.stl`。部品フォルダのSTL/STEPは組立座標。

締結表・材料・組立順・未検証条件は `assemblies/parent_spar_bolted/README.md` を参照。
閉じた単一メッシュ・250 mm枠・5 mmブリムを含む保守的なベッド配置を機械確認。
実荷重の安全率・疲労・水密性は未評価。

## parts/parent/exterior/printed/parent_spar_beam_lower/parent_spar_beam_lower.md

# parent_spar_beam_lower

親機ねじ固定外装。数量 1。寸法 [180.0, 32.0, 32.0] mm（印刷姿勢）。

設計ソースは `scad/lib/parent_spar_bolted.scad` の `beam_lower`。
印刷用STLは `print_jobs/parent_spar_bolted/parent_spar_beam_lower.stl`。部品フォルダのSTL/STEPは組立座標。

締結表・材料・組立順・未検証条件は `assemblies/parent_spar_bolted/README.md` を参照。
閉じた単一メッシュ・250 mm枠・5 mmブリムを含む保守的なベッド配置を機械確認。
実荷重の安全率・疲労・水密性は未評価。

## parts/parent/exterior/printed/parent_spar_beam_upper/parent_spar_beam_upper.md

# parent_spar_beam_upper

親機ねじ固定外装。数量 1。寸法 [107.0, 32.0, 32.0] mm（印刷姿勢）。

設計ソースは `scad/lib/parent_spar_bolted.scad` の `beam_upper`。
印刷用STLは `print_jobs/parent_spar_bolted/parent_spar_beam_upper.stl`。部品フォルダのSTL/STEPは組立座標。

締結表・材料・組立順・未検証条件は `assemblies/parent_spar_bolted/README.md` を参照。
閉じた単一メッシュ・250 mm枠・5 mmブリムを含む保守的なベッド配置を機械確認。
実荷重の安全率・疲労・水密性は未評価。

## parts/parent/exterior/printed/parent_spar_coupler_half/parent_spar_coupler_half.md

# parent_spar_coupler_half

親機ねじ固定外装。数量 2。寸法 [54.0, 64.0, 26.75] mm（印刷姿勢）。

設計ソースは `scad/lib/parent_spar_bolted.scad` の `coupler_half`。
印刷用STLは `print_jobs/parent_spar_bolted/parent_spar_coupler_half.stl`。部品フォルダのSTL/STEPは組立座標。

締結表・材料・組立順・未検証条件は `assemblies/parent_spar_bolted/README.md` を参照。
閉じた単一メッシュ・250 mm枠・5 mmブリムを含む保守的なベッド配置を機械確認。
実荷重の安全率・疲労・水密性は未評価。

## parts/parent/exterior/printed/parent_spar_gps_bridge/parent_spar_gps_bridge.md

# parent_spar_gps_bridge

親機ねじ固定外装。数量 1。寸法 [183.0, 96.0, 100.0] mm（印刷姿勢）。

設計ソースは `scad/lib/parent_spar_bolted.scad` の `gps_bridge`。
印刷用STLは `print_jobs/parent_spar_bolted/parent_spar_gps_bridge.stl`。部品フォルダのSTL/STEPは組立座標。

締結表・材料・組立順・未検証条件は `assemblies/parent_spar_bolted/README.md` を参照。
閉じた単一メッシュ・250 mm枠・5 mmブリムを含む保守的なベッド配置を機械確認。
実荷重の安全率・疲労・水密性は未評価。

## parts/parent/exterior/printed/parent_td04a_clamp_body/parent_td04a_clamp_body.md

# parent_td04a_clamp_body

2026-09-10 下向きカメラ・TD04A版。数量1。寸法・印刷姿勢は assemblies/parent_bottom_sensors/print_checks.json。

共通パラメータ: scad/lib/parent_bottom_sensors.scad。要確認: TD04A胴径 td_d=26、胴長 td_len=55、締付隙間 clamp_gap=0.5 は実測未確定。既存カメラケース包絡も実測未確定。試作形状であり実荷重・防水性は未評価。

## parts/parent/exterior/printed/parent_td04a_clamp_cap/parent_td04a_clamp_cap.md

# parent_td04a_clamp_cap

2026-09-10 下向きカメラ・TD04A版。数量1。寸法・印刷姿勢は assemblies/parent_bottom_sensors/print_checks.json。

共通パラメータ: scad/lib/parent_bottom_sensors.scad。要確認: TD04A胴径 td_d=26、胴長 td_len=55、締付隙間 clamp_gap=0.5 は実測未確定。既存カメラケース包絡も実測未確定。試作形状であり実荷重・防水性は未評価。

## parts/parent/interior/printed/parent_lipo_tray/parent_lipo_tray.md

> 2026-09-26: 親機サービス改訂では、6面保持の [parent_lipo_retainer](../parent_lipo_retainer/parent_lipo_retainer.md) を使用。以下は旧ベルクロトレイの比較資料。

# parent_lipo_tray — 親機 LiPo ブリッジトレイ (P-MAIN 上・最上段)

**2026-08-28 新規 (同日、床置き案から上固定案へ変更 — 人間指示「交換しやすく」)。**
親機内装で「宙に浮いた表示」だった LiPo を実体化する部品。P-MAIN の取付穴 4 点に
M3 オス-メス スペーサ 25 mm (`hex_spacer` m3_mf25) を立て、その上に架ける。
**LiPo は最上段**: 蓋を開け、ベルクロ帯を外せば真上に抜ける。

## 役割・主要寸法

| 項目 | 値 |
|---|---|
| 区分 | 親機 / 内装 / 3Dプリント |
| 収容物 | `lipo_3s_2200_zeee` (102 × 34 × 23、リード -X 端) |
| 外形 | 111 × 45 × 17 (ベイ) + 東西レール 8 × 12 × 88.5 (穴 4 点を結ぶ) |
| 原点 | MAIN 南西取付穴 (プレート (6.5,10) = 箱 (20,23.5)) の直上、トレイ下面 |
| 高さ (箱底外面基準) | トレイ下面 **51.4** = MAIN 基板上面 26.4 + スペーサ 25 / LiPo 下面 54.4 / 上面 **77.4** (蓋パッキン面 90.9、余裕 13.5) |
| MAIN との隙間 | 最高部品 (18.49 → z 44.9) とトレイ下面 6.5 |
| 固定 | M3×6 なべ ×4 → スペーサ (穴 Ø3.4、座 Ø9)。スペーサのオス側は MAIN 穴を通ってプレートの M3 ボス下穴へ (MAIN の固定ねじを兼ねる) |
| 拘束 | 4 側壁 (h14) + 床 + ベルクロ帯 ×2 (幅 20、x=24/79)。上は開放 |
| 水抜き | 床 Ø4 ×2 |
| ベイ位置 | プレート座標 (2.5,15)–(113.5,60)。セル (7,20.5)–(109,54.5)。MAIN の南縁 (SD, y<15) と北縁 (ボタン/LED, y>60) を塞がない |

## インタフェース (二重定義の台帳)

| 変数 | 相手 | 値 |
|---|---|---|
| `lipo_l/w/h` | `lipo_3s_2200_zeee.md` / `child_vtray_batt_box.scad` | 102 / 34 / 23 (商品仕様、実測待ち) |
| `hole_px/py` | `PARENT_MAIN.kicad_pcb` (穴 (4.5,4.5)–(107.5,80)) / `parent_plate.main_h` | 103 × 75.5 |
| `spacer_l` | `hex_spacer` m3_mf25 | 25 |
| `plate_top_z`, `main_top_comp` | `parent_plate` (13.8+5) / `parent_main.md` | 18.8 / 18.49 |
| `LIPO_TRAY`, `LIPO_SPACER` | `spec/parent_interior_layout.py` | (7,20.5,102,34) / 25 |

## 干渉チェック

`.scad` の assert: ベイ中心 = 穴スパン中心 / ベイ壁が穴の座に掛からない / トレイ下面と
MAIN 最高部品 ≥ 3 / LiPo 上面と蓋 ≥ 10 (手掛かり) / 帯スロット ↔ 端壁・水抜き穴 /
レール高さ ≥ 10 (強度) / レールがベイに接続。`spec/parent_interior_layout.py`
`check_lipo_bridge` でも同じ高さとベイ帯 (SD/ボタン回避) を検査。ビルド watertight。

## 荷重ケースと強度

| ケース | 荷重 | 結果 (`quick_strength.py`, PETG, 面内) |
|---|---|---|
| レール (北穴への片持ち近似): LiPo 170 g の半分 × 落下 10 | 8.5 N、L 75、8 × **12** | 応力 3.3 MPa (許容 19)、たわみ 0.59 mm — PASS (t3 では 37 mm で不可 → 高さ 12 に決定) |
| ベイ床 | 17 N 分布、106 × 40 × t3 | 応力 0.48 MPa、たわみ 0.02 mm — PASS |

実際は両端支持 (南北 2 穴) なので片持ち近似より硬い。FEA は省略 (閉形式で SF > 5)。

## 印刷指示

- **向き: 平置き (+Z 上)**。オーバーハング無し、**サポート不要**
- **材料: PETG**、**インフィル 30%**、ウォール 3 周
- X1C 監査: `topopt print` PASS (下記ビルド記録)

## 部品外の考慮

- **電池交換**: 蓋 (ビス 4 本) を開ける → ベルクロ帯 2 本を外す → LiPo を真上に抜く。
  プレートも基板も触らない。上面から蓋まで 13.5 mm の指掛かり
- リードは西端壁の切欠き (幅 20) から出て、プレート西縁沿いに北へ下り P-PWR `J_BAT`
  (プレート (8.8,157.1)、開口 -X 向き、z≈25) へ。トレイ (z 54) からの落差 ≈30 + 北へ ≈120
  → **リード実長 ≥150 mm が要る (現物実測待ち)**。足りなければ LiPo を 180° 逆向き
  (リード東) にして東縁経由も可 (帯・切欠きは対称)
- 東西レールは MAIN の東西縁の真上 (z 51.4) を通る。MAIN 南東角の `J_TETH1` (x≈109.5)
  の直上に東レールの座がある → **テザー線の抜き差し方向 (上向きなら干渉) を要確認**
- LiPo の膨らみ: 幅方向 +3/+3、上は開放。**きつく囲わない**
- **密閉容器内で充電しない**
- 重心: 最重量物が z≈66 (最上段)。箱内装のみの重心は床置き案と ±1 mm しか変わらず、
  復元力はマスト下端バラストで確保する方針 (2026-08-28 判断)

## 要確認

- [ ] LiPo 現物実測 (102×34×23 ±2) → `end_pad` / `side_pad`
- [ ] リード実長 (≥150 mm 必要) と向き
- [ ] `J_TETH1` の抜き差し方向と東レール座の干渉
- [ ] MAIN 最高部品 18.49 の実測 (トレイ下面との隙間 6.5)
- [ ] `part_index.py lock` は人間未確認 (`--confirmed` なし)

## parts/parent/interior/printed/parent_plate_integrated/parent_plate_integrated.md

# 親機統合用プレート（実測前の試作）

既存P1プレートを継承し、PWR支持ボスだけ6→9.5 mmに延長する。
設計ソースは隣接する `parent_plate.scad` をincludeするため、両フォルダを保つ。
統合配置の正は `spec/integrate_parent.py`。旧P1/P2の既定高さ6 mmは維持する。

PWRの保存済みSTLは裏面リードが8.15 mm突出する。支持高さ9.5 mmで
プレート上面から1.35 mm離す。基板下面も24.8→28.3 mmへ移す。
ボス径7、下穴2.6、穴XYは元設計を継承。下穴は延長したボスを貫通する。
実測後は `pwr_boss_h` を更新し、部品をビルドしてから統合スクリプトを実行する。

外形183×203×20.5 mm（下向き位置決めピン6 mmを含む）。
OpenSCADレンダー済み、閉じたメッシュ。STEPは1ソリッド・88面。
STEP/STLの外形差0.00 mm、体積差0.01%未満。
統合状態でPWRとプレートのサンプル干渉指摘は解消。

## 印刷と強度

未実測の箱ボス・SPRESENSE穴を継承しているため、現時点は適合検討用。
最終印刷データへの採用・スライスは未実施。下面に位置決めピンがあるため、
単純にモデルZ=0をベッドへ置くことはできない。支持またはピン別体化を最終設計で検討する。
PETGを想定。既存プレートの荷重評価は未完了で、延長ボスを含む強度・たわみも未評価。

## 部品外の考慮

PWRを3.5 mm上げるため、スイッチ操作、配線余長、コネクタ着脱空間を実機で確認する。
ねじの締結長はボス延長と同じだけ自動で増やすものではなく、必要なねじ込み長で選ぶ。
基板固定ねじの全数モデル化、LCD、全配線は未完了。
測定表と残る干渉は `assemblies/parent_integrated/README.md` を参照。
