AquaBeacon/mechanical/assemblies/parent_interior_p2/parts/DESIGN_NOTES.md

# 設計・印刷条件の控え（自動生成）

以下は設計元の文書を転記したものです。リンク先は元フォルダ基準です。印刷条件と未検証事項を確認してください。

## parent_interior_p2/README.md

**印刷一式:** [parts/PRINT.md](parts/PRINT.md)（STL・数量・モディファイア） · **確認画像:** [_work/images/](_work/images/)

# parent_interior_p2

- [parent_interior_p2.md](parent_interior_p2.md)
- [parent_interior_p2.step](parent_interior_p2.step)
- [parent_interior_p2.stl](parent_interior_p2.stl)
- [parent_interior_p2_interior.stl](parent_interior_p2_interior.stl)
- [parent_interior_p2_view.scad](parent_interior_p2_view.scad)

構成と既存の未検証事項は上の設計説明を参照してください。

## parts/parent/interior/printed/parent_cam_mount/parent_cam_mount.md

# parent_cam_mount — GS カメラ 下向き保持フレーム (親機内装 パターン2)

**2026-08-28 新規。** `parent_interior_p2` で「宙に浮いた表示」だった GS カメラを
実体化する部品。RPi Global Shutter Camera + M12 4 mm レンズを**レンズ下向き**で
`parent_plate_p2` のビューポート開口 Ø36 上に固定する。

## 役割・主要寸法

| 項目 | 値 |
|---|---|
| 区分 | 親機 / 内装 / 3Dプリント (p2 のみ) |
| 外形 | 62 × 62 × 19.5 (脚 Ø7.5 h15 ×4 + フレーム t3 + 位置決めリム h1.5) |
| 中央開口 | 27 角 (M12 ホルダ台座 22 角 + 片側 2.5)。レンズ Ø17 も通る |
| 基板ポケット | 38.6 角 (基板 38 + 片側 0.3)、リム幅 2.5。CSI 側 (+Y) はリムを 24 幅で切欠き |
| カメラ固定 | M2.5 セルフタップ ×4、下穴 Ø2.0、ピッチ **34 (仮値)** |
| プレート固定 | M3×25 なべ ×4 (脚を貫通)、通し穴 Ø3.4、ピッチ **44 角** (`parent_plate.cam_hole_sq`)。ねじ頭座としてリム角を Ø7 で抜く |
| 位置 (箱座標) | 原点 = ビューポート中心 (**159**, 115) (箱中心 +X54)、脚下面 z=18.8 (プレート上面) |
| 高さ | カメラ基板下面 z=36.8、レンズ前面 z≈8.8 (箱床上面 3.8 から 5 mm) |

## インタフェース (二重定義の台帳)

| 変数 | 相手 | 値 |
|---|---|---|
| `foot_sq`, `foot_d`, `leg_d` ↔ `cam_hole_sq`, `cam_pilot`, `cam_leg_d` | `parent_plate.scad` | 44 / Ø3.4 / Ø7.5 ↔ 44 / Ø2.6 下穴 / Ø7.5 |
| `cam_sq`, `cam_pitch`, `base_sq`, `lens_d` | `gs_camera_m12.scad` / `.md` | 38 / 34 (仮) / 22 / 17 (仮) |
| ビューポート中心 | `parent_plate.vp_c` = (145.5, 101.5) プレート座標 (`vp_off=54`) | 箱 (159, 115) |

## 干渉チェック

`.scad` の assert: 中央開口 ↔ 台座・レンズ / カメラ穴 ↔ 中央開口の肉 ≥1.5 /
カメラ穴 ↔ 足穴 (同一対角線上) / 足穴のねじ頭座 ↔ 基板の角 / 足穴 ↔ 外縁。
プレート側は `parent_plate.scad` の総当り検査に**脚 Ø7.5** (突起扱い) が入っており、
p2 の TX ボス (121,131) と脚 (123.5,123.5) が 7.9 mm (要 7.75) で通過 — このために
`vp_off` を 53→54 にした。ビルド watertight、preview 目視済み。

## 荷重ケースと強度

カメラ ≈30 g × 落下係数 10 = 3 N をフレーム片側 (幅 35、t3、スパン 44) の梁で受ける:
応力 2.5 MPa (許容 19)、たわみ 0.6 mm — PASS (`quick_strength.py beam`, PETG 面内)。
軽荷重のため FEA 省略。

## 印刷指示

- **向き: 平置き (脚を下, +Z 上)**。脚は Ø7.5 の柱で自立、**サポート不要**
- **材料: PETG**、**インフィル 30%**、ウォール 3 周
- X1C 監査 PASS (最薄部 6.2 mm)

## 部品外の考慮

- **レンズ前面と窓の距離 5 mm (窓部品 `parent_cam_port` 未設計)**: Ø30 窓に対し
  M12 4 mm レンズの画角でケラれないかは窓部品設計時に要確認。脚高さ `leg_h` で調整できる。
- CSI フレキは +Y 側から出て Pi Zero (プレート y≥135) へ約 60 mm。リムの切欠き 24 幅を通す
- レンズ交換・ピント合わせはカメラを外して行う (M2.5 ×4)。TX 高架 (z 49.8) の下に
  手が入るかは要実機確認
- 520 nm BPF をレンズ前に入れる場合、レンズ前面〜窓の 5 mm に収まる薄型であること

## 要確認

- [ ] GS カメラ取付穴ピッチの実測/公式図面 (`cam_pitch=34` 仮 → `parent_plate` は影響なし、本部品のみ)
- [ ] M12 レンズホルダ台座寸法・レンズ全長の実測 (`base_sq`, レンズ前面高さ)
- [ ] `parent_cam_port` (窓) 設計時にレンズ〜窓距離と画角の整合
- [ ] `part_index.py lock` は人間未確認 (`--confirmed` なし)

## parts/parent/interior/printed/parent_lipo_tray/parent_lipo_tray.md

> 2026-09-26: 親機サービス改訂では、6面保持の [parent_lipo_retainer](../parent_lipo_retainer/parent_lipo_retainer.md) を使用。以下は旧ベルクロトレイの比較資料。

# parent_lipo_tray — 親機 LiPo ブリッジトレイ (P-MAIN 上・最上段)

**2026-08-28 新規 (同日、床置き案から上固定案へ変更 — 人間指示「交換しやすく」)。**
親機内装で「宙に浮いた表示」だった LiPo を実体化する部品。P-MAIN の取付穴 4 点に
M3 オス-メス スペーサ 25 mm (`hex_spacer` m3_mf25) を立て、その上に架ける。
**LiPo は最上段**: 蓋を開け、ベルクロ帯を外せば真上に抜ける。

## 役割・主要寸法

| 項目 | 値 |
|---|---|
| 区分 | 親機 / 内装 / 3Dプリント |
| 収容物 | `lipo_3s_2200_zeee` (102 × 34 × 23、リード -X 端) |
| 外形 | 111 × 45 × 17 (ベイ) + 東西レール 8 × 12 × 88.5 (穴 4 点を結ぶ) |
| 原点 | MAIN 南西取付穴 (プレート (6.5,10) = 箱 (20,23.5)) の直上、トレイ下面 |
| 高さ (箱底外面基準) | トレイ下面 **51.4** = MAIN 基板上面 26.4 + スペーサ 25 / LiPo 下面 54.4 / 上面 **77.4** (蓋パッキン面 90.9、余裕 13.5) |
| MAIN との隙間 | 最高部品 (18.49 → z 44.9) とトレイ下面 6.5 |
| 固定 | M3×6 なべ ×4 → スペーサ (穴 Ø3.4、座 Ø9)。スペーサのオス側は MAIN 穴を通ってプレートの M3 ボス下穴へ (MAIN の固定ねじを兼ねる) |
| 拘束 | 4 側壁 (h14) + 床 + ベルクロ帯 ×2 (幅 20、x=24/79)。上は開放 |
| 水抜き | 床 Ø4 ×2 |
| ベイ位置 | プレート座標 (2.5,15)–(113.5,60)。セル (7,20.5)–(109,54.5)。MAIN の南縁 (SD, y<15) と北縁 (ボタン/LED, y>60) を塞がない |

## インタフェース (二重定義の台帳)

| 変数 | 相手 | 値 |
|---|---|---|
| `lipo_l/w/h` | `lipo_3s_2200_zeee.md` / `child_vtray_batt_box.scad` | 102 / 34 / 23 (商品仕様、実測待ち) |
| `hole_px/py` | `PARENT_MAIN.kicad_pcb` (穴 (4.5,4.5)–(107.5,80)) / `parent_plate.main_h` | 103 × 75.5 |
| `spacer_l` | `hex_spacer` m3_mf25 | 25 |
| `plate_top_z`, `main_top_comp` | `parent_plate` (13.8+5) / `parent_main.md` | 18.8 / 18.49 |
| `LIPO_TRAY`, `LIPO_SPACER` | `spec/parent_interior_layout.py` | (7,20.5,102,34) / 25 |

## 干渉チェック

`.scad` の assert: ベイ中心 = 穴スパン中心 / ベイ壁が穴の座に掛からない / トレイ下面と
MAIN 最高部品 ≥ 3 / LiPo 上面と蓋 ≥ 10 (手掛かり) / 帯スロット ↔ 端壁・水抜き穴 /
レール高さ ≥ 10 (強度) / レールがベイに接続。`spec/parent_interior_layout.py`
`check_lipo_bridge` でも同じ高さとベイ帯 (SD/ボタン回避) を検査。ビルド watertight。

## 荷重ケースと強度

| ケース | 荷重 | 結果 (`quick_strength.py`, PETG, 面内) |
|---|---|---|
| レール (北穴への片持ち近似): LiPo 170 g の半分 × 落下 10 | 8.5 N、L 75、8 × **12** | 応力 3.3 MPa (許容 19)、たわみ 0.59 mm — PASS (t3 では 37 mm で不可 → 高さ 12 に決定) |
| ベイ床 | 17 N 分布、106 × 40 × t3 | 応力 0.48 MPa、たわみ 0.02 mm — PASS |

実際は両端支持 (南北 2 穴) なので片持ち近似より硬い。FEA は省略 (閉形式で SF > 5)。

## 印刷指示

- **向き: 平置き (+Z 上)**。オーバーハング無し、**サポート不要**
- **材料: PETG**、**インフィル 30%**、ウォール 3 周
- X1C 監査: `topopt print` PASS (下記ビルド記録)

## 部品外の考慮

- **電池交換**: 蓋 (ビス 4 本) を開ける → ベルクロ帯 2 本を外す → LiPo を真上に抜く。
  プレートも基板も触らない。上面から蓋まで 13.5 mm の指掛かり
- リードは西端壁の切欠き (幅 20) から出て、プレート西縁沿いに北へ下り P-PWR `J_BAT`
  (プレート (8.8,157.1)、開口 -X 向き、z≈25) へ。トレイ (z 54) からの落差 ≈30 + 北へ ≈120
  → **リード実長 ≥150 mm が要る (現物実測待ち)**。足りなければ LiPo を 180° 逆向き
  (リード東) にして東縁経由も可 (帯・切欠きは対称)
- 東西レールは MAIN の東西縁の真上 (z 51.4) を通る。MAIN 南東角の `J_TETH1` (x≈109.5)
  の直上に東レールの座がある → **テザー線の抜き差し方向 (上向きなら干渉) を要確認**
- LiPo の膨らみ: 幅方向 +3/+3、上は開放。**きつく囲わない**
- **密閉容器内で充電しない**
- 重心: 最重量物が z≈66 (最上段)。箱内装のみの重心は床置き案と ±1 mm しか変わらず、
  復元力はマスト下端バラストで確保する方針 (2026-08-28 判断)

## 要確認

- [ ] LiPo 現物実測 (102×34×23 ±2) → `end_pad` / `side_pad`
- [ ] リード実長 (≥150 mm 必要) と向き
- [ ] `J_TETH1` の抜き差し方向と東レール座の干渉
- [ ] MAIN 最高部品 18.49 の実測 (トレイ下面との隙間 6.5)
- [ ] `part_index.py lock` は人間未確認 (`--confirmed` なし)

## parts/parent/interior/printed/parent_plate/parent_plate.md

# parent_plate — 親機 防水ボックス内 マウントプレート (183×203 t5, 2バリアント)

> **2026-08-28 追記 (浮き部品の実体化・箱図面反映):** LiPo は P-MAIN 上のブリッジトレイ
> `parent_lipo_tray` (MAIN 穴に M3 MF25 スペーサ) で上固定。南側ピンは**タカチ図面 DXF の
> タッピングボス実位置** (65,25)/(105,25) → プレート (51.5,11.5)/(91.5,11.5) に確定。
> LCD 下穴はボス直上を避けて (72,192)/(110,192)。p2: カメラマウント足穴 44 角 + 脚 Ø7.5、
> `vp_off` 53→54。プレート高さは元の z=13.8 (ボス 10 仮) のまま。

**2026-08-28 全面改版。** 旧設計 (175×180、モジュール単位の仮置き) は
アーキテクチャ変更 (UI 基板廃止・RS485/BUCK/RTC の P-MAIN/P-PWR への統合) で
無効になったため破棄した。現行は KiCad 実基板 3 枚 + SPRESENSE 拡張 + LiPo を
載せる。配置の根拠と検証は `spec/parent_interior_layout.py`
(プレビュー: `spec/_work/images/parent_layout_p1.png` / `_p2.png`)。

## 役割

タカチ **BCAS212310G** (選定案・人間確認待ち → `parts/parent/exterior/cots/bcas212310g/`)
の内部ボス (z≈10) に載る、全内装モジュールの取付基準面。
BMP2123Z (純正鉄プレート 183×203) 互換の外形・穴ピッチ。

## バリアント

| 接尾辞 | pattern | 内容 |
|---|---|---|
| `p1` | 1 | 親機カメラ = DJI Osmo Action 6 (外付け)。TX はプレート直付け (121,77) |
| `p2` | 2 | 親機カメラ = Pi Zero 2W + GS カメラ内蔵。底面ビューポート開口 Ø36 (+X53)、カメラマウント下穴、Pi Zero ボス追加。TX は (117,127) で Pi Zero 上に z+30 高架 |

## 配置 (プレート左下原点, 単位 mm)

| モジュール | p1 | p2 | 取付 |
|---|---|---|---|
| P-MAIN 112×88 | (2,2) | 同左 | M3 ボス ×4 (kicad 穴 103×75.5 を y 反転変換)。ボタン/LED/DS3231 縁が北、microSD 縁が南 |
| P-PWR 100×84 | (2,95) | 同左 | M3 ボス ×4 (90×74) |
| SPRESENSE 拡張 68.6×53.5 | (121,2) 90°回転 | 同左 | M3 ボス ×4 (inset 3.5 仮) |
| TX_improved 74×50 | (121,77) 90°回転 | (117,127) 90°回転 | M3 ボス ×4 (42×66)。p2 は 30mm スタンドオフで高架 |
| LiPo 102×34 | **MAIN 上のブリッジトレイ** (`parent_lipo_tray`, セル (7,20.5)-(109,54.5)、下面 z=51.4) | 同左 | MAIN 穴 103×75.5 に `hex_spacer` m3_mf25 ×4 (MAIN 固定ねじ兼用) |
| Pi Zero 2W 30×65 | — | (127,135) 90°回転 | M2.5 ボス ×4 (23×58) |
| GS カメラ | — | ビューポート中心 (144.5,101.5) | `parent_cam_mount` 足穴 M3 下穴 ×4 **44 角** (`cam_hole_sq`)。カメラ自体の穴 34 角はマウント側 |
| LCD ブラケット | 北縁 (30..115, 183..201) | 同左 | M3 下穴 ×2 (仮)。ブラケット別部品・未設計 |

## 主要寸法・箱との取合い

- 外形 183 × 203 × t5、コーナー 45° カット 8 (**仮値**)
- 固定: 北側 2 箇所 M4 皿ねじ (ピッチ 160×180 の北列 → 箱コーナー M4 インサート、
  蓋を開けて上からアクセス可) + 南側位置決めピン Ø3.2 ×2 (`pin_pos` = (51.5,11.5)/(91.5,11.5)
  = 箱の M4 タッピングボス (65,25)/(105,25) 下穴 Ø3.4、**図面 DXF 実座標**。基板の下に
  隠れてよい)。**南側コーナーインサートは基板下で工具が届かないためねじ固定しない**
  (組立順: プレート挿入 → 基板をボスに締結)
- 高さ: プレート下面 z = 3.8 + 10 (ボス高さ仮) = **13.8**、上面 18.8 (箱底外面基準)
- 箱のタッピングボス 10 個のうち 6 個がプレート下に来る (プレート座標 (11.5,61.5)
  (11.5,141.5) (171.5,61.5) (171.5,141.5) (131.5,11.5) (51.5/91.5/131.5,191.5))。
  `.scad` でプレートの切欠きと重ならないことを assert (LCD 下穴を (55,192)→(72,192) に
  移した実例あり)
- M3 ボス Ø7 h6 (下穴 Ø2.6 貫通 = 水抜き兼用)、Pi Zero ボス Ø6 h6 (下穴 Ø2.0)
- 結束バンドスロット 3×10 ×5 (中央通路 x116.5 / 東縁 x176)

## 干渉チェック

`.scad` 内でフィーチャ表 (`feats`) の**総当り検査** (切欠き間ウェブ ≥2、突起間 ≥0.5、
縁 ≥1.5、コーナーカットから ≥ 半径+2)。皿座グリ Ø9 を「ねじ頭の座」、p2 のカメラ
マウント脚 Ø7.5 を「突起」として表に含めている。加えて箱側タッピングボス (図面) と
プレート切欠きの重なりを検査。ビューポートはマストフランジ 70 角 +2 / 浮子開口 Ø140 の成立条件も
assert。ビルドは両バリアントとも watertight、preview 目視済み。

## 荷重ケースと強度

- 荷重: 搭載物 ≈0.85 kg (基板 3 + SPRESENSE + LiPo + ブラケット類) を
  取り回し係数 4 で 37 N 分布荷重。
- `quick_strength.py plate --a 203 --b 183 --t 5 --p 0.001` (PETG, in-plane):
  応力 0.31 MPa (許容 19) **SF≈61**、中央たわみ 0.13 mm (四辺支持)。
  実際は 4 点支持でたわみは数倍になるが 1 mm 未満の見込み。
- FEA は箱実測 → 仮値確定後に実施 (要確認に記載)。

## 印刷

- **向き: 平置き (+Z 上)**。X1C 監査 PASS (最薄部 2.93 mm、荷重は層面内 cos=0)
- **サポート: 下面の位置決めピン 2 本の直下のみ**。他は不要
- 材料 PETG / インフィル 40% / ウォール 3 周

## 部品外の考慮

- 箱壁の貫通は南壁 2 = **WetLink M10 ペネトレータ** (x=120 テザー / x=85 TD04A、軸 z=65。
  2026-08-29 モデル化) / 北壁 1 = GPS 引込み (未定)。プレート上面 z=18.8 に対して
  ペネトレータは z=65 なので当たらないが、**箱内に出るのは素の導体**なので
  端子台とサービスループの置き場がプレート上に要る (未設計)。
  引込みは壁上部 → サービスループでプレートへ降ろす。中央通路 (x≈115) と
  東縁のスロットで結束。詳細は `docs/配線・ケーブル計画.md`
- 電池は最上段 (MAIN 上のブリッジトレイ) = 毎セッションの交換動線を確保 (2026-08-28 人間判断)
- 重心の調整は箱内ではなくマスト下端バラストで行う
- microSD: P-MAIN 南縁 (上向きスロット)・SPRESENSE 拡張 (上面開放) とも上から抜き差し可
- マストクランプ M5×4 のボルト頭 (箱底内側, ±28) はプレート下の空間 (z<10) に収まる
- p2 ビューポートの視野にマストが入る (中心から約 6°)。子機マーカーの隠れは要評価

## 要確認 (これが解消するまで印刷しない)

- [ ] **箱型番の人間承認** (BCAS212310G 選定案)
- [ ] 箱実測 (または 3D STEP): **ボス高さ** (`BOSS_H=10` 仮) / タッピングボスがインサートと同高か / コーナー柱 (`corner_cut=8` 仮、図面上は余裕 ≈4.5)。インサートピッチ 160×180・タッピングボス位置は図面 DXF で確定済み
- [ ] SPRESENSE 拡張ボードの取付穴実測 (`spr_inset=3.5` 仮)
- [x] GS カメラマウント足穴 (`cam_hole_sq=44`、`parent_cam_mount.foot_sq` と二重定義) — 2026-08-28 確定
- [ ] LCD ブラケット穴 (`lcd_pos` 仮 — ブラケット設計時に確定)
- [x] LiPo トレイ (`parent_lipo_tray`)・カメラマウント (`parent_cam_mount`)・TX 高架スペーサ (`hex_spacer` m3_mf25) — 2026-08-28 設計済み
- [ ] LCD ブラケット (`parent_lcd_bracket`) — 未設計
- [ ] 箱仮値確定後に FEA (`topopt fea`)

## インタフェース (二重定義の台帳)

| 変数 | 相手 | 値 |
|---|---|---|
| `px, py, m4_pitch_*, corner_cut` | `bcas212310g.md` / 箱実測 | 183, 203, 160×180, 8 |
| `pin_pos` (← `box_tap_south`), `pin_d` | `bcas212310g.scad tap_pos` (図面 DXF) | (65,25)/(105,25) 箱座標 → (51.5,11.5)/(91.5,11.5)、Ø3.2 (下穴 3.4) |
| `main_h` (MAIN 穴) | `parent_lipo_tray.hole_px/py` | 103 × 75.5 |
| `cam_hole_sq, cam_pilot, cam_leg_d, vp_off` | `parent_cam_mount.scad` (`foot_sq/foot_d/leg_d`) / `spec VP_OFF` | 44, 2.6, 7.5, 54 |
| `lcd_pos` | `parent_lcd_bracket` (未設計) | (72,192)/(110,192) — 箱ボス直上を避けた位置 |
| `main_pos` ほか配置座標 | `spec/parent_interior_layout.py` | 完全一致させること |
| 基板穴ピッチ | `hardware/pcb/*/[*.kicad_pcb]` | MAIN 103×75.5 / PWR 90×74 / TX 42×66 (回転後) |
| `vp_off=53` | `parent_mast_clamp` (フランジ70角) / `parent_float_segment` (ID140) | 成立域 52..55 |
