AquaBeacon/mechanical/assemblies/parent_rope_float/parts/DESIGN_NOTES.md

# 設計・印刷条件の控え（自動生成）

以下は設計元の文書を転記したものです。リンク先は元フォルダ基準です。印刷条件と未検証事項を確認してください。

## parent_rope_float/README.md

**印刷一式:** [parts/PRINT.md](parts/PRINT.md)（STL・数量・モディファイア） · **確認画像:** [_work/images/](_work/images/)

# 親機：左右2個の浮きを紐で接続

**この版は旧配置です。現行は[下向きカメラ・TD04A／一体型フィン版](../parent_bottom_sensors/README.md)。以下は上部カメラ配置時点の記録です。**

今回のユーザー指定を反映した現行外装。**浮きは2個、親機のすぐ左右に配置し、紐だけで接続する。浮きは剛体接続しない。**

先の `parent_spar_bolted` の印刷円柱浮体・浮体の上下端板・タイロッド・長ナットはこの構成に含めない。浮きを挟むヨークやクランプも使わない。以前の5.2 kg・151時間の印刷見積もりはこの版には適用しない。

## 紐の経路

片側につき、既存デッキの前側紐穴 → 浮きの中心貫通穴 → 後側紐穴という経路を示した。紐穴は既存の直径8、左右の側壁に前後各1個（合計4個）。図の紐径4は経路表示用の仮値で、結び目と締結の細部は未指定。

浮きは既存の市販フェンダー仮モデルを2個使用。各直径100・全長300・中心穴15は実測未確定。中心X=±178、Y=0、Z=0とした表示姿勢では、デッキ側面と浮き胴の間に20 mmの隙間がある。表示の位置と紐の曲線は代表姿勢であり、現物をこの位置・角度へ固定する意味ではない。

紐は張力だけで浮きの離れすぎを抑える接続として扱う。実際の浮きの上下動・回転・親機との接触は許容し、剛体アームで止めない。紐の長さと結び方は実物で調整し、張り切った状態で固定ヨークの代わりに使う想定はしない。

浮きの実寸・紐の余長が未確定なので、可動範囲や接触の有無は未検証。旧双胴の剛体配置に基づく復原性の計算を、この紐接続にそのまま適用しない。

## 親機側の構造

箱・デッキ・カメラ支持部・GPS支持部・下部フィン・錘ケースのねじ固定は維持する。「全てねじ等で固定」という前回条件のうち、浮きの接続は今回の指示に従って紐に変更した。

浮体の縦積みを取り除いたため、下部フィン支柱は新しい `parent_rope_keel_adapter` を介してデッキ中央HP40座へ直接固定する。アダプターはM5×16×4＋座金、支柱はM6×60＋座金・ナットで固定。60×60×48で印刷可能。角部を開いたソケットで、M5ボルトの工具経路を確保する。

円盤は直径225、垂直フィンは125×65の4枚。カメラは前版と同じ箱のすぐ下。浮き・紐は購入品で、印刷部品には含めない。箱底Z=0、円盤Z=-360、カメラケース上端Z=-18.5（仮包絡）。

## ファイル

- `parent_rope_float.step`：組立STEP。
- `parent_rope_float_view.scad`：全体表示用。`placement.json`から生成する。
- `rope_routes.scad`：柔らかい紐の経路の模式表示。印刷しない。
- `print_jobs/parent_rope_float/`：今回使用する印刷向きのSTLのみ。
- `print_checks.json`：印刷向き・寸法の検査。
- `fasteners.json`：今回残るねじ類。印刷円柱浮体用のねじは除外済み。

再生成：`python spec/build_parent_rope_float.py`。保持した造形部品は前版と同一形状で、X1 Carbonのスライス検査済みSTLを使用する。新しいアダプターは別途スライス確認する。

現行版は印刷13種類18点。新アダプターはX1 Carbon設定でスライス終了コード0、残りは前版の検査済みSTLとのSHA256一致を確認。親機のねじ固定部品と金具の接触検査は浮き0・貫通0（可動浮体・紐・未測定のケース包絡は対象外）。紐のSTEPは表示用メッシュ由来。

カメラケース実測、GPSの実物適合、浮きの実測、浮力・復原性・強度の実機試験、TD04A・テザー取付の未確定事項は残る。紐接続で自由に動く浮き・紐・ケース包絡は、ねじ固定部品の接触検査とは分けて扱う。

## parts/child/exterior/printed/dji_osmo_action6_mount/dji_osmo_action6_mount.md

# DJI osmo Action 6固定部品

2026-09-17：指定STLを元に、前側支持+8 mm・肉抜き・背板へのM3直接固定穴を設けた別版を作成。[M3直接固定版と15%インフィル印刷データ](../dji_osmo_action6_mount_m3/README.md)。アダプター案は廃止。このフォルダの旧モデルは保存。

## 現行：背面板＋前側支持台（2026-09-09）

ユーザー指定に従いFDM印刷用の一体部品へ改訂。ケース後側の底面支持台と側面囲いを廃止し、ケース背面に沿う板で支える。前側の2つの支持面は残した。ケースへの穴あけや接着は想定せず、純正ねじ用の最小限の3枚爪受けを保持して脱落を防ぐ。

固定の考え方：ケース背面を背面板側へ合わせ、前側底面を前側支持面へ合わせて姿勢を決め、純正ねじで底面爪を締結する。板だけでケースを締め付ける機構ではない。穴の遊びと接触部の隙間があるため、実物に合わせたシム調整と保持確認が必要。

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

## 印刷の出発条件

X1 Carbon・0.4 mmノズルを想定。STLはそのままZ=0の広いベース面をベッドに置く。背面板と三角リブを上に積み上げる向き。

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

薄い中央爪が壁で充填されること、穴内部に除去不能なサポートが入らないことをスライサーで確認。FDM積層方向による爪・背面板根元の強度低下を含む実荷重検証は未実施。上記は保証済みの量産条件ではない。印刷時間・材料消費量は未スライスのため未算出。

## 実測・仮値

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

背面板には0.5 mm、前側支持には0.3 mmの調整余裕を置いている。この隙間が残った状態では回転を拘束できない。硬質シムと必要最小限の傷防止層で実物に合わせる。厚い柔らかいゴムだけで姿勢を決めない。背面が開閉蓋であるため、板を押し当てた時の蓋のたわみ・シール・ヒンジへの影響を実物で確認する。形状未測定なので干渉なしとは判定していない。

純正ねじ露出長17〜18 mmは写真推定。M5普通ナットを仮定した二面幅8.2 mm・深さ4.2 mmの座を設けるが、ねじピッチ・実かかり長・ナット脱落止めは未確定。純正ねじと適合ナットは別部品。

## 組み付けと着脱

1. ケースを背面板と前側支持へ合わせ、シムでガタを調整する。強く締めてケースを変形させない。
2. 爪の穴を合わせ、純正ねじと適合ナットで締結する。
3. 前後・左右へ小さく力をかけ、接触が離れず姿勢が変わらないことを確認する。
4. 取り外しは純正ねじを抜いてケースを前上方へ外す想定。背面蓋の開閉はケースを外して行う。

左右方向の遊び・逆向き荷重での支持面離脱は、この形状だけでゼロにできたとは扱わない。保持力不足なら予圧押さえを追加検討する。現時点で「絶対にずれない」保証はない。

## 検証と機体への影響

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

FreeCAD変換時に中間再計算とユーザー設定保存の警告が出たため、出力STEPを別プロセスで再読込して検証した。結果は `step_check.json`。

背面のリブにより奥行が54→79.45 mmへ増加。既存ブリッジとの干渉・装着可否は未検証。取り付け穴22×32 mmピッチは維持したが、機体アセンブリへ自動置換していない。レンズ位置、画角、保持荷重、着脱後の姿勢再現性も確認待ち。

旧版は `archive/integrated_bottom_support/`。印刷中の試験片は `archive/osmo_case_fit/`。関連部品はこのフォルダに集約してある。

## parts/parent/exterior/printed/parent_deck/parent_deck.md

# parent_deck — 親機 デッキ (防水ボックス台 + 浮子ヨーク取付 + 下面ハードポイント)

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

## 役割 (2026-09-04 人間決定の親機外装構成)

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

## 座標系

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

## 主要寸法

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

## インタフェース

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

## 干渉チェック (`.scad` 冒頭の assert)

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

## 荷重ケースと強度

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

### FEA 結果 (`fea/study.json` → `topopt fea --voxel 2.16`, 出力 `fea/out/`, 2026-09-04)

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

## 印刷 (X1-Carbon)

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

## 部品外の考慮

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

## 要確認

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

## parts/parent/exterior/printed/parent_rope_keel_adapter/parent_rope_keel_adapter.md

# parent_rope_keel_adapter

浮きを紐で接続する親機用。デッキ中央下面HP40から32角の印刷支柱へ接続する。浮きには接続しない。

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

## parts/parent/exterior/printed/parent_spar_ballast_body/parent_spar_ballast_body.md

# parent_spar_ballast_body

親機ねじ固定外装。数量 1。寸法 [120.0, 120.0, 51.0] mm（印刷姿勢）。

設計ソースは `scad/lib/parent_spar_bolted.scad` の `ballast_body`。
印刷用STLは `print_jobs/parent_spar_bolted/parent_spar_ballast_body.stl`。部品フォルダのSTL/STEPは組立座標。

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

## parts/parent/exterior/printed/parent_spar_ballast_lid/parent_spar_ballast_lid.md

# parent_spar_ballast_lid

親機ねじ固定外装。数量 1。寸法 [120.0, 120.0, 6.0] mm（印刷姿勢）。

設計ソースは `scad/lib/parent_spar_bolted.scad` の `ballast_lid`。
印刷用STLは `print_jobs/parent_spar_bolted/parent_spar_ballast_lid.stl`。部品フォルダのSTL/STEPは組立座標。

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

## parts/parent/exterior/printed/parent_spar_beam_lower/parent_spar_beam_lower.md

# parent_spar_beam_lower

親機ねじ固定外装。数量 1。寸法 [180.0, 32.0, 32.0] mm（印刷姿勢）。

設計ソースは `scad/lib/parent_spar_bolted.scad` の `beam_lower`。
印刷用STLは `print_jobs/parent_spar_bolted/parent_spar_beam_lower.stl`。部品フォルダのSTL/STEPは組立座標。

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

## parts/parent/exterior/printed/parent_spar_beam_upper/parent_spar_beam_upper.md

# parent_spar_beam_upper

親機ねじ固定外装。数量 1。寸法 [107.0, 32.0, 32.0] mm（印刷姿勢）。

設計ソースは `scad/lib/parent_spar_bolted.scad` の `beam_upper`。
印刷用STLは `print_jobs/parent_spar_bolted/parent_spar_beam_upper.stl`。部品フォルダのSTL/STEPは組立座標。

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

## parts/parent/exterior/printed/parent_spar_camera_bridge/parent_spar_camera_bridge.md

# parent_spar_camera_bridge

親機ねじ固定外装。数量 1。寸法 [140.0, 78.0, 180.0] mm（印刷姿勢）。

設計ソースは `scad/lib/parent_spar_bolted.scad` の `camera_bridge`。
印刷用STLは `print_jobs/parent_spar_bolted/parent_spar_camera_bridge.stl`。部品フォルダのSTL/STEPは組立座標。

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

## parts/parent/exterior/printed/parent_spar_coupler_half/parent_spar_coupler_half.md

# parent_spar_coupler_half

親機ねじ固定外装。数量 2。寸法 [54.0, 64.0, 26.75] mm（印刷姿勢）。

設計ソースは `scad/lib/parent_spar_bolted.scad` の `coupler_half`。
印刷用STLは `print_jobs/parent_spar_bolted/parent_spar_coupler_half.stl`。部品フォルダのSTL/STEPは組立座標。

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

## parts/parent/exterior/printed/parent_spar_disk/parent_spar_disk.md

# parent_spar_disk

親機ねじ固定外装。数量 1。寸法 [225.0, 225.0, 5.0] mm（印刷姿勢）。

設計ソースは `scad/lib/parent_spar_bolted.scad` の `disk`。
印刷用STLは `print_jobs/parent_spar_bolted/parent_spar_disk.stl`。部品フォルダのSTL/STEPは組立座標。

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

## parts/parent/exterior/printed/parent_spar_fin/parent_spar_fin.md

# parent_spar_fin

親機ねじ固定外装。数量 4。寸法 [65.0, 125.0, 4.0] mm（印刷姿勢）。

設計ソースは `scad/lib/parent_spar_bolted.scad` の `fin`。
印刷用STLは `print_jobs/parent_spar_bolted/parent_spar_fin.stl`。部品フォルダのSTL/STEPは組立座標。

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

## parts/parent/exterior/printed/parent_spar_gps_bridge/parent_spar_gps_bridge.md

# parent_spar_gps_bridge

親機ねじ固定外装。数量 1。寸法 [183.0, 96.0, 100.0] mm（印刷姿勢）。

設計ソースは `scad/lib/parent_spar_bolted.scad` の `gps_bridge`。
印刷用STLは `print_jobs/parent_spar_bolted/parent_spar_gps_bridge.stl`。部品フォルダのSTL/STEPは組立座標。

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

## parts/parent/exterior/printed/parent_spar_hub/parent_spar_hub.md

# parent_spar_hub

親機ねじ固定外装。数量 2。寸法 [88.0, 88.0, 32.0] mm（印刷姿勢）。

設計ソースは `scad/lib/parent_spar_bolted.scad` の `hub`。
印刷用STLは `print_jobs/parent_spar_bolted/parent_spar_hub.stl`。部品フォルダのSTL/STEPは組立座標。

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

## parts/parent/interior/printed/parent_lipo_tray/parent_lipo_tray.md

> 2026-09-26: 親機サービス改訂では、6面保持の [parent_lipo_retainer](../parent_lipo_retainer/parent_lipo_retainer.md) を使用。以下は旧ベルクロトレイの比較資料。

# parent_lipo_tray — 親機 LiPo ブリッジトレイ (P-MAIN 上・最上段)

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

## 役割・主要寸法

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

## インタフェース (二重定義の台帳)

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

## 干渉チェック

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

## 荷重ケースと強度

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

実際は両端支持 (南北 2 穴) なので片持ち近似より硬い。FEA は省略 (閉形式で SF > 5)。

## 印刷指示

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

## 部品外の考慮

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

## 要確認

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

## parts/parent/interior/printed/parent_plate/parent_plate.md

# parent_plate — 親機 防水ボックス内 マウントプレート (183×203 t5, 2バリアント)

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

## 役割

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

## バリアント

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

## 配置 (プレート左下原点, 単位 mm)

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

## 主要寸法・箱との取合い

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

## 干渉チェック

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

## 荷重ケースと強度

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

## 印刷

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

## 部品外の考慮

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

## 要確認 (これが解消するまで印刷しない)

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

## インタフェース (二重定義の台帳)

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
