AquaBeacon/mechanical/assemblies/parent_simple/parts/DESIGN_NOTES.md

# 設計・印刷条件の控え（自動生成）

以下は設計元の文書を転記したものです。リンク先は元フォルダ基準です。印刷条件と未検証事項を確認してください。

## parent_simple/README.md

**印刷一式:** [parts/PRINT.md](parts/PRINT.md)（STL・数量・モディファイア） · **確認画像:** [_work/images/](_work/images/)

# 親機・シンプル外装（2026-09-16）

既存タカチ BCAS212310G をそのまま外装箱として使い、下部を236×236×12 mmの底板1枚に変更。下方へ伸びる支柱、キール、フィン、錘、センサー支持板は設けない。左右の購入浮きは紐で接続する想定。旧設計は別フォルダに保持。

## マウント用ねじ穴

座標は箱底中心が原点、箱底Z=0、板底面Z=-12。下表の穴は下面からのM5熱圧入インサート用下穴（直径6.4、深さ8 mm）で、上に4 mmの肉を残す。M5の印刷ねじではない。インサート8個が別途必要で、購入するインサートの指定下穴径と長さに合わせて調整する。

|用途|中心X,Y|穴ピッチ|個数|
|---|---|---|---|
|カメラマウント|−48,0|22×32 mm|4|
|TD04Aマウント|55,0|50×46 mm|4|

既存のマウント固定ピッチを継承した、後付け用の取付面。今回はマウント本体・センサー・配線は設計対象に含めていない。旧マウントは垂直板への固定を前提としているため、今回の水平な底面に固定して下向きにするにはマウント側の向き変更／アダプターが必要。既存の下向き姿勢でそのまま直付けできるという意味ではない。ねじのインサートへの入り量は6〜7 mmを目安に、実際のマウント厚・座金・インサート長からねじ長を決める。

## 箱・浮き・配線

- 箱固定：既存の外部固定穴と同じ192×212 mmピッチ、M4通し穴4個。下面に直径10×深さ4 mmのナット／小径工具用座ぐり。M4標準ナットを使用し、大径ソケットは使わない。箱側座面厚6 mm＋板残厚8 mm＋ナット3.2 mmを基準にM4×20を仮選定し、実物でねじ突出と箱内工具通路を確認する。
- 紐穴：X=±112、Y=±75に直径8 mmを4個。箱外形の外に開口。浮きの端アイへ紐を回して固定する。プレビューの浮きは従来の仮包絡で、紐は描画していない。
- 南側中央に幅55×奥行8 mmの開放切欠き。既存ペネトレータからのケーブルを板下面へ回す。曲げ半径と張力止めはケーブル確定後に合わせる。
- 防水箱への新規貫通穴加工は不要。防水は購入箱が担い、この印刷底板は防水容器ではない。

## データと印刷

部品：`../../parts/parent/exterior/printed/parent_simple_deck/` のSCAD・STEP・STL。STEPは編集可能な単一ソリッド。

印刷時は箱側の平面（Z=0）をベッドにするよう上下反転し、底面の下穴と座ぐりを上向きにする。PETG、0.4 mmノズル、0.2 mm層、壁6周、上下6層、40%インフィルを初期設定とする。サポート不要の形状。必要なら5 mmブリム、初層膨張はスライサ側で補正。236 mm角なのでブリム込み246 mm角。X1Cの禁止領域を含む実配置・スライスは未検証。

検証済み：OpenSCADでSTL生成、閉じた単一メッシュ、236×236×12 mm。STEP単一ソリッド、STLとの外形差0.00 mm、体積差約0.006%。画像で穴配置を確認。荷重・浮力・復原性・実物マウント適合は未検証。

再生成：`./build.ps1 parts/parent/exterior/printed/parent_simple_deck`、続いて `python spec/build_parent_simple.py`。
