AquaBeacon/mechanical/assemblies/parent_spar_bolted/parts/DESIGN_NOTES.md

# 設計・印刷条件の控え（自動生成）

以下は設計元の文書を転記したものです。リンク先は元フォルダ基準です。印刷条件と未検証事項を確認してください。

## parent_spar_bolted/README.md

**印刷一式:** [parts/PRINT.md](parts/PRINT.md)（STL・数量・モディファイア） · **確認画像:** [_work/images/](_work/images/)

# 親機外装：ねじ固定・X1 Carbon対応版

**旧案**：その後のユーザー指定により、浮きは左右2個を紐で接続する構成へ変更。[現行の親機外装](../parent_rope_float/README.md)。このフォルダの円柱浮体・タイロッドは現行版には使用しない。

2026-09-10。水色の円柱は**浮力を作る浮体**。前案の配置用円柱を、上下2個の中空浮体・ねじ蓋・端板・分割タイロッドで固定する構造へ変更した。親機の箱は承認済みのタカチBCAS212310Gを使う。

完成組立形状は `parent_spar_bolted.step`、表示用は `parent_spar_bolted_view.scad`、配置の正は `placement.json`。部品形状の正は `scad/lib/parent_spar_bolted.scad`。旧 `parent_spar_concept` と旧双胴 `parent_assembly` は履歴として残す。

## 今回の変更

- 水平円盤：直径225×厚さ5。垂直フィン：高さ125×幅65×厚さ4を4枚、90度間隔。幅には根元の差込み14を含む。
- フィンは上下ハブへねじ止め。ハブも支柱へ横ボルトで固定する。フィンのねじと支柱固定ねじは高さを分け、互いに交差させない。
- 支柱は印刷可能な180 mmと107 mmの2本。2つ割り継手は横ボルト2本＋合わせボルト4本で固定し、回転と抜けを拘束する。
- 浮体は胴直径200・高さ180を2個。最大径はフランジの225。蓋は別部品で厚さ6、各8本のM4で締結。内外2本の環状パッキン溝を設ける。
- 浮体全体は上下端板と4列のM6タイロッドで締結。各列は長さ205の金属ねじ棒2本を長ナットで接続し、輸送時に短く分けられる。
- 錘を収納するケースもねじ蓋式。内部の金属リングは中央M8で固定し、単にケース内に置くだけにはしない。
- カメラは既存のOsmo用マウントを短い支持部でデッキ北側へ固定する。ケース上端は箱底の**18.5 mm下**、ケース底面は93.5 mm下（現在の仮包絡）。下部フィンまでカメラを下げない。
- GPSは既存計画のANN-MB1のM4×2用支持台を設計。デッキ側面HP40へM5×4で固定し、箱の蓋へ新しい取付穴を開けない。
- IMUは既存の箱内SPRESENSEロガー配置を引き継ぎ、外装に仮の緑色ブロックを追加する表現を廃止。

## 印刷ファイル

**スライサーに入れるのは `print_jobs/parent_spar_bolted/` 直下のSTL。** 部品フォルダのSTL/STEPは組立座標であり、印刷向きとは異なる部品がある。

|部品|数量|印刷時の外形 mm|
|---|---:|---|
|円盤|1|225×225×5|
|垂直フィン|4|65×125×4|
|ハブ|2|88×88×32|
|下支柱 / 上支柱|各1|180×32×32 / 107×32×32|
|2つ割り継手（同形状）|2|54×64×26.75|
|浮体胴|2|225×225×180|
|浮体蓋|2|225×225×6|
|浮体上端板 / 下端板|各1|225×225×28 / 225×225×48|
|錘ケース / 蓋|各1|120×120×51 / 120×120×6|
|カメラ支持部|1|140×78×180|
|GPS支持部|1|183×96×100|
|既存デッキ|1|216×236×60|
|既存Osmoマウント|1|104×79.45×84.5|

造形対象は16種類・23点。タカチ箱・カメラ・GPS・基板・ねじ・ナット・座金・金属錘・シールは購入部品で、印刷対象ではない。重りを樹脂で代用しない。

X1 Carbonの公称造形領域は256³。ただしカッターの禁止領域があるため、設置済みBambu StudioのX1 Carbon 0.4 mm設定（禁止領域X=0..18、Y=0..28）を維持して検査。各STLのXY中心を(138,128)へ置き、5 mmブリム込みで禁止領域を避ける。最大直径225の部品でもX=20.5..255.5、Y=10.5..245.5となる。1部品ずつのプレートで検査する。

参考：[Bambu Lab X1 Carbon公式仕様](https://us.store.bambulab.com/products/x1-carbon?variant=42698346037384)。禁止領域はローカルの標準プリンタープロファイルも参照した。

## スライス条件

設置済みBambu Studio 2.8.2.61、X1 Carbon 0.4 mm、0.20 mm Standardを基に、Generic PETG、Textured PEI Plate、壁6周、上下各6層、Gyroid 40%、外側ブリム5 mm、自動通常サポートでオフラインスライスする。機体やアカウントへの送信は行わない。

- 支柱は横置き。長手方向の負荷を層面内で受ける向きとする。
- 継手は割り面を上へ向けた2部品とし、閉じた角穴内部のサポート除去を避ける。
- 浮体胴は底を下、開口を上。外周フランジ下面は45度。内部をサポートで埋めない形状。
- 浮体蓋はシール溝を上。造形後、溝の傷・糸引き・バリを除去し、シール面の状態を確認する。
- フィンと円盤は広い面を下。横穴や支持部は、同梱の印刷向きと自動サポートを前提とする。
- 上端板の下面ねじ頭逃げ・カウンターボアなどに発生するサポートは、浮体を組む前に除去する。

スライス成功は造形領域・スライサー処理の確認であり、実プリントの反り、嵌合、水密性、耐久強度を保証するものではない。量産前に継手と穴の小試験を行う。

## 締結と組立順

詳細な数量は `fasteners.json` と `fastener_bom.md`。ねじ穴はクリアランス穴、ねじ山は金属ナットまたは既存デッキのインサートが受ける。印刷ねじは使わない。

1. **箱とデッキ**：既存外部取付穴M4×4とデッキ側M4インサートを使用。既存の箱・内装はそのまま。箱側のアクセスは従来モデルの条件を引き継ぐ。
2. **浮体上端板とデッキ**：中央HP40へM5×20を4本、各2枚の1 mm座金で固定。ボルトが入る方向は下から上。浮体を付ける前に行う。
3. **カメラ支持部**：北側下面HP40へM5×16を4本。既存マウントをM5×25×4＋ナットで支持部へ固定。カメラケースの爪は純正互換のM5ねじとマウント内ナットで締結する。
4. **GPS支持部**：右側後方HP40へM5×20×4。アンテナの耳をM4×25×2＋ナットで棚へ固定。GPSを外さなくても箱の蓋の上方空間を確保するが、全開ストロークは実機で確認。
5. **浮体各段**：パッキンを入れ、M4×20×8＋座金・ナットで蓋を対角順に締める。フランジ下面の工具逃げからナットを保持する。上端板には蓋ねじ頭・座金の逃げ穴を設けた。
6. **浮体の積層**：4列のM6ねじ棒で端板・2段の浮体を挟む。205 mmのねじ棒を1列に2本使用。長ナット18 mmに下側9 mm・上側8 mmをねじ込み、棒先端間1 mmを残す設定。印を付けてかかり長を管理する。蓋・胴の直径13の逃げ穴に長ナットを通す。上下端板を座金＋M6ナットで締結する。工具で保持できる位置で先に長ナットを接続してから浮体を通す。
7. **支柱**：下端板のソケットへ上支柱を差し込み、M6×60＋ナットで固定。上下支柱の突合せ部を2つ割り継手で挟み、M6×70×2で各支柱を貫通、M5×65×4で継手半体を結合する。
8. **フィン**：ハブへフィン4枚を差し込み、M5×40を各2本（計8本）。ハブから支柱への固定はM6×100×2。ハブ穴の位置がずれたまま締め込まない。
9. **円盤と錘ケース**：下ハブ・円盤・ケース天板をM5×55×4で共締め。ナットはケース内側にあるため、錘を入れる前に締める。金属リング（仮：外径50・内径9、計高さ30）を中央M8×50で固定。ケース蓋はM5×20×4。ケースは水抜き穴付きで、ここに浮力は期待しない。

搬送時は支柱継手で上部と下部を分離できる。さらに浮体を2段に分け、ねじ棒を205 mmに分解し、フィン4枚を重ねられる。シール蓋を開けずに浮体段を分けられる構成。深い分解ほど工具作業が増えるため、現場ではフィンユニットを組んだまま運ぶ方法も選べる。

## シール、浮力、搭載機器の確認事項

浮体の内外2本のシール溝は幅2.4・深さ1.5、中心半径32 / 98。断面2 mmのリングなら、溝が完全に閉じたときの圧縮量は0.5 mm。各径2本、合計4本が必要。既製リングの寸法目安は内径62×線径2、内径194×線径2。材料と適合性は購入時に確認する。

**浮体は実物で浸水試験が必要。** FDM外壁やシール面は、閉じたメッシュでも漏水しうる。空の浮体を個別に試験し、必要な表面処理とシールの調整を済ませてから機器を載せる。

直径200・中央穴60・総高さ372の単純な環状包絡は約10.63 L。これは設計上の比較用体積で、積載許容値ではない。外周形状、樹脂・金具の重量、乾舷、吸水、波、傾斜を含めた実喫水と復原性は未検証。旧双胴の静水力学計算値は流用しない。錘の仮リングは鋼密度7.85 g/cm³で約0.447 kg。必要な錘質量は実機の重心・傾斜試験で決める。

カメラは質問への返答待ちのため、既存のOsmo Action 6＋純正防水ケース用マウントを使用する前提。ケース包絡95×45.9×75とケース背面形状は既存設計にも実測待ちが残る。ケース上端を箱底に近づけたが、**レンズが実喫水より下かどうかは未確定**。水中撮影が必須なら、実喫水を測定して支持高さを調整する。

GPSは既存配線計画のANN-MB1を前提に、[u-blox機械図](https://content.u-blox.com/sites/default/files/ANN-MB1_DataSheet_UBX-21005551.pdf)の82×60×22.5、M4×2（ピッチ68）を使用。表示モデルは簡易包絡。箱内IMUは既存SPRESENSE構成を保持しており、その取付穴・積み上げ高さの実測待ちは今回解消していない。

TD04Aの取付、テザー張力止め、GPSケーブルの箱への引込みはこの外装改訂に未追加。既存南壁ペネトレータを保持し、カメラを北側へ置いて経路を分ける。余ったケーブルをフィン周囲へ垂らさない。実荷重FEA・波浪試験は未実施。

## 再生成

```powershell
python spec/build_parent_spar_bolted.py
python assemblies/parent_spar_bolted/prepare_reused_prints.py
python spec/assemble_parent_spar_bolted.py
python spec/slice_parent_spar_bolted.py
```

幾何検査は `print_checks.json`、外装＋金具の接触検査は `hardware_contacts.json/.txt`、スライス結果は印刷フォルダの `slice_validation/*/result.json` に保存。接触検査は表面サンプリングであり、厳密な全点干渉検査ではない。カメラ・GPSの実物適合性や強度まで完了したとは扱わない。

最終の外装・金具・GPS/錘参照形状（`exterior,hardware,reference`）はFLOATING 0、貫通0。既存内装と箱、未測定のカメラケース・箱蓋包絡はこの検査対象外。後者は表示専用の `envelope` グループであり、実物の取付検証の代用にはしない。

印刷16種類・23点は全て閉じた単一メッシュで、Bambu Studioのスライス終了コード0・警告メッセージなし。数量分の見積合計は約5.2 kg・約151時間（サポート・ブリムを含む。完成品の重量ではない）。詳しくは印刷フォルダの `PRINT.md`。

## parts/child/exterior/printed/dji_osmo_action6_mount/dji_osmo_action6_mount.md

# DJI osmo Action 6固定部品

2026-09-17：指定STLを元に、前側支持+8 mm・肉抜き・背板へのM3直接固定穴を設けた別版を作成。[M3直接固定版と15%インフィル印刷データ](../dji_osmo_action6_mount_m3/README.md)。アダプター案は廃止。このフォルダの旧モデルは保存。

## 現行：背面板＋前側支持台（2026-09-09）

ユーザー指定に従いFDM印刷用の一体部品へ改訂。ケース後側の底面支持台と側面囲いを廃止し、ケース背面に沿う板で支える。前側の2つの支持面は残した。ケースへの穴あけや接着は想定せず、純正ねじ用の最小限の3枚爪受けを保持して脱落を防ぐ。

固定の考え方：ケース背面を背面板側へ合わせ、前側底面を前側支持面へ合わせて姿勢を決め、純正ねじで底面爪を締結する。板だけでケースを締め付ける機構ではない。穴の遊びと接触部の隙間があるため、実物に合わせたシム調整と保持確認が必要。

- 背面板：幅84 mm、厚8 mm、ケース名目底面から48 mm上まで。
- 背面補強：厚8 mmの三角リブ2本、後方への張り出し18 mm。リブはケースと反対側。
- ベース：厚8 mm。全体外形104×79.45×84.5 mm。
- 前側支持：幅84 mm・厚8 mmの壁に、16×6 mmの接触座2か所。
- ケース後方の底面を持ち上げる支持台は撤去。純正ねじを通す爪以外で底面中央を囲わない。
- 横向きねじ穴：径5.2 mmの円形部分＋上向き45度屋根。上端の垂れを減らすFDM向け形状。印刷中の旧試験片は円穴なので、屋根部のみ差がある。
- 金属ナット座は頂点が上を向く六角穴。樹脂にM5ねじ山を印刷しない。

## 印刷の出発条件

X1 Carbon・0.4 mmノズルを想定。STLはそのままZ=0の広いベース面をベッドに置く。背面板と三角リブを上に積み上げる向き。

| 設定 | 試作の出発値 |
|---|---|
| 材料 | PETG（乾燥条件・温度は使用フィラメント設定に従う） |
| 積層ピッチ | 0.20 mm |
| 壁数 | 6周 |
| 上下面 | 各6層 |
| インフィル | Gyroid 40% |
| ブリム | 外側5〜8 mmを目安に反り対策 |
| サポート | 大きな棚形状はない。スライス後に爪穴・ナット座の天井を確認し、必要箇所だけ追加 |

薄い中央爪が壁で充填されること、穴内部に除去不能なサポートが入らないことをスライサーで確認。FDM積層方向による爪・背面板根元の強度低下を含む実荷重検証は未実施。上記は保証済みの量産条件ではない。印刷時間・材料消費量は未スライスのため未算出。

## 実測・仮値

実測：ケース爪厚3 mm、内側間隔3 mm、穴径5 mm、本体底面→穴中心12.5 mm。受け側中央爪2.7 mm、溝3.3 mm、穴5.2 mmは試作公差。

ケース外形95×45.9×75 mmは図・旧公称値からの仮包絡。背面の凹凸、ヒンジ突出量、実際の爪穴から背面までの前後距離は未確定。現在はねじ軸Y=0に対して背面をY=-22.95 mmと仮置きしている。**ケース背面位置がこの値と違えば板位置を変更する必要がある。** `case_d` と板位置の導出値に依存する。

背面板には0.5 mm、前側支持には0.3 mmの調整余裕を置いている。この隙間が残った状態では回転を拘束できない。硬質シムと必要最小限の傷防止層で実物に合わせる。厚い柔らかいゴムだけで姿勢を決めない。背面が開閉蓋であるため、板を押し当てた時の蓋のたわみ・シール・ヒンジへの影響を実物で確認する。形状未測定なので干渉なしとは判定していない。

純正ねじ露出長17〜18 mmは写真推定。M5普通ナットを仮定した二面幅8.2 mm・深さ4.2 mmの座を設けるが、ねじピッチ・実かかり長・ナット脱落止めは未確定。純正ねじと適合ナットは別部品。

## 組み付けと着脱

1. ケースを背面板と前側支持へ合わせ、シムでガタを調整する。強く締めてケースを変形させない。
2. 爪の穴を合わせ、純正ねじと適合ナットで締結する。
3. 前後・左右へ小さく力をかけ、接触が離れず姿勢が変わらないことを確認する。
4. 取り外しは純正ねじを抜いてケースを前上方へ外す想定。背面蓋の開閉はケースを外して行う。

左右方向の遊び・逆向き荷重での支持面離脱は、この形状だけでゼロにできたとは扱わない。保持力不足なら予圧押さえを追加検討する。現時点で「絶対にずれない」保証はない。

## 検証と機体への影響

OpenSCADでSTL生成成功。trimeshで単一連結・閉じたメッシュを確認。体積144.20 cm³。下向き45度超の面積はベッド接触面を除き41.69 mm²で、局所確認が必要（この数値はスライス検証ではない）。STEPを独立して読み戻し、有効な1ソリッドであることを確認。STEP/STLの外形差0.00 mm、体積差約0.013%。前後プレビューを確認。

FreeCAD変換時に中間再計算とユーザー設定保存の警告が出たため、出力STEPを別プロセスで再読込して検証した。結果は `step_check.json`。

背面のリブにより奥行が54→79.45 mmへ増加。既存ブリッジとの干渉・装着可否は未検証。取り付け穴22×32 mmピッチは維持したが、機体アセンブリへ自動置換していない。レンズ位置、画角、保持荷重、着脱後の姿勢再現性も確認待ち。

旧版は `archive/integrated_bottom_support/`。印刷中の試験片は `archive/osmo_case_fit/`。関連部品はこのフォルダに集約してある。

## parts/parent/exterior/printed/parent_deck/parent_deck.md

# parent_deck — 親機 デッキ (防水ボックス台 + 浮子ヨーク取付 + 下面ハードポイント)

| 項目 | 値 |
|---|---|
| 区分 | 親機 / 外装 / 3Dプリント |
| 設計ソース | `parent_deck.scad` |
| 個数 | 1 |
| 外形 | 216 × 236 × 60 mm (デッキ上面 z=0、キール座面 z=−60) |
| 体積 (中実) | 839 cm³ → PETG 壁 4 + インフィル 25 % で **約 0.43 kg** |
| STEP | 1 ソリッド / 219 面 / watertight |

## 役割 (2026-09-04 人間決定の親機外装構成)

- **浮子 2 個・支柱 (マスト) 無し・カメラは Osmo Action 6 + 純正防水ケース (ジグは後日)**。
- タカチ **BCAS212310G** を上に載せ、箱底コーナーの**外部取付穴 Ø4.2 ×4** (図面 E-E、
  箱中心から (±96, ±106)) に上から M4 を通し、デッキの **M4 熱圧入インサート** ×4 で受ける。
- 左右 (±X) 側壁の外面に **HP40 座 ×2 / 側** (Y ±70, z −25) → `parent_float_yoke` (浮子の端受け、
  2026-09-05 にアーチ式クレードルから置換) を M5 ×4 で締結。ヨークを外せば同じ座に別のアクセサリを付けられる (拡張性)。
- 下面中央の**キール** (壁 2 枚 + 端壁 2 枚 + 座板 3 枚) の底面 (z −60) に **HP40 座 ×3**
  (Y −70 / 0 / +70) → 南 = TD04A ソケット (`xdcr_socket_parent`, 開口下向き)、
  北 = **Osmo 固定ジグ用 (予約)**、中央 = 予備。
- 紐穴: 側壁両端 **Ø8 ×4** (X 貫通、Y ±108, z −35) = 吊り索 / 浮子の紐の予備の結び点 (ヨークのフィンに同軸の Ø8 穴があり塞がれない)。
- **南縁ケーブル切欠き** (X −30..25、深さ 8) = 南壁ペネトレータ ×2 (箱 x=85/120 →
  デッキ X −20/+15) から降りるケーブルをデッキ下へ回す。キール南端壁の **Ø8 フェアリード ×2**
  (X ±9, z −30) でテザー / TD04A ケーブルの張力止め (結束バンド or 結び目)。

## 座標系

箱中心 = 原点、デッキ上面 (= 箱底外面) z=0、+Y = 北 (箱の北壁側)。
**箱座標 (x, y) → デッキ (x − 105, y − 115)**。

## 主要寸法

| 変数 | 値 | 意味 |
|---|---|---|
| `plate_x / plate_y / plate_t` | 216 / 236 / 6 | デッキ板 (箱カバー外形 210 × 230 + 3/側) |
| `ear_x / ear_y / ear_pilot_d / ear_pilot_h` | ±96 / ±106 / 5.6 / 9 | 箱固定 M4 インサート下穴 (上から) |
| `lip_t / lip_h` | 17 / 50 | 側壁 (X ±91..±108)。厚 17 = HP40 下穴 9 + 箱取付穴が板内に収まる下限 16 + 1 |
| `hp_lip_y / hp_lip_z` | [−70, 70] / −25 | 側壁 HP40 座中心 (座面 X = ±108) |
| `rope_d / rope_y / rope_z` | 8 / ±108 / −35 | 側壁 紐穴 |
| `win_w / win_h / win_z0` | 36 / 14 / −44 | 側壁の軽量窓 (45° 屋根、X 貫通) |
| `keel_wall_t / keel_wall_x / keel_y / keel_wall_z` | 8 / 16 / ±105 / −50 | キール壁 X ±16..±24 |
| `pad_t / pad_w / hp_keel_y` | 10 / 50 / [−70, 0, 70] | キール座板 (座面 z −60) |
| `end_wall_t / fair_d / fair_x / fair_z` | 6 / 8 / ±9 / −30 | キール端壁とフェアリード |
| `notch_x0 / notch_x1 / notch_d` | −30 / 25 / 8 | 南縁ケーブル切欠き |

HP40 の定数 (`hp_pitch 40 / hp_ins_d 6.4 / hp_ins_h 8 / hp_pad 50 / hp_cable_d 14`) は
`scad/lib/hardpoint.scad` と二重定義 (`use` なので定数が見えない)。

## インタフェース

| 相手 | 内容 |
|---|---|
| `bcas212310g` | 箱底コーナー Ø4.2 ×4 @ (±96, ±106) ← M4 ×16 (上から) → デッキ M4 インサート。箱の胴体 (約 204 × 224) がデッキ板に載る。**ねじの向き (上から / 下から) は現物で要確認** (図面 E-E では 6 厚の足に Ø4.2) |
| `parent_float_yoke` ×4 | 側壁外面 HP40 ×2 / 側 (Y ±70, z −25)。M5 ×25 ×4 / 座。ヨークのアダプタ板 (56 角) は座より 3 大きく、デッキ上面より 3 上・側壁下端より 3 下に出る (デッキ板の縁の外側なので干渉なし) |
| `xdcr_socket_parent` | キール南座 (0, −70, −60)。M5 ×4 @ ±20 (ソケット `hole_p 40` = HP40) |
| Osmo 固定ジグ (未設計) | キール北座 (0, +70, −60)。HP40 アダプタ板 (t6, M5 バカ穴 Ø5.4 ×4, 中央 Ø14) を持たせること |
| `wetlink_penetrator_m10` ×2 | 南壁 (デッキ Y −115) x=−20/+15、軸 z 65、頭は箱外 Y −137..−115 → デッキ南縁 (−118) の外で干渉なし。ケーブルは南縁切欠きから下へ |

## 干渉チェック (`.scad` 冒頭の assert)

- 箱の取付穴 Ø5.6 が側壁の板厚 (X 91..108) に収まる / インサート下穴が側壁を突き抜けない
- 側壁の YZ 面フィーチャ表 (HP40 下穴 ×8 + 中央穴 ×2 + 紐穴 ×2 + 箱取付穴 ×2) を**総当り**で離隔 ≥ 3
- 軽量窓が HP40 座・側壁下端・デッキ板 (45° 屋根の頂点) から離れる
- キール座の HP40 下穴 Ø6.4 @ ±20 が壁 (X ±16..±24) の真下にある (母材) / 座同士 ≥ 座 + 10 / 端壁と重ならない
- フェアリード穴がキール壁・端壁高さに収まる
- 南縁切欠きが箱の胴体壁の下を 3 以上残す / ペネトレータ直下を覆う / 側壁に掛からない
- 250³ 造形枠

実際に止めたもの (2026-09-04): 箱取付穴が側壁板厚 14 に収まらない → 17 へ /
キール座下穴が壁の真下に無い → 壁 X 17 → 16 / キール座が端壁に掛かる → 壁半長 100 → 105。

## 荷重ケースと強度

| ケース | 荷重 | 係数 | 入力 | 受け |
|---|---|---|---|---|
| L1 定常 | 箱+内装 1.05 kg + アクセサリ 0.7 kg | 1 | デッキ板上面 | 側壁 HP40 (ヨーク) |
| **L2 取り回し** | 同上 2.45 kg → **120 N** | 5 | デッキ板上面 | 側壁 HP40 ×8 ボルト (15 N/本) |
| L2b テザー引き | 50 N (−Y) | 3 | キール南端フェアリード | 側壁 |
| L3 落下 | アクセサリ 0.4 kg → 40 N | 10 | キール南座 | 側壁 |

`quick_strength.py` (PETG, 面内): 板 (236 × 94 × 6, 100 N) 0.33 MPa / 0.04 mm ✅、
側壁を片持ち梁 (L236 b14 h50, 175 N 先端) と見ても 7.1 MPa ✅ (たわみ 3.0 mm は片持ち仮定の
過大評価。実際は両ヨーク座 (Y ±70) で支持されるので梁長は 140)、
M5 インサート引抜き 0.25 MPa ✅、M4 インサート (箱固定) ✅。

### FEA 結果 (`fea/study.json` → `topopt fea --voxel 2.16`, 出力 `fea/out/`, 2026-09-04)

PETG 直交異方性カード (`petg_generic_fff_orthotropic_v1`)、build 軸 Z、87,124 要素、
メッシュ解像度 PASS (最薄部 8.6 mm に 4 要素)。支持 = 両側壁の HP40 座面 (X ±108 帯)。

| ケース | 荷重 | 最大変位 | von Mises 最大 | 安全率 (最悪 / p99.5) | 判定 |
|---|---|---|---|---|---|
| L2 持ち上げ | 120 N 下向き (デッキ上面) + 自重 ×5 | 0.15 mm | 1.2 MPa | 30 / 47 | ✅ |
| L3 落下 | 40 N (キール南座) + 自重 ×10 | 0.24 mm | 2.2 MPa | 17 / 37 | ✅ |
| L2b テザー引き | 50 N (−Y, 南端フェアリード) + 自重 ×3 | 0.07 mm | 0.7 MPa | 51 / 133 | ✅ |

ホットスポットは箱取付インサート穴の縁 (±96, ±101) と南端壁の根元 — いずれも SF ≥ 17。
たわみは全ケース 0.25 mm 以下 (許容 1.0)。**律速は強度ではなく浮力** (上記 部品外の考慮)。

## 印刷 (X1-Carbon)

- **上下反転** (デッキ上面をベッドに)。側壁・キール壁・座がベッドから立つ。`topopt overhang`
  (反転 STL): **要サポート面積 3.6 %** = キール座板 (t10) の壁間 32 mm ブリッジ ×3 と側壁窓の
  45° 屋根。**サポート不要** (X1C のブリッジで可。気になれば座板下のみサポート)。
- 主引張 (側壁の曲げ = Y 方向、板の曲げ = XY 面内) は層面内。`topopt print --keep-flat Z` の
  「load vs layers FAIL」は `--load-axis 0,0,1` を与えたためで、実荷重方向 (Y) では PASS。
- 材料 PETG (屋外・水・紫外線なら ASA)。壁 4 本 / インフィル 25 % (ジャイロイド) / 上下 5 層。
- HP40 のインサート下穴 (Ø6.4) は反転印刷で座板側が上面になるので、印刷後にそのまま熱圧入できる。
  側壁の横穴 (Ø6.4 / Ø8 / Ø14) は水平穴 = 上面がやや垂れる。Ø6.4 は熱圧入時に馴染む。
- 反り対策: 216 × 236 の全面ベッド接触。ブリム 5 mm、ベッド中央。

## 部品外の考慮

- **ケーブル**: 南壁ペネトレータ (箱外 z 65) → 南縁切欠き → キール南端フェアリード →
  南座ソケットの底穴 Ø9 / HP40 中央 Ø14。TD04A の 3P プラグは通らないので**箱内で切って
  端子台**に落とす (`wetlink_penetrator_m10.md`)。テザーは南端フェアリードで**張力止め**を
  してからペネトレータへ (シール部に引張をかけない)。
- **喫水**: 浮子軸 z 0・総質量 3.14 kg で喫水線は **z ≈ −2.7** (`spec/parent_hydrostatics.py`) = デッキ板がほぼ全部水中、
  箱底が水面。側壁・キール・TD04A 面 (−104) は水中。デッキは密閉インフィルの PETG なので 0.84 L の浮力体でもある。
  水抜き穴 (キール座の Ø14、側壁窓) から水が入っても抜けるので問題なし。
- **水抜き**: デッキ板上面は箱が覆う。側壁の軽量窓とキール壁間の通路は水が抜ける。
  キール座の中央 Ø14 はケーブル穴兼水抜き。
- **GPS アンテナ**: 箱の蓋の上 (最頂部)。デッキは関与しない。北壁の引込みグランドは未定。
- **工具アクセス**: 箱固定 M4 は蓋を開けて上から (箱内側から) 締める前提。ヨークの M5 は
  ヨーク外面のざぐりから六角レンチで締める (デッキ側はインサート)。
- **持ち上げ**: 側壁の紐穴 ×4 に吊り索を通す。箱の蓋やペネトレータを掴まないこと。

## 要確認

1. **箱の外部取付穴の使い方** (ねじを箱内側から下へ通せるか / 穴が貫通か)。現物で確認 →
   通せなければ下から M4 + 箱内ナット (要防水) に変更
2. 浮子実測 → ヨーク・喫水の再計算 (デッキ自体は変わらない)
3. Osmo 固定ジグ (北座) の設計: 座面 (z −60) が喫水線 (≈ −3) より下なので、ケースをそのまま座に付ければ水中
4. ペネトレータ頭 (箱外 22 mm) とケーブルの曲げ半径 (切欠きまでの落差 65 mm)

## parts/parent/exterior/printed/parent_spar_ballast_body/parent_spar_ballast_body.md

# parent_spar_ballast_body

親機ねじ固定外装。数量 1。寸法 [120.0, 120.0, 51.0] mm（印刷姿勢）。

設計ソースは `scad/lib/parent_spar_bolted.scad` の `ballast_body`。
印刷用STLは `print_jobs/parent_spar_bolted/parent_spar_ballast_body.stl`。部品フォルダのSTL/STEPは組立座標。

締結表・材料・組立順・未検証条件は `assemblies/parent_spar_bolted/README.md` を参照。
閉じた単一メッシュ・250 mm枠・5 mmブリムを含む保守的なベッド配置を機械確認。
実荷重の安全率・疲労・水密性は未評価。

## parts/parent/exterior/printed/parent_spar_ballast_lid/parent_spar_ballast_lid.md

# parent_spar_ballast_lid

親機ねじ固定外装。数量 1。寸法 [120.0, 120.0, 6.0] mm（印刷姿勢）。

設計ソースは `scad/lib/parent_spar_bolted.scad` の `ballast_lid`。
印刷用STLは `print_jobs/parent_spar_bolted/parent_spar_ballast_lid.stl`。部品フォルダのSTL/STEPは組立座標。

締結表・材料・組立順・未検証条件は `assemblies/parent_spar_bolted/README.md` を参照。
閉じた単一メッシュ・250 mm枠・5 mmブリムを含む保守的なベッド配置を機械確認。
実荷重の安全率・疲労・水密性は未評価。

## parts/parent/exterior/printed/parent_spar_beam_lower/parent_spar_beam_lower.md

# parent_spar_beam_lower

親機ねじ固定外装。数量 1。寸法 [180.0, 32.0, 32.0] mm（印刷姿勢）。

設計ソースは `scad/lib/parent_spar_bolted.scad` の `beam_lower`。
印刷用STLは `print_jobs/parent_spar_bolted/parent_spar_beam_lower.stl`。部品フォルダのSTL/STEPは組立座標。

締結表・材料・組立順・未検証条件は `assemblies/parent_spar_bolted/README.md` を参照。
閉じた単一メッシュ・250 mm枠・5 mmブリムを含む保守的なベッド配置を機械確認。
実荷重の安全率・疲労・水密性は未評価。

## parts/parent/exterior/printed/parent_spar_beam_upper/parent_spar_beam_upper.md

# parent_spar_beam_upper

親機ねじ固定外装。数量 1。寸法 [107.0, 32.0, 32.0] mm（印刷姿勢）。

設計ソースは `scad/lib/parent_spar_bolted.scad` の `beam_upper`。
印刷用STLは `print_jobs/parent_spar_bolted/parent_spar_beam_upper.stl`。部品フォルダのSTL/STEPは組立座標。

締結表・材料・組立順・未検証条件は `assemblies/parent_spar_bolted/README.md` を参照。
閉じた単一メッシュ・250 mm枠・5 mmブリムを含む保守的なベッド配置を機械確認。
実荷重の安全率・疲労・水密性は未評価。

## parts/parent/exterior/printed/parent_spar_camera_bridge/parent_spar_camera_bridge.md

# parent_spar_camera_bridge

親機ねじ固定外装。数量 1。寸法 [140.0, 78.0, 180.0] mm（印刷姿勢）。

設計ソースは `scad/lib/parent_spar_bolted.scad` の `camera_bridge`。
印刷用STLは `print_jobs/parent_spar_bolted/parent_spar_camera_bridge.stl`。部品フォルダのSTL/STEPは組立座標。

締結表・材料・組立順・未検証条件は `assemblies/parent_spar_bolted/README.md` を参照。
閉じた単一メッシュ・250 mm枠・5 mmブリムを含む保守的なベッド配置を機械確認。
実荷重の安全率・疲労・水密性は未評価。

## parts/parent/exterior/printed/parent_spar_coupler_half/parent_spar_coupler_half.md

# parent_spar_coupler_half

親機ねじ固定外装。数量 2。寸法 [54.0, 64.0, 26.75] mm（印刷姿勢）。

設計ソースは `scad/lib/parent_spar_bolted.scad` の `coupler_half`。
印刷用STLは `print_jobs/parent_spar_bolted/parent_spar_coupler_half.stl`。部品フォルダのSTL/STEPは組立座標。

締結表・材料・組立順・未検証条件は `assemblies/parent_spar_bolted/README.md` を参照。
閉じた単一メッシュ・250 mm枠・5 mmブリムを含む保守的なベッド配置を機械確認。
実荷重の安全率・疲労・水密性は未評価。

## parts/parent/exterior/printed/parent_spar_disk/parent_spar_disk.md

# parent_spar_disk

親機ねじ固定外装。数量 1。寸法 [225.0, 225.0, 5.0] mm（印刷姿勢）。

設計ソースは `scad/lib/parent_spar_bolted.scad` の `disk`。
印刷用STLは `print_jobs/parent_spar_bolted/parent_spar_disk.stl`。部品フォルダのSTL/STEPは組立座標。

締結表・材料・組立順・未検証条件は `assemblies/parent_spar_bolted/README.md` を参照。
閉じた単一メッシュ・250 mm枠・5 mmブリムを含む保守的なベッド配置を機械確認。
実荷重の安全率・疲労・水密性は未評価。

## parts/parent/exterior/printed/parent_spar_fin/parent_spar_fin.md

# parent_spar_fin

親機ねじ固定外装。数量 4。寸法 [65.0, 125.0, 4.0] mm（印刷姿勢）。

設計ソースは `scad/lib/parent_spar_bolted.scad` の `fin`。
印刷用STLは `print_jobs/parent_spar_bolted/parent_spar_fin.stl`。部品フォルダのSTL/STEPは組立座標。

締結表・材料・組立順・未検証条件は `assemblies/parent_spar_bolted/README.md` を参照。
閉じた単一メッシュ・250 mm枠・5 mmブリムを含む保守的なベッド配置を機械確認。
実荷重の安全率・疲労・水密性は未評価。

## parts/parent/exterior/printed/parent_spar_float_body/parent_spar_float_body.md

# parent_spar_float_body

親機ねじ固定外装。数量 2。寸法 [225.0, 225.0, 180.0] mm（印刷姿勢）。

設計ソースは `scad/lib/parent_spar_bolted.scad` の `float_body`。
印刷用STLは `print_jobs/parent_spar_bolted/parent_spar_float_body.stl`。部品フォルダのSTL/STEPは組立座標。

締結表・材料・組立順・未検証条件は `assemblies/parent_spar_bolted/README.md` を参照。
閉じた単一メッシュ・250 mm枠・5 mmブリムを含む保守的なベッド配置を機械確認。
実荷重の安全率・疲労・水密性は未評価。

## parts/parent/exterior/printed/parent_spar_float_bottom/parent_spar_float_bottom.md

# parent_spar_float_bottom

親機ねじ固定外装。数量 1。寸法 [225.0, 225.0, 48.0] mm（印刷姿勢）。

設計ソースは `scad/lib/parent_spar_bolted.scad` の `float_bottom`。
印刷用STLは `print_jobs/parent_spar_bolted/parent_spar_float_bottom.stl`。部品フォルダのSTL/STEPは組立座標。

締結表・材料・組立順・未検証条件は `assemblies/parent_spar_bolted/README.md` を参照。
閉じた単一メッシュ・250 mm枠・5 mmブリムを含む保守的なベッド配置を機械確認。
実荷重の安全率・疲労・水密性は未評価。

## parts/parent/exterior/printed/parent_spar_float_lid/parent_spar_float_lid.md

# parent_spar_float_lid

親機ねじ固定外装。数量 2。寸法 [225.0, 225.0, 6.0] mm（印刷姿勢）。

設計ソースは `scad/lib/parent_spar_bolted.scad` の `float_lid`。
印刷用STLは `print_jobs/parent_spar_bolted/parent_spar_float_lid.stl`。部品フォルダのSTL/STEPは組立座標。

締結表・材料・組立順・未検証条件は `assemblies/parent_spar_bolted/README.md` を参照。
閉じた単一メッシュ・250 mm枠・5 mmブリムを含む保守的なベッド配置を機械確認。
実荷重の安全率・疲労・水密性は未評価。

## parts/parent/exterior/printed/parent_spar_float_top/parent_spar_float_top.md

# parent_spar_float_top

親機ねじ固定外装。数量 1。寸法 [225.0, 225.0, 28.0] mm（印刷姿勢）。

設計ソースは `scad/lib/parent_spar_bolted.scad` の `float_top`。
印刷用STLは `print_jobs/parent_spar_bolted/parent_spar_float_top.stl`。部品フォルダのSTL/STEPは組立座標。

締結表・材料・組立順・未検証条件は `assemblies/parent_spar_bolted/README.md` を参照。
閉じた単一メッシュ・250 mm枠・5 mmブリムを含む保守的なベッド配置を機械確認。
実荷重の安全率・疲労・水密性は未評価。

## parts/parent/exterior/printed/parent_spar_gps_bridge/parent_spar_gps_bridge.md

# parent_spar_gps_bridge

親機ねじ固定外装。数量 1。寸法 [183.0, 96.0, 100.0] mm（印刷姿勢）。

設計ソースは `scad/lib/parent_spar_bolted.scad` の `gps_bridge`。
印刷用STLは `print_jobs/parent_spar_bolted/parent_spar_gps_bridge.stl`。部品フォルダのSTL/STEPは組立座標。

締結表・材料・組立順・未検証条件は `assemblies/parent_spar_bolted/README.md` を参照。
閉じた単一メッシュ・250 mm枠・5 mmブリムを含む保守的なベッド配置を機械確認。
実荷重の安全率・疲労・水密性は未評価。

## parts/parent/exterior/printed/parent_spar_hub/parent_spar_hub.md

# parent_spar_hub

親機ねじ固定外装。数量 2。寸法 [88.0, 88.0, 32.0] mm（印刷姿勢）。

設計ソースは `scad/lib/parent_spar_bolted.scad` の `hub`。
印刷用STLは `print_jobs/parent_spar_bolted/parent_spar_hub.stl`。部品フォルダのSTL/STEPは組立座標。

締結表・材料・組立順・未検証条件は `assemblies/parent_spar_bolted/README.md` を参照。
閉じた単一メッシュ・250 mm枠・5 mmブリムを含む保守的なベッド配置を機械確認。
実荷重の安全率・疲労・水密性は未評価。

## parts/parent/interior/printed/parent_lipo_tray/parent_lipo_tray.md

> 2026-09-26: 親機サービス改訂では、6面保持の [parent_lipo_retainer](../parent_lipo_retainer/parent_lipo_retainer.md) を使用。以下は旧ベルクロトレイの比較資料。

# parent_lipo_tray — 親機 LiPo ブリッジトレイ (P-MAIN 上・最上段)

**2026-08-28 新規 (同日、床置き案から上固定案へ変更 — 人間指示「交換しやすく」)。**
親機内装で「宙に浮いた表示」だった LiPo を実体化する部品。P-MAIN の取付穴 4 点に
M3 オス-メス スペーサ 25 mm (`hex_spacer` m3_mf25) を立て、その上に架ける。
**LiPo は最上段**: 蓋を開け、ベルクロ帯を外せば真上に抜ける。

## 役割・主要寸法

| 項目 | 値 |
|---|---|
| 区分 | 親機 / 内装 / 3Dプリント |
| 収容物 | `lipo_3s_2200_zeee` (102 × 34 × 23、リード -X 端) |
| 外形 | 111 × 45 × 17 (ベイ) + 東西レール 8 × 12 × 88.5 (穴 4 点を結ぶ) |
| 原点 | MAIN 南西取付穴 (プレート (6.5,10) = 箱 (20,23.5)) の直上、トレイ下面 |
| 高さ (箱底外面基準) | トレイ下面 **51.4** = MAIN 基板上面 26.4 + スペーサ 25 / LiPo 下面 54.4 / 上面 **77.4** (蓋パッキン面 90.9、余裕 13.5) |
| MAIN との隙間 | 最高部品 (18.49 → z 44.9) とトレイ下面 6.5 |
| 固定 | M3×6 なべ ×4 → スペーサ (穴 Ø3.4、座 Ø9)。スペーサのオス側は MAIN 穴を通ってプレートの M3 ボス下穴へ (MAIN の固定ねじを兼ねる) |
| 拘束 | 4 側壁 (h14) + 床 + ベルクロ帯 ×2 (幅 20、x=24/79)。上は開放 |
| 水抜き | 床 Ø4 ×2 |
| ベイ位置 | プレート座標 (2.5,15)–(113.5,60)。セル (7,20.5)–(109,54.5)。MAIN の南縁 (SD, y<15) と北縁 (ボタン/LED, y>60) を塞がない |

## インタフェース (二重定義の台帳)

| 変数 | 相手 | 値 |
|---|---|---|
| `lipo_l/w/h` | `lipo_3s_2200_zeee.md` / `child_vtray_batt_box.scad` | 102 / 34 / 23 (商品仕様、実測待ち) |
| `hole_px/py` | `PARENT_MAIN.kicad_pcb` (穴 (4.5,4.5)–(107.5,80)) / `parent_plate.main_h` | 103 × 75.5 |
| `spacer_l` | `hex_spacer` m3_mf25 | 25 |
| `plate_top_z`, `main_top_comp` | `parent_plate` (13.8+5) / `parent_main.md` | 18.8 / 18.49 |
| `LIPO_TRAY`, `LIPO_SPACER` | `spec/parent_interior_layout.py` | (7,20.5,102,34) / 25 |

## 干渉チェック

`.scad` の assert: ベイ中心 = 穴スパン中心 / ベイ壁が穴の座に掛からない / トレイ下面と
MAIN 最高部品 ≥ 3 / LiPo 上面と蓋 ≥ 10 (手掛かり) / 帯スロット ↔ 端壁・水抜き穴 /
レール高さ ≥ 10 (強度) / レールがベイに接続。`spec/parent_interior_layout.py`
`check_lipo_bridge` でも同じ高さとベイ帯 (SD/ボタン回避) を検査。ビルド watertight。

## 荷重ケースと強度

| ケース | 荷重 | 結果 (`quick_strength.py`, PETG, 面内) |
|---|---|---|
| レール (北穴への片持ち近似): LiPo 170 g の半分 × 落下 10 | 8.5 N、L 75、8 × **12** | 応力 3.3 MPa (許容 19)、たわみ 0.59 mm — PASS (t3 では 37 mm で不可 → 高さ 12 に決定) |
| ベイ床 | 17 N 分布、106 × 40 × t3 | 応力 0.48 MPa、たわみ 0.02 mm — PASS |

実際は両端支持 (南北 2 穴) なので片持ち近似より硬い。FEA は省略 (閉形式で SF > 5)。

## 印刷指示

- **向き: 平置き (+Z 上)**。オーバーハング無し、**サポート不要**
- **材料: PETG**、**インフィル 30%**、ウォール 3 周
- X1C 監査: `topopt print` PASS (下記ビルド記録)

## 部品外の考慮

- **電池交換**: 蓋 (ビス 4 本) を開ける → ベルクロ帯 2 本を外す → LiPo を真上に抜く。
  プレートも基板も触らない。上面から蓋まで 13.5 mm の指掛かり
- リードは西端壁の切欠き (幅 20) から出て、プレート西縁沿いに北へ下り P-PWR `J_BAT`
  (プレート (8.8,157.1)、開口 -X 向き、z≈25) へ。トレイ (z 54) からの落差 ≈30 + 北へ ≈120
  → **リード実長 ≥150 mm が要る (現物実測待ち)**。足りなければ LiPo を 180° 逆向き
  (リード東) にして東縁経由も可 (帯・切欠きは対称)
- 東西レールは MAIN の東西縁の真上 (z 51.4) を通る。MAIN 南東角の `J_TETH1` (x≈109.5)
  の直上に東レールの座がある → **テザー線の抜き差し方向 (上向きなら干渉) を要確認**
- LiPo の膨らみ: 幅方向 +3/+3、上は開放。**きつく囲わない**
- **密閉容器内で充電しない**
- 重心: 最重量物が z≈66 (最上段)。箱内装のみの重心は床置き案と ±1 mm しか変わらず、
  復元力はマスト下端バラストで確保する方針 (2026-08-28 判断)

## 要確認

- [ ] LiPo 現物実測 (102×34×23 ±2) → `end_pad` / `side_pad`
- [ ] リード実長 (≥150 mm 必要) と向き
- [ ] `J_TETH1` の抜き差し方向と東レール座の干渉
- [ ] MAIN 最高部品 18.49 の実測 (トレイ下面との隙間 6.5)
- [ ] `part_index.py lock` は人間未確認 (`--confirmed` なし)

## parts/parent/interior/printed/parent_plate/parent_plate.md

# parent_plate — 親機 防水ボックス内 マウントプレート (183×203 t5, 2バリアント)

> **2026-08-28 追記 (浮き部品の実体化・箱図面反映):** LiPo は P-MAIN 上のブリッジトレイ
> `parent_lipo_tray` (MAIN 穴に M3 MF25 スペーサ) で上固定。南側ピンは**タカチ図面 DXF の
> タッピングボス実位置** (65,25)/(105,25) → プレート (51.5,11.5)/(91.5,11.5) に確定。
> LCD 下穴はボス直上を避けて (72,192)/(110,192)。p2: カメラマウント足穴 44 角 + 脚 Ø7.5、
> `vp_off` 53→54。プレート高さは元の z=13.8 (ボス 10 仮) のまま。

**2026-08-28 全面改版。** 旧設計 (175×180、モジュール単位の仮置き) は
アーキテクチャ変更 (UI 基板廃止・RS485/BUCK/RTC の P-MAIN/P-PWR への統合) で
無効になったため破棄した。現行は KiCad 実基板 3 枚 + SPRESENSE 拡張 + LiPo を
載せる。配置の根拠と検証は `spec/parent_interior_layout.py`
(プレビュー: `spec/_work/images/parent_layout_p1.png` / `_p2.png`)。

## 役割

タカチ **BCAS212310G** (選定案・人間確認待ち → `parts/parent/exterior/cots/bcas212310g/`)
の内部ボス (z≈10) に載る、全内装モジュールの取付基準面。
BMP2123Z (純正鉄プレート 183×203) 互換の外形・穴ピッチ。

## バリアント

| 接尾辞 | pattern | 内容 |
|---|---|---|
| `p1` | 1 | 親機カメラ = DJI Osmo Action 6 (外付け)。TX はプレート直付け (121,77) |
| `p2` | 2 | 親機カメラ = Pi Zero 2W + GS カメラ内蔵。底面ビューポート開口 Ø36 (+X53)、カメラマウント下穴、Pi Zero ボス追加。TX は (117,127) で Pi Zero 上に z+30 高架 |

## 配置 (プレート左下原点, 単位 mm)

| モジュール | p1 | p2 | 取付 |
|---|---|---|---|
| P-MAIN 112×88 | (2,2) | 同左 | M3 ボス ×4 (kicad 穴 103×75.5 を y 反転変換)。ボタン/LED/DS3231 縁が北、microSD 縁が南 |
| P-PWR 100×84 | (2,95) | 同左 | M3 ボス ×4 (90×74) |
| SPRESENSE 拡張 68.6×53.5 | (121,2) 90°回転 | 同左 | M3 ボス ×4 (inset 3.5 仮) |
| TX_improved 74×50 | (121,77) 90°回転 | (117,127) 90°回転 | M3 ボス ×4 (42×66)。p2 は 30mm スタンドオフで高架 |
| LiPo 102×34 | **MAIN 上のブリッジトレイ** (`parent_lipo_tray`, セル (7,20.5)-(109,54.5)、下面 z=51.4) | 同左 | MAIN 穴 103×75.5 に `hex_spacer` m3_mf25 ×4 (MAIN 固定ねじ兼用) |
| Pi Zero 2W 30×65 | — | (127,135) 90°回転 | M2.5 ボス ×4 (23×58) |
| GS カメラ | — | ビューポート中心 (144.5,101.5) | `parent_cam_mount` 足穴 M3 下穴 ×4 **44 角** (`cam_hole_sq`)。カメラ自体の穴 34 角はマウント側 |
| LCD ブラケット | 北縁 (30..115, 183..201) | 同左 | M3 下穴 ×2 (仮)。ブラケット別部品・未設計 |

## 主要寸法・箱との取合い

- 外形 183 × 203 × t5、コーナー 45° カット 8 (**仮値**)
- 固定: 北側 2 箇所 M4 皿ねじ (ピッチ 160×180 の北列 → 箱コーナー M4 インサート、
  蓋を開けて上からアクセス可) + 南側位置決めピン Ø3.2 ×2 (`pin_pos` = (51.5,11.5)/(91.5,11.5)
  = 箱の M4 タッピングボス (65,25)/(105,25) 下穴 Ø3.4、**図面 DXF 実座標**。基板の下に
  隠れてよい)。**南側コーナーインサートは基板下で工具が届かないためねじ固定しない**
  (組立順: プレート挿入 → 基板をボスに締結)
- 高さ: プレート下面 z = 3.8 + 10 (ボス高さ仮) = **13.8**、上面 18.8 (箱底外面基準)
- 箱のタッピングボス 10 個のうち 6 個がプレート下に来る (プレート座標 (11.5,61.5)
  (11.5,141.5) (171.5,61.5) (171.5,141.5) (131.5,11.5) (51.5/91.5/131.5,191.5))。
  `.scad` でプレートの切欠きと重ならないことを assert (LCD 下穴を (55,192)→(72,192) に
  移した実例あり)
- M3 ボス Ø7 h6 (下穴 Ø2.6 貫通 = 水抜き兼用)、Pi Zero ボス Ø6 h6 (下穴 Ø2.0)
- 結束バンドスロット 3×10 ×5 (中央通路 x116.5 / 東縁 x176)

## 干渉チェック

`.scad` 内でフィーチャ表 (`feats`) の**総当り検査** (切欠き間ウェブ ≥2、突起間 ≥0.5、
縁 ≥1.5、コーナーカットから ≥ 半径+2)。皿座グリ Ø9 を「ねじ頭の座」、p2 のカメラ
マウント脚 Ø7.5 を「突起」として表に含めている。加えて箱側タッピングボス (図面) と
プレート切欠きの重なりを検査。ビューポートはマストフランジ 70 角 +2 / 浮子開口 Ø140 の成立条件も
assert。ビルドは両バリアントとも watertight、preview 目視済み。

## 荷重ケースと強度

- 荷重: 搭載物 ≈0.85 kg (基板 3 + SPRESENSE + LiPo + ブラケット類) を
  取り回し係数 4 で 37 N 分布荷重。
- `quick_strength.py plate --a 203 --b 183 --t 5 --p 0.001` (PETG, in-plane):
  応力 0.31 MPa (許容 19) **SF≈61**、中央たわみ 0.13 mm (四辺支持)。
  実際は 4 点支持でたわみは数倍になるが 1 mm 未満の見込み。
- FEA は箱実測 → 仮値確定後に実施 (要確認に記載)。

## 印刷

- **向き: 平置き (+Z 上)**。X1C 監査 PASS (最薄部 2.93 mm、荷重は層面内 cos=0)
- **サポート: 下面の位置決めピン 2 本の直下のみ**。他は不要
- 材料 PETG / インフィル 40% / ウォール 3 周

## 部品外の考慮

- 箱壁の貫通は南壁 2 = **WetLink M10 ペネトレータ** (x=120 テザー / x=85 TD04A、軸 z=65。
  2026-08-29 モデル化) / 北壁 1 = GPS 引込み (未定)。プレート上面 z=18.8 に対して
  ペネトレータは z=65 なので当たらないが、**箱内に出るのは素の導体**なので
  端子台とサービスループの置き場がプレート上に要る (未設計)。
  引込みは壁上部 → サービスループでプレートへ降ろす。中央通路 (x≈115) と
  東縁のスロットで結束。詳細は `docs/配線・ケーブル計画.md`
- 電池は最上段 (MAIN 上のブリッジトレイ) = 毎セッションの交換動線を確保 (2026-08-28 人間判断)
- 重心の調整は箱内ではなくマスト下端バラストで行う
- microSD: P-MAIN 南縁 (上向きスロット)・SPRESENSE 拡張 (上面開放) とも上から抜き差し可
- マストクランプ M5×4 のボルト頭 (箱底内側, ±28) はプレート下の空間 (z<10) に収まる
- p2 ビューポートの視野にマストが入る (中心から約 6°)。子機マーカーの隠れは要評価

## 要確認 (これが解消するまで印刷しない)

- [ ] **箱型番の人間承認** (BCAS212310G 選定案)
- [ ] 箱実測 (または 3D STEP): **ボス高さ** (`BOSS_H=10` 仮) / タッピングボスがインサートと同高か / コーナー柱 (`corner_cut=8` 仮、図面上は余裕 ≈4.5)。インサートピッチ 160×180・タッピングボス位置は図面 DXF で確定済み
- [ ] SPRESENSE 拡張ボードの取付穴実測 (`spr_inset=3.5` 仮)
- [x] GS カメラマウント足穴 (`cam_hole_sq=44`、`parent_cam_mount.foot_sq` と二重定義) — 2026-08-28 確定
- [ ] LCD ブラケット穴 (`lcd_pos` 仮 — ブラケット設計時に確定)
- [x] LiPo トレイ (`parent_lipo_tray`)・カメラマウント (`parent_cam_mount`)・TX 高架スペーサ (`hex_spacer` m3_mf25) — 2026-08-28 設計済み
- [ ] LCD ブラケット (`parent_lcd_bracket`) — 未設計
- [ ] 箱仮値確定後に FEA (`topopt fea`)

## インタフェース (二重定義の台帳)

| 変数 | 相手 | 値 |
|---|---|---|
| `px, py, m4_pitch_*, corner_cut` | `bcas212310g.md` / 箱実測 | 183, 203, 160×180, 8 |
| `pin_pos` (← `box_tap_south`), `pin_d` | `bcas212310g.scad tap_pos` (図面 DXF) | (65,25)/(105,25) 箱座標 → (51.5,11.5)/(91.5,11.5)、Ø3.2 (下穴 3.4) |
| `main_h` (MAIN 穴) | `parent_lipo_tray.hole_px/py` | 103 × 75.5 |
| `cam_hole_sq, cam_pilot, cam_leg_d, vp_off` | `parent_cam_mount.scad` (`foot_sq/foot_d/leg_d`) / `spec VP_OFF` | 44, 2.6, 7.5, 54 |
| `lcd_pos` | `parent_lcd_bracket` (未設計) | (72,192)/(110,192) — 箱ボス直上を避けた位置 |
| `main_pos` ほか配置座標 | `spec/parent_interior_layout.py` | 完全一致させること |
| 基板穴ピッチ | `hardware/pcb/*/[*.kicad_pcb]` | MAIN 103×75.5 / PWR 90×74 / TX 42×66 (回転後) |
| `vp_off=53` | `parent_mast_clamp` (フランジ70角) / `parent_float_segment` (ID140) | 成立域 52..55 |
