AquaBeacon/mechanical/assemblies/parent_spar_concept/parts/DESIGN_NOTES.md

# 設計・印刷条件の控え（自動生成）

以下は設計元の文書を転記したものです。リンク先は元フォルダ基準です。印刷条件と未検証事項を確認してください。

## parent_spar_concept/README.md

**印刷一式:** [parts/PRINT.md](parts/PRINT.md)（STL・数量・モディファイア） · **確認画像:** [_work/images/](_work/images/)

# parent_spar_concept

- [parent_spar_concept.md](parent_spar_concept.md)
- [adapter.step](adapter.step)
- [adapter.stl](adapter.stl)
- [coupler.step](coupler.step)
- [coupler.stl](coupler.stl)
- [disk.step](disk.step)
- [disk.stl](disk.stl)
- [fin.step](fin.step)
- [fin.stl](fin.stl)
- [hub.step](hub.step)
- [hub.stl](hub.stl)
- [parent_spar_concept.scad](parent_spar_concept.scad)

構成と既存の未検証事項は上の設計説明を参照してください。

## assemblies/parent_spar_concept/parent_spar_concept.md

# 親機・縦長外装案（2026-09-09）

2026-09-10改訂版は [ねじ固定・X1 Carbon対応版](../parent_spar_bolted/README.md)。本フォルダは旧配置検討案として保存。

既存タカチ BCAS212310G を使うという今回の確認を反映した外装の一次設計。旧 `parent_assembly` は変更していない。OpenSCAD の `part` を切り替えて全体・分解配置・個別部品を表示する。全体の浮体、錘、カメラ、GPS、IMU、蓋は配置用包絡形状であり、製造用の防水部品ではない。

## 構成と寸法

上から GPS アンテナ、既存タカチ箱（カメラは前面・IMUは内部の位置予約）、既存 parent_deck、縦長浮体、分割角支柱、十字フィン、水平円盤、錘。単位 mm。Z=0 は浮体下端であり、水面ではない。

|要素|寸法・数量|状態|
|---|---|---|
|上部の箱|210×230×約100.3|既存モデル使用、内装変更なし|
|デッキ|216×236|既存モデル使用|
|浮体|外径180、高さ240、中央42角の通し穴|閉孔フォーム等の仮包絡。固定と材料未確定|
|水平円盤|直径225×厚さ5、1枚|XY平面、水面と平行になる設計姿勢|
|垂直フィン|高さ125×幅65×厚さ4、4枚|90°間隔。幅には根元の差込み12を含む|
|フィンハブ|60×60×24、2個|四方向の差込み溝、フィン1枚につき上下M5各1本|
|支柱|25角、上側230・下側355|金属角管の包絡。肉厚、材質、加工穴は未確定|
|分割継手|40角×長さ80、1個|M6通しピン2本、角管を各40差込み|
|デッキ接続部|50角、全高60、1個|既存中央HP40座にM5×4。支柱固定M6×1|
|錘|直径90×高さ35|包絡のみ。重量・材質・脱落防止金具は未確定|
|全高|約773.3（支柱最下端からGPS上端）|カメラ・GPSは仮寸法|

## 搬送と組立

1. 上部（箱・デッキ・浮体・上側支柱）を一体で運ぶ。最大高さ約418.3。上部筐体のシールを開けずに下部を外せる方針。
2. 下部支柱を継手に差し込み、M6通しピンを抜止め付きで固定する。モデルのピン中心は継手中心から上下20。実際の金属角管にも対応する加工が必要。
3. 垂直フィンを上下ハブに差し込み、M5通しボルト・座金・ナットで固定する。上下ハブ間のフィン穴ピッチは101。
4. 円盤は下ハブ底面へM5×4で固定。ハブを支柱に軸方向固定するストッパーと、錘の荷重を受ける金属金具は別途必要。現モデルはこれらの詳細を含まない。
5. 完全分解すれば円盤は225×225×5、フィン4枚は65×125×16に重ねられる。`packed` は部品の平置き表示であり、収納箱の最適化結果ではない。部品の枚数・ナット数が多いため、現場ではフィンユニットを組んだまま継手だけを外す運用も可能。

## 波による揺れへの設計意図

下部の錘で重心を下げ、水平円盤と垂直4枚の水中抵抗で揺れを減らすことを狙う。効果の大きさや転覆しないことは未検証。旧双胴フロート用 `parent_hydrostatics.py` のGM・喫水値はこの構成には適用できない。

浮体の外形体積は約6.11 Lだが、中心穴と上部切欠きがあるため有効排水量はこれより小さい。これを積載可能重量として扱わない。総重量、浮体材の吸水・密度、上部機器の重心、テザー張力、錘の水中重量から喫水・復原性を再計算する必要がある。円盤と4枚のフィンが常時水中にある喫水を目標とする。

## 製作前に確定する項目

- 浮体の現物・材質・固定方式。フォームの包絡形状を中空FDM容器として印刷しない。
- 錘の質量と金属による荷重経路。プリント継手だけで吊り荷重を保証しない。
- カメラ（現行のOsmo防水ケースか別機種か）、撮影方向、GPSアンテナ、IMUの型番と固定穴。表示は70×30×50、直径60×18、30×30×6の予約空間であり、実機の寸法保証ではない。
- 上部のM6ピンへアクセスするための浮体分割または工具窓。浮体は着脱できるクランプ方式等を次工程で設計する。
- テザー・TD04Aの取付とケーブル経路。今回の構成に未配置。円盤への巻付きやフィンとの接触を避ける配索と張力止めが必要。
- 金属角管と穴の公差、抜止め、座金、ハブの軸方向ストッパー。スライド嵌合は全幅+0.5の仮値。
- 箱上の蓋・ケーブル引込み・カメラ取付の防水方法。既存箱の密閉性を変更する加工は未設計。

## 出力と検証

`disk / fin / hub / coupler / adapter` のSTLは印刷方向で出力。フィンは広い面を下、円盤は水平、ハブ・継手は軸方向を立て、アダプタはデッキ接触面を下にする。横穴は穴仕上げを前提とする。PETG等での試作を想定し、強度・耐候性・水密性の評価は別途。

`verify.py` はOpenSCADで5種類をレンダリングし、trimeshで寸法・単一ボディ・閉じたメッシュを検査して `mesh_checks.json` に保存する。閉じたメッシュという判定は実物の水密性・強度を意味しない。全体プレビューを目視確認。製品全体の接触検査・波浪試験・浮力試験は未実施。

`export_step.py` は既存のCSG→STEP変換器で部品ごとのSTEPを出力し、STLとの外形・体積照合を行う。全体は配置検討用SCAD、部品STL/STEPは形状試作用。量産・実海域投入用の完成設計ではない。

## assemblies/parent_spar_concept/README.md

**印刷一式:** [parts/PRINT.md](parts/PRINT.md)（STL・数量・モディファイア） · **確認画像:** [_work/images/](_work/images/)

# parent_spar_concept

- [parent_spar_concept.md](parent_spar_concept.md)
- [adapter.step](adapter.step)
- [adapter.stl](adapter.stl)
- [coupler.step](coupler.step)
- [coupler.stl](coupler.stl)
- [disk.step](disk.step)
- [disk.stl](disk.stl)
- [fin.step](fin.step)
- [fin.stl](fin.stl)
- [hub.step](hub.step)
- [hub.stl](hub.stl)
- [parent_spar_concept.scad](parent_spar_concept.scad)

構成と既存の未検証事項は上の設計説明を参照してください。

## parts/parent/exterior/printed/parent_deck/parent_deck.md

# parent_deck — 親機 デッキ (防水ボックス台 + 浮子ヨーク取付 + 下面ハードポイント)

| 項目 | 値 |
|---|---|
| 区分 | 親機 / 外装 / 3Dプリント |
| 設計ソース | `parent_deck.scad` |
| 個数 | 1 |
| 外形 | 216 × 236 × 60 mm (デッキ上面 z=0、キール座面 z=−60) |
| 体積 (中実) | 839 cm³ → PETG 壁 4 + インフィル 25 % で **約 0.43 kg** |
| STEP | 1 ソリッド / 219 面 / watertight |

## 役割 (2026-09-04 人間決定の親機外装構成)

- **浮子 2 個・支柱 (マスト) 無し・カメラは Osmo Action 6 + 純正防水ケース (ジグは後日)**。
- タカチ **BCAS212310G** を上に載せ、箱底コーナーの**外部取付穴 Ø4.2 ×4** (図面 E-E、
  箱中心から (±96, ±106)) に上から M4 を通し、デッキの **M4 熱圧入インサート** ×4 で受ける。
- 左右 (±X) 側壁の外面に **HP40 座 ×2 / 側** (Y ±70, z −25) → `parent_float_yoke` (浮子の端受け、
  2026-09-05 にアーチ式クレードルから置換) を M5 ×4 で締結。ヨークを外せば同じ座に別のアクセサリを付けられる (拡張性)。
- 下面中央の**キール** (壁 2 枚 + 端壁 2 枚 + 座板 3 枚) の底面 (z −60) に **HP40 座 ×3**
  (Y −70 / 0 / +70) → 南 = TD04A ソケット (`xdcr_socket_parent`, 開口下向き)、
  北 = **Osmo 固定ジグ用 (予約)**、中央 = 予備。
- 紐穴: 側壁両端 **Ø8 ×4** (X 貫通、Y ±108, z −35) = 吊り索 / 浮子の紐の予備の結び点 (ヨークのフィンに同軸の Ø8 穴があり塞がれない)。
- **南縁ケーブル切欠き** (X −30..25、深さ 8) = 南壁ペネトレータ ×2 (箱 x=85/120 →
  デッキ X −20/+15) から降りるケーブルをデッキ下へ回す。キール南端壁の **Ø8 フェアリード ×2**
  (X ±9, z −30) でテザー / TD04A ケーブルの張力止め (結束バンド or 結び目)。

## 座標系

箱中心 = 原点、デッキ上面 (= 箱底外面) z=0、+Y = 北 (箱の北壁側)。
**箱座標 (x, y) → デッキ (x − 105, y − 115)**。

## 主要寸法

| 変数 | 値 | 意味 |
|---|---|---|
| `plate_x / plate_y / plate_t` | 216 / 236 / 6 | デッキ板 (箱カバー外形 210 × 230 + 3/側) |
| `ear_x / ear_y / ear_pilot_d / ear_pilot_h` | ±96 / ±106 / 5.6 / 9 | 箱固定 M4 インサート下穴 (上から) |
| `lip_t / lip_h` | 17 / 50 | 側壁 (X ±91..±108)。厚 17 = HP40 下穴 9 + 箱取付穴が板内に収まる下限 16 + 1 |
| `hp_lip_y / hp_lip_z` | [−70, 70] / −25 | 側壁 HP40 座中心 (座面 X = ±108) |
| `rope_d / rope_y / rope_z` | 8 / ±108 / −35 | 側壁 紐穴 |
| `win_w / win_h / win_z0` | 36 / 14 / −44 | 側壁の軽量窓 (45° 屋根、X 貫通) |
| `keel_wall_t / keel_wall_x / keel_y / keel_wall_z` | 8 / 16 / ±105 / −50 | キール壁 X ±16..±24 |
| `pad_t / pad_w / hp_keel_y` | 10 / 50 / [−70, 0, 70] | キール座板 (座面 z −60) |
| `end_wall_t / fair_d / fair_x / fair_z` | 6 / 8 / ±9 / −30 | キール端壁とフェアリード |
| `notch_x0 / notch_x1 / notch_d` | −30 / 25 / 8 | 南縁ケーブル切欠き |

HP40 の定数 (`hp_pitch 40 / hp_ins_d 6.4 / hp_ins_h 8 / hp_pad 50 / hp_cable_d 14`) は
`scad/lib/hardpoint.scad` と二重定義 (`use` なので定数が見えない)。

## インタフェース

| 相手 | 内容 |
|---|---|
| `bcas212310g` | 箱底コーナー Ø4.2 ×4 @ (±96, ±106) ← M4 ×16 (上から) → デッキ M4 インサート。箱の胴体 (約 204 × 224) がデッキ板に載る。**ねじの向き (上から / 下から) は現物で要確認** (図面 E-E では 6 厚の足に Ø4.2) |
| `parent_float_yoke` ×4 | 側壁外面 HP40 ×2 / 側 (Y ±70, z −25)。M5 ×25 ×4 / 座。ヨークのアダプタ板 (56 角) は座より 3 大きく、デッキ上面より 3 上・側壁下端より 3 下に出る (デッキ板の縁の外側なので干渉なし) |
| `xdcr_socket_parent` | キール南座 (0, −70, −60)。M5 ×4 @ ±20 (ソケット `hole_p 40` = HP40) |
| Osmo 固定ジグ (未設計) | キール北座 (0, +70, −60)。HP40 アダプタ板 (t6, M5 バカ穴 Ø5.4 ×4, 中央 Ø14) を持たせること |
| `wetlink_penetrator_m10` ×2 | 南壁 (デッキ Y −115) x=−20/+15、軸 z 65、頭は箱外 Y −137..−115 → デッキ南縁 (−118) の外で干渉なし。ケーブルは南縁切欠きから下へ |

## 干渉チェック (`.scad` 冒頭の assert)

- 箱の取付穴 Ø5.6 が側壁の板厚 (X 91..108) に収まる / インサート下穴が側壁を突き抜けない
- 側壁の YZ 面フィーチャ表 (HP40 下穴 ×8 + 中央穴 ×2 + 紐穴 ×2 + 箱取付穴 ×2) を**総当り**で離隔 ≥ 3
- 軽量窓が HP40 座・側壁下端・デッキ板 (45° 屋根の頂点) から離れる
- キール座の HP40 下穴 Ø6.4 @ ±20 が壁 (X ±16..±24) の真下にある (母材) / 座同士 ≥ 座 + 10 / 端壁と重ならない
- フェアリード穴がキール壁・端壁高さに収まる
- 南縁切欠きが箱の胴体壁の下を 3 以上残す / ペネトレータ直下を覆う / 側壁に掛からない
- 250³ 造形枠

実際に止めたもの (2026-09-04): 箱取付穴が側壁板厚 14 に収まらない → 17 へ /
キール座下穴が壁の真下に無い → 壁 X 17 → 16 / キール座が端壁に掛かる → 壁半長 100 → 105。

## 荷重ケースと強度

| ケース | 荷重 | 係数 | 入力 | 受け |
|---|---|---|---|---|
| L1 定常 | 箱+内装 1.05 kg + アクセサリ 0.7 kg | 1 | デッキ板上面 | 側壁 HP40 (ヨーク) |
| **L2 取り回し** | 同上 2.45 kg → **120 N** | 5 | デッキ板上面 | 側壁 HP40 ×8 ボルト (15 N/本) |
| L2b テザー引き | 50 N (−Y) | 3 | キール南端フェアリード | 側壁 |
| L3 落下 | アクセサリ 0.4 kg → 40 N | 10 | キール南座 | 側壁 |

`quick_strength.py` (PETG, 面内): 板 (236 × 94 × 6, 100 N) 0.33 MPa / 0.04 mm ✅、
側壁を片持ち梁 (L236 b14 h50, 175 N 先端) と見ても 7.1 MPa ✅ (たわみ 3.0 mm は片持ち仮定の
過大評価。実際は両ヨーク座 (Y ±70) で支持されるので梁長は 140)、
M5 インサート引抜き 0.25 MPa ✅、M4 インサート (箱固定) ✅。

### FEA 結果 (`fea/study.json` → `topopt fea --voxel 2.16`, 出力 `fea/out/`, 2026-09-04)

PETG 直交異方性カード (`petg_generic_fff_orthotropic_v1`)、build 軸 Z、87,124 要素、
メッシュ解像度 PASS (最薄部 8.6 mm に 4 要素)。支持 = 両側壁の HP40 座面 (X ±108 帯)。

| ケース | 荷重 | 最大変位 | von Mises 最大 | 安全率 (最悪 / p99.5) | 判定 |
|---|---|---|---|---|---|
| L2 持ち上げ | 120 N 下向き (デッキ上面) + 自重 ×5 | 0.15 mm | 1.2 MPa | 30 / 47 | ✅ |
| L3 落下 | 40 N (キール南座) + 自重 ×10 | 0.24 mm | 2.2 MPa | 17 / 37 | ✅ |
| L2b テザー引き | 50 N (−Y, 南端フェアリード) + 自重 ×3 | 0.07 mm | 0.7 MPa | 51 / 133 | ✅ |

ホットスポットは箱取付インサート穴の縁 (±96, ±101) と南端壁の根元 — いずれも SF ≥ 17。
たわみは全ケース 0.25 mm 以下 (許容 1.0)。**律速は強度ではなく浮力** (上記 部品外の考慮)。

## 印刷 (X1-Carbon)

- **上下反転** (デッキ上面をベッドに)。側壁・キール壁・座がベッドから立つ。`topopt overhang`
  (反転 STL): **要サポート面積 3.6 %** = キール座板 (t10) の壁間 32 mm ブリッジ ×3 と側壁窓の
  45° 屋根。**サポート不要** (X1C のブリッジで可。気になれば座板下のみサポート)。
- 主引張 (側壁の曲げ = Y 方向、板の曲げ = XY 面内) は層面内。`topopt print --keep-flat Z` の
  「load vs layers FAIL」は `--load-axis 0,0,1` を与えたためで、実荷重方向 (Y) では PASS。
- 材料 PETG (屋外・水・紫外線なら ASA)。壁 4 本 / インフィル 25 % (ジャイロイド) / 上下 5 層。
- HP40 のインサート下穴 (Ø6.4) は反転印刷で座板側が上面になるので、印刷後にそのまま熱圧入できる。
  側壁の横穴 (Ø6.4 / Ø8 / Ø14) は水平穴 = 上面がやや垂れる。Ø6.4 は熱圧入時に馴染む。
- 反り対策: 216 × 236 の全面ベッド接触。ブリム 5 mm、ベッド中央。

## 部品外の考慮

- **ケーブル**: 南壁ペネトレータ (箱外 z 65) → 南縁切欠き → キール南端フェアリード →
  南座ソケットの底穴 Ø9 / HP40 中央 Ø14。TD04A の 3P プラグは通らないので**箱内で切って
  端子台**に落とす (`wetlink_penetrator_m10.md`)。テザーは南端フェアリードで**張力止め**を
  してからペネトレータへ (シール部に引張をかけない)。
- **喫水**: 浮子軸 z 0・総質量 3.14 kg で喫水線は **z ≈ −2.7** (`spec/parent_hydrostatics.py`) = デッキ板がほぼ全部水中、
  箱底が水面。側壁・キール・TD04A 面 (−104) は水中。デッキは密閉インフィルの PETG なので 0.84 L の浮力体でもある。
  水抜き穴 (キール座の Ø14、側壁窓) から水が入っても抜けるので問題なし。
- **水抜き**: デッキ板上面は箱が覆う。側壁の軽量窓とキール壁間の通路は水が抜ける。
  キール座の中央 Ø14 はケーブル穴兼水抜き。
- **GPS アンテナ**: 箱の蓋の上 (最頂部)。デッキは関与しない。北壁の引込みグランドは未定。
- **工具アクセス**: 箱固定 M4 は蓋を開けて上から (箱内側から) 締める前提。ヨークの M5 は
  ヨーク外面のざぐりから六角レンチで締める (デッキ側はインサート)。
- **持ち上げ**: 側壁の紐穴 ×4 に吊り索を通す。箱の蓋やペネトレータを掴まないこと。

## 要確認

1. **箱の外部取付穴の使い方** (ねじを箱内側から下へ通せるか / 穴が貫通か)。現物で確認 →
   通せなければ下から M4 + 箱内ナット (要防水) に変更
2. 浮子実測 → ヨーク・喫水の再計算 (デッキ自体は変わらない)
3. Osmo 固定ジグ (北座) の設計: 座面 (z −60) が喫水線 (≈ −3) より下なので、ケースをそのまま座に付ければ水中
4. ペネトレータ頭 (箱外 22 mm) とケーブルの曲げ半径 (切欠きまでの落差 65 mm)
