AquaBeacon/mechanical/assemblies/tether_open_reel/parts/DESIGN_NOTES.md

# 設計・印刷条件の控え（自動生成）

以下は設計元の文書を転記したものです。リンク先は元フォルダ基準です。印刷条件と未検証事項を確認してください。

## tether_open_reel/README.md

**印刷一式:** [parts/PRINT.md](parts/PRINT.md)（STL・数量・注意事項）

# テザー30 m・両側開口リール（使用状態）

一つの収納部に巻き、両側の直径120 mmの開口と横入れ溝から端末を出す。前後に分割しない。側板は中央から押せる爪2個で外れる。台は独立した置き台。

[設計・印刷部品・使い方](../../parts/common/jigs/tether_open_reel/tether_open_reel.md)。輸送状態は隣の`tether_open_reel_closed`。

`placement.json`が実配置の正。view SCADは生成物。STEPは部品名付き、STLは組立形状。ケーブル、コネクタ、余長、実際の爪の変形は未反映。実印刷・収納・全体耐荷重は未検証の試作。

## parts/common/jigs/tether_open_reel/tether_open_reel.md

# テザー30 m用・両側開口リール（スナップカバー）

2026-09-26改版。前後15 mずつの収納を廃止し、**一つの巻き収納部**へ変更。直立台、両側開口、印刷爪で外せる側板、印刷クリップで外せる輸送カバー。ネジ・固定ベルトは不要。

## 対象と寸法

ユーザー指定のBlue Robotics Fathom 30 m。既存 `tether_storage_reel.md` と購入記録から標準4ペア・公称外径7.6 mmを対象とする。実測径は未確認。芯径160 mm、表面曲げ半径80 mm（メーカー静的半径75 mm以上）。巻き幅170 mm、巻き外径目標212 mm以下。充填率0.65による容量目安37.01 m。実巻き未確認。

| 部品 | 数 | 印刷外形 mm | 印刷姿勢 |
|---|---:|---|---|
| base | 1 | 約230×230×175 | 側板を下 |
| lid | 1 | 約230×230×35 | 側板を下、爪を上 |
| stand | 1 | 220×190×50 | 底板を下 |
| cover_half | 2 | 236×118×186.8 | 軸を縦、半円リップを下 |
| clip | 4 | 12×18.8×16 | STL姿勢、腕の曲げがXY面内 |
| coupon_socket / coupon_spring | 各1 | 約23×24×36 / 23×18×35 | STL姿勢、小型爪テスト |

リールは直径230×幅180 mm。カバー付きは直径236×幅186.8 mm（クリップの張り出しを除く）。台上の高さは使用時240 mm、カバー付き246 mm程度。最大印刷部品236×118×186.8 mmでX1 Carbonに収まる。台は載せるだけの独立部品で、リールに固定されない。

## 両端の扱い

中央開口は両側とも直径120 mm。側板と芯に幅14 mmの横入れ溝がある。巻き始めの端を中央側、巻き終わりの端を外側に残して巻く。接続済みケーブルは横入れ溝から取り付けられ、コネクタを穴に通す必要はない。収納部の仕切りはない。

外周カバーを外し、必要なら側板も外して、巻きを手で順にほどく。**両側に取り出し口があることは、両端から全量を連続して自動繰り出しできることを意味しない。** 内側の巻き始めは重ねた巻きに埋まるため、内側端の長さを変えるときは側板を外して手で巻きを扱う。両端接続時は必要な長さを事前にほどき、機器を回転させず、ねじれや引っ掛かりを見ながら扱う。自動巻取・回転接点はない。

## 側板とカバーの着脱

側板lid: 端末溝と爪2個を合わせ、位置決めリップを芯に押し込む。爪が受け窓でカチッと固定される。外すときは中央開口から2個の爪先端を**中心から離れる方向**へ押し広げ、側板を引き抜く。受け窓は中央側から指で操作でき、外側の巻きケーブルが解除操作を塞がない。爪は長さ30×厚さ1.6×幅10 mm、フック1.5 mm。

外周カバー: 2枚を上下からかぶせ、左右の継ぎ目に前後2か所ずつ、合計4個のclipを押し込む。両端の縁が側板に掛かり横ずれを止める。外すときはclipの2本の腕を少し広げながら外側へ抜く。クリップは交換可能な独立印刷部品。ケーブルを継ぎ目や爪に挟まない。中央開口と端末溝はカバー装着後も開いており、防水・防塵ケースではない。

## 印刷と嵌合確認

PETG、0.4 mmノズル、0.2 mm積層、4～5壁、上下6層。台は25～30%インフィルを開始設定とする。PLAの爪は繰返し着脱用の第一候補にしない。

**先にcoupon_socket・coupon_springで側板爪を確認。** socketにspringを裏返して押し込む。部品と同じ爪・ポケット・フック寸法。clipも小さいので先に印刷し、カバー完成後に4か所の保持を確認する。爪が固いときは無理に押さずバリ・糸引きを除去する。側板は`fit_clear`、クリップは`clip_gap`を調整し再生成する。

大物は5 mm程度のブリム。cover_halfの上端の内向きリップは5.5 mm程度の張り出しなので、ブリッジ状態をスライサで確認する。clipの溝内にサポートを入れない。台底にゴムを貼ると滑りにくい。輸送時、台は別に持つ。持ち上げは中央開口を使い、輸送カバーやclipを持ち手にしない。

## 荷重ケースと検証範囲

- 保管物＋治具50 N、取り回し係数3で150 Nを中央開口に想定。縁の二経路を幅20×厚さ5 mm・腕長10 mm・片側75 Nの局所梁とした一次式: 応力9.0 MPa、たわみ0.104 mm。PETG層間強度24 MPa、安全率2の許容12 MPaに対してPASS。
- 側板爪: 1 Nでたわみ1.89 mm、応力7.03 MPa。解除に必要な移動1.5 mmのため、ばねの変形上限を2 mmとして一次式を確認。必要変形の表面ひずみ目安0.40%。
- clip: 必要な腕変形約0.4 mm、ひずみ目安0.62%。XY面内で曲げる印刷姿勢。
- 全部品のSTLを閉じた単一メッシュ・面方向・X1C造形サイズで検査。STEPとSTLの外形・体積、静止組立の接触と体積干渉を検査。挿入中に爪を変形させる過程は静止干渉検査の対象外。
- 一次計算は局所の理想断面。全体FEA、実印刷での保持力・繰返し疲労・落下・耐荷重・転倒試験、30 m実巻きは未実施。**嵌合と収納確認が必要な試作**。係留・ROV牽引・張力を掛けた巻き取りには使わない。

## 部品外の考慮・要確認

端末には半径75 mm以上の緩やかな経路と余長を確保。14 mmの溝は横入れ開口で、縁へケーブルを折り返す曲げガイドではない。中央側のコネクタ形状、実巻き、水濡れによる寸法変化はモデルに含まない。テザー接触面を滑らかに仕上げる。端末を強く曲げてカバー内に押し込まない。

## ファイル・再生成

`tether_open_reel.scad`が全寸法の正。`variants.txt`に印刷部品。STL/STEP/プレビューは同じ部品フォルダへ出力。lid・clipのSTEPはFreeCADのCSG取り込みの都合でSTL由来のファセット形状。それ以外は通常のCSGから変換し、いずれもSTLと照合する。

使用時: `assemblies/tether_open_reel/placement.json`。輸送時: `assemblies/tether_open_reel_closed/placement.json`。view SCADは生成物であり直接編集しない。

```powershell
# Body_Modelsで実行
./build.ps1 -Paths parts/common/jigs/tether_open_reel
python parts/common/jigs/tether_open_reel/check_and_preview.py
& 'C:/Users/ryupc/AppData/Local/Programs/FreeCAD 1.0/bin/freecadcmd.exe' parts/common/jigs/tether_open_reel/verify_step.py
```

検査結果は`mesh_check.json`・`step_check.json`。以前の前後別収納案は`mechanical/outputs/archive/tether_winder_30m_v1/`へ保存し、今回の印刷対象から外した。既存ねじ式`tether_storage_reel`は別の従来案として保持。
