AquaBeacon/mechanical/assemblies/child_single_camera_topopt/child_core_frame/exploration/03_optimization/report.md

# topopt report -- study

## Verdict: **FAIL**

**FAIL** — 5 stop condition(s) failed. This part is not signed off.

| | conditions |
|---|---|
| failed | **5** |
| not checked | 3 |
| passed | 8 |

_The inputs this rests on — loads, material, machine, and what was fixed before the optimiser ran — are in `assumptions.md`. This page reports only what was measured._

## 1. What failed

These are errors, not warnings (spec 18). Each one names the fix.

- **The density field converged (not merely out of iterations)**  
  termination: max_iterations
- **Safety factor meets the requirement on every case**  
  p99.5 2.27 vs required 3.00 (worst element 1.12)
- **Mesh convergence confirmed**  
  TOO COARSE (voxel FEA only: 2.0 (thin 6.00 mm) / 2.0 (typical 6.00 mm) vs required >= 3 elements across the thinnest section). A three-mesh convergence study still has not been run.
- **Self-supporting along the build axis (no voxel without material in the 45 degree cone below it)**  
  1 voxel(s), 9 mm2 of material with nothing under it within 45 degrees (build axis +Z, at [[30.1, -78.0, 39.0], [33.1, -75.0, 42.0]]); it would print on support or not at all. Enable design.overhang, or move the build axis
- **No support lands on a mating (preserve) face**  
  support rests on 443 preserve voxel(s) (3987.0 mm2). Those faces come off the printer rough and out of tolerance. Reorient the part, or accept the finish and say so explicitly.

## 2. What was not checked

3 condition(s) have no answer in this run. Not checked is not the same as fine: an analysis that was never run is not evidence the part is sound, so these count against it and not for it.

- Load/reaction balance within 1 % — _not checked in this run_
- Final shape is watertight — _not checked in this run_
- Minimum wall thickness is met — _not checked in this run_

## 3. What passed

<details><summary>8 condition(s) passed</summary>

- Units are declared and are mm / N / MPa (mm / N / MPa)
- Material properties have no unresolved nulls (orthotropic_equivalent_solid, provisional card (no values measured on this printer))
- Material coordinate system (build_axis) is defined (build axis Z)
- Setup validation passed (preserve/obstacle, loads on preserve) (0 error(s), 38 warning(s))
- All preserve regions are connected (18 component(s); 4941 mm3 of floating islands were dropped)
- The optimiser's stress constraint held on the final density field (not requested (design.stress off); strength is judged by the final FEA only)
- The final shape was re-analysed (8 load case(s) re-solved on the thresholded solid)
- No support inside a sealed cavity (all support is reachable from outside)

</details>

## 4. Which shape this is

The optimiser produces a density field, not a shape. A threshold turns it into one, and different thresholds give different parts.

| threshold | volume (mm³) | safety factor (p99.5) | thinnest member (mm) |
|---|---|---|---|
| 0.50 **← chosen** | 360207 | 2.27 | 6.00 — grid-limited |

**Why this one:** no candidate passes every check; this is the strongest of the connected ones and is NOT a pass. Outstanding: stiffness (2.205 mm, required max deflection <= 1.000 mm); mesh resolution (2.0 (thin 6.00 mm) / 2.0 (typical 6.00 mm), required >= 3 elements across the thinnest section); strength (1.12 (worst element) / 2.27 (p99.5), required safety factor >= 3.00)

> A thinnest member marked *grid-limited* is exactly two voxels across, which is the finest the grid can represent. That number describes the mesh, not the structure.
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
