AquaBeacon/mechanical/assemblies/parent_hand_service/print_jobs/history_from_parts_20261010/README.md

# 印刷フォルダにあった3MFの履歴

2026-10-11、組立の印刷入口を管理対象STLに揃えるため、parts/にあったfloor_plate.3mfとann_mb1_internal_rack.3mfを内容変更せず移管した。元位置とSHA-256はmigration.json。既存の利用者スライスで、元STLのハッシュ、材料、設定との対応は未確認。現行印刷として配布しない。

現行入口は../../parts/PRINT.md。今回の実スライス記録は../../_work/analysis/case_cad_correction_20261010/slicing/にある。
