AquaBeacon/mechanical/parts/common/jigs/camera_housing_clasp/ref/README.md

# 公開STL形状参考

- 作品: [GoPro Hero 9 Waterproof Case Clasp](https://www.printables.com/model/591613-gopro-hero-9-waterproof-case-clasp)
- 作者: Dominsch、ライセンス: CC0（公開ページ、2026-09-29確認）
- 原本: `gopro9_caseclasp.stl`
- SHA-256: `ad42e4a6eafede25875a02c66c91eed6e8279e485be4a1bd2e8b97ca5ff3ddb2`
- 外形: 62.25 × 37.50 × 8.75 mm

これは元のGoProケースの軸を再利用する交換用可動部品です。本フォルダの原本STLは形状参考であり、`assemblies/camera_housing_clasp/parts/` の印刷一式には含めません。新試作のレバーは寸法と開口の印象を参照し、二軸リンクと別体受け用に再設計しています。
