AquaBeacon/mechanical/parts/common/jigs/dji_style_toggle_latch/ref/README.md

# 公開CAD参考資料

## GoPro Hero 9 Waterproof Case Clasp

- 作者: Dominsch
- 公開元: https://www.printables.com/model/591613-gopro-hero-9-waterproof-case-clasp
- 公開ライセンス: Creative Commons Public Domain (CC0)。公開ページとモデルAPIで確認（2026-09-29）。
- 原本: `gopro9_caseclasp.stl`、SHA-256 `ad42e4a6eafede25875a02c66c91eed6e8279e485be4a1bd2e8b97ca5ff3ddb2`
- 外形: 62.25 × 37.50 × 8.75 mm、閉メッシュ、2566三角形。
- 内容: GoPro Hero 9防水ケースの交換用可動クラスプ。作者は元の金属ヒンジ軸の再利用を指定している。固定側の台座・受け・EPDMは含まれない。

このSTLは形状調査用原本であり、旧試作の印刷部品ではない。新しい汎用二軸試作は `../../camera_housing_clasp/camera_housing_clasp.scad` を設計元とし、参考原本の写しを同部品の `ref/` に保存する。
