AquaBeacon/mechanical/docs/部品一覧.md

2026-10-29 電池蓋：親機のbattery_baseとparent_lipo_retainer_lid_slideは上方取り外し・M3×12ねじ1本へ改訂。双方を各1個再印刷。[詳細](../assemblies/parent_hand_service/battery_top_lid_report.md)。

2026-10-29：カメラ治具を[軸方向締付け方式](../parts/child/exterior/printed/dji_osmo_action6_mount_m3/README.md)へ改訂。各機の交換はカメラ本体1・専用受け1・Uスペーサ2。子機受けは既存穴の2列4点支持、ガードねじ2本を長いものに交換。親機外装・子機フレーム・ガード・ライトの形状は維持。実物適合・保持力は未認定。印刷・検証の現行情報は各assembly READMEの2026-10-29節を参照。

2026-10-29 親機内装：床板下面へ開放M3六角ナット座11か所を追加。MAIN／Sony／GNSS支持枠を貫通ねじ固定へ変更。再印刷4個、一式15個。現行は [改訂報告](../assemblies/parent_hand_service/unified_support_report.md)。

2026-10-28 親機内装：SPRESENSE・GNSSは各4本の足を一部品へ統合、足長50 mm。床・棚・電池台・磁気センサの埋め込みナットを廃止。一式15種類15個、変更7個。現行は [一体支持枠の改訂報告](../assemblies/parent_hand_service/unified_support_report.md) と [印刷入口](../assemblies/parent_hand_service/parts/PRINT.md)。以下の独立柱・内部ナット手順は旧版履歴。

2026-10-25 [対辺10 mmナット回し](../parts/common/jigs/nut_driver_af10/README.md)を追加。72 × 32 × 10 mmの片面蓋付き手回し治具、対辺10.05 mmの六角ポケットと径22 mmの指穴2個。ポケット深さ7 mm・ボルト逃げ穴7 mmは仮設定。[印刷一式](../assemblies/nut_driver_af10/parts/PRINT.md)。実物嵌合・締付けトルクは未検証。

2026-10-24 親機MAIN下面・スペーサ改訂：現行は [改訂報告](../assemblies/parent_hand_service/frame_spacer_printability_report.md)。格子下面を印刷面へ揃え、独立スペーサ12軸を3.5 mm通し穴・多角形外形へ変更。一体の基板ねじ座は2.8 mm下穴を維持。独立部品は通しねじとナットで固定する。以下の全スペーサ直接締結の記述は変更前の履歴。

2026-10-24 親機内装の改良バリアントは [改良報告](../assemblies/parent_hand_service/retrofit_report.md) と [印刷一式](../assemblies/parent_hand_service/parts/PRINT.md) を参照。床板・LiPo固定具・既存GNSS枠を再使用し、16種類16個を交換印刷する。スペーサ内部のナット穴と抜け止め4個は廃止し、樹脂下穴へ直接締結する。

> 2026-10-04子機内装：RXクランプは連結ベース左右＋連結押さえ左右の計4個。フランジ梁・床板窓・ケース耳・配線逃げは[改訂記録](../spec/child_interior_reinforcement/PRINT_STRENGTH_REVISION.md)を参照。印刷STLは10種類・11個。

2026-10-21：[camera_mount_twist](../parts/child/exterior/printed/dji_osmo_action6_mount_m3/README.md)を親機・子機共通の一体Cオス付きバリアントとして追加。外側の○△○回転止め壁と不要床を廃止して88×61.45×84.5 mmへ小型化、親機の別体角度ストップも廃止。親機9種類12個、子機横置き19種類27個。子機左前の専用メスは既存SCADのcamera_receiver（C面内90°）。外側から右90°回して通常の横向きに修正し、ロックボルトを上へ抜く。印刷入口は各assemblyのparts/PRINT.md。旧camera_mountと別体QRオスを一体型へ重ねて印刷しない。
2026-10-21 TD04A：[Rev.5・親機は維持／子機は側面固定](../assemblies/td04a_fixture/README.md)。親機parent_downは承認済み形状を保持、子機child_side_upは既存側板M3/20 mmへ固定し広い面を上へ。センサー側M4/10 mmを維持。各1個。[印刷入口](../assemblies/td04a_fixture/parts/PRINT.md)。子機右後側の取付例をCAD検査するが全体placementは未変更。実物・強度は未検証。

2026-10-20：DJI用 [camera_mount](../parts/child/exterior/printed/dji_osmo_action6_mount_m3/README.md)を背板から23 mm張り出す左右の底面受けへ変更。親機外装の現行印刷一式へ同期済み。改良版3MFは部品README参照。ケース実物の接触と保持力は未確認。

> 子機内装の現行締結・補強は `spec/child_interior_reinforcement/BOLTED_MOUNT_REVISION.md`。ケースM3×12＋ナット4組、床板M3×10皿＋ナット1組。下記の旧寸法表より改訂記録を優先。

# 部品一覧

2026-10-12 子機横置きフレームの[側面twist規格](child_horizontal_twist_interface.md)をRev.4へ更新。[一体治具設計元](../parts/child/exterior/printed/child_horizontal_twist_mount/README.md)。一体フレームメス・一体ライトオス・既存押さえ・ノブの4種4個、全体17種24個。33×81の既存保持形状を流用、60°回して停止すると上向き、横のノブは水平+Yとし、側板突出は68.5→59.5 mm。側面中央Y±45は手の進入域。印刷入口は[parts/PRINT.md](../assemblies/child_horizontal_plate_frame/parts/PRINT.md)。一体2部品は0.1 mm層、段差なしメスはサポート無効、ライトオスだけベッドからの外部サポート。カメラ・TD04Aはオスを直接治具へ統合する規格で、実寸と機器形状は今後設計。実嵌合・強度は未認定。

子機筐体・4枚フレーム（2026-10-11）：[組立・印刷入口](../assemblies/child_horizontal_plate_frame/README.md)、[主フレーム設計元](../parts/child/exterior/printed/child_horizontal_plate_frame/README.md)、[新規PETGクランプ](../parts/child/exterior/printed/child_wte4_petg_clamp/README.md)。現行4インチ・200 mm容器を横向きにし、左右側板2＋底板1＋上部1、X1 Carbon / PETG Basicの嵌合・荷重試験用。公式クランプ取付面と40×20 mmピッチを維持し、下側は独立支持治具4個へ固定し、治具を側板へM3×25各4本・開放ナットで固定（2026-10-11変更）。C2個、穴付きB4位置（各4本のM5固定）、側板の持ち手を設ける。前後クランプを上下それぞれ肩の2本の材で一体化。主4枚＋保護延長4個＋回転止め2個＋支持治具4個＋クランプ2個＋C押さえ4個、計20個の印刷一式をassemblyのpartsに集約する。側板2・底板1・クランプ上下各1は印刷済み、未印刷15個だけを追加する。未印刷9種類・15個はサポート無効で再スライスし、G-codeのサポート押出量0を確認済み。回転止めは広い底面をベッドへ向けた印刷用STL、支持治具の開放部は奥行8 mmの短いブリッジとする。5 mmブリムを使用する。未印刷6種類のM3穴は内接円径3.5 mmの八角形。上部・支持治具・回転止めは埋込みナット溝を廃止し、開放部でナットを工具保持する。保護枠を含むフレーム外形244×350×230（延長は側板内側）。後端は配線50 mm＋余裕12 mm、前端は既存ドーム先端から12.775 mm先まで伸ばす。側板へM3×25各2本・開放ナットで直接固定する独立回転止め2個で蓋外周の左右突起を受ける。側板には20 mmピッチのM3追加取付穴を22穴/側設ける（180°反転は穴配列で合わせる）。実強度・湿潤保持・クリープ・配線は未検証。旧最適化形状は変更しない。

2026-10-11親機現行内装は [parent_hand_service](../assemblies/parent_hand_service/README.md)。電源2スイッチ直接操作、TX実装上端から上20 mm予約、箱外MAIN USB、箱内LiPo・両SD操作版。MAIN/Sony両固定板を設け、大きな矩形肉抜きと4点ねじ座へ変更。柱12本をランナー1枚で印刷し、全9種類各1、切離し後20個。Sony床固定はM3×50。昇降ガイド・整備支柱は現行印刷から除外。GNSS 60×80台、箱内ANN-MB1台とOD100/ID75/H10同軸領域。 [LIS3MDL磁気センサ](../parts/parent/interior/cots/adafruit_lis3mdl/README.md)をGNSSと同じ下面Z56の低い矩形枠の四隅へ載せ、ナイロンM2×8／M2ナット各4個で固定。印刷入口はassembly parts/PRINT.md。

子機の新外装フレームA（2026-10-01）: [設計元](../parts/child/exterior/printed/child_exterior_structural_frame/README.md)、[試作構成・印刷入口](../assemblies/child_exterior_structure/README.md)。下部開口294×112 mm、中央270×100 mmを空け、外周・持ち手を保持。外枠は底板4 mm・縦壁3 mmへ薄肉化し、接地奥行き45 mmと持ち手の付け根を残した。現行クランプ穴と新しいA–C取合いを使う。左右の4分割片8個・外側接合板12個、M3固定。印刷形状とX1 Carbon用3MFを納品した試作で、メッシュ収束・分割接合・完成機の強度は未認定。CAD体積換算で左右約4.63 kg、前形状から11.5%軽量化。

2026-10-10: [DJI式・80°溝・締付力40 Nのラッチ](../parts/common/jigs/over_center_latch/README.md)。左右リンクとB支持の爪付き上蓋レバー、Bより外側へ約43 mmの操作部。爪の接触面を台の継ぎ目から7.5 mmへ寄せ、閉じ角150°へ調整。シンプルな台形爪を台の80°溝へ掛ける。専用ストッパーなし。台厚は固定6 mm・受け8 mm、くぼみ底肉2 mm。A軸M3×20、B軸M3×35。WAKI EPGR-01を30×1.8×1 mmで3枚、閉圧縮約0.433 mmを初期値にする。[印刷一式](../assemblies/over_center_latch/parts/PRINT.md)は4種類5個。40 Nは水平締付力の概算目標で実測校正が必要。材料・CAD・構造解析の限界は計算文書参照。旧200 N版は部品内の履歴に保持。

所有バラスト（2026-09-27）。今後「おもりA/B/C」は次のモデルを指す。質量はユーザー申告の1個あたりの値。共通COTS、配置・必要個数・材質は未指定。機械可読の対応表は [ballast_inventory.json](../parts/common/exterior/cots/ballast_inventory.json)。

| 呼び名 | 質量/個 | 設計モデル（STEP、同名STLあり） | 寸法mm・注意 |
|---|---:|---|---|
| おもりA | 60 g | [ballast_plate_a](../parts/common/exterior/cots/ballast_plate/ballast_plate_a.step) | 142×19×4、[説明](../parts/common/exterior/cots/ballast_plate/ballast_plate.md) |
| おもりB | 60 g | [ballast_plate_b](../parts/common/exterior/cots/ballast_plate/ballast_plate_b.step) | 163.5×16×3、M5用貫通4穴、穴径φ5.5のみ仮値、[説明](../parts/common/exterior/cots/ballast_plate/ballast_plate.md) |
| おもりC | 1000 g（1 kg） | [ballast_c](../parts/common/exterior/cots/ballast_c/ballast_c.step) | 胴体φ48.5×高さ53、全高76、くびれφ36。頭・曲面は仮形状、[説明](../parts/common/exterior/cots/ballast_c/ballast_c.md) |

子機外装用（2026-10-05）: [WTE4の直接平滑化トポロジークランプ](../parts/child/exterior/printed/child_wte4_suspension_clamp/README.md)。最適化密度を直接平滑化し、機能寸法のみ復元。単純なリング・柱への再構成は今後行わない。半割り2個、EPDM 1 mm、固定4穴面側上端のØ10.5吊り穴2個、M3×60全ねじ12本。本体約756 g。[最新の使用量・検証記録](../parts/child/exterior/printed/child_wte4_suspension_clamp/LIGHTWEIGHT_REVIEW.md)。exploration_only、剛性未達のため4 kg吊り下げ使用不可。

子機外装の横置き案（2026-10-07）: [設計イメージ](../assemblies/child_exterior_concept/README.md)を保持し、[クランプ24穴固定の外装試作・印刷入口](../assemblies/child_exterior_horizontal/README.md)を設計。既存4インチ容器を横置き、振動子・ライトを上向き、カメラを前向きへ配置。設計元[child_exterior_open_frame](../parts/child/exterior/printed/child_exterior_open_frame/README.md)のSCADが製作形状、concept.jsonは外観検討。側板・横桟・受け・バンパーを分割し、44個の印刷部品を使用。fit_prototype、クランプ本体・分割接合と完成機の強度は未認定。浮力材は仮予約体積です。

共通の小型脱着取合い（2026-09-27）: [quick_release_prototypes](../parts/common/jigs/quick_release_prototypes/quick_release_prototypes.md)。蟻溝＋可動押さえ、窓から突出する左右つまみ爪、プレート整列60°ひねりのオス／メス3案。AはM3貫通締付け、A/Cは内蔵固定ナットとM3×40手回しボルト、Cは横貫通ロック。A上側板10 mm・C上側板6 mmでノブを取付面の内側に収める。Cの下降カム溝で60°回転時に0.6 mm引込み、蓋下面の深さ0.4 mmのくぼみに収めた5×8×1 mmゴム2枚を公称0.1 mm圧縮して遊びを詰める。内部溝の斜面とフィレットを保持する。[比較試作の印刷一式](../assemblies/quick_release_trials/parts/PRINT.md)は9種類9点。仮寸法、金具は別途、実脱着・保持力・強度未検証。

親機外装の箱位置決め案（2026-10-10）：[parent_oneplate](../assemblies/parent_exterior/README.md)。232×134×42 mmの開放フレームとZ=0の三点基準、側面・端面ストップでBCAS212310G箱を着脱後も位置決めする。TD04Aブラケット支持と既存カメラマウント用の調整ストップを追加。TDブラケット・カメラケースとの実寸適合、反復位置決め、強度は未確認。印刷個数とプレート数は現行の `parts/PRINT.md` とスライス報告を参照。

親機外装の旧構成（2026-09-10）：[最下部の下向きカメラ・TD04A／一体型フィン](../assemblies/parent_bottom_sensors/README.md)。新規部品は `parent_fin_cartridge`、`parent_sensor_carrier`、`parent_td04a_clamp_body`、`parent_td04a_clamp_cap`。印刷13種類14点、浮き2個は紐のみで接続。

`parts/<ユニット>/<内装|外装>/<cots|printed>/<部品名>/` の索引。
各行の詳細はリンク先の `.md` を見ること。

凡例: ✅ = モデル・図面あり / ⚠ = 課題あり / ❌ = 未入手・未設計

## 子機 (child / 水中ユニット)

### シンプル筐体案（2026-09-16・縦置き200 mm）

[組立STEP・仕様・検証結果](../assemblies/child_simple_assembly/README.md)。カメラ・TD04Aのマウントは後付け、M3 40×40穴を確保。形状検査済み、強度未合格の試作版。

| 部品 | 個数 | 外形mm | 状態 |
|---|---:|---|---|
| [child_simple_front](../parts/child/exterior/printed/child_simple_front/child_simple_front.md) | 1 | 220×82×238 | r2試作・前面M3取付座 |
| [child_simple_rear](../parts/child/exterior/printed/child_simple_rear/child_simple_rear.md) | 1 | 220×82×239 | r2試作・背面上部M3取付座 |
| [child_simple_guard](../parts/child/exterior/printed/child_simple_guard/child_simple_guard.md) | 1 | 220×168×97 | r2試作・段差受け＋外付けナット、埋め込み不要 |

### 外装 — 購入品

| 部品 | 個数 | 外形 | 状態 |
|---|---|---|---|
| [wte4_acrylic_tube](../parts/child/exterior/cots/wte4_acrylic_tube/wte4_acrylic_tube.md) | 1 | Ø114.3 × 300 (200/400 も所持) | ✅ |
| [wte4_flange](../parts/child/exterior/cots/wte4_flange/wte4_flange.md) | 2 | Ø114.3 × 27、貫通口 Ø88.5 | ✅ |
| [wte4_end_cap_5xm10](../parts/child/exterior/cots/wte4_end_cap_5xm10/wte4_end_cap_5xm10.md) | 2 | 120.3 × 114.3 × 10 | ✅ |
| [wte4_dome_cap](../parts/child/exterior/cots/wte4_dome_cap/wte4_dome_cap.md) | 1 | Ø114.3 × 53.25 (座面から) | ❌ **未購入** (縦置き構成で使用)。参考モデルは仮 |
| [action_camera](../parts/child/exterior/cots/action_camera/action_camera.md) (DJI Osmo Action 6 + 純正防水ケース) | 2 | 94.7 × 45.9 × 84.1 (ケース) | ⚠ 機種確定・**外形は公称値、要実測** |
| [dive_light](../parts/child/exterior/cots/dive_light/dive_light.md) | 1–2 | — | ❌ 未選定 |

### 外装 — 3Dプリント (A: 横置き構成 / `child_assembly`)

| 部品 | 個数 | 外形 | 状態 |
|---|---|---|---|
| [child_frame_plate](../parts/child/exterior/printed/child_frame_plate/child_frame_plate.md) | 1 | 200 × 300 × 6 | ⚠ ベッドに載るか要確認 |
| [child_clamp_base](../parts/child/exterior/printed/child_clamp_base/child_clamp_base.md) | 2 | 180 × 54 × 60 | ✅ |
| [child_clamp_strap](../parts/child/exterior/printed/child_clamp_strap/child_clamp_strap.md) | 2 | 180 × 70.8 × 26 | ⚠ STEP が 5 ソリッド |
| [child_osmo_arm](../parts/child/exterior/printed/child_osmo_arm/child_osmo_arm.md) | 2 | 125.5 × 80 × 22 | ✅ |
| [child_osmo_holder](../parts/child/exterior/printed/child_osmo_holder/child_osmo_holder.md) (cradle) | 2 | 121.9 × 85.4 × 131.3 | ⚠ ケース実寸待ち (公称値で設計) |
| [child_osmo_holder](../parts/child/exterior/printed/child_osmo_holder/child_osmo_holder.md) (strap) | 2 | 121.9 × 26 × 7 | ⚠ 同上 |

### 外装 — 3Dプリント (B: 縦置き吊り下げ構成 / `child_vertical_assembly`)

耐圧容器を縦に立て、ドームを上・アルミキャップを下にして 2 枚のシェルで挟む構成。
**A と B は同時に成立しない。Bを本線として内装サービス設計を完了。**

| 部品 | 個数 | 外形 | 状態 |
|---|---|---|---|
| [child_shell_aft](../parts/child/exterior/printed/child_shell_aft/child_shell_aft.md) | 1 | 196 × 121 × 234 | ✅ 吊り耳 / 取っ手 / TD04A台 / ケーブル導管 |
| [child_shell_fwd](../parts/child/exterior/printed/child_shell_fwd/child_shell_fwd.md) | 1 | 237.4 × 122 × 172 | ✅ **カメラ基線 150 を一体で持つ**。ベッド幅ぎりぎり |
| [child_cam_lid](../parts/child/exterior/printed/child_cam_lid/child_cam_lid.md) | 2 | 90.4 × 47.7 × 15 | ⚠ 上面ボタン窓の位置が仮 |
| [child_light_clamp](../parts/child/exterior/printed/child_light_clamp/child_light_clamp.md) | 1 | 70 × 40 × 28.5 | ⚠ **ライト未選定** (`light_d=40` 仮) |
| [child_bottom_guard](../parts/child/exterior/printed/child_bottom_guard/child_bottom_guard.md) | 1 | Ø198 × 55 | ⚠ ペネトレータ突出量の実測待ち |

> **⚠ 上の B 外装 5 部品は全面再設計で置き換え予定** (2026-08-02 決定、
> [要件](子機外装フレーム再設計_要件.md))。新設計が揃うまでファイルは残す。

### 外装 — 3Dプリント (B 再設計 2026-08-02 / コアフレーム + 小部品方式)

| 部品 | 個数 | 外形 | 状態 |
|---|---|---|---|
| [child_cam_mount](../parts/child/exterior/printed/child_cam_mount/child_cam_mount.md) | 2 | 30 × 44 × 34 | ⚠ 防水ケース入り搭載 (横向き、2026-09-04 復帰)。**ケース実寸・レンズ位置は実測待ち** |
| [child_jaw_gate](../parts/child/exterior/printed/child_jaw_gate/child_jaw_gate.md) | 1 | 152.0 × 74.35 × 235.0 | ⚠ ワニ顎の可動側。キャップ/ドームリム捕捉。**v2=211.5 cm³ (v1 308 から −31 %、トポロジー最適化 `topo_v1/`、2026-09-06)**。把持帯 ×3 + ラッチ柱 + 縦キール ×2、前面 HP40 ×3 (HP4/HP5/HP-L)。ノブボルト挿入通路 Ø24 を確保 (v1 は頭が入らなかった)。**⚠ 判断待ち: ノブ頭 Ø16 が容器/EVA に 1.8〜3 mm 食い込む → latch_hx 62→66 か頭径縮小**。**ドームリング寸法は仮値**。ヒンジピン Ø5×240 (BOM) |
| [child_guard_ring](../parts/child/exterior/printed/child_guard_ring/child_guard_ring.md) | 1 | Ø170 × 72 (z −60..+12、タブ含) | ⚠ 下部ガード。脚 ×3・スキッドリング・タブ ×2・バラスト M6×5・テザー結束スロット補助・`child_cable_cover` 取付インサート。ring_z0 −37→−60 (2026-09-04)、tab_t 8→12 |
| [child_light_saddle](../parts/child/exterior/printed/child_light_saddle/child_light_saddle.md) | 1 | 52 × 30 × 42 | ❌ **廃止 (2026-09-04 → HP-L + ユーザ設計ライトクランプ)** |
| [child_lug](../parts/child/exterior/printed/child_lug/child_lug.md) | 2 | 48 × 24 × 38 | ❌ **廃止 (2026-09-04 → child_top_crown に置換)** |
| [child_core_frame](../parts/child/exterior/printed/child_core_frame/child_core_frame.md) | 1 | 152 × 128 × 235.5 | ⚠ 顎の固定側+パイロン+取っ手+全ボス。**v5=505 cm³ (v4 650 から −22 %、トポロジー最適化 `topo_v5/`、2026-09-06)**。取合い (HP1/2/3・ヒンジ・ラッチ・耳/ガードボス・背面溝) は v4 と同一。半殻は把持帯 ×3 + 縁ストリップ、背面壁 t14 → 溝チャンネル + t5 板、ペデスタル中空、HP2/3 座は板+柱。compare 6 ケース たわみ ≤ 0.92 mm、fine FEA は md 参照。直立印刷 PASS (サポート 3.8 %)。 |
| [child_cam_bridge](../parts/child/exterior/printed/child_cam_bridge/child_cam_bridge.md) | 1 | 240.0 × 61.0 × 150.05 | ⚠ カメラ門型ブリッジ。HP4/HP5 に M5×8。**v2=266.5 cm³ (v1 328 から −19 %、トポロジー最適化 `topo_v1/`、2026-09-06)**。後ウェブ廃止 → 箱桁 (デッキ + アッパーデッキ + 前縦ウェブ + 厚肉スパイン)。fine FEA 4 ケース PASS (mesh PASS)。レンズ z125、デッキ z44.95..52.95。`child_cam_mount` ×2 背中合わせ、基線 150。輸送時は M5×8 を外して取り外す。印刷 +Y up |
| [child_side_bumper](../parts/child/exterior/printed/child_side_bumper/child_side_bumper.md) | 2 | 13.35 × 55.9 × 127.1 | ⚠ カメラ側面 t9 保護板、左右。`child_cam_bridge` ウイング端板フランジへ M5×2 (L 形フット追加で外形 X 拡大、2026-09-04)。**ケース実測でバンパ位置が動く** |
| [child_cable_cover](../parts/child/exterior/printed/child_cable_cover/child_cable_cover.md) (cover) | 1 | 87.4 × 39.7 × 36.8 | ⚠ 下部ケーブルカバー (後方セクタ 230..310 を覆う圓弧殻)。`child_guard_ring` インサートへ M5×2。出口穴 ×3 (Ø14)、テザークランプ座 (EVA t2、M5×2) |
| [child_cable_cover](../parts/child/exterior/printed/child_cable_cover/child_cable_cover.md) (clamp) | 1 | 34.0 × 26.0 × 10.0 | ⚠ テザークランプ押え板 (EVA t2 相手)。M5 クリアランス穴 ×2 (ピッチ 18 に変更、2026-09-04、brief の 24 から修正)。**テザー外径・曲げ半径未選定** |
| [child_top_crown](../parts/child/exterior/printed/child_top_crown/child_top_crown.md) | 1 | 150 × 128 × 38 | ⚠ ドーム根元カラー (内径 Ø126、z218..232) + 吊り耳 ×2 (シャックル Ø16)。耳ボス M5 ×2/枚、輸送キャップ用インサート ×2。**ドーム押えリング OD マージン 0.7mm のため実測待ち** (2026-09-04) |
| [child_dome_cap_transport](../parts/child/exterior/printed/child_dome_cap_transport/child_dome_cap_transport.md) | 1 | 158 × 135 × 53.25 | ⚠ 輸送専用ドーム頂点キャップ (運用時は外す、LED を遮らない)。スカート外嵌め、M5 ノブボルト ×2 で工具レス固定。**後方カットアウトで TD04A を避ける。dome_h 実測で頂点クリアランス動く** (2026-09-04) |

> 新構成のアセンブリ: [`assemblies/child_frame2_assembly/`](../assemblies/child_frame2_assembly/placement.json) (容器+外装 **18 部品、6 グループ: vessel/frame/attach/camera/top/transport**)。
>
> **実装済み (2026-09-04)** — 追加・変更・廃止の整理:
>
> - **追加**: `child_cam_bridge` (HP4/HP5 M5×8) / `child_side_bumper` ×2 (ウイング端板 M5×2) / `child_cable_cover` (cover + clamp、ガードリングインサート M5×2) / `child_top_crown` (耳ボス M5 ×2/枚) / `child_dome_cap_transport` (輸送専用、ノブボルト M5×2)
> - **変更**: `child_jaw_gate` (ブレード・ライトパッド削除、HP4/HP5/HP-L 追加、ノブボルトポケット) / `child_guard_ring` (ring_z0 −60、tab_t 12、`child_cable_cover` 取付インサート) / `child_cam_mount` (横向きに復帰、基線 150 キープ) / `child_core_frame` (v4: HP2/3・背面溝・ペデスタル・縦穴・ヒンジざぐり既実装)
> - **廃止**: `child_lug` → `child_top_crown` / `child_light_saddle` → HP-L ユーザ設計クランプ
>
> **HP40 規格 (機体共通取付座)** (docs/子機外装_改善要件.md §3.1、`scad/lib/hardpoint.scad`)
> - 座面 50×50 / M5 熱圧入インサート ×4 ピッチ 40 / 中央ケーブル穴 Ø14
> - **刻印**: ゲート側 (HP4/HP5/HP-L) は呼ばない (STEP 互換性) / コア側 (HP1/HP2/HP3) は矢印 (+Y)
> - 配置:
>   - HP1: ペデスタル上 z219.5、中心 (0,−85)、穴 (±20, −105/−65)（ソケット台座が容器に貫通していたため 2026-09-04 移動）
>   - HP2/HP3: パイロン側面 x=±44、座中心 (y−75, z100)、穴 (y−95/−55, z80/120)（ライト縦向き・側方振動子）
>   - HP4: ゲート前面上 y=74.35、座中心 (0,170)、穴 (±20, z150/190)（カメラブリッジ上）
>   - HP5: ゲート前面下 y=74.35、座中心 (0,100)、穴 (±20, z80/120)（カメラブリッジ下）
>   - HP-L: ゲート前面最下 y=74.35、座中心 (0,15)、穴 (±20, z−5/35)（前向きライト、座内 Ø14 は深さ 12 で止まる）
>
> **輸送検査** (`scad/lib/check_transport_hull.py`): placement.json の transport グループで dome_cap_transport を include、外すべき部品を exclude したうえで、26 方向の最初の接地部品と根元断面を 300N で評価。自動検査コマンドの例:
> ```
> python scad/lib/check_transport_hull.py assemblies/child_frame2_assembly/placement.json --root . --include-groups transport --exclude-labels cam_mount_stbd,cam_mount_port --removable side_bumper_stbd,side_bumper_port,cam_bridge,dome_cap_transport --limit 280,250,400
> ```

### 内装 — 購入品

| 部品 | 個数 | 状態 |
|---|---|---|
| [lipo_3s_2200_zeee](../parts/common/interior/cots/lipo_3s_2200_zeee/lipo_3s_2200_zeee.md) | 1 | ✅ **実購入品** 102 × 34 × 23。共通部品 (親機のみ、子機は 35×26×110 に変更・2026-09-03) |
| [lipo_35x26x110](../parts/child/interior/cots/lipo_35x26x110/lipo_35x26x110.md) | 1 | ✅ 35 × 26 × 110。子機専用。リード −Z 出し、電源側は XT30 メス (z 25..55)、充電リード 29mm |
| [xt60_rigid_run](../parts/child/interior/cots/xt60_rigid_run/xt60_rigid_run.md) | 0 | ❌ **廃止 (2026-09-03 同日)**。電池リードを切って XT30 を付け直す方針で硬直部が無くなった。フォルダは履歴として残置 |
| NHD-C0216CiZ LCD | 1 | ✅ 56.8×26.2×5.5、外向きベゼル保持。小型I2Cキャリアは要製作 |
| [lipo_3s_5000](../parts/child/interior/cots/lipo_3s_5000/lipo_3s_5000.md) | — | ⚠ **廃止**。上の実購入品に置き換え |

### 内装 — 3Dプリント (A: 横置き構成)

| 部品 | 個数 | 外形 | 状態 |
|---|---|---|---|
| [child_tray_deck](../parts/child/interior/printed/child_tray_deck/child_tray_deck.md) | 1 | 75 × 281 × 24 | ⚠ ベイ寸法が旧 LiPo(5000) と旧 RX 想定のまま。**構成 A を採るなら要更新** |
| [child_tray_rib](../parts/child/interior/printed/child_tray_rib/child_tray_rib.md) | 3 | 75.6 × 21.8 × 6 | ⚠ STEP が 2 ソリッド |

### 内装 — 3Dプリント (B: 縦置き構成 / **実基板・実LiPo で設計**)

| 部品 | 個数 | 外形 | 状態 |
|---|---|---|---|
| [child_vtray_deck](../parts/child/interior/printed/child_vtray_deck/child_vtray_deck.md) | 1 | t200: 97 × 14 × 204 / t300: 97 × 14 × 304 | ✅ MAIN + PWR実基板を上面、LiPo + RXを下面 |
| [child_vtray_batt_box](../parts/child/interior/printed/child_vtray_batt_box/child_vtray_batt_box.md) | 1 | 35×26×110 用、−Z 端壁 6t (z 14..20) + +Z リップ 1.5t、z 14..133.5 | ✅ **2026-09-03 再設計**。∩ チャンネル床なし、−Z立て印刷、ブリム 8mm、PLA 約 37 g |
| [child_vtray_batt_floor](../parts/child/interior/printed/child_vtray_batt_floor/child_vtray_batt_floor.md) | 1 | 39.4×3×111.5、−Z タブ + フック ×2、皿ねじ M3×8 ×1 | ✅ **新 (2026-09-03)**。着脱床板、寝かせ印刷、PLA 約 13 g |
| [child_vtray_batt_gate](../parts/child/interior/printed/child_vtray_batt_gate/child_vtray_batt_gate.md) | — | 54 × 31 × 3 | ❌ **廃止 (2026-09-03)**。電池 35×26×110 / 床板方式で不要 |
| [child_vtray_xt60_cradle](../parts/child/interior/printed/child_vtray_xt60_cradle/child_vtray_xt60_cradle.md) | — | 22.3×23.5×102 | ❌ **廃止 (2026-09-03 同日)**。アセンブリから除外 |
| [child_vtray_rib](../parts/child/interior/printed/child_vtray_rib/child_vtray_rib.md) | 2 | Ø87.5 × 6 | ✅ 面取り挿入ガード＋ケーブル通路 |
| [child_vtray_cable_rail](../parts/child/interior/printed/child_vtray_cable_rail/child_vtray_cable_rail.md) | 2 | 16 × 110 × 8.9 (底に窓 z 90..104) | ✅ **2026-09-03 個数 1→2 に復活**。M3着脱 (デッキ実肉部 Z=37/77 へセルフタップ)、結束点 z 30/55/82/112/125、間隔 ≤30mm |
| [child_lcd_cradle](../parts/child/interior/printed/child_lcd_cradle/child_lcd_cradle.md) | 1組 | 41.1 × 63.4 × 10.5 | ✅ 外向きLCD片開きドア、ねじ式交換クランプ |
| [child_lcd_hinge_frame](../parts/child/interior/printed/child_lcd_hinge_frame/child_lcd_hinge_frame.md) | 1 | 41.3 × 101 × 15.5 | ✅ 左M3ヒンジ＋右M2.5ラッチ1本、基板アクセス開口 |
| [child_lcd_support](../parts/child/interior/printed/child_lcd_support/child_lcd_support.md) `_lower` / `_upper` | 1 + 1 | 67 × 30 × 7.7 / 67 × 24.25 × 5 | ✅ USB/SD/ボタンを避ける非対称アーチ。`lower` は下フランジ BCD94 90° の固定耳付き (裏返し印刷) |

### 内装 — 基板 (**KiCad 実モデル。仮値ではない**)

| 部品 | 外形 | 上/下 高さ | 状態 |
|---|---|---|---|
| [child_main](../parts/child/interior/pcb/child_main/child_main.md) | **104 × 88** | 18.49 / 4.75 | ✅ v4.1実モデル。上フランジを抜いて挿入 |
| [child_pwr](../parts/child/interior/pcb/child_pwr/child_pwr.md) | **62 × 70** | 33.50 / 8.15 | ✅ v2.1実モデル。全高43.25、t200へ収容済み |
| [child_pwr_budget](../parts/child/interior/pcb/child_pwr_budget/child_pwr_budget.md) | 56 × 70 | 25.1 / 8.2 | ⚠ 旧設計予算。履歴参照のみ |
| [rx_improved_mini](../parts/child/interior/pcb/rx_improved_mini/rx_improved_mini.md) | 68 × 46 | 13.79 / 1.91 | ✅ **発注済み = 外形変更不可** |

## 親機 (parent / 水上ユニット)

### 外装 — 購入品

| 部品 | 個数 | 状態 |
|---|---|---|
| [parent_fender](../parts/parent/exterior/cots/parent_fender/parent_fender.md) (浮子) | 2 | ⚠ **2026-09-04 新規 / 09-05 形状変更**。市販の紡錘形フロート (中心に紐通しの空洞)、現物あり **仮値 Ø100 × 300・空洞 Ø15・型番未記入・実測待ち**。仮値・2.7 kg で予備浮力 32 % |
| [mast_pipe_al20](../parts/parent/exterior/cots/mast_pipe_al20/mast_pipe_al20.md) | — | ❌ 未選定 → **不要 (2026-09-04 支柱無し)** |
| [bcas212310g](../parts/parent/exterior/cots/bcas212310g/bcas212310g.md) (防水ボックス) | 1 | **2026-10-11図面再構成を訂正。** 床厚3、ボス上面Z10、M4×4＋タップ×12、四隅の成形壁、本体とふたを分離。原本は未加工。メーカーSTEP未入手、図面にない勾配と公差は実物確認。現行parent_hand_serviceの取合いを再検査し、旧内装・外装の再適合は未確認。 |

### 外装 — 3Dプリント

| 部品 | 個数 | 外形 | 状態 |
|---|---|---|---|
| [parent_deck](../parts/parent/exterior/printed/parent_deck/parent_deck.md) | 1 | 216 × 236 × 60 | ✅ **2026-09-04 新規**。箱台 + 側壁 HP40 ×4 (クレードル) + 下面キール HP40 ×3 (TD04A / Osmo ジグ予約 / 予備) + 紐穴 ×4 + 南縁ケーブル切欠き + フェアリード。上下反転印刷・サポート不要。quick_strength / FEA 済み |
| [parent_float_yoke](../parts/parent/exterior/printed/parent_float_yoke/parent_float_yoke.md) | 4 (a ×2 / b ×2) | 113 × 127 × 96 | ✅ **2026-09-05 新規**。浮子の端受け (45° 円錐座 + 軸上の紐穴 + 留め穴 ×2)。側壁 HP40 に M5 ×4。横倒し印刷 (X 上)・サポート不要。浮子実測で 5 変数を更新 |
| [parent_float_cradle](../parts/parent/exterior/printed/parent_float_cradle/parent_float_cradle.md) | — | 137 × 200 × 86 | ⚠ **廃止 (2026-09-05、浮子は挟めない → 紐通し式のヨークへ)** |
| [parent_mast_clamp](../parts/parent/exterior/printed/parent_mast_clamp/parent_mast_clamp.md) | — | 70 × 70 × 56 | ⚠ **保留・親機では不使用 (2026-09-04、支柱無し)** |
| [parent_pod_body](../parts/parent/exterior/printed/parent_pod_body/parent_pod_body.md) | — | 94 × 94 × 106 | ⚠ **保留・親機では不使用 (2026-09-04、カメラは Osmo 外付け)** |
| [parent_pod_bezel](../parts/parent/exterior/printed/parent_pod_bezel/parent_pod_bezel.md) | — | 94 × 94 × 8 | ⚠ **保留・親機では不使用 (2026-09-04)** |
| [parent_float_segment](../parts/parent/exterior/printed/parent_float_segment/parent_float_segment.md) | — | 150 × 150 × 80 | ⚠ **廃止 (2026-09-04、浮子は市販フェンダー ×2 へ)** |
| ~~マストヘッドプレート~~ | — | — | 不要 (2026-09-04 支柱無し) |
| ~~防水ボックスマウント~~ → `parent_deck` | 1 | — | ✅ 解消 (2026-09-04) |
| Osmo Action 6 固定ジグ (親機) | 1 | — | ❌ **未設計**。`parent_deck` キール北座 (HP40, z −60) に付ける。レンズを喫水線 (≈ z −37) より下に |

### 内装 — 購入品

| 部品 | 個数 | 状態 |
|---|---|---|
| [lipo_3s_2200_zeee](../parts/common/interior/cots/lipo_3s_2200_zeee/lipo_3s_2200_zeee.md) | 1 | ✅ **実購入品** 102 × 34 × 23 |
| [lipo_3s_2200](../parts/parent/interior/cots/lipo_3s_2200/lipo_3s_2200.md) | — | ⚠ **廃止**。上の実購入品に置き換え |
| [spresense_logger](../parts/parent/interior/cots/spresense_logger/spresense_logger.md) | 1 式 | ⚠ 簡易モデルのみ。拡張ボード 68.6 × 53.5、**取付穴・スタック高は要実測** |
| [pizero_2w](../parts/parent/interior/cots/pizero_2w/pizero_2w.md) | 1 | パターン2のみ。⚠ 簡易モデル |
| [gs_camera_m12](../parts/parent/interior/cots/gs_camera_m12/gs_camera_m12.md) | 1 | パターン2のみ。⚠ 簡易モデル。**穴ピッチ 34 は仮** |
| [hex_spacer](../parts/common/interior/cots/hex_spacer/hex_spacer.md) | M3 MF25 ×4 (p1) / ×8 (p2) | ⚠ LiPo トレイ支持 (MAIN 穴) / p2 TX 高架。型番候補 廣杉 BSB-325E、未購入 |

### 内装 — 3Dプリント

| 部品 | 個数 | 外形 | 状態 |
|---|---|---|---|
| [parent_plate](../parts/parent/interior/printed/parent_plate/parent_plate.md) | 1 | 183 × 203 × 5 (`p1`/`p2` バリアント) | ⚠ **2026-08-28 全面改版**。基板穴は KiCad 実座標、箱側 (ボス高さ/ピン位置/コーナー柱) が仮値 → 箱実測まで印刷不可 |
| [parent_lipo_tray](../parts/parent/interior/printed/parent_lipo_tray/parent_lipo_tray.md) | 1 | 111 × 89 × 17 | ⚠ **2026-08-28 新規**。MAIN 穴の M3 MF25 スペーサに架けるブリッジトレイ。LiPo 最上段 (交換しやすい)。LiPo 実測・リード長待ち |
| [parent_cam_mount](../parts/parent/interior/printed/parent_cam_mount/parent_cam_mount.md) | 1 (p2) | 62 × 62 × 19.5 | ⚠ **2026-08-28 新規**。GS カメラ下向き保持 (脚 15)。カメラ穴ピッチ 34 仮 |
| parent_lcd_bracket / parent_cam_port | 各1 | — | ❌ **未設計** ([親機内装_収まり検討.md](親機内装_収まり検討.md) §8) |

### 内装 — 基板 (**KiCad 実モデル。仮値ではない**)

| 部品 | 外形 | 上/下 高さ | 状態 |
|---|---|---|---|
| [parent_main](../parts/parent/interior/pcb/parent_main/parent_main.md) | 112 × 88 | 18.49 / 4.75 | ⚠ **未発注**。SPRESENSE 本体はモデルに含まれない |
| [parent_pwr](../parts/parent/interior/pcb/parent_pwr/parent_pwr.md) | 100 × 84 | 23.52 / 8.15 | ⚠ **未発注** |
| [tx_improved](../parts/parent/interior/pcb/tx_improved/tx_improved.md) | 75.43 × 50 | 13.79 / 5.74 | ✅ **発注済み = 外形変更不可** |

~~`parent_plate` (175 × 180) の 1 層配置はクリアランス不足~~ → **解消 (2026-08-28)**:
箱を BCAS212310G (選定案) とし、プレートを BMP2123Z 互換 **183 × 203** に拡大、
LiPo を P-MAIN 上のブリッジトレイ (`parent_lipo_tray`, M3 MF25 スペーサ ×4) に
逃がすことで 1 層 + 1 トレイで成立 (2026-08-28 実体化)。
カメラ 2 パターンの配置と根拠は [親機内装_収まり検討.md](親機内装_収まり検討.md)、
検証は `spec/parent_interior_layout.py` (プレビュー `spec/parent_layout_p{1,2}.png`)。

## 共通 (common)

### 外装 — 購入品

| 部品 | 個数 | 状態 |
|---|---|---|
| [td04a_transducer](../parts/common/exterior/cots/td04a_transducer/td04a_transducer.md) | 2 | ⚠ **胴径未実測** (最重要) |
| [wetlink_penetrator_m10](../parts/common/exterior/cots/wetlink_penetrator_m10/wetlink_penetrator_m10.md) | 最大 8 (子機 5 / **親機箱 2** / ポッド 1) | ⚠ 参考モデル `_ref` (bcas バリアント) を親機南壁 ×2 に配置済 (2026-08-29, 箱 x=85/120 z=65)。**型番はケーブル外径待ち**、頭高さ等は仮値 |

### 外装 — 3Dプリント

| 部品 | 個数 | 外形 | 状態 |
|---|---|---|---|
| [xdcr_socket](../parts/common/exterior/printed/xdcr_socket/xdcr_socket.md) | 2 | 50 × 50 × 38 | ✅ `child` / `parent` (両方 tilt 0・50 角 = HP40 互換、2026-09-04)。親機は `parent_deck` キール南座に開口下向き。旧 20° 版は廃止 |

### ケーブル (部品外事項)

[docs/配線・ケーブル計画.md](配線・ケーブル計画.md) に集約。

| 項目 | 状態 |
|---|---|
| [tether_cable](../parts/common/cabling/tether_cable/tether_cable.md) | ❌ 未選定 |
| [child_harness](../parts/common/cabling/child_harness/child_harness.md) | ✅ **新 (2026-09-03)**。子機内装ハーネス 9 バリアント (keep-out モデル)、世界座標。推奨カット長あり |
| [internal_harness](../parts/common/cabling/internal_harness/internal_harness.md) | ❌ 未設計 |

### 治具 (機体部品ではない)

最新テザー治具: [tether_open_reel](../parts/common/jigs/tether_open_reel/tether_open_reel.md)。base/lid/stand各1、cover_half×2、clip×4。収納部を一つに統合し、両側開口・ネジ不要カバーへ変更。X1C最大部品236×118×186.8 mm。実嵌合・全体強度・30 m実巻きは未検証の試作（2026-09-26）。

| 部品 | 個数 | 外形 | 状態 |
|---|---|---|---|
| [xdcr_clamp](../parts/common/jigs/xdcr_clamp/xdcr_clamp.md) | body 2 / cap 2 | 56 × 84 × 21.5 / 46 × 52.6 × 19.5 | ⚠ **TD04A 胴径待ち** |
| [xdcr_poolside_jig](../parts/common/jigs/xdcr_poolside_jig/xdcr_poolside_jig.md) | hook 2 / foot 2 | 90 × 162 × 198 / 90 × 102 × 200 | ⚠ **プール縁の実測待ち** |
| [xdcr_pole_jig](../parts/common/jigs/xdcr_pole_jig/xdcr_pole_jig.md) | body 2 / cap 2 | 76.4 × 75.4 × 40 / 76.4 × 9 × 40 | ✅ (STEP はファセット化。STL 直印刷前提) |
| [wte4_display_stand](../parts/common/jigs/wte4_display_stand/wte4_display_stand.md) | cradle 2 / rail 2 | 4 × 150 × 48 / 160 × 4 × 35 (組立 160 × 150 × 48) | ✅ **新 (2026-09-03)**。WTE4 200mm 展示台、相欠き・ねじなし。スロット嵌合は要フィットテスト |
| [test_bracket](../parts/common/jigs/test_bracket/test_bracket.md) | — | 40 × 30 × 30 | ✅ ツールチェーン検証用サンプル |

振動子の保持は 2 系統ある。**どちらも TD04A の実測が前提。**

| 系統 | 構成 | 振動子の深さ | 使いどころ |
|---|---|---|---|
| ポール | `xdcr_pole_jig` (VP25 に直付け) | ポール上の位置で自由 (E1 仕様は 0.6m) | E1 本番。深さを稼げる |
| プールサイド | `xdcr_poolside_jig` + `xdcr_clamp` | 水面下 157.5mm (freeboard 100 のとき) | 縁に掛けるだけ。設置が速い。ビーム向きを 90° 切替可 |

### 共通 — 締結・パッド (購入品、表示用モデル)

| 部品 | フォルダ | 用途 |
|---|---|---|
| 六角スペーサ M3 MF30/17/10、M2 FF6 | `parts/common/interior/cots/hex_spacer/` | 子機 LCD アーチ / 下フランジ / RX 基板 |
| 小ねじ M2×5/6、M2.5×6、M2.5×12 低頭、M3×8/10、M3×10 皿、M3 全ねじ 105、M3 ナット | `parts/common/interior/cots/screw/` | 子機内装の全締結 (数量は screw.md) |
| 独立気泡フォーム (LiPo 5 面、LCD 背面 2) | `parts/common/interior/cots/foam_pad/` | LiPo / LCD の拘束 (PLA で剛に挟まない) |

## アセンブリ

| アセンブリ | 構成 | 状態 |
|---|---|---|
| [child_assembly](../assemblies/child_assembly/child_assembly.md) (A: 横置き) | 21 部品 | ✅ STEP + 4 面プレビューあり |
| [child_vertical_assembly](../assemblies/child_vertical_assembly/child_vertical_assembly.md) (B: 縦置き吊り下げ) | **28 部品** | ✅ STEP + STL + 内装 (基板・LiPo・配線レール・片開きLCD込み)。**240.4 × 237 × 298.25 で 250×250×300 に収まる** |
| [child_interior](../assemblies/child_interior/child_interior.md) (B の内装のみ) | 16 部品 + 締結/パッド 61 + 容器 3 | ✅ STEP + STL + 内装のみ PNG。`sync_child_interior.py` が `child_vertical_assembly` と同じ interior 行を書く。包絡 PASS / 浮き 0 / 貫通 0 (2026-08-28) |
| [parent_interior_p1](../assemblies/parent_interior_p1/parent_interior_p1.md) / [p2](../assemblies/parent_interior_p2/parent_interior_p2.md) (親機内装) | — | ✅ 内装のみ (2026-08-28) |
| [parent_assembly](../assemblies/parent_assembly/parent_assembly.md) (親機全体) | **22 部品** | ✅ **2026-09-04 組立 / 09-05 ヨーク式に更新** (デッキ + ヨーク ×4 + 浮子 ×2 + 箱 + 内装 p1 + ペネトレータ ×2 + TD04A ソケット)。STEP 配置検証 PASS、FLOATING 0。未反映: Osmo ジグ・紐・GPS・配線 |

**A と B は排他。** A は容器を横に寝かせてベースプレートに載せる構成、
B は容器を縦に立てて親機から吊り下げる構成 (ドーム上・ケーブル下)。
B ではベースプレート / クランプ / Osmo アーム・ホルダは使わず、代わりに
内装トレイを縦積みで作り直す必要がある (チューブ 200mm → 有効内長 ~208mm)。

## いま止まっているところ (優先順)

0. **`CHILD_PWR` を 56 × 70 で設計し直す** (2026-07-31 A案採用)。
   制約の立体は `parts/child/interior/pcb/child_pwr_budget/`。
   KiCad 側でこの外形に収まらなければ 300mm チューブ (t300) へ切り替え
0b. **子機の構成は B (縦置き吊り下げ) で確定** (2026-08-01 人間確認済み)。
   A (横置き) の部品は**廃止扱い**とし、新規設計の取合い相手にしない:
   `child_frame_plate` / `child_tray_deck` / `child_tray_rib` /
   `child_osmo_arm` / `child_osmo_holder` / `child_clamp_base` / `child_clamp_strap`。
   → カメラの取合いは **`child_cam_lid` + `child_shell_fwd`** が正。
   → A 側の 2 部品は X1C に載らないが、廃止のため分割設計は不要
     (詳細は [X1C造形性監査.md](X1C造形性監査.md))。
   荷重ケースも確定: 全備 3〜5kg、**取り回し 5g = 200N** を吊り耳・持ち手の設計荷重とする。
1. **TD04A の胴径・胴長の実測** → `xdcr_socket` / `xdcr_pole_jig` / `xdcr_clamp` の確定
   (`xdcr_clamp` の実測反映後は `xdcr_poolside_jig` の `clamp_axz` / `clamp_fx` も転記)
2. **チューブ有効内長の実測** → `child_tray_deck` の全長確定
3. **ケーブルの選定と外径実測** → ペネトレータ型番の決定
4. **Osmo Action 6 防水ケースの実測** (3 軸・底面タブ・レンズ中心高さ)
   → `child_osmo_holder` の確定。現在すきまが 4〜7mm しかない箇所がある
5. ~~**`xdcr_socket` 親機バリアントの設計方針決定** (assert が停止中)~~ → **解消 (2026-09-04)**:
   親機は支柱無しでデッキ下面 HP40 座に付けるため `parent` = tilt 0 (child と同形状)
6. ~~基板 3D モデルの入手~~ → **完了** (2026-07-31)。`parts/*/interior/pcb/` に
   KiCad 実モデルを配置。子機側は `child_vtray_*` に反映済み。
   ~~親機側 `parent_plate` は仮値のまま~~ → **改版済み (2026-08-28、183×203 KiCad 実座標)**。
   残る仮値は箱側実測分のみ ([parent_plate.md](../parts/parent/interior/printed/parent_plate/parent_plate.md) 要確認)
6b. **防水ボックス BCAS212310G の購入承認と実測** (2026-08-28 選定案) →
   `parent_plate` 仮値確定、`parent_lipo_tray` ほか内装フォローアップ部品の設計
   ([親機内装_収まり検討.md](親機内装_収まり検討.md) §8, §9)
7. ~~**マストヘッドプレート・防水ボックスマウントの設計** → 親機アセンブリ着手~~ → **解消 (2026-09-04)**:
   親機外装は `parent_deck` / `parent_float_yoke` / `parent_fender` で組立済み
   ([parent_assembly.md](../assemblies/parent_assembly/parent_assembly.md))。残り:
   **浮子実測** (仮 Ø100 × 300 紡錘・2.7 kg で予備浮力 32 %)、**箱の外部取付穴のねじ方向の現物確認**、
   **Osmo Action 6 固定ジグ** (キール北座 HP40)。パターン 2 (GS カメラ内蔵) は不採用

### 構成 B (縦置き) を選んだ場合の追加項目

- **`wte4_dome_cap` (BR-100495) の購入と `dome_h` の実測** → 全高 298.25 の確定
- **ペネトレータの突出量の実測** → `child_bottom_guard.ring_z0` の確定
- **縦置き用の内装トレイの設計** (既存 `child_tray_deck` 281mm は入らない)
- **バラスト 1.1〜2.2kg の実測と取付位置の決定** (現状ほぼ中性浮力)

### 親機：ねじ固定の縦長外装（2026-09-10追加）

追記：浮きは左右2個を**紐のみで接続、剛体接続しない**という指定に変更。[現行版 parent_rope_float](../assemblies/parent_rope_float/README.md)。下記の印刷円柱浮体と締結ロッドは旧案。現行は造形13種類18点で、デッキ直付けキールアダプターを追加。

[parent_spar_bolted](../assemblies/parent_spar_bolted/README.md)：既存タカチ箱＋既存デッキを使用。新規14種類、既存造形2種類、計23点の印刷部品。浮体胴・蓋・上下端板、分割支柱・継手、円盤・十字フィン・ハブ、錘ケース・蓋、カメラ支持部、GPS支持部をねじ固定。印刷STLは `print_jobs/parent_spar_bolted/`。旧双胴外装と区別する。水密・復原性・ケース実寸適合は実機確認待ち。

## 子機・一体式エンドキャップガード（2026-09-27）

方向合わせの受けは左右突起の部分だけ凹み、それ以外は内側へ張り出す。ねじ頭逃げは上側で別に設ける。変更ごとに開閉GIFと実形状断面を生成して提示する。

[child_endcap_guard](../parts/child/exterior/printed/child_endcap_guard/README.md): エンドキャップ左右突起へはまる受けとガードを**1個の可動部品**へ統合。全体が蓋のように蝶番で動く。中央Ø75×H80、先端開放、八角枠の8個の尖りアーチ窓、窓角R3・枠R1.5・根元R2・取合いR0.1。上端45°と傾斜裾で本体の印刷性を改善。固定側蝶番は未固定の仮配置・印刷対象外。将来のクランプ取付・閉止ラッチは未設計。旧二分割カラー案は部品内の履歴に保存。[印刷入口](../assemblies/child_endcap_guard/parts/PRINT.md)は一体ガード1個。

## 汎用・レバー脱着治具（2026-09-27）

[dji_style_toggle_latch](../parts/common/jigs/dji_style_toggle_latch/dji_style_toggle_latch.md): 写真と形状が異なる旧試作（exploration_only）。素手着脱用ラッチの機体用には採用しない。旧試作のSTL・検証記録は保持。公開CADを調べた[再設計資料](../spec/dji_style_toggle_latch/PUBLIC_CAD_REVIEW.md)を参照。

[camera_housing_clasp](../parts/common/jigs/camera_housing_clasp/camera_housing_clasp.md): CC0公開クラスプの薄いU字外形を参考に、台座・二軸リンク・受けを加えたPETG Basic/厚1 mm EPDMの汎用試作。向かい合う固定片の間でEPDMを公称0.2 mm圧縮し、可動部の背後に受け側の支えを設ける。[印刷入口](../assemblies/camera_housing_clasp/parts/PRINT.md)は4種類5点。機体穴位置・保持力は未確定。

## 親機の内外装統合試作（2026-09-10）

`parent_integrated` は最新外装とP1内装を同じ箱座標へ統合したもの。
追加部品 `parts/parent/interior/printed/parent_plate_integrated` は1点、
PWR支持高さ9.5 mm（既存6 mmから+3.5）。実測・強度・最終造形条件は未確定。
従来の外装印刷ZIPには含まれない。
詳細と実測一覧は [統合設計](../assemblies/parent_integrated/README.md) を参照。

履歴：親機parent_hand_serviceの2026-10-09波揺れ改訂。印刷削減前の9種類を補強し、当時は12種類14個へ分割し、ケース固定M4×8ボタンねじ4本を追加。GNSS基板に側面ストッパー、ラックに巻き束留め窓、前梁に配線留め穴を設けた。印刷はPETG 0.2 mm・4周壁・100%インフィル。現行の解析範囲・未実測事項はassemblyのwave_rigidity_report.md。

> 2026-10-09印刷削減改訂：親機床は開放格子、アンテナ台／リングとGNSS台／前後支柱を分割。前後支柱各2、他各1で12種類14個。MAIN/Sony台とアンテナ台は反転印刷。実スライスの支持量・材料比較は[parent_hand_service/print_economy_report.md](../assemblies/parent_hand_service/print_economy_report.md)。

## 親機印刷スペーサ（2026-10-22）

[parent_hand_serviceの印刷一式](../assemblies/parent_hand_service/parts/PRINT.md)にMAIN用 `main_corner_column.stl`（14.3 mm）×4、Sony左／右各2、GNSS前／後各2、計12本の個別スペーサを同梱。MAIN基板直下の4点座は `main_mount_plate.stl` と一体なので固定板も1個印刷する。内装全体は13種類20個。旧ランナーと重複印刷せず、旧Sony右2本だけは下端を広げた新版へ交換する。形状の正本は既存部品のまま、PWR・TX・電池・アンテナの一体支持も3Dプリント部品に含み、購入hex_spacerは使わない。寸法・取付位置は [スペーサ対応表](../assemblies/parent_hand_service/spacer_delivery_report.md)。

2026-10-11親機GNSS治具：60×80基板の実穴ピッチ75×55 mm・端から2.5 mmに合わせM3×10／M3ナット各4へ変更。前後押さえ2個を廃止。GNSS台のみ再印刷、支柱セットと他の印刷部品は維持。詳細は[parent_hand_service/sensor_mount_report.md](../assemblies/parent_hand_service/sensor_mount_report.md)。

2026-10-12 親機内装：床板は変更なし。MAIN固定板・電池台・同軸リングへケース固定ねじのアクセスを追加。印刷は現行parent_hand_service/parts/PRINT.mdを参照。容器へのねじはM4×12を3本。工具姿勢と実物確認事項はassemblies/parent_hand_service/case_screw_access_report.md。

2026-10-12 親機電池蓋：parent_lipo_retainerの既存設計元にlid_slideバリアントを追加。3爪＋M3×12ねじ1本／ナット1個。現行parent_hand_serviceは電池台と蓋だけ再印刷、床板・MAIN固定板を維持。入口は同assemblyのparts/PRINT.md。

2026-10-12 親機電池蓋を子機のchild_vtray_batt_floor／boxと同じ端フック2本＋ねじ1本へ改訂。形状元は現行子機SCAD。親機の電池寸法・取付座・ねじ種類は維持。子機部品は未変更。現行印刷はparent_hand_service/parts/PRINT.md。

2026-10-13 親機電池台：工具穴8 mm、蓋は2 mmスライド＋ねじ1本。ナット座の斜め天井と支持材禁止パーツを使用。設定済み3MFはassemblies/parent_hand_service/print_jobs/battery_tool_nut_access_20261013/battery_base.3mf。印刷入口は同assemblyのparts/PRINT.md。配線端開口、電池位置、最下段と同軸巻き部は変更なし。

2026-10-13 全長側溝版：親機の電池蓋は両側の溝へ端から全長分を差し込み、ねじ1本で固定。開く際は台固定ねじ4本を外して閉じたボックスを上へ約90 mm持ち上げ、蓋を108 mm引き抜く。電源リードを先に外し、ボックスの持上げ経路へ配線を結束しない。現行印刷はassemblies/parent_hand_service/parts/PRINT.md、詳細はbattery_side_grooves_report.md。

## 親機外装Rev.2追加（2026-10-19）

- `parent_oneplate_stand`：左右共通スキッド2個。M5×180全ねじで共締め。
- `parent_oneplate_camera_qr`：共通C式のfemale/male各1個。既存カメラマウントを使用。
- `parent_oneplate_frame`：Rev.4は232×134 mm・厚20 mmの平板。TD04A支持・カメラQR・箱位置決め4部品をネジ留め。
- `parent_oneplate_bar`：244×146×20 mmの一体型上側押さえフレーム1個（中実バー2本を幅16 mmレールで連結）。

現行の印刷入口と数量は[親機外装](../assemblies/parent_exterior/parts/PRINT.md)。Rev.4の別体位置決め部は既存バリアントを更新して使用する。

2026-10-20 Rev.4：親機外装の下フレームを角丸平板へ整理。カメラ一体ボスとTD用段差・キーを廃止し、QRメスの厚10 mm板・TD支持の平面座で後付けする。ネジとナットの沈め位置はassembly READMEを参照。

2026-10-20 Rev.5：parent_exteriorは予備M4穴15箇所（30 mm格子）を追加。緑色の固定位置決め部4個を主プレートへ一体化し、M4固定ねじ8本・ナット8個を廃止。現行11種類14個、圧力パッド3個とTD04A・カメラ治具は別体を維持する。

2026-10-20 Rev.6：parent_exteriorの主プレート下面を平面化。径10.5 mmの縦ロープ穴4個、端面腕の底面を揃え、横穴の屋根とTD支持・カメラ角度ストップの姿勢を修正。全体・印刷入口と最新スライス結果は[parent_exterior](../assemblies/parent_exterior/README.md)を参照。

2026-10-22 Rev.7：主プレートを240×134×20 mmの平板へ変更し、箱位置決めを左右レール2個・厚12 mmの前後アーム2個へ分離。M4×20を4本、M4×25を4本、M4ナット8個で後付けする。印刷済みの上側押さえ・脚は維持。カメラは10/21の小型C一体型を継続し、旧別体オス・角度ストップを追加しない。
# 2026-10-21 子機内装スペーサ

[child_spacer_set](../parts/child/interior/printed/child_spacer_set/child_spacer_set.md)：10 mm×2、12 mm×1、30 mm×1の印刷本体を切離し用つなぎ付き1セットにした。child_interior／child_vertical_assemblyで共用。外側AF5.5の六角、穴は内接径3.5 mm。左右M3×26なべ2本、ブレースM3×30／×45スタッド各1本＋普通M3ナット2個で固定し、スペーサのタップは不要。印刷入口は各assemblyのparts/PRINT.md。取合い試作・締結強度未検証。

## 2026-10-25 TD04A治具の改訂

親機外装・子機横置き外装に共通td04a_bracket_mount Rev.6を配置。M4貫通＋ナット・穴中心12 mm（概数）、穴列を基準にケーブル側へ60 mm。送受信面は親機下・子機上。旧TD04A本体モデルは根拠にしない。ケーブル根元と曲げ半径・実物耳厚は未検証。[詳細](../parts/common/exterior/printed/td04a_bracket_mount/README.md)。

## 2026-10-27 北側ペネトレータ対応

親機の現行内装は [parent_hand_service](../assemblies/parent_hand_service/README.md)。床板、Sony固定板、Sony前左柱0、共有柱、電池台、同軸リングの計6個を交換する。設計は既存部品の同じ生成元を更新し、購入品のWetLink M10・付属ナット・レンチを印刷部品へ分類しない。今回の配置、ナットの屋根と組立手順は [床板改訂報告](../assemblies/parent_hand_service/plate_access_report.md)。
