AquaBeacon/mechanical/assemblies/parent_bottom_sensors/fastener_bom.md

# 金具一覧

|種類|数量|
|---|---:|
|nut_m4|4|
|nut_m5|25|
|nut_m6|5|
|nut_m8|1|
|screw_m4x16|4|
|screw_m4x25|2|
|screw_m4x65|2|
|screw_m5x16|4|
|screw_m5x20|9|
|screw_m5x25|12|
|screw_m5x35|4|
|screw_m5x65|4|
|screw_m6x60|3|
|screw_m6x70|2|
|screw_m8x50|1|
|washer_m4x1|12|
|washer_m5x1|56|
|washer_m6x1|10|
|washer_m8x1|2|

別途：デッキ用M4インサート4個、M5インサート8個（中央4・GPS側面4）。未使用座のインサートは任意。ねじ・座金・ナットは購入品。M4×65の長尺品は調達確認が必要。既存カメラ用軸ねじは純正仕様との照合が必要。
