AquaBeacon/mechanical/assemblies/parent_rope_float/fastener_bom.md

# 紐接続版の金具

|種類|数量|
|---|---:|
|nut_m4|2|
|nut_m5|25|
|nut_m6|5|
|nut_m8|1|
|screw_m4x16|4|
|screw_m4x25|2|
|screw_m5x16|8|
|screw_m5x20|9|
|screw_m5x25|4|
|screw_m5x40|8|
|screw_m5x55|4|
|screw_m5x65|4|
|screw_m6x100|2|
|screw_m6x60|1|
|screw_m6x70|2|
|screw_m8x50|1|
|washer_m4x1|8|
|washer_m5x1|60|
|washer_m6x1|10|
|washer_m8x1|2|

別途：左右の浮き2個、紐2本、既存デッキに適合するM4インサート4個・M5インサート12個。浮きの固定に剛体部品は使わない。
