AquaBeacon/mechanical/assemblies/parent_spar_bolted/fastener_bom.md

# 金具数量（形状モデル集計）

金属ねじ棒・ねじ・ナット・座金は印刷しない。寸法はmm。

|金具|個数|
|---|---:|
|coupling_m6x18|4|
|nut_m4|18|
|nut_m5|25|
|nut_m6|13|
|nut_m8|1|
|rod_m6x205|8|
|screw_m4x16|4|
|screw_m4x20|16|
|screw_m4x25|2|
|screw_m5x16|4|
|screw_m5x20|13|
|screw_m5x25|4|
|screw_m5x40|8|
|screw_m5x55|4|
|screw_m5x65|4|
|screw_m6x100|2|
|screw_m6x60|1|
|screw_m6x70|2|
|screw_m8x50|1|
|washer_m4x1|40|
|washer_m5x1|64|
|washer_m6x1|18|
|washer_m8x1|2|

別途：既存デッキ用M5インサート12個・M4インサート4個、浮体用シール4本、錘用金属リング（外径50 / 内径9、合計高さ30）。カメラねじは純正品との実物適合確認が必要。ねじの長さは座面からの長さ。ナイロック等で抜止めする場合はナット高さ増分に合わせて長さを調整する。

M6長ナットは二面幅10・長さ18のモデル。標準ナットはM4高さ3.2 / M5高さ4 / M6高さ5 / M8高さ6.5。座金は厚さ1、外径M4=9 / M5=10 / M6=12 / M8=16。インサートの外径・長さは既存デッキ図に合わせる。
