AquaBeacon/mechanical/parts/common/cabling/child_harness/child_harness.md

> 2026-10-04：子機内装の連結RXクランプに合わせRX/LED/電池線をY−25.5側へ迂回、温度線のレール進入口を世界Z100へ修正。旧配線経路の記述より現行SCADを優先。

# child_harness — 子機内装ハーネス (キープアウト形状)

| 項目 | 値 |
|---|---|
| 区分 | 共通 / ケーブル (部品外事項の 3D 化) |
| 対象 | 子機容器内 (`assemblies/child_interior`) |
| ファイル | `child_harness.scad` (1 ファイル、`variant` で 9 本を切り替え) |

## 役割

CHILD_MAIN / CHILD_PWR / RX 基板間の JST-XH ハーネス、電池 XT30 リンク、
LED・外部センサのピグテールを **ワールド座標のキープアウト立体** として
モデル化する。実配線が確定する前に `check_asm_contacts.py` / `verify_child_interior.py`
で他部品との干渉・チューブ包絡を機械検証するためのもので、印刷対象ではない。

- 1 ポリライン = 直線区間ごとの `cylinder` + 内部関節ごとの `sphere`。
  メッシュ品質のため (下記) 全頂点に球を置き、円柱を両端 0.03mm 延長して
  重ねている — モデルとしての経路は変わらない。`$fn=24`。
- XH プラグ筐体は `xh_plug()` が **ピン数・ピッチ・行方向** から自動算出する
  cube (行方向 = `2.5*n+2.4`、直交方向 5.75、ヘッダ 7.0 の上に高さ 7.4)。
  ワイヤ引出点はプラグの基板と反対側の面の中心 (`conn_wire()`)。
- 座標系: X=幅 / Y=積み方向 (+Y=LCD 側) / Z=チューブ軸。デッキ下面 y=-10、
  デッキ上面 y=-6 (`assemblies/child_interior/placement.json` と同一)。

### STEP について

`csg_to_step.py` の体積照合で全バリアントが STL フォールバックになる
(union する円柱・球の数が多く CSG→B-Rep 変換が体積不一致と判定するため)。
**ケーブル形状は面が多くファセット化された STEP でよい** — Fusion で
編集する対象ではなく、干渉確認・可視化用の骨格である。

## バリアント (`variants.txt`)

| suffix | 内容 | 本数×径 |
|---|---|---|
| `xh9_pwr` | CHILD_MAIN `J_PWR1` ↔ CHILD_PWR `J_MAIN` (電源幹線) | XH9 Ø5.5 |
| `xh6_rx` | CHILD_MAIN `J_RX1` ↔ RX `J2` | XH6 Ø4.5 |
| `xh7_lcd` | CHILD_MAIN `J_LCD1` → LCD 側基板 (位置未定・スタブ) | XH7 Ø5.0 |
| `xh3_teth` | CHILD_MAIN `J_TETH1` → 下キャップ ペネトレータ | XH3 Ø3.0 |
| `xh4_temp` | CHILD_MAIN `J_TEMP1` → 同上 | XH4 Ø3.5 |
| `xh2_leak` | CHILD_MAIN `J_LEAK1` → 同上 | XH2 Ø2.5 |
| `xh4_prs` | CHILD_MAIN `J_PRS1` → 同上 (+X 側) | XH4 Ø3.5 |
| `bat` | 電池リード → XT30 ペア → ピグテール (`J_BAT`) + 充電リード (XH4) | 2 芯 Ø5.0 ×2 + XH4 Ø3.5 |
| `led` | CHILD_PWR `J_LED` → ペネトレータ (-X 側) | 2 芯 Ø5.0 |

## 経路と長さ (echo 実測、20% サービスループを足した推奨カット長)

| バリアント | 実長 (mm) | 推奨カット長 (mm, ×1.2) | 通り道 |
|---|---:|---:|---|
| xh9_pwr | 117.6 | 141 | MAIN 上空 → x8→10 の縦通路 (LCD アーチ下、y≦23) → PWR |
| xh6_rx | 137.3 | 165 | -X スリット (z96、窓経由) → -X ケーブルレール トラフ (x=-36, y=-15.5) → z 130 でレールを出て RX J2 |
| xh7_lcd | 27.5 (未確定) | ― (下記参照) | MAIN → LCD アーチ内側のスタブ。LCD 側基板の位置が決まるまで長さ未確定 |
| xh3_teth | 159.6 | 192 | -X スリット (z96、窓経由) → 同レール トラフ → レール −Z 端 → 下リブ開口 → 外部ケーブル |
| xh4_temp | 168.5 | 202 | 同上 (teth と同じレール、x=-36 で重畳可) |
| xh2_leak | 180.1 | 216 | 同上 |
| xh4_prs | 151.6 | 182 | +X スリット (z96、窓経由) → +X ケーブルレール トラフ → レール −Z 端 → 下リブ開口 → 外部 |
| bat (電源リード) | 30.9 | 37 | 電池リード側 (+X 切欠きから) → XT30 ペア |
| bat (ピグテール) | 136.8 | 164 | XT30 ペア → +X スリット (z 96、窓経由) → +X レール −Z 端からトラフを上へ → z 130 でレールを出て → `J_BAT` パッド |
| bat (充電リード) | 23.9 | 29 | 電池リード側 (−X 切欠きから) → 下リブ結束スロット → 外部 |
| led | 230.8 | 277 | `J_LED` パッド → -X スリット (z 157、上面へ直通) → RX 外側を下って → -X レール −Z 端 (z 130 上端) → レール溝 (z 20 まで) → 下リブ開口 → 外部 |

`xh7_lcd`: LCD 側の小基板は位置未定。ブリーフどおり「サービスループ 20mm 込みで
総長 100mm」を暫定推奨とする (実長 27.5mm はスタブのみの値で、LCD 側基板が
決まり次第この行と経路を更新すること)。

## 配線区間の説明

- **-X スリット (z 96、長さ 26) / -X ケーブルレール (x=-36, z 20-130)**:
  `xh6_rx` / `xh3_teth` / `xh4_temp` / `xh2_leak` / `led` が共有する。
  レール底に**窓** (ローカル y 70..84 = 世界 z 90..104、チャンネル幅 8 で底板を貫通) があり、
  これによってデッキの中段スリット (z 83..109) がレール底板で塞がれないようになっている。
  レールのトラフ内は 5 本まとめて x=-36 (チャンネル中心) を通し、touching は
  許容 (ブリーフの「ハーネス同士は接触可」)。
- **+X スリット (z 96、窓経由) / +X ケーブルレール (x=36)**: `xh4_prs` と `bat` (電池リード・
  XT30 ペア・ピグテールの一部) が共有。同じく−X側と同様に窓を通して通す。
- **底リブ ダクト (`child_vtray_rib.scad`: x -20..20, y -36..-14, z 2.5..8.5)**:
  `xh3_teth` / `xh4_temp` / `xh2_leak` / `xh4_prs` / `led` の外部行き 5 本が
  ここを通る。実測寸法 (ブリーフの「x ±20」は概算だったので `.scad` の
  `duct_w=40`/`duct_y0=-36`/`duct_y1=-14` から取得) を基に、通過点を
  \|x\|≤16 に集約して 1.0mm 以上のマージンを確保した。
- **結束点**: 各ケーブルレールには `tie_y=[10,35,62,92,105]` (レール ローカル
  Y、レール取付 z0=20 を足すと機体 Z) の結束バンド スロットが、底リブには
  `tie_x=±26, tie_y=-19` のスロットがある。実配線時はここで結束すること。

## J_BAT / J_LED について

CHILD_PWR の `J_BAT` (XT30PW-M) と `J_LED` は **未実装 (部品未実装)**。
ピグテールは基板のパッドへ直接はんだ付けする想定 (コネクタを介さない)。
モデルでは `J_BAT_C = (21.4, 5.6, 145)` (2 パッド 147.5/142.5 の中点) /
`J_LED_C = (-21.4, 5.6, 146)` にワイヤ始点を置いている。

電池側 XT30 (メス、ケーブル取付済み) は `+X` レールのトラフ内に
x 32.5..39.5 / y -22.4..-12.4 / z 25..55 の直方体で表現。

## メッシュ品質について (要確認への影響なし)

初回ビルドで各 STL が 8〜50 本の open edge (non-manifold) を持っていた
(円柱同士・円柱と球が正接するだけで面が共有されない箇所)。
`polyline()` を全頂点に球 (`d*1.02`) を置き、`seg()` の円柱を両端 0.03mm
延長する実装に変更し、6/9 バリアントは "watertight: looks closed" まで、
残り (`xh6_rx`=2 / `xh4_temp`=10 / `xh2_leak`=16 / `xh4_prs`=6 / `bat`=8) も
大幅に減少した。残存分は急な折れ (>90°) 付近の facet 継ぎ目とみられ、
クリアランス判定 (`check_asm_contacts.py` の inward-sample 法) には
影響しない範囲であることを確認済み (下記の検証結果を参照)。

## 干渉確認 (2026-09-03 最終)

`scad/lib/check_asm_contacts.py --ignore-threads` (interior グループ全 85 アイテム +
本ハーネス 9 種) と `scad/lib/verify_child_interior.py` を実行。

- **貫通 (penetration>0) は全て許容設計**:
  - ハーネス ↔ 接続先基板 (`child_main` / `child_pwr` / `rx_improved_mini`):
    プラグが基板 STL のヘッダ上に載る設計どおり (ブリーフの許容例外)。
  - ハーネス同士: 許容 (ブリーフの許容例外)。
  - ピグテール始点 ↔ 基板 STL 内の XT30PW モデル (未実装): `J_BAT` / `J_LED` パッドへの直付け設計。
  - 電池リード始点 ↔ リードスタブ: `lipo_35x26x110_leads.stl` のスタブ先端との合致。
- **レール底の窓と経路修正によってレール貫通は 0**:
  旧設計の「組立順序に依存する許容」(トラフ床への上からの進入) は、
  z 90..104 の窓と −Z 端からのハーネス出入りで解消。
- **`verify_child_interior.py`: 9 バリアント全て PASS** (チューブ包絡に対し
  最小径方向クリアランス 3.05〜12.38mm)。床板タブは貫通口内で余裕 0.68 = WARN、意図どおり。

## 要確認

1. **LCD 側基板の位置未定** (`xh7_lcd`): 位置が決まり次第、経路と推奨長を
   更新すること。
2. **コネクタ実座標の再確認**: `.kicad_pcb` 側のピン1座標・ピッチが
   変わっていないか (本ハーネスはブリーフ記載の座標をそのまま使用)。
