AquaBeacon/mechanical/parts/common/cabling/parent_td04a_cable/parent_td04a_cable.md

# TD04A 外径5 mmケーブル：外部配線の空間予約

2026-09-10。外径5 mmはユーザー指定。購入ケーブルの参照形状で、印刷部品ではない。
TD04Aの仮の背面中央から、既存のTD用ペネトレータ外端までを統合モデルへ追加した。
これは静的な配線経路の検討であり、全長を保持する固定具の設計完了ではない。

## 経路と寸法

座標は箱底中心。TD04A出口(65,−40,−438)から+Zへ23 mm直進、
中心線半径30 mmで−Yへ曲げ、支持板の既存Ø8穴(65,−75,−385)を通す。
円盤を迂回し、X=65、Y=−190で上昇。上端はR30で−X、続いて+Yへ曲げ、
TD用引込口(−20,−137,65)へ入る。最後の23 mmは引込軸と同じ方向の直線。
支持板やペネトレータの既存穴位置は変更しない。

- ケーブル外径：5 mm
- 周囲の設計余裕：片側1 mm、予約径7 mm
- 中心線曲げ半径：30 mm、ケーブル内側曲げ半径27.5 mm
- モデル外部経路長：約739.5 mm
- 曲げ半径は仮値。ケーブルメーカーの最小曲げ半径を取得したら照合・更新する。
- 必要な総ケーブル長は739.5 mmに箱内配線と着脱余長を加える。切断寸法ではない。

## 固定・通線の未確定点

下部は支持板の未使用配線穴(65,−75,−410)を結束点候補とする。
通線穴では被覆が穴縁に擦れない割り形状の保護材を検討する。
上部には引込部へ引張を伝えないストレインリリーフが必要。
Y=−190の長い外部区間は固定具なしでは形状を保てないため、
実物のケーブル剛性と分解動線を確認して中間ガイドを設計する。
引込口だけでケーブルの荷重を受けず、浮きの紐への共締めもしない。

Ø8の閉じた穴を通す案は、端末コネクタの最大寸法が未確認。
コネクタが通らなければ開放スロット／分割ガイドへ設計変更する。
コネクタ切断を前提にしていない。支持板の強度に関わる穴加工も未指示。

外径5 mmが確定しても、WetLinkの型番・適合被覆・シールはまだ確定していない。
既存参照モデルの外被穴7.5 mm、導体穴5.7 mmは実物シール仕様ではない。
TD背面出口形状、ストレート部の必要長、屈曲寿命、水密性は実測・仕様確認待ち。
箱内の導体／端子台からTXへの配線は今回の外部ルートに含めていない。

## 検証

`clearance_checks.json` に静的検査結果を保存。
中心線を0.25 mm以下の間隔で採り、三角形表面への距離から半径2.5 mmを引く。
さらに半間隔0.125 mmを引いた保守値で、一般部材との片側1 mm余裕を検査する。
支持板との保守隙間は約1.20 mm、引込部の穴との保守隙間は約1.12 mm。
全アセンブリの配置を対象に、ケーブル径＋余裕の外接箱で候補を抽出した。
TD本体の出口接触は意図したものとして除外。浮き・紐はモデル姿勢のみの確認で、
波・たわみ・揺動・工具の移動範囲は保証しない。

STEPは直線と円弧の丸断面スイープ、ケーブルと予約空間はそれぞれ有効な1ソリッド。
統合STEPはケーブル追加後199部品、読み戻し配置不一致0。
予約径7 mmのモデルは重複実体を避けるため、統合STEPに含めず別ファイルとする。

## 再生成

```powershell
python spec/route_parent_td04a.py
$env:CABLE_ROOT=(Get-Location).Path
& 'C:/Users/ryupc/AppData/Local/Programs/FreeCAD 1.0/bin/FreeCADCmd.exe' spec/export_parent_td04a_cable.py
python spec/integrate_parent.py
./build.ps1 -Assemblies assemblies/parent_integrated
```

寸法の正は `spec/route_parent_td04a.py` のDIAMETER、RADIUS、MARGINと経路座標。
`route.json`、SCAD、STEP/STLは生成物。SCADは球をつないだ表示近似で端部が丸く、
CAD用の平端面STEPとは端部だけ形状が異なる。正式な干渉検討にはSTEP/STLを使う。
