AquaBeacon/mechanical/parts/common/jigs/camera_housing_clasp/camera_housing_clasp.md

# 防水カメラケース風の二軸クラスプ試作

設計元は [`camera_housing_clasp.scad`](camera_housing_clasp.scad)。単位 mm。ユーザー写真の二軸機構と、[PrintablesのCC0 GoPro Hero 9 Waterproof Case Clasp](https://www.printables.com/model/591613-gopro-hero-9-waterproof-case-clasp) の薄いU字状レバーを参考にした**新しい汎用設計**です。公開STLはレバー1点だけで、そのまま機体固定には使えません。台座、二本のリンク、受け、EPDM座を加えました。旧 `dji_style_toggle_latch` は形状不一致の探索履歴です。

## 機構と仮寸法

固定A軸から可動B軸まで12 mm。閉じたリンク角190°でオーバーセンターとし、解除角115°まで動かします。台座から受け原点まで35 mm、A軸高さ10.5 mm。レバーは中央の開口を幅26 mmまで広げ、屋根を厚3.4 mmにし、側面のヒンジ耳も細くしました。M3ヒンジ穴の設計径は3.45 mm。台座の4穴は x=−10,+3、y=±23 mm、受けの4長穴は受けローカル x=−12,−4、y=±23 mmです。**この穴配置、台座間隔、指の空間は実機未採寸の仮値**です。どの機体にも無加工で合うとの主張ではありません。

## 固定片を押し合わせる構造

台座右端と受け左端の立ち上がりを向かい合わせ、**閉位置の面間隔を0.8 mm**にしました。間へ厚1 mmの**無発泡**EPDMを24×8 mmに切って貼り、閉位置で0.2 mm圧縮します。これは二つの固定片が直接力を受け渡す主たる合わせ面です。オーバーセンター通過時には閉位置からさらに約0.24 mm引き寄せる幾何関係で、最大圧縮の幾何予測は約0.44 mmです。EPDMの反力・操作力は硬度、貼り方、機体側の剛性で変わるため数値保証ではありません。最初は受けの長穴を緩め側に置き、現物で必要な操作力へ調整します。

台座と受けの立ち上がりは高さ14 mm、幅38 mm。受け側は可動レバーの下に高さ12.5 mmの背当てを延ばし、フック側のリブまで荷重をつなぎます。閉じたレバーが押す相手を固定片の背後に設けた形です。前版のように二つの取付板が空中で離れたままにはなりません。

受けのフック溝にも厚1 mmのEPDMを貼ります。奥・天井の主片は幅23.2×展開長14.43 mm、左右片は約4×12.5 mmを各1枚。SCADの `epdm_main_template` と `epdm_side_template` は切出しの初期形状です。こちらはガタ取り用で、閉位置の公称すき間0.95 mm、公称圧縮0.05 mm。接着層、EPDM硬度、経時へたりは未反映です。開放溝なので防水シールではありません。

青い受けに掛かる灰色の中央爪は幅18→22 mm、外側の壁4→6 mm、爪先の厚さ4.2→5.2 mmに増肉しました。受けのリブ幅も32→36 mmとし、EPDM溝を広げても左右の壁を残します。爪先の実STL最小厚さは約5.2 mm。爪の手前の屋根は後方への延長を6→0.8 mmに短縮し、浮いた補強リブも除去しました。掛かり部分の厚みと組立位置は維持しています。形状増加だけで強度を保証するものではなく、機体荷重の試験は別途必要です。

印刷は[組立の印刷入口](../../../../assemblies/camera_housing_clasp/parts/PRINT.md)を使います。購入金具の想定はM3×40（A軸）とM3×50（B軸）各1本、緩み止めナット各1個です。CAD内の軸は包絡形状で印刷対象外。金属軸はレバーを締め付けずに回せるよう調整し、抜け止めを設けます。取付ネジ長は機体側板厚に合わせます。

## 印刷と組立

Bambu Lab PETG Basic、0.4 mmノズル、0.2 mm積層、6周壁、100%インフィルを**試作開始条件**にします。台座・受けは底面、リンクは側面、レバーは天面を下にする印刷回転を `manufacturing.json` に記録しています。**サポートなし**でスライスし、掛かり面の初層パスが前層からつながっているかプレビューで確認します。台座とレバーの横軸穴はティアドロップ、リンクの穴は印刷時に縦向きです。台座の根元は45°のガセット、レバー中央の長い片持ち屋根は短縮しました。残る機能的な掛かり面の下向きパッチの短辺は受け約3.1 mm、レバー約3.8 mmと1.3 mmです。[造形姿勢の幾何監査](../../../../assemblies/camera_housing_clasp/_work/analysis/print_support/report.json)はスライサの実サポート経路ではなく、無サポート造形の保証でもありません。スライサが同じ箇所へ片持ちはり警告を出す場合は、その位置のプレビューを確認してから形状・姿勢を再調整してください。

リンク2枚とレバーをB軸でつなぎ、リンクをA軸で台座に留めます。台座の合わせ面へ24×8 mm EPDMを貼り、受けのフック溝にもEPDMを貼ります。開状態で受けを仮固定し、二つの立ち上がりの面間隔を0.8 mmにしてから開閉します。長穴を少しずつ調整し、素手で確実に開閉できる範囲にします。

公開STL実測の外形は62.25×37.50×8.75 mm。新レバーはヒンジ・掛かり・材料厚を機体用に再設計したため、同一形状の複製品ではありません。元ケースへの交換互換性はありません。

## 検証範囲

[幾何検証](../../../../assemblies/camera_housing_clasp/_work/analysis/geometry/report.json)は部品メッシュの閉性、取付穴と工具通路、241姿勢の剛体干渉、二つの合わせ面の0.8 mm間隔、EPDMの幾何圧縮、爪の掛かりを確認します。再実行は `python spec/camera_housing_clasp/verify.py`。荷重、保持力、積層方向別強度、疲労、振動中の緩み、実物の操作力は未測定です。実機へ使う前に手で開閉し、必要保持力と取付相手の寸法を確認してください。
