AquaBeacon/mechanical/parts/common/jigs/tether_storage_reel/tether_storage_reel.md

# テザー保管リール

輸送・保管時に Fathom テザー 30 m を手で巻くためのリール。設計日: 2026-09-16。
本体と着脱つばの2部品。中心穴を持って本体を回しながら巻く。機体の牽引には使用しない。

## 設計対象と根拠

- ユーザー指定: Body_Modelsで購入したテザー、輸送・保管用。
- 購入記録: ワークスペース `docs/未踏ジュニア購入物品.xlsx`、sheet1の24行。
  「Fathom ROV Tether (by the meter) - ツイストペア 4【1 m単位】」、数量30。
- [購入先の商品ページ](https://underwaterdrone.stores.jp/items/6350a19dd7e1d85a12abe865)
- [メーカー技術資料](https://bluerobotics.com/learn/technical-reference/): 標準4ペアは外径7.6 mm、静的最小曲げ半径75 mm。
- [メーカー商品ページ](https://bluerobotics.com/store/cables-connectors/cables/fathom-rov-tether-by-the-meter/)は最小曲げ「直径」75 mmと表記が異なるため、本設計は大きい方の半径75 mmを採用。巻き芯表面半径80 mm。
- 実物の外径・連続した長さ・製品リビジョンは未実測。上記購入記録による30 mの標準品を設計対象にしている。変更時は `cable_d`, `cable_length_m`, `min_bend_radius` を更新して再ビルドする。

## 寸法と容量

| 項目 | 値 |
|---|---:|
| 組立外形（ねじ除く） | Ø240 × 148 mm |
| 巻き芯 / 有効幅 | Ø160 / 140 mm |
| つば厚 / 巻き芯壁厚 | 4 / 3.2 mm |
| 中央の持ち穴 | Ø110 mm |
| ケーブル巻き外径の目安 | Ø224 mm以下 |
| 本体の印刷外形 | 240 × 240 × 144 mm |
| ふたの印刷外形 | 240 × 240 × 7 mm |
| 容量見積り | 38.7 m（充填率0.65） |

容量 = 0.65 × (224²−160²) × 140 / 7.6² / 1000。
整列巻きの別計算では18巻/層 × 4層で約43.1 m、4層目の外径220.8 mm。
30 mはこの約70%。端末の収納量や巻き乱れ次第で変わるため、実巻き確認は未実施。

## ファイル

- `tether_storage_reel.scad`: 全寸法の設計ソース。`part="assembly"`で組立表示。
- `tether_storage_reel_base.stl` / `.step`: 本体、1個。
- `tether_storage_reel_lid.stl` / `.step`: ふた、1個。
- `_work/images/tether_storage_reel_preview.png`: 組立形状（ねじ・ケーブルは省略）。
- `mesh_check.json`: STLの寸法、閉じた形状、体積、連結成分の検査結果。

## 用意するもの・組立

1. 印刷部品各1個。
2. M4×160 mmボルト3本、M4ナット3個、M4平座金6枚。
   首下160 mmに対して本体＋ふた148 mm、座金2枚約2 mm、ナット約3.2 mmで締結可能。
   入手しにくければM4全ねじ棒を170 mmに切ったもの3本、ナット6個・座金6枚で代用する。
3. 幅15 mm以下、長さ400 mm程度の面ファスナーバンド2〜3本。

本体内側の3本の穴へボルトを通し、ふたの位置決めリップを巻き芯の内側に入れる。
穴を合わせて座金・ナットで軽く均等に締める。プラスチックが凹むほど締めない。
ボルトとナットは巻き芯より内側にあり、巻かれたテザーに接触しない。
位置決めリップは半径方向0.4 mmの隙間。実機の嵌合は未確認。

## 印刷と仕上げ

- PETG、0.4 mmノズル、積層0.2 mm、壁5周、上下6層、インフィル20〜30%を初期値とする。
- 本体はつばを下に、ふたも平らなつばを下にして、別々に印刷。サポート不要の形状。
- X1Cの256 mm角ベッドを想定。Ø240なので片側8 mmの余白。ブリムは最大5 mmを目安に、スライサの除外領域とパージ位置を確認する。
- テザー接触面のバリ・糸引きを除去する。特につば内面、巻き芯端、中央持ち穴、バンド穴の縁を滑らかにする。
- 壁厚・ねじ部の強度や落下耐久は未試験。印刷時間・材料量はスライサで確定する。

## 巻き方

両端に接続作業用の余長を残す。始端は巻き芯に沿わせ、手で押さえて最初の数巻を重ねる。
ケーブルを引きずらず、本体を回して軽い張力で均等に巻く。端末を小さな穴へ押し込まない。
巻き終わりはつば外周の18×4 mmスロットへ面ファスナーバンドを通し、
反対側のつばの対応するスロットを経由して束を留める。きつく締めて外被をつぶさない。
接続済みの機体を回転させず、端部を自由にできる状態で巻く。外すときもリールを回して繰り出す。
端末は曲げ半径75 mm以上の余裕を付けて外側へ留める。濡れたテザーは洗浄・乾燥してから保管する。

## 検証

OpenSCADで両部品をレンダリング済み。各STLは閉じた単一連結メッシュ。
STEP生成時のSTL照合では外形差0.01 mm未満、体積差0.02%未満。
STEPを再読込して両部品が有効な単一ソリッドであること、組立時の体積干渉0 mm³を確認。
結果は `step_check.json`、再検証はFreeCADで `verify_step.py` を実行する。
組立プレビューを目視確認済み。実印刷・30 mの実巻き・耐荷重試験は未実施。

再生成: Body_Modelsで `./build.ps1 -Paths parts/common/jigs/tether_storage_reel`。
