AquaBeacon/mechanical/parts/common/exterior/cots/td04a_transducer/td04a_transducer.md

# TD04A 超音波振動子 (HONDEX)

## 現行の固定取合い（2026-10-21ユーザー確認）

**本体の固定穴はM4・中心間隔10 mmの2穴。工具を使う着脱でよい。** [確認記録・写真](ref/user_mount_interface_20261021.json)。寸法の正本は `scad/lib/td04a_interface.scad`。親機下向き・子機側面固定／上向きの治具Rev.5はこの2穴へ直接固定する。[設計と印刷入口](../../../../../assemblies/td04a_fixture/README.md)。

**写真の金属部を置き換える2種類：親機の広い面は下、子機の広い面は上。**

**向きの訂正：2穴を結ぶ線と本体の一番広い面は平行、ねじ止め面とその広い面は垂直。** 下記の既存外観モデルはこの固定面の関係も未修正なので、現行治具の姿勢・干渉検査には使わない。

穴間隔は写真から測った値ではなく、ユーザーの指定値。下記の古い外観CADの `screw_pitch=12` は仮の見た目モデルの値で、現行固定設計には使用しない。共有外観モデルは今回変更せず、取付耳の厚さ・座面・ケーブル根元・機器全体は未実測として保持する。写真にはねじ・ナットの締結が見えるが、本体の雌ねじ・有効ねじ深さは仮定しない。

購入品 (COTS)。子機・親機の**両方**で使う音響トランスデューサ。メーカーCADは未入手。2026-09-14に**製品写真を参考にした仮寸法の外観モデル**を作成。

## 外観モデル（2026-09-17更新）

ユーザー提供の `model.ply`、`model.ply.json`、実物写真2枚を参考に更新。単純な円筒を、上部が丸く底辺が平らな本体へ修正。背面の取付部、ねじ頭2個、ケーブル根元、長穴付き金属ブラケットの簡略形状を追加した。ブラケットは本体と一体の参照ソリッドであり、分解・可動モデルではない。

- `td04a_transducer.step`：Fusion 360用。単一ソリッド、42面。
- `td04a_transducer.stl`：閉じた確認用メッシュ。
- `td04a_transducer.scad`：編集可能な寸法パラメータ。
- `_work/images/td04a_transducer_preview.png`：4方向プレビュー。
- `ref/td04a_scan_crop.ply` / `_work/images/ref/scan_crop.png`：台紙面を推定して傾きを補正したスキャン切出し。ケーブルとブラケットの一部を含む。底面から2 mm未満を除いた未修復の参照メッシュ。
- `ref/scan_alignment.npz`：元の座標から補正座標への変換（vertices-origin）@rotation.T。
- `ref/td04a_provisional_v1.scad`：以前の仮モデルの保存。

**全寸法は未検証。** 本体は幅`width=46`、高さ`height=48`、厚さ`depth=20` mmの丸めた推定値。補正スキャンの本体付近の幅・高さ範囲を参考にし、写真で輪郭を補った。厳密な曲面フィッティングではない。ブラケット幅24・板厚2・後方延長48、ねじピッチ12、ケーブル径5 mm等は写真に合わせた仮値で、スキャンから精密測定した値ではない。全体外形46×48×73 mm。

JSONは「見た目モデル・寸法保証なし」、自動校正失敗、尺度はmanual-two-point。export_unit=mmのためPLYを再スケールしていない。元メッシュ408371頂点・816609面、境界エッジ175（JSON値）。台紙・床・ケーブルを含み、黒い本体に欠測あり。全体の閉じていないスキャンをそのままSTEP化せず、観察できる外形を簡略CADとして再構成した。

原点は正面の底辺中央。X=幅、Y=高さ、Z=背面方向。旧版の原点・形状とは異なるため、組立に使用する際は配置し直すこと。既存アセンブリ・ソケットは変更していない。メーカーCADではなく、取付適合は未確認。実物の幅・高さ・厚さ、ねじピッチ、金属板寸法の実測が必要。

再生成：`./build.ps1 -Paths parts/common/exterior/cots/td04a_transducer`。

検証：OpenSCAD STL生成、閉じたメッシュを確認。FreeCAD STEPは1ソリッド。STLとの外形差は表示精度で0.00 mm、体積差約0.03%。プレビューを確認。形状ファイルの整合性検証であり、実物精度の保証ではない。

## 製品情報

| 項目 | 値 |
|---|---|
| 区分 | 共通 / 外装 / 購入品 |
| メーカー | 本多電子 (HONDEX) |
| 型番 | TD04A (3P プラグ品: TD04A-3P) |
| 製品ページ | https://store.echotech.co.jp/products/td04a-3p |
| メーカー振動子一覧 | https://www.honda-el.co.jp/product/marine/lineup/transducer |
| 使用数 | 子機 1 / 親機 1 / ポール治具 2 (試験時) |

## 仕様 (公称)

| 項目 | 値 |
|---|---|
| 周波数 | 200 kHz |
| 出力 | 100 W |
| 指向角 | 22° |
| ケーブル | 3 m / 3P プラグ |
| 付属 | 取付ブラケット |

## 従来の組立設計の仮寸法（今回の外観モデルとは別・未実測）

| 項目 | 現在の設計値 | 状態 |
|---|---|---|
| 胴径 | 26.0 mm と仮定 | **要実測** |
| 胴長 | 55 mm 以上と仮定 | **要実測** |
| ケーブル引出し部の外径 | 不明 | **要実測** |

## この寸法に依存している自作部品

| 部品 | 依存している値 |
|---|---|
| `parts/common/exterior/printed/xdcr_socket` | `xdcr_d = 26.4` (胴径 26.0 + 0.4 クリア), `depth = 32` |
| `parts/common/jigs/xdcr_pole_jig` | `xdcr_d = 26.0`, `xdcr_len = 55` |
| `parts/common/jigs/xdcr_clamp` | `xdcr_d = 26.0`, `xdcr_len = 55`, `cable_d = 9` |
| `parts/common/jigs/xdcr_poolside_jig` | `clamp_axz = 20.5`, `clamp_fx = 38` (`xdcr_clamp` の導出値) |
| `parts/child/exterior/printed/child_shell_aft` (縦置き構成) | `xd_pitch = 40` (ソケットの `hole_p` と一致)。**胴長 55** が「振動子上端 z=243 < ドーム頂点 261」の根拠 |

**胴径が変われば上記 4 部品を必ず作り直すこと。** 実測後は各 `.scad` の
`xdcr_d` を書き換えて `build.ps1 <部品フォルダ>` で再ビルドする。

`xdcr_clamp` を作り直したらビルド時の `echo` に出る `axis_z` / `face_off` を
`xdcr_poolside_jig.scad` の `clamp_axz` / `clamp_fx` へ**転記する**。
転記を忘れても部品はできてしまうが、**プールサイド治具の「振動子の深さ」と
「壁面からのオフセット (= 測距の基準距離)」の計算値だけがずれる。**

## 部品外の考慮 (ケーブル)

- **ケーブル 3m は切れない/延長しにくい前提で配置を決めること**。プラグは 3P で
  水中コネクタではないため、**プラグ側は必ず水面上 or 容器内**に置く。
- **縦置き構成 (構成 B) では**、`child_shell_aft` の後部パイロン屋根 (z=182, y=-86) に
  `xdcr_socket` (child バリアント) を上向きで固定する。ケーブルはパイロン内部の
  空洞を導管として下へ降り、下キャップのペネトレータへ入る。
  **上向きビーム (指向角 22°) の中にドーム・吊り耳は入らない**が、
  **吊りロープは振動子面から約 440mm 上でビームに入る**。細径なので影響は小さいと
  見ているが、E1 の実験時に確認すること。
  取付は **Ø4.3 下穴への M5 タッピング** (パイロン屋根が厚さ 16mm)。
  着脱を繰り返すなら熱圧入インサートに置換する。
- 子機側: 振動子はフレームプレート後方コーナーの `xdcr_socket` に上向きで挿し、
  ケーブルはソケット底の Ø9 穴から出して後方キャップのペネトレータへ入る。
  ソケット底の Ø9 は**水抜きも兼ねる**ので塞がないこと。
- ペネトレータを通すためにはケーブル外径が WetLink の対応径 (4.5–8.5mm) に
  入っている必要がある。**外径未実測**。
- **3P プラグはペネトレータのボア (Ø3.3–6.5) を通らない。** WetLink は濡れ側
  だけをシールし、乾き側には素の導体しか出ない構造なので、**ペネトレータを
  使う = ケーブルを切って容器内で端子台に落とす**ということ。
  親機はこの前提で `assemblies/parent_interior_p{1,2}` の南壁 x=85, z=65 に
  `pen_td04a` を置いてある (2026-08-29)。**3m は延長できないので、切る位置
  (= 実機での据付長) を先に決めること。**
- 振動子は音響部を**気泡なく水に浸す**必要がある。ソケットは振動子の放射面を
  塞がない (現状は上向きに開口)。
- 試験治具は 2 系統ある。**ポール治具** (`xdcr_pole_jig`) は結束バンド 2 本
  (4.8mm 帯) で保持し、深さはポール上の位置で決める (E1 仕様は水面下 0.6m)。
  **プールサイド治具** (`xdcr_poolside_jig` + `xdcr_clamp`) は縁に掛けるだけで
  設置が速いが、深さは水面下 157.5mm 止まり (ベッドサイズ律速)。
  プールサイド治具ではケーブルの水中経路が約 0.4m しかないので、
  **縁から機器置き場まで 2.5m を超えると 3m のケーブルが届かない。**

## 要確認

1. 胴径・胴長・ケーブル外径の実測
1b. 親機側の端子台 (箱内で 3 芯を受ける) — **未設計・未選定**
2. 3P プラグの防水可否と、子機容器内へ引き込む場合の処理
3. 送受を対面させる試験 (E1) での配置は `../docs/AquaBeacon_実験検証仕様書.md` 参照

## 出典

- [TD04A / TD04C 魚群探知機レジャー用振動子 — エコーテック](https://store.echotech.co.jp/products/td04a-3p)
- [振動子一覧 — 本多電子](https://www.honda-el.co.jp/product/marine/lineup/transducer)

## 公式取付資料の確認（2026-10-20）

[本多電子の取付方法](https://www.honda-el.co.jp/product/marine/document/mounting_method_of_transducer)のTD04A/TD04C図で、本体と付属曲げ金具をねじ2本・ワッシャ・ナットで組み、金具上側の長穴から船体へ固定する構成を確認した。本体に雌ねじがあるとは断定できない。公開図にはねじ径、ピッチ、長穴寸法、板厚の記入がなく、今回の調査でも寸法付きCADは確認できなかった。写真や既存仮モデルのピッチ12 mmをねじ穴設計へ流用しない。

原本画像は [ref/hondex_td04a_transom.jpg](ref/hondex_td04a_transom.jpg)、URL・SHA-256は [ref/official_sources.json](ref/official_sources.json)。以前の26 mm円筒ソケット類はこの図と適合確認した固定方法ではない。

2026-10-20の旧[共通C式固定治具Rev.1](../../../../../assemblies/td04a_fixture/_work/intermediate/history/metal_clamp_r1/README.md)は、付属金具を残して平坦部をM4ねじ2本で挟む実物合わせ用試作だった。受入条件の金具幅18〜28・厚1〜3・平坦部16 mm以上は自作治具の設計範囲で、TD04Aの公称値ではない。現行Rev.2ではユーザー確認のM4/10 mm穴へ直接留める。

ケーブル外径は2026-09-10のユーザー指定 **5 mm** を引き継ぐ。旧本文の「外径未実測」は履歴上の記述。曲げR30 mmは仮条件、実曲げ半径や最終経路・コネクタ処理は未確定。
