AquaBeacon/mechanical/parts/common/interior/cots/threaded_stud/threaded_stud.md

# M3金属通しスタッド（購入品・印刷禁止）

現行の子機ブレースにはM3×30を1本、M3×45を1本使用。普通M3ナット2個で上側を固定する。
左右フランジは別部品のM3×26なべねじを使用する。
過去のM3×8／×10バリアントは履歴として保持する。
型番未指定。平先全ねじ棒または頭なしねじの円柱包絡で、ねじ山・工具穴は省略。
正本は`threaded_stud.scad`。原点は下端、+Zへ伸びる。
[用途と取付寸法](../../../../child/interior/printed/child_spacer_set/child_spacer_set.md)。
