AquaBeacon/mechanical/parts/child/exterior/cots/action_camera/action_camera.md

# アクションカメラ — DJI Osmo Action 6 + 純正防水ケース

## 2026-09-09 実物確認・取り付け寸法の更新

ユーザーがDJI純正Action 6防水ケースであることを確認。写真は穴付きの一体型2枚爪を示す。以下の旧記載にある磁気クイックリリースとの混同は訂正する。

ユーザー実測：爪厚3 mm、爪の内側間隔3 mm、穴径5 mm、ケース本体底面から穴中心12.5 mm。純正ねじあり、受け側なし。ねじ露出長17〜18 mmは写真推定で、ピッチと有効かかり長は未確認。

関連設計は `parts/child/exterior/printed/dji_osmo_action6_mount/`（DJI osmo Action 6固定部品）へ集約。実測に基づく嵌合試験片は同フォルダの `archive/osmo_case_fit/` に保管。現行機体の `child_cam_mount` は旧仮寸法のままなので実物適合未確認。要求は角度・位置ずれの抑制と容易な取り外し。試験片は回転止めを持たず、実使用不可。

購入品 (COTS)。**機種確定** (`../docs/AquaBeacon_確定仕様メモ.md`: 「DJI Osmo Action 6 ×2
（マッピング撮影）」)。**メーカー3Dモデル未入手**。外観・配置確認用の仮CADを
[`visual_proxy.scad`](visual_proxy.scad) に作成した。公称外形と記録済みの底面タブ寸法を反映しているが、実物適合モデルではない。出力は
[`visual_proxy.stl`](visual_proxy.stl) と [`visual_proxy.step`](visual_proxy.step)。

| 項目 | 値 |
|---|---|
| 区分 | 子機 / 外装 / 購入品 |
| メーカー / 型番 | DJI / Osmo Action 6 |
| 用途 | 子機のステレオ撮影 (左右 1 台ずつ) |
| 使用数 | カメラ 2 / 防水ケース 2 |
| マウント | ケース底面の DJI クイックリリース (デュアルタブ)。**本設計では使わない** |

## 仕様 (公称)

| 項目 | カメラ本体 | 防水ケース |
|---|---|---|
| 外形 | 72.8 × 47.2 × 33.1 mm (長さ×幅×高さ) | 94.7 × 45.9 × 84.1 mm (同) |
| 質量 | 149 g | 110 g (曇り止めインサート 2g ×6 付属) |
| 防水 | 20 m (ケース無し) | **60 m** |
| 画角 | FOV 155° | — |
| 絞り | f/2.0〜f/4.0 (可変絞り) | — |
| その他 | 内蔵 IMU / 水深計 / タイムコード。**GPS 非内蔵** | 高強度ガラス窓 |

## この寸法に依存している自作部品

| 部品 | 依存している値 |
|---|---|
| `parts/child/exterior/printed/child_osmo_holder` | `case_w/case_d/case_h = 94.7/45.9/84.1`、`tab_w/tab_h = 40/18` (仮)、`lens_z = 52` (仮)、`fov_half = 77.5` |
| `parts/child/exterior/printed/child_osmo_arm` | フィンガー厚 3.0 / 間隔 3.4 / 高さ 16、ピン穴 Ø5.2、フィンガー中心 X = 125 / 150 / 175 |

- **基線 (2 台の間隔) は 250 / 300 / 350 mm から選択**できる (フィンガー位置 3 箇所)。
  ステレオ視の精度と近接限界のトレードオフ。
- カメラの**下向き 20°** は `child_osmo_holder` に作り込んだ。
  → **GoPro ナックルは不要になった** (以前は別途購入としていた)。

## 寸法の解釈 — **要現物確認**

DJI 公称の軸表記がカメラ本体とケースで揃っていない (ケースの「幅 45.9」は
カメラの「幅 47.2」より小さく、そのままでは内包できない)。
`child_osmo_holder` は下記のように解釈して設計している。

| ケース公称 | 本設計での割り当て | 根拠 |
|---|---|---|
| 94.7 | X = 基線方向 (横幅) | カメラ 72.8 + 壁 ≈ 11/側 |
| 45.9 | Y = 前後 (レンズ〜背面) | カメラ 33.1 + 壁 ≈ 6.4/側 |
| 84.1 | Z = 上下、**底面タブ込みの全高** | カメラ 47.2 + 底面タブ + 上部ラッチ |

3 軸とも公称が本体を内包でき、他の割り当てでは矛盾するのでこの解釈にした。
**現物で 3 軸・底面タブ・レンズ中心高さを測ること。**

## 部品外の考慮

- **カメラの視野 (155°) にテザー・振動子・ライト・アーム・ホルダ自身が入らないこと**。
  `child_osmo_holder` はケース前面より前に出る構造を前リップだけに限り、
  角度余裕を assert で検査している (現在 5.8°)。`assemblies/child_assembly` の
  プレビューでも確認する。
- 充電 / データ用のポートに水中でアクセスしない。**運用前に充電・設定・SD を済ませる**。
  電池交換はストラップ (M4 ×2) を外す必要がある。
- 公称約 4 時間だが**水中・低温で目減り**する。予備電池を用意
  (`../docs/AquaBeacon_確定仕様メモ.md`)。
- カメラ同期は「両 Osmo のタイムコードを同一スマホに合わせる + 潜行前後に水中ライトを
  既知時刻でブリンク」。子機 Osmo の内蔵水深計も活用する。
- ケーブルは無し (独立電源・独立記録)。

## 要選定・要確認

1. **防水ケースの 3 軸・底面タブ寸法・レンズ中心高さの実測**
   → `child_osmo_holder.scad` の `case_*` / `tab_*` / `lens_z` を確定して再ビルド
2. ケースのラッチ位置 → `child_osmo_holder` の `strap_y`
3. 基線の決定 (250 / 300 / 350)
4. 予備電池 / 充電器の手配 (BOM)

## 出典

- [Osmo Action 6 スペック — DJI](https://www.dji.com/osmo-action-6/specs)
- [Osmo Action 6 防水ケース — DJI Store](https://store.dji.com/jp/product/osmo-action-6-waterproof-case)
- [DJI Osmo Action 6 Technical Specifications — DrDrone.ca](https://drdrone.ca/pages/dji-osmo-action-6-technical-specifications)

## Blender外観検討への追加（2026-09-27）

[子機外装イメージ](../../../../../assemblies/child_exterior_concept/README.md)ではCの各面に1台ずつ配置。形状は `visual_proxy.json` / `visual_proxy.scad` の簡略模型です。カメラは水平に外向き。既存DJI防水ケース記録の外形比率を使用し、製作取合いを確定しません。

## CAD仮定・未実測部

- 座標はX=94.7 (横幅)、Y=45.9 (前後)、Z=84.1 mm (底面タブ込みの公称包絡) と解釈した。
- ケース本体高さ75 mm、底面角R6 mm、タブのY幅18 mm、レンズ外周は視覚化用の仮値。
- タブ厚3 mm、タブ内側間隔3 mm、穴径Ø5 mmは記録済みの実測値。穴中心高さ12.5 mmは外形モデルの最下端を基準に置いた暫定解釈。
- CADは一体の外観モデルで、ケースの継ぎ目・ボタン・ヒンジ等の詳細は再現していない。防水・強度・マウント適合・レンズ位置は保証しない。
- 実物のケース本体底面からタブ穴中心までの方向と距離、タブ幅、レンズ中心高さ、角部形状を測定後、`visual_proxy.scad` の値と座標基準を確定する。
