AquaBeacon/mechanical/parts/child/exterior/cots/wte4_end_cap_5xm10/wte4_end_cap_5xm10.md

# WTE4 エンドキャップ (アルミ / M10 ペネトレータ穴 ×5)

購入品 (COTS)。フランジに差し込んで容器を閉じる蓋。ペネトレータ 5 本を通せる。

| 項目 | 値 |
|---|---|
| 区分 | 子機 / 外装 / 購入品 |
| メーカー | Blue Robotics |
| 型番 | BR-102993-005 |
| 製品ページ | https://bluerobotics.com/store/watertight-enclosures/wte-vp/ |
| 材質 | アルミ 6061-T6 (Type II アルマイト) |
| 使用数 | 2 (子機 前後。ペネトレータ実装は**後方のみ**) |

## 寸法・仕様 (メーカー公称)

- 板厚 **10 mm**
- 質量 223 g
- 耐圧深度 **1000 m**
- 取付ねじ **M3×0.5-12**
- 穴円直径 **108.0 ± 0.1 mm** (取付ねじの BCD と思われる。要確認)

## 実モデルからの実測 (このフォルダの STL)

| 項目 | 値 |
|---|---|
| バウンディングボックス | 120.30 × 114.28 × 10.00 mm |
| 体積 | 82.7 cm³ |
| プラグ部 | **Ø88.2 × 4.2 mm** (局所 z 0..4.2。フランジ貫通口へ差し込む側) |
| 露出する円板部 | **5.8 mm** (局所 z 4.2..10) |
| **M10 ペネトレータ穴** | **5 個 / BCD 56 / 72° 間隔 (1 個が真下)** |

STL/STEP とも **軸 = Z (0..10)、プラグ部 = z 0..4.5 側、断面中心 = (60.15, 57.15)**。

**STEP の座標系について (2026-09-02)**: ベンダ配布の STEP (`ref/` の zip 内) は
**断面中心 = (0, 0)、Z = -4..6** で、アセンブリ STEP だけずれていた。このフォルダの
`.step` は原本を `scad/lib/step_reframe.py` で **(+60.15, +57.15, +4) 平行移動**して
STL と同じ座標系に書き直したもの (頂点→表面距離 0.000 mm)。原本は `ref/` の zip のまま。
手順は `wte4_acrylic_tube.md` と同じ (TRANSLATE=60.15,57.15,4)。
バウンディングボックスが真円 (Ø120.3) ではなく 120.30 × 114.28 なので、
外形に**方向のあるフラット/タブがある**。組付け時の向きを実物で確認すること。

## ペネトレータ配置 (後方キャップ / 5 穴)

`docs/配線・ケーブル計画.md` を参照。子機で外へ出る配線はすべてこのキャップを通る。

| # | 用途 | ケーブル |
|---|---|---|
| 1 | テザー (電源+RS485) | 要選定 |
| 2 | 超音波振動子 TD04A | 同軸 |
| 3 | 水中ライト | 2 芯 |
| 4 | 予備 / 将来センサ | — |
| 5 | 予備 (またはブランクプラグ) | — |

未使用穴には**必ずブランクプラグ**を入れること。

## 部品外の考慮

- ペネトレータは 3.5 N·m でバルクヘッドへ締結、プラグ側は約 14 N·m。
  **トルクレンチが入る工具アクセス**をキャップ周囲に確保すること
  (トレイやクランプがキャップ外周に被らない配置になっているか要確認)。
- ケーブルはキャップ内側で**サービスループ**を取る。前端のケーブル余裕ゾーン 30mm と
  合わせ、トレイ引き出し時にケーブルが突っ張らないこと。
- アルミとステンレスねじの**異種金属接触腐食**。海水使用時は防食グリス/絶縁ワッシャを検討。
- キャップは 1000m 耐圧だがチューブ (300mm 品) は 100m。**系としての耐圧はチューブ律速**。

## キャップ自体の穴 (2026-09-03 確定: STEP を FreeCAD カーネルで抽出 + 公式データシート)

| 穴 | 個数 | 径 | BCD | 位相 | 用途 |
|---|---|---|---|---|---|
| キャップ固定ねじ | **6** | Ø3.2 **貫通** | **108.0** | 30° + 60°n | M3×0.5-12 (SS316 キャップスクリュー) でフランジ外面のタップ穴へ |
| ペネトレータ | 5 | Ø10.2 貫通 | 56 | 72° ピッチ (1 個が 270°) | M10 |

**キャップ内面 (プラグ側) にタップ穴は無い。** 内装 (トレイ) を固定する 4× M3 は
**フランジ BR-101040 の内面 (BCD 94.0, 0/90/180/270°)** にある → `../wte4_flange/wte4_flange.md`
と `../wte4_flange/_work/images/ref/BR-101040_hole_map.png`。
公式データシート: `../wte4_flange/ref/WTE-DATASHEET-RevC.5-MAY2026.pdf` (p.2 End Caps: 100(4") 6061-T6 =
"6x M3x0.5-12 / (K) Ø108.0 ± 0.1 / (L) 10 ± 0.1")。
`ref/WTE4-P-END-CAP-R1.DXF` は Blue Robotics 公開の 4" **アクリル (P) ブランクキャップ**の 2D 図面
(docs.bluerobotics.com)。アルミ M キャップの 2D 図面は公開されていない (3D の zip のみ)。

## ガードの輪郭取合い確認（2026-09-27）

ユーザーが提示した外面画像の左右突起は、このCADの±Xのタブに対応する。
`child_endcap_guard` の生成ではSTEPのZ=8断面から最大外形を取得した。
外面Z=10の外周には0.5 mmの面取りがあり、輪郭が119.3 × 113.3 mmへ小さくなるため、
この外面の線だけをはめ合い寸法に使わない。最大外形は120.3 × 114.3 mm。
左右突起は180°反転対称であり、ガードの受け輪郭だけでは180°反転を拒否できない。
キャップ固定ねじ6本はガードでも維持する。

STEPの軸方向再測定ではプラグ端面Z=0、露出板裏面Z=4、外面Z=10で、露出板は**6.0 mm**。
上の旧STL読み取り4.2/5.8 mmは近似値。既存下フランジの取合い面Z=-8へ合わせると
キャップ外面はZ=-14.0となる。新しい `child_endcap_guard` はこの値を使用する。
既存構成の外面Z=-13.8の配置では金属同士が軸方向0.2 mm重なり、今回BRepで572.08 mm³の
重なりを確認した。他assemblyの配置・既存内装はこの作業では変更していない。

## 要確認

1. ~~公称「穴円直径 108.0」が何の BCD か~~ → **キャップ固定ねじ 6× M3 の BCD** (上表)
2. ~~キャップ内面の M3 タップ穴の有無~~ → **無い**。内装固定はフランジ BCD94 を使う
3. 外形の非円形部 (120.30 × 114.28) の向きと、それが組付け方向を決めるか

## 出典

- [Watertight Enclosure — Blue Robotics](https://bluerobotics.com/store/watertight-enclosures/wte-vp/)
- 元配布データ: `ref/WTE4_END_CAP_5xM10_BR-102993-005.zip`
