AquaBeacon/mechanical/parts/child/exterior/cots/wte4_flange/wte4_flange.md

# WTE4 O リングフランジ (4" / 100mm シリーズ)

購入品 (COTS)。チューブ端に挿入し、片側でチューブに、反対側でエンドキャップにシールする。

| 項目 | 値 |
|---|---|
| 区分 | 子機 / 外装 / 購入品 |
| メーカー | Blue Robotics |
| 型番 (製品) | BR-100665 |
| 型番 (加工品・モデルファイル) | BR-101040 Rev C |
| 製品ページ | https://bluerobotics.com/store/watertight-enclosures/locking-series/wte-flange-vp/ |
| 材質 | アルミ 6061-T6 (Type III アルマイト) + PTFE ロッキングコード |
| 使用数 | 2 (子機 前後) |

## 寸法・仕様 (メーカー公称)

- 外径 OD **114.3 ± 0.1 mm**
- 全長 (高さ) **27.0 ± 0.1 mm**
- ピストン径 (チューブ内に入る部分) **103.95 ± 0.05 mm**
- 内側取付穴 **M3×0.5、BCD 94.0 ± 0.1 mm**
- O リング: 面シール **AS568-154 Buna-N 70A** ×1 / 径方向シール **AS568-154 Buna-N 70A** ×2
- 質量 107 g

## 実モデルからの実測 (このフォルダの STL)

| 項目 | 値 |
|---|---|
| バウンディングボックス | 114.30 × 114.30 × 27.00 mm |
| 体積 | 38.7 cm³ |
| **貫通口 Ø** | **88.5 mm** (機体設計はこの値を基準にしている) |
| **ピストン部 (チューブへ挿入)** | **Ø104 × 局所 z 0..19** |
| **カラー部 (チューブ外に露出)** | **Ø114.3 × 局所 z 19..27 → 露出 8 mm** |

STL/STEP とも **軸 = Z (0..27)、断面中心 = (57.15, 57.15)**。

**STEP の座標系について (2026-09-02)**: ベンダ配布の STEP (`ref/` の zip 内) は
**断面中心 = (0, 0)** で、アセンブリ STEP だけフランジが XY に -57.15 ずれていた。
このフォルダの `.step` は原本を `scad/lib/step_reframe.py` で **(+57.15, +57.15, 0)
平行移動**して STL と同じ座標系に書き直したもの (頂点→表面距離 max 0.056 mm)。
原本は `ref/` の zip のまま。手順は `wte4_acrylic_tube.md` と同じ (TRANSLATE=57.15,57.15,0)。

**軸方向の実測 (STL を Z でスライスして最大半径をたどった結果)**:
局所 z 0〜約 19 で最大半径 51.96 (= Ø104、ピストン)、z 19〜27 で 57.15
(= Ø114.3、カラー)。ピストンはチューブ端の**座ぐり (Ø104.2 × 20 深)** に入る。

→ **フランジ 1 個がチューブ端から外へ足す長さは 27mm ではなく 8mm。**
縦置き構成の全高計算 (`assemblies/child_vertical_assembly/`) はこの実測に基づく。

## ねじ穴 (2026-09-03 確定: STEP を FreeCAD カーネルで抽出 + 公式データシート Rev C.5)

図: `_work/images/ref/BR-101040_hole_map.png` (STEP の円筒面から作図)。詳細は `docs/子機フランジねじ穴検証.md`。

| 面 | 穴 | 個数 | BCD | 位相 (STEP / 下フランジ配置後も同じ) | 深さ |
|---|---|---|---|---|---|
| **内面 (チューブ側, 局所 z=0)** | **M3×0.5 タップ** | **4** | **94.000** | **0° / 90° / 180° / 270°** | 6.05 (ねじ込み 4〜5mm に制限) |
| 外面 (カラー側, 局所 z 19.15..23.7) | M3×0.5 タップ | 6 | 108.000 | 30° + 60°n | 4.5 (エンドキャップ固定ねじ M3×12 用) |
| 内面 | R4 切欠き | 8 | 89 | 各軸 ±11.85° | 6.5〜7.1 |

データシート (`ref/WTE-DATASHEET-RevC.5-MAY2026.pdf` p.1 Flanges, 100(4") BR-100665):
"(I) Inner Mounting Holes **4x M3x0.5** / (J) Inner Mounting Hole Circle **Ø94.0 ± 0.1** /
(F) Piston Ø103.91 ± 0.05 / (G) Piston Length 19.1 ± 0.1 / (H) 27.0 ± 0.1"。
**エンドキャップ側に内装固定用のタップ穴は無い** (`../wte4_end_cap_5xm10/`)。
内装を「エンドキャップの 4 穴」で固定する = **このフランジ内面の 4× M3 BCD94** を使うこと。

現在の使用状況 (assemblies/child_interior、2026-09-03 で 3 点化): 下フランジの **0° / 180°** を
`child_vtray_deck` のラグ + M3 MF10 スペーサ、**90°** を `child_lcd_support_lower` の固定耳 + M3×12 で使用。
270° は電池箱の床が塞ぐため未使用、上フランジの 4 穴は内側からねじが回せないため未使用。

## この寸法に依存している自作部品

| 部品 | 依存している値 |
|---|---|
| `child_tray_rib` | `flange_bore = 88.5` − `glide_clear 1.0` → リブ外径 Ø87.5 |
| `child_tray_deck` | 同上 (デッキ幅 75 は Ø87.5 の弦長以内であることを assert で検査) |

トレイはこの**貫通口 Ø88.5 を通して**チューブへ出し入れする。したがって
トレイ断面の最大外形は Ø87.5 を超えてはならない。

## 部品外の考慮

- 内側 M3 (BCD 94.0) はフランジ内面のタップ穴。**トレイ前端をここに固定できる可能性がある**
  (現状トレイはリブでチューブ内壁に支持しているだけで、軸方向の固定がない)。
- O リング 3 本は消耗品。シリコングリス塗布を前提に、交換分を BOM に入れておくこと。
- 分解時にフランジを引き抜く工具アクセス (指がかり) をトレイ側で塞がないこと。

## 要確認

1. 貫通口 Ø88.5 は実モデルからの読み取り値。**実物ノギスでの確認**を推奨。
2. ~~内面 M3 (BCD 94.0) の実在・深さ~~ → STEP + データシートで確定 (上表)。
   `docs/AquaBeacon_機体設計.md` の「キャップ内面の M3 タップ穴列」は**このフランジ**のもの。
   残るのは実物でのねじ深さ (モデル 6.05) の確認のみ。

## 出典

- [O-ring Flange for Custom Underwater Housings — Blue Robotics](https://bluerobotics.com/store/watertight-enclosures/locking-series/wte-flange-vp/)
- [Watertight Enclosure — Blue Robotics](https://bluerobotics.com/store/watertight-enclosures/wte-vp/)
- 元配布データ: `ref/WTE4_FLANGE_RAILS_BR-100665.zip`

再検証: `scad/lib/inspect_step_axial_faces.py` (FreeCADCmd、`STEP` 環境変数) で円筒面を JSON に出し、
(半径, BCD 半径) で集計する。`_work/images/ref/BR-101040_hole_map.png` はその出力から作図したもの。
