AquaBeacon/mechanical/parts/child/interior/cots/lipo_35x26x110/lipo_35x26x110.md

# lipo_35x26x110 — 子機用 LiPo (型番・容量 要確認)

**購入品**。ユーザー指定 2026-09-03。製品名・容量・質量は未確定。

| 項目 | 値 |
|---|---|
| 区分 | 子機 / 内装 / 購入品 |
| 型番 | 要確認 |
| 出典 | ユーザー指定 2026-09-03 |

## 寸法

| 項目 | 値 | 由来 |
|---|---|---|
| 長さ (X, `cell_l`) | **110 mm** | ユーザー指定 |
| 幅 (Y, `cell_w`) | **35 mm** | ユーザー指定 |
| 厚み (Z, `cell_h`) | **26 mm** | ユーザー指定 |

原点は左手前下の角 (0,0,0)。X = 長さ 110 / Y = 幅 35 / Z = 厚み 26。
`tol = 0` (製造ばらつきはベイ側で吸収する)。

## リード線

- **充電用リード**: 約 50 mm。**実機では 29mm に切る** (元 50mm を縮詰、下リブ結束スロット (−26,−19) へ XH4 プラグを結束)。
- **電源リード**: 元は 可撓部 60 mm + 硬直部 50 mm (元コネクタ側の熱収縮、曲げ不可) + XT60。**切って付け直す (ユーザー確認 2026-09-03)**: 約 37 mm に切って XT30 メスを付け、端壁の +X 切欠きから +X レール溝の XT30 ピグテール (基板 `J_BAT` パッド直付け) に嵌合する。硬直部と XT60 は無くなる (`xt60_rigid_run` は廃止)。
- 縦置きで上面 (本モデルの +X 端面) の 35 mm 辺の両端から出る。
  充電用リードは `y = lead_edge = 4.5`、電源リードは `y = cell_w - lead_edge = 30.5`
  (いずれも Z 中央、`show_leads = true` バリアントで cube スタブとして表現)。

## モデルについて

購入品だがベンダの 3D データが無いため、**このリポジトリで自作した簡易モデル**。
`lipo_35x26x110.scad` は cube のみで、印刷対象ではない。

| バリアント | 中身 | 用途 |
|---|---|---|
| `_pack` | セル本体 110 × 35 × 26 | ベイ内寸を決める / アセンブリの干渉確認 |
| `_leads` | 本体 + リードスタブ (充電用/電源用、各 4×4×8) | リード出口の干渉確認 |

## この寸法に依存している自作部品

| 部品 | 依存している値 |
|---|---|
| `parts/child/interior/printed/child_vtray_batt_box` | `lipo_w/lipo_h/lipo_l` (110×35×26) |
| `parts/child/interior/printed/child_vtray_batt_floor` | 電池寸法に対する床板長 |
| `parts/common/interior/cots/foam_pad` (`clipo_top` / `clipo_side` / `clipo_end`) | セル外形 110 × 35 × 26 |
| `parts/common/cabling/child_harness` (bat variant) | リード出口・電源側配置 |

**上記部品と本 `.scad` に同じ 110/35/26 を書いている箇所がある。片方だけ直さないこと。**

## 部品外の考慮

- **密閉容器内で充電しない**。充電は必ず機体外でバランス充電器 + セーフティバッグ。
- LiPo は使用とともに膨らむ。ベイには発泡パッド代を見込み、**きつく囲わない**こと。
- 子機では本モデルの **+X 端面を −Z (下) に向けて**置く (縦置き)。リードは下向きに出る。

## 要確認

1. 製品名・容量・質量 (型番候補を発注者と詰める)
2. 実測寸法 (110 × 35 × 26 の現物確認)
3. リード出口の正確な位置と径
4. 充電コネクタ種別 (ハーネスモデルは XH4 を想定)
