AquaBeacon/mechanical/parts/child/interior/cots/lipo_3s_5000/lipo_3s_5000.md

# LiPo 3S 5000mAh (子機用バッテリ) 【廃止】

> **2026-07-31: この想定部品は廃止。**
> 実購入品は **Zeee 3S 2200mAh** で、モデルと寸法は
> [`parts/common/interior/cots/lipo_3s_2200_zeee/`](../../../../common/interior/cots/lipo_3s_2200_zeee/lipo_3s_2200_zeee.md)
> にある (親機・子機で共通の 1 型番、2 本購入)。
>
> 以下は横置き構成 A の `child_tray_deck` がまだ参照している旧想定値。
> **構成 A を採る場合は `child_tray_deck.scad` のベイ寸法を実購入品に合わせて直すこと。**
> 縦置き構成 B の内装 (`child_vtray_*`) は実購入品で設計済み。

---

# 旧: LiPo 3S 5000mAh (子機用バッテリ)

購入品 (COTS) / **型番未選定**。**3Dモデル未入手**。

| 項目 | 値 |
|---|---|
| 区分 | 子機 / 内装 / 購入品 |
| 用途 | 子機 電子部の電源 |
| 使用数 | 1 |

## 寸法 (設計上の想定値 — 実物で確定させること)

| 項目 | 想定値 | 由来 |
|---|---|---|
| 幅 | 43 mm | `child_tray_deck.bat_in_w = 46` (43 + 余裕 3) |
| 長さ | 135 mm | `child_tray_deck.bat_in_l = 138` (135 + 余裕 3) |
| 高さ | 35 mm | チューブ断面に収まる高さとして assert 済み |

## この寸法に依存している自作部品

| 部品 | 依存している値 |
|---|---|
| `parts/child/interior/printed/child_tray_deck` | 電池ベイ 内寸 46 × 138、壁高 15、面ファスナースロット (幅 14 / 厚 4) |

デッキ上面はチューブ軸心 −18mm。基板 55h と電池 35h が円内に収まる高さとして
`child_tray_deck.scad` の assert で検証済み。**電池高さが 35mm を超えると assert が止まる。**

## 部品外の考慮

- 保持は**面ファスナー (ベルクロ) ストラップ**。スロットはデッキに開けてある。
  ストラップの厚みぶんベイ壁より上に出るので、チューブ内壁との隙間を確認すること。
- **リード線とコネクタ (XT60 等) の長さと曲げ**がベイ長 138 に**含まれていない**。
  コネクタは前方 (ケーブル余裕ゾーン側) に向けること。
- LiPo は膨らむ。ベイは**きつく囲わない**こと (現状 3mm 壁 + 余裕 3mm)。
- 重心を下げたい場合はトレイを 180° 回して電池ベイを下に向ける運用が可能
  (デッキ幅 75 は弦長 37.8×2 以内で両向き可)。この場合ストラップは下向きになる。
- 密閉容器内での LiPo 使用。**充電は容器外で行う**運用にすること。

## 要選定・要確認

1. 実物の型番決定 → 外形 W×L×H とリード線長の実測
2. コネクタ形式と、トレイ引き出し時に抜き差しできるか
3. 3D モデル (STEP) があれば このフォルダに置き、`placement.json` に追加する
