AquaBeacon/mechanical/parts/child/interior/cots/nhd_c0216ciz/nhd_c0216ciz.md

# NHD-C0216CiZ LCD 機械包絡

Newhaven `NHD-C0216CiZ-FSW-FBW-3V3` の参照モデル。LCD本体56.8×26.2×5.5 mm、
後方8 mmピン、20×50×1.6 mmの共通I2Cキャリア基板包絡を含む。

取付穴が無いため `child_lcd_cradle` のフォーム付きベゼルと後クランプで保持する。
このSCAD/STL/STEPは干渉確認用で、印刷部品ではない。実キャリア基板はVOUT/C1の
チャージポンプコンデンサをLCD直近へ置き、C-MAINのXH7へ接続する。

## 2026-08-28 固定: データシート (rev 1B) でモデルを作り直した

旧モデルの「背面 8 mm ピン + 20×50×1.6 キャリア基板包絡」は実物と違う。実物は:
- 8 本の信号ピンは**長辺 (図面の下辺) から面内に 8.0 mm**、ピッチ 1.5 (計 10.5)、中央。
- バックライト K/A は短辺 (図面右端) に 2 本、2.5 間隔。
- 厚み 5.5 ±0.5 (バックライト込み)。背面に突出物は無い。

子機ドアではピンをヒンジ側 (-X) 長辺から出し、**背面へ 90° 曲げて 4 mm にトリム**した形でモデル化
(`pin_bent`)。チャージポンプ用コンデンサ (VOUT/C1±) はハーネス側の小基板に載せる想定 (未モデル)。
