AquaBeacon/mechanical/parts/child/interior/pcb/child_pwr/child_pwr.md

# child_pwr — 子機 電源・ライト基板

KiCad で設計した自作基板の 3D モデル。**このリポジトリでは編集しない** —
`hardware/pcb/CHILD_PWR/` が設計ソースで、ここには成果物を置くだけ。

| 項目 | 値 |
|---|---|
| 区分 | 子機 / 内装 / 基板 |
| 生成元 | `hardware/pcb/3d/CHILD_PWR.step` / `CHILD_PWR_mech.stl` |
| 生成コマンド | `python -X utf8 pcb\export_3d.py CHILD_PWR` (Kicad_project 側) |
| 使用数 | 1 |

## 寸法 (`_mech.stl` の実測。仮値ではない)

| 項目 | 値 |
|---|---|
| 外形 (W × D) | **62.0 × 70.0 mm** (v2.1) |
| 板厚 | 1.6 mm (STL の z = 0 〜 1.6) |
| **基板上面からの最大部品高さ** | **33.50 mm** (STL z = 35.10、AE-LXDC55縦挿し) |
| **裏面リード突出** | **8.15 mm** (STL z = -8.15) |
| 全高 | **43.25 mm** |
| 体積 (部品込み) | **14.5 cm³** |
| 高背部品 | AE-LXDC55縦挿し=33.50 / Cosland 2MD1トグル=23.52 |

## 座標系

STL / STEP とも **X = 0..62.0 / Y = -70.0..0 / Z = 板が 0..1.6、部品が +Z**。
KiCad の基板左上が原点なので **Y が負**になる。`placement.json` の `ops` は
これを前提に書いてある。

## 取付穴 (H1〜H4)

`.kicad_pcb` の実座標 (基板左下を原点、Y は上向き正):

(4.0, 4.0) / (58.0, 4.0) / (4.0, 66.0) / (58.0, 66.0)

→ ピッチ **54 × 62 mm**。Ø3.2 (M3 クリアランス)。

## 役割

ヒューズ、逆接保護、5V/3.3V 生成、ライト定電流、INA226 電流監視

## コネクタ / スイッチ

| リファレンス | 基板座標 (x, y) | 概略サイズ |
|---|---|---|
| `J_BAT` | (6.8, 48.1) | 14.3 × 15.8 |
| `J_CTL` | (39.9, 5.0) | 4.2 × 2.0 |
| `J_I2C` | (92.2, 21.0) | 11.7 × 1.9 |
| `J_LED` | (74.8, 6.1) | 14.3 × 15.8 |
| `J_MAIN` | (3.9, 5.0) | 14.2 × 1.9 |
| `J_RXA` | (26.6, 5.0) | 6.7 × 1.9 |
| `J_RXP` | (52.9, 6.1) | 14.3 × 15.8 |
| `SW_PWR` | (65.6, 57.6) | 6.9 × 6.9 |
| `U_INA` | (87.9, 52.8) | 6.2 × 3.5 |

## 実装位置

200mmチューブ用 `child_vtray_deck_t200` の上面 **z=126..188** に実装する。
先端8mmはフランジ貫通口内へ入るため低背部品だけを配置済み。

機体座標での取付穴は **X = 70/2 − y_kicad → ±31.0**、**Z = 126 + x_kicad → 130 / 184**。

> 2026-08-03: z を 128 → 126 へ 2mm 下げた。デッキ下面の RX 取付ねじ (Z=136.5) の
> 頭が、旧位置の H1 列ボス (Z=132) の足元に乗っていたため。
> なお `child_vtray_deck/variants.txt` にあった `pwr_hu=[2.4,59.6]` の上書きは
> **実基板の inset 4.0 と食い違う誤り**だったので削除した。穴位置をバリアントで
> 上書きしないこと。

## 部品外の考慮

- **コネクタの抜き差し空間**を基板の外に取ること。上表の位置は基板座標なので、
  `placement.json` の変換を通して機体座標に直してから干渉を見る。
- ケーブルは `docs/配線・ケーブル計画.md` に集約する。
- 基板を**アセンブリでビルドすると STEP が重い** (この基板の STEP は銅箔・
  ベタ・シルクまで入っている)。プレビューだけでよいときは `-NoStep` を使う。
- `_mech.stl` は KiCad の STEP エクスポータ由来なので、
  **水密でない場合がある** (部品ソリッドが基板に食い込んでいる箇所)。
  干渉確認には使えるが、体積・浮力計算には使わないこと。

## 要確認

縮小設計は完了済み。入力モデルは2026-08-02生成のv2.1で、実メッシュをアセンブリと
半径検証に使用している。旧 `child_pwr_budget` は履歴参照のみ。
