AquaBeacon/mechanical/parts/common/exterior/cots/ballast_c/ballast_c.md

# おもりC：1 kg（設計用参考モデル）

ユーザー所有バラスト。質量 **1000 g/個（1 kg）** は2026-09-27のユーザー申告。
購入品/COTS扱い、取合い・配置検討用であり印刷用の代替おもりではない。
今後「おもりC」は `ballast_c.step` / `ballast_c.stl` を指す。
名称・質量対応の正本は `../ballast_inventory.json`、人向け索引は `docs/部品一覧.md`。
必要個数・材質・使用assemblyは未指定。

## 写真から読んだ寸法（mm）

原本 `ref/IMG_4269.HEIC`：胴体直径φ48.5、胴体高さ53、全高76、くびれ直径φ36。
原点は底面中心、中心軸Z、底面Z=0、上面Z=76。

頭の直径は胴体と同じφ48.5とユーザー確認済み（2026-09-27）。SCADでは `body_d` を共有する。
頭の高さは図に記載がなく、くびれの丸みはユーザーにも不明。
`head_height_provisional=8`を仮値として採用。
くびれの高さは76-53-8=15 mm。3段の同軸円筒で簡略化し、肩・頭の境界は直角。
実物の丸いくびれ、肩、頭の面取りは再現していない。
外形はφ48.5×76 mm、胴体Z=0..53、くびれZ=53..68、頭Z=68..76。
頭・くびれに密着する固定具の確定設計には追加実測が必要。
穴・ねじ山は図にないため作成していない。
申告質量を体積から推定し直さない。重心・材質・強度は未確定。

## 再生成と検査

正本 `ballast_c.scad` はパラメトリック。仮寸法の変数を更新し再生成できる。

```powershell
.\build.ps1 parts\common\exterior\cots\ballast_c
& 'C:\Users\ryupc\AppData\Local\Programs\FreeCAD 1.0\bin\freecadcmd.exe' tools\verify_ballast_c.py
```

検査結果とログは `_work/logs/`、プレビューは `_work/images/`。
取付先が未指定のため組立干渉・工具経路の検査は対象外。

## 検証結果（2026-09-27）

OpenSCADレンダリング、閉STL、STEPの単一有効ソリッドを確認。
外形φ48.5×76、胴体・くびれ・頭の直径とZ範囲、STEP/STL体積を検査し合格。
名称対応表の質量60/60/1000 gと全STEP/STLの存在を検査し合格。
これは記載した仮形状の検査であり、実物の頭・曲面との一致の検証ではない。
管理ツール10テストと画像・ログの配置検査は合格。
全体印刷一式検査は別構成 `child_endcap_guard` / `quick_release_trials` の
CAD・印刷一式不一致で未合格。今回のCOTSモデルは両構成に使用していない。
出力は `_work/logs/assembly_parts_check.log` に保持。
