AquaBeacon/mechanical/parts/common/interior/cots/foam_pad/foam_pad.md

# foam_pad — 独立気泡フォーム パッド (購入シートから切り出し)

LiPo と LCD をベイ/ベゼルの中で拘束するためのパッド。**剛体 (PLA) で挟まない**のは、
LiPo の膨張 (使用中 +5% 程度) と振動、LCD ガラスの割れを逃がすため。
`foam_pad.scad` は表示用で印刷対象ではない。EPDM または PE 独立気泡シート (硬度 20〜30) から切る。

| バリアント | 寸法 (l × w × t) | 場所 | 数 |
|---|---|---|---|
| `lipo_top` | 100 × 34 × 3 | LiPo 上面 (y=-15) とデッキ下面 (-10) の間。残り 2mm は LiPo 公差 ±2 の逃げ | 1 |
| `lipo_side` | 100 × 23 × 1.5 | LiPo 両側面とベイ側壁 (内幅 37 − 34) の間 | 2 |
| `lipo_end` | 34 × 23 × 2 | LiPo 両端とベイ固定端壁 / ゲートの間 (内長 106 − 102) | 2 |
| `lcd_rear` | 26 × 5 × 0.5 (公称 0.8) | LCD 背面と後クランプ棒の間。0.8 を 0.5 に圧縮した状態でモデル化 | 2 |

LCD 前面のフォーム 0.8 (ベゼル前板とガラスの間) は `child_lcd_cradle` の `foam_t` で
空間だけ確保してあり、部品としては置いていない (前面窓の縁に沿った額縁状の切り出し)。

## 原点

底面中心。l = X、w = Y、t = +Z。`placement.json` で回して使う
(例: LiPo 上面パッドは `rotate([-90,0,0])` で厚みを +Y に向ける)。

## 部品外の考慮

- 両面テープはベイ側 (PLA) に貼る。LiPo 側には貼らない (交換時にパッドが残る)
- LiPo の実測寸法で厚みを決め直す。公称 102×34×23 ±2 なので、実物が大きい側に振れていたら側 1.5 → 1.0
- 密閉容器内の高温 (夏季車内) でヘタらない材料を選ぶ (PE より EPDM)

## 要確認

- [ ] LiPo 実測 (幅・厚・長さ)
- [ ] フォームシートの購入 (3t / 2t / 1.5t / 0.8t、各 100×100 あれば足りる)
