AquaBeacon/mechanical/parts/common/interior/cots/lipo_3s_2200_zeee/lipo_3s_2200_zeee.md

# lipo_3s_2200_zeee — Zeee 3S 11.1V 2200mAh 50C (親機・子機 共通バッテリ)

**実購入品**。`docs/未踏ジュニア購入物品.xlsx` の 2026-07-22 分。

| 項目 | 値 |
|---|---|
| 区分 | 共通 / 内装 / 購入品 |
| 型番 | Zeee 3S 11.1V 2200mAh 50C |
| 購入先 | Amazon (ASIN **B07QKR6DRL**) ¥5,399 |
| 使用数 | 1 (親機のみ。子機は 2026-09-03 から `parts/child/interior/cots/lipo_35x26x110` を使用) |
| 付属 | T (ディーンズ) プラグ / XT60 変換ケーブル (別購入 ¥998) / バランス JST-XH 4P |
| 関連購入品 | 充電器 HotRC ¥1,980 / LiPo セーフティバッグ ¥1,701 |

## 寸法

| 項目 | 値 | 由来 |
|---|---|---|
| 長さ | **102 mm ±2** | 商品仕様 |
| 幅 | **34 mm ±2** | 同上 |
| 高さ | **23 mm ±2** | 同上 |
| 質量 | 約 170 g | 同上 |
| エネルギー | 11.1V × 2.2Ah = **約 24.4 Wh** | |

**寸法は商品ページ値。現物をノギスで実測して確定させること** (`tol` パラメータで
ばらつきを見込んであるが、ベイ内寸の最終値は実測で決める)。

## モデルについて

購入品だがベンダの 3D データが無いため、**このリポジトリで自作した簡易モデル**。
`lipo_3s_2200_zeee.scad` は cube のみで、印刷対象ではない。

| バリアント | 中身 | 用途 |
|---|---|---|
| `_pack` | セル本体 102 × 34 × 23 | ベイ内寸を決める / アセンブリの干渉確認 |
| `_env` | 本体 + リード余裕ゾーン 40mm | 配線スペースが取れているかの確認 |

原点は左手前下の角 (0,0,0)。X = 長さ / Y = 幅 / Z = 高さ。リードは +X 端面から出る。

## この寸法に依存している自作部品

| 部品 | 依存している値 |
|---|---|
| `parts/parent/interior/printed/parent_lipo_tray` | `lipo_l/w/h` + `end_pad`/`side_pad` → ベイ内寸 106 × 40 (P-MAIN 上のブリッジトレイ、最上段) |

> 2026-09-03 から子機は `parts/child/interior/cots/lipo_35x26x110` を使用しており、本品 102×34×23 は親機のみ。

## 部品外の考慮

- **リード線の長さと向き**がモデルに入っていない。子機では LiPo のリードを
  +Z (上) へ向けるが、`CHILD_MAIN` の `J_PWR1` は基板の下端 (z≈21) にあるので
  **110mm 以上の余長**が要る。T プラグ + XT60 変換の実長を測ること。
- **密閉容器内で充電しない**。充電は必ず機体外でバランス充電器 + セーフティバッグ。
- LiPo は使用とともに膨らむ。ベイは `pad_t = 3mm` の発泡パッド代を見込んであるが、
  **きつく囲わない**こと。
- 子機は容器を縦に立てるので、LiPo は**ベイ床に載り、両端は端壁で止まる**。
  ベルクロも接着も使っていない (6 面拘束)。

## 要確認

1. **容量が仕様と食い違う。** `../docs/AquaBeacon_確定仕様メモ.md` §3.4 / §6 は
   子機に **3S 4000〜5000mAh (44〜55Wh)** を要求している。実購入は 24.4Wh なので
   **水中ライトを点けての 2〜3 時間運用はもたない**。運用時間を割り切るか、
   本番用に大容量品を追加購入するかを決めること。
   → 追加購入する場合、`child_vtray_batt_box.scad` の `lipo_l/w/h` を変えて
   再ビルドすれば assert がチューブに収まるかを検査する。
2. 現物の外形実測 (±2mm の幅がある)
3. リード線長とコネクタの実測

## 2026-09-26 親機固定改訂

現行のサービス改訂では parent_lipo_retainer を使用。端2 mm・側3 mm・上3 mmの装着時フォームと、M3×12×4の剛性上蓋で6面を保持する。寸法102×34×23は公称値なので、実寸に合わせフォーム厚を選ぶ。取り付けモデルは ssemblies/parent_service_review/。
