AquaBeacon/mechanical/parts/common/interior/cots/screw/screw.md

> 子機内装の改訂締結：M3×12なべ4本（ケース）、M3×10皿1本（床板）、普通M3ナットAF5.5×厚2.4を5個、M3×16なべ1本（前側フランジ）。配置の正本は各assemblyのplacement.json。

# screw — 小ねじ / ワッシャ / ナット / 全ねじ 簡易モデル (購入品)

アセンブリで締結要素を実体として置くためのプレースホルダ。`screw.scad` は表示用で
印刷対象ではない。ねじ山は表現せず円柱。`variants.txt` で寸法違いを出す。

| バリアント | 呼び | 用途 (子機内装 `assemblies/child_interior`) | 数 |
|---|---|---|---|
| `m2x5` / `m2x6` | M2 なべ | RX 基板 ↔ M2 FF6 スペーサ (基板側 ×5 / デッキ側 ×6) | 4 / 4 |
| `m2_5x6` | M2.5 なべ | LCD 後クランプ棒 → ベゼル盲下穴 Ø2.0 | 4 |
| `m2_5x12_low` | M2.5 低頭 (頭Ø5.0 × 1.5) | LCD ドアラッチ → ヒンジ枠のヒートセットインサート | 1 |
| `m3x8` | M3 なべ | CHILD_PWR ×4 / 電池箱の耳 ×4 / 電池ゲート ×2 | 10 |
| `m3x10` | M3 なべ | ケーブルレール ×8 / ヒンジ枠ラグ ×2 / 下フランジラグ ×2 | 12 |
| `m3x10_flat` | M3 皿 (JIS 頭Ø5.5、90°) | LCD アーチのボス → スペーサ。ボス +Y 面に面一 | 4 |
| `m3x105_rod` | M3 全ねじ 105 (切断) | LCD ドアのヒンジ。上下アーチのボスで受ける | 1 |
| `nut_m3` | M3 六角ナット (二面幅 5.5 × 2.4) | ヒンジロッドの両端 (下はナイロック) | 2 |
| `washer_m3_05` | M3 平ワッシャ / 0.5 シム (外径 7) | 予備。フランジラグでは MAIN 基板端に当たるため**使わない** | 0 |

## 原点と向き

子機フレームAの外側接合板には `m3x50`（首下50、頭Ø5.5×高さ3.0）、
`washer_m3_05`、`nut_m3` を各48個使用する。これは
`assemblies/child_exterior_structure/placement.json` の購入品で、印刷しない。

なべ・皿: **頭の座面中心** (皿は頭の上面 = 相手面)。軸は −Z、頭は +Z。
ワッシャ / ナット: 下面中心、+Z に厚み。全ねじ: 上端中心、−Z に長さ。

`placement.json` では座面を相手面の座標に置き、
軸を −Y に向けるなら `rotate([-90,0,0])`、+Y なら `rotate([90,0,0])`、+Z なら `rotate([180,0,0])`。

## 部品外の考慮

- セルフタップ (PLA 下穴 Ø2.8 に M3、Ø2.0 に M2.5) は手締め。同じ穴の脱着は 5 回程度まで
- 皿ねじは PLA の 90° 皿もみに座る。締めすぎるとボスが割れるので M3 皿は 0.3 N·m 目安
- 全ねじの切断端は面取りしてからヒンジ穴に通す (PLA の穴を削らない)
- ねじの購入型番は未確定 (SUS304 十字なべ / 皿、A2-70 相当)

## 要確認

2026-10-11 親機ケース固定：`m4x12_button` を4個。公称軸Ø4×12、頭Ø7.6×2.2、座面中心Z16.8。訂正したBCASインサート上面Z10に対する幾何学的ねじ込みは5.2 mm。購入型番・実インサート深さ・頭形状・締付け条件は未確定で、実物照合が必要。旧M4×8を現行親機固定に使用しない。

- [ ] 各ねじの購入 (数量は上表 + 予備)
- [ ] M3 全ねじの実長 (アーチ外側のナット面 z 19.6..124.4 → 105 で両端 0.3 余り)
