AquaBeacon/mechanical/parts/parent/exterior/cots/mast_pipe_al20/mast_pipe_al20.md

# マストパイプ φ20 アルミ

> **保留 (2026-09-04)**: 親機は支柱 (マスト) 無し・カメラは Osmo Action 6 外付け
> (`assemblies/parent_assembly/parent_assembly.md`) となり、本部品は現行構成では使わない。

購入品 (COTS) / **未選定**。親機の防水ボックスと振動子/カメラを結ぶ支柱。

| 項目 | 値 |
|---|---|
| 区分 | 親機 / 外装 / 購入品 |
| 材質 | アルミ (合金・肉厚 未定) |
| 外径 | φ20 (公称) |
| 長さ | 約 600 mm |
| 使用数 | 1 |

## この寸法に依存している自作部品

| 部品 | 依存している値 |
|---|---|
| `parts/parent/exterior/printed/parent_mast_clamp` | `pipe_d = 20.4` (実測 OD + 0.4) |

`parent_mast_clamp` は M4 ピンチボルト 2 本で締めるスリット式なので多少の
径ばらつきは吸収できるが、**実測してフィットテストすること**。

## 構成 (`docs/AquaBeacon_機体設計.md` より)

```
防水ボックス底
  └ parent_mast_clamp (70角フランジ, M5×4 ±28)
      └ φ20 アルミパイプ (~600mm)
          ├ バラスト 0.4 kg (パイプ下端)
          └ parent_mast_clamp (逆向き)
              └ マストヘッドプレート (70角フランジ互換の板 / **未設計**)
                  ├ parent_pod_body (側面 M4 ボス ×4)
                  └ xdcr_socket (下向き前傾 20° / **現状ビルド不可**)
```

## 部品外の考慮

- **ケーブルをパイプ内に通すか外を這わせるか**が未決。内通しにするなら
  肉厚と内径を確認し、パイプ端の**バリ取り/グロメット**でケーブルを保護すること。
  外を這わせるなら結束バンド用の突起かクランプが必要 (未設計)。
- アルミと 3Dプリント品の接触は問題ないが、**アルミとステンレスボルト**の
  異種金属接触腐食に注意 (海水使用時)。
- 曲げモーメント: マストヘッドにポッド + 振動子が付く。600mm の片持ちなので
  波・風での**振れと共振**を実機で確認すること。バラストはパイプ下端。
- パイプ切断面は水が入る。**下端は塞ぐ**か水抜きを設けるかを決めること。

## 要選定・要確認

1. パイプの実測外径 → `parent_mast_clamp.pipe_d` を更新して再ビルド + フィットテスト
2. 肉厚 / 合金 (剛性と質量)
3. マストヘッドプレート (70角フランジ互換) の設計 — **未着手**
4. ケーブルの通し方 (内通し / 外這わせ)
