AquaBeacon/mechanical/parts/parent/exterior/cots/parent_fender/parent_fender.md

# parent_fender — 親機 浮子 (市販の紡錘形フロート、中心に紐通しの空洞) 【仮値・実測待ち】

購入品 (COTS)。親機の浮力体。**2026-09-04 人間決定: 市販の浮子を 2 個**、
**2026-09-05 人間指摘: 完全な円筒ではない (挟めない)、中に空洞があるので紐を通して固定**。
→ 固定は `parent_float_yoke` ×4 (両端の円錐座 + 空洞に通した紐)。
**現物はあるが未実測** (概略 = 外径 約 100 × 長さ 約 300)。

| 項目 | 値 | 状態 |
|---|---|---|
| 区分 | 親機 / 外装 / 購入品 | |
| 型番 / URL | — | **要記入** (購入物品リストにも未記載) |
| 使用数 | 2 | |
| 最大外径 `fender_d` | 100 | **仮値・要実測** |
| 全長 `fender_len` | 300 | **仮値・要実測** |
| 先細り長 `taper_len` / 端面径 `end_d` | 40 / 40 | **仮値・要実測** (端の形が違えばヨークの円錐座を変える) |
| 空洞 (紐通し) 径 `bore_d` | 15 | **仮値・要実測** |
| 全没排水量 | 2.00 L / 個 (`.scad` の echo) | 仮値から計算 |
| 質量 | 約 0.1〜0.15 kg / 個と仮定 | 要実測 |

## モデル (`parent_fender.scad`)

配置検討・アセンブリ表示用。円筒 + 両端の円錐 (先細り) − 中心の貫通穴。軸 = Y、原点 = 胴中心。

## この寸法に依存している自作部品

| 部品 | 依存している値 |
|---|---|
| `parts/parent/exterior/printed/parent_float_yoke` | 上記 5 変数すべて (二重定義)。柱位置 `y_p0 = fender_len/2 − 15 + 2 − 70`、浮子軸 `x_f = 18 + 2 + fender_d/2`、喫水線 assert (排水量と総質量)、円錐座 `seat_od/seat_id` と `end_d` の関係 |
| `assemblies/parent_assembly/placement.json` | 浮子中心 X = ±(108 + `x_f` = 178)、z = `z_f_global` (−40)、Y = +1.95 |

**実測後の手順**: 本 `.md` と `parent_fender.scad`、`parent_float_yoke.scad` の同名変数を同時に更新 →
`part_index.py lock` を打ち直し → ヨークとアセンブリを再ビルド → 下の浮力表を再計算。

## 浮力 (仮値での試算、2026-09-05 訂正)

親機総質量の見積 **約 2.7 kg** (箱 0.45 + 内装 0.6 + デッキ 0.4 + ヨーク ×4 0.6 + 浮子 0.25 +
TD04A/Osmo/GPS/締結 0.7)。2026-09-04 版の 4.0 kg は箱を二重に数えていたので訂正。

| 浮子 ×2 | 排水量 | 沈む割合 | 喫水線 (胴中心から) | 予備浮力 |
|---|---|---|---|---|
| **Ø100 × 300 紡錘 (仮値)** | 4.0 L | **67 %** | +14 mm | 33 % |
| Ø100 × 300 円筒相当 | 4.7 L | 57 % | +7 mm | 43 % |
| Ø120 × 400 | 9.0 L | 30 % | −20 mm | 70 % |

紡錘形は円筒より排水量が 15 % ほど少ない。仮値では予備浮力 33 % と目安 (50 %) を下回るが、
質量見積の精度が ±0.5 kg あるので**実測後に判断**する (足りなければ 3 本目か大型化)。
上の表は浮子だけで支える場合。実際は箱・デッキ・ヨーク (密閉インフィルの PETG) も排水するので、
`spec/parent_hydrostatics.py` (質量 3.14 kg) では喫水線 z −2.7 (箱底が水面)、浮子は約半分が水中。
浮子の高さは軸 z 0 (箱底の高さ) — 縦揺れ GM が最大になる高さで、箱が水に接することは人間了承済み (2026-09-05)。

## 部品外の考慮

- 紐 (Ø5〜8) を空洞に通し、両端のヨーク円錐座に引き寄せる。**伸びない紐**を使う。
- 材質 (EVA / 発泡 / 空気入り) で座への当たりが変わる。柔らかければゴムの当て板。
- 端の形 (先細りの有無・角度) で円錐座の寸法が決まる。**実測時に端の形も記録**すること。

## 要確認

1. **型番・全長・最大径・空洞径・端の形・質量の実測** (最優先。ヨークとアセンブリが依存)
2. 材質 (硬さ)
3. 浮力の再計算 (上表)
