AquaBeacon/mechanical/parts/parent/interior/cots/lipo_3s_2200/lipo_3s_2200.md

# LiPo 3S 2200mAh (親機用バッテリ) 【廃止 — 実購入品へ移行】

> **2026-07-31: 実購入品が確定したのでこのフォルダは廃止。**
> [`parts/common/interior/cots/lipo_3s_2200_zeee/`](../../../../common/interior/cots/lipo_3s_2200_zeee/lipo_3s_2200_zeee.md)
> (Zeee 3S 2200mAh 50C / **102 × 34 × 23 mm** / 約170g) を参照すること。
>
> `parent_plate.scad` は旧想定の **105 × 40** で面ファスナースロットを切ってあり、
> 実物 (102 × 34) と合っていない。**要更新**。

---

# 旧: LiPo 3S 2200mAh (親機用バッテリ)

購入品 (COTS) / **型番未選定**。**3Dモデル未入手**。

| 項目 | 値 |
|---|---|
| 区分 | 親機 / 内装 / 購入品 |
| 用途 | 親機 (水上ユニット) の電源 |
| 使用数 | 1 |

## 寸法 (設計上の想定値 — 実物で確定させること)

`parent_plate.scad` の `lipo = [12, 30, 105, 40]` (左下 x,y / 幅,奥行) より

| 項目 | 想定値 |
|---|---|
| 幅 (X) | 105 mm |
| 奥行 (Y) | 40 mm |
| 高さ | プレート上のクリアランスに依存 (**未確定**) |

## この寸法に依存している自作部品

| 部品 | 依存している値 |
|---|---|
| `parts/parent/interior/printed/parent_plate` | LiPo 外形 105×40、面ファスナースロット (長 14 / 幅 4) を x=40, 90 に配置 |

## 部品外の考慮

- 面ファスナーストラップで固定。スロットはプレートを貫通しているので、
  プレート裏面とボックス底の間に**帯が通る隙間**が必要。
- リード線・コネクタは `parent_plate` の footprint に含まれていない。
  隣接モジュール (BUCK 5V / TERM 端子台) との干渉を実装時に確認すること。
- 親機は水上なので放熱は容易だが、**密閉ボックス内の温度上昇**は要確認。
- 充電時にボックスを開ける必要があるか、外部充電端子を設けるかを決めること
  (外部端子を設けるならボックスに追加の貫通が必要 = 防水設計に影響)。

## 要選定・要確認

1. 実物の型番決定 → 外形と高さの実測
2. ボックス内高さ方向のクリアランス (プレート上に載る全モジュールの最大高さ)
