AquaBeacon/mechanical/parts/parent/interior/cots/pizero_2w/pizero_2w.md

# pizero_2w — Raspberry Pi Zero 2 W (購入品・簡易モデル)

親機カメラ パターン2 (カメラ内蔵) の処理ボード。`5V_CAMERA` (P-PWR の独立 5V)
で給電し、GS カメラと CSI 接続。

| 項目 | 値 |
|---|---|
| 外形 | 65 × 30 × 1.6 (公称)。部品込み全高 ≈13 (コネクタ類) |
| 取付穴 | 4-Ø2.75、ピッチ 58 × 23 (inset 3.5) — RPi 公式 |
| 配置 | `parent_plate` (127, 135) に 90° 回転、TX_improved の下 (TX は z+30 高架) |

`pizero_2w.scad` はプレースホルダ (印刷対象外)。

## 部品外の考慮

- microSD は基板端から抜く: 高架 TX を外さず横から抜けるか要確認
- CSI ケーブルは南端から GS カメラへ ≈60mm。標準 200mm ケーブルで余裕
