AquaBeacon/mechanical/parts/parent/interior/pcb/parent_main/parent_main.md

# parent_main — 親機 メイン基板

KiCad で設計した自作基板の 3D モデル。**このリポジトリでは編集しない** —
`hardware/pcb/PARENT_MAIN/` が設計ソースで、ここには成果物を置くだけ。

| 項目 | 値 |
|---|---|
| 区分 | 親機 / 内装 / 基板 |
| 生成元 | `hardware/pcb/3d/PARENT_MAIN.step` / `PARENT_MAIN_mech.stl` |
| 生成コマンド | `python -X utf8 pcb\export_3d.py PARENT_MAIN` (Kicad_project 側) |
| 使用数 | 1 |

## 寸法 (`_mech.stl` の実測。仮値ではない)

| 項目 | 値 |
|---|---|
| 外形 (W × D) | **112.0 × 88.0 mm** |
| 板厚 | 1.6 mm (STL の z = 0 〜 1.6) |
| **基板上面からの最大部品高さ** | **18.49 mm** (STL z = 20.09) |
| **裏面リード突出** | **4.75 mm** (STL z = -4.75) |
| 全高 | 24.84 mm |
| 体積 (部品込み) | 32.1 cm³ |
| 高背部品 | DS3231 ZS-042 スタック = 18.49 |

## 座標系

STL / STEP とも **X = 0..112.0 / Y = -88.0..0 / Z = 板が 0..1.6、部品が +Z**。
KiCad の基板左上が原点なので **Y が負**になる。`placement.json` の `ops` は
これを前提に書いてある。

## 取付穴 (H1〜H4)

`.kicad_pcb` の実座標 (基板左下を原点、Y は上向き正):

(2.9, 81.9) / (105.9, 81.9) / (2.9, 6.4) / (105.9, 6.4)

→ ピッチ **103 × 75.5 mm**。Ø3.2 (M3 クリアランス)。

## 役割

SPRESENSE キャリア、GNSS (NEO-M9N)、DS3231、LIS3MDL、microSD、RS485、各種センサ I/F

## コネクタ / スイッチ

| リファレンス | 基板座標 (x, y) | 概略サイズ |
|---|---|---|
| `J_GNSS1` | (52.1, 35.0) | 11.7 × 1.9 |
| `J_I2CP` | (-0.3, 60.0) | 11.7 × 1.9 |
| `J_LCD1` | (49.1, 22.0) | 21.7 × 1.9 |
| `J_MAG1` | (88.4, 45.0) | 9.2 × 1.9 |
| `J_PRS1` | (88.4, 55.0) | 9.2 × 1.9 |
| `J_PWR1` | (-1.6, 39.0) | 14.2 × 1.9 |
| `J_RTC1` | (69.6, 48.9) | 20.8 × 40.8 |
| `J_SPR1` | (69.9, 35.0) | 9.2 × 1.9 |
| `J_TEMP1` | (88.4, 35.0) | 9.2 × 1.9 |
| `J_TETH1` | (102.9, 27.0) | 9.2 × 1.9 |
| `J_TX1` | (11.4, 75.0) | 4.2 × 2.0 |
| `J_TXT1` | (19.6, 75.0) | 6.7 × 1.9 |
| `SW_DN` | (59.2, 82.2) | 9.5 × 7.5 |
| `SW_ENT` | (47.2, 82.2) | 9.5 × 7.5 |
| `SW_UP` | (35.2, 82.2) | 9.5 × 7.5 |
| `U_485D1` | (55.0, 2.0) | 46.0 × 16.0 |

## 実装位置

親機防水ボックス内の `parent_plate` 上。**箱の型番が未決定なので配置は未確定**

## 部品外の考慮

- **コネクタの抜き差し空間**を基板の外に取ること。上表の位置は基板座標なので、
  `placement.json` の変換を通して機体座標に直してから干渉を見る。
- ケーブルは `docs/配線・ケーブル計画.md` に集約する。
- 基板を**アセンブリでビルドすると STEP が重い** (この基板の STEP は銅箔・
  ベタ・シルクまで入っている)。プレビューだけでよいときは `-NoStep` を使う。
- `_mech.stl` は KiCad の STEP エクスポータ由来なので、
  **水密でない場合がある** (部品ソリッドが基板に食い込んでいる箇所)。
  干渉確認には使えるが、体積・浮力計算には使わないこと。

## 要確認

**未発注**。SPRESENSE 本体・Multi-IMU Add-on はこのモデルに**入っていない** (積み上げ高さは別途)
