AquaBeacon/mechanical/spec/AquaBeacon_BOM.xlsx

AquaBeacon 購入部品表（BOM） 予算 ¥500,000
予算（円） | 500000 |  | 区分内訳
見積合計（円） | 305700 |  | 親機 | 84000
残り（円） | 194300 |  | 子機 | 158700
※単価は概算。発注時に要確認。状態＝決定/仮/流用。 |  |  | テザー | 27000
 |  |  | 実験 | 16000
 |  |  | 予備 | 20000
区分 | 品目 | 型番・仕様 | 数量 | 単価(円) | 小計(円) | 購入先・備考 | 状態
親機 | 防水ボックス（浮体） | タカチ 防水BOX ※初期はタッパー | 1 | 5000 | 5000 | 本番用。初期実験はタッパー流用 | 決定
親機 | GPSアンテナ | u-blox ANN-MB1-00（マルチバンド, IP67） | 1 | 5000 | 5000 | 将来F9Pでそのまま活用 | 決定
親機 | GPSモジュール | SparkFun NEO-M9N Qwiic（UART+PPS） | 1 | 10000 | 10000 | 低精度で割切り。後日F9Pへ挿替可に配線 | 決定
親機 | マイコン | SONY SPRESENSE メインボード | 1 | 6000 | 6000 | TX制御・GPS・ロギング | 決定
親機 | IMU | SPRESENSE マルチIMU Add-on | 1 | 12000 | 12000 | 姿勢補正の要（測角精度に直結） | 決定
親機 | 深度/温度センサ | 圧力式（例 MS5837 / Bar30） | 1 | 5000 | 5000 | 深度・温度ログ | 仮
親機 | RTC | DS3231 モジュール | 1 | 1000 | 1000 | 壁時計・TX時刻ログ | 決定
親機 | 音響振動子(TX) | HONDEX TD04A 200kHz | 1 | 5000 | 5000 | 指向角約22°。コネクタ化し将来50kHz素子へ差替可 | 決定
親機 | TX駆動基板 | 自作PCB＋部品 | 1 | 7000 | 7000 | 周波数依存部は差替可能に | 決定
親機 | 測角カメラ | RasPi Global Shutter Camera（IMX296） | 1 | 9000 | 9000 | グローバルシャッター | 決定
親機 | レンズ | Cマウント 4mm 広角（1/2.9"対応） | 1 | 6000 | 6000 | 水中約48°FOV。将来50kHz広ビームも見据え | 決定
親機 | バンドパスフィルタ | 520nm付近 BPF | 1 | 7000 | 7000 | 緑ライトのSNR確保 | 決定
親機 | カメラ用マイコン | Raspberry Pi Zero 2 W | 1 | 3000 | 3000 | GSカメラ撮影・SD保存 | 決定
親機 | ケーブルグランド | タカチ AGシリーズ 高防水 | 2 | 1500 | 3000 | 水上BOXの貫通 | 決定
子機 | アクションカメラ | DJI Osmo Action 6 | 2 | 60000 | 120000 | マッピング撮影。内蔵IMU・水深計・防水20m・タイムコード | 決定
子機 | 予備バッテリ | Osmo予備 or デュアルバッテリハンドル | 1 | 8000 | 8000 | 2〜3時間運用の保険 | 仮
子機 | 水中ライト（ビーコン） | 中出力（数W運用） | 1 | 8000 | 8000 | 親機カメラ用光源。明るさは絞り電池節約 | 仮
子機 | IMU | BMI270 モジュール | 1 | 1500 | 1500 | 子機姿勢 | 決定
子機 | RTC | DS3231 モジュール | 1 | 1000 | 1000 | RX時刻ログ | 決定
子機 | マイコン | Raspberry Pi Pico（RP2040）×2 | 2 | 600 | 1200 | RXエッジをPIOでµs計測。予備込 | 決定
子機 | 音響振動子(RX) | HONDEX TD04A 200kHz | 1 | 5000 | 5000 | コネクタ化し将来50kHz素子へ差替可 | 決定
子機 | RX受信基板 | 自作PCB＋部品（OPアンプ・コンパレータ等） | 1 | 7000 | 7000 | BPF段を差替可能に（50kHz対応） | 決定
子機 | バッテリ | LiPo 3S 4000-5000mAh（約44-55Wh） | 1 | 5000 | 5000 | 3時間＋余裕 | 決定
子機 | 電源回路 | DC-DC（5V/3.3V）＋部品 | 1 | 2000 | 2000 |  | 決定
子機 | 耐圧容器 | BlueRobotics製 | 1 | 0 | 0 | 自宅在庫を流用 | 流用
子機 | おもり | - | 1 | 0 | 0 | 自宅在庫を流用 | 流用
テザー | 水中ケーブル | 信号用 30m以上（電源は流さない） | 1 | 15000 | 15000 | 有線トリガ同期＋RS485。細径可 | 決定
テザー | RS485変換 | Waveshare TTL-RS485 ×2 | 2 | 1500 | 3000 | 親子各1 | 決定
テザー | ペネトレーター | BlueRobotics Wetlink ×6 | 6 | 1500 | 9000 | 親子の貫通部 | 決定
実験 | 巻尺・測量テープ | - | 1 | 2000 | 2000 | 学校の物を借用できれば0 | 仮
実験 | キャリブレーション板 | チェッカーボード A3＋ラミネート | 1 | 1000 | 1000 | 水中・ハウジング越しで較正 | 決定
実験 | 濁度計 | 簡易濁度センサ/計 | 1 | 3000 | 3000 | 濁度条件の記録 | 仮
実験 | 海藻モデル | 人工海藻等 | 1 | 3000 | 3000 | 藻場模擬 | 仮
実験 | 既知物体 | キューブ等 | 1 | 2000 | 2000 | マッピング精度評価用 | 仮
実験 | 3Dプリント材料 | PETG/ASA フィラメント | 1 | 3000 | 3000 | フレーム・浮子 | 決定
実験 | 浮子（ウキ） | - | 1 | 2000 | 2000 | フレーム浮力 | 決定
予備 | 予備部品・配線・防水材 | コネクタ/エポキシ/シリコン等 | 1 | 15000 | 15000 |  | 仮
予備 | PCB作り直し予備 | 追加試作分 | 1 | 5000 | 5000 |  | 仮
 |  |  |  | 合計 | 305700
