AquaBeacon/mechanical/parts/common/jigs/bulkhead_wrench/bulkhead_wrench.md

# M10 バルクヘッド用・補強T字レンチ

ユーザー提供 WL-M10-BULKHEAD-WRENCH-R1-PUBLIC.STEP を元にした、FDM造形向け試作工具。原本は変更していない。単位 mm。

## 変更点

- 元の外径20.5から28へ拡大。外周に片側3.75 mmの補強を追加し、先端の代表的な円弧部肉厚は約1.1から約4.85 mmに増加。
- 幅100、握り幅24、厚さ16の一体型T字ハンドル。両端は半円形、上下に1 mmの面取り。中央の径28の中実ハブで力を伝える。
- 元の60 mmの工具部を残し、全高76 mm。ハンドル端を指先で押す有効腕長は最大約50 mm。
- ナットに当たる先端内面はSTEP由来の形状を保持。M10ねじ径をレンチ開口寸法として扱っていない。先端の二面幅は元データの約16.3 mmを維持。
- ケーブルを横から入れる既存の切り欠きを保持。補強材にも幅16.4 mmの開口を設ける。この値は補強材の切り欠き幅であり、工具全長のケーブル通過幅を保証するものではない。
- 後端の角ドライブはハンドルで塞ぐ。今回は手回し専用で、ラチェット接続用ではない。

## ファイル

- `bulkhead_wrench.stl`: 印刷用、一体1部品。座標どおりハンドル底面をベッドに置き、先端を上にする。
- `bulkhead_wrench.step`: CAD編集用。元STEPと解析形状の補強・ハンドルをブーリアン結合した単一ソリッド。
- `bulkhead_wrench.scad` と `ref/original_print_orientation.stl`: 外径・持ち手寸法を調整する設計ソース。両方を相対位置を保って配置する。
- `_work/images/bulkhead_wrench_preview.png`: 検証STLのプレビュー。
- `validation.json`: 寸法、ソリッド数、閉じたメッシュ、STEP/STL比較結果。

## 印刷の初期条件と実物確認

材料未指定のため、まずPETGでの試作を想定した設計。これは材料強度を保証する指定ではない。0.4 mmノズル、0.2 mm積層、外周8周以上、充填100%を初期条件とする。材料メーカーの温度・乾燥条件を使う。ハンドルを下に置く向きなら、大きな張り出しを作らず造形できる。内部の元モデル由来の小穴・角穴付近はスライサでブリッジとサポート要否を確認する。

この向きは支持材を減らせるが、軸方向に積層するためねじりで層間破壊する可能性がある。高充填だけで耐トルクが保証されるわけではない。造形後は先端の寸法、層の割れ、かみ合い深さを確認し、予備ナットまたは治具で徐々に荷重をかけて評価する。実機の防水部で最初の破壊試験を行わない。

外径が7.5 mm増えているので、隣接ペネトレータや壁との隙間を実測する。工具中心から半径14 mmの空間と、後端ハンドルの半径50 mmの回転空間が必要。元の細い金属工具が入る場所すべてに入る設計ではない。

メーカーの[WetLink組立手順](https://bluerobotics.com/learn/wetlink-penetrator-installation-guide/)では、M10バルクヘッドの二面幅は16 mm、取付トルクは3.5 N·m。これは相手部品の取付条件であり、本造形工具の許容トルクではない。最大腕長50 mmで3.5 N·mを発生させる力は70 Nで、実際の握り位置ではさらに大きな力になる。プラグ側の約14 N·m用には使用しない。規定トルクでの本締めは、実物で耐荷重を検証するまで適合する金属工具で行う。

## 検証結果

OpenSCADの実レンダリング成功。STLは閉じたメッシュ、法線整合、連結成分1。STEPは有効な単一ソリッド。外形は28 × 100 × 76 mmで一致し、体積差は約0.027%。補強材が元の内側空間（半径10.15 mm以内、工具部）へ侵入する体積は0。画像で切り欠きとハンドル形状を確認済み。荷重解析・実機装着・破壊試験は未実施であり、耐トルクの数値認証はない。

## 再生成

`render.py` はSCADからSTLを生成する。`normalize.py` は元STEPからSCAD用の参照メッシュを生成する。`export_step.py` はFreeCAD Python用で、今回の既定寸法の解析STEPを生成する。`verify.py` はSTLとSTEP検証値の比較とプレビューを生成する。

SCADで寸法を変更した場合、STLはそのまま再生成できる。`export_step.py` はSCADパラメータの自動読み取りには対応していないため、STEPにも変更を反映して再比較すること。作成済みSTEPは今回の既定寸法専用。
