AquaBeacon/mechanical/parts/child/exterior/cots/wetlink_m10_confirmed/wetlink_m10_confirmed.md

# WetLink M10：子機下キャップ実装の占有モデル

2026-09-27 ユーザー確認：WetLink M10を5穴に使用。配線の余裕を設ける。
キャップの既存実測：M10 Ø10.2貫通、BCD56、板厚10。内側ナットを含める。
旧共通.mdの「子機はタップなのでナット不要」は本モデルのØ10.2貫通穴と矛盾するため採用しない。

本体ねじ20、ナット二面幅16・高さ8。キャップ外面世界Z=-13.8、
ねじ先端Z=6.2、ナットZ=-3.8..4.2。出典：
https://bluerobotics.com/wp-content/uploads/2026/04/WLP-DATASHEET-v1.5.pdf

外側は総高26 mmの保守的占有形状。頭とプラグの境界8 mmは仮値。
導体ボア5.7 mmは7.5 mmシール想定。実ケーブル径と配線束径は未確定。
配線用空間は別の非製造モデル service_wire_keepout.scad で直径9 mm、
先端中心Z14まで（球状端含む上端18.5）を確保する。
