AquaBeacon/mechanical/parts/common/interior/cots/child_mount_metal/child_mount_metal.md

# 内装固定用の金属部品（印刷しない）

締め付け荷重を樹脂から逃がすための鋼製スリーブと押さえ板。
購入済み製品のモデルではなく、今回追加する加工部品の寸法指定。
SCAD/STLは配置確認用であり、樹脂で印刷して代用しない。

| 部品 | 寸法 mm | 数量 |
|---|---|---:|
| フランジ用スリーブ | 外径5、内径3.2、長さ12.2 | 3 |
| ブレース用スリーブ | 外径5、内径3.2、長さ5.7 | 2 |
| フランジ用押さえ板 | 幅5×全長12、厚さ1.5、中央穴3.4、丸端R2.5 | 3 |
| ブレース用押さえ板 | 幅5.5×全長8、厚さ1、中央穴3.4、丸端R2.75 | 2 |

[フランジ押さえ板DXF](flange_plate.dxf) と [ブレース押さえ板DXF](brace_plate.dxf)
はmm単位の加工輪郭。
スリーブ端面は直角・平面に仕上げ、バリを除去する。
スリーブは圧入せず、樹脂穴5.4にすきまを持って入れる。

締め付けは「ねじ頭→金属板→金属スリーブ→金属スペーサ／フランジ」の経路で受ける。
樹脂フォークを金属板が強く押しつぶさないよう、スリーブ上端が樹脂より
0.15〜0.25 mm高くなることを実測する（設計値0.2）。
樹脂が高ければ座面を修正するかスリーブ長を調整してから組み立てる。
隙間をグルーガンで埋める設計ではない。
