AquaBeacon/mechanical/parts/common/interior/cots/hex_spacer/hex_spacer.md

# hex_spacer — 六角スペーサ M3 オス-メス 25 mm (親機内装用・購入品)

親機防水ボックス内装で「宙に浮いていた」部品を実体化するための市販スペーサ。
`hex_spacer.scad` は寸法確認・アセンブリ表示用の簡易モデル (印刷対象外)。

| バリアント | 呼び | 胴長 | オス長 | 個数 | 用途 |
|---|---|---|---|---|---|
| `m3_mf25` | M3 (二面幅 5.5) | 25 | 6 | 4 (p1) / 8 (p2) | (a) **P-MAIN 取付穴 ×4** に立てて `parent_lipo_tray` (LiPo ブリッジトレイ) を架ける。オス側は基板穴 Ø3.2 を通ってプレートの M3 ボス下穴 Ø2.6 にセルフタップ = MAIN の固定ねじ兼用。(b) p2 の **TX_improved 高架 ×4**: `parent_plate` TX ボスにオス側を立て、TX を上から M3×6 で固定 (TX 下面 = プレート上面 + 31) |

候補型番 (黄銅ニッケル): 廣杉計器 BSB-325E (M3 MF 25)。同寸なら他社品可。
**購入前に実物の二面幅・オス長を確認**。

## 原点

六角胴の下端面中心。胴 +Z、オスねじ -Z。`placement.json` では胴下端を
基板上面 / ボス上面の z に置く。

## 部品外の考慮

- オスをプレートのセルフタップ下穴に立てる際、ボス割れ防止でトルクは手締め程度。
  MAIN 用 4 本は毎回触らない (電池交換はトレイ上のベルクロだけ)
- 締結頻度が高いなら下穴側にインサートナットを検討

## 要確認

- [ ] 型番確定・購入 (M3 MF25 ×8)

## 2026-08-28 固定: 子機内装用バリアントを追加

| バリアント | 呼び | 胴 | 個数 | 用途 |
|---|---|---|---|---|
| `m3_mf30` / `m3_mf17` | M3 MF | 30 / 17 | 2 / 2 | C-MAIN 取付穴 → `child_lcd_support` のボス (左 -22 / 右 +39.5)。オスは MAIN 穴を通り `child_vtray_deck` の MAIN ボス下穴へ = MAIN 固定兼用 |
| `m3_mf10` | M3 MF | 10 | 2 | WTE4 下フランジ BCD94 の M3 穴 (内面 z=19) に立て、`child_vtray_deck` のラグ (z 29..34.5) を受ける。**オスのねじ込みは 4〜5 mm** (穴深さ 6.05) |
| `m2_ff6` | M2 FF | 6 | 4 | `child_vtray_deck` 下面 ↔ RX_improved_mini (実穴 Ø2.2)。両側 M2 ねじ |

`kind="ff"` (メスメス) と `size=2` (二面幅 4) を `hex_spacer.scad` に追加した。
