AquaBeacon/mechanical/assemblies/parent_hand_service/rigidity_physical_tests.csv

case_id | pose | port | axis | force_N | peak_displacement_mm | displacement_uncertainty_mm | residual_displacement_mm | damage_or_slip | instrument_calibration_record | operator | test_date | actual_material_and_print_settings | actual_connector_load_rating_confirmed
closed_MAIN_USB_X+ | closed | MAIN_USB | X+
closed_MAIN_USB_X- | closed | MAIN_USB | X-
closed_MAIN_USB_Y+ | closed | MAIN_USB | Y+
closed_MAIN_USB_Y- | closed | MAIN_USB | Y-
closed_MAIN_USB_Z+ | closed | MAIN_USB | Z+
closed_MAIN_USB_Z- | closed | MAIN_USB | Z-
closed_MAIN_SD_X+ | closed | MAIN_SD | X+
closed_MAIN_SD_X- | closed | MAIN_SD | X-
closed_MAIN_SD_Y+ | closed | MAIN_SD | Y+
closed_MAIN_SD_Y- | closed | MAIN_SD | Y-
closed_MAIN_SD_Z+ | closed | MAIN_SD | Z+
closed_MAIN_SD_Z- | closed | MAIN_SD | Z-
closed_SONY_MAIN_USB_X+ | closed | SONY_MAIN_USB | X+
closed_SONY_MAIN_USB_X- | closed | SONY_MAIN_USB | X-
closed_SONY_MAIN_USB_Y+ | closed | SONY_MAIN_USB | Y+
closed_SONY_MAIN_USB_Y- | closed | SONY_MAIN_USB | Y-
closed_SONY_MAIN_USB_Z+ | closed | SONY_MAIN_USB | Z+
closed_SONY_MAIN_USB_Z- | closed | SONY_MAIN_USB | Z-
closed_SONY_EXT_USB_X+ | closed | SONY_EXT_USB | X+
closed_SONY_EXT_USB_X- | closed | SONY_EXT_USB | X-
closed_SONY_EXT_USB_Y+ | closed | SONY_EXT_USB | Y+
closed_SONY_EXT_USB_Y- | closed | SONY_EXT_USB | Y-
closed_SONY_EXT_USB_Z+ | closed | SONY_EXT_USB | Z+
closed_SONY_EXT_USB_Z- | closed | SONY_EXT_USB | Z-
closed_SONY_SD_X+ | closed | SONY_SD | X+
closed_SONY_SD_X- | closed | SONY_SD | X-
closed_SONY_SD_Y+ | closed | SONY_SD | Y+
closed_SONY_SD_Y- | closed | SONY_SD | Y-
closed_SONY_SD_Z+ | closed | SONY_SD | Z+
closed_SONY_SD_Z- | closed | SONY_SD | Z-
service_MAIN_USB_X+ | service | MAIN_USB | X+
service_MAIN_USB_X- | service | MAIN_USB | X-
service_MAIN_USB_Y+ | service | MAIN_USB | Y+
service_MAIN_USB_Y- | service | MAIN_USB | Y-
service_MAIN_USB_Z+ | service | MAIN_USB | Z+
service_MAIN_USB_Z- | service | MAIN_USB | Z-
service_MAIN_SD_X+ | service | MAIN_SD | X+
service_MAIN_SD_X- | service | MAIN_SD | X-
service_MAIN_SD_Y+ | service | MAIN_SD | Y+
service_MAIN_SD_Y- | service | MAIN_SD | Y-
service_MAIN_SD_Z+ | service | MAIN_SD | Z+
service_MAIN_SD_Z- | service | MAIN_SD | Z-
service_SONY_MAIN_USB_X+ | service | SONY_MAIN_USB | X+
service_SONY_MAIN_USB_X- | service | SONY_MAIN_USB | X-
service_SONY_MAIN_USB_Y+ | service | SONY_MAIN_USB | Y+
service_SONY_MAIN_USB_Y- | service | SONY_MAIN_USB | Y-
service_SONY_MAIN_USB_Z+ | service | SONY_MAIN_USB | Z+
service_SONY_MAIN_USB_Z- | service | SONY_MAIN_USB | Z-
service_SONY_EXT_USB_X+ | service | SONY_EXT_USB | X+
service_SONY_EXT_USB_X- | service | SONY_EXT_USB | X-
service_SONY_EXT_USB_Y+ | service | SONY_EXT_USB | Y+
service_SONY_EXT_USB_Y- | service | SONY_EXT_USB | Y-
service_SONY_EXT_USB_Z+ | service | SONY_EXT_USB | Z+
service_SONY_EXT_USB_Z- | service | SONY_EXT_USB | Z-
service_SONY_SD_X+ | service | SONY_SD | X+
service_SONY_SD_X- | service | SONY_SD | X-
service_SONY_SD_Y+ | service | SONY_SD | Y+
service_SONY_SD_Y- | service | SONY_SD | Y-
service_SONY_SD_Z+ | service | SONY_SD | Z+
service_SONY_SD_Z- | service | SONY_SD | Z-
