AquaBeacon/mechanical/parts/common/exterior/cots/td04a_transducer/ref/hondex_td02_td03_pipe.gif

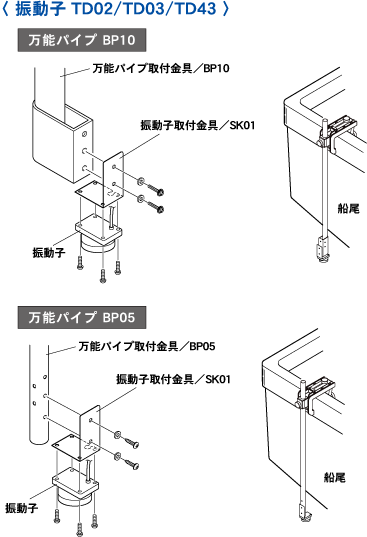
parts/common/exterior/cots/td04a_transducer/ref/hondex_td02_td03_pipe.gif
