AquaBeacon/mechanical/parts/common/exterior/cots/td04a_transducer/ref/hondex_td04a_transom.jpg

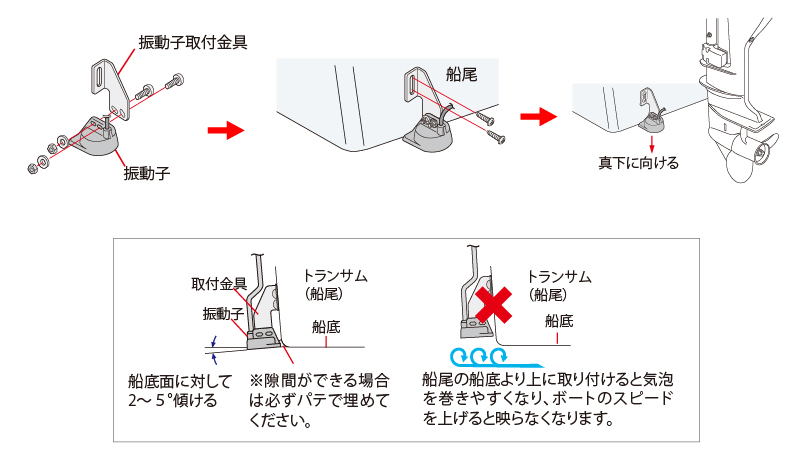
parts/common/exterior/cots/td04a_transducer/ref/hondex_td04a_transom.jpg
