AquaBeacon/mechanical/assemblies/parent_bottom_sensors/lower_view.scad

// =====================================================================
// parent_bottom_sensors_view.scad
// !! 自動生成ファイル - 編集しないこと。placement.json を直して
//    build.ps1 -Assemblies で再生成する。
// Current revision: two rope-only floats; one-piece fin cartridge; camera and TD04A downward at bottom.
// 座標系: Box bottom Z=0; camera optical axis and TD04A acoustic axis -Z. TD04A d26 x55 is provisional.
// =====================================================================

show_exterior = true;
show_interior = false;
show_vessel = true;
show_reference = true;
show_envelope = true;
show_hardware = true;
show_floats = true;
show_ropes = true;

if (show_exterior) color("DarkSlateGray") translate([0, 0, -60]) translate([0, 0, -295])  import("../../parts/parent/exterior/printed/parent_spar_beam_lower/parent_spar_beam_lower.stl");
if (show_exterior) color("SlateGray") translate([0, 0, -60]) translate([0, 0, -300]) rotate([180, 0, 0])  import("../../parts/parent/exterior/printed/parent_spar_ballast_body/parent_spar_ballast_body.stl");
if (show_exterior) color("SlateGray") translate([0, 0, -60]) translate([0, 0, -357])  import("../../parts/parent/exterior/printed/parent_spar_ballast_lid/parent_spar_ballast_lid.stl");
if (show_reference) color("Gray") translate([0, 0, -60]) translate([0, 0, -336])  import("../../assemblies/parent_spar_bolted/reference/ballast_rings.stl");
if (show_hardware) color("Silver") translate([0, 0, -60]) translate([52, 0, -358]) rotate([0, 0, 0])  import("../../assemblies/parent_spar_bolted/hardware/screw_m5x20.stl");
if (show_hardware) color("Silver") translate([0, 0, -60]) translate([52, 0, -358]) rotate([0, 0, 0])  import("../../assemblies/parent_spar_bolted/hardware/washer_m5x1.stl");
if (show_hardware) color("Silver") translate([0, 0, -60]) translate([52, 0, -345]) rotate([0, 0, 0])  import("../../assemblies/parent_spar_bolted/hardware/washer_m5x1.stl");
if (show_hardware) color("Silver") translate([0, 0, -60]) translate([52, 0, -344]) rotate([0, 0, 0])  import("../../assemblies/parent_spar_bolted/hardware/nut_m5.stl");
if (show_hardware) color("Silver") translate([0, 0, -60]) translate([3.18408e-15, 52, -358]) rotate([0, 0, 0])  import("../../assemblies/parent_spar_bolted/hardware/screw_m5x20.stl");
if (show_hardware) color("Silver") translate([0, 0, -60]) translate([3.18408e-15, 52, -358]) rotate([0, 0, 0])  import("../../assemblies/parent_spar_bolted/hardware/washer_m5x1.stl");
if (show_hardware) color("Silver") translate([0, 0, -60]) translate([3.18408e-15, 52, -345]) rotate([0, 0, 0])  import("../../assemblies/parent_spar_bolted/hardware/washer_m5x1.stl");
if (show_hardware) color("Silver") translate([0, 0, -60]) translate([3.18408e-15, 52, -344]) rotate([0, 0, 0])  import("../../assemblies/parent_spar_bolted/hardware/nut_m5.stl");
if (show_hardware) color("Silver") translate([0, 0, -60]) translate([-52, 6.36816e-15, -358]) rotate([0, 0, 0])  import("../../assemblies/parent_spar_bolted/hardware/screw_m5x20.stl");
if (show_hardware) color("Silver") translate([0, 0, -60]) translate([-52, 6.36816e-15, -358]) rotate([0, 0, 0])  import("../../assemblies/parent_spar_bolted/hardware/washer_m5x1.stl");
if (show_hardware) color("Silver") translate([0, 0, -60]) translate([-52, 6.36816e-15, -345]) rotate([0, 0, 0])  import("../../assemblies/parent_spar_bolted/hardware/washer_m5x1.stl");
if (show_hardware) color("Silver") translate([0, 0, -60]) translate([-52, 6.36816e-15, -344]) rotate([0, 0, 0])  import("../../assemblies/parent_spar_bolted/hardware/nut_m5.stl");
if (show_hardware) color("Silver") translate([0, 0, -60]) translate([-9.55225e-15, -52, -358]) rotate([0, 0, 0])  import("../../assemblies/parent_spar_bolted/hardware/screw_m5x20.stl");
if (show_hardware) color("Silver") translate([0, 0, -60]) translate([-9.55225e-15, -52, -358]) rotate([0, 0, 0])  import("../../assemblies/parent_spar_bolted/hardware/washer_m5x1.stl");
if (show_hardware) color("Silver") translate([0, 0, -60]) translate([-9.55225e-15, -52, -345]) rotate([0, 0, 0])  import("../../assemblies/parent_spar_bolted/hardware/washer_m5x1.stl");
if (show_hardware) color("Silver") translate([0, 0, -60]) translate([-9.55225e-15, -52, -344]) rotate([0, 0, 0])  import("../../assemblies/parent_spar_bolted/hardware/nut_m5.stl");
if (show_hardware) color("Silver") translate([0, 0, -60]) translate([0, 1.22465e-16, -299]) rotate([180, 0, 0])  import("../../assemblies/parent_spar_bolted/hardware/screw_m8x50.stl");
if (show_hardware) color("Silver") translate([0, 0, -60]) translate([0, 1.22465e-16, -299]) rotate([180, 0, 0])  import("../../assemblies/parent_spar_bolted/hardware/washer_m8x1.stl");
if (show_hardware) color("Silver") translate([0, 0, -60]) translate([0, -4.40873e-15, -336]) rotate([180, 0, 0])  import("../../assemblies/parent_spar_bolted/hardware/washer_m8x1.stl");
if (show_hardware) color("Silver") translate([0, 0, -60]) translate([0, -4.53119e-15, -337]) rotate([180, 0, 0])  import("../../assemblies/parent_spar_bolted/hardware/nut_m8.stl");
if (show_exterior) color("Gold") translate([0, 0, -360]) rotate([0, 0, 0])  import("../../parts/parent/exterior/printed/parent_fin_cartridge/parent_fin_cartridge.stl");
if (show_exterior) color("DarkOrange") translate([0, 0, -360]) rotate([0, 0, 0])  import("../../parts/parent/exterior/printed/parent_sensor_carrier/parent_sensor_carrier.stl");
if (show_exterior) color("DarkOrange") translate([65, -67, -460]) rotate([0, 0, 0])  import("../../parts/parent/exterior/printed/parent_td04a_clamp_body/parent_td04a_clamp_body.stl");
if (show_exterior) color("DarkOrange") translate([65, -67, -460]) rotate([0, 0, 0])  import("../../parts/parent/exterior/printed/parent_td04a_clamp_cap/parent_td04a_clamp_cap.stl");
if (show_exterior) color("SteelBlue") translate([-45, -67, -470]) rotate([-90, 0, 0])  import("../../parts/child/exterior/printed/dji_osmo_action6_mount/dji_osmo_action6_mount.stl");
if (show_envelope) color("DimGray") translate([-45, -30.5, -470]) rotate([-90, 0, 0])  import("../../assemblies/parent_spar_bolted/reference/camera_case_envelope.stl");
if (show_envelope) color("Black") translate([65, -40, -493]) rotate([0, 0, 0])  import("../../assemblies/parent_bottom_sensors/reference/td04a_envelope.stl");
if (show_hardware) color("Silver") translate([-24, 10, -331]) rotate([0, 90, 0])  import("../../assemblies/parent_spar_bolted/hardware/screw_m6x60.stl");
if (show_hardware) color("Silver") translate([-24, 10, -331]) rotate([0, 90, 0])  import("../../assemblies/parent_spar_bolted/hardware/washer_m6x1.stl");
if (show_hardware) color("Silver") translate([23, 10, -331]) rotate([0, 90, 0])  import("../../assemblies/parent_spar_bolted/hardware/washer_m6x1.stl");
if (show_hardware) color("Silver") translate([24, 10, -331]) rotate([0, 90, 0])  import("../../assemblies/parent_spar_bolted/hardware/nut_m6.stl");
if (show_hardware) color("Silver") translate([-24, 10, -238]) rotate([0, 90, 0])  import("../../assemblies/parent_spar_bolted/hardware/screw_m6x60.stl");
if (show_hardware) color("Silver") translate([-24, 10, -238]) rotate([0, 90, 0])  import("../../assemblies/parent_spar_bolted/hardware/washer_m6x1.stl");
if (show_hardware) color("Silver") translate([23, 10, -238]) rotate([0, 90, 0])  import("../../assemblies/parent_spar_bolted/hardware/washer_m6x1.stl");
if (show_hardware) color("Silver") translate([24, 10, -238]) rotate([0, 90, 0])  import("../../assemblies/parent_spar_bolted/hardware/nut_m6.stl");
if (show_hardware) color("Silver") translate([-23, -23, -342]) rotate([180, 0, 0])  import("../../assemblies/parent_bottom_sensors/hardware/screw_m5x35.stl");
if (show_hardware) color("Silver") translate([-23, -23, -342]) rotate([180, 0, 0])  import("../../assemblies/parent_spar_bolted/hardware/washer_m5x1.stl");
if (show_hardware) color("Silver") translate([-23, -23, -366]) rotate([180, 0, 0])  import("../../assemblies/parent_spar_bolted/hardware/washer_m5x1.stl");
if (show_hardware) color("Silver") translate([-23, -23, -367]) rotate([180, 0, 0])  import("../../assemblies/parent_spar_bolted/hardware/nut_m5.stl");
if (show_hardware) color("Silver") translate([-23, 23, -342]) rotate([180, 0, 0])  import("../../assemblies/parent_bottom_sensors/hardware/screw_m5x35.stl");
if (show_hardware) color("Silver") translate([-23, 23, -342]) rotate([180, 0, 0])  import("../../assemblies/parent_spar_bolted/hardware/washer_m5x1.stl");
if (show_hardware) color("Silver") translate([-23, 23, -366]) rotate([180, 0, 0])  import("../../assemblies/parent_spar_bolted/hardware/washer_m5x1.stl");
if (show_hardware) color("Silver") translate([-23, 23, -367]) rotate([180, 0, 0])  import("../../assemblies/parent_spar_bolted/hardware/nut_m5.stl");
if (show_hardware) color("Silver") translate([23, -23, -342]) rotate([180, 0, 0])  import("../../assemblies/parent_bottom_sensors/hardware/screw_m5x35.stl");
if (show_hardware) color("Silver") translate([23, -23, -342]) rotate([180, 0, 0])  import("../../assemblies/parent_spar_bolted/hardware/washer_m5x1.stl");
if (show_hardware) color("Silver") translate([23, -23, -366]) rotate([180, 0, 0])  import("../../assemblies/parent_spar_bolted/hardware/washer_m5x1.stl");
if (show_hardware) color("Silver") translate([23, -23, -367]) rotate([180, 0, 0])  import("../../assemblies/parent_spar_bolted/hardware/nut_m5.stl");
if (show_hardware) color("Silver") translate([23, 23, -342]) rotate([180, 0, 0])  import("../../assemblies/parent_bottom_sensors/hardware/screw_m5x35.stl");
if (show_hardware) color("Silver") translate([23, 23, -342]) rotate([180, 0, 0])  import("../../assemblies/parent_spar_bolted/hardware/washer_m5x1.stl");
if (show_hardware) color("Silver") translate([23, 23, -366]) rotate([180, 0, 0])  import("../../assemblies/parent_spar_bolted/hardware/washer_m5x1.stl");
if (show_hardware) color("Silver") translate([23, 23, -367]) rotate([180, 0, 0])  import("../../assemblies/parent_spar_bolted/hardware/nut_m5.stl");
if (show_hardware) color("Silver") translate([-75, -50, -354]) rotate([180, 0, 0])  import("../../assemblies/parent_spar_bolted/hardware/screw_m5x25.stl");
if (show_hardware) color("Silver") translate([-75, -50, -354]) rotate([180, 0, 0])  import("../../assemblies/parent_spar_bolted/hardware/washer_m5x1.stl");
if (show_hardware) color("Silver") translate([-75, -50, -368]) rotate([180, 0, 0])  import("../../assemblies/parent_spar_bolted/hardware/washer_m5x1.stl");
if (show_hardware) color("Silver") translate([-75, -50, -369]) rotate([180, 0, 0])  import("../../assemblies/parent_spar_bolted/hardware/nut_m5.stl");
if (show_hardware) color("Silver") translate([-75, -25, -354]) rotate([180, 0, 0])  import("../../assemblies/parent_spar_bolted/hardware/screw_m5x25.stl");
if (show_hardware) color("Silver") translate([-75, -25, -354]) rotate([180, 0, 0])  import("../../assemblies/parent_spar_bolted/hardware/washer_m5x1.stl");
if (show_hardware) color("Silver") translate([-75, -25, -368]) rotate([180, 0, 0])  import("../../assemblies/parent_spar_bolted/hardware/washer_m5x1.stl");
if (show_hardware) color("Silver") translate([-75, -25, -369]) rotate([180, 0, 0])  import("../../assemblies/parent_spar_bolted/hardware/nut_m5.stl");
if (show_hardware) color("Silver") translate([75, -50, -354]) rotate([180, 0, 0])  import("../../assemblies/parent_spar_bolted/hardware/screw_m5x25.stl");
if (show_hardware) color("Silver") translate([75, -50, -354]) rotate([180, 0, 0])  import("../../assemblies/parent_spar_bolted/hardware/washer_m5x1.stl");
if (show_hardware) color("Silver") translate([75, -50, -368]) rotate([180, 0, 0])  import("../../assemblies/parent_spar_bolted/hardware/washer_m5x1.stl");
if (show_hardware) color("Silver") translate([75, -50, -369]) rotate([180, 0, 0])  import("../../assemblies/parent_spar_bolted/hardware/nut_m5.stl");
if (show_hardware) color("Silver") translate([75, -25, -354]) rotate([180, 0, 0])  import("../../assemblies/parent_spar_bolted/hardware/screw_m5x25.stl");
if (show_hardware) color("Silver") translate([75, -25, -354]) rotate([180, 0, 0])  import("../../assemblies/parent_spar_bolted/hardware/washer_m5x1.stl");
if (show_hardware) color("Silver") translate([75, -25, -368]) rotate([180, 0, 0])  import("../../assemblies/parent_spar_bolted/hardware/washer_m5x1.stl");
if (show_hardware) color("Silver") translate([75, -25, -369]) rotate([180, 0, 0])  import("../../assemblies/parent_spar_bolted/hardware/nut_m5.stl");
if (show_hardware) color("Silver") translate([-56, -58, -486]) rotate([90, 0, 0])  import("../../assemblies/parent_spar_bolted/hardware/screw_m5x25.stl");
if (show_hardware) color("Silver") translate([-56, -58, -486]) rotate([90, 0, 0])  import("../../assemblies/parent_spar_bolted/hardware/washer_m5x1.stl");
if (show_hardware) color("Silver") translate([-56, -75, -486]) rotate([90, 0, 0])  import("../../assemblies/parent_spar_bolted/hardware/washer_m5x1.stl");
if (show_hardware) color("Silver") translate([-56, -76, -486]) rotate([90, 0, 0])  import("../../assemblies/parent_spar_bolted/hardware/nut_m5.stl");
if (show_hardware) color("Silver") translate([-56, -58, -454]) rotate([90, 0, 0])  import("../../assemblies/parent_spar_bolted/hardware/screw_m5x25.stl");
if (show_hardware) color("Silver") translate([-56, -58, -454]) rotate([90, 0, 0])  import("../../assemblies/parent_spar_bolted/hardware/washer_m5x1.stl");
if (show_hardware) color("Silver") translate([-56, -75, -454]) rotate([90, 0, 0])  import("../../assemblies/parent_spar_bolted/hardware/washer_m5x1.stl");
if (show_hardware) color("Silver") translate([-56, -76, -454]) rotate([90, 0, 0])  import("../../assemblies/parent_spar_bolted/hardware/nut_m5.stl");
if (show_hardware) color("Silver") translate([-34, -58, -486]) rotate([90, 0, 0])  import("../../assemblies/parent_spar_bolted/hardware/screw_m5x25.stl");
if (show_hardware) color("Silver") translate([-34, -58, -486]) rotate([90, 0, 0])  import("../../assemblies/parent_spar_bolted/hardware/washer_m5x1.stl");
if (show_hardware) color("Silver") translate([-34, -75, -486]) rotate([90, 0, 0])  import("../../assemblies/parent_spar_bolted/hardware/washer_m5x1.stl");
if (show_hardware) color("Silver") translate([-34, -76, -486]) rotate([90, 0, 0])  import("../../assemblies/parent_spar_bolted/hardware/nut_m5.stl");
if (show_hardware) color("Silver") translate([-34, -58, -454]) rotate([90, 0, 0])  import("../../assemblies/parent_spar_bolted/hardware/screw_m5x25.stl");
if (show_hardware) color("Silver") translate([-34, -58, -454]) rotate([90, 0, 0])  import("../../assemblies/parent_spar_bolted/hardware/washer_m5x1.stl");
if (show_hardware) color("Silver") translate([-34, -75, -454]) rotate([90, 0, 0])  import("../../assemblies/parent_spar_bolted/hardware/washer_m5x1.stl");
if (show_hardware) color("Silver") translate([-34, -76, -454]) rotate([90, 0, 0])  import("../../assemblies/parent_spar_bolted/hardware/nut_m5.stl");
if (show_hardware) color("Silver") translate([40, -58, -483]) rotate([90, 0, 0])  import("../../assemblies/parent_spar_bolted/hardware/screw_m5x25.stl");
if (show_hardware) color("Silver") translate([40, -58, -483]) rotate([90, 0, 0])  import("../../assemblies/parent_spar_bolted/hardware/washer_m5x1.stl");
if (show_hardware) color("Silver") translate([40, -75, -483]) rotate([90, 0, 0])  import("../../assemblies/parent_spar_bolted/hardware/washer_m5x1.stl");
if (show_hardware) color("Silver") translate([40, -76, -483]) rotate([90, 0, 0])  import("../../assemblies/parent_spar_bolted/hardware/nut_m5.stl");
if (show_hardware) color("Silver") translate([40, -58, -437]) rotate([90, 0, 0])  import("../../assemblies/parent_spar_bolted/hardware/screw_m5x25.stl");
if (show_hardware) color("Silver") translate([40, -58, -437]) rotate([90, 0, 0])  import("../../assemblies/parent_spar_bolted/hardware/washer_m5x1.stl");
if (show_hardware) color("Silver") translate([40, -75, -437]) rotate([90, 0, 0])  import("../../assemblies/parent_spar_bolted/hardware/washer_m5x1.stl");
if (show_hardware) color("Silver") translate([40, -76, -437]) rotate([90, 0, 0])  import("../../assemblies/parent_spar_bolted/hardware/nut_m5.stl");
if (show_hardware) color("Silver") translate([90, -58, -483]) rotate([90, 0, 0])  import("../../assemblies/parent_spar_bolted/hardware/screw_m5x25.stl");
if (show_hardware) color("Silver") translate([90, -58, -483]) rotate([90, 0, 0])  import("../../assemblies/parent_spar_bolted/hardware/washer_m5x1.stl");
if (show_hardware) color("Silver") translate([90, -75, -483]) rotate([90, 0, 0])  import("../../assemblies/parent_spar_bolted/hardware/washer_m5x1.stl");
if (show_hardware) color("Silver") translate([90, -76, -483]) rotate([90, 0, 0])  import("../../assemblies/parent_spar_bolted/hardware/nut_m5.stl");
if (show_hardware) color("Silver") translate([90, -58, -437]) rotate([90, 0, 0])  import("../../assemblies/parent_spar_bolted/hardware/screw_m5x25.stl");
if (show_hardware) color("Silver") translate([90, -58, -437]) rotate([90, 0, 0])  import("../../assemblies/parent_spar_bolted/hardware/washer_m5x1.stl");
if (show_hardware) color("Silver") translate([90, -75, -437]) rotate([90, 0, 0])  import("../../assemblies/parent_spar_bolted/hardware/washer_m5x1.stl");
if (show_hardware) color("Silver") translate([90, -76, -437]) rotate([90, 0, 0])  import("../../assemblies/parent_spar_bolted/hardware/nut_m5.stl");
if (show_hardware) color("Silver") translate([43, -19.5, -460]) rotate([90, 0, 0])  import("../../assemblies/parent_bottom_sensors/hardware/screw_m4x65.stl");
if (show_hardware) color("Silver") translate([43, -19.5, -460]) rotate([90, 0, 0])  import("../../assemblies/parent_spar_bolted/hardware/washer_m4x1.stl");
if (show_hardware) color("Silver") translate([43, -75, -460]) rotate([90, 0, 0])  import("../../assemblies/parent_spar_bolted/hardware/washer_m4x1.stl");
if (show_hardware) color("Silver") translate([43, -76, -460]) rotate([90, 0, 0])  import("../../assemblies/parent_spar_bolted/hardware/nut_m4.stl");
if (show_hardware) color("Silver") translate([87, -19.5, -460]) rotate([90, 0, 0])  import("../../assemblies/parent_bottom_sensors/hardware/screw_m4x65.stl");
if (show_hardware) color("Silver") translate([87, -19.5, -460]) rotate([90, 0, 0])  import("../../assemblies/parent_spar_bolted/hardware/washer_m4x1.stl");
if (show_hardware) color("Silver") translate([87, -75, -460]) rotate([90, 0, 0])  import("../../assemblies/parent_spar_bolted/hardware/washer_m4x1.stl");
if (show_hardware) color("Silver") translate([87, -76, -460]) rotate([90, 0, 0])  import("../../assemblies/parent_spar_bolted/hardware/nut_m4.stl");
if (show_hardware) color("Silver") translate([-37.35, -43, -470]) rotate([-90, 0, 0]) rotate([0, -90, 0])  import("../../assemblies/parent_spar_bolted/hardware/screw_m5x20.stl");
if (show_hardware) color("Silver") translate([-55.65, -43, -470]) rotate([-90, 0, 0]) rotate([0, 90, 0])  import("../../assemblies/parent_spar_bolted/hardware/nut_m5.stl");
