AquaBeacon/mechanical/assemblies/parent_bottom_sensors/hardware/screw_m4x65.scad

// Purchased hardware envelope. Not printable.
$fn=32;union(){cylinder(d=4,h=65);translate([0,0,-4])cylinder(d=6.8,h=4);}
