AquaBeacon/mechanical/assemblies/parent_bottom_sensors/hardware/screw_m5x35.scad

// Purchased hardware envelope. Not printable.
$fn=32;union(){cylinder(d=5,h=35);translate([0,0,-5])cylinder(d=8.5,h=5);}
