AquaBeacon/mechanical/assemblies/parent_bottom_sensors/reference/td04a_envelope.scad

// Purchased TD04A PROVISIONAL d26, length55; face at Z=0, cable exits Z=55.
$fn=64;cylinder(d=26,h=55);
