AquaBeacon/mechanical/parts/parent/exterior/printed/parent_sensor_carrier/parent_sensor_carrier.scad

// mm. Assembly coordinates and explicit bed orientation.
part="assembly"; // [assembly,print]
use <../../../../../scad/lib/parent_bottom_sensors.scad>
if(part=="print"){translate([0,0,75])rotate([90,0,0])carrier();}else{carrier();}
