AquaBeacon/mechanical/spec/petg_loaded.scad

include <petg_render.scad>
color([.6,.75,.85,.35])import("../assemblies/child_petg100_design/scene/pressure_vessel.stl");
color("DarkSlateGray")import("../assemblies/child_petg100_design/scene/cameras.stl");
color("Khaki")import("../assemblies/child_petg100_design/scene/light_vertical.stl");
color("DarkMagenta")import("../assemblies/child_petg100_design/scene/td04a.stl");
