AquaBeacon/mechanical/spec/petg_render.scad

color("SteelBlue")import("../assemblies/child_petg100_design/cad/child_core_frame_print.stl");
color("SeaGreen")import("../assemblies/child_petg100_design/cad/child_jaw_gate_print.stl");
color("Goldenrod")import("../assemblies/child_petg100_design/cad/child_cam_bridge_print.stl");
color("Gold")import("../assemblies/child_petg100_design/cad/vertical_light_saddle_print.stl");
color("Gold")import("../assemblies/child_petg100_design/cad/vertical_light_cap_print.stl");
color("Plum")import("../assemblies/child_petg100_design/cad/td04a_socket_print.stl");
