AquaBeacon/mechanical/assemblies/child_horizontal_plate_frame/child_horizontal_plate_frame_light_view.scad

// Generated by tools/review_child_horizontal_accessories.py from placement.json.
// pose=locked: upright light and horizontal side knob; entry: bolt removed, light tilted.
pose="locked"; // [locked,entry]
show_frame=true;
/* [Hidden] */
light_angle=pose=="entry" ? -60 : 0;
cam_lift=-light_angle/60*0.6;
module light_motion() { multmatrix([[6.123233995736766e-17, -6.123233995736766e-17, 1.0, 122.0], [1.0, 3.749399456654644e-33, -6.123233995736766e-17, 80.0], [0.0, 1.0, 6.123233995736766e-17, 130.0], [0.0, 0.0, 0.0, 1.0]]) translate([0,0,cam_lift]) rotate([0,0,light_angle]) multmatrix([[6.123233995736766e-17, 1.0, 0.0, -80.00000000000001], [-6.123233995736766e-17, 3.749399456654644e-33, 1.0, -130.0], [1.0, -6.123233995736766e-17, 6.123233995736766e-17, -122.0], [0.0, 0.0, 0.0, 1.0]]) children(); }
if(show_frame) color("SteelBlue") rotate([0, 0, 180]) translate([-122.0, 0, 115.0]) rotate([90, 0, 90]) import("../../parts/child/exterior/printed/child_horizontal_plate_frame/child_horizontal_plate_frame_side.stl");
if(show_frame) color("SteelBlue") mirror([1, 0, 0]) translate([-110.0, 0, 138]) rotate([90, 0, 90]) import("../../parts/child/exterior/printed/child_horizontal_plate_frame/child_horizontal_plate_frame_guard_front_inner.stl");
color("SteelBlue") translate([122.0, 60, 130.0]) rotate([90, 0, 90]) import("../../parts/child/exterior/printed/child_horizontal_twist_mount/child_horizontal_twist_mount_frame_receiver.stl");
light_motion() color("Orange") translate([122.0, 60, 130.0]) rotate([90, 0, 90]) translate([20, 0, 0]) import("../../parts/child/exterior/printed/child_horizontal_twist_mount/child_horizontal_twist_mount_light_twist.stl");
if(pose=="locked") color("SeaGreen") translate([122.0, 60, 130.0]) rotate([90, 0, 90]) translate([20, 0, 0]) rotate([0, 0, 0]) translate([20.5, 0, 14.0]) rotate([0, 90, 0]) import("../../parts/common/jigs/quick_release_prototypes/quick_release_prototypes_twist_knob.stl");
if(pose=="locked") color("Silver") translate([122.0, 60, 130.0]) rotate([90, 0, 90]) translate([20, 0, 0]) rotate([0, 0, 0]) import("../../parts/common/interior/cots/quick_release_hardware/quick_release_hardware_lock_bolt.stl");
color("Silver") translate([122.0, 60, 130.0]) rotate([90, 0, 90]) translate([20, 0, 0]) rotate([0, 0, 0]) import("../../parts/common/interior/cots/quick_release_hardware/quick_release_hardware_lock_nut.stl");
if(pose=="locked") color("Silver") translate([122.0, 60, 130.0]) rotate([90, 0, 90]) translate([20, 0, 0]) rotate([0, 0, 0]) import("../../parts/common/interior/cots/quick_release_hardware/quick_release_hardware_lock_washer.stl");
light_motion() color("DimGray") translate([122.0, 60, 130.0]) rotate([90, 0, 90]) translate([20, 0, 0]) rotate([0, 0, 0]) import("../../parts/common/interior/cots/quick_release_hardware/quick_release_hardware_rubber_pads.stl");
light_motion() color("SteelBlue") translate([122.0, 60, 130.0]) rotate([90, 0, 90]) translate([20, 0, -1.5]) rotate([90, 0, 180]) import("../../parts/child/exterior/printed/child_simple_light_mount/child_simple_light_mount_cap.stl");
color("Silver") translate([122.0, 60, 130.0]) rotate([90, 0, 90]) translate([0, -30.0, 4.5]) rotate([0, 0, 0]) import("../../parts/common/interior/cots/screw/screw_m3x18.stl");
color("Silver") translate([122.0, 60, 130.0]) rotate([90, 0, 90]) translate([0, -30.0, 4.5]) rotate([0, 0, 0]) translate([0, 0, -0.5]) import("../../parts/common/interior/cots/screw/screw_washer_m3_05.stl");
color("Silver") translate([122.0, 60, 130.0]) rotate([90, 0, 90]) translate([0, -30.0, -11.6]) rotate([0, 0, 0]) rotate([0, 0, 0]) import("../../parts/common/interior/cots/screw/screw_nut_m3.stl");
color("Silver") translate([122.0, 60, 130.0]) rotate([90, 0, 90]) translate([0, 30.0, 4.5]) rotate([0, 0, 0]) import("../../parts/common/interior/cots/screw/screw_m3x18.stl");
color("Silver") translate([122.0, 60, 130.0]) rotate([90, 0, 90]) translate([0, 30.0, 4.5]) rotate([0, 0, 0]) translate([0, 0, -0.5]) import("../../parts/common/interior/cots/screw/screw_washer_m3_05.stl");
color("Silver") translate([122.0, 60, 130.0]) rotate([90, 0, 90]) translate([0, 30.0, -11.6]) rotate([0, 0, 0]) rotate([0, 0, 0]) import("../../parts/common/interior/cots/screw/screw_nut_m3.stl");
light_motion() color("Silver") translate([122.0, 60, 130.0]) rotate([90, 0, 90]) translate([46.0, -32.5, 46.25]) rotate([0, 0, 0]) import("../../parts/common/interior/cots/screw/screw_m3x20.stl");
light_motion() color("Silver") translate([122.0, 60, 130.0]) rotate([90, 0, 90]) translate([46.0, -32.5, 46.25]) rotate([0, 0, 0]) translate([0, 0, -0.5]) import("../../parts/common/interior/cots/screw/screw_washer_m3_05.stl");
light_motion() color("Silver") translate([122.0, 60, 130.0]) rotate([90, 0, 90]) translate([46.0, -32.5, 31.75]) rotate([180, 0, 0]) rotate([0, 0, 30]) import("../../parts/common/interior/cots/screw/screw_nut_m3.stl");
light_motion() color("Silver") translate([122.0, 60, 130.0]) rotate([90, 0, 90]) translate([46.0, -32.5, 31.75]) rotate([180, 0, 0]) translate([0, 0, -0.5]) import("../../parts/common/interior/cots/screw/screw_washer_m3_05.stl");
light_motion() color("Silver") translate([122.0, 60, 130.0]) rotate([90, 0, 90]) translate([46.0, 32.5, 46.25]) rotate([0, 0, 0]) import("../../parts/common/interior/cots/screw/screw_m3x20.stl");
light_motion() color("Silver") translate([122.0, 60, 130.0]) rotate([90, 0, 90]) translate([46.0, 32.5, 46.25]) rotate([0, 0, 0]) translate([0, 0, -0.5]) import("../../parts/common/interior/cots/screw/screw_washer_m3_05.stl");
light_motion() color("Silver") translate([122.0, 60, 130.0]) rotate([90, 0, 90]) translate([46.0, 32.5, 31.75]) rotate([180, 0, 0]) rotate([0, 0, 30]) import("../../parts/common/interior/cots/screw/screw_nut_m3.stl");
light_motion() color("Silver") translate([122.0, 60, 130.0]) rotate([90, 0, 90]) translate([46.0, 32.5, 31.75]) rotate([180, 0, 0]) translate([0, 0, -0.5]) import("../../parts/common/interior/cots/screw/screw_washer_m3_05.stl");
light_motion() color("Silver") translate([122.0, 60, 130.0]) rotate([90, 0, 90]) translate([-6.0, -32.5, 46.25]) rotate([0, 0, 0]) import("../../parts/common/interior/cots/screw/screw_m3x20.stl");
light_motion() color("Silver") translate([122.0, 60, 130.0]) rotate([90, 0, 90]) translate([-6.0, -32.5, 46.25]) rotate([0, 0, 0]) translate([0, 0, -0.5]) import("../../parts/common/interior/cots/screw/screw_washer_m3_05.stl");
light_motion() color("Silver") translate([122.0, 60, 130.0]) rotate([90, 0, 90]) translate([-6.0, -32.5, 31.75]) rotate([180, 0, 0]) rotate([0, 0, 30]) import("../../parts/common/interior/cots/screw/screw_nut_m3.stl");
light_motion() color("Silver") translate([122.0, 60, 130.0]) rotate([90, 0, 90]) translate([-6.0, -32.5, 31.75]) rotate([180, 0, 0]) translate([0, 0, -0.5]) import("../../parts/common/interior/cots/screw/screw_washer_m3_05.stl");
light_motion() color("Silver") translate([122.0, 60, 130.0]) rotate([90, 0, 90]) translate([-6.0, 32.5, 46.25]) rotate([0, 0, 0]) import("../../parts/common/interior/cots/screw/screw_m3x20.stl");
light_motion() color("Silver") translate([122.0, 60, 130.0]) rotate([90, 0, 90]) translate([-6.0, 32.5, 46.25]) rotate([0, 0, 0]) translate([0, 0, -0.5]) import("../../parts/common/interior/cots/screw/screw_washer_m3_05.stl");
light_motion() color("Silver") translate([122.0, 60, 130.0]) rotate([90, 0, 90]) translate([-6.0, 32.5, 31.75]) rotate([180, 0, 0]) rotate([0, 0, 30]) import("../../parts/common/interior/cots/screw/screw_nut_m3.stl");
light_motion() color("Silver") translate([122.0, 60, 130.0]) rotate([90, 0, 90]) translate([-6.0, 32.5, 31.75]) rotate([180, 0, 0]) translate([0, 0, -0.5]) import("../../parts/common/interior/cots/screw/screw_washer_m3_05.stl");
