AquaBeacon/mechanical/assemblies/child_horizontal_plate_frame/child_horizontal_plate_frame_view.scad

// =====================================================================
// child_horizontal_plate_frame_view.scad
// !! 自動生成ファイル - 編集しないこと。placement.json を直して
//    build.ps1 -Assemblies で再生成する。
// X1 Carbon / PETG Basic。主フレーム4枚。公式4インチの取合いに基づく新規クランプ。
// 座標系: mm. X=左右 Y=容器軸 +Y=ドーム Z=上
// =====================================================================

show_frame = true;
show_clamp = true;
show_vessel = true;
show_ballast = true;
show_ballast_cap = true;
show_fasteners = true;
show_accessories = true;

if (show_frame) color("SteelBlue") translate([-122, 0, 115]) rotate([90, 0, 90])  import("../../parts/child/exterior/printed/child_horizontal_plate_frame/child_horizontal_plate_frame_side.stl");
// Proper rigid rotation; symmetric stations allow the same printed part x2.
if (show_frame) color("SteelBlue") rotate([0, 0, 180]) translate([-122, 0, 115]) rotate([90, 0, 90])  import("../../parts/child/exterior/printed/child_horizontal_plate_frame/child_horizontal_plate_frame_side.stl");
// Inside side plate, with clearance for top frame and rear key. Right portable STL is reflected.
if (show_frame) color("SteelBlue") translate([-110, 0, 138]) rotate([90, 0, 90])  import("../../parts/child/exterior/printed/child_horizontal_plate_frame/child_horizontal_plate_frame_guard_front_inner.stl");
// Inside side plate, with clearance for top frame and rear key. Right portable STL is reflected.
if (show_frame) color("SteelBlue") mirror([1, 0, 0]) translate([-110, 0, 138]) rotate([90, 0, 90])  import("../../parts/child/exterior/printed/child_horizontal_plate_frame/child_horizontal_plate_frame_guard_front_inner.stl");
// Inside side plate, with clearance for top frame and rear key. Right portable STL is reflected.
if (show_frame) color("SteelBlue") translate([-110, 0, 138]) rotate([90, 0, 90])  import("../../parts/child/exterior/printed/child_horizontal_plate_frame/child_horizontal_plate_frame_guard_rear_inner.stl");
// Inside side plate, with clearance for top frame and rear key. Right portable STL is reflected.
if (show_frame) color("SteelBlue") mirror([1, 0, 0]) translate([-110, 0, 138]) rotate([90, 0, 90])  import("../../parts/child/exterior/printed/child_horizontal_plate_frame/child_horizontal_plate_frame_guard_rear_inner.stl");
// Independent receiver, bolted directly to the side frame inside face.
if (show_frame) color("DarkOrange") translate([-110, 0, 138]) rotate([90, 0, 90])  import("../../parts/child/exterior/printed/child_horizontal_plate_frame/child_horizontal_plate_frame_rotation_key.stl");
// Independent receiver, bolted directly to the side frame inside face.
if (show_frame) color("DarkOrange") mirror([1, 0, 0]) translate([-110, 0, 138]) rotate([90, 0, 90])  import("../../parts/child/exterior/printed/child_horizontal_plate_frame/child_horizontal_plate_frame_rotation_key.stl");
if (show_frame) color("DarkOrange")  import("../../parts/child/exterior/printed/child_horizontal_plate_frame/child_horizontal_plate_frame_bottom.stl");
if (show_frame) color("CadetBlue") translate([0, 0, 200.8])  import("../../parts/child/exterior/printed/child_horizontal_plate_frame/child_horizontal_plate_frame_top.stl");
// Same bracket x4, proper rotation for right side; four M3x25 bolts with exposed free nuts and two washers each.
if (show_frame) color("DarkOrange") translate([-110, -77, 75.2]) rotate([-90, 0, 0])  import("../../parts/child/exterior/printed/child_horizontal_plate_frame/child_horizontal_plate_frame_clamp_support.stl");
// Same bracket x4, proper rotation for right side; four M3x25 bolts with exposed free nuts and two washers each.
if (show_frame) color("DarkOrange") translate([-110, 43, 75.2]) rotate([-90, 0, 0])  import("../../parts/child/exterior/printed/child_horizontal_plate_frame/child_horizontal_plate_frame_clamp_support.stl");
// Same bracket x4, proper rotation for right side; four M3x25 bolts with exposed free nuts and two washers each.
if (show_frame) color("DarkOrange") rotate([0, 0, 180]) translate([-110, 43, 75.2]) rotate([-90, 0, 0])  import("../../parts/child/exterior/printed/child_horizontal_plate_frame/child_horizontal_plate_frame_clamp_support.stl");
// Same bracket x4, proper rotation for right side; four M3x25 bolts with exposed free nuts and two washers each.
if (show_frame) color("DarkOrange") rotate([0, 0, 180]) translate([-110, -77, 75.2]) rotate([-90, 0, 0])  import("../../parts/child/exterior/printed/child_horizontal_plate_frame/child_horizontal_plate_frame_clamp_support.stl");
// Both axial stations joined by two shoulder rails; upper/lower remain removable.
if (show_clamp) color("LightSlateGray") translate([0, 80, 138]) rotate([90, 0, 0])  import("../../parts/child/exterior/printed/child_wte4_petg_clamp/child_wte4_petg_clamp_upper_linked.stl");
// Both axial stations joined by two shoulder rails; upper/lower remain removable.
if (show_clamp) color("LightSlateGray") translate([0, -80, 138]) rotate([-90, 0, 0])  import("../../parts/child/exterior/printed/child_wte4_petg_clamp/child_wte4_petg_clamp_lower_linked.stl");
// Horizontal assembly only: STEP shoulder gives outer face Y=-114, removing old nominal 0.2 mm axial overlap.
if (show_vessel) color("Gainsboro") translate([0, -100, 138]) rotate([-90, 0, 0]) translate([0, 0, -4]) rotate([180, 0, 0]) translate([-60.15, -57.15, 0])  import("../../parts/child/exterior/cots/wte4_end_cap_5xm10/WTE4-M-END-CAP-5XM10-R2.stl");
if (show_ballast) color("DimGray") translate([-54, -38, 33.05]) rotate([-90, 0, 0])  import("../../parts/common/exterior/cots/ballast_c/ballast_c.stl");
if (show_ballast_cap) color("DarkOrange") translate([-54, -18, 33.05]) rotate([90, 0, 0])  import("../../parts/child/exterior/printed/child_horizontal_plate_frame/child_horizontal_plate_frame_ballast_cap.stl");
if (show_ballast_cap) color("DarkOrange") translate([-54, 11, 33.05]) rotate([90, 0, 0])  import("../../parts/child/exterior/printed/child_horizontal_plate_frame/child_horizontal_plate_frame_ballast_cap.stl");
if (show_ballast) color("DimGray") translate([54, -38, 33.05]) rotate([-90, 0, 0])  import("../../parts/common/exterior/cots/ballast_c/ballast_c.stl");
if (show_ballast_cap) color("DarkOrange") translate([54, -18, 33.05]) rotate([90, 0, 0])  import("../../parts/child/exterior/printed/child_horizontal_plate_frame/child_horizontal_plate_frame_ballast_cap.stl");
if (show_ballast_cap) color("DarkOrange") translate([54, 11, 33.05]) rotate([90, 0, 0])  import("../../parts/child/exterior/printed/child_horizontal_plate_frame/child_horizontal_plate_frame_ballast_cap.stl");
if (show_ballast) color("DimGray") translate([0, -96, 8])  import("../../parts/common/exterior/cots/ballast_plate/ballast_plate_b.stl");
if (show_ballast) color("DimGray") translate([0, -60, 8])  import("../../parts/common/exterior/cots/ballast_plate/ballast_plate_b.stl");
if (show_ballast) color("DimGray") translate([0, 60, 8])  import("../../parts/common/exterior/cots/ballast_plate/ballast_plate_b.stl");
if (show_ballast) color("DimGray") translate([0, 96, 8])  import("../../parts/common/exterior/cots/ballast_plate/ballast_plate_b.stl");
if (show_fasteners) color("Silver") translate([-20, -70, 211.3]) rotate([0, 0, 0])  import("../../parts/common/interior/cots/screw/screw_m3x18.stl");
if (show_fasteners) color("Silver") translate([-20, -70, 211.3]) rotate([0, 0, 0]) translate([0, 0, -0.5])  import("../../parts/common/interior/cots/screw/screw_washer_m3_05.stl");
if (show_fasteners) color("Silver") translate([-20, -70, 194.5]) rotate([0, 0, 0]) rotate([0, 0, 30])  import("../../parts/common/interior/cots/screw/screw_nut_m3.stl");
if (show_fasteners) color("Silver") translate([-20, -70, 57.7]) rotate([180, 0, 0])  import("../../parts/common/interior/cots/screw/screw_m3x25.stl");
if (show_fasteners) color("Silver") translate([-20, -70, 57.7]) rotate([180, 0, 0]) translate([0, 0, -0.5])  import("../../parts/common/interior/cots/screw/screw_washer_m3_05.stl");
if (show_fasteners) color("Silver") translate([-20, -70, 81.5]) rotate([180, 0, 0]) rotate([0, 0, 30])  import("../../parts/common/interior/cots/screw/screw_nut_m3.stl");
if (show_fasteners) color("Silver") translate([-20, -50, 211.3]) rotate([0, 0, 0])  import("../../parts/common/interior/cots/screw/screw_m3x18.stl");
if (show_fasteners) color("Silver") translate([-20, -50, 211.3]) rotate([0, 0, 0]) translate([0, 0, -0.5])  import("../../parts/common/interior/cots/screw/screw_washer_m3_05.stl");
if (show_fasteners) color("Silver") translate([-20, -50, 194.5]) rotate([0, 0, 0]) rotate([0, 0, 30])  import("../../parts/common/interior/cots/screw/screw_nut_m3.stl");
if (show_fasteners) color("Silver") translate([-20, -50, 57.7]) rotate([180, 0, 0])  import("../../parts/common/interior/cots/screw/screw_m3x25.stl");
if (show_fasteners) color("Silver") translate([-20, -50, 57.7]) rotate([180, 0, 0]) translate([0, 0, -0.5])  import("../../parts/common/interior/cots/screw/screw_washer_m3_05.stl");
if (show_fasteners) color("Silver") translate([-20, -50, 81.5]) rotate([180, 0, 0]) rotate([0, 0, 30])  import("../../parts/common/interior/cots/screw/screw_nut_m3.stl");
if (show_fasteners) color("Silver") translate([20, -70, 211.3]) rotate([0, 0, 0])  import("../../parts/common/interior/cots/screw/screw_m3x18.stl");
if (show_fasteners) color("Silver") translate([20, -70, 211.3]) rotate([0, 0, 0]) translate([0, 0, -0.5])  import("../../parts/common/interior/cots/screw/screw_washer_m3_05.stl");
if (show_fasteners) color("Silver") translate([20, -70, 194.5]) rotate([0, 0, 0]) rotate([0, 0, 30])  import("../../parts/common/interior/cots/screw/screw_nut_m3.stl");
if (show_fasteners) color("Silver") translate([20, -70, 57.7]) rotate([180, 0, 0])  import("../../parts/common/interior/cots/screw/screw_m3x25.stl");
if (show_fasteners) color("Silver") translate([20, -70, 57.7]) rotate([180, 0, 0]) translate([0, 0, -0.5])  import("../../parts/common/interior/cots/screw/screw_washer_m3_05.stl");
if (show_fasteners) color("Silver") translate([20, -70, 81.5]) rotate([180, 0, 0]) rotate([0, 0, 30])  import("../../parts/common/interior/cots/screw/screw_nut_m3.stl");
if (show_fasteners) color("Silver") translate([20, -50, 211.3]) rotate([0, 0, 0])  import("../../parts/common/interior/cots/screw/screw_m3x18.stl");
if (show_fasteners) color("Silver") translate([20, -50, 211.3]) rotate([0, 0, 0]) translate([0, 0, -0.5])  import("../../parts/common/interior/cots/screw/screw_washer_m3_05.stl");
if (show_fasteners) color("Silver") translate([20, -50, 194.5]) rotate([0, 0, 0]) rotate([0, 0, 30])  import("../../parts/common/interior/cots/screw/screw_nut_m3.stl");
if (show_fasteners) color("Silver") translate([20, -50, 57.7]) rotate([180, 0, 0])  import("../../parts/common/interior/cots/screw/screw_m3x25.stl");
if (show_fasteners) color("Silver") translate([20, -50, 57.7]) rotate([180, 0, 0]) translate([0, 0, -0.5])  import("../../parts/common/interior/cots/screw/screw_washer_m3_05.stl");
if (show_fasteners) color("Silver") translate([20, -50, 81.5]) rotate([180, 0, 0]) rotate([0, 0, 30])  import("../../parts/common/interior/cots/screw/screw_nut_m3.stl");
if (show_fasteners) color("Silver") translate([-67.8481, -70, 153.3]) rotate([0, 0, 0])  import("../../parts/common/interior/cots/screw/screw_m3x30.stl");
if (show_fasteners) color("Silver") translate([-67.8481, -70, 153.3]) rotate([0, 0, 0]) translate([0, 0, -0.5])  import("../../parts/common/interior/cots/screw/screw_washer_m3_05.stl");
if (show_fasteners) color("Silver") translate([-67.8481, -70, 123.6]) rotate([0, 0, 0]) rotate([0, 0, 30])  import("../../parts/common/interior/cots/screw/screw_nut_m3.stl");
if (show_fasteners) color("Silver") translate([-67.8481, -50, 153.3]) rotate([0, 0, 0])  import("../../parts/common/interior/cots/screw/screw_m3x30.stl");
if (show_fasteners) color("Silver") translate([-67.8481, -50, 153.3]) rotate([0, 0, 0]) translate([0, 0, -0.5])  import("../../parts/common/interior/cots/screw/screw_washer_m3_05.stl");
if (show_fasteners) color("Silver") translate([-67.8481, -50, 123.6]) rotate([0, 0, 0]) rotate([0, 0, 30])  import("../../parts/common/interior/cots/screw/screw_nut_m3.stl");
if (show_fasteners) color("Silver") translate([67.8481, -60, 153.3]) rotate([0, 0, 0])  import("../../parts/common/interior/cots/screw/screw_m3x30.stl");
if (show_fasteners) color("Silver") translate([67.8481, -60, 153.3]) rotate([0, 0, 0]) translate([0, 0, -0.5])  import("../../parts/common/interior/cots/screw/screw_washer_m3_05.stl");
if (show_fasteners) color("Silver") translate([67.8481, -60, 123.6]) rotate([0, 0, 0]) rotate([0, 0, 30])  import("../../parts/common/interior/cots/screw/screw_nut_m3.stl");
if (show_fasteners) color("Silver") translate([-20, 50, 211.3]) rotate([0, 0, 0])  import("../../parts/common/interior/cots/screw/screw_m3x18.stl");
if (show_fasteners) color("Silver") translate([-20, 50, 211.3]) rotate([0, 0, 0]) translate([0, 0, -0.5])  import("../../parts/common/interior/cots/screw/screw_washer_m3_05.stl");
if (show_fasteners) color("Silver") translate([-20, 50, 194.5]) rotate([0, 0, 0]) rotate([0, 0, 30])  import("../../parts/common/interior/cots/screw/screw_nut_m3.stl");
if (show_fasteners) color("Silver") translate([-20, 50, 57.7]) rotate([180, 0, 0])  import("../../parts/common/interior/cots/screw/screw_m3x25.stl");
if (show_fasteners) color("Silver") translate([-20, 50, 57.7]) rotate([180, 0, 0]) translate([0, 0, -0.5])  import("../../parts/common/interior/cots/screw/screw_washer_m3_05.stl");
if (show_fasteners) color("Silver") translate([-20, 50, 81.5]) rotate([180, 0, 0]) rotate([0, 0, 30])  import("../../parts/common/interior/cots/screw/screw_nut_m3.stl");
if (show_fasteners) color("Silver") translate([-20, 70, 211.3]) rotate([0, 0, 0])  import("../../parts/common/interior/cots/screw/screw_m3x18.stl");
if (show_fasteners) color("Silver") translate([-20, 70, 211.3]) rotate([0, 0, 0]) translate([0, 0, -0.5])  import("../../parts/common/interior/cots/screw/screw_washer_m3_05.stl");
if (show_fasteners) color("Silver") translate([-20, 70, 194.5]) rotate([0, 0, 0]) rotate([0, 0, 30])  import("../../parts/common/interior/cots/screw/screw_nut_m3.stl");
if (show_fasteners) color("Silver") translate([-20, 70, 57.7]) rotate([180, 0, 0])  import("../../parts/common/interior/cots/screw/screw_m3x25.stl");
if (show_fasteners) color("Silver") translate([-20, 70, 57.7]) rotate([180, 0, 0]) translate([0, 0, -0.5])  import("../../parts/common/interior/cots/screw/screw_washer_m3_05.stl");
if (show_fasteners) color("Silver") translate([-20, 70, 81.5]) rotate([180, 0, 0]) rotate([0, 0, 30])  import("../../parts/common/interior/cots/screw/screw_nut_m3.stl");
if (show_fasteners) color("Silver") translate([20, 50, 211.3]) rotate([0, 0, 0])  import("../../parts/common/interior/cots/screw/screw_m3x18.stl");
if (show_fasteners) color("Silver") translate([20, 50, 211.3]) rotate([0, 0, 0]) translate([0, 0, -0.5])  import("../../parts/common/interior/cots/screw/screw_washer_m3_05.stl");
if (show_fasteners) color("Silver") translate([20, 50, 194.5]) rotate([0, 0, 0]) rotate([0, 0, 30])  import("../../parts/common/interior/cots/screw/screw_nut_m3.stl");
if (show_fasteners) color("Silver") translate([20, 50, 57.7]) rotate([180, 0, 0])  import("../../parts/common/interior/cots/screw/screw_m3x25.stl");
if (show_fasteners) color("Silver") translate([20, 50, 57.7]) rotate([180, 0, 0]) translate([0, 0, -0.5])  import("../../parts/common/interior/cots/screw/screw_washer_m3_05.stl");
if (show_fasteners) color("Silver") translate([20, 50, 81.5]) rotate([180, 0, 0]) rotate([0, 0, 30])  import("../../parts/common/interior/cots/screw/screw_nut_m3.stl");
if (show_fasteners) color("Silver") translate([20, 70, 211.3]) rotate([0, 0, 0])  import("../../parts/common/interior/cots/screw/screw_m3x18.stl");
if (show_fasteners) color("Silver") translate([20, 70, 211.3]) rotate([0, 0, 0]) translate([0, 0, -0.5])  import("../../parts/common/interior/cots/screw/screw_washer_m3_05.stl");
if (show_fasteners) color("Silver") translate([20, 70, 194.5]) rotate([0, 0, 0]) rotate([0, 0, 30])  import("../../parts/common/interior/cots/screw/screw_nut_m3.stl");
if (show_fasteners) color("Silver") translate([20, 70, 57.7]) rotate([180, 0, 0])  import("../../parts/common/interior/cots/screw/screw_m3x25.stl");
if (show_fasteners) color("Silver") translate([20, 70, 57.7]) rotate([180, 0, 0]) translate([0, 0, -0.5])  import("../../parts/common/interior/cots/screw/screw_washer_m3_05.stl");
if (show_fasteners) color("Silver") translate([20, 70, 81.5]) rotate([180, 0, 0]) rotate([0, 0, 30])  import("../../parts/common/interior/cots/screw/screw_nut_m3.stl");
if (show_fasteners) color("Silver") translate([-67.8481, 50, 153.3]) rotate([0, 0, 0])  import("../../parts/common/interior/cots/screw/screw_m3x30.stl");
if (show_fasteners) color("Silver") translate([-67.8481, 50, 153.3]) rotate([0, 0, 0]) translate([0, 0, -0.5])  import("../../parts/common/interior/cots/screw/screw_washer_m3_05.stl");
if (show_fasteners) color("Silver") translate([-67.8481, 50, 123.6]) rotate([0, 0, 0]) rotate([0, 0, 30])  import("../../parts/common/interior/cots/screw/screw_nut_m3.stl");
if (show_fasteners) color("Silver") translate([-67.8481, 70, 153.3]) rotate([0, 0, 0])  import("../../parts/common/interior/cots/screw/screw_m3x30.stl");
if (show_fasteners) color("Silver") translate([-67.8481, 70, 153.3]) rotate([0, 0, 0]) translate([0, 0, -0.5])  import("../../parts/common/interior/cots/screw/screw_washer_m3_05.stl");
if (show_fasteners) color("Silver") translate([-67.8481, 70, 123.6]) rotate([0, 0, 0]) rotate([0, 0, 30])  import("../../parts/common/interior/cots/screw/screw_nut_m3.stl");
if (show_fasteners) color("Silver") translate([67.8481, 60, 153.3]) rotate([0, 0, 0])  import("../../parts/common/interior/cots/screw/screw_m3x30.stl");
if (show_fasteners) color("Silver") translate([67.8481, 60, 153.3]) rotate([0, 0, 0]) translate([0, 0, -0.5])  import("../../parts/common/interior/cots/screw/screw_washer_m3_05.stl");
if (show_fasteners) color("Silver") translate([67.8481, 60, 123.6]) rotate([0, 0, 0]) rotate([0, 0, 30])  import("../../parts/common/interior/cots/screw/screw_nut_m3.stl");
if (show_fasteners) color("Silver") translate([-122.5, -80, 20]) rotate([0, -90, 0])  import("../../parts/common/interior/cots/screw/screw_m3x25.stl");
if (show_fasteners) color("Silver") translate([-122.5, -80, 20]) rotate([0, -90, 0]) translate([0, 0, -0.5])  import("../../parts/common/interior/cots/screw/screw_washer_m3_05.stl");
if (show_fasteners) color("Silver") translate([-98, -80, 20]) rotate([0, -90, 0]) rotate([0, 0, 30])  import("../../parts/common/interior/cots/screw/screw_nut_m3.stl");
if (show_fasteners) color("Silver") translate([-122.5, -80, 205.8]) rotate([0, -90, 0])  import("../../parts/common/interior/cots/screw/screw_m3x30.stl");
if (show_fasteners) color("Silver") translate([-122.5, -80, 205.8]) rotate([0, -90, 0]) translate([0, 0, -0.5])  import("../../parts/common/interior/cots/screw/screw_washer_m3_05.stl");
if (show_fasteners) color("Silver") translate([-97.5, -80, 205.8]) rotate([0, 90, 0]) rotate([0, 0, 30])  import("../../parts/common/interior/cots/screw/screw_nut_m3.stl");
if (show_fasteners) color("Silver") translate([-97.5, -80, 205.8]) rotate([0, 90, 0]) translate([0, 0, -0.5])  import("../../parts/common/interior/cots/screw/screw_washer_m3_05.stl");
if (show_fasteners) color("Silver") translate([-122.5, 80, 20]) rotate([0, -90, 0])  import("../../parts/common/interior/cots/screw/screw_m3x25.stl");
if (show_fasteners) color("Silver") translate([-122.5, 80, 20]) rotate([0, -90, 0]) translate([0, 0, -0.5])  import("../../parts/common/interior/cots/screw/screw_washer_m3_05.stl");
if (show_fasteners) color("Silver") translate([-98, 80, 20]) rotate([0, -90, 0]) rotate([0, 0, 30])  import("../../parts/common/interior/cots/screw/screw_nut_m3.stl");
if (show_fasteners) color("Silver") translate([-122.5, 80, 205.8]) rotate([0, -90, 0])  import("../../parts/common/interior/cots/screw/screw_m3x30.stl");
if (show_fasteners) color("Silver") translate([-122.5, 80, 205.8]) rotate([0, -90, 0]) translate([0, 0, -0.5])  import("../../parts/common/interior/cots/screw/screw_washer_m3_05.stl");
if (show_fasteners) color("Silver") translate([-97.5, 80, 205.8]) rotate([0, 90, 0]) rotate([0, 0, 30])  import("../../parts/common/interior/cots/screw/screw_nut_m3.stl");
if (show_fasteners) color("Silver") translate([-97.5, 80, 205.8]) rotate([0, 90, 0]) translate([0, 0, -0.5])  import("../../parts/common/interior/cots/screw/screw_washer_m3_05.stl");
if (show_fasteners) color("Silver") translate([122.5, -80, 20]) rotate([0, 90, 0])  import("../../parts/common/interior/cots/screw/screw_m3x25.stl");
if (show_fasteners) color("Silver") translate([122.5, -80, 20]) rotate([0, 90, 0]) translate([0, 0, -0.5])  import("../../parts/common/interior/cots/screw/screw_washer_m3_05.stl");
if (show_fasteners) color("Silver") translate([98, -80, 20]) rotate([0, 90, 0]) rotate([0, 0, 30])  import("../../parts/common/interior/cots/screw/screw_nut_m3.stl");
if (show_fasteners) color("Silver") translate([122.5, -80, 205.8]) rotate([0, 90, 0])  import("../../parts/common/interior/cots/screw/screw_m3x30.stl");
if (show_fasteners) color("Silver") translate([122.5, -80, 205.8]) rotate([0, 90, 0]) translate([0, 0, -0.5])  import("../../parts/common/interior/cots/screw/screw_washer_m3_05.stl");
if (show_fasteners) color("Silver") translate([97.5, -80, 205.8]) rotate([0, -90, 0]) rotate([0, 0, 30])  import("../../parts/common/interior/cots/screw/screw_nut_m3.stl");
if (show_fasteners) color("Silver") translate([97.5, -80, 205.8]) rotate([0, -90, 0]) translate([0, 0, -0.5])  import("../../parts/common/interior/cots/screw/screw_washer_m3_05.stl");
if (show_fasteners) color("Silver") translate([122.5, 80, 20]) rotate([0, 90, 0])  import("../../parts/common/interior/cots/screw/screw_m3x25.stl");
if (show_fasteners) color("Silver") translate([122.5, 80, 20]) rotate([0, 90, 0]) translate([0, 0, -0.5])  import("../../parts/common/interior/cots/screw/screw_washer_m3_05.stl");
if (show_fasteners) color("Silver") translate([98, 80, 20]) rotate([0, 90, 0]) rotate([0, 0, 30])  import("../../parts/common/interior/cots/screw/screw_nut_m3.stl");
if (show_fasteners) color("Silver") translate([122.5, 80, 205.8]) rotate([0, 90, 0])  import("../../parts/common/interior/cots/screw/screw_m3x30.stl");
if (show_fasteners) color("Silver") translate([122.5, 80, 205.8]) rotate([0, 90, 0]) translate([0, 0, -0.5])  import("../../parts/common/interior/cots/screw/screw_washer_m3_05.stl");
if (show_fasteners) color("Silver") translate([97.5, 80, 205.8]) rotate([0, -90, 0]) rotate([0, 0, 30])  import("../../parts/common/interior/cots/screw/screw_nut_m3.stl");
if (show_fasteners) color("Silver") translate([97.5, 80, 205.8]) rotate([0, -90, 0]) translate([0, 0, -0.5])  import("../../parts/common/interior/cots/screw/screw_washer_m3_05.stl");
if (show_fasteners) color("Silver") translate([-86, -24, 47.35]) rotate([0, 0, 0])  import("../../parts/common/interior/cots/screw/screw_m3x30.stl");
if (show_fasteners) color("Silver") translate([-86, -24, 47.35]) rotate([0, 0, 0]) translate([0, 0, -0.5])  import("../../parts/common/interior/cots/screw/screw_washer_m3_05.stl");
if (show_fasteners) color("Silver") translate([-86, -24, 18.5]) rotate([0, 0, 0]) rotate([0, 0, 30])  import("../../parts/common/interior/cots/screw/screw_nut_m3.stl");
if (show_fasteners) color("Silver") translate([-22, -24, 47.35]) rotate([0, 0, 0])  import("../../parts/common/interior/cots/screw/screw_m3x30.stl");
if (show_fasteners) color("Silver") translate([-22, -24, 47.35]) rotate([0, 0, 0]) translate([0, 0, -0.5])  import("../../parts/common/interior/cots/screw/screw_washer_m3_05.stl");
if (show_fasteners) color("Silver") translate([-22, -24, 18.5]) rotate([0, 0, 0]) rotate([0, 0, 30])  import("../../parts/common/interior/cots/screw/screw_nut_m3.stl");
if (show_fasteners) color("Silver") translate([-86, 5, 47.35]) rotate([0, 0, 0])  import("../../parts/common/interior/cots/screw/screw_m3x30.stl");
if (show_fasteners) color("Silver") translate([-86, 5, 47.35]) rotate([0, 0, 0]) translate([0, 0, -0.5])  import("../../parts/common/interior/cots/screw/screw_washer_m3_05.stl");
if (show_fasteners) color("Silver") translate([-86, 5, 18.5]) rotate([0, 0, 0]) rotate([0, 0, 30])  import("../../parts/common/interior/cots/screw/screw_nut_m3.stl");
if (show_fasteners) color("Silver") translate([-22, 5, 47.35]) rotate([0, 0, 0])  import("../../parts/common/interior/cots/screw/screw_m3x30.stl");
if (show_fasteners) color("Silver") translate([-22, 5, 47.35]) rotate([0, 0, 0]) translate([0, 0, -0.5])  import("../../parts/common/interior/cots/screw/screw_washer_m3_05.stl");
if (show_fasteners) color("Silver") translate([-22, 5, 18.5]) rotate([0, 0, 0]) rotate([0, 0, 30])  import("../../parts/common/interior/cots/screw/screw_nut_m3.stl");
if (show_fasteners) color("Silver") translate([22, -24, 47.35]) rotate([0, 0, 0])  import("../../parts/common/interior/cots/screw/screw_m3x30.stl");
if (show_fasteners) color("Silver") translate([22, -24, 47.35]) rotate([0, 0, 0]) translate([0, 0, -0.5])  import("../../parts/common/interior/cots/screw/screw_washer_m3_05.stl");
if (show_fasteners) color("Silver") translate([22, -24, 18.5]) rotate([0, 0, 0]) rotate([0, 0, 30])  import("../../parts/common/interior/cots/screw/screw_nut_m3.stl");
if (show_fasteners) color("Silver") translate([86, -24, 47.35]) rotate([0, 0, 0])  import("../../parts/common/interior/cots/screw/screw_m3x30.stl");
if (show_fasteners) color("Silver") translate([86, -24, 47.35]) rotate([0, 0, 0]) translate([0, 0, -0.5])  import("../../parts/common/interior/cots/screw/screw_washer_m3_05.stl");
if (show_fasteners) color("Silver") translate([86, -24, 18.5]) rotate([0, 0, 0]) rotate([0, 0, 30])  import("../../parts/common/interior/cots/screw/screw_nut_m3.stl");
if (show_fasteners) color("Silver") translate([22, 5, 47.35]) rotate([0, 0, 0])  import("../../parts/common/interior/cots/screw/screw_m3x30.stl");
if (show_fasteners) color("Silver") translate([22, 5, 47.35]) rotate([0, 0, 0]) translate([0, 0, -0.5])  import("../../parts/common/interior/cots/screw/screw_washer_m3_05.stl");
if (show_fasteners) color("Silver") translate([22, 5, 18.5]) rotate([0, 0, 0]) rotate([0, 0, 30])  import("../../parts/common/interior/cots/screw/screw_nut_m3.stl");
if (show_fasteners) color("Silver") translate([86, 5, 47.35]) rotate([0, 0, 0])  import("../../parts/common/interior/cots/screw/screw_m3x30.stl");
if (show_fasteners) color("Silver") translate([86, 5, 47.35]) rotate([0, 0, 0]) translate([0, 0, -0.5])  import("../../parts/common/interior/cots/screw/screw_washer_m3_05.stl");
if (show_fasteners) color("Silver") translate([86, 5, 18.5]) rotate([0, 0, 0]) rotate([0, 0, 30])  import("../../parts/common/interior/cots/screw/screw_nut_m3.stl");
if (show_fasteners) color("Silver") translate([-122.5, -98, 100]) rotate([0, -90, 0])  import("../../parts/common/interior/cots/screw/screw_m3x25.stl");
if (show_fasteners) color("Silver") translate([-122.5, -98, 100]) rotate([0, -90, 0]) translate([0, 0, -0.5])  import("../../parts/common/interior/cots/screw/screw_washer_m3_05.stl");
if (show_fasteners) color("Silver") translate([-101.5, -98, 100]) rotate([0, 90, 0]) rotate([0, 0, 30])  import("../../parts/common/interior/cots/screw/screw_nut_m3.stl");
if (show_fasteners) color("Silver") translate([-101.5, -98, 100]) rotate([0, 90, 0]) translate([0, 0, -0.5])  import("../../parts/common/interior/cots/screw/screw_washer_m3_05.stl");
if (show_fasteners) color("Silver") translate([-122.5, -98, 176]) rotate([0, -90, 0])  import("../../parts/common/interior/cots/screw/screw_m3x25.stl");
if (show_fasteners) color("Silver") translate([-122.5, -98, 176]) rotate([0, -90, 0]) translate([0, 0, -0.5])  import("../../parts/common/interior/cots/screw/screw_washer_m3_05.stl");
if (show_fasteners) color("Silver") translate([-101.5, -98, 176]) rotate([0, 90, 0]) rotate([0, 0, 30])  import("../../parts/common/interior/cots/screw/screw_nut_m3.stl");
if (show_fasteners) color("Silver") translate([-101.5, -98, 176]) rotate([0, 90, 0]) translate([0, 0, -0.5])  import("../../parts/common/interior/cots/screw/screw_washer_m3_05.stl");
if (show_fasteners) color("Silver") translate([-126.5, 98, 100]) rotate([0, -90, 0])  import("../../parts/common/interior/cots/screw/screw_m3x30.stl");
if (show_fasteners) color("Silver") translate([-126.5, 98, 100]) rotate([0, -90, 0]) translate([0, 0, -0.5])  import("../../parts/common/interior/cots/screw/screw_washer_m3_05.stl");
if (show_fasteners) color("Silver") translate([-101.5, 98, 100]) rotate([0, 90, 0]) rotate([0, 0, 30])  import("../../parts/common/interior/cots/screw/screw_nut_m3.stl");
if (show_fasteners) color("Silver") translate([-101.5, 98, 100]) rotate([0, 90, 0]) translate([0, 0, -0.5])  import("../../parts/common/interior/cots/screw/screw_washer_m3_05.stl");
if (show_fasteners) color("Silver") translate([-126.5, 98, 176]) rotate([0, -90, 0])  import("../../parts/common/interior/cots/screw/screw_m3x30.stl");
if (show_fasteners) color("Silver") translate([-126.5, 98, 176]) rotate([0, -90, 0]) translate([0, 0, -0.5])  import("../../parts/common/interior/cots/screw/screw_washer_m3_05.stl");
if (show_fasteners) color("Silver") translate([-101.5, 98, 176]) rotate([0, 90, 0]) rotate([0, 0, 30])  import("../../parts/common/interior/cots/screw/screw_nut_m3.stl");
if (show_fasteners) color("Silver") translate([-101.5, 98, 176]) rotate([0, 90, 0]) translate([0, 0, -0.5])  import("../../parts/common/interior/cots/screw/screw_washer_m3_05.stl");
if (show_fasteners) color("Silver") translate([122.5, -98, 100]) rotate([0, 90, 0])  import("../../parts/common/interior/cots/screw/screw_m3x25.stl");
if (show_fasteners) color("Silver") translate([122.5, -98, 100]) rotate([0, 90, 0]) translate([0, 0, -0.5])  import("../../parts/common/interior/cots/screw/screw_washer_m3_05.stl");
if (show_fasteners) color("Silver") translate([101.5, -98, 100]) rotate([0, -90, 0]) rotate([0, 0, 30])  import("../../parts/common/interior/cots/screw/screw_nut_m3.stl");
if (show_fasteners) color("Silver") translate([101.5, -98, 100]) rotate([0, -90, 0]) translate([0, 0, -0.5])  import("../../parts/common/interior/cots/screw/screw_washer_m3_05.stl");
if (show_fasteners) color("Silver") translate([122.5, -98, 176]) rotate([0, 90, 0])  import("../../parts/common/interior/cots/screw/screw_m3x25.stl");
if (show_fasteners) color("Silver") translate([122.5, -98, 176]) rotate([0, 90, 0]) translate([0, 0, -0.5])  import("../../parts/common/interior/cots/screw/screw_washer_m3_05.stl");
if (show_fasteners) color("Silver") translate([101.5, -98, 176]) rotate([0, -90, 0]) rotate([0, 0, 30])  import("../../parts/common/interior/cots/screw/screw_nut_m3.stl");
if (show_fasteners) color("Silver") translate([101.5, -98, 176]) rotate([0, -90, 0]) translate([0, 0, -0.5])  import("../../parts/common/interior/cots/screw/screw_washer_m3_05.stl");
if (show_fasteners) color("Silver") translate([122.5, 98, 100]) rotate([0, 90, 0])  import("../../parts/common/interior/cots/screw/screw_m3x25.stl");
if (show_fasteners) color("Silver") translate([122.5, 98, 100]) rotate([0, 90, 0]) translate([0, 0, -0.5])  import("../../parts/common/interior/cots/screw/screw_washer_m3_05.stl");
if (show_fasteners) color("Silver") translate([101.5, 98, 100]) rotate([0, -90, 0]) rotate([0, 0, 30])  import("../../parts/common/interior/cots/screw/screw_nut_m3.stl");
if (show_fasteners) color("Silver") translate([101.5, 98, 100]) rotate([0, -90, 0]) translate([0, 0, -0.5])  import("../../parts/common/interior/cots/screw/screw_washer_m3_05.stl");
if (show_fasteners) color("Silver") translate([122.5, 98, 176]) rotate([0, 90, 0])  import("../../parts/common/interior/cots/screw/screw_m3x25.stl");
if (show_fasteners) color("Silver") translate([122.5, 98, 176]) rotate([0, 90, 0]) translate([0, 0, -0.5])  import("../../parts/common/interior/cots/screw/screw_washer_m3_05.stl");
if (show_fasteners) color("Silver") translate([101.5, 98, 176]) rotate([0, -90, 0]) rotate([0, 0, 30])  import("../../parts/common/interior/cots/screw/screw_nut_m3.stl");
if (show_fasteners) color("Silver") translate([101.5, 98, 176]) rotate([0, -90, 0]) translate([0, 0, -0.5])  import("../../parts/common/interior/cots/screw/screw_washer_m3_05.stl");
if (show_fasteners) color("Silver") translate([-61.75, -96, 12]) rotate([0, 0, 0])  import("../../parts/common/interior/cots/screw/screw_m5x12.stl");
if (show_fasteners) color("Silver") translate([-61.75, -96, 12]) rotate([0, 0, 0]) translate([0, 0, -1])  import("../../parts/common/interior/cots/screw/screw_washer_m5_10x1.stl");
if (show_fasteners) color("Silver") translate([-61.75, -96, 0.4]) rotate([0, 0, 0]) rotate([0, 0, 30])  import("../../parts/common/interior/cots/screw/screw_nut_m5_4.stl");
if (show_fasteners) color("Silver") translate([-24.25, -96, 12]) rotate([0, 0, 0])  import("../../parts/common/interior/cots/screw/screw_m5x12.stl");
if (show_fasteners) color("Silver") translate([-24.25, -96, 12]) rotate([0, 0, 0]) translate([0, 0, -1])  import("../../parts/common/interior/cots/screw/screw_washer_m5_10x1.stl");
if (show_fasteners) color("Silver") translate([-24.25, -96, 0.4]) rotate([0, 0, 0]) rotate([0, 0, 30])  import("../../parts/common/interior/cots/screw/screw_nut_m5_4.stl");
if (show_fasteners) color("Silver") translate([24.25, -96, 12]) rotate([0, 0, 0])  import("../../parts/common/interior/cots/screw/screw_m5x12.stl");
if (show_fasteners) color("Silver") translate([24.25, -96, 12]) rotate([0, 0, 0]) translate([0, 0, -1])  import("../../parts/common/interior/cots/screw/screw_washer_m5_10x1.stl");
if (show_fasteners) color("Silver") translate([24.25, -96, 0.4]) rotate([0, 0, 0]) rotate([0, 0, 30])  import("../../parts/common/interior/cots/screw/screw_nut_m5_4.stl");
if (show_fasteners) color("Silver") translate([61.75, -96, 12]) rotate([0, 0, 0])  import("../../parts/common/interior/cots/screw/screw_m5x12.stl");
if (show_fasteners) color("Silver") translate([61.75, -96, 12]) rotate([0, 0, 0]) translate([0, 0, -1])  import("../../parts/common/interior/cots/screw/screw_washer_m5_10x1.stl");
if (show_fasteners) color("Silver") translate([61.75, -96, 0.4]) rotate([0, 0, 0]) rotate([0, 0, 30])  import("../../parts/common/interior/cots/screw/screw_nut_m5_4.stl");
if (show_fasteners) color("Silver") translate([-61.75, -60, 12]) rotate([0, 0, 0])  import("../../parts/common/interior/cots/screw/screw_m5x12.stl");
if (show_fasteners) color("Silver") translate([-61.75, -60, 12]) rotate([0, 0, 0]) translate([0, 0, -1])  import("../../parts/common/interior/cots/screw/screw_washer_m5_10x1.stl");
if (show_fasteners) color("Silver") translate([-61.75, -60, 0.4]) rotate([0, 0, 0]) rotate([0, 0, 30])  import("../../parts/common/interior/cots/screw/screw_nut_m5_4.stl");
if (show_fasteners) color("Silver") translate([-24.25, -60, 12]) rotate([0, 0, 0])  import("../../parts/common/interior/cots/screw/screw_m5x12.stl");
if (show_fasteners) color("Silver") translate([-24.25, -60, 12]) rotate([0, 0, 0]) translate([0, 0, -1])  import("../../parts/common/interior/cots/screw/screw_washer_m5_10x1.stl");
if (show_fasteners) color("Silver") translate([-24.25, -60, 0.4]) rotate([0, 0, 0]) rotate([0, 0, 30])  import("../../parts/common/interior/cots/screw/screw_nut_m5_4.stl");
if (show_fasteners) color("Silver") translate([24.25, -60, 12]) rotate([0, 0, 0])  import("../../parts/common/interior/cots/screw/screw_m5x12.stl");
if (show_fasteners) color("Silver") translate([24.25, -60, 12]) rotate([0, 0, 0]) translate([0, 0, -1])  import("../../parts/common/interior/cots/screw/screw_washer_m5_10x1.stl");
if (show_fasteners) color("Silver") translate([24.25, -60, 0.4]) rotate([0, 0, 0]) rotate([0, 0, 30])  import("../../parts/common/interior/cots/screw/screw_nut_m5_4.stl");
if (show_fasteners) color("Silver") translate([61.75, -60, 12]) rotate([0, 0, 0])  import("../../parts/common/interior/cots/screw/screw_m5x12.stl");
if (show_fasteners) color("Silver") translate([61.75, -60, 12]) rotate([0, 0, 0]) translate([0, 0, -1])  import("../../parts/common/interior/cots/screw/screw_washer_m5_10x1.stl");
if (show_fasteners) color("Silver") translate([61.75, -60, 0.4]) rotate([0, 0, 0]) rotate([0, 0, 30])  import("../../parts/common/interior/cots/screw/screw_nut_m5_4.stl");
if (show_fasteners) color("Silver") translate([-61.75, 60, 12]) rotate([0, 0, 0])  import("../../parts/common/interior/cots/screw/screw_m5x12.stl");
if (show_fasteners) color("Silver") translate([-61.75, 60, 12]) rotate([0, 0, 0]) translate([0, 0, -1])  import("../../parts/common/interior/cots/screw/screw_washer_m5_10x1.stl");
if (show_fasteners) color("Silver") translate([-61.75, 60, 0.4]) rotate([0, 0, 0]) rotate([0, 0, 30])  import("../../parts/common/interior/cots/screw/screw_nut_m5_4.stl");
if (show_fasteners) color("Silver") translate([-24.25, 60, 12]) rotate([0, 0, 0])  import("../../parts/common/interior/cots/screw/screw_m5x12.stl");
if (show_fasteners) color("Silver") translate([-24.25, 60, 12]) rotate([0, 0, 0]) translate([0, 0, -1])  import("../../parts/common/interior/cots/screw/screw_washer_m5_10x1.stl");
if (show_fasteners) color("Silver") translate([-24.25, 60, 0.4]) rotate([0, 0, 0]) rotate([0, 0, 30])  import("../../parts/common/interior/cots/screw/screw_nut_m5_4.stl");
if (show_fasteners) color("Silver") translate([24.25, 60, 12]) rotate([0, 0, 0])  import("../../parts/common/interior/cots/screw/screw_m5x12.stl");
if (show_fasteners) color("Silver") translate([24.25, 60, 12]) rotate([0, 0, 0]) translate([0, 0, -1])  import("../../parts/common/interior/cots/screw/screw_washer_m5_10x1.stl");
if (show_fasteners) color("Silver") translate([24.25, 60, 0.4]) rotate([0, 0, 0]) rotate([0, 0, 30])  import("../../parts/common/interior/cots/screw/screw_nut_m5_4.stl");
if (show_fasteners) color("Silver") translate([61.75, 60, 12]) rotate([0, 0, 0])  import("../../parts/common/interior/cots/screw/screw_m5x12.stl");
if (show_fasteners) color("Silver") translate([61.75, 60, 12]) rotate([0, 0, 0]) translate([0, 0, -1])  import("../../parts/common/interior/cots/screw/screw_washer_m5_10x1.stl");
if (show_fasteners) color("Silver") translate([61.75, 60, 0.4]) rotate([0, 0, 0]) rotate([0, 0, 30])  import("../../parts/common/interior/cots/screw/screw_nut_m5_4.stl");
if (show_fasteners) color("Silver") translate([-61.75, 96, 12]) rotate([0, 0, 0])  import("../../parts/common/interior/cots/screw/screw_m5x12.stl");
if (show_fasteners) color("Silver") translate([-61.75, 96, 12]) rotate([0, 0, 0]) translate([0, 0, -1])  import("../../parts/common/interior/cots/screw/screw_washer_m5_10x1.stl");
if (show_fasteners) color("Silver") translate([-61.75, 96, 0.4]) rotate([0, 0, 0]) rotate([0, 0, 30])  import("../../parts/common/interior/cots/screw/screw_nut_m5_4.stl");
if (show_fasteners) color("Silver") translate([-24.25, 96, 12]) rotate([0, 0, 0])  import("../../parts/common/interior/cots/screw/screw_m5x12.stl");
if (show_fasteners) color("Silver") translate([-24.25, 96, 12]) rotate([0, 0, 0]) translate([0, 0, -1])  import("../../parts/common/interior/cots/screw/screw_washer_m5_10x1.stl");
if (show_fasteners) color("Silver") translate([-24.25, 96, 0.4]) rotate([0, 0, 0]) rotate([0, 0, 30])  import("../../parts/common/interior/cots/screw/screw_nut_m5_4.stl");
if (show_fasteners) color("Silver") translate([24.25, 96, 12]) rotate([0, 0, 0])  import("../../parts/common/interior/cots/screw/screw_m5x12.stl");
if (show_fasteners) color("Silver") translate([24.25, 96, 12]) rotate([0, 0, 0]) translate([0, 0, -1])  import("../../parts/common/interior/cots/screw/screw_washer_m5_10x1.stl");
if (show_fasteners) color("Silver") translate([24.25, 96, 0.4]) rotate([0, 0, 0]) rotate([0, 0, 30])  import("../../parts/common/interior/cots/screw/screw_nut_m5_4.stl");
if (show_fasteners) color("Silver") translate([61.75, 96, 12]) rotate([0, 0, 0])  import("../../parts/common/interior/cots/screw/screw_m5x12.stl");
if (show_fasteners) color("Silver") translate([61.75, 96, 12]) rotate([0, 0, 0]) translate([0, 0, -1])  import("../../parts/common/interior/cots/screw/screw_washer_m5_10x1.stl");
if (show_fasteners) color("Silver") translate([61.75, 96, 0.4]) rotate([0, 0, 0]) rotate([0, 0, 30])  import("../../parts/common/interior/cots/screw/screw_nut_m5_4.stl");
if (show_fasteners) color("Silver") translate([-122.5, -98, 122]) rotate([0, -90, 0])  import("../../parts/common/interior/cots/screw/screw_m3x25.stl");
if (show_fasteners) color("Silver") translate([-122.5, -98, 122]) rotate([0, -90, 0]) translate([0, 0, -0.5])  import("../../parts/common/interior/cots/screw/screw_washer_m3_05.stl");
if (show_fasteners) color("Silver") translate([-101.5, -98, 122]) rotate([0, 90, 0]) rotate([0, 0, 30])  import("../../parts/common/interior/cots/screw/screw_nut_m3.stl");
if (show_fasteners) color("Silver") translate([-101.5, -98, 122]) rotate([0, 90, 0]) translate([0, 0, -0.5])  import("../../parts/common/interior/cots/screw/screw_washer_m3_05.stl");
if (show_fasteners) color("Silver") translate([-122.5, -98, 142]) rotate([0, -90, 0])  import("../../parts/common/interior/cots/screw/screw_m3x25.stl");
if (show_fasteners) color("Silver") translate([-122.5, -98, 142]) rotate([0, -90, 0]) translate([0, 0, -0.5])  import("../../parts/common/interior/cots/screw/screw_washer_m3_05.stl");
if (show_fasteners) color("Silver") translate([-101.5, -98, 142]) rotate([0, 90, 0]) rotate([0, 0, 30])  import("../../parts/common/interior/cots/screw/screw_nut_m3.stl");
if (show_fasteners) color("Silver") translate([-101.5, -98, 142]) rotate([0, 90, 0]) translate([0, 0, -0.5])  import("../../parts/common/interior/cots/screw/screw_washer_m3_05.stl");
if (show_fasteners) color("Silver") translate([122.5, -98, 122]) rotate([0, 90, 0])  import("../../parts/common/interior/cots/screw/screw_m3x25.stl");
if (show_fasteners) color("Silver") translate([122.5, -98, 122]) rotate([0, 90, 0]) translate([0, 0, -0.5])  import("../../parts/common/interior/cots/screw/screw_washer_m3_05.stl");
if (show_fasteners) color("Silver") translate([101.5, -98, 122]) rotate([0, -90, 0]) rotate([0, 0, 30])  import("../../parts/common/interior/cots/screw/screw_nut_m3.stl");
if (show_fasteners) color("Silver") translate([101.5, -98, 122]) rotate([0, -90, 0]) translate([0, 0, -0.5])  import("../../parts/common/interior/cots/screw/screw_washer_m3_05.stl");
if (show_fasteners) color("Silver") translate([122.5, -98, 142]) rotate([0, 90, 0])  import("../../parts/common/interior/cots/screw/screw_m3x25.stl");
if (show_fasteners) color("Silver") translate([122.5, -98, 142]) rotate([0, 90, 0]) translate([0, 0, -0.5])  import("../../parts/common/interior/cots/screw/screw_washer_m3_05.stl");
if (show_fasteners) color("Silver") translate([101.5, -98, 142]) rotate([0, -90, 0]) rotate([0, 0, 30])  import("../../parts/common/interior/cots/screw/screw_nut_m3.stl");
if (show_fasteners) color("Silver") translate([101.5, -98, 142]) rotate([0, -90, 0]) translate([0, 0, -0.5])  import("../../parts/common/interior/cots/screw/screw_washer_m3_05.stl");
if (show_fasteners) color("Silver") translate([-122.5, -70, 42]) rotate([0, -90, 0])  import("../../parts/common/interior/cots/screw/screw_m3x25.stl");
if (show_fasteners) color("Silver") translate([-122.5, -70, 42]) rotate([0, -90, 0]) translate([0, 0, -0.5])  import("../../parts/common/interior/cots/screw/screw_washer_m3_05.stl");
if (show_fasteners) color("Silver") translate([-101.5, -70, 42]) rotate([0, 90, 0]) rotate([0, 0, 30])  import("../../parts/common/interior/cots/screw/screw_nut_m3.stl");
if (show_fasteners) color("Silver") translate([-101.5, -70, 42]) rotate([0, 90, 0]) translate([0, 0, -0.5])  import("../../parts/common/interior/cots/screw/screw_washer_m3_05.stl");
if (show_fasteners) color("Silver") translate([-122.5, -70, 66]) rotate([0, -90, 0])  import("../../parts/common/interior/cots/screw/screw_m3x25.stl");
if (show_fasteners) color("Silver") translate([-122.5, -70, 66]) rotate([0, -90, 0]) translate([0, 0, -0.5])  import("../../parts/common/interior/cots/screw/screw_washer_m3_05.stl");
if (show_fasteners) color("Silver") translate([-101.5, -70, 66]) rotate([0, 90, 0]) rotate([0, 0, 30])  import("../../parts/common/interior/cots/screw/screw_nut_m3.stl");
if (show_fasteners) color("Silver") translate([-101.5, -70, 66]) rotate([0, 90, 0]) translate([0, 0, -0.5])  import("../../parts/common/interior/cots/screw/screw_washer_m3_05.stl");
if (show_fasteners) color("Silver") translate([-122.5, -50, 42]) rotate([0, -90, 0])  import("../../parts/common/interior/cots/screw/screw_m3x25.stl");
if (show_fasteners) color("Silver") translate([-122.5, -50, 42]) rotate([0, -90, 0]) translate([0, 0, -0.5])  import("../../parts/common/interior/cots/screw/screw_washer_m3_05.stl");
if (show_fasteners) color("Silver") translate([-101.5, -50, 42]) rotate([0, 90, 0]) rotate([0, 0, 30])  import("../../parts/common/interior/cots/screw/screw_nut_m3.stl");
if (show_fasteners) color("Silver") translate([-101.5, -50, 42]) rotate([0, 90, 0]) translate([0, 0, -0.5])  import("../../parts/common/interior/cots/screw/screw_washer_m3_05.stl");
if (show_fasteners) color("Silver") translate([-122.5, -50, 66]) rotate([0, -90, 0])  import("../../parts/common/interior/cots/screw/screw_m3x25.stl");
if (show_fasteners) color("Silver") translate([-122.5, -50, 66]) rotate([0, -90, 0]) translate([0, 0, -0.5])  import("../../parts/common/interior/cots/screw/screw_washer_m3_05.stl");
if (show_fasteners) color("Silver") translate([-101.5, -50, 66]) rotate([0, 90, 0]) rotate([0, 0, 30])  import("../../parts/common/interior/cots/screw/screw_nut_m3.stl");
if (show_fasteners) color("Silver") translate([-101.5, -50, 66]) rotate([0, 90, 0]) translate([0, 0, -0.5])  import("../../parts/common/interior/cots/screw/screw_washer_m3_05.stl");
if (show_fasteners) color("Silver") translate([-122.5, 50, 42]) rotate([0, -90, 0])  import("../../parts/common/interior/cots/screw/screw_m3x25.stl");
if (show_fasteners) color("Silver") translate([-122.5, 50, 42]) rotate([0, -90, 0]) translate([0, 0, -0.5])  import("../../parts/common/interior/cots/screw/screw_washer_m3_05.stl");
if (show_fasteners) color("Silver") translate([-101.5, 50, 42]) rotate([0, 90, 0]) rotate([0, 0, 30])  import("../../parts/common/interior/cots/screw/screw_nut_m3.stl");
if (show_fasteners) color("Silver") translate([-101.5, 50, 42]) rotate([0, 90, 0]) translate([0, 0, -0.5])  import("../../parts/common/interior/cots/screw/screw_washer_m3_05.stl");
if (show_fasteners) color("Silver") translate([-122.5, 50, 66]) rotate([0, -90, 0])  import("../../parts/common/interior/cots/screw/screw_m3x25.stl");
if (show_fasteners) color("Silver") translate([-122.5, 50, 66]) rotate([0, -90, 0]) translate([0, 0, -0.5])  import("../../parts/common/interior/cots/screw/screw_washer_m3_05.stl");
if (show_fasteners) color("Silver") translate([-101.5, 50, 66]) rotate([0, 90, 0]) rotate([0, 0, 30])  import("../../parts/common/interior/cots/screw/screw_nut_m3.stl");
if (show_fasteners) color("Silver") translate([-101.5, 50, 66]) rotate([0, 90, 0]) translate([0, 0, -0.5])  import("../../parts/common/interior/cots/screw/screw_washer_m3_05.stl");
if (show_fasteners) color("Silver") translate([-122.5, 70, 42]) rotate([0, -90, 0])  import("../../parts/common/interior/cots/screw/screw_m3x25.stl");
if (show_fasteners) color("Silver") translate([-122.5, 70, 42]) rotate([0, -90, 0]) translate([0, 0, -0.5])  import("../../parts/common/interior/cots/screw/screw_washer_m3_05.stl");
if (show_fasteners) color("Silver") translate([-101.5, 70, 42]) rotate([0, 90, 0]) rotate([0, 0, 30])  import("../../parts/common/interior/cots/screw/screw_nut_m3.stl");
if (show_fasteners) color("Silver") translate([-101.5, 70, 42]) rotate([0, 90, 0]) translate([0, 0, -0.5])  import("../../parts/common/interior/cots/screw/screw_washer_m3_05.stl");
if (show_fasteners) color("Silver") translate([-122.5, 70, 66]) rotate([0, -90, 0])  import("../../parts/common/interior/cots/screw/screw_m3x25.stl");
if (show_fasteners) color("Silver") translate([-122.5, 70, 66]) rotate([0, -90, 0]) translate([0, 0, -0.5])  import("../../parts/common/interior/cots/screw/screw_washer_m3_05.stl");
if (show_fasteners) color("Silver") translate([-101.5, 70, 66]) rotate([0, 90, 0]) rotate([0, 0, 30])  import("../../parts/common/interior/cots/screw/screw_nut_m3.stl");
if (show_fasteners) color("Silver") translate([-101.5, 70, 66]) rotate([0, 90, 0]) translate([0, 0, -0.5])  import("../../parts/common/interior/cots/screw/screw_washer_m3_05.stl");
if (show_fasteners) color("Silver") translate([122.5, -70, 42]) rotate([0, 90, 0])  import("../../parts/common/interior/cots/screw/screw_m3x25.stl");
if (show_fasteners) color("Silver") translate([122.5, -70, 42]) rotate([0, 90, 0]) translate([0, 0, -0.5])  import("../../parts/common/interior/cots/screw/screw_washer_m3_05.stl");
if (show_fasteners) color("Silver") translate([101.5, -70, 42]) rotate([0, -90, 0]) rotate([0, 0, 30])  import("../../parts/common/interior/cots/screw/screw_nut_m3.stl");
if (show_fasteners) color("Silver") translate([101.5, -70, 42]) rotate([0, -90, 0]) translate([0, 0, -0.5])  import("../../parts/common/interior/cots/screw/screw_washer_m3_05.stl");
if (show_fasteners) color("Silver") translate([122.5, -70, 66]) rotate([0, 90, 0])  import("../../parts/common/interior/cots/screw/screw_m3x25.stl");
if (show_fasteners) color("Silver") translate([122.5, -70, 66]) rotate([0, 90, 0]) translate([0, 0, -0.5])  import("../../parts/common/interior/cots/screw/screw_washer_m3_05.stl");
if (show_fasteners) color("Silver") translate([101.5, -70, 66]) rotate([0, -90, 0]) rotate([0, 0, 30])  import("../../parts/common/interior/cots/screw/screw_nut_m3.stl");
if (show_fasteners) color("Silver") translate([101.5, -70, 66]) rotate([0, -90, 0]) translate([0, 0, -0.5])  import("../../parts/common/interior/cots/screw/screw_washer_m3_05.stl");
if (show_fasteners) color("Silver") translate([122.5, -50, 42]) rotate([0, 90, 0])  import("../../parts/common/interior/cots/screw/screw_m3x25.stl");
if (show_fasteners) color("Silver") translate([122.5, -50, 42]) rotate([0, 90, 0]) translate([0, 0, -0.5])  import("../../parts/common/interior/cots/screw/screw_washer_m3_05.stl");
if (show_fasteners) color("Silver") translate([101.5, -50, 42]) rotate([0, -90, 0]) rotate([0, 0, 30])  import("../../parts/common/interior/cots/screw/screw_nut_m3.stl");
if (show_fasteners) color("Silver") translate([101.5, -50, 42]) rotate([0, -90, 0]) translate([0, 0, -0.5])  import("../../parts/common/interior/cots/screw/screw_washer_m3_05.stl");
if (show_fasteners) color("Silver") translate([122.5, -50, 66]) rotate([0, 90, 0])  import("../../parts/common/interior/cots/screw/screw_m3x25.stl");
if (show_fasteners) color("Silver") translate([122.5, -50, 66]) rotate([0, 90, 0]) translate([0, 0, -0.5])  import("../../parts/common/interior/cots/screw/screw_washer_m3_05.stl");
if (show_fasteners) color("Silver") translate([101.5, -50, 66]) rotate([0, -90, 0]) rotate([0, 0, 30])  import("../../parts/common/interior/cots/screw/screw_nut_m3.stl");
if (show_fasteners) color("Silver") translate([101.5, -50, 66]) rotate([0, -90, 0]) translate([0, 0, -0.5])  import("../../parts/common/interior/cots/screw/screw_washer_m3_05.stl");
if (show_fasteners) color("Silver") translate([122.5, 50, 42]) rotate([0, 90, 0])  import("../../parts/common/interior/cots/screw/screw_m3x25.stl");
if (show_fasteners) color("Silver") translate([122.5, 50, 42]) rotate([0, 90, 0]) translate([0, 0, -0.5])  import("../../parts/common/interior/cots/screw/screw_washer_m3_05.stl");
if (show_fasteners) color("Silver") translate([101.5, 50, 42]) rotate([0, -90, 0]) rotate([0, 0, 30])  import("../../parts/common/interior/cots/screw/screw_nut_m3.stl");
if (show_fasteners) color("Silver") translate([101.5, 50, 42]) rotate([0, -90, 0]) translate([0, 0, -0.5])  import("../../parts/common/interior/cots/screw/screw_washer_m3_05.stl");
if (show_fasteners) color("Silver") translate([122.5, 50, 66]) rotate([0, 90, 0])  import("../../parts/common/interior/cots/screw/screw_m3x25.stl");
if (show_fasteners) color("Silver") translate([122.5, 50, 66]) rotate([0, 90, 0]) translate([0, 0, -0.5])  import("../../parts/common/interior/cots/screw/screw_washer_m3_05.stl");
if (show_fasteners) color("Silver") translate([101.5, 50, 66]) rotate([0, -90, 0]) rotate([0, 0, 30])  import("../../parts/common/interior/cots/screw/screw_nut_m3.stl");
if (show_fasteners) color("Silver") translate([101.5, 50, 66]) rotate([0, -90, 0]) translate([0, 0, -0.5])  import("../../parts/common/interior/cots/screw/screw_washer_m3_05.stl");
if (show_fasteners) color("Silver") translate([122.5, 70, 42]) rotate([0, 90, 0])  import("../../parts/common/interior/cots/screw/screw_m3x25.stl");
if (show_fasteners) color("Silver") translate([122.5, 70, 42]) rotate([0, 90, 0]) translate([0, 0, -0.5])  import("../../parts/common/interior/cots/screw/screw_washer_m3_05.stl");
if (show_fasteners) color("Silver") translate([101.5, 70, 42]) rotate([0, -90, 0]) rotate([0, 0, 30])  import("../../parts/common/interior/cots/screw/screw_nut_m3.stl");
if (show_fasteners) color("Silver") translate([101.5, 70, 42]) rotate([0, -90, 0]) translate([0, 0, -0.5])  import("../../parts/common/interior/cots/screw/screw_washer_m3_05.stl");
if (show_fasteners) color("Silver") translate([122.5, 70, 66]) rotate([0, 90, 0])  import("../../parts/common/interior/cots/screw/screw_m3x25.stl");
if (show_fasteners) color("Silver") translate([122.5, 70, 66]) rotate([0, 90, 0]) translate([0, 0, -0.5])  import("../../parts/common/interior/cots/screw/screw_washer_m3_05.stl");
if (show_fasteners) color("Silver") translate([101.5, 70, 66]) rotate([0, -90, 0]) rotate([0, 0, 30])  import("../../parts/common/interior/cots/screw/screw_nut_m3.stl");
if (show_fasteners) color("Silver") translate([101.5, 70, 66]) rotate([0, -90, 0]) translate([0, 0, -0.5])  import("../../parts/common/interior/cots/screw/screw_washer_m3_05.stl");
if (show_accessories) color("SteelBlue") translate([122, 60, 130]) rotate([90, 0, 90])  import("../../parts/child/exterior/printed/child_horizontal_twist_mount/child_horizontal_twist_mount_frame_receiver.stl");
if (show_accessories) color("Orange") translate([122, 60, 130]) rotate([90, 0, 90]) translate([20, 0, 0])  import("../../parts/child/exterior/printed/child_horizontal_twist_mount/child_horizontal_twist_mount_light_twist.stl");
if (show_accessories) color("SeaGreen") translate([122, 60, 130]) rotate([90, 0, 90]) translate([20, 0, 0]) rotate([0, 0, 0]) translate([20.5, 0, 14]) rotate([0, 90, 0])  import("../../parts/common/jigs/quick_release_prototypes/quick_release_prototypes_twist_knob.stl");
if (show_fasteners) color("Silver") translate([122, 60, 130]) rotate([90, 0, 90]) translate([20, 0, 0]) rotate([0, 0, 0])  import("../../parts/common/interior/cots/quick_release_hardware/quick_release_hardware_lock_bolt.stl");
if (show_fasteners) color("Silver") translate([122, 60, 130]) rotate([90, 0, 90]) translate([20, 0, 0]) rotate([0, 0, 0])  import("../../parts/common/interior/cots/quick_release_hardware/quick_release_hardware_lock_nut.stl");
if (show_fasteners) color("Silver") translate([122, 60, 130]) rotate([90, 0, 90]) translate([20, 0, 0]) rotate([0, 0, 0])  import("../../parts/common/interior/cots/quick_release_hardware/quick_release_hardware_lock_washer.stl");
if (show_accessories) color("DimGray") translate([122, 60, 130]) rotate([90, 0, 90]) translate([20, 0, 0]) rotate([0, 0, 0])  import("../../parts/common/interior/cots/quick_release_hardware/quick_release_hardware_rubber_pads.stl");
if (show_accessories) color("SteelBlue") translate([122, 60, 130]) rotate([90, 0, 90]) translate([20, 0, -1.5]) rotate([90, 0, 180])  import("../../parts/child/exterior/printed/child_simple_light_mount/child_simple_light_mount_cap.stl");
if (show_fasteners) color("Silver") translate([122, 60, 130]) rotate([90, 0, 90]) translate([0, -30, 4.5]) rotate([0, 0, 0])  import("../../parts/common/interior/cots/screw/screw_m3x18.stl");
if (show_fasteners) color("Silver") translate([122, 60, 130]) rotate([90, 0, 90]) translate([0, -30, 4.5]) rotate([0, 0, 0]) translate([0, 0, -0.5])  import("../../parts/common/interior/cots/screw/screw_washer_m3_05.stl");
if (show_fasteners) color("Silver") translate([122, 60, 130]) rotate([90, 0, 90]) translate([0, -30, -11.6]) rotate([0, 0, 0]) rotate([0, 0, 0])  import("../../parts/common/interior/cots/screw/screw_nut_m3.stl");
if (show_fasteners) color("Silver") translate([122, 60, 130]) rotate([90, 0, 90]) translate([0, 30, 4.5]) rotate([0, 0, 0])  import("../../parts/common/interior/cots/screw/screw_m3x18.stl");
if (show_fasteners) color("Silver") translate([122, 60, 130]) rotate([90, 0, 90]) translate([0, 30, 4.5]) rotate([0, 0, 0]) translate([0, 0, -0.5])  import("../../parts/common/interior/cots/screw/screw_washer_m3_05.stl");
if (show_fasteners) color("Silver") translate([122, 60, 130]) rotate([90, 0, 90]) translate([0, 30, -11.6]) rotate([0, 0, 0]) rotate([0, 0, 0])  import("../../parts/common/interior/cots/screw/screw_nut_m3.stl");
if (show_fasteners) color("Silver") translate([122, 60, 130]) rotate([90, 0, 90]) translate([46, -32.5, 46.25]) rotate([0, 0, 0])  import("../../parts/common/interior/cots/screw/screw_m3x20.stl");
if (show_fasteners) color("Silver") translate([122, 60, 130]) rotate([90, 0, 90]) translate([46, -32.5, 46.25]) rotate([0, 0, 0]) translate([0, 0, -0.5])  import("../../parts/common/interior/cots/screw/screw_washer_m3_05.stl");
if (show_fasteners) color("Silver") translate([122, 60, 130]) rotate([90, 0, 90]) translate([46, -32.5, 31.75]) rotate([180, 0, 0]) rotate([0, 0, 30])  import("../../parts/common/interior/cots/screw/screw_nut_m3.stl");
if (show_fasteners) color("Silver") translate([122, 60, 130]) rotate([90, 0, 90]) translate([46, -32.5, 31.75]) rotate([180, 0, 0]) translate([0, 0, -0.5])  import("../../parts/common/interior/cots/screw/screw_washer_m3_05.stl");
if (show_fasteners) color("Silver") translate([122, 60, 130]) rotate([90, 0, 90]) translate([46, 32.5, 46.25]) rotate([0, 0, 0])  import("../../parts/common/interior/cots/screw/screw_m3x20.stl");
if (show_fasteners) color("Silver") translate([122, 60, 130]) rotate([90, 0, 90]) translate([46, 32.5, 46.25]) rotate([0, 0, 0]) translate([0, 0, -0.5])  import("../../parts/common/interior/cots/screw/screw_washer_m3_05.stl");
if (show_fasteners) color("Silver") translate([122, 60, 130]) rotate([90, 0, 90]) translate([46, 32.5, 31.75]) rotate([180, 0, 0]) rotate([0, 0, 30])  import("../../parts/common/interior/cots/screw/screw_nut_m3.stl");
if (show_fasteners) color("Silver") translate([122, 60, 130]) rotate([90, 0, 90]) translate([46, 32.5, 31.75]) rotate([180, 0, 0]) translate([0, 0, -0.5])  import("../../parts/common/interior/cots/screw/screw_washer_m3_05.stl");
if (show_fasteners) color("Silver") translate([122, 60, 130]) rotate([90, 0, 90]) translate([-6, -32.5, 46.25]) rotate([0, 0, 0])  import("../../parts/common/interior/cots/screw/screw_m3x20.stl");
if (show_fasteners) color("Silver") translate([122, 60, 130]) rotate([90, 0, 90]) translate([-6, -32.5, 46.25]) rotate([0, 0, 0]) translate([0, 0, -0.5])  import("../../parts/common/interior/cots/screw/screw_washer_m3_05.stl");
if (show_fasteners) color("Silver") translate([122, 60, 130]) rotate([90, 0, 90]) translate([-6, -32.5, 31.75]) rotate([180, 0, 0]) rotate([0, 0, 30])  import("../../parts/common/interior/cots/screw/screw_nut_m3.stl");
if (show_fasteners) color("Silver") translate([122, 60, 130]) rotate([90, 0, 90]) translate([-6, -32.5, 31.75]) rotate([180, 0, 0]) translate([0, 0, -0.5])  import("../../parts/common/interior/cots/screw/screw_washer_m3_05.stl");
if (show_fasteners) color("Silver") translate([122, 60, 130]) rotate([90, 0, 90]) translate([-6, 32.5, 46.25]) rotate([0, 0, 0])  import("../../parts/common/interior/cots/screw/screw_m3x20.stl");
if (show_fasteners) color("Silver") translate([122, 60, 130]) rotate([90, 0, 90]) translate([-6, 32.5, 46.25]) rotate([0, 0, 0]) translate([0, 0, -0.5])  import("../../parts/common/interior/cots/screw/screw_washer_m3_05.stl");
if (show_fasteners) color("Silver") translate([122, 60, 130]) rotate([90, 0, 90]) translate([-6, 32.5, 31.75]) rotate([180, 0, 0]) rotate([0, 0, 30])  import("../../parts/common/interior/cots/screw/screw_nut_m3.stl");
if (show_fasteners) color("Silver") translate([122, 60, 130]) rotate([90, 0, 90]) translate([-6, 32.5, 31.75]) rotate([180, 0, 0]) translate([0, 0, -0.5])  import("../../parts/common/interior/cots/screw/screw_washer_m3_05.stl");
if (show_accessories) color("SteelBlue") translate([-122, 60, 130]) rotate([90, 0, -90])  import("../../parts/child/exterior/printed/child_horizontal_twist_mount/child_horizontal_twist_mount_camera_receiver.stl");
if (show_fasteners) color("Silver") translate([-122, 60, 130]) rotate([90, 0, -90]) translate([0, -30, 4.5]) rotate([0, 0, 0])  import("../../parts/common/interior/cots/screw/screw_m3x18.stl");
if (show_fasteners) color("Silver") translate([-122, 60, 130]) rotate([90, 0, -90]) translate([0, -30, 4.5]) rotate([0, 0, 0]) translate([0, 0, -0.5])  import("../../parts/common/interior/cots/screw/screw_washer_m3_05.stl");
if (show_fasteners) color("Silver") translate([-122, 60, 130]) rotate([90, 0, -90]) translate([0, -30, -11.5]) rotate([0, 0, 0]) rotate([0, 0, 0])  import("../../parts/common/interior/cots/screw/screw_nut_m3.stl");
if (show_fasteners) color("Silver") translate([-122, 60, 130]) rotate([90, 0, -90]) translate([0, 30, 4.5]) rotate([0, 0, 0])  import("../../parts/common/interior/cots/screw/screw_m3x18.stl");
if (show_fasteners) color("Silver") translate([-122, 60, 130]) rotate([90, 0, -90]) translate([0, 30, 4.5]) rotate([0, 0, 0]) translate([0, 0, -0.5])  import("../../parts/common/interior/cots/screw/screw_washer_m3_05.stl");
if (show_fasteners) color("Silver") translate([-122, 60, 130]) rotate([90, 0, -90]) translate([0, 30, -11.5]) rotate([0, 0, 0]) rotate([0, 0, 0])  import("../../parts/common/interior/cots/screw/screw_nut_m3.stl");
// 25 mm clamp shifted 12 mm right from front-view left edge; rear lower 20 mm keepout; 41 mm measured case thickness. Physical fit pending.
if (show_accessories) color("Orange") translate([-122, 60, 130]) rotate([90, 0, -90]) translate([-53, 0, 0]) rotate([0, 0, 90]) translate([-40, 4.5863e-15, 61.95]) rotate([90, 7.01671e-15, 90])  import("../../parts/child/exterior/printed/dji_osmo_action6_mount_m3/camera_mount_twist.stl");
// Depth 41 mm measured; case rear is aligned to original backplate -23.45. Actual M5-axis offset remains unmeasured.
if (show_accessories) color("DimGray") translate([-122, 60, 130]) rotate([90, 0, -90]) translate([-53, 0, 0]) rotate([0, 0, 90]) translate([-40, 4.5863e-15, 61.95]) rotate([90, 7.01671e-15, 90])  import("../../parts/child/exterior/printed/dji_osmo_action6_mount_m3/camera_case_41mm.stl");
// Rev.6; sensor ear thickness 3 mm is provisional; rejected body model omitted.
if (show_exterior) color("DarkOrange") translate([122, -74, 108]) rotate([0, 0, 0]) translate([-45, 0, 0]) translate([45, 0, 0])  import("../../parts/common/exterior/printed/td04a_bracket_mount/td04a_bracket_mount_child_side_up.stl");
// Rev.6; sensor ear thickness 3 mm is provisional; rejected body model omitted.
if (show_hardware) color("Silver") translate([122, -74, 108]) rotate([0, 0, 0]) translate([-45, 0, 0]) translate([71, 5.8, 65]) rotate([-90, 0, 0])  import("../../parts/common/interior/cots/screw/screw_m4x14_socket.stl");
// Rev.6; sensor ear thickness 3 mm is provisional; rejected body model omitted.
if (show_hardware) color("Silver") translate([122, -74, 108]) rotate([0, 0, 0]) translate([-45, 0, 0]) translate([71, -3, 65]) rotate([90, 0, 0])  import("../../parts/common/interior/cots/screw/screw_washer_m4_08.stl");
// Rev.6; sensor ear thickness 3 mm is provisional; rejected body model omitted.
if (show_hardware) color("Silver") translate([122, -74, 108]) rotate([0, 0, 0]) translate([-45, 0, 0]) translate([71, 5, 65]) rotate([-90, 0, 0])  import("../../parts/common/interior/cots/screw/screw_washer_m4_08.stl");
// Rev.6; sensor ear thickness 3 mm is provisional; rejected body model omitted.
if (show_hardware) color("Silver") translate([122, -74, 108]) rotate([0, 0, 0]) translate([-45, 0, 0]) translate([71, -3.8, 65]) rotate([90, 0, 0])  import("../../parts/common/interior/cots/screw/screw_nut_m4.stl");
// Rev.6; sensor ear thickness 3 mm is provisional; rejected body model omitted.
if (show_hardware) color("Silver") translate([122, -74, 108]) rotate([0, 0, 0]) translate([-45, 0, 0]) translate([83, 5.8, 65]) rotate([-90, 0, 0])  import("../../parts/common/interior/cots/screw/screw_m4x14_socket.stl");
// Rev.6; sensor ear thickness 3 mm is provisional; rejected body model omitted.
if (show_hardware) color("Silver") translate([122, -74, 108]) rotate([0, 0, 0]) translate([-45, 0, 0]) translate([83, -3, 65]) rotate([90, 0, 0])  import("../../parts/common/interior/cots/screw/screw_washer_m4_08.stl");
// Rev.6; sensor ear thickness 3 mm is provisional; rejected body model omitted.
if (show_hardware) color("Silver") translate([122, -74, 108]) rotate([0, 0, 0]) translate([-45, 0, 0]) translate([83, 5, 65]) rotate([-90, 0, 0])  import("../../parts/common/interior/cots/screw/screw_washer_m4_08.stl");
// Rev.6; sensor ear thickness 3 mm is provisional; rejected body model omitted.
if (show_hardware) color("Silver") translate([122, -74, 108]) rotate([0, 0, 0]) translate([-45, 0, 0]) translate([83, -3.8, 65]) rotate([90, 0, 0])  import("../../parts/common/interior/cots/screw/screw_nut_m4.stl");
// Rev.6; sensor ear thickness 3 mm is provisional; rejected body model omitted.
if (show_hardware) color("Silver") translate([122, -74, 108]) rotate([0, 0, 0]) translate([-45, 0, 0]) translate([50.5, 14, 12]) rotate([0, 90, 0])  import("../../parts/common/interior/cots/screw/screw_m3x20.stl");
// Rev.6; sensor ear thickness 3 mm is provisional; rejected body model omitted.
if (show_hardware) color("Silver") translate([122, -74, 108]) rotate([0, 0, 0]) translate([-45, 0, 0]) translate([50, 14, 12]) rotate([0, 90, 0])  import("../../parts/common/interior/cots/screw/screw_washer_m3_05.stl");
// Rev.6; sensor ear thickness 3 mm is provisional; rejected body model omitted.
if (show_hardware) color("Silver") translate([122, -74, 108]) rotate([0, 0, 0]) translate([-45, 0, 0]) translate([35.8, 14, 12]) rotate([0, -90, 0]) rotate([0, 0, 30])  import("../../parts/common/interior/cots/screw/screw_nut_m3.stl");
// Rev.6; sensor ear thickness 3 mm is provisional; rejected body model omitted.
if (show_hardware) color("Silver") translate([122, -74, 108]) rotate([0, 0, 0]) translate([-45, 0, 0]) translate([50.5, 14, 32]) rotate([0, 90, 0])  import("../../parts/common/interior/cots/screw/screw_m3x20.stl");
// Rev.6; sensor ear thickness 3 mm is provisional; rejected body model omitted.
if (show_hardware) color("Silver") translate([122, -74, 108]) rotate([0, 0, 0]) translate([-45, 0, 0]) translate([50, 14, 32]) rotate([0, 90, 0])  import("../../parts/common/interior/cots/screw/screw_washer_m3_05.stl");
// Rev.6; sensor ear thickness 3 mm is provisional; rejected body model omitted.
if (show_hardware) color("Silver") translate([122, -74, 108]) rotate([0, 0, 0]) translate([-45, 0, 0]) translate([35.8, 14, 32]) rotate([0, -90, 0]) rotate([0, 0, 30])  import("../../parts/common/interior/cots/screw/screw_nut_m3.stl");
if (show_accessories) color("Orange") translate([-122, 60, 130]) rotate([90, 0, -90]) translate([-53, 0, 0]) rotate([0, 0, 90]) translate([-40, 4.5863e-15, 61.95]) rotate([90, 7.01671e-15, 90])  import("../../parts/child/exterior/printed/dji_osmo_action6_mount_m3/camera_front_clamp.stl");
if (show_fasteners) color("Silver") translate([-122, 60, 130]) rotate([90, 0, -90]) translate([-53, 0, 0]) rotate([0, 0, 90]) translate([-40, 4.5863e-15, 61.95]) rotate([90, 7.01671e-15, 90]) translate([11.5, 11.5, 4]) rotate([180, 0, 0])  import("../../parts/common/interior/cots/screw/screw_m4x16_socket.stl");
if (show_fasteners) color("Silver") translate([-122, 60, 130]) rotate([90, 0, -90]) translate([-53, 0, 0]) rotate([0, 0, 90]) translate([-40, 4.5863e-15, 61.95]) rotate([90, 7.01671e-15, 90]) translate([11.5, 11.5, 4])  import("../../parts/common/interior/cots/screw/screw_washer_m4_08.stl");
if (show_fasteners) color("Silver") translate([-122, 60, 130]) rotate([90, 0, -90]) translate([-53, 0, 0]) rotate([0, 0, 90]) translate([-40, 4.5863e-15, 61.95]) rotate([90, 7.01671e-15, 90]) translate([11.5, 11.5, 10.6]) rotate([0, 0, 30])  import("../../parts/common/interior/cots/screw/screw_nut_m4.stl");
if (show_fasteners) color("Silver") translate([-122, 60, 130]) rotate([90, 0, -90]) translate([-53, 0, 0]) rotate([0, 0, 90]) translate([-40, 4.5863e-15, 61.95]) rotate([90, 7.01671e-15, 90]) translate([24.5, 11.5, 4]) rotate([180, 0, 0])  import("../../parts/common/interior/cots/screw/screw_m4x16_socket.stl");
if (show_fasteners) color("Silver") translate([-122, 60, 130]) rotate([90, 0, -90]) translate([-53, 0, 0]) rotate([0, 0, 90]) translate([-40, 4.5863e-15, 61.95]) rotate([90, 7.01671e-15, 90]) translate([24.5, 11.5, 4])  import("../../parts/common/interior/cots/screw/screw_washer_m4_08.stl");
if (show_fasteners) color("Silver") translate([-122, 60, 130]) rotate([90, 0, -90]) translate([-53, 0, 0]) rotate([0, 0, 90]) translate([-40, 4.5863e-15, 61.95]) rotate([90, 7.01671e-15, 90]) translate([24.5, 11.5, 10.6]) rotate([0, 0, 30])  import("../../parts/common/interior/cots/screw/screw_nut_m4.stl");
if (show_fasteners) color("Silver") translate([-122, 60, 130]) rotate([90, 0, -90]) translate([-53, 0, 0]) rotate([0, 0, 90]) translate([0, -52, 31.5])  import("../../parts/child/exterior/printed/dji_osmo_action6_mount_m3/camera_m3x30_hex.stl");
if (show_fasteners) color("Silver") translate([-122, 60, 130]) rotate([90, 0, -90]) translate([-53, 0, 0]) rotate([0, 0, 90]) translate([0, -52, 2.4]) rotate([0, 0, 30])  import("../../parts/common/interior/cots/screw/screw_nut_m3.stl");
if (show_accessories) color("Orange") translate([-122, 60, 130]) rotate([90, 0, -90]) translate([-53, 0, 0]) rotate([0, 0, 90]) translate([0, -52, 8])  import("../../parts/child/exterior/printed/dji_osmo_action6_mount_m3/camera_hand_spacer.stl");
if (show_accessories) color("SeaGreen") translate([-122, 60, 130]) rotate([90, 0, -90]) translate([-53, 0, 0]) rotate([0, 0, 90]) translate([0, -52, 30.5])  import("../../parts/child/exterior/printed/dji_osmo_action6_mount_m3/camera_hand_knob.stl");
if (show_accessories) color("SeaGreen") translate([-122, 60, 130]) rotate([90, 0, -90]) translate([-53, 0, 0]) rotate([0, 0, 90]) translate([0, -52, 33.5])  import("../../parts/child/exterior/printed/dji_osmo_action6_mount_m3/camera_hand_knob_cap.stl");
if (show_fasteners) color("Silver") translate([-122, 60, 130]) rotate([90, 0, -90]) translate([-53, 0, 0]) rotate([0, 0, 90]) translate([0, 52, 31.5])  import("../../parts/child/exterior/printed/dji_osmo_action6_mount_m3/camera_m3x30_hex.stl");
if (show_fasteners) color("Silver") translate([-122, 60, 130]) rotate([90, 0, -90]) translate([-53, 0, 0]) rotate([0, 0, 90]) translate([0, 52, 2.4]) rotate([0, 0, 30])  import("../../parts/common/interior/cots/screw/screw_nut_m3.stl");
if (show_accessories) color("Orange") translate([-122, 60, 130]) rotate([90, 0, -90]) translate([-53, 0, 0]) rotate([0, 0, 90]) translate([0, 52, 8])  import("../../parts/child/exterior/printed/dji_osmo_action6_mount_m3/camera_hand_spacer.stl");
if (show_accessories) color("SeaGreen") translate([-122, 60, 130]) rotate([90, 0, -90]) translate([-53, 0, 0]) rotate([0, 0, 90]) translate([0, 52, 30.5])  import("../../parts/child/exterior/printed/dji_osmo_action6_mount_m3/camera_hand_knob.stl");
if (show_accessories) color("SeaGreen") translate([-122, 60, 130]) rotate([90, 0, -90]) translate([-53, 0, 0]) rotate([0, 0, 90]) translate([0, 52, 33.5])  import("../../parts/child/exterior/printed/dji_osmo_action6_mount_m3/camera_hand_knob_cap.stl");
// 下フランジ。ピストン(局所 z0..19)を上へ向けてチューブ座ぐりへ 19mm 挿入 → カラー(Ø114.3)が z -8..0 に露出
if (show_vessel) color("LightSteelBlue", 0.6) translate([0, -100, 138]) rotate([-90, 0, 0]) translate([0, 0, 19]) rotate([180, 0, 0]) translate([-57.15, -57.15, 0])  import("../../parts/child/exterior/cots/wte4_flange/BR-101040_RevC.stl");
// 上フランジ。ピストンを下へ向けて挿入 → カラー上面が z=208 (= ドームの座面)
if (show_vessel) color("LightSteelBlue", 0.6) translate([0, -100, 138]) rotate([-90, 0, 0]) translate([0, 0, 181]) translate([-57.15, -57.15, 0])  import("../../parts/child/exterior/cots/wte4_flange/BR-101040_RevC.stl");
// 上ドーム BR-100495 の **参考モデル(仮)**。座面 z=208、頂点 z=261.25。dome_h=53.25 は要実測 — ここが全高の唯一の未確定要素
if (show_vessel) color("PowderBlue", 0.35) translate([0, -100, 138]) rotate([-90, 0, 0]) translate([0, 0, 208])  import("../../parts/child/exterior/cots/wte4_dome_cap/wte4_dome_cap_ref.stl");
// アクリルチューブ 4in x 200mm。元モデルは軸=X(0..200)/断面中心(57.15,57.15) → 軸を Z へ立てる。下端面が z=0
if (show_vessel) color("LightSteelBlue", 0.3) translate([0, -100, 138]) rotate([-90, 0, 0]) rotate([0, -90, 0]) translate([0, -57.15, -57.15])  import("../../parts/child/exterior/cots/wte4_acrylic_tube/BR-101052-200_RevB.stl");
