AquaBeacon/mechanical/assemblies/over_center_latch/over_center_latch_view.scad

// =====================================================================
// over_center_latch_view.scad
// !! 自動生成ファイル - 編集しないこと。placement.json を直して
//    build.ps1 -Assemblies で再生成する。
// DJI-type short links, extended B-mounted hood, 80deg recessed keeper. Nominal 40 N horizontal clamp; rubber properties provisional.
// =====================================================================

color("SlateGray") translate([0, 0, 0]) rotate([0, 0, 0])  import("../../parts/common/jigs/over_center_latch/over_center_latch_base.stl");
color("Orange") translate([0, -8, 6]) rotate([0, -150, 0])  import("../../parts/common/jigs/over_center_latch/over_center_latch_bail.stl");
color("Orange") translate([0, 4.4, 6]) rotate([0, -150, 0])  import("../../parts/common/jigs/over_center_latch/over_center_latch_bail.stl");
color("SteelBlue") translate([-6.9282, 0, 10]) rotate([0, -0, 0])  import("../../parts/common/jigs/over_center_latch/over_center_latch_lever.stl");
color("SeaGreen") translate([12.4, 0, 0]) rotate([0, 0, 0])  import("../../parts/common/jigs/over_center_latch/over_center_latch_keeper.stl");
color("Silver") translate([0, 0, 6]) rotate([0, 0, 0])  import("../../parts/common/jigs/over_center_latch/over_center_latch_axis_a.stl");
color("Silver") translate([-6.9282, 0, 10]) rotate([0, 0, 0])  import("../../parts/common/jigs/over_center_latch/over_center_latch_axis_b.stl");
color("Black") translate([12.4, 0, 0]) rotate([0, 0, 0])  import("../../parts/common/jigs/over_center_latch/over_center_latch_epdm.stl");
