AquaBeacon/mechanical/assemblies/parent_hand_service/parent_hand_service.scad

// Generated fixed interior. Parameters and sources are canonical in placement.json.
/* [Inspection] */
show_case=true;
show_lid_keepout=false;
show_tx_keepout=true;
out_of_case=false;
translate(out_of_case ? [230,0,0] : [0,0,0]) color("Orange",0.9)  import("../../parts/parent/interior/printed/parent_hand_service/floor_plate.stl",convexity=20); // plate
translate(out_of_case ? [230,0,0] : [0,0,0]) color("SteelBlue",1.0) translate([18, 112, 42]) rotate([0, 0, 0]) import("../../parts/parent/interior/pcb/parent_main/parent_main.stl",convexity=20); // p_main
translate(out_of_case ? [230,0,0] : [0,0,0]) color("MediumSeaGreen",1.0) translate([25.8, 115, 28.3]) rotate([0, 0, 90]) import("../../parts/parent/interior/pcb/parent_pwr/parent_pwr.stl",convexity=20); // p_pwr
translate(out_of_case ? [230,0,0] : [0,0,0]) color("Gold",1.0) translate([148, 140.5, 24.8]) rotate([0, 0, 90]) import("../../parts/parent/interior/pcb/tx_improved/tx_improved.stl",convexity=20); // tx_improved
translate(out_of_case ? [230,0,0] : [0,0,0]) color("SandyBrown",1.0) translate([202.34, 208, 65.6]) rotate([0, 0, 180]) import("../../parts/parent/interior/cots/spresense_service_stack/spresense_service_stack.stl",convexity=20); // spresense
translate(out_of_case ? [230,0,0] : [0,0,0]) color("DarkOrange",0.9) translate([197.5, 22.1, 20]) rotate([0, 0, 90]) import("../../parts/parent/interior/printed/parent_hand_service/battery_base.stl",convexity=20); // lipo_tray
translate(out_of_case ? [230,0,0] : [0,0,0]) color("IndianRed",1.0) translate([153, 124.6, 23]) rotate([0, 0, 270]) import("../../parts/common/interior/cots/lipo_3s_2200_zeee/lipo_3s_2200_zeee_pack.stl",convexity=20); // lipo
if(show_case) color("Silver",1.0) translate([28, 0, 65]) rotate([-90, 0, 0]) import("../../parts/common/exterior/cots/wetlink_penetrator_m10/wetlink_penetrator_m10_ref_bcas.stl",convexity=20); // pen_tether
if(show_case) color("Silver",1.0) translate([120, 0, 65]) rotate([-90, 0, 0]) import("../../parts/common/exterior/cots/wetlink_penetrator_m10/wetlink_penetrator_m10_ref_bcas.stl",convexity=20); // pen_td04a
if(show_case) color("LightSteelBlue",0.22) translate([0, 0, 0]) import("../../parts/parent/exterior/cots/bcas212310g/bcas212310g.stl",convexity=20); // box_bcas212310g
translate(out_of_case ? [230,0,0] : [0,0,0]) color("Orange",1) translate([197.5, 22.1, 49]) rotate([0, 0, 90]) import("../../parts/parent/interior/printed/parent_lipo_retainer/parent_lipo_retainer_lid_narrow.stl",convexity=20); // lipo_ret_lid
translate(out_of_case ? [230,0,0] : [0,0,0]) color("LightPink",1) translate([197.5, 22.1, 20]) rotate([0, 0, 90]) import("../../parts/parent/interior/printed/parent_hand_service/battery_pads_open_end.stl",convexity=20); // lipo_ret_pads
translate(out_of_case ? [230,0,0] : [0,0,0]) color("Silver",1) translate([192.5, 34.1, 52]) import("../../parts/common/interior/cots/screw/screw_m3x12.stl",convexity=20); // lipo_ret_bolt_0
translate(out_of_case ? [230,0,0] : [0,0,0]) color("Silver",1) translate([192.5, 34.1, 41.6]) import("../../parts/common/interior/cots/screw/screw_nut_m3.stl",convexity=20); // lipo_ret_nut_0
translate(out_of_case ? [230,0,0] : [0,0,0]) color("Silver",1) translate([192.5, 113.1, 52]) import("../../parts/common/interior/cots/screw/screw_m3x12.stl",convexity=20); // lipo_ret_bolt_1
translate(out_of_case ? [230,0,0] : [0,0,0]) color("Silver",1) translate([192.5, 113.1, 41.6]) import("../../parts/common/interior/cots/screw/screw_nut_m3.stl",convexity=20); // lipo_ret_nut_1
translate(out_of_case ? [230,0,0] : [0,0,0]) color("Silver",1) translate([147.5, 34.1, 52]) import("../../parts/common/interior/cots/screw/screw_m3x12.stl",convexity=20); // lipo_ret_bolt_2
translate(out_of_case ? [230,0,0] : [0,0,0]) color("Silver",1) translate([147.5, 34.1, 41.6]) import("../../parts/common/interior/cots/screw/screw_nut_m3.stl",convexity=20); // lipo_ret_nut_2
translate(out_of_case ? [230,0,0] : [0,0,0]) color("Silver",1) translate([147.5, 113.1, 52]) import("../../parts/common/interior/cots/screw/screw_m3x12.stl",convexity=20); // lipo_ret_bolt_3
translate(out_of_case ? [230,0,0] : [0,0,0]) color("Silver",1) translate([147.5, 113.1, 41.6]) import("../../parts/common/interior/cots/screw/screw_nut_m3.stl",convexity=20); // lipo_ret_nut_3
translate(out_of_case ? [230,0,0] : [0,0,0]) color("Silver",1) translate([197.5, 22.1, 23]) import("../../parts/common/interior/cots/screw/screw_m3x8.stl",convexity=20); // lipo_ret_mount_0
translate(out_of_case ? [230,0,0] : [0,0,0]) color("Silver",1) translate([197.5, 125.1, 23]) import("../../parts/common/interior/cots/screw/screw_m3x8.stl",convexity=20); // lipo_ret_mount_1
translate(out_of_case ? [230,0,0] : [0,0,0]) color("Silver",1) translate([142, 22.1, 23]) import("../../parts/common/interior/cots/screw/screw_m3x8.stl",convexity=20); // lipo_ret_mount_2
translate(out_of_case ? [230,0,0] : [0,0,0]) color("Silver",1) translate([142, 125.1, 23]) import("../../parts/common/interior/cots/screw/screw_m3x8.stl",convexity=20); // lipo_ret_mount_3
translate(out_of_case ? [230,0,0] : [0,0,0]) color("Silver",1) translate([25, 25, 16.8]) import("../../parts/common/interior/cots/screw/screw_m4x12_button.stl",convexity=20); // case_anchor_0
translate(out_of_case ? [230,0,0] : [0,0,0]) color("Silver",1) translate([185, 25, 16.8]) import("../../parts/common/interior/cots/screw/screw_m4x12_button.stl",convexity=20); // case_anchor_1
translate(out_of_case ? [230,0,0] : [0,0,0]) color("Silver",1) translate([25, 205, 16.8]) import("../../parts/common/interior/cots/screw/screw_m4x12_button.stl",convexity=20); // case_anchor_2
translate(out_of_case ? [230,0,0] : [0,0,0]) color("Silver",1) translate([185, 205, 16.8]) import("../../parts/common/interior/cots/screw/screw_m4x12_button.stl",convexity=20); // case_anchor_3
translate(out_of_case ? [230,0,0] : [0,0,0]) color("Orange",1) translate([21, 16.5, 18.8]) import("../../parts/parent/interior/printed/parent_hand_service/main_corner_column.stl",convexity=20); // main_column_0
translate(out_of_case ? [230,0,0] : [0,0,0]) color("Orange",1) translate([22.5, 107.5, 18.8]) import("../../parts/parent/interior/printed/parent_hand_service/main_corner_column.stl",convexity=20); // main_column_1
translate(out_of_case ? [230,0,0] : [0,0,0]) color("Orange",1) translate([125.5, 32, 18.8]) import("../../parts/parent/interior/printed/parent_hand_service/main_corner_column.stl",convexity=20); // main_column_2
translate(out_of_case ? [230,0,0] : [0,0,0]) color("Orange",1) translate([125.5, 107.5, 18.8]) import("../../parts/parent/interior/printed/parent_hand_service/main_corner_column.stl",convexity=20); // main_column_3
translate(out_of_case ? [230,0,0] : [0,0,0]) color("Orange",1)  import("../../parts/parent/interior/printed/parent_hand_service/main_mount_plate.stl",convexity=20); // main_mount_plate
translate(out_of_case ? [230,0,0] : [0,0,0]) color("Orange",1)  import("../../parts/parent/interior/printed/parent_hand_service/sony_mount_plate.stl",convexity=20); // sony_mount_plate
translate(out_of_case ? [230,0,0] : [0,0,0]) color("Orange",1) translate([144, 134.5, 18.8]) import("../../parts/common/interior/printed/stack_spacers/sony_column_left.stl",convexity=20); // sony_column_0
translate(out_of_case ? [230,0,0] : [0,0,0]) color("Orange",1) translate([201, 134.5, 18.8]) import("../../parts/common/interior/printed/stack_spacers/sony_column_right.stl",convexity=20); // sony_column_1
translate(out_of_case ? [230,0,0] : [0,0,0]) color("Orange",1) translate([144, 211.5, 18.8]) import("../../parts/common/interior/printed/stack_spacers/sony_column_left.stl",convexity=20); // sony_column_2
translate(out_of_case ? [230,0,0] : [0,0,0]) color("Orange",1) translate([201, 204.5, 18.8]) import("../../parts/common/interior/printed/stack_spacers/sony_column_right.stl",convexity=20); // sony_column_3
if(show_lid_keepout && !out_of_case) color("LightGray",0.18)  import("../../parts/parent/exterior/cots/bcas212310g/bcas212310g_cover.stl",convexity=20); // lid_keepout
translate(out_of_case ? [230,0,0] : [0,0,0]) color("Silver",1) translate([22.5, 107.5, 43.6]) import("../../parts/common/interior/cots/screw/screw_m3x30.stl",convexity=20); // main_mount_0
translate(out_of_case ? [230,0,0] : [0,0,0]) color("Silver",1) translate([22.5, 32, 43.6]) import("../../parts/common/interior/cots/screw/screw_m3x8.stl",convexity=20); // main_mount_1
translate(out_of_case ? [230,0,0] : [0,0,0]) color("Silver",1) translate([125.5, 32, 43.6]) import("../../parts/common/interior/cots/screw/screw_m3x30.stl",convexity=20); // main_mount_2
translate(out_of_case ? [230,0,0] : [0,0,0]) color("Silver",1) translate([125.5, 107.5, 43.6]) import("../../parts/common/interior/cots/screw/screw_m3x30.stl",convexity=20); // main_mount_3
translate(out_of_case ? [230,0,0] : [0,0,0]) color("Silver",1) translate([199.8, 153.39, 67.2]) import("../../parts/common/interior/cots/screw/screw_m2_5x6.stl",convexity=20); // sony_mount_0
translate(out_of_case ? [230,0,0] : [0,0,0]) color("Silver",1) translate([151.54, 154.66, 67.2]) import("../../parts/common/interior/cots/screw/screw_m2_5x6.stl",convexity=20); // sony_mount_1
translate(out_of_case ? [230,0,0] : [0,0,0]) color("Silver",1) translate([194.72, 205.46, 67.2]) import("../../parts/common/interior/cots/screw/screw_m2_5x6.stl",convexity=20); // sony_mount_2
translate(out_of_case ? [230,0,0] : [0,0,0]) color("Silver",1) translate([166.78, 205.46, 67.2]) import("../../parts/common/interior/cots/screw/screw_m2_5x6.stl",convexity=20); // sony_mount_3
translate(out_of_case ? [230,0,0] : [0,0,0]) color("Silver",1) translate([30.8, 120, 29.9]) import("../../parts/common/interior/cots/screw/screw_m3x8.stl",convexity=20); // pwr_mount_0
translate(out_of_case ? [230,0,0] : [0,0,0]) color("Silver",1) translate([104.8, 210, 29.9]) import("../../parts/common/interior/cots/screw/screw_m3x8.stl",convexity=20); // pwr_mount_1
translate(out_of_case ? [230,0,0] : [0,0,0]) color("Silver",1) translate([30.8, 210, 29.9]) import("../../parts/common/interior/cots/screw/screw_m3x8.stl",convexity=20); // pwr_mount_2
translate(out_of_case ? [230,0,0] : [0,0,0]) color("Silver",1) translate([104.8, 120, 29.9]) import("../../parts/common/interior/cots/screw/screw_m3x8.stl",convexity=20); // pwr_mount_3
translate(out_of_case ? [230,0,0] : [0,0,0]) color("Silver",1) translate([194, 206.5, 26.4]) import("../../parts/common/interior/cots/screw/screw_m3x8.stl",convexity=20); // tx_mount_0
translate(out_of_case ? [230,0,0] : [0,0,0]) color("Silver",1) translate([194, 140.5, 26.4]) import("../../parts/common/interior/cots/screw/screw_m3x8.stl",convexity=20); // tx_mount_1
translate(out_of_case ? [230,0,0] : [0,0,0]) color("Silver",1) translate([152, 206.5, 26.4]) import("../../parts/common/interior/cots/screw/screw_m3x8.stl",convexity=20); // tx_mount_2
translate(out_of_case ? [230,0,0] : [0,0,0]) color("Silver",1) translate([152, 140.5, 26.4]) import("../../parts/common/interior/cots/screw/screw_m3x8.stl",convexity=20); // tx_mount_3
translate(out_of_case ? [230,0,0] : [0,0,0]) color("Silver",1) translate([21, 16.5, 16.2]) rotate([0, 0, 30]) import("../../parts/common/interior/cots/screw/screw_nut_m3.stl",convexity=20); // main_carrier_nut_0
translate(out_of_case ? [230,0,0] : [0,0,0]) color("Silver",1) translate([21, 16.5, 36.8]) import("../../parts/common/interior/cots/screw/screw_m3x25.stl",convexity=20); // main_carrier_mount_0
translate(out_of_case ? [230,0,0] : [0,0,0]) color("Silver",1) translate([22.5, 107.5, 16.2]) rotate([0, 0, 30]) import("../../parts/common/interior/cots/screw/screw_nut_m3.stl",convexity=20); // main_carrier_nut_1
translate(out_of_case ? [230,0,0] : [0,0,0]) color("Silver",1) translate([125.5, 32, 16.2]) rotate([0, 0, 30]) import("../../parts/common/interior/cots/screw/screw_nut_m3.stl",convexity=20); // main_carrier_nut_2
translate(out_of_case ? [230,0,0] : [0,0,0]) color("Silver",1) translate([125.5, 107.5, 16.2]) rotate([0, 0, 30]) import("../../parts/common/interior/cots/screw/screw_nut_m3.stl",convexity=20); // main_carrier_nut_3
translate(out_of_case ? [230,0,0] : [0,0,0]) color("Silver",1) translate([144, 134.5, 16.2]) rotate([0, 0, 30]) import("../../parts/common/interior/cots/screw/screw_nut_m3.stl",convexity=20); // sony_carrier_nut_0
translate(out_of_case ? [230,0,0] : [0,0,0]) color("Silver",1) translate([144, 134.5, 62.1]) import("../../parts/common/interior/cots/screw/screw_m3x50.stl",convexity=20); // sony_carrier_mount_0
translate(out_of_case ? [230,0,0] : [0,0,0]) color("Silver",1) translate([201, 134.5, 16.2]) rotate([0, 0, 30]) import("../../parts/common/interior/cots/screw/screw_nut_m3.stl",convexity=20); // sony_carrier_nut_1
translate(out_of_case ? [230,0,0] : [0,0,0]) color("Silver",1) translate([201, 134.5, 62.1]) import("../../parts/common/interior/cots/screw/screw_m3x50.stl",convexity=20); // sony_carrier_mount_1
translate(out_of_case ? [230,0,0] : [0,0,0]) color("Silver",1) translate([144, 211.5, 16.2]) rotate([0, 0, 30]) import("../../parts/common/interior/cots/screw/screw_nut_m3.stl",convexity=20); // sony_carrier_nut_2
translate(out_of_case ? [230,0,0] : [0,0,0]) color("Silver",1) translate([144, 211.5, 62.1]) import("../../parts/common/interior/cots/screw/screw_m3x50.stl",convexity=20); // sony_carrier_mount_2
translate(out_of_case ? [230,0,0] : [0,0,0]) color("Silver",1) translate([201, 204.5, 16.2]) rotate([0, 0, 30]) import("../../parts/common/interior/cots/screw/screw_nut_m3.stl",convexity=20); // sony_carrier_nut_3
translate(out_of_case ? [230,0,0] : [0,0,0]) color("Silver",1) translate([201, 204.5, 62.1]) import("../../parts/common/interior/cots/screw/screw_m3x50.stl",convexity=20); // sony_carrier_mount_3
translate(out_of_case ? [230,0,0] : [0,0,0]) color("Silver",1) translate([13, 145, 16.2]) rotate([0, 0, 30]) import("../../parts/common/interior/cots/screw/screw_nut_m3.stl",convexity=20); // gnss_frame_nut_0
translate(out_of_case ? [230,0,0] : [0,0,0]) color("Silver",1) translate([13, 145, 52.5]) import("../../parts/common/interior/cots/screw/screw_m3x40.stl",convexity=20); // gnss_frame_mount_0
translate(out_of_case ? [230,0,0] : [0,0,0]) color("Silver",1) translate([135, 145, 16.2]) rotate([0, 0, 30]) import("../../parts/common/interior/cots/screw/screw_nut_m3.stl",convexity=20); // gnss_frame_nut_1
translate(out_of_case ? [230,0,0] : [0,0,0]) color("Silver",1) translate([135, 145, 52.5]) import("../../parts/common/interior/cots/screw/screw_m3x40.stl",convexity=20); // gnss_frame_mount_1
translate(out_of_case ? [230,0,0] : [0,0,0]) color("Silver",1) translate([22.6, 219, 16.2]) rotate([0, 0, 30]) import("../../parts/common/interior/cots/screw/screw_nut_m3.stl",convexity=20); // gnss_frame_nut_2
translate(out_of_case ? [230,0,0] : [0,0,0]) color("Silver",1) translate([22.6, 219, 52.5]) import("../../parts/common/interior/cots/screw/screw_m3x40.stl",convexity=20); // gnss_frame_mount_2
translate(out_of_case ? [230,0,0] : [0,0,0]) color("Silver",1) translate([135, 219, 16.2]) rotate([0, 0, 30]) import("../../parts/common/interior/cots/screw/screw_nut_m3.stl",convexity=20); // gnss_frame_nut_3
translate(out_of_case ? [230,0,0] : [0,0,0]) color("Silver",1) translate([135, 219, 52.5]) import("../../parts/common/interior/cots/screw/screw_m3x40.stl",convexity=20); // gnss_frame_mount_3
translate(out_of_case ? [230,0,0] : [0,0,0]) color("Silver",1) translate([12, 25, 16.2]) rotate([0, 0, 30]) import("../../parts/common/interior/cots/screw/screw_nut_m3.stl",convexity=20); // antenna_rack_nut_0
translate(out_of_case ? [230,0,0] : [0,0,0]) color("Silver",1) translate([12, 25, 63.6]) import("../../parts/common/interior/cots/screw/screw_m3x50.stl",convexity=20); // antenna_rack_mount_0
translate(out_of_case ? [230,0,0] : [0,0,0]) color("Silver",1) translate([134, 25, 16.2]) rotate([0, 0, 30]) import("../../parts/common/interior/cots/screw/screw_nut_m3.stl",convexity=20); // antenna_rack_nut_1
translate(out_of_case ? [230,0,0] : [0,0,0]) color("Silver",1) translate([134, 25, 63.6]) import("../../parts/common/interior/cots/screw/screw_m3x50.stl",convexity=20); // antenna_rack_mount_1
translate(out_of_case ? [230,0,0] : [0,0,0]) color("Silver",1) translate([12, 95, 16.2]) rotate([0, 0, 30]) import("../../parts/common/interior/cots/screw/screw_nut_m3.stl",convexity=20); // antenna_rack_nut_2
translate(out_of_case ? [230,0,0] : [0,0,0]) color("Silver",1) translate([12, 95, 63.6]) import("../../parts/common/interior/cots/screw/screw_m3x50.stl",convexity=20); // antenna_rack_mount_2
translate(out_of_case ? [230,0,0] : [0,0,0]) color("Silver",1) translate([134, 95, 16.2]) rotate([0, 0, 30]) import("../../parts/common/interior/cots/screw/screw_nut_m3.stl",convexity=20); // antenna_rack_nut_3
translate(out_of_case ? [230,0,0] : [0,0,0]) color("Silver",1) translate([134, 95, 63.6]) import("../../parts/common/interior/cots/screw/screw_m3x50.stl",convexity=20); // antenna_rack_mount_3
translate(out_of_case ? [230,0,0] : [0,0,0]) color("Green",1) translate([113.5, 205, 64.6]) rotate([0, 0, 180]) import("../../parts/parent/interior/cots/sparkfun_neo_f9p/sparkfun_neo_f9p.stl",convexity=20); // gnss_receiver
translate(out_of_case ? [230,0,0] : [0,0,0]) color("Green",1) translate([113.5, 205, 64.6]) rotate([0, 0, 180]) import("../../parts/parent/interior/cots/sparkfun_neo_f9p/sma_plug_envelope.stl",convexity=20); // gnss_sma_plug
translate(out_of_case ? [230,0,0] : [0,0,0]) color("Green",1) translate([113.5, 205, 64.6]) rotate([0, 0, 180]) import("../../parts/parent/interior/cots/sparkfun_neo_f9p/gnss_pin_headers.stl",convexity=20); // gnss_pin_headers
translate(out_of_case ? [230,0,0] : [0,0,0]) color("Olive",1) translate([69, 139, 56]) import("../../parts/parent/interior/cots/sparkfun_neo_f9p/universal_pcb_60x80.stl",convexity=20); // gnss_universal_pcb
translate(out_of_case ? [230,0,0] : [0,0,0]) color("Yellow",0.3) translate([60.7, 168, 57.6]) import("../../parts/parent/interior/cots/sparkfun_neo_f9p/xh_plug_keepout.stl",convexity=20); // gnss_xh_keepout
translate(out_of_case ? [230,0,0] : [0,0,0]) color("Orange",1)  import("../../parts/parent/interior/printed/gnss_universal_carrier/gnss_universal_carrier.stl",convexity=20); // gnss_universal_carrier
translate(out_of_case ? [230,0,0] : [0,0,0]) color("Orange",1) translate([13, 145, 18.8]) import("../../parts/parent/interior/printed/gnss_universal_carrier/gnss_column_front.stl",convexity=20); // gnss_column_0
translate(out_of_case ? [230,0,0] : [0,0,0]) color("Orange",1) translate([135, 145, 18.8]) import("../../parts/parent/interior/printed/gnss_universal_carrier/gnss_column_front.stl",convexity=20); // gnss_column_1
translate(out_of_case ? [230,0,0] : [0,0,0]) color("Orange",1) translate([22.6, 219, 18.8]) import("../../parts/parent/interior/printed/gnss_universal_carrier/gnss_column_rear.stl",convexity=20); // gnss_column_2
translate(out_of_case ? [230,0,0] : [0,0,0]) color("Orange",1) translate([135, 219, 18.8]) import("../../parts/parent/interior/printed/gnss_universal_carrier/gnss_column_rear.stl",convexity=20); // gnss_column_3
translate(out_of_case ? [230,0,0] : [0,0,0]) color("Orange",1) translate([60, 60, 18.8]) import("../../parts/parent/interior/printed/ann_mb1_internal_rack/ann_mb1_internal_rack.stl",convexity=20); // antenna_rack
translate(out_of_case ? [230,0,0] : [0,0,0]) color("Orange",1) translate([60, 60, 18.8]) import("../../parts/parent/interior/printed/ann_mb1_internal_rack/ann_mb1_coax_ring.stl",convexity=20); // coax_ring
translate(out_of_case ? [230,0,0] : [0,0,0]) color("Silver",1) translate([60, 60, 63.6]) import("../../parts/parent/interior/cots/ann_mb1/ground_plate_internal.stl",convexity=20); // antenna_ground_plate
translate(out_of_case ? [230,0,0] : [0,0,0]) color("DimGray",1) translate([60, 60, 64.6]) rotate([0, 0, 90]) import("../../parts/parent/interior/cots/ann_mb1/ann_mb1.stl",convexity=20); // gnss_antenna
translate(out_of_case ? [230,0,0] : [0,0,0]) color("Purple",0.2) translate([60, 60, 18.8]) import("../../parts/parent/interior/cots/ann_mb1/coax_coil_keepout.stl",convexity=20); // coax_coil_keepout
translate(out_of_case ? [230,0,0] : [0,0,0]) color("Black",1)  import("../../parts/parent/interior/cots/ann_mb1/coax_route.stl",convexity=20); // gnss_coax_route
translate(out_of_case ? [230,0,0] : [0,0,0]) color("MediumSeaGreen",1) translate([62.78, 195, 56]) rotate([0, 0, 90]) import("../../parts/parent/interior/cots/adafruit_lis3mdl/adafruit_lis3mdl.stl",convexity=20); // magnetometer
translate(out_of_case ? [230,0,0] : [0,0,0]) color("Ivory",1) translate([47.54, 197.54, 57.57]) import("../../parts/parent/interior/cots/adafruit_lis3mdl/nylon_m2x8_envelope.stl",convexity=20); // mag_bolt_0
translate(out_of_case ? [230,0,0] : [0,0,0]) color("Ivory",1) translate([47.54, 197.54, 49.9]) import("../../parts/parent/interior/cots/adafruit_lis3mdl/nylon_nut_m2_envelope.stl",convexity=20); // mag_nut_0
translate(out_of_case ? [230,0,0] : [0,0,0]) color("Ivory",1) translate([47.54, 217.86, 57.57]) import("../../parts/parent/interior/cots/adafruit_lis3mdl/nylon_m2x8_envelope.stl",convexity=20); // mag_bolt_1
translate(out_of_case ? [230,0,0] : [0,0,0]) color("Ivory",1) translate([47.54, 217.86, 49.9]) import("../../parts/parent/interior/cots/adafruit_lis3mdl/nylon_nut_m2_envelope.stl",convexity=20); // mag_nut_1
translate(out_of_case ? [230,0,0] : [0,0,0]) color("Ivory",1) translate([60.24, 197.54, 57.57]) import("../../parts/parent/interior/cots/adafruit_lis3mdl/nylon_m2x8_envelope.stl",convexity=20); // mag_bolt_2
translate(out_of_case ? [230,0,0] : [0,0,0]) color("Ivory",1) translate([60.24, 197.54, 49.9]) import("../../parts/parent/interior/cots/adafruit_lis3mdl/nylon_nut_m2_envelope.stl",convexity=20); // mag_nut_2
translate(out_of_case ? [230,0,0] : [0,0,0]) color("Ivory",1) translate([60.24, 217.86, 57.57]) import("../../parts/parent/interior/cots/adafruit_lis3mdl/nylon_m2x8_envelope.stl",convexity=20); // mag_bolt_3
translate(out_of_case ? [230,0,0] : [0,0,0]) color("Ivory",1) translate([60.24, 217.86, 49.9]) import("../../parts/parent/interior/cots/adafruit_lis3mdl/nylon_nut_m2_envelope.stl",convexity=20); // mag_nut_3
translate(out_of_case ? [230,0,0] : [0,0,0]) color("Silver",1) translate([20, 38.5, 64.6]) import("../../parts/common/interior/cots/screw/screw_m3x6.stl",convexity=20); // ground_plate_mount_0
translate(out_of_case ? [230,0,0] : [0,0,0]) color("Silver",1) translate([20, 38.5, 61.2]) import("../../parts/common/interior/cots/screw/screw_nut_m3.stl",convexity=20); // ground_plate_nut_0
translate(out_of_case ? [230,0,0] : [0,0,0]) color("Silver",1) translate([100, 35, 64.6]) import("../../parts/common/interior/cots/screw/screw_m3x6.stl",convexity=20); // ground_plate_mount_1
translate(out_of_case ? [230,0,0] : [0,0,0]) color("Silver",1) translate([100, 35, 61.2]) import("../../parts/common/interior/cots/screw/screw_nut_m3.stl",convexity=20); // ground_plate_nut_1
translate(out_of_case ? [230,0,0] : [0,0,0]) color("Silver",1) translate([20, 85, 64.6]) import("../../parts/common/interior/cots/screw/screw_m3x6.stl",convexity=20); // ground_plate_mount_2
translate(out_of_case ? [230,0,0] : [0,0,0]) color("Silver",1) translate([20, 85, 61.2]) import("../../parts/common/interior/cots/screw/screw_nut_m3.stl",convexity=20); // ground_plate_nut_2
translate(out_of_case ? [230,0,0] : [0,0,0]) color("Silver",1) translate([100, 75, 64.6]) import("../../parts/common/interior/cots/screw/screw_m3x6.stl",convexity=20); // ground_plate_mount_3
translate(out_of_case ? [230,0,0] : [0,0,0]) color("Silver",1) translate([100, 75, 61.2]) import("../../parts/common/interior/cots/screw/screw_nut_m3.stl",convexity=20); // ground_plate_nut_3
translate(out_of_case ? [230,0,0] : [0,0,0]) color("Silver",1) translate([26, 60, 70.6]) import("../../parts/common/interior/cots/screw/screw_m4x12.stl",convexity=20); // antenna_mount_0
translate(out_of_case ? [230,0,0] : [0,0,0]) color("Silver",1) translate([26, 60, 60.4]) import("../../parts/common/interior/cots/screw/screw_nut_m4.stl",convexity=20); // antenna_nut_0
translate(out_of_case ? [230,0,0] : [0,0,0]) color("Silver",1) translate([94, 60, 70.6]) import("../../parts/common/interior/cots/screw/screw_m4x12.stl",convexity=20); // antenna_mount_1
translate(out_of_case ? [230,0,0] : [0,0,0]) color("Silver",1) translate([94, 60, 60.4]) import("../../parts/common/interior/cots/screw/screw_nut_m4.stl",convexity=20); // antenna_nut_1
if(show_tx_keepout && !out_of_case) color("Cyan",0.15)  import("../../parts/parent/interior/printed/parent_hand_service/tx_top_keepout.stl",convexity=20); // tx_top_keepout
translate(out_of_case ? [230,0,0] : [0,0,0]) color("Silver",1) translate([71.5, 141.5, 57.6]) import("../../parts/common/interior/cots/screw/screw_m3x10.stl",convexity=20); // gnss_pcb_bolt_0
translate(out_of_case ? [230,0,0] : [0,0,0]) color("Silver",1) translate([71.5, 141.5, 47.6]) import("../../parts/common/interior/cots/screw/screw_nut_m3.stl",convexity=20); // gnss_pcb_nut_0
translate(out_of_case ? [230,0,0] : [0,0,0]) color("Silver",1) translate([126.5, 141.5, 57.6]) import("../../parts/common/interior/cots/screw/screw_m3x10.stl",convexity=20); // gnss_pcb_bolt_1
translate(out_of_case ? [230,0,0] : [0,0,0]) color("Silver",1) translate([126.5, 141.5, 47.6]) import("../../parts/common/interior/cots/screw/screw_nut_m3.stl",convexity=20); // gnss_pcb_nut_1
translate(out_of_case ? [230,0,0] : [0,0,0]) color("Silver",1) translate([71.5, 216.5, 57.6]) import("../../parts/common/interior/cots/screw/screw_m3x10.stl",convexity=20); // gnss_pcb_bolt_2
translate(out_of_case ? [230,0,0] : [0,0,0]) color("Silver",1) translate([71.5, 216.5, 47.6]) import("../../parts/common/interior/cots/screw/screw_nut_m3.stl",convexity=20); // gnss_pcb_nut_2
translate(out_of_case ? [230,0,0] : [0,0,0]) color("Silver",1) translate([126.5, 216.5, 57.6]) import("../../parts/common/interior/cots/screw/screw_m3x10.stl",convexity=20); // gnss_pcb_bolt_3
translate(out_of_case ? [230,0,0] : [0,0,0]) color("Silver",1) translate([126.5, 216.5, 47.6]) import("../../parts/common/interior/cots/screw/screw_nut_m3.stl",convexity=20); // gnss_pcb_nut_3
