AquaBeacon/mechanical/assemblies/parent_service_review/service_view.scad

// Green = card/USB swept space and finger approach. Lid intentionally absent.
include <parent_service_review_view.scad>
color([0.05,0.8,0.65,.35]) import("service_volumes.stl");
