AquaBeacon/mechanical/assemblies/parent_spar_bolted/parent_spar_bolted_view.scad

// =====================================================================
// parent_spar_bolted_view.scad
// !! 自動生成ファイル - 編集しないこと。placement.json を直して
//    build.ps1 -Assemblies で再生成する。
// 2026-09-10 screw-fastened modular parent. Reference case/lid envelopes are not manufacturing models.
// 座標系: mm; float lower face Z=0; box bottom Z=460; +Y camera direction.
// =====================================================================

show_exterior = true;
show_interior = false;
show_vessel = true;
show_reference = true;
show_envelope = true;
show_hardware = true;

if (show_exterior) color("Orange") translate([0, 0, -300])  import("../../parts/parent/exterior/printed/parent_spar_disk/parent_spar_disk.stl");
if (show_exterior) color("Gold") translate([30, -2, -295]) rotate([0, 0, 0])  import("../../parts/parent/exterior/printed/parent_spar_fin/parent_spar_fin.stl");
if (show_exterior) color("Gold") translate([2, 30, -295]) rotate([0, 0, 90])  import("../../parts/parent/exterior/printed/parent_spar_fin/parent_spar_fin.stl");
if (show_exterior) color("Gold") translate([-30, 2, -295]) rotate([0, 0, 180])  import("../../parts/parent/exterior/printed/parent_spar_fin/parent_spar_fin.stl");
if (show_exterior) color("Gold") translate([-2, -30, -295]) rotate([0, 0, 270])  import("../../parts/parent/exterior/printed/parent_spar_fin/parent_spar_fin.stl");
if (show_exterior) color("DarkOrange") translate([0, 0, -295])  import("../../parts/parent/exterior/printed/parent_spar_hub/parent_spar_hub.stl");
if (show_exterior) color("DarkOrange") translate([0, 0, -202])  import("../../parts/parent/exterior/printed/parent_spar_hub/parent_spar_hub.stl");
if (show_exterior) color("DarkSlateGray") translate([0, 0, -295])  import("../../parts/parent/exterior/printed/parent_spar_beam_lower/parent_spar_beam_lower.stl");
if (show_exterior) color("DarkSlateGray") translate([0, 0, -115])  import("../../parts/parent/exterior/printed/parent_spar_beam_upper/parent_spar_beam_upper.stl");
if (show_exterior) color("DarkOrange") translate([0, 0, -147])  import("../../parts/parent/exterior/printed/parent_spar_coupler_half/parent_spar_coupler_half.stl");
if (show_exterior) color("DarkOrange") translate([0, 0, -147]) mirror([0, 1, 0])  import("../../parts/parent/exterior/printed/parent_spar_coupler_half/parent_spar_coupler_half.stl");
if (show_exterior) color("DarkOrange") translate([0, 0, -8])  import("../../parts/parent/exterior/printed/parent_spar_float_bottom/parent_spar_float_bottom.stl");
if (show_exterior) color("LightSkyBlue") translate([0, 0, 0])  import("../../parts/parent/exterior/printed/parent_spar_float_body/parent_spar_float_body.stl");
if (show_exterior) color("SkyBlue") translate([0, 0, 180])  import("../../parts/parent/exterior/printed/parent_spar_float_lid/parent_spar_float_lid.stl");
if (show_exterior) color("LightSkyBlue") translate([0, 0, 186])  import("../../parts/parent/exterior/printed/parent_spar_float_body/parent_spar_float_body.stl");
if (show_exterior) color("SkyBlue") translate([0, 0, 366])  import("../../parts/parent/exterior/printed/parent_spar_float_lid/parent_spar_float_lid.stl");
if (show_exterior) color("DarkOrange") translate([0, 0, 372])  import("../../parts/parent/exterior/printed/parent_spar_float_top/parent_spar_float_top.stl");
if (show_exterior) color("SlateGray") translate([0, 0, -300]) rotate([180, 0, 0])  import("../../parts/parent/exterior/printed/parent_spar_ballast_body/parent_spar_ballast_body.stl");
if (show_exterior) color("SlateGray") translate([0, 0, -357])  import("../../parts/parent/exterior/printed/parent_spar_ballast_lid/parent_spar_ballast_lid.stl");
if (show_exterior) color("DarkOrange") translate([0, 0, 322])  import("../../parts/parent/exterior/printed/parent_spar_camera_bridge/parent_spar_camera_bridge.stl");
if (show_exterior) color("DarkOrange") translate([108, 70, 410])  import("../../parts/parent/exterior/printed/parent_spar_gps_bridge/parent_spar_gps_bridge.stl");
if (show_exterior) color("DarkOrange") translate([0, 0, 460])  import("../../parts/parent/exterior/printed/parent_deck/parent_deck.stl");
if (show_exterior) color("SteelBlue") translate([0, 190, 330])  import("../../parts/child/exterior/printed/dji_osmo_action6_mount/dji_osmo_action6_mount.stl");
// 南壁 x=120 (デッキ X=+15), z=65。C1 テザー。頭は箱外 y=-137..-115 (デッキ南縁 -118 の外)
if (show_vessel) color("Silver", 1) translate([0, 0, 460]) translate([15, -115, 65]) rotate([-90, 0, 0])  import("../../parts/common/exterior/cots/wetlink_penetrator_m10/wetlink_penetrator_m10_ref_bcas.stl");
// 南壁 x=85 (デッキ X=-20), z=65。C3 TD04A → 南縁切欠き (X -30..25) → キール南端フェアリード → 南座のソケットへ
if (show_vessel) color("Silver", 1) translate([0, 0, 460]) translate([-20, -115, 65]) rotate([-90, 0, 0])  import("../../parts/common/exterior/cots/wetlink_penetrator_m10/wetlink_penetrator_m10_ref_bcas.stl");
// p1 と同一 (箱 (15.5,103.5,24.8))
if (show_interior) color("SteelBlue", 1) translate([0, 0, 460]) translate([-89.5, -11.5, 24.8])  import("../../parts/parent/interior/pcb/parent_main/parent_main.stl");
// p1 と同一 (箱 (15.5,192.5,24.8))
if (show_interior) color("MediumSeaGreen", 1) translate([0, 0, 460]) translate([-89.5, 77.5, 24.8])  import("../../parts/parent/interior/pcb/parent_pwr/parent_pwr.stl");
// p1 と同一 (箱 (134.5,94.5,24.8) rot 90)
if (show_interior) color("Gold", 1) translate([0, 0, 460]) translate([29.5, -20.5, 24.8]) rotate([0, 0, 90])  import("../../parts/parent/interior/pcb/tx_improved/tx_improved.stl");
// p1 と同一 (箱 (188,15.5,24.8) rot 90)
if (show_interior) color("SandyBrown", 1) translate([0, 0, 460]) translate([83, -99.5, 24.8]) rotate([0, 0, 90])  import("../../parts/parent/interior/cots/spresense_logger/spresense_logger.stl");
// p1 と同一 (箱 (122.5,68,54.4) rot 180)
if (show_interior) color("IndianRed", 1) translate([0, 0, 460]) translate([17.5, -47, 54.4]) rotate([0, 0, 180])  import("../../parts/common/interior/cots/lipo_3s_2200_zeee/lipo_3s_2200_zeee_pack.stl");
// p1 と同一
if (show_interior) color("Goldenrod", 1) translate([0, 0, 460]) translate([-85, -91.5, 26.4])  import("../../parts/common/interior/cots/hex_spacer/hex_spacer_m3_mf25.stl");
// p1 と同一
if (show_interior) color("Goldenrod", 1) translate([0, 0, 460]) translate([18, -91.5, 26.4])  import("../../parts/common/interior/cots/hex_spacer/hex_spacer_m3_mf25.stl");
// p1 と同一
if (show_interior) color("Goldenrod", 1) translate([0, 0, 460]) translate([-85, -16, 26.4])  import("../../parts/common/interior/cots/hex_spacer/hex_spacer_m3_mf25.stl");
// p1 と同一
if (show_interior) color("Goldenrod", 1) translate([0, 0, 460]) translate([18, -16, 26.4])  import("../../parts/common/interior/cots/hex_spacer/hex_spacer_m3_mf25.stl");
if (show_reference) color("Black") translate([65, 70, 593])  import("../../assemblies/parent_spar_bolted/reference/gps_ann_mb1.stl");
if (show_envelope) color("DimGray") translate([0, 190, 366.5])  import("../../assemblies/parent_spar_bolted/reference/camera_case_envelope.stl");
if (show_envelope) color("LightSteelBlue") translate([-105, -115, 556.3])  import("../../assemblies/parent_spar_bolted/reference/box_lid_envelope.stl");
if (show_reference) color("Gray") translate([0, 0, -336])  import("../../assemblies/parent_spar_bolted/reference/ballast_rings.stl");
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
