AquaBeacon/mechanical/assemblies/README.md

# assemblyと印刷一式

全体モデル・組立説明と、その構成の印刷用partsを同じフォルダにまとめています。`parts/` 内のSTLを、PRINT.mdの個数だけ印刷します。各構成の試作・未検証事項は説明を確認してください。

子機内装は [child_interior](child_interior/README.md)、親機の現行内装は [parent_hand_service](parent_hand_service/README.md)。全体表示は [child_vertical_assembly](child_vertical_assembly/README.md) と [parent_integrated](parent_integrated/README.md) を参照できます。構成ごとに部品の組合せが異なります。

| 構成・説明 | 全体／確認モデル | 印刷一式 | STL種類 / 個数 |
|---|---|---|---|
| [子機・横置き4枚フレーム（X1C PETG嵌合試作）](child_horizontal_plate_frame/README.md) | [child_horizontal_plate_frame.stl](child_horizontal_plate_frame/child_horizontal_plate_frame.stl) | [parts/PRINT.md](child_horizontal_plate_frame/parts/PRINT.md) | 24 / 34 |
| [子機内装・200 mm・PLA Matte根元補強](child_interior/README.md) | [child_interior.step](child_interior/child_interior.step) | [parts/PRINT.md](child_interior/parts/PRINT.md) | 10 / 10 |
| [子機・シンプル筐体](child_simple_assembly/README.md) | [child_simple_assembly.step](child_simple_assembly/child_simple_assembly.step) | [parts/PRINT.md](child_simple_assembly/parts/PRINT.md) | 3 / 3 |
| [子機・シンプル筐体＋ライト](child_simple_light_mount/README.md) | [child_simple_light_mount.step](child_simple_light_mount/child_simple_light_mount.step) | [parts/PRINT.md](child_simple_light_mount/parts/PRINT.md) | 5 / 5 |
| [子機・単眼topopt探索記録](child_single_camera_topopt/README.md) | 説明内のビュー | [parts/PRINT.md](child_single_camera_topopt/parts/PRINT.md) | 探索のみ |
| [子機・縦置き全体（内装を共有）](child_vertical_assembly/README.md) | [child_vertical_assembly.step](child_vertical_assembly/child_vertical_assembly.step) | [parts/PRINT.md](child_vertical_assembly/parts/PRINT.md) | 16 / 17 |
| [dji_style_toggle_latch](dji_style_toggle_latch/README.md) | [dji_style_toggle_latch.step](dji_style_toggle_latch/dji_style_toggle_latch.step) | [parts/PRINT.md](dji_style_toggle_latch/parts/PRINT.md) | 探索のみ |
| [nut_driver_af10](nut_driver_af10/README.md) | 説明内のビュー | [parts/PRINT.md](nut_driver_af10/parts/PRINT.md) | 1 / 1 |
| [over_center_latch](over_center_latch/README.md) | [over_center_latch.step](over_center_latch/over_center_latch.step) | [parts/PRINT.md](over_center_latch/parts/PRINT.md) | 4 / 5 |
| [親機外装・位置決めフレーム](parent_exterior/README.md) | [parent_exterior.step](parent_exterior/parent_exterior.step) | [parts/PRINT.md](parent_exterior/parts/PRINT.md) | 15 / 21 |
| [親機・電源操作対応内装](parent_hand_service/README.md) | [parent_hand_service.step](parent_hand_service/parent_hand_service.step) | [parts/PRINT.md](parent_hand_service/parts/PRINT.md) | 15 / 15 |
| [親機・内外装統合](parent_integrated/README.md) | [parent_integrated.step](parent_integrated/parent_integrated.step) | [parts/PRINT.md](parent_integrated/parts/PRINT.md) | 16 / 16 |
| [親機・P1内装](parent_interior_p1/README.md) | [parent_interior_p1.step](parent_interior_p1/parent_interior_p1.step) | [parts/PRINT.md](parent_interior_p1/parts/PRINT.md) | 2 / 2 |
| [親機・P2内装](parent_interior_p2/README.md) | [parent_interior_p2.step](parent_interior_p2/parent_interior_p2.step) | [parts/PRINT.md](parent_interior_p2/parts/PRINT.md) | 3 / 3 |
| [parent_light](parent_light/README.md) | [parent_light_structure.step](parent_light/parent_light_structure.step) | [parts/PRINT.md](parent_light/parts/PRINT.md) | 5 / 6 |
| [parent_open](parent_open/README.md) | [parent_open_structure.step](parent_open/parent_open_structure.step) | [parts/PRINT.md](parent_open/parts/PRINT.md) | 7 / 10 |
| [parent_rope_float](parent_rope_float/README.md) | [parent_rope_float.step](parent_rope_float/parent_rope_float.step) | [parts/PRINT.md](parent_rope_float/parts/PRINT.md) | 16 / 20 |
| [親機・操作空間の内装レビュー](parent_service_review/README.md) | [parent_service_review.step](parent_service_review/parent_service_review.step) | [parts/PRINT.md](parent_service_review/parts/PRINT.md) | 3 / 3 |
| [parent_simple](parent_simple/README.md) | [parent_simple_view.scad](parent_simple/parent_simple_view.scad) | [parts/PRINT.md](parent_simple/parts/PRINT.md) | 1 / 1 |
| [parent_spar_bolted](parent_spar_bolted/README.md) | [parent_spar_bolted.step](parent_spar_bolted/parent_spar_bolted.step) | [parts/PRINT.md](parent_spar_bolted/parts/PRINT.md) | 19 / 25 |
| [親機・旧縦長外装の配置検討](parent_spar_concept/README.md) | [parent_spar_concept.scad](parent_spar_concept/parent_spar_concept.scad) | [parts/PRINT.md](parent_spar_concept/parts/PRINT.md) | 6 / 10 |
| [quick_release_trials](quick_release_trials/README.md) | [quick_release_trials.step](quick_release_trials/quick_release_trials.step) | [parts/PRINT.md](quick_release_trials/parts/PRINT.md) | 9 / 9 |
| [td04a_fixture](td04a_fixture/README.md) | [td04a_fixture.step](td04a_fixture/td04a_fixture.step) | [parts/PRINT.md](td04a_fixture/parts/PRINT.md) | 2 / 2 |
| [テザーリール・開放状態](tether_open_reel/README.md) | [tether_open_reel.step](tether_open_reel/tether_open_reel.step) | [parts/PRINT.md](tether_open_reel/parts/PRINT.md) | 3 / 3 |
| [テザーリール・カバー装着状態](tether_open_reel_closed/README.md) | [tether_open_reel_closed.step](tether_open_reel_closed/tether_open_reel_closed.step) | [parts/PRINT.md](tether_open_reel_closed/parts/PRINT.md) | 5 / 9 |

印刷セットの原本は共通の `../parts/` 等にあります。設計のコピーは増やさず、STLだけを同期しています。基板・購入品・金属部品・フォーム・配線モデルは印刷セットから除外しています。
