AquaBeacon/mechanical/assemblies/child_simple_light_mount/README.md

**印刷一式:** [parts/PRINT.md](parts/PRINT.md)（STL・数量・モディファイア） · **確認画像:** [_work/images/](_work/images/)

# 水中ライトマウントの取付確認

子機シンプル筐体r3の背面中央、M3・40×40 mmに二分割ライトホルダーを追加。
ライトホルダーはr2（サポート削減・控えめな肉抜き）。取付穴位置・保持径・保持長は従来どおり。
[組立STEP](child_simple_light_mount.step) / [部品説明・検証範囲](../../parts/child/exterior/printed/child_simple_light_mount/child_simple_light_mount.md)。

元の子機組立から別アセンブリとして作成。配置正本は `placement.json`。
ライト実物、M3ボルト・ワッシャ・ナット、落下防止コード、実配線は未収録。
CAD検査はマウント本体・押さえ・rearの干渉と工具空間に限定。全備状態の干渉・強度合格ではない。
組立STEPは10部品で出力し、配置照合は0 NG。
