AquaBeacon/mechanical/assemblies/child_single_camera_topopt/README.md

**印刷一式:** [parts/PRINT.md](parts/PRINT.md)（STL・数量・モディファイア） · **確認画像:** [_work/images/](_work/images/)

# 子機外装：単眼カメラ・縦向きライトのtopopt

更新：2026-09-10T19:13:25+09:00

ユーザーの2026-09-10の指示で最適化実行を承認済み。カメラ1台、右側の縦向きライト1灯に変更。
これは設計候補の探索記録です。完成部品・製造承認ではありません。

追記：[自重の確認記録](gravity_audit.md)。図のG矢印位置は作用点ではありません。探索中に自重が密度変化に追従しない実装を確認しており、その影響は未検証です。

| 部品 | 状態 | 最低安全率 / p99.5 | 最大変位 mm | 終了理由 |
|---|---|---:|---:|---|
| カメラ取付部（初回3 mm） | 未合格 | 2.82 / 8.04 | 0.789 | max_iterations |
| 可動ゲート（初回3 mm） | 未合格 | 0.17 / 0.40 | 33.486 | max_iterations |
| コアフレーム（初回3 mm） | 未合格 | 1.12 / 2.27 | 3.934 | max_iterations |
| カメラ取付部（2 mm再計算） | 未合格 | 6.33 / 29.25 | 0.141 | max_iterations |

## 配置・除外領域・荷重

- [setupの3D図と全17荷重ケース](review.html) / [最適化結果の画像](results.html)
- カメラは中央前方に1台。取付柱との干渉を避けて従来より前へ9 mm。レンズ中心 (0,129,125) mm。
- ライトは右側、長軸をZ方向。仮寸法 Ø40 × 100 mm、中心軸 (80,-75)、高さ50〜150 mm。実物の光の出射方向は未確認。
- 配線はØ6 mm＋周囲1 mmの予約空間。耐圧容器、カメラ・視野、ライト、TD04A・取付部、配線、手の進入空間を除外。設計空間外の機器も配置図に表示。
- 持ち手の握り部を保持し、持上げ+200 Nのケースを追加。ライトの自重9 Nと偏心モーメント324 Nmm、TD04Aの取付部荷重9.4 Nを考慮。これらは仮の質量・3g条件。
- 荷重図は36本の入力荷重矢印と3本の自重矢印。別々の荷重ケースであり、全矢印を同時に適用しません。
- 手と配線の重なりは1 mmボクセルで0。詳細は [幾何・矢印チェック](review_checks.json)。実物のケーブル曲げ半径と組立・工具の確認は残っています。

## 実行条件と判定の範囲

初回はPETG、要求安全率3、3 mmボクセル、80反復、quick探索。ゲート・コアの薄い6 mm部分は2要素しかなく、メッシュ精度の合格条件を満たしません。
カメラ取付部の再計算は同じ荷重・要求安全率で2 mm、フィルタ6 mm、自由領域の体積率0.30、160反復。setupの実測見積りは約39分（19〜58分）。初回3部品の後に順次実行します。

最低安全率とp99.5の両方を記録します。p99.5だけで合格としません。最大反復到達は収束ではありません。
今回のquick出力は材料配置であり、ねじ穴等を持つ最終パラメトリックCADではありません。CalculiX独立再解析、メッシュ収束、実際の造形・締結・引抜き検証は未実施です。
取付位置・保持領域の多くは既存CADから与えた入力であり、全形状を最適化が自動決定したわけではありません。

実行状態： [初回キュー](exploration_status.json) / [再計算](refinement_status.json)。結果ページはローカル集計プログラムが更新します。既存の製造用部品は置き換えていません。
