AquaBeacon/mechanical/assemblies/parent_interior_p1/README.md

**印刷一式:** [parts/PRINT.md](parts/PRINT.md)（STL・数量・モディファイア） · **確認画像:** [_work/images/](_work/images/)

# parent_interior_p1

- [parent_interior_p1.md](parent_interior_p1.md)
- [parent_interior_p1.step](parent_interior_p1.step)
- [parent_interior_p1.stl](parent_interior_p1.stl)
- [parent_interior_p1_interior.stl](parent_interior_p1_interior.stl)
- [parent_interior_p1_view.scad](parent_interior_p1_view.scad)

構成と既存の未検証事項は上の設計説明を参照してください。
