AquaBeacon/mechanical/assemblies/over_center_latch/print_jobs/README.md

# 保存済みスライス設定

`over_center_latch_bail.3mf` は既存の2026-10-05 19:27保存ファイルを、規約に従ってparts/から移動した履歴資料。今回再生成した4部品の印刷一式ではない。対応STLのハッシュおよび材料・設定の適合は未検証。現行印刷入口は ../parts/PRINT.md。

3MF SHA-256: `a88ee4631b3e5665ec3d946f258c65c9c2c353623dc9edba3472ac35eed46039`
