AquaBeacon/mechanical/assemblies/child_horizontal_plate_frame/print_jobs/camera_fixture_clamp_20261029/README.md

# カメラ治具 2026-10-29 スライス記録

現行の印刷入口は [../../parts/PRINT.md](../../parts/PRINT.md)。各3MFは1個入り。スペーサは各機2個必要。既存フレーム・ガード・ライト・前側押さえの再印刷は不要。

X1C・0.4 mm・Generic PETG・0.1 mm・6壁・15% Gyroid・自動支持。実物嵌合と保持力は未認定。

| 形状 | 1個の予測時間 | 1個の質量 | 3MF |
|---|---:|---:|---|
| child_horizontal_twist_mount_camera_receiver | 1時間44分 | 31.7 g | [child_horizontal_twist_mount_camera_receiver](child_horizontal_twist_mount_camera_receiver/child_horizontal_twist_mount_camera_receiver.3mf) |

共通カメラ本体とスペーサの3MF検証記録は[親機側](../../../parent_exterior/print_jobs/camera_fixture_clamp_20261029/README.md)。この子機のparts/内には必要STLをすべて実体で収録している。

各validation.jsonに元STLと3MFのSHA-256、材料・条件・警告の有無を記録。確認用のplaced.stlはスライス入力履歴であり設計正本ではない。
