AquaBeacon/mechanical/assemblies/parent_exterior/print_jobs/camera_bottom_clearance_20261024/README.md

# カメラ底面受け・背面20 mm退避版

親機・子機共通のcamera_mount_twistを1個含む。両機用なら2個印刷する。0.1 mm層、Generic PETG、6壁、15% Gyroid、5 mmブリム、ベッドからの自動サポート。底板を下にする。外部C軸・背板側のサポートを除去する。

スライス警告なし。1個約5時間12分・103.7 g。保存3MFとSTLのハッシュ・設定・ベッド範囲はcamera_mount_twist/validation.json。実物のヒンジ・底面との接触、M5締付け、回転保持力は未検証。旧camera_twist_20261021の3MFは今回の印刷には使用しない。

元STL SHA-256: 8f7caa8165ad9ba75be9d155de0564b5138e822a78c9a97f6f3342c16540abc1
