AquaBeacon/mechanical/assemblies/parent_exterior/print_jobs/camera_clamp_clearance_20261026/README.md

# 中央固定爪との重なりを解消：右へ12 mm

親機・子機共通、各機本体と前側押さえを各1個。印刷入口は各assemblyのparts/PRINT.md。
X1C / 0.4 mm / Generic PETG / 0.1 mm層 / 6壁 / 15% Gyroid / brim 5 mm / ベッドからの自動支持。

| 部品 | 個数/機 | 推定時間 | 推定材料 | 元STL SHA-256 |
|---|---:|---:|---:|---|
| camera_mount_twist | 1 | 5.34 h | 101.8 g | a5c6b3e83a21993364093b024c2cd7228d8b691ff879919f0966b14087db163a |
| camera_front_clamp | 1 | 2.25 h | 13.8 g | 0c8fa79eb1c4ebb21f584d96e1d0de4180e128780d3566eaa7b2c7a63de42ffb |

元位置から正面右へ12 mm移動（20 mm版から8 mm戻す）。中央固定爪と公称2.85 mm離し、足の切欠きを廃止。幅25 mm、挟み幅41 mm、R1外縁・R3根元を維持。本体・押さえとも本ジョブを使用し、旧位置版と混用しない。本体のC部・下面座ぐり、前側足とナット座の支持材を除去する。支持区間は本体188・前側22。ナットの着座と工具挿入を確認する。実物の嵌合・保持力・強度は未検証。
