AquaBeacon/mechanical/assemblies/parent_exterior/print_jobs/camera_clamp_right20_20261026/README.md

# 押さえを正面から右へ20 mm移動 2026-10-26

親機・子機共通。各機につき本体と前側押さえを各1個。印刷入口は各assemblyのparts/PRINT.md。
X1C / 0.4 mm / Generic PETG / 0.1 mm層 / 6壁 / 15% Gyroid / brim 5 mm / ベッドからの自動支持。

| 部品 | 個数/機 | 推定時間 | 推定材料 | 元STL SHA-256 |
|---|---:|---:|---:|---|
| camera_mount_twist | 1 | 5.34 h | 101.9 g | 941536bbe13fb2ffa5184f0593106d799a32d4bc82d214a8909cb9a8e0a475e9 |
| camera_front_clamp | 1 | 2.24 h | 13.6 g | 14581992caf844bd54b3e344bd42f0a00921385508afcb438d4ccb8c19d74b56 |

取付穴と押さえをローカルX=-20 mm移動。押さえ幅25 mm、前後間隔41 mmを維持。M5爪の逃げを足に追加（R0.3、入口0.25 mm面取り）。本体・押さえとも旧版との混用不可。本体のC部・下面座ぐり、押さえの足・ナット座の支持材を除去して組む。支持区間は本体187、押さえ22。ナット着座・工具挿入を確認する。
形状とスライスは検査済み。実ケースの幅・高さ・M5軸位置は仮値を含み、実物の嵌合・回転保持力・強度は未検証。旧ジョブは履歴として保持。
