AquaBeacon/mechanical/assemblies/parent_exterior/print_jobs/camera_fixture_clamp_20261029/README.md

# カメラ治具 2026-10-29 スライス記録

現行の印刷入口は [../../parts/PRINT.md](../../parts/PRINT.md)。各3MFは1個入り。スペーサは各機2個必要。既存フレーム・ガード・ライト・前側押さえの再印刷は不要。

X1C・0.4 mm・Generic PETG・0.1 mm・6壁・15% Gyroid・自動支持。実物嵌合と保持力は未認定。

| 形状 | 1個の予測時間 | 1個の質量 | 3MF |
|---|---:|---:|---|
| camera_mount_twist | 5時間34分 | 110.2 g | [camera_mount_twist](camera_mount_twist/camera_mount_twist.3mf) |
| camera_rotary_spacer | 0時間29分 | 1.8 g | [camera_rotary_spacer](camera_rotary_spacer/camera_rotary_spacer.3mf) |
| parent_oneplate_camera_qr_female | 2時間13分 | 40.6 g | [parent_oneplate_camera_qr_female](parent_oneplate_camera_qr_female/parent_oneplate_camera_qr_female.3mf) |

各validation.jsonに元STLと3MFのSHA-256、材料・条件・警告の有無を記録。確認用のplaced.stlはスライス入力履歴であり設計正本ではない。
