AquaBeacon/mechanical/assemblies/parent_exterior/print_jobs/camera_left_clamp_20261025/README.md

# 左25 mmカメラ前後押さえ：印刷ジョブ

親機・子機共通。1台分は本体と前側押さえの各1個。両機分なら各2個。各サブフォルダに1部品入り3MFを保存する。日常のSTL入口は各assemblyのparts/PRINT.md。

X1C・0.4 mm・Generic PETG・0.1 mm層・6壁・15% Gyroid・5 mmブリム、底面を下、自動サポートはベッドから。2ジョブとも警告なし、元STLハッシュ一致、実経路ベッド範囲内。本体に支持材あり、前側押さえは自動支持を有効にした今回のスライスで支持経路0。代表層の外周・長穴・橋・支持経路を確認。全層の実印刷品質を保証しない。

| 部品 | 1台の個数 | 見積時間 | 見積材料 | STL SHA-256 |
|---|---:|---:|---:|---|
| camera_mount_twist | 1 | 5時間46分 | 111.2 g | a2db288ae9d33a6f3c988c287af74b551e6dee10ff7395fb6c478d3d4756b242 |
| camera_front_clamp | 1 | 2時間14分 | 13.6 g | 71e83cb88f86c4bef283899652365368baa18d1f54c774940c51a7351de1d4c9 |

追加締結材：M4×16ソケット2本、M4ナット2個、外径9×厚0.8ワッシャ2枚／台。下面からナットを入れ、ケースに前側押さえを当ててからねじで長穴位置を固定する。ケース厚さ41 mmは実測、幅・高さ・取付軸位置は既存仮値。実物の嵌合・回転保持・濡れた状態の滑り・クリープは未検証。旧版カメラ3MFを混用しない。
