AquaBeacon/mechanical/assemblies/parent_exterior/print_jobs/camera_left_clamp_flush_20261025/README.md

# カメラ左側クランプ：背面パッド撤去版 2026-10-25

親機・子機共通。各機につき下記各1個。印刷入口は各assemblyのparts/PRINT.md。
X1C / 0.4 mm / Generic PETG / 0.1 mm層 / 6壁 / 15% gyroid / brim 5 mm / ベッドからの自動支持。

| 部品 | 個数/機 | 推定時間 | 推定材料 | 元STL SHA-256 |
|---|---:|---:|---:|---|
| camera_mount_twist | 1 | 5.35 h | 102.0 g | f832b881440ef01ef7acdf86e9971b72bfe490f993a6e0ba5d5a8adb89c3ccea |
| camera_front_clamp | 1 | 2.25 h | 13.8 g | b3983550a4a60ae5d7d2f098f389ab3f27b4100a8dc6bb4e624f930f6b179503 |

各サブフォルダの3MFとvalidation.jsonを使用する。本体のC部・下面座ぐり、前側押さえの足・ナット座付近の支持材を除去する。前側押さえの支持は印刷Z0.2〜5.9 mm。ナット座面とねじ頭座面を傷つけず、ナット挿入・着座を確認する。
旧inward版・初期クランプ版の3MFは使用しない。
背板の追加パッドは撤去済み。背面接触Y=-23.45、前面Y=17.55、間隔41 mm。左25 mmの前側押さえに対し背板との重なりは19.5 mm。M5軸とケースの実測位置関係は未確認。実物の嵌合・保持力・強度は未検証。
