AquaBeacon/mechanical/assemblies/parent_exterior/print_jobs/camera_left_clamp_inward_20261025/README.md

# カメラ内向きL字・底面受け撤去版

親機・子機共通。1台分は本体と前側押さえの各1個。両機分なら各2個。サブフォルダに各1部品入り3MF。STLの入口は各assemblyのparts/PRINT.md。

前方端を16 mm短縮、左右の旧底面受けを撤去。R1外縁・R3根元は維持。M4×16ソケット2本、M4ナット2個、外径9×厚0.8ワッシャ2枚を流用する。ナットは足の上から挿入、ねじとワッシャは本体下面から入れる。ねじ頭は本体に収納される。座ぐり内の支持材を確実に除去してから締結する。

X1C・0.4 mm・Generic PETG・0.1 mm層・6壁・15% Gyroid・5 mmブリム、底面を下、自動支持はベッドから。2ジョブとも警告なし、STLハッシュ一致、実経路ベッド範囲内。本体は支持あり、前側押さえは自動支持有効で支持経路0。代表層の外周・長穴・座ぐり支持・橋の経路を確認。

| 部品 | 1台の個数 | 見積時間 | 見積材料 | STL SHA-256 |
|---|---:|---:|---:|---|
| camera_mount_twist | 1 | 5時間27分 | 104.2 g | 5688c2a758eddaeb04b2bf91b21a4224c77061a54918deafcf3968f56574a412 |
| camera_front_clamp | 1 | 2時間14分 | 13.5 g | ff1245400b6690aea2de5c421740dff07e413ac2386eda5bd4d924c264ae209d |

厚さ41 mmは実測。幅・高さ・M5軸位置は仮値。新形状の実物回転保持・濡れた状態の滑り・強度・クリープは未検証。旧外向きL字や底面受け付きの3MFを使わない。parts内にあったユーザー保存の旧外向きL字3MFは、内容を変えずprint_jobs/history/user_saved_outward_L_20261025へ保存し、SHA-256と移動記録を添えた。
