AquaBeacon/mechanical/assemblies/parent_exterior/print_jobs/camera_twist_20261021/README.md

# 一体Cカメラ・1個の印刷ジョブ

[camera_mount_twist.3mf](camera_mount_twist/camera_mount_twist.3mf)は1個入り。親機用と子機用を別々に装着する場合は2個必要。X1C・0.4 mm・Generic PETG、0.1 mm、6壁、15% Gyroid、5 mmブリム、45°自動支持・ベッドからのみ。約5時間18分・106.0 g。背面接続板・軸・爪の外部支持を除去してから実嵌合を確認する。設定・元STL・3MFのハッシュとベッド内の実G-code範囲は[検査記録](camera_mount_twist/validation.json)。全体の数量は[現行PRINT.md](../../parts/PRINT.md)。実印刷・保持力は未検証。

現行は外側の○△○前壁なし・88×61.45×84.5 mmの小型版。親機の別体角度ストップと関連ネジは使わない。変更前の3MFは../history/camera_with_front_stop_20261021/に保持。
