AquaBeacon/mechanical/assemblies/parent_exterior/print_jobs/printed_upper_and_skids_20261021/README.md

# 印刷済み上側押さえと脚のプロジェクト

2026-10-22にparts/から履歴へ移動。元の3MFを変更せず保持。上側押さえ1個・脚2個を含み、保存メッシュを現行STLと照合して形状一致を確認。ユーザー申告の印刷済み部品を維持するための記録で、今回の下側プレート用ジョブではありません。保存された層厚は0.28 mm。

[保存プロジェクト](parent_oneplate_bar.3mf)／[移動元・SHA-256・形状照合](manifest.json)
