AquaBeacon/mechanical/assemblies/parent_exterior/print_jobs/x1c_petg_rev6/README.md

> 2026-10-21更新：この6プレートは変更前の履歴です。現行はCオス一体camera_mount_twistで、旧03カメラと02の別体オスを使いません。現行一式は[parts/PRINT.md](../../parts/PRINT.md)を参照してください。

# parent_exterior Rev.6 印刷用3MF

2026-10-20。印刷一式の入口は[parts/PRINT.md](../../parts/PRINT.md)。
**下の6ファイルを各1回ずつ印刷すると、11種類・14個が揃います。3MFには必要数を配置済みなので、追加の複製は不要です。**

X1 Carbon・0.4 mmノズル・PETG・Textured PEI Plate用。合計見積りは **1665.5 g・37時間46分**。ブリムを含むスライサー見積りで、実測ではありません。
PETGは合計1.8 kg以上を目安に準備してください。新品1 kgスプールなら2本分です。主プレートには単独で約756 g必要なので、残量800 g以上のスプールを使ってください。

| 順番・3MFを開く | 内容 | 個数 | 見積り材料 | 見積り時間 |
|---|---|---:|---:|---|
| [01_fixtures：小物・TD04A治具](01_fixtures/01_fixtures.3mf) | TD04A支持1、カメラ角度ストップ1、押さえ板1、ノブ1、圧力パッド3 | 7 | 88.4 g | 2時間37分 |
| [02_camera_qr_pair：カメラQR オス・メス](02_camera_qr_pair/02_camera_qr_pair.3mf) | QRメス1・オス1 | 2 | 94.9 g | 3時間41分 |
| [03_camera_mount：カメラマウント](03_camera_mount/03_camera_mount.3mf) | カメラマウント1 | 1 | 107.4 g | 3時間13分 |
| [04_stands_pair：脚2個](04_stands_pair/04_stands_pair.3mf) | 脚2 | 2 | 147.7 g | 3時間30分 |
| [05_main_plate：主プレート](05_main_plate/05_main_plate.3mf) | 主プレート1（一体位置決め部・予備M4穴付き） | 1 | 755.6 g | 15時間49分 |
| [06_upper_clamp：上側押さえ](06_upper_clamp/06_upper_clamp.3mf) | 上側押さえ1 | 1 | 471.5 g | 8時間56分 |

まず01〜03を印刷し、QRの回転・抜去、TD04Aとカメラの取付を実物で確認してから、大きい主プレートと上側押さえへ進めてください。組立寸法・ねじの指定は[assembly README](../../README.md#既存機器の固定組立)を参照してください。

## Bambu Studioでの操作

1. 各3MFを「プロジェクト」として開き、プリンタがX1 Carbon・0.4 mm、プレートがTextured PEI Plateになっていることを確認します。
2. 装填したPETGとフィラメントの割当を合わせます。03はGeneric PETG、他はBambu PETG Basicの既存条件です。別の材料・機種へ変更する場合は、その条件で再スライスしてください。
3. 保存済みの姿勢・配置・倍率を使います。特に05はベッド端に近いため、自動配置やブリム拡大をせず、2 mmブリムを維持してください。
4. プレビューで対象プレートと数量を確認して印刷します。複数部品のプレートは全体を一層ずつ印刷する設定です。冷却後に外し、ブリムを除去してください。

STLから配置し直す場合は[parts/PRINT.md](../../parts/PRINT.md)の表が必要総数です。STLも印刷姿勢を反映済みなので、組立時の回転を重ねないでください。

## 保存条件と確認結果

- 01・04〜06：0.20 mm層、8壁、100%充填。02（QR）：0.10 mm層、8壁、100%充填。03：0.20 mm層、6壁、Gyroid 15%。
- ブリム：01は小物を含め6 mm、05は2 mm、他は3 mm。
- 全6プレートで実G-codeのサポート材押出0。01・05・06は自動支持を有効のまま0。02・03・04は既存の短い橋渡しを使うサポートなし設定です。
- 保存3MF内の閉メッシュ、14個の数量、元STLとの外形・体積、全層の押出経路とX1Cの使用禁止領域を照合済み。実印刷・嵌合・強度は未確認です。

6プレートの配置と最初の層

[検査・元STLと3MFのSHA-256](manifest.json)。G-codeとプリセットは各プレートのフォルダに保存しています。通常は表の3MFを使用してください。
再生成：リポジトリ直下で `python spec/prepare_parent_exterior_print_job.py`。現行の印刷用STLと検証済み単品プロジェクトから配置・スライス・照合を行い、CAD形状は変更しません。
