AquaBeacon/mechanical/assemblies/td04a_fixture/print_jobs/cable_clearance_r6/README.md

# TD04A治具 Rev.6 試作スライス

X1C・PETG Basic・0.4 mmノズル・0.2 mm層・8壁・100%充填・ブリム5 mm。各1個。支持無効の試作データで、実印刷・実物適合・強度を認定しない。自動支持45度・全表面で別途検出し、支持候補がある。最初の印刷で穴屋根と端面を確認する。

[STLのSHA・時間・質量](validation.json) / [設定・G-code監査](../../_work/analysis/slicing/slice_audit.json)。旧Rev.5の3MFは使わない。印刷入口は../../parts/PRINT.md。
