AquaBeacon/mechanical/assemblies/dji_style_toggle_latch/print_jobs/imported_2026-09-28/README.md

# 既存スライサプロジェクトの保管

2026-09-28、元の `../../parts/dji_style_toggle_latch_keeper.3mf` を内容を変えずに移動しました。元パス・移動先・SHA-256は `migration.json` に記録しています。

2026-09-29、印刷一式に残っていた `../../parts/dji_style_toggle_latch_base.3mf` も内容を変えずにこのフォルダへ移動しました。記録は `migration_base.json` を参照してください。旧1.5 mm EPDM版以前に作られたファイルで、現行の1 mm版とのモデル・材料設定の一致は未検証です。

複数の部品を含む既存プロジェクトです。プロジェクトの既定値は層高0.2 mm、壁2周、インフィル15%で、部品別の上書きは別途確認が必要です。今回のEPDM付き留め具とのモデル一致・印刷条件一致は未確認で、現行の印刷一式には含めません。

現行のSTLと条件は [parts/PRINT.md](../../parts/PRINT.md) を使用してください。この3MFは既存の設定・配置を参照するために保存しています。
