AquaBeacon/mechanical/assemblies/parent_hand_service/print_jobs/print_economy_x1c_petg/README.md

# X1C0.4 / Generic PETG印刷削減改訂

実スライス済み12種類。前支柱／後支柱はそれぞれ2回、その他各1回。0.20 mm・4周壁・100%インフィル、3 mmブリム、通常自動支持45°、上下0.2 mm間隔、XY0.35 mm、ブリッジ支持除外。STL原本ハッシュと個数はmanifest.json。各3MFは1種類1個のプレート。配置・印刷姿勢は保持し、自動姿勢変更しない。フィラメントとプリンタを照合して再スライスする場合は支持・ブリッジを再確認。送信・印刷は行っていない。通常の印刷入口は../../parts/PRINT.md。結果と残る局所支持は../../print_economy_report.md。
