AquaBeacon/mechanical/parts/child/exterior/printed/child_exterior_open_frame/README.md

# 子機・横置き外装フレーム

2026-10-07: 設計イメージを基に、既存クランプの24穴へ固定する外装を設計。製作形状は [child_exterior_open_frame.scad](child_exterior_open_frame.scad)、配置・印刷入口は [child_exterior_horizontal](../../../../../assemblies/child_exterior_horizontal/README.md)。状態は **fit_prototype（取付確認用試作）**。完成機の吊り上げ・水中使用を承認した構成ではありません。

外観検討の正本 [concept.json](concept.json)、元の [Blenderイメージ](../../../../../assemblies/child_exterior_concept/README.md)、旧フレームAは保持しています。今回の外装は独立した設計で、既存の最適化クランプ・フレームAの後処理や単純図形への置換ではありません。

## 寸法・取合い

- 容器は4インチ・200 mm、軸+Y、中心[0,0,140] mm。カメラ+Y、振動子・ライト+Z。
- 側板中心X=±150、厚さ12、上端Z225。前後長440、下部レール460、足を含む長さ480。側板は前後に分割、1片約230×215×12 mm、合わせ隙間0.4。
- 下辺・上辺の高さ26、中央の接続帯60 mm。上・中の外側6 mm接合板と中央の足で前後を連結。中段の接合ねじをY=±26へ離し、クランプ接続部とナットを逃がします。クランプ24軸には側板・中央接合板までØ10.5の工具通路を開けます。
- [取合い寸法](spec/clamp_interface.json)は既存SCADのCLAMP_INTERFACE/CAGE_INTERFACEから生成。穴は片側Y=−68/−52/−8/8/52/68、Z=122/158、X=±84.95。クランプ締付耳とは別の4穴面を使います。
- 1 mmの購入ワッシャを挟み、M3×30・OD9×1ワッシャ・M3ナットで24穴を接続。接続部→側板は各2本、中央段M3×25、前後段M3×20。内側のナットを取付前に投入します。ねじ山は印刷しません。
- 288 mm横桟を左右分割し、下部2本とカメラ支持1本。前下部はY=150・底Z12、後下部はY=−207・底Z40として足・おもり受けを回避。末端ナットは上から挿入し、ねじ先端の逃げも備えます。中央接合板はM3×50。後部開口バンパーは左右分割・ボルト着脱式です。
- C受けは上面Z34、1 mmゴムを挟み、4個の端止めと購入ストラップ4本で保持する設計。Bは左右Y=±85へ離し、各2本のストラップでレールへ固定する設計。C=1000 g×2＋B=60 g×4＝2240 gは在庫申告値。
- ライト台は5×24、振動子の橋板は5×30スロット付きの交換台。仮寸法へ固定クランプを作り込みません。カメラ台はケース下に1 mmパッドを想定、固定ねじ頭をケース後方へ逃がします。

## 面仕上げ・印刷

外形R2、開口R4、縁の面取り0.6 mm。ナット投入溝はR0.3・面取り0.3、穴入口0.6、足のナット座の穴入口0.4 mm。共通hole()/teardrop()を使いM3通り寸法3.5 mm。断面を面取り分だけ縮めて外形を戻すため、指定外形を変えません。足の六角座AF5.8の平面と交点は、M3ナットの回り止め機能面として保持します。

PETG Basic、0.4 mmノズル、層高0.20、外周8、100%インフィル、5 mmブリムが暫定条件。平板は平置き、接続部・機器台はY積層にして縦荷重を層内へ向けます。姿勢はmanufacturing.jsonで管理し、配布STLへ反映。横向き通路・ナット投入溝には必要なサポートを付け、完全に除去して実寸確認します。実スライス・サポート除去試験は未実施です。

STEPは完成STLと同じ面取り済みファセット形状。寸法変更はSCADから再生成します。

## 荷重・検証

暫定完成機10 kg、乾燥重量98.0665 N、取り回し3 g相当294.1995 N。6接続部への均等負担は49.03325 N/個。実際の重心と荷重分配を測った値ではありません。横方向±30 N/個を取合い荷重の検討値とし、水中浮力・流れ・テザー・外圧・落下をこの値へまとめません。

理想的な無孔32×14断面・長さ58.05 mm・49.03 Nの一次計算は2.723 MPa・0.255 mm（generic PETG、面内、要求安全率3）。完成品の安全率として使いません。完成接続部のFEAはgeneric PETGの暫定材料カード・理想固定、Y積層、6ケースで実施。2/1/0.5 mmのメッシュ収束はFAIL。最細段階の最大変位約0.224 mm、局所最小安全率約2.03は要求3未達です。[解析判定](../../../../../assemblies/child_exterior_horizontal/_work/analysis/clamp_link_fea/ASSESSMENT.md)を参照し、耐荷重を認定しません。締付・摩擦・クリープ・分割接合・上流クランプは未検証。既存クランプの4 kg吊り下げ不可を引き継ぎます。

## 部品外の考慮・要確認

ライト型番・電源・金具、TD04Aブラケット、カメラ保持具は実寸照合が必要。実ペネトレータ、端末、曲げ半径、余長、張力保持も未確定です。浮力材54×148×34×2は非印刷の予約体積で、選定・保持・必要浮力・重心・浮心は未検証。C端部形状と実ストラップの取合いは仮寸法です。Bの仮穴は使用せず通し溝とストラップで保持します。内装の横置き固定、印刷・静荷重・滑り・クリープ・繰返し着脱が揃うまで完成機の干渉・強度確認は完了扱いにしません。

## 再生成

tools/prepare_child_horizontal_frame.pyで既存穴と配置を導出、tools/build_child_horizontal_frame.pyでF6レンダリング。tools/present_child_horizontal_frame.pyで独立したBlender確認モデル、tools/build_child_horizontal_steps.pyでFreeCAD CLIによるSTEP生成・読み戻し。tools/verify_child_horizontal_frame.pyで形状・取合い検査後、tools/assembly_parts.py sync child_exterior_horizontalで印刷一式を更新します。

旧縦置き外観はassemblyの_work/intermediate/before_horizontal_20261007/に保持。製作部品の生メッシュを外観検討へ混ぜません。
