AquaBeacon/mechanical/assemblies/child_vertical_assembly/child_vertical_assembly.md

> 2026-09-27現行: PLA Matte向け固定根元補強。60 mm根元・20 mm固定座・局所フランジ受け足を追加。印刷設定と解析結果は spec/child_interior_reinforcement/PLA_MATTE_REVISION.md。以下は旧版の履歴を含みます。

> 2026-09-27現行版：下リブ廃止、WetLink M10×5実配置、電池サービスねじをZ36へ移動。手順と検証は `spec/child_interior_reinforcement/SERVICE_REVISION.md`。以下は旧版の履歴を含みます。

> 現行版: 印刷部品による閉じた耳・31 mm根元補強。追加の金属スリーブ・板は廃止。強度解析は材料／荷重条件待ち。詳しくは `spec/child_interior_reinforcement/PRINTED_REINFORCEMENT.md`。以下は過去の履歴を含む。

# child_vertical_assembly — 子機 縦置き (吊り下げ) 構成

現行内装は金属スリーブと押さえ板を使う締め付け対策版。
[再補強の詳細](../../spec/child_interior_reinforcement/CRUSH_PROOF.md)を参照。

2026-09-26：内装はLCDを撤去した補強版へ更新済み。
左右デッキラグに拡幅と斜めリブを追加、下側は専用フランジブレースで3点固定。
詳細は [内装の補強記録](../../spec/child_interior_reinforcement/README.md)。
以下のLCD関連記述は変更前の履歴。

親機から**ロープで吊り下げる**前提の子機。耐圧容器を縦に立て、ドームを上・
アルミエンドキャップ (ペネトレータ) を下にして、容器を 2 枚の 3Dプリントシェルで
挟む (manafish ROV 方式)。

> **横置き構成 (`assemblies/child_assembly`) とは別系統。**
> 両方を同時に成立させることはできない。
> **2026-07-31: こちら (B) を本線として内装を設計した。**

## 2026-08-02 内装サービス更新

- 実基板を `CHILD_MAIN v4.1`（104×88）と `CHILD_PWR v2.1`（62×70、全高43.25）へ更新。
- NHD-C0216CiZ LCDを＋Y向きに保持し、透明アクリル越しに読めるベゼルと
  非対称支持アーチを追加。
- LCDを左M3縦ヒンジ＋右M2.5ラッチ1本の片開きドアへ変更。内装を70mm引き出すと
  約100°開き、C-MAINへアクセスできる。
- LiPoベイを軸方向ゲート化し、MAINを外さずM3×2で電池交換可能にした。
- 下フランジSTEPで実測したM3 BCD94左右2穴（0°/180°）へ10mmスペーサ＋0.5mmシムで締結した。
- 電源/信号を左右に分ける着脱式ケーブルレール2本を追加し、30mm以下の間隔で拘束した。
- 上下リブ外周に0.8mm面取りを付け、挿入時の引っ掛かりを防止した。
- 実配置16部品の半径包絡を検証し、干渉0。LCDドア2.80mm、固定フレーム5.29mm。

> **内装のみのサブアセンブリ**: [child_interior](../child_interior/child_interior.md) (2026-08-28)。
> interior グループ (基板・LiPo・LCD + **全ねじ・スペーサ・フォームパッド 61 点**) は
> `scad/lib/sync_child_interior.py` が両 `placement.json` に同じものを書く。手で片方だけ直さない。
> 2026-08-28 に浮いていた部品 (RX 基板) と貫通 4 箇所 (LCD/前板、電池箱アンカー/デッキ、枠ラグ/アーチ、
> ナックル/ドア板) を直した。内容は child_interior.md を参照。

組立・印刷・配線・サービス手順は
[`docs/子機内装_サービス設計.md`](../../docs/子機内装_サービス設計.md) を正とする。

## 外形 (要求 250 × 250 × 300 に対して)

| 軸 | 範囲 | 寸法 | 枠 | 決めているもの |
|---|---|---|---|---|
| X (基線方向) | ±120.2 | **240.4** | 250 | カメラ押え蓋の外縁 |
| Y (前後) | -115 .. +122 | **237** | 250 | パイロン後端 / 底デッキ前縁 |
| Z (上下) | -37 .. +261.25 | **298.25** | 300 | 下部ガード底面 / ドーム頂点 |

**Z の 298.25 のうち、ドーム頂点 (z=261.25) だけが未実測値に依存している。**
`wte4_dome_cap` の `dome_h = 53.25` が 54 を超えると 300 を割る。
調整代は `child_bottom_guard.ring_z0` (現 -37) を上げること (実質 3mm 程度)。

## 縦の積み上げ (z=0 = アクリルチューブ下端面)

```
  z = +261.25  ドーム頂点 ------------------------ 機体の最上端
  z = +252     吊り耳 上端 (ロープ穴 z=234, Ø16)
  z = +243     TD04A 放射面 (胴長 55 と仮定)
  z = +208     上フランジ 上面 = ドーム座面
  z = +200     アクリルチューブ 上端
  z = +190     シェル 上端
  z = +145     カメラポッド 上端 (押え蓋の座)
  z = +115     ★ レンズ軸
  z = +58      ライト軸
  z = +30      底デッキ 上面
  z = +18      シェル 下端 (= 下部ガードの取付面)
  z =    0     アクリルチューブ 下端
  z =  -8      下フランジ 下面
  z = -13.8    アルミキャップ 下面 (ここから全ケーブルが下へ)
  z = -37      スキッドリング 底面 ------------- 機体の最下端
```

購入品の寸法は**このフォルダの STL から実測**した (公称ではない)。

| 実測項目 | 値 |
|---|---|
| フランジのピストン挿入深さ / 露出カラー | **19 / 8 mm** |
| チューブ端の座ぐり | Ø104.2 × 20 深 |
| アルミキャップのプラグ / 露出厚 | **4.2 / 5.8 mm** |

## 構成部品

| ラベル | 部品 | 数 | 備考 |
|---|---|---|---|
| acrylic_tube_200 | `wte4_acrylic_tube` (BR-101052-200) | 1 | **200mm を使う** (300mm では全高 399 になり枠に入らない) |
| flange_bot / flange_top | `wte4_flange` | 2 | |
| end_cap_bottom | `wte4_end_cap_5xm10` | 1 | M10 ×5 (BCD 56)。**全ケーブルがここを通る** |
| dome_top | `wte4_dome_cap` | 1 | **未購入**。参考モデル (仮) |
| shell_aft | `child_shell_aft` | 1 | 吊り耳 / 取っ手 / TD04A 台 / ケーブル導管 |
| shell_fwd | `child_shell_fwd` | 1 | カメラポッド ×2 (**基線 150 一体**) / ライト鞍座 / 前方バンパ |
| bottom_guard | `child_bottom_guard` | 1 | キャップ保護 / 脚 / バラスト座 |
| cam_lid | `child_cam_lid` | 2 | |
| light_clamp | `child_light_clamp` | 1 | |
| xdcr_socket | `xdcr_socket` (child バリアント) | 1 | 上向き (tilt_deg=0) |
| vtray_deck | `child_vtray_deck` (**t200**) | 1 | 内装の背骨。z -2..202。幅広部 93 が上下フランジ内端に突き当たって軸方向に止まる |
| vtray_rib_bot / top | `child_vtray_rib` | 2 | Ø87.5 センタリング。z=2.5 / 191.5。デッキ先端から差し込み内側ショルダーに当て、先端側 M2.5×6 で抜け止め。下側がケーブルの要 |
| cable_rail_power / signal | `child_vtray_cable_rail` | 2 | 底に窓 (z 90..104)。デッキ下面 z 20..130。M3固定＋最大30mm間隔の結束。結束点 z 30/55/82/112/125 |
| vtray_batt_box | `child_vtray_batt_box` | 1 | LiPo ベイ。デッキ**下面**へ M3×8 ×4。z 14..133.5、−Z 端壁 6t (z 14..20、貫通口内リード切欠き)、+Z リップ 1.5t (z 132..133.5、床板フックスロット) |
| vtray_batt_floor | `child_vtray_batt_floor` | 1 | 39.4×3×111.5、−Z タブ (M3×8 皿 ×1、貫通口内)、フック ×2。M3×8 皿 1 本を外してスライド、フックを外す → −Y へ抜く |
| lipo | `lipo_35x26x110` (`_leads`) | 1 | 35×26×110。リード −Z 出し、z 21..131。床 y −40。リード: 電源リード (XT30 メス、z 25..55 XT30 ペア) + 充電リード 29mm、ピグテール (−Y へ出す) |
| child_harness | `parts/common/cabling/child_harness` | 9 本 | 9 バリアント (xh9_pwr/xh6_rx/xh7_lcd/xh3_teth/xh4_temp/xh2_leak/xh4_prs/bat/led)、世界座標 keep-out モデル |
| child_main | `child_main` (KiCad 実モデル) | 1 | デッキ**上面** z 20..132。基板下面 y=+1 |
| child_pwr | `child_pwr` | 1 | v2.1実基板 62×70。デッキ上面 z 126..188 |
| lcd_support_lower / upper | `child_lcd_support` | 2 | MAIN穴共締めの非対称アーチ |
| lcd_hinge_frame | `child_lcd_hinge_frame` | 1 | アーチ固定のCフレーム。左ヒンジ、右1ねじラッチ、中央基板アクセス開口 |
| lcd_cradle / lcd_module | `child_lcd_cradle` / NHD-C0216CiZ | 1組 | ＋Y外向き片開きドア、ねじ式交換保持 |
| rx_improved_mini | `rx_improved_mini` (KiCad 実モデル) | 1 | デッキ**下面**へ **M2** スペーサ 6mm で吊る (実穴 Ø2.2)。z 134..180。**90度回して**置く。基板下面 y=-16 |

内装の配置根拠は [`docs/子機内装_収まり検討.md`](../../docs/子機内装_収まり検討.md)。

## 組立・分解の順序

```
組立: 下部ガード → 後半シェルへ M5×4 → 容器を上から落とし込む
      → 前半シェルを前から合わせ、位置決めピン ×2 で合わせて M5 蝶ボルト ×4
      → カメラを落とし込んで蓋 (M4 蝶ボルト ×2 /台)
      → ライトを鞍座へ、クランプを M4 ×4
      → TD04A ソケットをパイロン屋根へ M5×4、振動子を差して結束バンド ×2
```

| やりたいこと | 外すもの | 所要 |
|---|---|---|
| **内部 (基板・電池) にアクセス** | **ドームの M3 + 上フランジ (ロッキングコード)** | シェルもガードも外さない。内装の幅広部 93mm は貫通口 Ø88.5 を通らないので**フランジを抜かないと引き出せない** |
| カメラの着脱 | 押え蓋の M4 蝶ボルト ×2 | 約 5 秒 |
| 容器を機体から降ろす | 前半シェルの M5 蝶ボルト ×4 → 真上へ | 約 1 分 |
| ペネトレータの締付け | 下部ガードの M5 ×4 | 工具アクセス確保のため |

## 質量・浮力 (**仮値だらけ。進水前にプールで実測すること**)

| 項目 | 質量 | 排水量 |
|---|---|---|
| 耐圧容器 (チューブ488 + フランジ214 + キャップ223 + ドーム81 + O/ねじ40) | 1.05 kg | 2.56 L |
| 3Dプリント部品 (PETG 合計、実効密度で概算) | 1.41 kg | 1.11 L |
| 内装 3Dプリント (deck 64.7 + batt_box 43.4 + rib 26.5×2 = 161 cm³) | 0.13 kg | 0.16 L |
| 内装 LiPo (Zeee 3S 2200 実測 170g) | 0.17 kg | 0.08 L |
| 内装 基板 3 枚 + 締結 (概算) | 0.17 kg | 0.05 L |
| カメラ ×2 | 0.30 kg | 0.23 L |
| 水中ライト **未選定** | 0.30 kg | 0.25 L |
| TD04A + 締結部品 | 0.32 kg | 0.05 L |
| **小計 (バラスト前)** | **3.85 kgf** | **4.49 L** |

→ **+0.64 kgf の正の浮力**。このままではロープが緩んで浮いてしまう。

**鉛 1.8〜2.9 kg を下部ガードの M6 ×5 に取り付けて -1.0〜-2.0 kgf にする**
(鉛は水中で自重の 91% が効く)。

> 内装が設計済みになったぶん、旧見積り (内装 0.80kg / 排水量ノーカウント) より
> **軽く・浮きやすく**なった。3Dプリント部品の質量は PETG 実効密度 0.8 g/cm³ の概算。
> **進水前にプールで実測すること。**

姿勢の安定: バラスト 1.5kg のとき重心 z≈69 / 浮心 z≈110 → **GM ≈ 41mm で直立安定**。
前後は重心が吊り点より約 6mm 前なので、**バラストを後ろ寄り (方位角 0 付近) に
置いて水平に合わせる**。

## 吊り

- **2 点ブライドル**。吊り耳は x=±80, z=234, Ø16 (Ø10 ロープ / M10 シャックル)
- 全備 5.7kg × 動的 3g、ブライドル 30° → **1 耳あたり 99 N**
- 吊り耳のせん断抜け余裕は**安全率 29** (PETG 層間許容 6 MPa に対して 0.21 MPa)
- ブライドルの脚長で吊り姿勢を調整する

## 内装 (2026-07-31 追加)

実基板 3D モデル (KiCad) と実購入 LiPo から配置を決めた。**仮値ではない。**

```
   z = 202       内装デッキ 上端 (上フランジ貫通口の中)
   z = 191.5..197.5  上センタリングリブ (内側ショルダー z 190.5 + 先端 M2.5 止めねじ)
   z = 180 ┄┄  幅広部 上端 = 上フランジ内端 (軸方向ストッパ)
   ── デッキ上面 (+Y) ──
   z = 126..188  CHILD_PWR v2.1 (62 × 70。先端 8mm は低背)
   z =  20..132  CHILD_MAIN (基板下面 y=+1)
   ── デッキ下面 (-Y) ──
   z = 134..180  RX_improved_mini (90度回して吊る。基板下面 y=-16)
   z =  20..132  LiPo ベイ (LiPo は y=-38..-15)
   ── ──
   z =  20 ┄┄  幅広部 下端 = 下フランジ内端 (軸方向ストッパ)
   z = 2.5..8.5  下センタリングリブ (ケーブルはここを通る。内側ショルダー z 9.5 + 先端 M2.5 止めねじ)
```

アクリル内壁までの最小すきま: `CHILD_MAIN` 高背ゾーン (DS3231) で **3.8mm**、
`CHILD_PWR` 高背部 5.3mm、RX 部品先端 4.5mm、デッキ隅 3.2mm、LiPo ベイ底 4.5mm。
すべて `.scad` の assert で検査している。

**RX をデッキ下面へ吊ったのが `CHILD_PWR` の面積を稼ぐ肝。**
3 枚とも上面に並べると PWR の軸長が 18mm しか残らない。

**ビルド時間と STEP サイズの注意**: 基板の STEP は銅箔・ベタ・シルクまで入っているので、
アセンブリ STEP が **約 99MB** になり FreeCAD の合成に数分かかる。STL（約26MB）も同時出力する。
配置を試すだけなら `.\build.ps1 -Assemblies -NoStep assemblies\child_vertical_assembly` を使うこと。

内装だけのプレビュー: `_work/images/child_vertical_assembly_interior.png` (LiPo / RX 側) と
`_work/images/child_vertical_assembly_interior_rear.png` (MAIN / PWR 側)。
生成コマンドは `docs/子機内装_収まり検討.md` §7。

## 未反映 (モデルに入っていないもの) — **これが揃うまで干渉確認は完了していない**

| 項目 | 影響 |
|---|---|
| **カメラ本体 ×2** | 3Dモデル未入手。クレードル内寸は公称値のみ。レンズ軸のずれ (`lens_dx`) 未確定 |
| **水中ライト** | 未選定。`light_d=40` は仮値。鞍座とクランプが作り直しになる可能性 |
| **TD04A 振動子** | 胴径 26 / 胴長 55 は仮定。上端 z=243 の根拠がここ |
| **ペネトレータ ×5 とケーブル** | 突出量が `child_bottom_guard.ring_z0 = -37` の根拠。**要実測** |
| **テザー・内部ハーネス実外径** | 経路と30mm以下の固定点はモデル反映済み。実ケーブル外径で曲げ半径とフォーム厚を確認する |
| **フランジ固定の実機最終確認** | STEP上は0°/180°・深さ6.049mmで一致済み。製造公差とOリング/キャップ非干渉、ねじ込み4～5mmを確認する |
| **バラスト (鉛)** | 量・位置とも未確定 |
| **EVA/ゴムシート** | スキン内面・ライト鞍座・カメラ押えパッド |

## 座標系

X = 左右 (カメラ基線) / Y = 前後 (+Y が前 = カメラとライトの向き) / Z = 上。
**アクリルチューブ下端面が z=0。**

`placement.json` が唯一の情報源。`child_vertical_assembly_view.scad` は
自動生成なので編集しない。

## 要確認 (優先順)

1. **ドーム `dome_h` の実測** → 全高 298.25 の確定 (唯一の枠リスク)
2. **ペネトレータの突出量** → `ring_z0` の確定
3. **カメラのレンズ軸ずれ `lens_dx`** → 全幅とポッド位置
4. **水中ライトの選定** → 鞍座・クランプの確定
5. ~~縦置き用の内装の設計~~ → **サービス設計まで完了** (2026-08-02)。残るのは
   フランジM3穴位相・タップ深さ、LiPo外形/リード長の実物確認
6. 実浮力の測定 → バラスト量の確定
