AquaBeacon/mechanical/assemblies/parent_hand_service/print_economy_report.md

# 親機内装：サポートとフィラメント削減

印刷入口は[parts/PRINT.md](parts/PRINT.md)。現行は12種類・14個。支柱は前用2個・後用2個、その他は各1個。印刷用STLは指定姿勢に回転・底面移動済み。スライサの自動姿勢変更を使わない。

## 改訂と材料量

床板は全面板を廃し、幅7.5 mm・高さ9.96 mmの開放格子、固定座へ続くリブ、4ケースねじ座、16個のM3ナット座とPWR/TX/LiPo支持座を残した。床下面Z8.84、上面18.8、ケース接触面13.84は維持。四隅のケース支柱にも0.2 mmの公称逃げ。
床の実CAD体積からのPETG中実相当は306.6→236.6 g（22.8%削減）。全印刷部品の体積換算は694.3→622.3 g（10.4%削減）。サポート込みの使用量は下表の実スライス比較。

アンテナ天板／4支柱と同軸リングを分割。天板を下にしてX180°で印刷し、リングは底を下にする。柱先端Ø5.4×高さ0.8のキーとØ5.6ポケット、既存M3×50の4本で共締め。取付高さと同軸OD100/ID75/H10は変えない。

GNSSは上台と前9×9／後8×6の支柱4本を分割。支柱本体高さ31.2、上端キー0.8、相手ポケットの幅・奥行に合計0.2の遊び。4本のM3×40で床ナットへ共締めする。上台下面Z50、基板Z56は維持。LIS3MDLの片持ち棚は上台と一体のまま。

MAIN/Sony台はX180°、基板支持面を下にして印刷。MAINは部品逃げの一部を貫通させ、SD/USB操作部の下側支持板は残す。Sonyは部品逃げを貫通させ、壁の配線窓に印刷時45°の尖った屋根を付けた。窓の有効幅は24 mm、最大高さ13 mm。薄い非機能の独立残片1.296 mm³を除去し、荷重を伝える台本体と全取付座の連結を検証した。

| 実スライス比較 | 改訂前 | 現行 | 削減 |
|---|---:|---:|---:|
| フィラメント総量（全個数、支持・ブリム等込み） | 843.4 g | 621.1 g | 26.4% |
| 支持材の移動押出量換算 | 175.9 g | 21.2 g | 88.0% |
| 各部品を別プレートで印刷する予測時間の合計 | 25.38 h | 22.76 h | 10.3% |

比較条件：導入済みBambu Studio、X1C 0.4 mm、Generic PETG（密度1.27）、Textured PEI、0.20 mm、4周壁、100%インフィル、3 mmブリム、通常自動支持45°、上下0.2 mm支持間隔、XY0.35 mm、ブリッジを支持しない設定。改訂前後で同一。支持量はG-codeのSupport/interface/transitionラベルの移動押出長から換算し、引戻し・静止プライミングを除く。総量はスライサの値。実機／フィラメントと配置によって変わる。疎なインフィルによる節約は今回の数字に含めない。

## 印刷姿勢と残る局所支持

| STL | 個数 | 設計元からの回転 | 支持押出量／個 |
|---|---:|---|---:|
| ann_mb1_coax_ring | 1 | [0, 0, 0]° | 0.52 g |
| ann_mb1_internal_rack | 1 | [180, 0, 0]° | 0.20 g |
| battery_base | 1 | [0, 0, 0]° | 2.64 g |
| floor_plate | 1 | [0, 0, 0]° | 4.21 g |
| gnss_column_front | 2 | [0, 0, 0]° | 0.00 g |
| gnss_column_rear | 2 | [0, 0, 0]° | 0.00 g |
| gnss_edge_cap | 1 | [0, 0, 0]° | 0.00 g |
| gnss_edge_cap_front | 1 | [0, 0, 0]° | 0.00 g |
| gnss_universal_carrier | 1 | [0, 0, 0]° | 3.11 g |
| main_lower_carrier | 1 | [180, 0, 0]° | 3.01 g |
| parent_lipo_retainer_lid_narrow | 1 | [0, 0, 0]° | 0.00 g |
| sony_upper_carrier | 1 | [180, 0, 0]° | 7.47 g |

支持を全体で無効にしない。床のボス逃げ／ナット座、MAINの保護したポケット天井、Sonyの小さな段差・窪み、GNSSのLIS3MDL棚などに局所支持が残る。GNSS長梁の下やアンテナ天板全体の下には以前の大量支持を作らない。リングの4 mm留め窓と位置決めポケットは短いブリッジ。支柱は縦置き、キーを上。小部品・細い初層には3 mmブリム。キーやナット座の支持・バリを除き、無理に嵌合しない。

面取り：格子／外周0.15–0.25 mm、アンテナ主要形状0.2 mm、GNSS上台0.05 mm、支柱0.1 mm、押さえ0.15 mm、穴入口0.4 mm逃げ。基板支持面・パイロット・座面・キー／ポケット・ナット捕捉面・正確な部品逃げの稜は機能寸法を保持。結合前の面取りによる内側交差根元は写真・試作で仕上げを確認し、CADが全稜の仕上げを保証するとはしない。

## 組立・検証

リングを先に床へ置き、上からアンテナ台の4キーを合わせて従来の4本の長ねじで共締めする。GNSS前／後支柱4本を正しい穴へ置き、上台のポケットを合わせ、従来の4長ねじで床ナットへ共締め。その他の順序は[assembly README](README.md)。購入ねじの型番と数量は増やしていない。キーで横ずれを止め、締結で浮きを止める。キークリアランスと0.3 mm横移動時の当たり、閉メッシュと単一連結体、操作と連続組立経路を検査する。

LiPo／蓋／4工具、両SDの抜差し、PWRの両スイッチ、GNSSとLIS3MDLの取出し、箱外MAIN USB、TX最上部＋20 mm、同軸の中心Ø75空洞を再検査。全STLの実スライスは成功し警告なし。これは実印刷の成功を認定するものではない。

床・MAIN・Sonyの現行参考計算と、途中で変位目標を超過して修正した案は[wave_rigidity_report.md](wave_rigidity_report.md)。理想締結の単体計算で、分割接合・メッシュ密度収束・実波浪／クリープ・ケース全体の保証は未成立。実締結と波に相当する揺動を試作で確認する。

実スライス3MFは[print_jobs/print_economy_x1c_petg/README.md](print_jobs/print_economy_x1c_petg/README.md)。使用する際はプリンタとフィラメントを照合する。各STLのハッシュ、数量と設定を付属manifestに保持。製造リリースは取合い試作のまま。

床板の改訂前後

部品の印刷姿勢
