AquaBeacon/mechanical/assemblies/parent_interior_p2/parent_interior_p2.md

# parent_interior_p2 — 親機内装 パターン2 (Pi Zero 2W + GS カメラ内蔵) 組立モデル

タカチ BCAS212310G (選定案・人間確認待ち) に `parent_plate_p2` を載せ、
P-MAIN / P-PWR / SPRESENSE / LiPo に加えて **GS カメラ (レンズ下向き、
箱底 Ø30 ビューポート越し) + Pi Zero 2W + 高架 TX** を実配置したモデル。
配置根拠: [docs/親機内装_収まり検討.md](../../docs/親機内装_収まり検討.md) §5、
検証: `spec/parent_interior_layout.py` (assert 済み。2026-08-29 に南壁ペネトレータの `check_penetrators()` を追加)。
**2026-08-28 改訂:** LiPo は `parent_lipo_tray` (MAIN 上ブリッジトレイ) で最上段に固定。
GS カメラは `parent_cam_mount` (脚 15)、TX 高架は `hex_spacer` m3_mf25 ×4 で実体化。
ビューポートは +X54 (箱 (159,115))。箱モデルは図面 DXF 実座標。宙に浮いた部品は LCD (未設計) のみ。

## 座標系

箱外形の左下手前が原点。X=210 / Y=230 / Z=上。
**+X = ビューポート方位** (箱中心 +X54 に Ø30)。浮子マウント側で箱の向きを
この方位に拘束すること。

## z スタック (パターン1 との差分)

| z | 内容 |
|---|---|
| 8.8 | GS カメラ レンズ前面 (箱床上面から 5。窓部品未設計・仮) |
| 13.8–18.8 | parent_plate_p2 (t5) |
| 18.8 | `parent_cam_mount` 脚下面 (脚 15 + t3 + リム 1.5) |
| 24.8 | Pi Zero 下面 (プレートボス 6) = TX 高架スペーサ下端 (ボス上面) |
| 36.8 | GS カメラ基板下面 |
| 49.8 | TX_improved 下面 (ボス 6 + M3 MF スペーサ 25、Pi Zero との隙間 6.3) |
| 51.4 / 54.4 / 77.4 | LiPo トレイ下面 / LiPo 下面 / LiPo 上面 (p1 と同じ、最高点) |
| **65** | **南壁ペネトレータ ×2 の軸** (p1 と同位置) |

## 貫通部 (南壁 WetLink M10 ×2) — 2026-08-29 追加

| ラベル | 箱座標 | ケーブル | 落とし先 |
|---|---|---|---|
| `pen_tether` | 南壁 (Y=0) x=120, 軸 z=65 | C1 テザー (電源 + RS485) | P-MAIN `J_TETH1` (箱 x≈123) |
| `pen_td04a` | 南壁 (Y=0) x=85, 軸 z=65 | C3 TD04A | TX (右列) |

- 箱側の追加工は `bcas212310g.scad` の `pen_x` / `pen_z` / `pen_d`(10.2)。
  座面・カバービス柱・トルクレンチのピッチを同 `.scad` が assert する。
- 部品は `wetlink_penetrator_m10_ref` の **`bcas` バリアント** (`wall_t 6.1`
  = このモデルの側壁厚)。実壁 3.08 ではナットが 3 mm 外側に来る = 保守側。
- y の占有: 箱外 −22…0 / 壁 0…6.1 / 箱内 6.1…14.5 (ナット上端)。
- **箱内に出るのは素の導体** (WetLink は濡れ側だけをシールする)。
  → 箱内に端子台が要る。**TD04A の 3P プラグは通らないのでケーブルを切る**。
- **検査コマンドに注意**: ペネトレータと箱は `group: "vessel"` なので、
  CLAUDE.md の既定 (`--groups interior`) では**見られない**。この 2 本を含めるには
  `--groups all` を付けること:

  ```powershell
  python scad\lib\check_asm_contacts.py assemblies\parent_interior_p2\placement.json --root . --ignore-threads --groups all
  ```

  (2026-08-29 現在: ペネトレータ ↔ 箱 は 貫通 0 / FLOATING 0。
  残る `plate ↔ p_pwr` `plate ↔ spresense` `gs_camera ↔ box` (底ビューポート未モデル化) はペネトレータ以前からの既知の指摘)
- 内装との当たりは `spec/parent_interior_layout.py` の `check_penetrators()` が
  平面/高さの両方で見る。**`bcas212310g.scad` の `pen_*` と三重定義**なので
  位置を動かすときは両方直して、このアセンブリを再ビルドすること。

## 未反映 (モデルに入っていないもの) — 揃うまで干渉確認は完了していない

- **箱底のビューポート穴 Ø30 と窓部品 `parent_cam_port`** (アクリル t4 + O リング。未設計)
- `parent_lcd_bracket` (未設計)
- ~~ケーブルグランド (南壁2)~~ → ✅ **ペネトレータ ×2 をモデル化 (2026-08-29)**。
  北壁 GPS 引込み ×1、全配線 (CSI 含む)、箱内の端子台、ストレインリリーフ、蓋、発泡パッド、ベルクロ帯、各ねじは未反映
- 南壁**外側**: 未設計の防水ボックスマウント／浮子との干渉 (壁外へ 22 mm 出る)

## 光学上の注意 (要判断)

上流仕様の「マスト下端 水中ポッド」と異なり、水上の箱から**水面越し**に見る。
波・屈折の影響、およびマストが視野中心から約 6° に写る件は
[親機内装_収まり検討.md](../../docs/親機内装_収まり検討.md) §5 を参照。
