AquaBeacon/mechanical/assemblies/td04a_fixture/parts/PRINT.md

# 印刷一式

対象: `td04a_fixture`。同じ部品は表の数量だけ複製してください。

Rev.6：M4貫通＋ナット・設計ピッチ12 mm（実測前）、穴列基準のケーブル逃げ60 mm。親機下向き・子機上向き。親機外装側M5/20、子機側面M3/20。旧TD04Aモデルは適合判断に使用しない。実物適合・締結・強度は未検証。旧3MFを使用しない。

STLは全てこのフォルダ内の実ファイルです。このフォルダをコピーして印刷できます。組立配置は除き、最小XYZを0へ移動済み。鏡像・スケールは反映済みです。CAD原本は編集せず、設計元を更新して再生成します。

| STL | 個数 | 外形 mm | 設計元からの回転 X/Y/Z ° | X1C 250³ |
|---|---:|---|---|---|
| [td04a_bracket_mount_parent_down.stl](td04a_bracket_mount_parent_down.stl) | 1 | 75 × 42 × 26 | [0, -90, 0] | 枠内 |
| [td04a_bracket_mount_child_side_up.stl](td04a_bracket_mount_child_side_up.stl) | 1 | 45 × 26 × 75 | [0, 0, 0] | 枠内 |

回転0°のものは設計元の姿勢を保っています。枠内の判定は外形だけです。サポート・積層方向・材料・強度の条件は [設計元の説明](DESIGN_NOTES.md) と上のassemblyの説明を確認してください。

`manifest.json` は出所、個数、鏡像変換、元STLとコピーのSHA-256を記録します。コピーを編集すると検査で不一致になります。
