AquaBeacon/mechanical/assemblies/parent_spar_bolted/parts/PRINT.md

# 印刷一式

対象: `parent_spar_bolted`。同じ部品は表の数量だけ複製してください。

既存構成の印刷データを整理。強度・造形性の新規認証ではない。

STLは全てこのフォルダ内の実ファイルです。このフォルダをコピーして印刷できます。組立配置は除き、最小XYZを0へ移動済み。鏡像・スケールは反映済みです。CAD原本は編集せず、設計元を更新して再生成します。

| STL | 個数 | 外形 mm | 設計元からの回転 X/Y/Z ° | X1C 250³ |
|---|---:|---|---|---|
| [parent_spar_disk.stl](parent_spar_disk.stl) | 1 | 225 × 225 × 5 | [0.0, -0.0, -180.0] | 枠内 |
| [parent_spar_fin.stl](parent_spar_fin.stl) | 4 | 65 × 125 × 4 | [90.0, -0.0, -0.0] | 枠内 |
| [parent_spar_hub.stl](parent_spar_hub.stl) | 2 | 88 × 88 × 32 | [0.0, -0.0, 0.0] | 枠内 |
| [parent_spar_beam_lower.stl](parent_spar_beam_lower.stl) | 1 | 180 × 32 × 32 | [-0.0, 90.0, 0.0] | 枠内 |
| [parent_spar_beam_upper.stl](parent_spar_beam_upper.stl) | 1 | 107 × 32 × 32 | [180.0, 90.0, 0.0] | 枠内 |
| [parent_spar_coupler_half.stl](parent_spar_coupler_half.stl) | 1 | 54 × 64 × 26.75 | [-90.0, 0.0, -180.0] | 枠内 |
| [parent_spar_coupler_half_mirrored.stl](parent_spar_coupler_half_mirrored.stl) | 1 | 54 × 64 × 26.75 | [-90.0, 0.0, -180.0] | 枠内 |
| [parent_spar_float_bottom.stl](parent_spar_float_bottom.stl) | 1 | 225 × 225 × 48 | [-180.0, 0.0, 180.0] | 枠内 |
| [parent_spar_float_body.stl](parent_spar_float_body.stl) | 2 | 225 × 225 × 180 | [0.0, -0.0, -180.0] | 枠内 |
| [parent_spar_float_lid.stl](parent_spar_float_lid.stl) | 2 | 225 × 225 × 6 | [-180.0, 0.0, 180.0] | 枠内 |
| [parent_spar_float_top.stl](parent_spar_float_top.stl) | 1 | 225 × 225 × 28 | [0.0, -0.0, -180.0] | 枠内 |
| [parent_spar_ballast_body.stl](parent_spar_ballast_body.stl) | 1 | 120 × 120 × 51 | [0.0, -0.0, -180.0] | 枠内 |
| [parent_spar_ballast_lid.stl](parent_spar_ballast_lid.stl) | 1 | 120 × 120 × 6 | [0.0, -0.0, -180.0] | 枠内 |
| [parent_spar_camera_bridge.stl](parent_spar_camera_bridge.stl) | 1 | 140 × 78 × 180 | [-90.0, 0.0, 0.0] | 枠内 |
| [parent_spar_gps_bridge.stl](parent_spar_gps_bridge.stl) | 1 | 183 × 96 × 100 | [-0.0, 90.0, 0.0] | 枠内 |
| [parent_deck.stl](parent_deck.stl) | 1 | 216 × 236 × 60 | [-180.0, 0.0, -0.0] | 枠内 |
| [dji_osmo_action6_mount.stl](dji_osmo_action6_mount.stl) | 1 | 104 × 79.45 × 84.5 | [0.0, -0.0, 0.0] | 枠内 |
| [parent_plate_p1.stl](parent_plate_p1.stl) | 1 | 183 × 203 × 17 | [0, 0, 0] | 枠内 |
| [parent_lipo_tray.stl](parent_lipo_tray.stl) | 1 | 112 × 84.5 × 17 | [0, 0, 0] | 枠内 |

回転0°のものは設計元の姿勢を保っています。枠内の判定は外形だけです。サポート・積層方向・材料・強度の条件は [設計元の説明](DESIGN_NOTES.md) と上のassemblyの説明を確認してください。

`manifest.json` は出所、個数、鏡像変換、元STLとコピーのSHA-256を記録します。コピーを編集すると検査で不一致になります。
