AquaBeacon/mechanical/assemblies/parent_spar_concept/parts/PRINT.md

# 印刷一式

対象: `parent_spar_concept`。同じ部品は表の数量だけ複製してください。

旧配置検討案。支柱・浮体・錘は購入品または予約包絡。印刷形状は未認証の試作。

STLは全てこのフォルダ内の実ファイルです。このフォルダをコピーして印刷できます。組立配置は除き、最小XYZを0へ移動済み。鏡像・スケールは反映済みです。CAD原本は編集せず、設計元を更新して再生成します。

| STL | 個数 | 外形 mm | 設計元からの回転 X/Y/Z ° | X1C 250³ |
|---|---:|---|---|---|
| [disk.stl](disk.stl) | 1 | 225 × 225 × 5 | [0, 0, 0] | 枠内 |
| [fin.stl](fin.stl) | 4 | 65 × 125 × 4 | [0, 0, 0] | 枠内 |
| [hub.stl](hub.stl) | 2 | 60 × 60 × 24 | [0, 0, 0] | 枠内 |
| [coupler.stl](coupler.stl) | 1 | 40 × 40 × 80 | [0, 0, 0] | 枠内 |
| [adapter.stl](adapter.stl) | 1 | 50 × 50 × 60 | [0, 0, 0] | 枠内 |
| [parent_deck.stl](parent_deck.stl) | 1 | 216 × 236 × 60 | [-180.0, 0.0, -0.0] | 枠内 |

回転0°のものは設計元の姿勢を保っています。枠内の判定は外形だけです。サポート・積層方向・材料・強度の条件は [設計元の説明](DESIGN_NOTES.md) と上のassemblyの説明を確認してください。

`manifest.json` は出所、個数、鏡像変換、元STLとコピーのSHA-256を記録します。コピーを編集すると検査で不一致になります。
