AquaBeacon/mechanical/parts/child/exterior/printed/child_cable_cover/child_cable_cover.md

# child_cable_cover — 子機 下部ケーブルカバー (新規、2026-09-04)

`docs/子機外装_改善要件.md` §3.4-2、`docs/配線・ケーブル計画.md` 構成 B の改訂に対応する新規部品。

| 項目 | 値 |
|---|---|
| 区分 | 子機 / 外装 / 3Dプリント |
| 個数 | 1 (cover) + 1 (clamp、押え板) |
| バリアント | `cover` (円弧殻本体)、`clamp` (クランプ押え板)。`variants.txt` |
| 外形 (cover) | 87.4 × 39.7 × 36.8 mm (STL bbox) |
| 外形 (clamp) | 34.0 × 26.0 × 10.0 mm |
| 体積 (cover) | STL/STEP 体積差 0.1% → PETG 約 21g |
| 体積 (clamp) | STEP volume 5784.2 mm³ → PETG 約 4.6g |
| STEP | clamp は CSG→STEP 直接変換 (1 ソリッド / 15 面)。**cover は CSG→STEP が
  `Bnd_Box is void` で失敗し、検証済み STL→STEP フォールバックを使用** (1 ソリッド、
  水密確認済み、STL と同一座標系)。原因は多数の ring_sector/cylinder ブーリアンが
  重なる箇所での FreeCAD カーネルの頑健性問題とみられる (hull は使用していない)。
  Fusion で編集したい場合は面選択できない可能性がある点に注意 |

## 役割

`child_guard_ring` の後部開放セクタ (方位角 230..310 = -Y ±40°) を覆い、アルミキャップ
露出面・ペネトレータ・ケーブルを後方/側方からの衝撃から守る。テザー等のストレイン
リリーフをクランプ座で受ける (`child_guard_ring` の結束スロットは補助に降格)。
トルクレンチのアクセスは**カバーを外して**確保する (中央 r<55 の素通しはガードリング
側の設計で維持されている)。

## 構成

- **`cover`**: 円弧殻本体 (r 58.35..64.35、az 230..310、z -54..-17.2) + 出口穴 ×3
  (Ø14) + 取付フランジ ×2 (`child_guard_ring` インサートへ M5×2) + クランプ座 下半分
  (半割トラフ + M5 ナットトラップ ×2)
- **`clamp`**: クランプ押え板。半割トラフの相手側 + M5 クリアランス穴 ×2

## 主要寸法

| 変数 | 値 | 意味 |
|---|---|---|
| `wall_r0` / `wall_r1` | 58.35 / 64.35 | シェル内外径 (guard_ring 後部ウォールと同径) |
| `ring_z1` / `top_z` | -54 / -17.2 | カバー下端 (guard_ring スキッド上面) / 上端 (フレーム下端に遊び0.2) |
| `open_sec` | [230, 310] | 対象セクタ (guard_ring の開放セクタと同じ) |
| `exit_az` | [238, 253, 292] | 出口穴 ×3 の方位角 (テザー/TD04A/ライト) |
| `exit_d` / `exit_z` | 14 / -40 | 出口穴径・中心 z |
| `clamp_az` | 270 (真後ろ中心) | クランプ座中心。開口ではなく閉じた座なのでここに置ける |
| `channel_d` | 14 | クランプ内径 (EVA t2 の圧縮代を Ø14 に含めて簡略化。下記「部品外の考慮」参照) |
| `clamp_bolt_y` | ±9 (ピッチ **18**) | ナットトラップ×2 のオフセット。brief 指定の 24 から変更 (下記インタフェース参照) |

## インタフェース (二重定義 — `child_guard_ring` と揃えること)

| 変数 | 値 | 備考 |
|---|---|---|
| `ring_z0` / `ring_h` | -60 / 6 | guard_ring スキッド。`ring_z1=-54` を導出 |
| `top_z` | -17.2 | guard_ring と同じ (フレーム下端 -17 に遊び0.2) |
| `wall_r0` / `wall_r1` | 58.35 / 64.35 | guard_ring 後部ウォールと同径 |
| `cover_bolt_az` | [230, 310] | guard_ring インサートの方位角 |
| `cover_bolt_r` / `cover_bolt_z` | 64 / **-26** | インサート中心 (2026-09-04 while作業: -35→-26。
  出口穴 z=-40 と z 方向に分離するため。guard_ring 側も同時変更済み) |
| `cover_bolt_pad_deg` | **11** | guard_ring ボス角度幅 (14→11。インサート長9+2が収まる最小9.85°に余裕) |
| `cover_bolt_r1` | 68 | guard_ring ボス外径 |
| `cover_bolt_dir` | [1, -1] | **guard_ring と同じ配列値だが、ボア方向は逆符号で使う**
  (guard_ring は az の反対側の材内へ、cover は az の同じ側=自分自身の材内へボアするため。
  `.scad` 内のコメント「二重定義だが向きが逆」参照) |
| M5 バカ穴/座ぐり | Ø5.4 / Ø9×5 | `child_guard_ring` の M5 熱圧入インサート (Ø6.4×9) へ締結 |

**`cover_bolt_z` と `cover_bolt_pad_deg` を変えたら `child_guard_ring.scad` の同名変数も
必ず直すこと。** ペネトレータ位置 (WTE4 M10 ×5、BCD56、72°ピッチ、1個が方位角270=真下)
はこの部品と直接の取合いはないが、出口穴の配置根拠 (真後ろ回避) として参照した。

## 干渉チェック (`.scad` 冒頭の assert)

- 出口穴どうしの周方向すきま (穴縁+1mm)、シェル端からのはみ出し (端+1mm)
- 出口穴と真後ろクランプゾーン (実際のトラフ区画footprintから逆算、約260..280) の回避
- 出口穴とフランジボア (`cover_bolt_z`) の z 方向分離 (フランジは全高なので角度域は
  出口穴を制約しないが、ボア自体とは z で分離する必要がある)
- クランプ トラフ区画とシェル端 (フランジ) のクリアランス
- クランプ ボルト区画の半径方向張り出し ≤ 100mm (envelope 内)
- チャンネル/ナットトラップの肉厚・クリアランス (すべて ≥3mm または ≥2mm)
- 取付フランジ座ぐりが `ring_z0` (-60、機体最下端) 未満に出ないこと

## 荷重と強度

`quick_strength.py plate` (PETG, sf=2, interlayer 許容)。

- **L2 輸送 300N 後方** (板曲げ、円弧殻を平板近似 a=85.7mm (80°弧, r_mean 61.35) ×
  b=36.8mm (カバー高さ) × t=6mm、両端支持相当):
  `plate --a 85.7 --b 36.8 --t 6 --p 0.0951` → 曲げ 2.30 MPa (許容12) / たわみ 0.057mm
  → **PASS** (安全率 ≈5.2、余裕大)

## 印刷 (X1C)

`topopt print` (`--load-axis 0,1,0`、300N が -Y から入るため):

- **cover**: 最良姿勢 **+Z up (設計そのままの向き、guard_ring 上面がベッド)**、
  オーバーハング **12.3%** (限度15% 内) → **PASS**。min feature 1.72mm、
  load-vs-layers cos=0 (面外荷重が層間に来ない) → PASS
- **clamp**: 最良姿勢 +X/-X up、オーバーハング13.1% → PASS。-Z up (34×26×10、
  平置き) でも21.5%でFAIL方向だが最良姿勢を採用するので問題なし

サポート不要。PETG、インフィル目安20% (荷重に対し余裕が大きいため過剰スペックは避ける)。

## インサート/ナット

- `child_guard_ring` 側の M5 熱圧入インサート (Ø6.4×9) ×2 へ M5 ×2 で締結
  (バカ穴 Ø5.4、座ぐり Ø9×5。ドライバは後方 (開いた側) からアクセス)
- クランプは M5 ナット (二面幅8mm、六角ポケット) ×2 を `cover` 側にトラップし、
  `clamp` 側からクリアランス穴 (Ø5.4) を通した M5 ボルトで締結。**ピッチは 24 ではなく
  18** (下記「要確認/決定事項」参照)

## 部品外の考慮

- **ケーブル曲げ半径**: ペネトレータ先端 z-33.8 からこのカバーの出口穴 (z-40) まで
  6.2mm しかない。真の25mm曲げ半径は`child_guard_ring`側でも「収まらない」旨を明記した
  とおり、このカバーの中でも完結しない。**ケーブルは半分曲がった状態でカバー内を通過し、
  出口穴の外側 (カバー外) で曲げを完了する**ことを前提とする
- **トルクレンチ**: このカバーを外した状態でペネトレータのトルクレンチアクセス
  (中央 r<55、guard_ring 側で素通し) を確保する。カバーを付けたままでは工具アクセス不可
- **クランプの EVA**: `channel_d=14` はEVA t2 の圧縮代を Ø14 に含めて簡略化した近似値。
  実際のテザー外径 (未選定) + EVA 2mm 巻き付けがちょうど Ø14 に収まるかは仮定であり、
  実物入手後にクランプ寸法を見直すこと
- **テザー外径・最小曲げ半径は未選定** (guard_ring 側と共通の要確認事項)
- `placement.json` は発注元が作成する。本部品は機体座標そのままで `ops: []` で置ける
  (原点は機体グローバル座標のまま、追加の translate/rotate 不要)

## 要確認・決定事項 (2026-09-04 作業時に判断したもの)

1. **ナットトラップのピッチを brief 指定の 24 から 18 に変更した。**
   理由: 後方セクタ 80° 全体から、フランジ×2 (各11°)・出口穴×3 (Ø14)・
   真後ろクランプゾーンの回避を同時に満たすには、Ø14 チャンネルからナット外接円まで
   ≥2mm を確保しつつピッチ24 (半オフセット12) では channel_r(7)+nut_r(4.62)=11.62 に対し
   オフセット12では成立するように見えるが、クランプ座全体の接線幅がシェル端の
   フランジ・出口穴のゾーンと衝突し、80°の中に収まらなかった。ピッチを24で必須とする
   相手部品はない (このカバー内で完結する自己参照的な寸法) ため、18に緩和して成立させた。
   **不服なら発注元に確認し、必要ならクランプの構造 (2段ブロック方式) を見直すこと。**
2. **`cover_bolt_z` を -35→-26、`cover_bolt_pad_deg` を 14→11 に変更**し、
   `child_guard_ring.scad` 側も同時に直した (二重定義の追従)。出口穴と取付フランジの
   ボアを z 方向に分離するための変更。
3. cover の STEP が CSG→STEP 直接変換に失敗し STL→STEP フォールバックになっている件
   (上表参照) — 実害は小さい (水密、STL/STEP 座標一致) が、Fusion で面編集したい場合は
   `.scad` の ring_sector 呼び出し数を減らす等の切り分けが要る。
