AquaBeacon/mechanical/parts/child/exterior/printed/child_cam_bridge/child_cam_bridge.md

# child_cam_bridge — カメラブリッジ (HP4/HP5 外付け、横向き 2 台)

**v2 (2026-09-06): トポロジー最適化 (`topo_v1/`) の結果をもとに全面再設計。**
v1 (328.1 cm³) の「高い後ウェブ + 全面デッキ」を捨て、最適化が材料を置いた面
(中央柱と同一平面) に集中させた**箱桁 (ボックスビーム) 構成**に置き換えた。

| 項目 | 値 |
|---|---|
| 区分 | 子機 / 外装 / 3Dプリント |
| 設計ソース | `child_cam_bridge.scad` (cube/cylinder + boolean のみ) |
| 個数 | 1 |
| 外形 | 240.0 × 61.0 × 150.05 mm |
| 体積 | **266.45 cm³** (v1 328.1 cm³ → **81.2 %**、−61.7 cm³) → PETG 約 330 g |
| STEP | **1 ソリッド / 359 面 / watertight** (CSG→STEP 直変換、STL と体積差 0.0 %) |
| 旧版 | `archive/v1/` (v1 の .scad/.md/.stl/.step/_preview.png/interfaces.json) |
| 最適化 | `topo_v1/` (SIMP、最適形状 181.4 cm³) |

## 役割

`child_jaw_gate` の HP4 (z170) / HP5 (z100) 座に中央柱で共締めし、左右へ張り出した
ウイングの上に `child_cam_mount` (横向き、90° 回転) を M5×4 ずつ載せる。
左右カメラのレンズは x=±75。輸送時は M5×8 を外してブリッジごと取り外す (C7)。

## 主要寸法 (部材構成)

すべて左右対称。z 44.95 (デッキ下面) 〜 195 (HP4 座上端)。

| 部材 | 位置 (x / y / z) | 役割・由来 |
|---|---|---|
| 中央柱 (column) | ±25 / 74.35..80.35 / 44.95..195 (t6) | **preserve**。HP40 アダプタ板。M5×8 が Y 軸に貫通 |
| スパイン (spine) | ±57 と ±(93..120) / 74.35..80.35 / 44.95..76.95 | 最適化が自由材料の 8 割超 (47.8 cm³) を置いた面 |
| 厚肉スパイン | ±57 / **67..80.35 (t13.35)** / 44.95..72.95 | 根元のねじり対策。6mm 板のままだと J=(1/3)bt³=3,600 mm⁴ しか無い |
| アッパーデッキ (UD) | ±57 / 67..124 / **64.95..72.95** (t8) | 箱桁の上フランジ。最適化のアーチ/クラウンの代替 |
| UD 肉抜き窓 | ±(27..55) / 88..110 / 貫通 | y 中立軸付近 = I_zz への寄与が最小の領域 |
| 前縦ウェブ (web_front) | ±57 / 114..124 / 44.95..72.95 | デッキと UD を結ぶせん断ウェブ。**これが箱桁を成立させる** |
| 外側後縦ウェブ (web_out) | ±(57..120) / 67..75.05 / 44.95..72.95 | 外側ウイングの箱を閉じる。マウント本体 (y≥75.05) を避ける |
| デッキ後レール | ±120 / 71..80.35 / 44.95..52.95 | 下フランジ (後縁)。L2s の軸力経路 |
| cam_mount 座 | ±(58..92) / 75.05..119.05 / 44.95..52.95 | **preserve**。上面が register 面、下面が M5 ナットトラップ開口 |
| デッキ内側パネル | ±(46..60) / 74.35..124 / 44.95..52.95 | インボードリブの座 + せん断板 |
| デッキ外側パネル | ±(90..116) / 71..92 / 44.95..52.95 | 座と端板を繋ぐ |
| デッキ前レール | ±(30..120) / 114..124 / 44.95..52.95 | 前縁バンパの下フランジ |
| インボードリブ | ±(50..57) / 76..116 / 44.95..76.95 (t6) | YZ 面の縦板。デッキ↔UD↔スパインを x≈54 で結ぶ |
| 前縁バンパ | ±(30..120) / 122..128 / 44.95..80 | **preserve**。L4 の荷重導入面 |
| 端板 | ±(114..120) / 67..128 / 44.95..80 | **preserve**。外面 x=±120 が側面バンパ L 形フットの密着面 |

穴: HP4/HP5 の M5×8 (軸 Y、Ø5.4)、マウント M5×8 + 下面ナットトラップ (軸 Z)、
側面バンパ M5×4 のナットトラップ (軸 X、端板厚 6mm の範囲内)。

## v1 からの変更 (最適化の所見)

1. **後ウェブ (x27..120, y67..73, z44.95..160、約 128 cm³) を全廃**。
   最適化はこの面 (y67..73) に薄い斜材しか置かず、材料の 26 % (47.8 cm³) を
   **中央柱と同じ y73..79 の面**に集めた。
2. **全面デッキ (x−120..120, y67..124, t8、109 cm³) を荷重経路の帯だけに削減**。
   最適化のデッキ層は 782→628 ボクセルと穴だらけだった。
3. **アッパーデッキ (z64.95..72.95) を新設**。最適化が中央上部に作ったアーチ
   (x±55,z50 → x0,z105) と同じ役割 = −Y 荷重を y 方向の深さを保ったまま
   HP5 座の高さまで運ぶ。**アーチそのものは cube では作れない**:
   工具アクセス Ø12 (x±20, z80/120/150/190、y≥80.35 から +Y) が x14..26 を
   z74..86 で塞ぎ、カメラケース (x≥27.65) が z82.95 以上を塞ぐため、
   アーチ脚が通る隙間は x26..27.65 の 1.65mm しかない。
   最適化はこの境界をボクセル 1 個ぶんかすめて通していた
   (セル中心 (22.5, 85.45) が円柱表面ちょうど r=6.0)。
   **z を工具アクセスの下 (74 未満) に置けば x−57..57 を連続で渡せる**ので、
   アーチを「低いアッパーデッキ」に置き換えた。

## 荷重ケースと安全率・たわみ

荷重は最適化 study (`topo_v1/child_cam_bridge_v1_study.json`) と同一。
支持は常に HP4/HP5 座 (`child_jaw_gate` にボルト留め、fix xyz)。
合格基準: **全ケース たわみ ≤ 1.0 mm、安全率 (p99.5) ≥ 3.0**。

### 最適形状との比較 (`topopt compare`、ボクセル 3.0 mm、同一 study)

| ケース | 最適形状 たわみ | 本部品 たわみ | コンプライアンス比 | 本部品 SF (p99.5) |
|---|---|---|---|---|
| L1 運用吊り 3g (カメラ+ケース 0.35kg×2 + 自重 3g) | 0.037 mm | **0.135 mm** | 3.20× | 43.30 |
| **L4 正面衝突 150 N (−Y) 片側前縁バンパ (支配ケース)** | 0.967 mm | **0.714 mm** | **0.85×** (15 % 硬い) | 8.57 |
| L2s 側面衝突 150 N (−X) 右舷端板 | 0.189 mm | **0.192 mm** | 0.66× (34 % 硬い) | 23.18 |
| L6 取り回し 100 N (+Z) 右舷 cam_mount 座 | 0.368 mm | **0.915 mm** | 2.14× | 10.21 |

幾何一致: 最適形状の 73.9 % を含む / 最適形状にあって本部品に無い 1,756 ボクセル
(= 削ったアーチとステー) / 本部品が足した 4,570 ボクセル。

### 最終形の細かいボクセル FEA (`topopt fea --voxel 1.3`、122,170 要素) — **PASS**

| ケース | たわみ (最大位置) | SF p99.5 | SF 最悪要素 | von Mises max / p99.5 |
|---|---|---|---|---|
| L1 | 0.122 mm @ [120.5,128.1,45.0] | 57.12 | 8.52 | 3.17 / 0.59 MPa |
| **L4** | **0.633 mm** @ [120.5,128.1,45.0] | **12.68** | 1.37 | 25.54 / 2.74 MPa |
| L2s | 0.152 mm @ [120.5,99.5,80.1] | 33.67 | 7.42 | 6.18 / 1.04 MPa |
| **L6** | **0.782 mm** @ [120.5,128.1,45.0] | **14.14** | 1.86 | 18.42 / 2.57 MPa |

- **mesh resolution: PASS** (最薄断面 5.20 mm に 4 要素 / 代表 7.80 mm に 6 要素)。
  ボクセル 2.0 では最薄 4.00 mm (= デッキ 8mm − ナットトラップ 4mm) が 2 要素で
  FAIL したため 1.3 mm まで細かくした。
- 判定は **p99.5** で行う (ツールの規約)。**最悪要素 SF 1.37/1.86 は
  cube 同士の入隅 (ボクセルの階段) の値**で、Fusion で R2〜R3 のフィレットを
  付ければ消える種類の集中。実機で見るべき箇所として下記「要確認」に残す。
- L4/L6 とも最大変位は同じ点 (ウイング先端 前縁下角) で、モードは
  「根元まわりのウイング回転」。

### 実効的な律速 (FEA で見えないもの)

HP4/HP5 の **M5 熱圧入インサート 8 本の引抜き**。L2 輸送 300 N 時、
M_y = 300 N × 95 mm = 28,500 N·mm を 40mm ピッチのボルト対で受けると
約 355 N/本。PETG の M5 インサート引抜き耐力は 400〜800 N 程度なので、
**引抜き試験を推奨** (v1 から継続の未解決項目)。座面 xyz を fix する解析では
この項目は原理的に出ない。

## トポロジー最適化の報告

| 項目 | 値 |
|---|---|
| 手法 | SIMP (`python -m topopt`、v1.0.0) |
| 目的関数 | 全 4 荷重ケースの重み付きコンプライアンス最小化 |
| 設計空間 | x −120..120 / y 67..128 / z 44.95..195 (240×61×150.05、= v1 の bbox) |
| 要素 | ボクセル **3.0 mm**、グリッド 86×27×55 (グリッド原点 [−129, 58, 38.95]) |
| 体積分率 | 0.06 (自由セルに対して) |
| フィルタ半径 | **6.0 mm** |
| ペナルティ (penal) | SIMP 既定 (3) |
| 収束基準 | `tol_change` 0.002 / `move` 0.2 / 対称拘束 X |
| 収束 | **未収束** (`max_iterations` 110/110 で停止、3,473 s) |
| しきい値 | 0.50 (体積 181,386 mm³、SF p99.5 8.63) |
| 材料モデル | `orthotropic_equivalent_solid` (PETG、**実測値なしの暫定カード**) |
| build_axis | Y |
| 境界条件 | 支持 = hp4_seat / hp5_seat (fix xyz)、荷重 = L1/L4/L2s/L6 (上表) |
| preserve | 中央柱 (x±25, y74.35..80.35, z75..195) / cam_mount 座 ×2 / 端板 ×2 / 前縁バンパ ×2 (計 124.0 cm³ = 最適形状の 68 %) |
| obstacle | カメラケース ×2 / cam_mount 本体 ×2 / 視野円錐 (半角 77.5°) ×2 / HP シェルフ ×3 / 工具アクセス Ø12 ×8 |
| FEM 再検証 | 本部品を同一 study で再解析 (上 2 表)。**支配ケース L4 は最適形状より 15 % 硬い** |

**最適化レポートの verdict は FAIL** (未収束 / mesh 粗い / preserve 面にサポート)。
本部品はその 3 点のうち mesh resolution を **ボクセル 1.3 mm の再解析で PASS** に
解消し、残り 2 点は下記「要確認」に引き継いだ。

### 再構築の反復 (14 回、compare で計測)

| # | 体積 | 変更 | L4 | L6 |
|---|---|---|---|---|
| a | 201.8 | スパイン + デッキ帯 + インボードリブ (アッパーデッキ無し) | **11.83** | 2.87 |
| b | 223.6 | z74..82 にアッパーデッキ (工具アクセスで中央と内側に分断) | 9.54 | 1.29 |
| c | 229.0 | デッキ内側パネルを根元 (x25) まで延長 | 7.77 | 1.386 |
| d | **248.1** | **アッパーデッキを z64.95..72.95 へ下げ x−57..57 を連続化** | **0.931** | 1.071 |
| e | 246.3 | デッキ内側パネル短縮 + 外側上レール追加 | 0.937 | 1.288 |
| f/g | 269.4 | 最適化のステー (y67..74 面の斜材) + マスト受けを追加 | 0.925 | 1.070 |
| h | 285.4 | **前縦ウェブ (y114..124) を追加し箱桁を閉じる** (f/g からの差分) | 0.711 | 0.839 |
| i | 237.2 | ステー削除 + 5 箇所を削る (過剰) | 1.007 | 1.445 |
| j | 262.3 | ステーのみ削除 | 0.723 | 1.010 |
| k | 275.7 | 外側後縦ウェブを z44.95..72.95 に拡大 | 0.724 | 0.988 |
| l | 272.2 | ステー復活 + UD 肉抜き窓 + 各部トリム | 0.833 | 0.998 |
| m | 285.9 | **根元スパインを y67..80.35 (t13.35) に厚肉化** | 0.707 | 0.788 |
| **n** | **266.5** | **ステー削除 (厚肉スパインがあると 19.5 cm³ で 0.13mm しか買えない) → 採用** | **0.714** | **0.915** |
| o/r | 235.0 / 252.0 | 外側ウェブ / リブ / 内側パネルをさらに削る | 0.96/0.83 | 1.31/1.15 (却下) |

**a→d でわかったこと (この部品の設計の肝)**: ウイングの Mz (L4 の −Y 荷重 ×
腕 95mm) を中央柱の平面 (y74.35..80.35 の 6mm 板) に「デッキ経由」で渡すと、
荷重は板を Z 軸まわりに**ねじる**経路になる。薄板のねじり定数は
J=(1/3)·50·6³=3,600 mm⁴ しかなく、先端が 8〜10 mm 振れる。
**HP5 座の高さ (z75..125) に y 方向の深さを持った水平板で直接渡す**か、
その直下 (z≤73) まで連続した水平板で渡すしかない。

**h でわかったこと**: デッキ (z44.95..52.95) と UD (z64.95..72.95) の 2 枚は
y74..80 のスパイン付近でしか繋がっておらず、根元の有効 I_yy が
10,500 mm⁴ (= 8mm 板 2 枚ぶん) しか出ていなかった (L6 たわみから逆算)。
**y114..124 のせん断ウェブ 1 枚 (正味 13.7 cm³ / 実測 +16 cm³) で
L6 が 1.069→0.839、L4 が 0.925→0.711 に改善**した (#f/g → #h)。

## 体積目標について (未達、数値で報告)

指示された目標は **≤ 230 cm³ (v1 の 70 %)**。到達値は **266.45 cm³ (81.2 %)**、
**36.5 cm³ 超過**。理由:

1. **preserve だけで 124.0 cm³** (最適形状 181.4 cm³ の 68 %、本部品の 47 %)。
   自由に設計できるのは実質 106 cm³ で、最適化は同じ機能を 57.4 cm³ で
   実現している。cube/cylinder 縛りでこの 1.9 倍の効率差が埋まらなかった。
2. **最適化の主部材 2 つが cube では再現できない**。
   - アーチ (swept な傾斜面、約 20 cm³) → 工具アクセス Ø12 とカメラケースの
     間に 1.65mm の隙間しか無く、6mm 以上の部材を通せない。代替の
     アッパーデッキは z を下げるぶん経路が長く、45 cm³ 必要だった。
   - ステー (y70..73 の厚さ 1 ボクセル = 3mm の斜材、両側で 1.5 cm³) →
     FEA の mesh resolution (最薄 6mm 以上) と印刷最小肉厚の制約から
     3mm では作れず、実装した 9×7mm 版は 19.5 cm³ かかって費用対効果が
     合わなかった (#m→#n)。
3. 235 cm³ まで削った版 (#o) は L6 1.306 mm、252 cm³ 版 (#r) は L6 1.147 mm で
   いずれも合格基準 (≤1.0 mm) を割った。**230 cm³ 以下でこの荷重条件を
   満たす cube 構成は見つかっていない。**

さらに削るなら次のどれかを人間に判断してもらう必要がある:
(a) 工具アクセスを Ø12 → Ø10 に緩める、または HP4/HP5 の M5 をボールポイント
六角で斜め挿入する前提にする (アーチが通せるようになる)、
(b) 前縁バンパ preserve の z 範囲 (44.95..80、37.9 cm³) を縮める、
(c) L6 の判定を「たわみ ≤ 1.5 mm」に緩める (SF は 14 あり強度は余っている)。

## 干渉チェック (`.scad` 冒頭の assert)

- **総当り AABB 検査: 24 部材 × 15 除外ボックス = 360 組**、ビルドで全 PASS。
  除外ボックスは (a) カメラケース ×2 (x27.65..122.35, y74.1..120, z82.95..167.05)、
  (b) cam_mount 本体 ×2 (x58..92, y75.05..119.05, z52.95..82.95)、
  (c) HP シェルフ ×3 (x±25, y62.35..74.35, HP4/HP5/HP-L)、
  (d) **工具アクセス Ø12 ×8** (x±20±6, y80.35..129, z 80/120/150/190 ±6) —
  **(d) は v1 に無かった検査**で、最適化の obstacle 定義から引き継いだ。
- 個別 assert: デッキ下端 ≥ HP-L 座上端+2 / 最上端 ≤ 195 / 全幅 ≤ 240 枠 /
  ゲート殻 (r64.35) から ≥2.6mm (後デッキレール・UD・厚肉スパインの各後端) /
  スパイン・UD・リブがケース底 (82.95) とマウント本体 (x58) に ≥1mm /
  UD とリブが工具アクセス (x≤26) に ≥3mm / **最小肉厚 ≥6mm** (FEA の
  ボクセル 2.0 で 3 要素を確保するため) / マウント M5 穴の座パッド縁距離 ≥3mm
  (前後左右とも 6mm) / FOV 半角 79.9° > 77.5° / バンパ外面 ≤ 280 枠 /
  バンパ締結穴 z ≤ 端板上端−2 / **preserve 4 種の寸法が変わっていないこと**。

## 印刷 (X1-Carbon)

| 項目 | 指示 |
|---|---|
| 材料 | **PETG** (266.45 cm³ → 約 330 g) |
| 姿勢 | **中央柱を床にした +Y up** (240 × 150.1 × 61)。最適化の `build_axis = Y` と同一。**変更しないこと** |
| 理由 | −Z / −Y 輸送荷重を両方とも層面内に保つ。`topopt print --load-axis 0,0,1` で `load vs layers: cos = 0.00` PASS |
| オーバーハング | +Y up で **24.5 %** (v1 は 30.9 %)。1st layer 面積 6,805 mm²。納品 STL (`topo_v1/05_rebuild/child_cam_bridge_v2.stl`) で再確認済み |
| サポート | 要る。中央柱の座面 (y=74.35、ベッドから 7.35mm) の下にサポートが乗る。**この面は `child_jaw_gate` との合わせ面なので、サポート痕を面出し (400 番程度) してから組むこと** (最適化レポートも同じ指摘。姿勢を変えると荷重が層間に載るので姿勢では解決しない) |
| インフィル | 壁 4 周 / 上下 5 層 / gyroid **40 %**。中央柱・厚肉スパイン (x±57, y67..80.35, z44.95..72.95 と x±25 の柱全体) は熱圧入インサートの引抜きを受けるので **60 %** |
| レイヤ | 0.2 mm、ノズル 0.4 mm。最小肉厚 4.45 mm (デッキ 8mm − ナットトラップ 4mm。2 周 0.8mm を大きく上回る) |
| 造形枠 | 250³ 実用枠に収まる (as-modelled 240 × 61 × 150.05) |

`topopt print` の自動最適姿勢は −X up (オーバーハング 9.3 %) だが、荷重が層間に
載るため**採用しない** (v1 と同じ判断)。

## 部品外の考慮

- `child_cam_mount` 本体・防水ケースは本部品に含まない (`placement.json` で別配置)。
  ケース AABB と cam_mount 本体 AABB は assert の除外ボックスとして持っている
- **HP4/HP5 の M5×8 の工具アクセス Ø12** を除外ボックスとして明示的に持つように
  なった (v1 は未検査)。中央柱前面 y=80.35 から前方へ Ø12 が通る
- バンパ (`child_side_bumper`) の M5×2×2 は端板フランジのナットトラップで受ける
- FOV 余裕は 2.4° (79.9° vs 77.5°)。`lens_off_bot`/`case_h`/`case_w` の実測で
  変わるので実測後に必ず再検査
- 輸送時は M5×8 を外してブリッジごと (カメラ・マウント・バンパも道連れで) 取り外す
- **アッパーデッキ (z64.95..72.95) と厚肉スパインが新しく占める空間**が、
  ゲート内側の配線・浮力材と当たらないかアセンブリで確認すること (y67..124、
  |x|≤57、z45..77 が概ね中実になった)

## インタフェース (二重定義)

- **HP4/HP5 座標**: `hp4_z=170` / `hp5_z=100` / `hpl_z=15` / `hp_half=25` /
  `hp_seat_y=74.35` / `hp_shelf_dep=12` / `hp_pitch_half=20` / `hp_bolt_d=5.4` /
  `adapter_t=6` / `gate_r_out=64.35` — `child_jaw_gate.scad` と同値であること。
  **`tool_d=12` (工具アクセス径) を新設** (`topo_v1/child_cam_bridge_v1.scad` と同値)
- **child_cam_mount 側**: `cm_lens_off_bot=42.05` / `cm_fin_x1=30` / `cm_case_d=45.9` /
  `cm_case_w=94.7` / `cm_case_h=84.1` / `cm_plate_hw=22` / `cm_plate_hh=17` /
  `cm_fh_y=16` / `cm_fh_z=11` — `child_cam_mount.scad` の同名変数と同値であること
- **child_side_bumper 側**: `bumper_t=9` / `case_gap=2` / `bump_bolt_y=[80,116]` /
  `bump_bolt_z=65` / `wing_x1=120` / `end_plate_t=6` / `end_plate_z1=80` /
  `case_outer_x`(導出式を同一に保つこと) — `child_side_bumper.scad` と同値。
  端板の y 範囲 (67..128) と z 範囲 (44.95..80) は **v1 と同一なので
  バンパ側の L 形フット (x120..124.35, z44.95..78) の変更は不要**
- `interfaces.json` は変更なし (参照している値がどれも変わっていないため)

## 要確認

1. **体積目標 230 cm³ 未達 (266.45 cm³)**。上記「体積目標について」の (a)(b)(c)
   のどれを緩めるか、または 81.2 % で了とするかの判断が要る
2. **中央柱の座面 (y=74.35) にサポートが乗る**。合わせ面なので面出しする前提で
   よいか (姿勢を変えると荷重が層間に載るため姿勢での解決は不可)
3. **HP4/HP5 の M5 インサート引抜き (約 355 N/本、L2 300 N 時)** が実効的な律速。
   引抜き試験を推奨 (v1 から継続)
4. 材料カード (`orthotropic_equivalent_solid`) は**このプリンタで未実測の暫定値**。
   たわみ・SF の絶対値ではなく比較値として扱うこと
5. 最適化は **110 反復で未収束** (`max_iterations`)。より収束させれば
   もっと軽い解が出る可能性がある
6. FEA の**最悪要素 SF (L4 1.37 / L6 1.86)** は cube の入隅のボクセル階段。
   Fusion で R2〜R3 のフィレットを付けること (p99.5 は 12.68 / 14.14 で余裕)
7. `child_cam_mount` の `lens_off_bot`/`case_h`/`case_w`/`fin_x1` 実測で
   `deck_top`/`case_z0`/`case_z1`/`case_outer_x`/FOV 余裕が連動して変わる。
   実測後は必ず本部品も再ビルド・再検査すること
8. `mount_y0` (レンズがケース中央にあるという仮定) は推定値
9. **`part_index.py check` の DRIFT 2 件**: 本 `.md` を書き直したことで
   `child_cam_mount -> child_cam_bridge` と `child_side_bumper -> child_cam_bridge`
   が md ハッシュ drift になる。**外形 (240.0×61.0×150.05) も二重定義の値も
   すべて不変**なので実質的な取合い変更ではない。相手部品の
   `interfaces.json` の再 lock (統合作業) が要る — 本ワーカーは他部品の
   ファイルを触っていない
10. アセンブリへの反映 (`placement.json` の再配置は不要だが
   `check_asm_contacts.py` の再実行が要る) はオーケストレータが行う
