AquaBeacon/mechanical/parts/child/exterior/printed/child_cam_mount/child_cam_mount.md

# child_cam_mount — カメラマウント (縦向き防水ケース用)

外装フレーム再設計 (2026-08-02, [要件](../../../../../docs/子機外装フレーム再設計_要件.md)) の
細部品第 1 号。旧 `child_shell_fwd` のポッド + `child_cam_lid` (裸カメラ落とし込み式) を置き換える。

| 項目 | 値 |
|---|---|
| 区分 | 子機 / 外装 / 3Dプリント |
| 設計ソース | `child_cam_mount.scad` |
| 個数 | **2** (左右共通。部品は y=0 対称なので同一品) |
| 外形 | 30.0 × 44.0 × 34.0 mm |
| 体積 | 24.5 cm³ (STEP) → PETG 約 20 g |
| STEP | 1 ソリッド / 100 面 / watertight |

## 役割

DJI Osmo Action 6 を**純正防水ケースに入れたまま縦向き (ポートレート)** に保持する。
ケース底面の DJI クイックリリース デュアルタブ (GoPro 2 フィンガー互換) を
本部品の 3 フィンガー (台座一体の最下段 + 中・上段) で受け、**M5 ノブボルト 1 本 +
底面ナットトラップ**で締結する。ケース底面はフィンガー脇のレジスタ柱 ×2 の前面
(x=30) に突き当たり、ヨー/ピッチの再現性を出す (GoPro ジョイントの摩擦頼みにしない)。

縦向き搭載の理由: ケース幅 94.7 を基線方向に置くと全幅 262 で 250 枠を超えるが、
縦向きなら 84.1/2 → **全幅 234.2 + 保護代**で収まる (要件書 §6)。
**代償: 水平 FOV 145° → 105°** (2026-08-02 ユーザ決定)。

## 主要寸法 (すべて公称/推定の**仮値** — 実測後に置換)

| 変数 | 値 | 意味 |
|---|---|---|
| `case_w/case_h/case_d` | 94.7 / 84.1 / 45.9 | 防水ケース外形 (幅/高さ/奥行と解釈) |
| `lens_off_bot` | 42.05 | ケース底面→レンズ軸。**仮 = case_h/2。要実測** |
| `tab_t` / `tab_w` / `tab_len` | 3.0 / 16 / 18 | ケース側タブ (GoPro 互換想定) |
| `tab_hole_off` | 9.0 | ケース底面→タブ穴中心。**要実測** |
| `fin_t` / `gap_t` | 3.0 / 3.4 | フィンガー厚 / 間隙 (遊び 0.4) |
| `fin_len` | 22 | タブ 18 より長くしてノブ頭の逃げを確保 |
| `plate_t` | 8 | 背面プレート厚 |
| `fh_y` / `fh_z` | ±16 / ±11 | フレーム M5 ×4 (Ø5.4 ティアドロップ) |

## インタフェース

- **コアフレーム側 (未設計)**: 背面プレート M5 ×4 @ (y=±16, z=±11)、プレート外形
  44 × 34。フレーム側はナットトラップ or M5 熱圧入インサートを用意すること。
- **配置の目安 (lens_off_bot=42.05 仮のとき)**: レジスタ面のグローバル |X| = 32.95、
  プレート背面 |X| = 2.95。**左右のマウントがほぼ背中合わせ**になるので、コアフレームの
  センターパイロン (~6mm 厚 + 座面) に両側から共締めする構成を想定。
  `lens_off_bot` の実測でこの数字は動く。
- ケースとの取合いは `interfaces.json` (part_index lock 済み、仮値ステータス付き)。

## 荷重ケースと強度

**L2 輸送**: カメラ+ケース 0.26 kg × 10g ≈ 26 N (全方向、要件書 §3)。

- `quick_strength beam` (3 フィンガー合成断面 b=48 × t=3、L=20、F=30 N):
  曲げ 8.3 MPa / 面内許容 12 → **PASS** (たわみ 0.42 mm)
- `quick_strength lug` (M5 穴 Ø5.2、t=9、F=60 N): 面圧 1.3 MPa → **PASS**
- 印刷姿勢でフィンガー曲げの引張は XY 面内 (printability `cos = 0.00`)
- fea_check は形状が単純で余裕が大きいため省略 (コアフレーム側で全体系を FEA する)

## 印刷 (X1-Carbon)

- **モデル姿勢のまま (+Z up)**。printability: **PASS** (オーバーハング 14.6%、
  最小肉厚 2.43mm、荷重面内)
- 中・上フィンガー下面は 3.4mm 間隙上のキャンチレバー。下面縁は 45° 面取り済み。
  垂れは `tab_clr 0.4` が吸収するが、気になる場合は**間隙 2 箇所のみサポート**を置く
- 横穴 (フレーム M5 ×4) はティアドロップ、ナットトラップ天井は 45° コーンで自己支持

## 干渉チェック (`.scad` 冒頭の assert)

- 間隙 ≥ タブ厚 + 0.3 / フィンガー長 > タブ長 + 2 (ノブ頭の逃げ)
- ノブ頭 (Ø16 想定) がプレートに当たらない / 穴縁距離 ≥ 2
- ナットトラップ側壁 ≥ 2 / フレーム穴の端距離 / 柱がプレートからはみ出さない
- **280 枠検査 (2026-09-04 更新、横向き搭載復帰)**:
  `base_line/2 + case_w/2 + bumper_t ≤ env_half(140)`
  → 現仮値で 75 + 47.35 + 9 = 131.35 ≤ 140 PASS。`bumper_t=9` は
  `child_side_bumper` の板厚と二重定義 (要突合せ)。旧・縦向き用の 250 枠検査
  (`base_line/2 + (case_h − lens_off_bot) ≤ 125 − 保護代 5`) は無効化した
  (`bumper_min` 変数は未使用のまま残置)。`lens_off_bot` 実測時に自動で再検査される

## 部品外の考慮

- ケース着脱はノブボルト 1 本 (工具レス)。ノブ頭の上方アクセスをコアフレームで塞がない
- カメラ+ケースはフレーム包絡から前に出る唯一の物体になるので、**保護 (R4) は
  コアフレーム側の前縁バンパ + 側面リム (片側 ~8mm の余裕) で受ける** (本部品の責務外)
- ケースのラッチ (開閉) 側の操作空間、ボタン類へのアクセスは**ケース実物入手後に確認**
- ケーブルなし (カメラは完全内蔵、防水ケースのまま)

## 要確認 (実測待ち — 2026-08-02 ユーザ「後で実測する」)

1. ケース外形 3 辺と軸の対応 (公称 94.7×45.9×84.1 の解釈確認)
2. **レンズ軸位置** (`lens_off_bot`) — 280 枠と左右マウント間隔の両方に効く
3. タブ実寸 (`tab_t`/`tab_w`/`tab_len`/`tab_hole_off`) と穴径
4. タブ面〜レンズ軸の直交方向オフセット (縦向きでの Z 方向レンズ位置に効く)
5. **2026-09-04**: 横向き搭載 (`child_cam_bridge`, 未着手) 側のデッキ高さ導出
   `deck_top = lens_z(125) - lens_off_bot(42.05) - fin_x1(30) = 52.95` は
   HP-L 塞ぎ禁止 (ブリッジ最下端 z≥72) と矛盾する。`lens_off_bot` の定義は
   レジスタ面 (`fin_x1`) 起点であって、ケース底面 (タブ先端) 起点ではない
   (旧コメントの「ケース底面(タブ面)→レンズ軸」は誤解を招くため訂正済み)。
   本部品自体の形状・寸法は変更していない。ブリッジ設計者は
   レンズ高さ (`lens_z`) を上げる案 A などをオーケストレータに確認すること。
