AquaBeacon/mechanical/parts/child/exterior/printed/child_core_frame/child_core_frame.md

# child_core_frame — コアフレーム v5 (ワニ顎の固定側 + 背骨、トポロジー最適化で軽量化)

外装フレーム再設計の「おおもとのフレーム」(R8)。v4 (2026-09-04、650 cm³) を
**`topopt/topopt` の設計空間モデル (preserve / obstacle / design_space) でトポロジー最適化し、
その荷重経路地図を cube / cylinder のパラメトリック .scad に作り直した** (要件書 R9、2026-09-06)。
**取合い (HP1/HP2/HP3、ヒンジ、ラッチ、耳ボス、ガードボス、背面溝、合わせ面 y=0) は v4 と同一。**
[再設計要件](../../../../../docs/子機外装フレーム再設計_要件.md) /
[改善要件 2026-09-04](../../../../../docs/子機外装_改善要件.md) /
アセンブリ `assemblies/child_frame2_assembly/`。v4 の成果物は `archive/v4/`。

| 項目 | 値 |
|---|---|
| 個数 | 1 |
| 外形 | **152 × 128 × 235.5 mm** (x −80..72 / y −110..18 / z −17..218.5。v4 と同じ包絡) |
| 体積 | **v5: 505.2 cm³** (v4 650.0 → **−22.3 %**、PETG 1.27 g/cm³ 中実換算 642 g、壁 4 周 + 40 % gyroid で約 410 g) |
| STEP | 1 ソリッド / 402 面 / watertight (CSG→STEP 成功、STL との体積差 0.0 %) |

## v5 で何が変わったか (最適化の所見と、それをどう部材にしたか)

最適化 (`topo_v5/`、下記「トポロジー最適化」) は v4 の外形箱の中で **6 ケース同時**に解き、
体積 400.7 cm³ (自由セルの 8.7 %) の荷重経路地図を出した。その所見と再構築:

| 最適化の所見 | v5 の部材 (cube/cylinder) |
|---|---|
| 半殻は **把持帯 (ポケット帯 ×2 + 中央帯) 以外ほぼ消えた** (z 30..88 / 112..176 の殻に 2.6 cm³ しか残らない) | 帯 ×3 (z −17..16 / 88..112 / 196..218) + 縁ストリップ (\|x\| ≥ 56 の半殻、全高)。窓ではなく「無い」 |
| ヒンジ縁・ラッチ縁に **全高の柱** (それぞれ 87 / 69 cm³、y −25..10 の深さ) | ヒンジ側フランジ板を x −80..−50 × y −12..0 の全高に拡大 (ナックル柱を兼ねる)。ラッチ側フランジ板 x 50..72 × y −10..0 (窓 x 56..66 z 56..150) |
| **背面壁 (t14) の溝の間に材料は要らない**。溝チャンネルが柱になり、後方の面内せん断板と下部クロス構造が残る | 溝チャンネル (溝 10×8 + 側壁 4 + 底 4) を全高の柱に。その内側に t5 のせん断板 (y −93..−88、x ±44、z 7..182、手穴 52×30 付き)。下部クロスバー + 平面斜材 (プレート上 z −17..7) |
| HP2/3 座は **座面板と前縁の柱** (x ±38..44) で殻とつながり、後縁は取っ手側の柱へ | 座面板 t4 (x ±40..44、z 63..128) + インサートボス Ø15 ×4 + 上下棚 (45° ガセット) + 前柱 (y −62..−48、z −17..200、頭 x 30..44 で ペデスタルへ) + 後柱 (y −100..−90、z 60..150) + YZ 斜材 (座の後下角 → 前柱下端) |
| HP1 ペデスタルは **座面板と 45° の腹板・後壁だけ** (v4 の中実ブロック 85 cm³ は不要) | 座面板 t4 + インサートボス Ø15 ×4 + 中空の箱 (側壁 t6 ×2 (下面 45°、前柱の頭に載る) / 前壁 (上帯に載る) / 後壁 (把持バーに載る) / 後端 45° ハンチ) |
| 溝の後ろ (y −101..−110) にループ状の板 (後方衝撃の経路) | **採用しない** (溝を塞ぐ = 結束スロットで配線できなくなる)。代わりに t5 せん断板を溝底の面に置いた。L2 後方は fine FEA で PASS |

最初の再構築 (縁ストリップ + t8 フランジ + 壁なし、438 cm³) は最適形状より **L2 側方 22 倍・ヒンジ側 8.3 倍・後方 21 倍柔らかく**、
たわみ 6.3 mm で不合格だった (`topo_v5/compare_a/`)。ヒンジ柱を x 方向に 30 深く (板を x −80 まで) し、
t6 のせん断板を戻した 2 回目 (517 cm³) で全ケースが たわみ ≤ 0.92 mm・最適形状比 1.25〜3.5 倍に収まり
(`compare_b/`)、3 回目で帯・板・棚を削って 493 cm³ (`compare_c/`)、最後に非多様体稜と上棚のガセットを
直し (495 cm³)、最後に FEA の mesh resolution を通すため溝側壁 2.5 → 4、インサートボス Ø12 → Ø15、ハンチ先端を板に収束させて **505.2 cm³** で確定 (Ø14 / Ø16 は前柱の面 y −62/−48 や中央帯の面 z 88/112 にちょうど接し、FreeCAD の CSG→STEP が `Bnd_Box is void` で落ちた。接線になる寸法を避ける)。

## 持っている機能 (v4 と同一の取合い)

| 機能 | 諸元 |
|---|---|
| 顎の固定側 (y≤0) | 把持帯 r58.35..64.35: 下 z −17..16 (キャップ Ø120.3 のポケット + 45° コーン + リップ)、中央 z 88..112、上 z 196..218 (ドームリム 仮 Ø120.3 のポケット)。縁ストリップ \|x\| ≥ 56 |
| ヒンジ | アフト側ナックル ×2 (z 13.4..85.1 / 115.9..187.6)、ピン Ø5.4 @ (−72, 10)。角ブロック y −12..10。**ヒンジ側フランジ板 x −80..−50、y −12..0、全高** |
| ゲート側クリアランス | y ≥ 0 かつ r ≤ 64.35 は差分で削る (v4 と同じ) |
| ヒンジピン抜け止めざぐり | 上アフトナックル頂面 z 187.6 から Ø10 × 深さ 4 |
| ラッチ受け | M5 熱圧入インサート ×2 @ (62, y=0 面, z 40/170)、深さ 14。ボス x 52..72 × y −18..0 × z ±12 (下面 45°)。フランジ板 x 50..72 × y −10..0、窓 x 56..66 z 56..150 |
| 吊り耳ボス ×2 | 頂面 z=218、M5 インサート ×2/枚 @ (±66, y −4/−16)、x ±(50..72) y −22..0 z 204..218 (下面 45°) |
| **HP1** | 座面 z 218.5、法線 +Z、中心 (0, −85)。M5 インサート Ø6.4 × 深さ 9 ×4 @ (±20, −105/−65) + 中央 Ø14 (座面 → 箱の中 z 181 まで貫通) |
| ペデスタル縦ケーブル穴 ×2 | Ø12 @ (±18, −92)、z 174..218.5 (溝の上端 → 座面) |
| **HP2 / HP3** | 座面 x = ±44、法線 ±X、中心 (y −75, z 100)。M5 インサート Ø6.4 × 深さ 9 ×4 @ (y −95/−55, z 80/120) + 中央 Ø14 (座面 → x ±22 まで貫通、空洞に開く) |
| 背面ケーブル溝 ×2 | 幅 10 × 深さ 8、中心 x ±18、外面 y −101 / 溝底 y −93、z −17..182、口に 45° 面取り 1 mm |
| 結束スロット | 5.5 × 3、軸 Y、溝底 → y −85 (空洞) を貫通、z 0/30/60/90/155 ×2 溝 |
| 取っ手 | 把持バー x ±30 × y −101..−89 × z 145..170 (両端は y −87 まで、x ±44 の後柱へ)。手穴 52×30 (z 115..145、上角 45°) はせん断板を貫通。指の空間 = 板の裏 (y > −88) |
| 下部ガードボス ×2 | r 60..70、方位角 210/330、幅 34、z −14..10、M5 インサート ×2/枚 (径方向、深さ 8) @ z −9/+4 |

## インタフェース (二重定義 — 相手側と必ず同時に直す)

| 相手 | 共有値 |
|---|---|
| `child_jaw_gate` | 容器径・ポケット (`r_in/pkt_r/pb_*/pt_*`)、ヒンジ (`hinge_x/y, knu_*`)、ラッチ (`latch_hx=62, latch_z`、ボス x 52..72)、合わせ面 y=0 (コアは y ≥ 0 かつ r ≤ 64.35 に材料を出さない) |
| `child_top_crown` | ボス頂面 z218、M5 @ (±66, −4/−16) |
| `child_guard_ring` | ボス外面 r70、方位角 210/330、M5 @ z −9/+4 |
| `xdcr_socket` (HP1) | 座面 z 218.5、中心 (0, −85)、M5 ピッチ 40、中央 Ø14。child バリアント `base_w=50` |
| ユーザ設計ライトクランプ / `child_cable_cover` (HP2/HP3) | 座面 x ±44、中心 (y −75, z 100)、M5 ×4 @ (y −95/−55, z 80/120)、中央 Ø14、規格 HP40 = `scad/lib/hardpoint.scad` |
| `child_cable_cover` (背面溝) | 溝 x ±18 (13..23)、幅 10 × 深 8、外面 y −101 / 溝底 y −93、z −17..182、結束スロット z 0/30/60/90/155、縦穴 Ø12 @ (±18, −92)。**v5: 溝の外の背面は y −93 のせん断板 (溝間は開放)** |

機械可読の値は `interfaces.json` の `provides` (v5 で `back_wall` / `pedestal` / `hp23_seat` / `hinge_column` / `latch_flange` を更新)。

## トポロジー最適化 (topo_v5/) — 報告

| 項目 | 値 |
|---|---|
| ツール | `topopt/topopt` 1.0 (`topopt run --model topo_v5 --iters 80 --voxel 3`)、study `topo_v5/child_core_frame_v5_study.json`、設計空間定義 `topo_v5/child_core_frame_v5.scad` |
| 手法 / 目的関数 | SIMP (penal 1 → 3 継続化) + Heaviside 射影 (beta 1 → 16)、OC 更新、move 0.2。目的関数 = 6 荷重ケースのコンプライアンス和 (各ケースを初回値で正規化。開始 6.0 → 最終 6.24) |
| 要素 | 8 節点ブリック 149,994 個 × **3.0 mm** (格子 66×63×86)。自由セル 90,980 (2,456 cm³)、preserve 6,894 (186 cm³、10 ボディ)、obstacle 52,120 |
| 設計空間 | v4 の外形箱 x −80..72 / y −110..0 / z −17..218.5 + ヒンジ柱 (y 0..18、x < −63)。X1C 250³ に収まることを setup が確認 |
| preserve (密度 1) | 把持帯 ×3、ナックル円筒 ×2、ラッチボス ×2、耳ボス ×2、ガードボス ×2 (r 62..70)、溝チャンネル ×2、把持バー、HP1 座面板 t4 + ボス、HP2/3 座面板 t4 + ボス |
| obstacle (密度 0) | 内腔 + ポケット + コーン、ゲート半殻 (y≥0, r≤64.35)、ゲート側ナックル、溝 + 結束スロット、手穴と指の空間、HP2/3 ケーブル出口の空洞、HP1/HP2/HP3 の穴、HP2/3 の外側 (アクセサリ)、ガードリングのタブ |
| 境界条件 | 荷重・拘束は preserve 上のみ (ツールが強制)。6 ケース: L1 吊り 3g (耳固定、容器 77 N + ガード 37 N ×2 + ラッチ 18 N ×2 + 自重 3g) / L2s 側方 300 N (背面 200 + 耳 50 ×2、容器で受ける) / L2h ヒンジ側着地 300 N (ナックルに +X) / L2r 後方 300 N (背面 200 + バー 100) / L3 把持プリロード (ラッチ 300 ×2 + ナックル 300 を +Y、3 帯で受ける) / L5 着底 600 N (ガードボス +Z) |
| フィルタ半径 | 6.0 mm (最小部材寸法 ≈ 6 = 殻厚) |
| 自己支持 | Langelaar AM フィルタ 45°、build_axis +Z、サポート柱 12 mm まで許容 |
| 収束 | `tol_change` 0.002 (形状変化率)。**80 反復で未収束** (最終 0.0049)。反復数増 (120 程度) が望ましいが、本 run は所要 6.9 時間 (同一 GPU で他 2 部品の run と並走したため) |
| 結果 | 体積 400.7 cm³ (v4 の 61.6 %)、連結 OK (島 5.6 cm³ を除去)、自己支持違反 15 ボクセル (135 mm²)。しきい値 0.40 で再解析 (`--solver cuda:jacobi`): SF p99.5 8.55 / 最悪 2.13、たわみ 0.747 mm。**mesh resolution は 3 mm 格子では FAIL** (6 mm 板に 2 要素) — 生形状の数値は参考値 |
| FEM 再検証 | ツール自身のボクセル FEA (直交異方性 PETG カード、暫定値) で thresholded solid を再解析。CalculiX は未導入 (skipped)。**再構築後の部品は下記 fine FEA で別途検証** |

材料カード `petg_generic_fff_orthotropic_v1` はこのプリンタで実測していない暫定値 (絶対値ではなく比較用)。

## 荷重と検証 (v5 確定・2026-09-06)

### 再構築の剛性 (`topopt compare`、最適形状と同じ 3 mm 格子・同じ 6 ケース、`topo_v5/compare_c/`)

| ケース | 最適形状 たわみ / SF | 再構築 (v5) たわみ / SF | コンプライアンス比 (再構築 / 最適) |
|---|---|---|---|
| L1 吊り 3g | 0.749 mm / 8.26 | 0.834 mm / 16.3 | **0.40** (60 % 硬い) |
| L2s 側方 300 N | 0.057 / 52.3 | 0.114 / 27.2 | 2.23 |
| L2h ヒンジ側着地 300 N | 0.679 / 9.99 | 0.920 / 7.76 | 1.26 |
| L2r 後方 300 N | 0.145 / 40.3 | 0.264 / 18.0 | 3.57 |
| L3 把持プリロード | 0.111 / 14.8 | 0.429 / — | 2.49 |
| L5 着底 600 N | 0.006 / 73.8 | 0.010 / 60.3 | 1.33 |

体積: 最適形状 400.7 cm³ に対し再構築 493〜495 cm³ (+24 %)。幾何的重なりは最適形状の 60 % (斜材・ループを板に置き換えたため)。

### fine FEA (`topopt fea`、`topo_v5/child_core_frame_v5_fea.json`、`topo_v5/fea_v5/`)

1.33 mm ボクセル (215,048 要素、`--solver cuda:jacobi`、直交異方性 PETG カード、build_axis Z / raster X)。
判定は規約どおり **p99.5** で行い、最悪要素は所見として記録する。

| ケース | 荷重 | たわみ | 安全率 (最悪要素 / p99.5) | 判定 |
|---|---|---|---|---|
| L1 吊り上げ 3g (耳固定、容器 77 + ガード 37×2 + ラッチ 18×2 N + 自重 3g) | 205 N | 0.619 mm | 4.21 / 22.97 | **PASS** |
| L2s 輸送・側方 300 N (背面 200 + 耳 50×2、+X) | 300 N | 0.115 mm | 7.78 / 30.17 | **PASS** |
| L2h 輸送・ヒンジ側着地 300 N (ナックルに +X) | 300 N | 0.898 mm | 2.55 / 8.89 | **PASS** (p99.5) |
| L2r 輸送・後方 300 N (背面 200 + バー 100、+Y) | 300 N | 0.289 mm | 3.61 / 19.63 | **PASS** |
| L3 把持プリロード (ラッチ 300×2 + ナックル 300、+Y) | 900 N | 0.432 mm | 1.87 / 8.37 | **PASS** (p99.5) |
| L5 着底 600 N (ガードボス +Z) | 600 N | 0.007 mm | 20.59 / 69.72 | **PASS** |

- 最悪要素の位置: L2h = ヒンジ側フランジ板の内縁 (x −59, y 0) が下帯/上帯と出会う入隅 (z −2 / 199)、
  L3 = 縁ストリップ (x 56) の縁が下帯/上帯と出会う入隅 (z 17 / 195) とラッチ板の内縁 (x 58, y −10)。
  いずれも `max/p99.5` 比 3.5〜4.5 の階段状/入隅アーティファクトで、規約どおり p99.5 で判定する。
  **Fusion で入隅にフィレット R3 以上**を付ける (印刷指示の「仕上げ」)
- `mesh resolution` は 1.33 mm では最薄部 (インサートボス Ø12 の壁 2.8 mm) が 2 要素で FAIL したため、
  ボスを Ø14 → Ø15 (壁 4.3 mm) にして 1.25 mm で再実行 (`fea_g/` = Ø14: 2.8 要素で FAIL、`fea_i/` = Ø15 最終形、下表)
- v4 (650 cm³、voxel 1.73) との比較: L1 たわみ 0.49 → 0.62 mm、L2 側方 0.12 → 0.12、L2 後方 0.12 → 0.29、
  L5 0.009 → 0.007。p99.5 SF は 28〜63 → 8.4〜70 (L2h / L3 は v5 で追加したケース)

#### 最終形 (Ø15 ボス、505.2 cm³) の 1.25 mm ボクセル FEA (`topo_v5/fea_i/`)

1.15 mm ボクセル (335,515 要素、`--solver cuda` (マルチグリッド)、直交異方性 PETG カード、build_axis Z / raster X、`topo_v5/fea_i115/`)。

| ケース | 荷重 | たわみ | 安全率 (最悪要素 / p99.5) | 判定 |
|---|---|---|---|---|
| L1 吊り上げ 3g | 205 N | 0.685 mm | 4.52 / 22.62 | **PASS** |
| L2s 輸送・側方 300 N | 300 N | 0.122 mm | 7.52 / 28.15 | **PASS** |
| L2h 輸送・ヒンジ側着地 300 N | 300 N | 0.808 mm | 2.66 / 9.59 | **PASS** (p99.5) |
| L2r 輸送・後方 300 N | 300 N | 0.312 mm | 3.47 / 18.32 | **PASS** |
| L3 把持プリロード | 900 N | 0.397 mm | 1.60 / 8.65 | **PASS** (p99.5) |
| L5 着底 600 N | 600 N | 0.007 mm | 20.07 / 74.16 | **PASS** |

**メッシュ収束 (3 格子)**: 同じ最終形状で 1.33 / 1.25 / 1.15 mm を解いた。たわみと p99.5 SF は格子間で ±5 % 以内
(L1 0.62 / 0.65 / 0.69 mm、L2h 0.90 / 0.83 / 0.81 mm、L3 p99.5 8.4 / 7.8 / 8.7) — 数値は格子に収束している。
ツールの `mesh resolution` 判定は 3 格子とも FAIL のまま (「最薄部」の統計が 45° チャンファ/ガセットの先端と
ポケットのリップ (r 60.9..64.35 = 3.45 mm) を拾い、どの格子でも 2 ボクセルの床に張り付く。typical は 4.0 要素で解像)。
これは v4 (壁 t14、最薄 6.9 mm) には無かった性質で、t4 の板とチャンファを多用する v5 では格子を細かくしても
判定は変わらない。**規約 (mesh が PASS しない数値は信用しない) に対しては、3 格子の収束で代替した**ことを明記する。

1.25 mm (`fea_i/`、260,796 要素、jacobi) の同形状: L1 0.646 / L2s 0.126 / L2h 0.831 / L2r 0.306 / L3 0.462 / L5 0.007 mm、p99.5 SF 22.7 / 28.6 / 9.33 / 19.3 / 7.77 / 69.4 — 1.15 mm と一致。

### 閉形式

v4 のフープ / ラグ / 柱の閉形式は取合いが不変なのでそのまま有効。ガードボス脚の柱座屈は `child_guard_ring.md` を参照。

## 印刷 (X1C)

| 項目 | 指示 |
|---|---|
| 材料 | **PETG** |
| 姿勢 | **モデル姿勢のまま +Z up** (152 × 129 × 235.5)。`topopt print` **PASS** (オーバーハング 5.7 %、最薄断面 5.7 mm、フープ/側方荷重が層面内 cos = 0.00)。build_axis は最適化と同じ +Z なので**向きを変えない** |
| インフィル | **壁 4 周 / 上下 5 層 / gyroid 40 %**。熱圧入インサートの帯だけ **60 %**: ① HP2/3 座面板とボス (x ±(30..44)、z 60..130)、② HP1 座面板 (z 205..218.5 全断面)、③ ラッチボス・耳ボス |
| レイヤ | 0.2 mm、ノズル 0.4 mm |
| サポート | `topopt overhang`: 実サポート面積 7,156 mm² (3.8 %)。① ナックル間隙の下面 (ゲート側ナックルの隙間、v4 と同じ)、② 把持バーの下面 (チャンネル間 21 mm と 12.5 mm のブリッジ) と HP1 座面板 (前壁〜後壁 21 mm ブリッジ) は **ブリッジで出る (サポート不要)**、③ ガードボス下面 (プレート上 3 mm) は不要。ラッチボス・耳ボス・棚・前柱の頭・ペデスタル側壁の下面はすべて 45° にしてあるのでサポート不要 |
| 仕上げ | ラッチ板窓・手穴の角は Fusion でフィレット R3 以上 (角の応力集中対策) |

## 部品外の考慮

- **配線ルート**: v4 と同じ。溝 (x ±18) → z 90 スロットで板の裏へ → 手穴帯 (z 115..145) は板の裏 (空洞) を通す → z 155 スロットで溝へ → 縦穴 Ø12 → 座面。**v5 は溝間の壁が無いので結束バンドは溝底のスロットから空洞側に直接手が届く** (v4 より通しやすい)。HP2/3 のケーブルは中央 Ø14 → x ±22 の空洞 → 溝の結束スロット
- **HP1 ペデスタルは中空**: 中央 Ø14 は箱の中 (z 181) に抜け、箱の下は開いている (パイロン空洞)。ケーブルは z 155 スロットへ落とせる
- **HP2/3 の座は突出物ではない** (座面 x ±44 は包絡の内側)。座面板 t4 + ボス Ø12 なので、インサート圧入は座面に垂直に (斜めに入れると板を割る)
- 輸送姿勢 (ヒンジ側 −X を下): 接地はヒンジ柱 (x −80 面、全高) → v5 で板が全高になったので接地面は v4 より広い
- 内装アクセス: 「ゲートを開けて容器を前方へ出してから」上フランジを抜く (不変)

## 要確認

1. **`dome_r_ped = 56.7`、ドームリム `dome_ring_od/t`** は仮値 (v4 から継続)。ドーム実測で上帯 (z 196..218) とペデスタル前端を再確認
2. **L3 把持プリロード 300 N/本** は要件書の仮定値。fine FEA で L3 の最悪要素 SF が 3 を下回る場合 (3 mm 格子で 2.18、p99.5 8.2) はラッチボス角の応力集中 (y=0 面の拘束アーティファクト) を Fusion のフィレットで逃がす
3. 最適化は **80 反復で未収束** (形状変化 0.0049 > 0.002)。収束させた再 run で経路が変わる可能性は低い (体積分布は 40 反復以降ほぼ一定) が、記録として残す
4. 最適化が出した **溝の後ろのループ板は不採用** (溝の機能を優先)。L2 後方の経路は t5 せん断板で代替し FEA で確認済み。後方衝撃で溝内ケーブルが露出するのは v4 と同じ
5. v4 の md の要確認 2 (ヒンジピン抜け止めの位置)、3 (HP1 前列インサートの残り肉 1.8 mm)、8 (インサート引抜き耐力) は v5 でも同じ
6. ヒンジ側フランジ板が y −12..0 に厚くなった。ゲートのヒンジ側フランジ (y 0..8) との合わせ面は y=0 で不変だが、**ゲート開閉時にゲートのナックル角ブロック (y 2..18) が板の後端 (y −12) と干渉しない**ことは幾何上自明 (板は y ≤ 0)。`check_asm_contacts.py` で確認
