AquaBeacon/mechanical/parts/child/exterior/printed/child_frame_plate/child_frame_plate.md

# child_frame_plate — 子機 フレームベースプレート

| 項目 | 値 |
|---|---|
| 区分 | 子機 / 外装 / 3Dプリント |
| 設計ソース | `child_frame_plate.scad` |
| 個数 | 1 |
| 外形 | 200 × 300 × 6 mm |
| 体積 | 337.4 cm³ |
| STEP | 1 ソリッド / 59 面 |

## 役割

子機のすべてを載せる基準部品。**アセンブリの原点 (底面 z = 0)** はこの板。

| 搭載物 | 位置 |
|---|---|
| チューブクランプ ×2 (`child_clamp_base`) | 中央、y = ±60 / M5 x=±80, y=中心±20 |
| Osmo アーム ×2 (`child_osmo_arm`) | 左右端 / M5 x = ±70, ±90, y = ±30 |
| 水中ライト (`dive_light`) | 前縁 / M4 x = ±15, y = +100, +120 |
| TD04A ソケット (`xdcr_socket`) | 後方コーナー / 中心 (±70, −120)、M5 ピッチ 40 |
| おもり (バラスト) | 中央下面沿いのスロット ×2 (x = ±30, 幅 10 × 長 140) |
| 汎用 | 40mm グリッド穴 (Ø5.3) |

## 座標系

X = 左右 (基線方向) / Y = 前後 (チューブ軸・進行方向、+Y = 前) / 原点 = 板の中心。

## 主要寸法

| 変数 | 値 |
|---|---|
| `plate_x / plate_y / plate_t` | 200 / 300 / 6 |
| `clamp_cy` | 60 |
| `arm_hx / arm_hy` | [70, 90] / ±30 |
| `xd_cx / xd_cy / xd_pitch` | ±70 / −120 / 40 |
| `light_hx / light_hy` | ±15 / [100, 120] |
| `w_slot_x / w_slot_w / w_slot_l` | ±30 / 10 / 140 |

## 印刷向き

平置き。**200 × 300 はベッドに載らない可能性が高い**。
45° 置き、または 2 分割 (要相談)。分割する場合は継ぎ手の設計が必要 (**未設計**)。

## 部品外の考慮

- 40mm グリッド穴は**結束バンドの結束点**として使う。テザー・ライト・振動子の
  ケーブルはここに固定してカメラ視野から外す。
- **テザーのストレインリリーフが未設計**。シール部に引張をかけないため、
  プレート側でテザーを受ける金具/アイボルトが要る。
- おもりスロットは下面沿い。**水中でのトリム調整**に使うので、実機で
  前後バランスを見てから位置を決められるよう長穴になっている。
- プレート下面と地面 (陸上での置き方) — 現状 脚がない。運搬・仮置き時に
  カメラやライトが直接当たらないか確認すること。

## 要確認

1. プリンタのベッドサイズ → 分割要否の判断
2. 各搭載物の実穴位置 (ライトは特に**未選定**なので仮の M4×4)
3. ストレインリリーフの追加設計
