AquaBeacon/mechanical/parts/child/exterior/printed/child_guard_ring/child_guard_ring.md

# child_guard_ring — 下部ガード (再設計版)

旧 `child_bottom_guard` の置き換え ([要件](../../../../../docs/子機外装フレーム再設計_要件.md))。

| 項目 | 値 |
|---|---|
| 区分 | 子機 / 外装 / 3Dプリント |
| 個数 | 1 |
| 外形 | Ø170 × 72 (z −60 .. +12、タブ含む) |
| 体積 | STEP volume 157778.9 mm³ = 157.78 cm³ → PETG 約 126 g |
| STEP | **1 ソリッド** / 79 面。STL は inspect_mesh が 113 open edges を報告するが、これまでと同種の
  コプレーナ面の頂点重複アーティファクト (1e-4 丸めでは閉多様体、スライサ実害なし) |

**2026-09-04 改訂 (子機外装_改善要件.md §3.4)**: `ring_z0` を **−37 → −60** に変更
(キャップ下面から 46mm = ペネトレータ突出 20 + 曲げ半径 25 の確保)。付随して
`tab_t` を **8 → 12** (下記荷重再検査)、`cover_bolt_*` (カバー取付インサート座) を新設。

## 役割

アルミキャップ+ペネトレータの保護 / 着底脚 / バラスト座 / カバー取付座。

- **スキッドリング** r65..85 × t6、下端 `ring_z0=-60` (機体最下端)
- **脚 ×3** (方位角 30/90/150、上端 −17.2 = ゲート旋回域 −17 に遊び 0.2、
  下端 `ring_z1=-54`。脚長 `leg_h=36.8` (旧 13.8 から延長))
- **後部ウォール ×2** (方位角 190..230 / 310..350、シェルと同径 58.35..64.35)。
  リングとは**足 (r→69)** で融合 (assert で掛かり ≥3mm を検査)
- **取付タブ ×2** (方位角 210/330、r70..82 × w34、z −54..+12、厚 `tab_t=12`):
  コアフレーム外面の**ボス (外面 r70、二重定義)** へ**水平 M5 ×2/枚** (z −9/+4)
- **カバー取付インサート座 ×2** (`cover_bolt_*`、後部ウォール端 az=230/310 に
  半径方向厚肉ボス r58.35..68、M5 熱圧入インサート Ø6.4×9 を接線方向にブラインドで埋める)。
  `child_cable_cover` の M5 ×2 を受ける (下記インタフェース参照)
- **バラスト M6 ×5** (r75、方位角 198/234/270/306/342 = 後ろ寄り)。下面座ぐり
  Ø11.5×4 (天井 45° コーン)。鉛の取付位置で吊り姿勢をトリム
- **テザー結束スロット ×2** (方位角 262/278、リング貫通)。補助的な仮止め用。
  **主ストレインリリーフは `child_cable_cover` のクランプ座に移った**
  (2026-09-04 改善要件 §3.4-2。テザー張力をここで受け、ペネトレータに掛けない)

## 開放域 (assert 検査)

- 中央 r<55 全高素通し (ペネトレータのトルクレンチ垂直アクセス)
- 後方セクタ 方位角 230..310 (−Y ±40°) はリングより上が素通し (全ケーブルの出口)

## インタフェース (二重定義 — コアフレーム側と揃えること)

- コアフレーム側: **ボス外面 r70、方位角 210/330 中心、幅 ≥34、z −14..+10、
  M5 熱圧入インサート @ z −9/+4** (未設計 — コアフレーム設計時に反映)
- `frame_bot=-17` (ゲート/フレーム下端)、ガード上端 −17.2
- **`cover_bolt_*` (`child_cable_cover` と共有、機体座標)**:
  `cover_bolt_az=[230,310]`、インサート中心 `r=64, z=-26`、
  `pad_deg=11`、`insert d6.4 x len9` (接線方向ブラインドボア、ボス外径 r68)。
  `child_cable_cover` 側は同じ位置に M5 バカ穴 Ø5.4 + 座ぐり Ø9×5 の
  取付フランジを持ち、この 2 本のインサートへ M5 で締結する。
  カバー座ぐりは `ring_z0=-60` より下に出ないこと (cable_cover 側 assert)。
  **`z=-35→-26`, `pad_deg=14→11` は 2026-09-04 作業中に cable_cover 設計時に変更**
  (出口穴 z=-40 とフランジボアを z 方向に分離するため)。両ファイルで揃えてある。

## 荷重と強度 (要件書 §3、2026-09-04 改善要件 C6 で 600N→300N に緩和)

`C:\Users\ryupc\.claude\skills\3d-print-design\scripts\quick_strength.py` (PETG, sf=2)。

- **L5 着底** (容器系 2.6kg×3g÷3 脚 ≈ 25.5N/脚、脚 断面 12×20、新 leg_h=36.8):
  `column --L 36.8 --b 12 --t 20 --F 25.5` → 圧縮 0.106 MPa、座屈比 0.001 → **PASS**
  (`ring_z0` 変更で脚が 13.8→36.8mm に伸びたが座屈にはまだ十分余裕)
- **L2 輸送 300N 側方** (リング弧、後方開口 230..310 = 80° 幅、r_mean≈75 の帯を
  パッド輸送で分布荷重として受ける想定、`--in-plane`。リング断面は面内印刷なので
  面内許容 19MPa を使用): `plate --a 104.7 --b 20 --t 6 --p 0.143 --in-plane`
  → 曲げ 1.135 MPa、たわみ 0.007mm → **PASS**
  (旧 md の「面内曲げ 7.5MPa (600N)」の再現ではなく、荷重が半分になった前提で
  分布荷重モデルとして再評価したもの。点荷重の上限ケースは下記「要確認」参照)
- **取付タブ (新規、この改訂で追加検査)**: `ring_z0` 変更でタブ下端 (`ring_z1=-54`) から
  下側 M5 (z=-9) までの片持ち長が 28→45mm に伸びた。タブは +Z up 印刷の垂直板なので
  半径方向 (`tab_t` 方向) の曲げは**層間 (interlayer)** 引張になる (`--in-plane` 不可)。
  `beam --L 45 --b 34 --t 8 --F 150` (300N/2 タブ) → 曲げ 18.6 MPa (許容 12) → **FAIL**。
  `tab_t` を **8→12** に増厚し再検査:
  `beam --L 45 --b 34 --t 12 --F 150` → 曲げ 8.27 MPa、たわみ 0.70mm → **PASS**
- タブの M5×2 せん断は変更なし。全体系 FEA (Workflow F ステージ5) で確認

## 印刷 (X1C)

モデル姿勢のまま (+Z up、リング下面がベッド)。ビルド確認 (2026-09-04): STEP 1 ソリッド
/ 75 面、外形 Ø170×72、STL/STEP 体積差 0.0%。

`topopt print child_guard_ring.stl --printer X1C --load-axis 1,0,0`:
+Z up でオーバーハング **18.1%** (旧 8.4% から悪化、限度 15% を超過)。
延長した脚・厚くしたタブの水平 M5 穴 (長さ 8→12mm) と新規インサート穴 ×2
(Ø6.4×9、水平ボア) の円筒上半分ぶんが主因。いずれも径 ≤6.4mm で FDM の
自己ブリッジ限界 (~8-10mm) 内のため実害は小さいと判断し、**サポート要否は
スライサ側で局所オーバーライド (穴のみサポート) を推奨**。全体姿勢は
面内荷重 (`--in-plane` 前提のリング/ウォール hoop 曲げ) を保つため +Z up を維持する
(+Y up は 10.6% で PASS するが、リングが縦置きになり L2 の面内曲げ前提が崩れるため不採用)。

## 部品外の考慮

- **ケーブル曲げ半径**: ペネトレータ先端 z −33.8 からリング上面 z −54 まで 20.2mm。
  真の 25mm 曲げ半径をここに収めきることはできない (90° 曲げの最下点は理論上 z≈−58.8
  になり、リング帯 z −60..−54 に食い込む)。実際には**ケーブルは半分曲がった状態で
  シェルを出て、`child_cable_cover` の外側で曲げを完了する**。assert では「収まる」ことを
  検査していない (幾何的に不可能なため)。
- テザー結束スロット (方位角 262/278) は補助の仮止め用。主ストレインリリーフは
  `child_cable_cover` のクランプ座 (EVA 挟み込み、M5×2) に移す。

## 要確認 (仮値)

1. **`pene_len=20` (ペネトレータ突出量) — 要実測**。`ring_z0` はこれで決まる
   (assert: リング下端 ≤ キャップ下面 − pene − 3)
2. バラスト鉛の形状・穴 (M6 通しか、タップか) — 入手後に座を合わせる
3. テザー外径・最小曲げ半径 (未選定。25mm は仮値)
4. **L2 側方荷重の点荷重ケース**: 上記 `plate` 分布荷重モデルは PASS 余裕が大きいが、
   角物 (工具の角など) が局所的に当たる点荷重ケースは未評価。心配なら
   `fea_check.py` で開口部エッジの応力集中を確認すること。
