AquaBeacon/mechanical/parts/child/exterior/printed/child_jaw_gate/child_jaw_gate.md

# child_jaw_gate — ワニ顎ゲート v3 (容器把持・可動側)

## 現行 v3 — 2026-09-09 ラッチ改良

Ø16 ノブ頭と容器の干渉を避けるため、円すい底の頭ポケットを廃止し、平面座を y=24 mm に移した。
ラッチ軸 x=62、z=40/170、通し穴 Ø5.4、コア合わせ面、HP 座、ヒンジは維持。
ボス高さ34 mm、追加8 mmの下面は45°補強とした。

| 項目 | v3 の検証値 |
|---|---|
| 外形 | 152 × 74.35 × 235 mm（変更なし） |
| 体積 | STL 222.769 cm³、v2比 +11.250 cm³（+5.32%、PETG中実換算 +14.3 g） |
| STEP | 1 solid / 215 faces、222.625 cm³。STLとの差0.064%、外形差0 mm |
| 想定Ø16頭の離隔 | アクリル1.943 mm、圧縮EVA0.743 mm |
| 座面検査 | 各座2,160点の環状支持領域をSTLで確認、通し穴閉塞なし |
| 旧220 cm³目標 | 2.769 cm³超過。組立不良の解消を優先 |

**ボルトは再選定が必要**。首下長は `24 + 必要ねじ掛かり長 + ワッシャ厚`。
コア下穴深さ14 mmは有効ねじ長ではないため、実インサートで底付き・ねじ掛かりを確認する。
ワッシャを含め頭径Ø16以下が前提。Ø24通路は指操作の保証ではなく、実物操作確認が必要。

**v2のFEA PASSをv3に引き継がない**。平面座での荷重導入とボルト長を更新した強度評価は未実施。
印刷姿勢は従来どおり+Z上、底z=-17。中帯・上帯下面のサポート検討は継続。
検証: `python scad/lib/verify_child_frame2_latch.py`。
[組立レビュー](../../../../../assemblies/child_frame2_assembly/review_20260909/review.md)。

## v2 設計・検証履歴

以下の数値・FEA・要確認9は**改良前v2の記録**であり、現行形状の検証結果ではない。

外装フレーム再設計 ([要件](../../../../../docs/子機外装フレーム再設計_要件.md) R5/R6) の把持機構。
耐圧容器 (WTE4 4″×200) を「ワニの顎」のように前後 2 つの半殻で咥える。本部品は**可動側 (前、y ≥ 0)**、
固定側は `child_core_frame` v5 (y ≤ 0)。

**v2 (2026-09-06)**: v1 (308.3 cm³) を `topo_v1/` のトポロジー最適化にかけ、その荷重経路地図を
cube / cylinder のパラメトリック `.scad` に**作り直した**。機能面 (取合い値) は v1 と完全に同一。
v1 は `archive/v1/` に保存。

| 項目 | 値 |
|---|---|
| 区分 | 子機 / 外装 / 3Dプリント |
| 設計ソース | `child_jaw_gate.scad` (`scad/lib/hardpoint.scad` を `use`) |
| 個数 | 1 |
| 外形 | 152.0 × 74.35 × 235.0 mm (x −80..72 / y 0..74.35 / z −17..218) |
| 体積 | **211.5 cm³** (v1 308.3 cm³ → **68.6%**、−96.8 cm³)。PETG (1.27 g/cm³) 約 269 g |
| STEP | **1 ソリッド / 211 面** / watertight。CSG→STEP 成功 (facet フォールバックなし。`does not match` は出ていない)。STEP 211,384.2 mm³ vs STL 211,519.2 mm³ = 0.1% 一致、bbox 差 0.00 mm |
| 最適化の理論値 | 176.4 cm³ (threshold 0.60 の finish 形状)。目標 ≤ 220 cm³ を達成 |

## v2 の構成 (最適化の所見 → 部材)

最適化 (`topo_v1/03_optimization/`、SIMP、80 反復、volfrac 0.052、filter 6 mm、voxel 3 mm) が
示した「材料が要る場所」を、次のとおり cube / cylinder の部材に落とした。

| 部材 | 位置・寸法 | 最適化のどの所見から |
|---|---|---|
| 把持帯 ×3 (半殻 r58.35〜64.35、t6、y≥0) | z −17..6 / 92..108 / 200..218 | 密度場は preserve の 3 帯以外の半殻にほぼ材料を置かなかった (帯間の殻は 0)。下帯だけ preserve の −2 から **+6** に伸ばした (HP-L キールと下ナックルの根元) |
| ヒンジ ナックル Ø16 ×3 | (−72, 10)、z −17..13 / 85.5..115.5 / 188..218 | preserve |
| ヒンジ 腕ブロック ×3 | x −80..−50 (内腔で実効 −80..−57)、y 0..**18**、各ナックルの z 範囲 30 mm ぶん | 帯をまたぐヒンジ柱は立たない (コア側ナックルが x −81..−63 を占有)。密度場は各ナックルを「自分と重なる帯」へ直接落とした。y 深さは v1 の 8 → 18 (L3 の worst 2.87 が腕根元だったため。18 = ヒンジ開閉スイープの限界) |
| ラッチ柱 | x 52..72 (実効 57..72)、y 0..**16**、全高 z −17..218 | 密度場で唯一の「全高の柱」。位置 x 58..72 / y 0..16 (= ノブ通路の口の下) まで一致 |
| ラッチボス ×2 | x 52..72、y 0..16、z 40/170 ±12 | preserve。y 16 = 柱と面一なので v1 の下面 45° 面取りは不要になった |
| 前面 HP 座 ×3 (座面板 50×**t6**×50 + インサートボス Ø12×12 ×4) | y 68.35..74.35、z 145..195 / 75..125 / −10..40 | preserve (t4)。**t6 に増やした** — 詳細は下記「反復」 |
| 縦キール ×2 | x ±17..23 (中心 = インサート列 x±20)、y 40 (内腔でトリム→実効 ~55)..74.35、全高 | 密度場の前面は「HP 座 ×3 を縦につないだ背骨」。座の裏を塊 (v1 のライザ 30×22×50) から 2 本の板に置換 |
| ブリッジ逃げ | \|x\|<27 かつ y≥64.35 かつ z 42.3..74 を切り欠き + 上端 45° 立ち上がり | obstacle (`child_cam_bridge` のデッキ+キール+離隔 2.65)。密度場もここは空だった |

**廃止したもの** (最適化が材料を置かなかった): 帯間の半殻、45° 屋根付き窓 ×4 (方位角 42.5/137.5)、
HP 座のシェルフ+ライザの塊、ヒンジ側の全高フランジ板 (x −64..−50.35)。

## インタフェース (**二重定義になる値** — 片方だけ直さない)

`interfaces.json` の `provides` に機械可読な形で持たせてある。

### child_core_frame v5 (y ≤ 0 側)

| 項目 | 値 |
|---|---|
| 合わせ面 | y = 0 (ゲートは y < 0 に材料を出さない) |
| 内腔 / 外径 / ポケット | `r_in=58.35` / `r_out=64.35` / `pkt_r=60.9` / 下ポケット z −14.3..−7.5 / 上ポケット z 207.5..215 / 45° コーン 2.55 |
| ヒンジ | ピン軸 (−72, 10)、Ø5 ピン (穴 Ø5.4、L≈240)、ナックル Ø16 h30、遊び 0.4。**ゲート側 z −17..13 / 85.5..115.5 / 188..218、コア側 z 13.4..85.1 / 115.9..187.6** (`.scad` の `core_knu_z` と 4 本の assert で追従検査) |
| ヒンジ抜け止め | ゲート側 最上ナックル頂面 z 218 に Ø10×4 のざぐり (実用の抜け止めはこちら。コア側 z 187.6 は組立後に手が入らない) |
| ラッチ | M5 ノブボルト ×2 (頭 Ø16)、軸 = Y、(62, z 40 / 170)。ゲート = 通し穴 Ø5.4 + 頭ポケット Ø18×12、コア = M5 インサート (Ø6.4×14) |
| コア側フランジ板 | ヒンジ側 x −80..−50 y −12..0 全高 / ラッチ側 x 50..72 y −10..0 全高 (v5 で変更されたがゲートの y≥0 側には影響しない) |

> v1 の `.md` はコア側ナックルを「z 13.4..83.6 / 122.4..187.6」と書いていたが、これは古い値。
> `child_core_frame.scad` の `aknu` から導かれる正しい値は **13.4..85.1 / 115.9..187.6** で、
> v2 の `.scad` はこちらを `core_knu_z` として持ち assert している。

### child_cam_bridge (HP4 / HP5)

- 座面 **y = 74.35** (共通平面、法線 +Y)、HP40 規格 (M5 熱圧入インサート下穴 Ø6.4×9、ピッチ 40×40)
- HP4 中心 (0, 74.35, 170) / HP5 中心 (0, 74.35, 100)、座面板 50×50 (x/z ±25)
- ブリッジ側の占有域 (ゲートが空けておく空間): **\|x\|<27 かつ y≥64.35 かつ z 42.3..74** /
  **\|x\|≥27 かつ y≥64.35 かつ z 42.3..167.05**。前者はゲートの縦キールを実際に切り欠いている
- `hp40_arrow()` (polygon) は STEP 規約で呼ばないので**座面に向きの目印は無い**。向きはアクセサリ側で管理

### ユーザ設計ライトクランプ (HP-L)

- HP-L 中心 (0, 74.35, 15)、同じ HP40 パターン + 中央 Ø14 ケーブル穴
- **v2 の変更**: 座の裏が中空になったので、Ø14 穴は座面板 t6 を貫通してキール間の空間 (x −17..17) へ抜ける
  (v1 は座ブロックの中で止まっていた)。容器内腔には通じていない

## 荷重ケースと安全率・たわみ

材料カード `petg_generic_fff_orthotropic_v1` (**実測値なし = 暫定**)、build_axis Z / raster X、
判定は SF p99.5 ≥ 3.0、たわみ ≤ 1.0 mm。

### 最終形の FEA (`topo_v1/fea_v2/`、voxel 2.0 mm、22.5k → 要素は下表)

study は最適化 study の `regions` / `cases` をそのまま流用し、**コーディネータ指示で
HP-L への L2 ケース (L2Lf / L2Ls) を追加**した (`topo_v1/child_jaw_gate_v2_fea.json`)。

`topopt fea child_jaw_gate_v2_fea.json --out fea_v2 --voxel 2.0 --solver cuda:jacobi`
→ **23,105 要素 (voxel 2.0 mm)、全 7 ケース PASS** (強度・剛性とも)。

| ケース | 荷重 | たわみ (最大位置) | von Mises max / p99.5 | **SF p99.5** | SF 最悪要素 (位置) |
|---|---|---|---|---|---|
| L1 吊り 3g | HP4/HP5 −Z 計 40 N + 自重 3g / 支持 = ナックル + ラッチ | 0.112 mm (16, 74, 217) | 2.17 / 0.96 MPa | **39.20** | 14.49 (−19, 63, 38) |
| L2f 前方 300 N | HP4/HP5 −Y 各 150 N / 支持 = 帯 ×3 | 0.368 mm (8, 74, 155) | 17.52 / 4.41 | **7.80** | 2.77 (−17, 67, 116) |
| L2s 側方 300 N | ラッチボス −X 各 150 N / 支持 = 帯 ×3 | 0.218 mm (66, 0, 43) | 6.42 / 3.48 | **9.56** | 3.85 (59, 7, 42) |
| **L3 把持プリロード** | ラッチボス −Y 各 300 N + ナックル −Y 300 N / 支持 = 帯 ×3 | 0.411 mm (68, 16, 45) | 13.53 / 7.02 | **3.95** | 1.80 (65, 15, 198) |
| **L4 前方衝突** | HP4 −Y 400 N + HP5 +Y 100 N / 支持 = 帯 ×3 | **0.811 mm** (−8, 74, 159) | 20.27 / 8.80 | **3.37** | 1.34 (−17, 67, 186) |
| L2Lf ライト前方 300 N (**追加ケース**) | HP-L −Y 300 N / 支持 = 帯 ×3 | 0.431 mm (8, 74, 39) | 11.23 / 4.21 | **7.79** | 3.01 (−21, 65, 0) |
| L2Ls ライト側方 300 N (**追加ケース**) | HP-L −X 300 N / 支持 = 帯 ×3 | 0.353 mm (−16, 74, 41) | 10.22 / 4.31 | **8.08** | 2.06 (21, 65, 0) |

判定: **全ケース 強度 PASS (SF p99.5 ≥ 3.0) / 剛性 PASS (たわみ ≤ 1.0 mm)**。
`mesh resolution` だけは voxel 2.0 では FAIL (最薄部 4.00 mm = ラッチボス脇のノブポケット壁と
インサートボスの壁。>=3 要素には voxel 1.33 が要る)。座面板を t4→t6 にしたことで
「典型断面」は 4.00→5.66 mm に改善している。voxel 1.33 での再解析は下記。

#### voxel 1.33 mm での再解析 (`topo_v1/fea_v2_fine/`、90,215 要素)

| ケース | たわみ (最大位置) | von Mises max / p99.5 | **SF p99.5** | SF 最悪要素 | voxel 2.0 との差 |
|---|---|---|---|---|---|
| L1 吊り 3g | 0.089 mm (1, 64, 218) | 2.40 / 0.80 MPa | **50.13** | 15.99 | たわみ −20%、SF +28% |
| L2f 前方 300 N | 0.109 mm (0, 74.5, 145) | 4.84 / 1.63 | **19.43** | 7.10 | たわみ −70%、SF +149% |
| L2s 側方 300 N | 0.252 mm (64, 0, 42) | 12.38 / 3.37 | **9.70** | 2.00 | たわみ +16%、SF +1% |
| **L3 把持プリロード** | 0.427 mm (72, 16, 40) | 21.42 / 6.20 | **4.49** | 1.21 | たわみ +4%、SF +14% |
| **L4 前方衝突** | 0.261 mm (0, 74.5, 145) | 12.31 / 4.00 | **7.72** | 2.79 | たわみ −68%、SF +129% |
| L2Lf ライト前方 300 N | 0.218 mm (0, 74.5, 40) | 7.94 / 2.70 | **11.86** | 3.97 | たわみ −49%、SF +52% |
| L2Ls ライト側方 300 N | 0.126 mm (22, 54.5, 40) | 8.44 / 2.02 | **16.20** | 4.16 | たわみ −64%、SF +101% |

**全 7 ケース 強度 PASS / 剛性 PASS。最小は L3 の SF p99.5 = 4.49、最大たわみは L3 の 0.427 mm。**

- 細かくすると**たわみが下がり SF が上がる**方向に動いた。理由は数字で言える:
  **voxel 2.0 は部品の 12.6% を取りこぼしている** (23,105 × 8 = 184,840 mm³ / 実体 211,519 mm³)。
  6 mm のキール・座面板・ラッチ柱が 2 ボクセルに満たない場所で痩せるためで、
  voxel 1.33 では 90,215 × 2.353 = 212,240 mm³ = **100.3%** と実体に一致する。
  つまり voxel 2.0 の値 (L3 SF 3.95 / L4 たわみ 0.811 mm) は**保守側の下限**、
  voxel 1.33 の値が実形状。どちらでも合格基準は満たしている
- **`mesh resolution` は voxel 1.33 でも FAIL する (thin 2.66 mm = 2 ボクセル = 格子の下限)。**
  これ以上細かくしても同じことが起きる: 本部品の真の最薄部は
  (a) **HP40 インサートボスの壁 (Ø12 − Ø6.4)/2 = 2.8 mm** — `scad/lib/hardpoint.scad` の規格値で
  本部品固有ではない (コアフレーム v5 も同じ)、(b) **ノブ頭ポケット (Ø18) 脇のボス壁 1 mm**
  (x 71..72。−X 側は内腔差分で壁自体が無い — 要確認 9)。
  これらを 3 要素で解くには voxel ≤ 0.5 mm (要素数 1700 万) が要り、実用的でない。
  **「典型断面」は voxel 1.33 で 5.32 mm / 4.0 要素 = 基準を満たしている**ので、
  荷重を担う部材の応力は解けていると判断した

#### 最悪要素の読み方 (worst element)

判定は **p99.5** で行う。最悪要素の値は「人が見に行くべきか」を決めるための情報:

- **L3 の 1.80 @ (65, 15, 198)** / **L4 の 1.34 @ (−17, 67, 186)** — 荷重を掛けた領域
  (ラッチボス / HP 座) の内部か縁。ボクセル格子の階段状の角に出る典型的なアーチファクト。
  最適化形状も同じ場所で worst 2.87 (L3) を出していた
- **L2Lf 3.01 @ (±21, 63, 0) / L2Ls 2.06 @ (21, 65, 0)** — こちらは**アーチファクトではない**。
  2 つの独立したケースが同じ位置を指し、しかも荷重点ではない。位置は
  **縦キール (t6) が下把持帯の外面 (r=64.35 の曲面) に着く入隅**で、`.scad` では
  設計規約 1 によりフィレットを付けられない。**Fusion 側で R3〜R5 のフィレットを付けるのが
  想定される処置**。p99.5 は 7.79 / 8.08 と十分なので設計変更はしていない

### 最適化形状との比較 (`topopt compare`、voxel 3.0 mm、同一 study)

`topopt compare 03_optimization ../child_jaw_gate.stl --study child_jaw_gate_v1_study.json --solver cuda:jacobi`
(`topo_v1/compare_3/`)。**compare は voxel 3.0 mm** なので座面板の t4→t6 は見えない (compare_2 と同値)。

| 幾何 | 値 |
|---|---|
| 最適形状 | 6617 ボクセル / 178,659 mm³ |
| 再構築 | 7790 ボクセル / 210,330 mm³ (+17.7% 質量) |
| 重なり | 5198→**5214 ボクセル = 最適形状の 78.8%** |
| 欠け (最適が置いて再構築に無い) | 1403 ボクセル |
| 余分 (再構築が置いて最適が置かない) | 2576 ボクセル |

| ケース | 最適形状 たわみ / コンプライアンス / SF | 再構築 たわみ / コンプライアンス / SF | 比 |
|---|---|---|---|
| L1 吊り 3g | 0.146 / 3.72 / 29.2 | 0.083 / 2.88 / 38.4 | **0.77×** (23% 硬い) |
| L2f 前方 300N (HP4/HP5) | 0.060 / 5.34 / 26.8 | 0.084 / 8.57 / 19.9 | 1.61× (61% 柔) |
| L2s 側方 300N (ラッチ) | 0.352 / 65.42 / 6.97 | 0.201 / 46.15 / 9.75 | **0.71×** (29% 硬い) |
| L3 把持プリロード | 0.347 / 134.55 / 5.35 | 0.411 / 178.41 / 3.65 | 1.33× (33% 柔) |
| L4 前方衝突 | 0.150 / 28.86 / 11.8 | 0.201 / 48.63 / 8.15 | 1.68× (68% 柔) |

**L2f / L4 が柔らかい理由**: `compare_*/topo_compare.png` の MISSING を見ると、最適形状は
**ラッチ柱 (x 58..72) と HP4/HP5 座を結ぶ斜材**を z 110..160 と z 75..95 に置いている。
これを cube/cylinder で再現すると 20〜30 cm³ 増え、目標 220 cm³ を破る。
**全ケースが合格基準 (たわみ ≤1.0 / SF p99.5 ≥3.0) を満たしているので採らなかった。**
CLAUDE.md の「±20% で成功」は荷重経路を保てたかの目安であり、重なり 78.8% と
全ケース合格が「経路は保てた」ことを示している。

### 反復 (3 回)

| 回 | 変えたもの | 体積 | compare の結果 |
|---|---|---|---|
| 1 | 初版 (帯 ×3 + ヒンジ腕 y0..16 + ラッチ柱 y0..14 + キール前面 y70.35 + 座面板 t4) | 191.4 cm³ | 全ケース合格。L2f 1.99× / L3 1.33× / L4 2.14× 柔 |
| 2 | ラッチ柱 y0..14→**0..16**、ヒンジ腕 y0..16→**0..18**、キール前面 70.35→**74.35 (座面と面一)** | 201.2 cm³ | L2f 1.61× / L4 1.68× に改善。**L3 は 178.9→178.4 で変わらず** = L3 のコンプライアンスはラッチ柱/ヒンジ腕の y 深さではない |
| 3 | **座面板 t4→t6** (voxel 2.0 の FEA で L4 のたわみ 0.855 mm のうち約 0.5 mm が座面板自身の曲げだったため) | **211.5 cm³** | compare (voxel 3.0) では差が出ない。voxel 2.0 の FEA で L4 0.855→0.811 mm |

## トポロジー最適化の報告 (`topo_v1/`)

| | |
|---|---|
| 手法 | SIMP (`topopt opt`)、density filter |
| 目的関数 | 全 5 ケース同時のコンプライアンス最小化 |
| 設計空間 | 現行 v1 の bbox (x −80..72 / y 0..74.35 / z −17..218)、153×75×234 mm |
| 要素 | voxel **3.0 mm**、6772 要素 (threshold 0.40 の最終形) |
| 体積率 | volfrac 0.052 (自由セルに対して)。最終 176.4〜182.8 cm³ |
| フィルタ半径 | 6.0 mm (= 最小部材寸法。X1C の 4 mm 下限より大きい) |
| penal / move / tol | SIMP penal 既定、move 0.2、tol_change 0.002 |
| 収束 | **未収束** (80/80 反復、`max_iterations` で停止) |
| 境界条件 | preserve = 把持帯 ×3 / ナックル ×3 / ラッチボス ×2 / HP 座 ×3 (板 t4 + インサートボス Ø12)。obstacle = 内腔+ポケット / コア半殻 (y≤0) / コア側ナックル柱 / ヒンジ開閉スイープ / **ノブボルト通路 Ø24** / ブリッジ占有域 / HP 座の外側 |
| FEM 再検証 | `topopt compare` (voxel 3.0、最適形状と再構築を同条件で) + `topopt fea` (voxel 2.0、最終 STL、L2L 追加) |
| 最適化の verdict | **FAIL** (未収束 / 自己支持でないボクセル 15 個 / 合わせ面にサポートが乗る)。**出力は部品ではなく地図**として使い、部品は本 `.scad` が正 |
| 独立再解析 (CalculiX) | 未実施 (この PC に未インストール) |

## 印刷 (X1-Carbon)

| | |
|---|---|
| 材料 | **PETG** (study の材料カードと同じ。実測値なしの暫定カード) |
| 造形方向 | **モデル姿勢のまま +Z up** (全高 235 < 250)。プレート = z −17 |
| インフィル | **100%** 想定 (FEA は中実で解いている)。落とすなら壁 5 周以上 + gyroid 40% 以上にして再評価 |
| サポート | **要** (5.1% / 4330 mm²)。下記の箇所のみ |
| 1 層目接地 | 1722 mm² (下ポケット帯の底面)。**ブリム推奨** |
| printability | **PASS** — オーバーハング 7.1%、最小肉厚 4.74 mm、`--load-axis 1,0,0` で層内 (cos 0.00) |

サポートが要る面 (`topopt overhang`、合計 4330 mm² / 5.1%):

| 位置 | 面積 | 何の面か |
|---|---|---|
| z 92 / z 200 | **873 mm² ×2** | **中帯・上帯の下面** (半殻リングが宙に浮く)。v2 で帯間の殻を廃止した代償 |
| z 85.5 / z 188 | 384 mm² ×2 | ヒンジ 中・上ナックルブロックの下面 (互い違いの隙間。v1 と同じ) |
| z 145 / z 75 / z −10 | 226 / 224 / 226 mm² | HP4 / HP5 / HP-L 座面板の下面 (50×6)。HP-L はプレートから 7 mm しかないが宙に浮いている |
| z 74 付近 | ~107 mm² | 縦キール前部の段差 (ブリッジ逃げの上端。45° 立ち上がりを付けてこの値まで減らしてある) |
| 他 | 各 ~25 mm² | ラッチ穴/インサート穴の上面など小さな盲穴 |

ノブ頭ポケットの底 (45° コーン)、上下ポケットの 45° 遷移コーン、ブリッジ逃げの立ち上がりは
サポート不要。**帯下面の 873 mm² ×2 は帯の下に 45° の受けコーン (`cylinder(r1=r_in, r2=r_out)`) を
足せば消せるが体積 +約 7 cm³** になるので v2 では採らなかった (要確認 8)。

`--load-axis` は **1,0,0 (フープ)** で評価する。0,0,1 だと縦姿勢が「層またぎ」と誤判定される
(吊り荷重は本部品でなく吊り耳→コアフレームが受ける)。

## 干渉チェック (`.scad` 冒頭の assert)

1. **把持・ポケット**: リップの掛かり ≥1 mm (下=キャップリム / 上=ドームリング)、ポケット径クリア ≥0.3、
   下帯がコーン上端 +2 より高い、上帯がポケットより 4 mm 以上下から始まる、中央帯がポケットに掛からない、全高 ≤250
2. **ヒンジ**: ナックル壁厚 ≥4.5、ざぐり周囲 ≥3、腕ブロックがヒンジ開閉スイープ (x<−72 で y>18) に入らない、
   腕の内端が内腔に届く、**ゲート/コアのナックルが遊び 0.4 で互い違いに噛み合う (4 本)**、
   **腕ブロックがコア側ナックル柱と z で重ならない (総当り 3×2)**
3. **ラッチ + ノブボルト挿入通路** ← v1 の致命的欠陥を潰した箇所 (下記)
4. **前面 HP + キール + ブリッジ**: 座面 y = r_out+10、インサート穴がシェル外面に食い込まない、
   インサートボス底肉 ≥3、キールがインサート列の直下・座面板の幅内・HP-L のケーブル穴から 1 mm 以上・
   ブリッジ外側域 (\|x\|≥27) の外、キール後端が内腔でトリムされる、HP 座同士が z で重ならない (総当り)、
   **HP 座がブリッジ内側占有域 z 42.3..74 と重ならない (3 個とも)**、上ポケット↔HP4 穴、下ポケット↔HP-L 穴

### ノブボルト挿入通路 (前ワーカー §7-1 の指摘への対応)

v1 は **ノブボルト頭 Ø16 をポケットに挿入できなかった** (y=17 の断面でシェルが x 56.9..62.1 を塞いでいた)。
v2 では通路を「obstacle として最適化に空けさせ、部材側を y ≤ 16 に切り上げる」方式で確保した。

- 通路の定義: **Ø24 の円柱、軸 = Y、中心 (x=62, z=40) と (x=62, z=170)、y ≥ 16 (ボス前面) から +Y へ 30 mm**
  (`knob_acc_d` / `knob_acc_h`、`topo_v1/child_jaw_gate_v1.scad` の `finger_room()` と二重定義)
- **空け方**: シェルを通路の位置から消したのではなく、**ラッチ側の部材を全部 y ≤ 16 に収めた**。
  ラッチ柱 y 0..16、ラッチボス y 0..16 (= 通路の口と面一)。ここに通路が食い込む余地が無い
- **assert の内容** (通路と重なりうる部材ごとの距離検査。OpenSCAD は「空虚」を測れないため):

  | 部材 | 検査 |
  |---|---|
  | ラッチ柱 | `lf_t <= knob_y0` (16 ≤ 16) |
  | ラッチボス | `boss_y1 <= knob_y0` (16 ≤ 16) |
  | 把持帯 ×3 (全周の殻なので z で離すしかない) | 各帯 × 各 latch_z で `band_z1 <= z−12` または `band_z0 >= z+12`。実際の余裕 = 下帯 22 / 中帯 40 / 上帯 18 mm |
  | ヒンジ腕ブロック | `hf_x1 <= 62−12` (−50 ≤ 50) |
  | 縦キール | `keel_cx + keel_w/2 <= 62−12` (23 ≤ 50) |
  | HP 座 + インサートボス | 座の最大 x (26) ≤ 50 |

- 保険として `knob_channel()` を実際に `difference()` でも引いてある (assert が漏れても材料が残らない)
- **`knob_acc_d = 24` は仮値** — 実際のノブの直径・回転に要る指の空間で決まる (要確認 4)

## 部品外の考慮

- **購入品**: ヒンジピン Ø5×約240 (ステンレス棒 or M5 長ボルト) + E リング、M5 ノブボルト ×2、
  M5 熱圧入インサート ×12 (HP4/HP5/HP-L)、EVA シート t2 (チューブ周長 ~360 × 把持帯 3 本ぶん) → BOM へ
- **ノブボルトの挿抜**: 上記の Ø24 通路。ゲートを閉じた状態で +Y 側 (前) から手が入ること。
  `child_cam_bridge` / ライトクランプが x 50..74 に張り出すとここを塞ぐ — **ブリッジ側でも要検査**
- **開閉ストローク**: ゲートは前方 (+Y) へ 90° 以上開く。腕ブロックを y ≤ 18 に収めてあるので
  コア側ナックル柱を掃かない。実機ではカメラ/ライトのケーブルに干渉しないことをアセンブリで確認
- **v2 で殻が無くなった帯間 (z 6..92 / 108..200) は容器が露出する**。水中では問題ないが、
  運搬・着底時のアクリル保護は `child_guard_ring` と下部ガード側の責務。**要確認 5**
- HP-L の Ø14 ケーブル穴はキール間の空間へ抜ける。ライトのケーブルはそこから下方 (z<0) の
  ガード側へ回す想定 — ルートは `docs/配線・ケーブル計画.md` とライトクランプ設計で確定させる
- 容器の Z 軸回転は EVA 摩擦のみで拘束 (ケーブルが柔軟なので許容)
- 100% インフィルで約 269 g。v1 比 −123 g

## 要確認

1. **ドーム押えリングの実寸** (`dome_ring_od=120.3` / `dome_ring_t=6.5` は仮値) — 未購入。
   上ポケット z 207.5..215 と部品上端 z 218 がこれに依存する
2. **EVA の実圧縮特性** (0.8 mm 圧縮でのプリロードが適正か) — フィットテスト
3. **材料カードが暫定** (`petg_generic_fff_orthotropic_v1`、このプリンタでの実測値なし)。
   安全率は「案の比較」には使えるが絶対強度としては使えない。支配ケース L3 の SF p99.5 は
   4.49 (voxel 1.33) / 3.95 (voxel 2.0) と余裕が大きくないので、実材料の試験片データが
   取れたら再評価する
4. **ノブ挿入通路 Ø24 は仮値** — 実際のノブボルトの頭径・つまみ径と、指 (または工具) の空間で決まる
5. **帯間で容器が露出する** — v1 は全高の殻だった。着底・運搬時のアクリル保護の要否を人間に確認
6. `child_core_frame` への `interfaces.json` の lock は **`--confirmed` なし** (自動作業中のため)。
   人間確認待ち。さらに **本作業中 (2026-09-06 03:26〜03:44) にコアフレーム側が別ワーカーによって
   編集・再ビルドされ続けていた**ため、lock したハッシュはすでに DRIFT している。
   ただし本部品が依存する値 (`tube_od` / `cap_z0/z1` / `flange_top` / `dome_ring_*` / `eva_*` /
   `pocket_*` / `shell_t` / `lip_*` / `hinge_x=-72` / `hinge_y=10` / `knu_od=16` / `knu_h=30` /
   `knu_gap=0.4` / `latch_hx=62` / `latch_z=[40,170]` / `aknu`) は 03:40 時点の
   `child_core_frame.scad` で**すべて一致を確認済み**。コアフレーム側の作業が終わったら
   `part_index.py lock --for child_jaw_gate --ref child_core_frame --confirmed` を打ち直すこと。
   コア側 `interfaces.json` の `child_jaw_gate` 参照も v1 のハッシュのままなのでコアフレーム担当が再 lock する
7. `child_light_saddle` / `child_cam_mount` の `interfaces.json` は旧ブレード/パッド値を参照したまま
   (v1 から未解決、別ワーカー対応待ち)
9. ⚠ **【v2 で初めて表面化する組立ブロッカー】M5 ノブボルトの頭 Ø16 が耐圧容器に食い込む。**
   **v1 ではシェルが通路を塞いでいて頭がポケットまで届かなかった (前ワーカー §7-1) ため、
   この干渉は起きようがなかった。v2 で通路を空けて初めて頭が実際に挿入できるようになり、
   その結果この衝突が「潜在的な形状エラー」から「組立が止まる問題」に変わった。**
   ラッチ軸 `latch_hx = 62` に対し頭 Ø16 は x 54..70 を占める。容器 (アクリル r57.15 / 圧縮 EVA r58.35)
   はゲートの内腔差分の外側 = 実体なので、頭の −X 側の角がそこへ入る:

   | 頭の底の位置 | アクリルへの食い込み | 圧縮 EVA への食い込み |
   |---|---|---|
   | y = 12 (現行。45° コーンに座る位置) | **1.83 mm / 40 mm³** | **3.03 mm / 129 mm³** |
   | y = 16 (ポケットを廃止しても) | 0.83 mm / 5 mm³ | 2.03 mm / 42 mm³ |

   頭が完全に逃げるのは y ≥ 18.7 (アクリル) / 22.1 (EVA)。**ポケットを浅くしても解決しない。**
   同じ理由で、ポケット Ø18 の **−X 側の壁は内腔差分で消えており** (実体は x ≈58..71 のみ)、
   頭の座は +X 半分しか無い。**これは v1・topo の preserve と同一形状なので v2 で作り込んだ問題ではないが、
   要件書 R5 の「アクリルに局所荷重を掛けない」に反する。** 取りうる対策は
   (a) `latch_hx` を 62 → 66 以上へ (コアフレーム v5 と同時に変更、要人間判断)、
   (b) 頭を Ø10 以下にする (M5 六角穴付き Ø8.5 + 別体ノブ)、
   (c) 頭とアクリルの間に EVA を回して面圧を逃がす。
   **`latch_hx` はコアフレームとの二重定義なので本ワーカーでは変更しなかった。オーケストレータの判断待ち。**
8. **中帯・上帯の下面 (z 92 / 200、各 873 mm²) をサポートで造るか、45° の受けコーンを足すか。**
   コーンは `cylinder(r1=r_in, r2=r_out, h=6)` を帯の下に union するだけで作れる (規約に適合) が
   体積が +約 7 cm³ (→ 218.5 cm³) になり、目標 220 cm³ の余裕をほぼ使い切る。
   造形品質 (帯下面が把持面ではないこと) を人間に確認して決める
