AquaBeacon/mechanical/parts/child/exterior/printed/child_light_saddle/child_light_saddle.md

# child_light_saddle — 水中ライト鞍座 (再設計版・汎用)

> **⚠ 2026-09-04 廃止**: ゲートのライトパッド (M4×4) は削除され、前向きライトはハードポイント HP-L (M5×4 @ 40×40、`docs/子機外装_改善要件.md` §3.1) にユーザ設計のクランプで付ける方針になった。本部品と `interfaces.json` のロックは撤去。ファイルは履歴として残置。

旧 `child_light_clamp` の置き換え ([要件](../../../../../docs/子機外装フレーム再設計_要件.md))。
**ライトは未選定** — `light_d=40` は仮値のまま汎用座として設計 (2026-08-02 ユーザ指示の仮値運用)。

| 項目 | 値 |
|---|---|
| 区分 | 子機 / 外装 / 3Dプリント |
| 個数 | 1 |
| 外形 | 52 × 30 × 42 mm |
| 体積 | 23.3 cm³ (STEP) → PETG 約 19 g |
| STEP | 1 ソリッド / 44 面 / watertight |

## 役割・構成

`child_jaw_gate` 前面のライトパッド (平面 y=67) に **M4 ×4 (x±18, z46/74)** で締結。
円筒ライトを **+Y (カメラと同方向)** に向けて軸方向に差し込み、床貫通スロット ×4 に
通した**結束バンド 2 本**で固定する。ボア内面に EVA 1mm を貼って滑り止め。

- ボア Ø40.5 (axis y、z 39.75..80.25)。上面は 18.6mm 幅の開スロット (水抜き兼用)
- M4 座ぐり Ø8.6×12 (前面から、天井 45° コーン)。ねじは M4×25〜30 セルフタップ
  (ゲート側下穴 Ø3.3×9)

## インタフェース (二重定義 — `child_jaw_gate` と揃える)

`pad_y=67` / `lm4_x=18` / `lm4_z=[46,74]`。ロック済み (`interfaces.json`)。

## 荷重

ライト 0.3kg × 10g ≈ 30 N (L2)。M4×4 + 52mm 幅ブロックに対して桁違いに小さい
(closed-form で面圧 <1 MPa)。単体 FEA 省略 (全体系 FEA はコアフレーム側)。

## 印刷 (X1C)

**背面 (取付面) をベッドへ = printability の「+Y up」。オーバーハング 8.3% で PASS。**
ボア・スロット・座ぐりがすべて垂直になりサポートレス。
注: printability のスコア選好は −X up を選んで 22.8% FAIL を報告するが、
これは第1層面積の重み付けによるもの。**印刷姿勢は +Y up を指定する。**

## 要確認

1. **ライト選定 → `light_d` 実測置換** (胴が円筒でない場合は形状から作り直し)
2. ライトのケーブル取り回し (後方キャップまでのサービスループ 150mm — 配線計画)
3. ハレーション: ライト光がカメラ直入しない角度であることを実機確認
