AquaBeacon/mechanical/parts/child/exterior/printed/child_lug/child_lug.md

# child_lug — 吊り耳 (ボルトオン、左右共通 ×2)

> **2026-09-04** `child_top_crown` に置き換え (廃止)。ファイルは履歴として残置。

外装フレーム再設計 ([要件](../../../../../docs/子機外装フレーム再設計_要件.md) R4/R8)。
旧 `child_shell_aft` の一体吊り耳を分離した小部品。

| 項目 | 値 |
|---|---|
| 個数 | 2 (左右共通) |
| 外形 | 48 × 24 × 38 mm |
| 体積 | 20.8 cm³ → PETG 約 17 g |
| STEP | 1 ソリッド / 13 面 (STL の open edge 1 は丸め誤差) |

## 分離した理由 (R4 の解)

1. **平置き印刷** (耳板面をベッドへ) で、吊り荷重もボルト軸力も層面内に乗る。
   旧一体型はシェルごと +Z 印刷で吊り耳が層またぎになっていた
2. **輸送時に M5 ×2 を外して耳ごと取り外せる** — スーツケース内で唯一
   飛び出す部品を無くせる (カメラ・ライトも同様に外す運用)

## 取合い (コアフレーム側と二重定義 — コアフレーム設計で反映)

- 機体配置: **x = ±60、取付面 z = 218** (ラッチ/ヒンジ側フランジ頂部のボス上面)
- コアフレーム側ボス: y −14..0 に厚肉化し **M5 熱圧入インサート ×2 @ x=±60±12, y=−6**
- 台座は y −24..0 (後半分がボスから後方へ張り出すが空中でよい)。
  **ゲートのフランジ頂部 (y 0..10) には掛からない** (開閉時に擦らない)
- シャックル穴 **Ø16、中心 z=248 (機体)、軸 Y**。Ø10 ロープ / M10 シャックル。
  耳上端 z=256 < ドーム頂点 261 (全高を増やさない)

## 荷重と強度 (quick_strength 済み)

- L1 吊り 99 N/耳 (全備 5.7kg × 3g、ブライドル 30°)
- L2 輸送 600 N 単独ヒット: lug 面圧 1.6 MPa / 耳板根元曲げ 18.8 MPa (≒限界 19、
  ただしこれは係数 10 込みの極値。実現度の高い横倒しでは 1/10) → PASS
- ボルト M5 ×2 は鋼。引張はインサートの引抜きが律速 → **全体系 FEA と引抜き試験で確認**

## 印刷 (X1C)

**耳板面 (y=−24) をベッドへ平置き。実測オーバーハング 1.0%** (手計算、M5 横穴のみ)。
printability.py の姿勢表は up 軸ラベルの規約差で 20.9% と出るが、実姿勢の
下向き面を STL から直接積分した値が 1.0% (bed 1384mm² / total 6958mm²)。
荷重 (z) は層面内 (cos=0)。

## 要確認

1. ブライドル取付の y 位置 (耳板中心 y=−18) と全備重心 y のずれ → 吊り姿勢の
   前後トリム。ブライドル脚長かバラスト位置で合わせる (アセンブリで算出)
2. M10 シャックルの回転クリアランス (ドーム面まで ~20mm — 実物で確認)
