AquaBeacon/mechanical/parts/child/interior/printed/child_lcd_cradle/child_lcd_cradle.md

# child_lcd_cradle — 片開き外向きLCDドア

NHD-C0216CiZを透明アクリル越しに読めるよう＋Yへ向ける、白PLAの二分割保持具。
`bezel`は表示面を下、`clamp`は平面を下にしてサポート無しで印刷する。

- LCDポケット: 57.4×26.8×6.8 mm
- 表示窓: 45.7×14.3 mm
- 取付ピッチ: 95 mm（C-MAINの軸方向穴ピッチ）
- ベゼル外形: 41.1×63.4×10.5 mm。左側M3縦ヒンジ、右側埋込みM2.5ラッチ付き
- 後クランプ: 2本を1 STLに配置
- 締結: `child_lcd_hinge_frame`へM3ヒンジピン＋M2.5ラッチ1本、後クランプM2.5×4

LCDに取付穴が無いため、前周囲を0.8 mm閉孔フォーム、後方をねじ式クランプで
挟む。接着剤やPLAスナップに頼らず、LCDだけ交換できる。ラッチねじ1本を緩めると
左ヒンジを軸に約100°開き、背面のC-MAINへアクセスできる。筒内では開けず、内装を
70 mm以上引き出してから操作する。

## 2026-08-28 固定: ナックル逃げ・ヒンジ葉短縮・クランプ座

- 枠の中央ナックル (x -21.7..-15.3) がドア板の縁に 1.1 mm 食い込んでいた → 板に切欠き (x ≤ -15.0、y ±7.8、z ≥ 3.2)。
- ヒンジ葉を ±8..27.5 → **±8..20.5** に短縮。後クランプ棒 (y ±23.4) がヒンジ葉と 1.7 mm 重なっていた。
- クランプ座をポケット全深 8.8 に。棒はヒンジロッド下面 (Y 35.0) まで 0.3、LCD 背面 (35.2) との 0.5 は
  0.8 フォーム (`foam_pad_lcd_rear`) を圧縮して押す。クランプ下穴ボスは板の輪郭 (x ±16.4) 内に限定
  (ヒンジロッド x -20..-17 に当たっていた)。
- `bar` バリアント (part=2) を追加: 棒 1 本を原点中心で出す (アセンブリ配置用)。`clamp` (2 本組) は印刷用。
- ヒンジは M3 全ねじ 105 (頭無し)。旧 M3×60 頭付きピンは頭がドア板端 (x ≥ -16.4) に当たった。
- LCD は前板 2 + フォーム 0.8 の奥 (Y 40.7) に置く。ピンは実物どおり長辺 (ヒンジ側 -X) から出て背面へ曲げる。
