AquaBeacon/mechanical/parts/child/interior/printed/child_lcd_support/child_lcd_support.md

# child_lcd_support — LCD非対称支持アーチ

使用数2。C-MAIN取付穴の各軸方向面に置き、X=−22側はM3 35 mm、X=＋39.5側は
M3 20 mmオス―メススペーサで共締めする。円筒断面に沿う非対称形状で、
USB/microSD（−X）と3ボタン（＋X）のアクセスを残す。

67×24.25×5 mm。アーチ平面をベッドへ置き、サポート無し。スペーサ横穴は
ティアドロップ、LCD側はM3セルフタップ下穴。

## 2026-08-28 固定: スペーサ長の訂正・皿ねじ・ヒンジボス

- スペーサは **M3 MF30 (X=-22) / MF17 (X=+39.5)**。旧記載の 35/20 は「基板上面からボス中心まで」で、
  スペーサ端面がボス外周 (Ø5.5) に当たる端面基準では 30/17 が正 (`left_y = board_y + spacer + boss_d/2`)。
- ボスの +Y 面に 90° 皿もみを追加し、**JIS M3×10 皿 (頭Ø5.5) を面一**に沈める。なべ頭ではアクリル内壁まで
  0.6 mm しか残らない (assert `boss corner < tube_id/2 - 1.5`)。
- LCD ドアのヒンジを M3 全ねじ (105) にし、**アーチにヒンジボス (Ø7、穴 Ø3.4、中心 (-18.5, 36.5))** を追加。
  上下アーチで両端を受け、外側でナット止め。ボス下面 33.0 と左スペーサ上端 32.6 のすきま 0.4 (assert)。

## 2026-09-03 追加: 下フランジ 90° 固定耳 (バリアント `lower`) と hull 撤去

### バリアント

| 接尾辞 | 位置 (世界 z) | 耳 | 印刷向き |
|---|---|---|---|
| `lower` | 22..27 | あり (0, +47) | **裏返し** — アーチ上面 (z=5) をベッドに。耳の足が上に 2.7 mm 伸びる。ティアドロップ頂点は自動で反転 |
| `upper` | 117..122 | なし | モデルの向きのまま (z=0 をベッドに) |

接尾辞なしの成果物は削除済み。`placement.json` は `file: child_lcd_support_lower / _upper` を参照する。

### 固定耳 (90° アンカー)

内装は下フランジ BR-101040 内面の **4× M3 タップ (BCD 94, 0/90/180/270°)** に固定する
(根拠: `parts/child/exterior/cots/wte4_flange/_work/images/ref/BR-101040_hole_map.png`、WTE データシート Rev C.5)。
0°/180° はデッキのラグ、**90° (0, +47) は C-MAIN が間にあってデッキから届かない**ので、
その真上にある下アーチが受け持つ。270° は電池箱の床 (y −43) が塞ぐので使わない。

| 項目 | 値 | 変数 |
|---|---|---|
| 耳の中心 | (0, 47) = BCD94 の 90° | `ear_x`, `flange_bcd` |
| 耳 外径 / 穴 | Ø5.2 / Ø3.4 (肉 0.9) — 外縁 r 49.6 (チューブ ID/2 − 1.0 = 49.8 が上限) | `ear_od`, `ear_clear_d` |
| ウェブ | LCD 固定ボス (Ø9, y 39.6) から耳まで、幅 5.2 | `ear_web_w` |
| 足の下面 | 世界 z **19.3** = フランジ内面 19 + すきま 0.3 | `flange_face_z`, `arch_z0`, `ear_gap` |
| ねじ | **M3×12** なべ/キャップ (頭 Ø5.5)。耳 7.7 + すきま 0.3 を貫き、フランジに **4.0 mm** (制限 4〜5、タップ深さ 6.05) | `flange_screw_y` (placement) |
| 頭 | z 27..29、ヒンジ枠ラグ (y ≤ 42.5、z 27..32) まで 1.75 mm、ベゼル前板 (y 43.5、z ≥ 37) とは z で離れる | `hinge_lug_y_max` |

**すきま 0.3 の意味**: 0°/180° の金属スペーサ (MF10) を軸方向の基準にし、この耳はねじで
0.3 mm 引き寄せて締める (アーチ梁 4.8×5 の 40 mm 片持ちを 0.3 mm たわませる力は数 N)。
印刷公差で足が長く出た場合はスペーサ側が浮くのではなく耳が先に当たるだけで、どちらも
ねじで吸収できる。実物で足がフランジに届かない (すきま > 0.5) ときは `ear_gap` を減らす。

工具アクセス: チューブ上端 (z 200、上フランジを抜いた状態) から 2.5 mm 六角レンチを
(0, 47) に沿って下ろす。通路は y 44.4..49.6 のすき間 (ベゼル前板 43.5 とチューブ内壁 50.8 の間)。
**なべ頭 (プラス) より六角穴付きを推奨** — ドライバ軸 Ø4〜5 では前板まで 0.9 mm しか無い。

### 荷重ケースと強度

| 荷重 | 値 | 根拠 |
|---|---|---|
| 内装質量 | ≈ 0.7 kg (LiPo 0.2 + 基板 0.1 + 印刷部品・金物 0.4) | 概算 |
| 落下 10 G | 70 N を 3 点で分担 → **25 N / 点**、方向は任意 (せん断 / 引張) | 係数 10 (落下) |

`quick_strength.py lug --hole 3.4 --edge 0.9 --t 7.7 --F 25 --material PETG` (層間許容 12 MPa / SF 2):
純断面 1.8 MPa / 支圧 0.96 MPa / せん断 1.8 MPa — **PASS** (余裕 6 倍以上)。
足を 8 mm 片持ちと見た曲げ (`beam --L 8 --b 5.2 --t 5.2 --F 25 --in-plane`): 8.5 MPa / たわみ 0.05 mm — PASS。
FEA は省略 (閉形式で 6 倍以上の余裕、既存デッキラグ (Ø5、肉 0.8) と同等以下の応力)。
穴縁 0.9 mm は「1.5D 以上」の目安を下回るが、これは既存ラグと同じ制約 (チューブ内壁) による。

### 印刷指示 (lower)

- **向き**: 裏返し (アーチ上面をベッドに)。サポート **不要** (`topopt overhang` 実測 0.0 mm²)。
  モデルの向きのままだと足 (37 mm²) だけがベッドに着く → 不可。
- 材料: PETG (または PLA)。インフィル 40 % 以上、壁 3 周 (耳の肉 0.9 mm は 2 周)。
- `upper` はモデルの向きのまま、同条件。

### hull 撤去

capsule (hull) → `bar()` (cube + 端の cylinder)、`teardrop_bore` (hull) → 1 枚の polygon の
linear_extrude に置換。CSG→STEP が通るようになり STEP は **138 面の真の B-rep** (以前は
STL フォールバックで ~1000 ファセット)。**FreeCAD の CSG 取込は cylinder と重なる polygon 押出の
ブーリアンで null shape になる** (2026-09-03 に t1..t14 で切り分け) ので、ティアドロップは円弧も
含めて 1 つの polygon にしてある。

### インタフェース (二重定義)

| 変数 | 相手 |
|---|---|
| `flange_bcd` 94 / `flange_face_z` 19 | `child_vtray_deck.scad` の `flange_bcd` / `flange_ins` |
| `arch_z0` 22 | placement の `lcd_support_lower` translate z |
| `hinge_lug_y_max` 42.5 / `frame_screw_head_y_max` 42.35 | `child_lcd_hinge_frame` 下ラグの +Y 端 (アセンブリ実測) |

### 要確認

1. フランジ内面 (0, +47) の実物タップ深さ (モデル 6.05) — 4 mm ねじ込みで OK か
2. 裏返し印刷での足の高さ実測 (7.7 ± 0.2)。フランジに届かなければ `ear_gap` を 0 に
