AquaBeacon/mechanical/parts/child/interior/printed/child_vtray_batt_gate/child_vtray_batt_gate.md

# child_vtray_batt_gate — LiPoクイックリリースゲート

> **廃止 (2026-09-03)**: 電池 35×26×110 への変更で `child_vtray_batt_box` から +Z ゲートが無くなった。アセンブリからは除外済み。フォルダは履歴として残置。

~~LiPoベイ＋Z端の着脱板。M3×2を外すだけで、MAIN基板とベイ本体を残したまま
電池を軸方向へ抜ける。中央切欠きは電池リードと指掛かりを兼ねる。

54×31×3 mm。平面を下にしてサポート無し。M3穴はØ3.4の補正8角穴。~~
