AquaBeacon/mechanical/parts/child/interior/printed/child_vtray_xt60_cradle/child_vtray_xt60_cradle.md

# child_vtray_xt60_cradle — 子機 縦置き内装 電池リード硬直部 (XT60) クレードル

> **廃止 (2026-09-03 同日)**: 電池リードを切って XT30 メスを付け直す方針になり、硬直 50mm + XT60 が無くなったため不要。アセンブリから除外済み。+X 側は `child_vtray_cable_rail` に戻した。フォルダは履歴として残置 (削除可)。

| 項目 | 値 |
|---|---|
| 区分 | 子機 / 内装 / 3Dプリント |
| 設計ソース | `child_vtray_xt60_cradle.scad` |
| 個数 | 1 |
| 外形 | **21.7 × 23.5 × 102.0 mm** (世界 x 22.3..44、y −33.5..−10、z 27..129) |
| 体積 | **15.6 cm³** (PLA 約 19 g) |
| STEP | 1 ソリッド (cube / cylinder のみ。STL と体積一致 0.0 %) |

## 役割

電池 [`lipo_35x26x110`](../../cots/lipo_35x26x110/lipo_35x26x110.md) の電源リードは
「可撓 60mm → **硬直 50mm (曲げ不可)** → XT60 プラグ」で、硬直部と XT60 嵌合ペア
([`xt60_rigid_run`](../../cots/xt60_rigid_run/xt60_rigid_run.md)、8.2 × 15.6 × 95) は
直線のまま収めるしかない。この 95mm を **デッキ下面の +X 側、電池箱の外壁とアクリル内壁の間に
Z 方向 (チューブ軸) で** 保持する部品。旧 `child_vtray_cable_rail` (+X 側) の置き換えで、
デッキの同じ 4 穴を使う。

断面 (X 右 / Y 上 = デッキ側):

```
 デッキ下面 y=-10 ───────────────────────────────────────────
 [電池箱の耳 x 19..27, y -10..-14]  天板 x 27.5..44 (4.5t) ─── ねじ ×4
 電池箱外壁 ┃ 硬直部ポケット  ┃外壁┃ ハーネス溝 ┃リップ┃ y -19
   x=22     ┃ x 22..30.6      ┃30.6┃ x 33..41   ┃41..43┃  (結束スロット 2 個 1 組 ×3)
            ┃ y -14.5..-30.5  ┃..33┃
            ┗━━━ 棚 y -30.5..-33.5 ━━━┛
```

- ポケットの −X 面は電池箱の外壁 (x = 22) が受ける。+Y 面は天板 + 電池箱の耳 (y −14)。
- 硬直部は **RX 基板を付ける前に +Z から差し込み**、下端タブ (z 27..30) に載る。
  上端は結束バンド 1 本を外壁の Ø3.2 穴 ×2 (z 126.6、y −17 / −28) に通して端面の前を
  横切らせ、+Z への抜けを止める。
- ハーネス溝 (8 幅 × 4.5 深) は旧 +X レールの代替。Ø6 までのケーブルをリップの結束スロットで
  結束する (溝は下 (−Y) に開いているので、ケーブルはリップに抱かせて結束)。

## 主要寸法

| 変数 | 値 | 意味 |
|---|---|---|
| `run_w / run_h / run_l` | 8.2 / 15.6 / 95 | 硬直部の断面・長さ (**推定値**、`xt60_rigid_run` と共通) |
| `run_clear / gap_box` | 0.4 / 0.3 | ポケットの遊び / 電池箱外壁との隙間 |
| `plate_t / owall_t / ledge_t / tab_t` | 4.5 / 2.4 / 3 / 3 | 天板 / 外壁 / 棚 / 下端タブ |
| `lip_t / lip_h / duct_w` | 2 / 4.5 / 8 | ハーネス溝の外リップ (X 厚 / Y 高) / 溝幅 |
| `plate_x1` | 44 | 天板の外端 X → (44, −14.5) で r 46.3 |
| `rail_hx / rail_hz` | [30.3, 41.7] / [37, 77] | デッキの固定穴 (旧レール用) |
| `cradle_z0` | 27 | 部品下端の世界 Z |
| `tie_z / tie_gap` | [16, 51, 86] / 6 | 結束スロット組 (世界 z 43 / 78 / 113 ±3) |
| `stop_y / stop_d` | [−17, −28] / 3.2 | 上端ストッパ (結束バンド) 穴 |
| `notch_w / notch_h` | 7 / 11 | 下端タブの可撓リード通し |

## インタフェース

| 相手 | 締結 / 取合い |
|---|---|
| `child_vtray_deck` | デッキ上面から **M3×8 ×4** → 天板の Ø2.8 セルフタップ (4mm)。x 30.3 / 41.7、世界 z 37 / 77。**M3×10 は先端がポケットに出るので不可** |
| `child_vtray_batt_box` | 箱外壁 x=22 がポケットの −X 面。天板は耳 (x ≤ 27) の 0.5 外側から。耳の下面 y −14 はポケット上面 −14.5 の上 |
| `xt60_rigid_run` | ポケット内、中心 (26.3, −22.5)、世界 z 30..125 |
| RX 基板 (z ≥ 134) | 部品上端 129 → 5mm |
| チューブ内壁 | 棚の外側下角 (33, −33.5) r 47.0、リップ (43, −19) r 47.0 → 最小すきま **3.8mm** |

**`child_vtray_batt_box.scad` の `out_x` (22) / `ear_x` (27) / `ear_y0` (−14)、
`child_vtray_deck.scad` の `rail_x ± rail_hx` / `rail_hz`、`xt60_rigid_run.scad` の
`run_w / run_h / run_l` と同じ値をこのファイルにも書いている。片方だけ直さないこと。**

## 干渉チェック (`.scad` の assert)

- 棚・リップ・天板の外側の角がチューブ内壁 (r 48.3) の内側
- 天板が耳に当たらない / 硬直部の上を 2mm 以上覆う
- 固定ねじが天板の中にあり、先端 (y −14) がポケット上面 (−14.5) に出ない
- ポケットが硬直部 + 遊び以上 / ストッパ穴が硬直部端面より上で部品の中 / 上端が RX の 5mm 下
- 結束スロットがリップの中

## 荷重ケースと強度

| ケース | 荷重 | 受ける部位 | 結果 |
|---|---|---|---|
| 硬直部 + コネクタ (約 40 g) × 落下 10 | 4 N (−Z) | 下端タブ 3t、11 × 19 | σ 1.5 MPa / たわみ 0.02 mm **PASS** |
| 径方向の慣性 | 4 N | 棚 3t (片持ち 10.7) / 天板 | 余裕大 (計算省略) |

## 印刷向き・条件

**Z を上に立てて印刷** (下端タブ側がベッド)。板はすべて垂直でオーバーハング無し
(`topopt overhang`: 要サポート 0.8 % = 結束スロット・ストッパ穴の上縁のブリッジのみ)。
足場が 22 × 24 で高さ 102 なので **ブリム 8mm 以上**。PLA・0.2mm 層・壁 4 本・インフィル 30 %。
層が Z に直交するが、受ける荷重は硬直部の自重程度で層間強度は問題にならない。

## 部品外の考慮

- **組立順**: 電池箱 (電池入り) をデッキへ → クレードルを M3×8 ×4 → 電池の可撓リードを
  下ポケットで +X へ回し、硬直部を **+Z からポケットへ差し込む** (このとき RX 基板は未取付)
  → 上端ストッパの結束バンド → RX 基板。
- **変換ケーブル** (XT60 メス → XT30 メス、可撓): 硬直部上端 (z 125) から +Z へ出て、
  RX 基板の手前 (z < 134) で +X へ寄せ、デッキの +X スリット (x 29..43、z 144..170) を
  通って上面へ → CHILD_PWR の `J_BAT` へ。必要長 **≥ 120mm**。
  ⚠ `J_BAT` (XT30PW-M 横型) は基板 +X 端で +X 向きに開口しており、その先はアクリル壁まで
  約 14mm しか無い。XT30 メスプラグ (長さ約 17mm + 線) は**物理的に嵌合できない**。
  基板を変えないなら、変換ケーブルの基板側は XT30 を付けずに `J_BAT` のパッドへ直接
  はんだ付けする (XT30PW-M を実装しない)。`J_LED` (−X 端、−X 向き) も同じ問題がある。
- **ハーネス**: 旧 +X レールが無くなるので、下キャップからのハーネスのうち +X 側を
  通すものはハーネス溝のリップに結束する (Ø6 まで)。ライトは `J_LED` が −X 端なので
  −X レール側に回すのが自然。
- 硬直部の寸法は推定。**実物を測ってから印刷する** (`run_w / run_h / run_l`)。

## 要確認

1. 硬直部の断面寸法・長さ、XT60 嵌合長、ブート長 (→ `xt60_rigid_run` と本部品の同名変数)
2. 変換ケーブルの長さと基板側の処理 (XT30 実装せずパッド直付けで良いか)
3. 下ポケット (z 9..27) で可撓リード 60mm の U ターンが実際に収まるか (線径次第)
