AquaBeacon/mechanical/parts/parent/exterior/printed/parent_float_cradle/parent_float_cradle.md

# parent_float_cradle — 親機 浮子クレードル (円筒フェンダー受け、左右共通)

> **廃止 (2026-09-05)**: 浮子は完全な円筒ではなく胴を挟めない (人間指摘)。固定は中心の空洞に
> 紐を通す方式に変わり、`parent_float_yoke` ×4 が置き換えた。本部品は参考として残す (印刷しない)。
> アセンブリからも外した。

| 項目 | 値 |
|---|---|
| 区分 | 親機 / 外装 / 3Dプリント |
| 設計ソース | `parent_float_cradle.scad` |
| 個数 | **2** (Y 対称なので Z 軸 180° 回転で左右兼用 = 同一部品) |
| 外形 | 137 × 200 × 86 mm (天板上面 z=0、リブ下端 z −60、ラグ下端 z −86) |
| 体積 (中実) | 401 cm³ → PETG 壁 4 + インフィル 25 % で **約 0.2 kg / 個** |
| STEP | 1 ソリッド / 85 面 / watertight |

## 役割

市販円筒フェンダー (`parent_fender`、**仮 Ø100 × 300**) を上から被せて保持し、
`parent_deck` の側壁 HP40 座 ×2 に**内壁 (アダプタ板 t8)** で M5 ×4 ×2 締結する。

- **アーチリブ 3 枚** (Y −96 / 0 / +96、t8、高さ 60) が胴を受ける。リブ下端でのアーチ半角
  **79°** = 紐が無くても胴が横に逃げない抱え込み。
- **紐穴**: 両端リブに Ø7 ×2 (Y 貫通、胴中心 ±46) = 胴を下から回す**掛け紐**。
  外壁側の両端ラグ Ø8 (Y 貫通) = 浮子端アイ → ラグ / デッキ側壁 Ø8 への**ブライドル**。
- **天板中央に HP40 座 ×1 (上向き)** = ライト・GPS ポール・旗などの拡張。
- 外壁 (t9) と天板 (t5) で箱断面を作り、胴の押上げに対してリブを繋ぐ。

## 座標系

X=0 = デッキ側壁の外面 (座面)、外向き +X。Y = 浮子軸。z=0 = デッキ上面。
アセンブリでは右 (+X) を `translate([108,0,0])`、左 (−X) を `translate([-108,0,0]) rotate 180°`。

## 主要寸法

| 変数 | 値 | 意味 |
|---|---|---|
| `fender_d / fender_len / fender_clear` | 100 / 300 / 3 | 浮子 (**仮値**、`parent_fender` と二重定義) / 片側隙間 |
| `arc_r` (導出) | 53 | アーチ半径 |
| `x_f / z_c` (導出) | 64 / −70 | 胴中心 (グローバル X = 172)。胴上面 z −20 |
| `wall_in_t / wall_gap` | 8 / 6 | 内壁 (HP40 アダプタ) / 内壁と胴の隙間 (掛け紐の通り代) |
| `hp_lip_y / hp_lip_z / deck_lip_h` | [−70, 70] / −25 / 50 | デッキ側 HP40 座 (二重定義) |
| `top_t / top_pad_boss / arc_gap` | 5 / 10 / 2 | 天板 / 天板 HP40 ボス / アーチ頂点とボスの間の肉 |
| `cradle_len / rib_y / rib_t / rib_h` | 200 / [−96, 0, 96] / 8 / 60 | リブ |
| `wall_out_t / wall_out_gap` | 9 / 2 | 外壁 (X 119..128) / アーチとの隙間 (薄片防止) |
| `cord_d / cord_dx / cord_z` | 7 / ±46 / −12 | 端リブの掛け紐穴 |
| `lug_d / lug_w / lug_drop` | 8 / 20 / 26 | 外側ラグ (X 117..137, z −86..−60) |

## インタフェース

| 相手 | 内容 |
|---|---|
| `parent_deck` | 内壁面 X=0 = デッキ側壁外面 (X ±108)。HP40 ×2 (Y ±70, z −25): M5 バカ穴 Ø5.4 ×4 + 中央 Ø14 → デッキ側の M5 インサート。**M5 ×16** ×8 / 側 |
| `parent_fender` | アーチ r53 (胴 Ø100 + 隙間 3)。掛け紐 Ø7 ×4、ラグ Ø8 ×2、デッキ側壁 Ø8 ×2 で紐固定 |
| 拡張アクセサリ | 天板 HP40 (グローバル X ±172, Y 0, z 0)。中央 Ø14 は胴の上に抜ける (ケーブルは胴を避けて横へ) |

## 干渉チェック (`.scad` 冒頭の assert)

- 胴上面 (アーチ頂点) が天板ボスに当たらない (`arc_gap` 2) / 胴が内壁に当たらない / アーチが内壁を削らない
- リブ下端が胴中心より上 (差し込める) / リブ下端でアーチが内壁・外壁の足を残す (≥ 2)
- 抱え込み半角 ≥ 70°
- HP40 アダプタ穴が内壁の Y・Z 範囲内 / デッキ側壁高さ ≤ リブ高さ
- 掛け紐穴が天板 (≥ 3)・アーチ (≥ 3)・天板ボス・壁から離れる
- ラグが胴に当たらない (≥ 2) / ラグ穴の端距離 ≥ 5 / 中央リブが Y=0 にある (天板ボスの支え)
- 250³ 造形枠

実際に止めたもの (2026-09-04): アーチ頂点が天板ボスに 0.01 接触 → `arc_gap` 2 を導入し
胴中心を −68 → −70 へ。

## 荷重ケースと強度

| ケース | 荷重 | 係数 | 入力 | 受け |
|---|---|---|---|---|
| L1 定常 | 浮力 (片側 20 N) | 1 | アーチ | 内壁 HP40 |
| **L2 持ち上げ** | 機体 4 kg の半分を浮子で持つ → **100 N 上向き** | 5 | アーチ | 内壁 HP40 ×8 ボルト |
| L2c 紐引き | 50 N (−Y) | 3 | 外側ラグ | 内壁 |
| L3 落下 | 天板座のアクセサリ 0.5 kg → 50 N | 10 | 天板 HP40 | 内壁 |

`quick_strength.py` (PETG): HP40 ラグ (穴 5.4, 端 5, t8, 44 N) 面圧 1.0 MPa ✅ (端距離 0.93 d は
HP40 規格値どおり)、外側ラグ (穴 8, 端 6, t8, 50 N) 層間で 0.8 MPa ✅、天板 (梁近似, 50 N) は
中央リブと 50 角ボスで受けるので片持ち式のたわみ 8 mm は当たらない。

### FEA 結果 (`fea/study.json` → `topopt fea --voxel 1.6`, 出力 `fea/out/`, 2026-09-04)

PETG 直交異方性カード、build 軸 Z、100,084 要素、メッシュ解像度 PASS (最薄部 9.6 mm に 6 要素)。
支持 = 内壁 (HP40 アダプタ板、X 0..3 帯)。

| ケース | 荷重 | 最大変位 | von Mises 最大 | 安全率 (最悪 / p99.5) | 判定 |
|---|---|---|---|---|---|
| L2 浮子の押上げ | 100 N 上向き (アーチ面) + 自重 ×5 | 0.22 mm | 1.6 MPa | 25 / 51 | ✅ |
| L2c 紐引き | 50 N (−Y, 南ラグ穴) + 自重 ×3 | 0.58 mm | 5.9 MPa | **5.4** / 30 | ✅ |
| L3 落下 | 50 N (天板 HP40 座) + 自重 ×10 | 0.24 mm | 2.0 MPa | 23 / 47 | ✅ |

最も厳しいのは**紐引き** (ラグの根元 = 端リブ下端との接続部、層間引張)。SF 5.4 で合格だが、
紐を強く張る運用 (ブライドルにテンションを掛ける) なら**ラグ根元を Fusion で R3 以上のフィレット**
にするか `lug_w` を 24 に広げること。最大変位はラグ先端 (0.58 mm)。

## 印刷 (X1-Carbon)

- **上下反転** (天板をベッドに)。リブのアーチは上に行くほど細くなる形なのでオーバーハング無し。
  `topopt overhang` (反転 STL): **要サポート面積 0.9 %** (ラグ穴・横穴の上面のみ)。**サポート不要**。
- 主引張: アーチの押上げ → 天板・外壁の面内 (X)、ラグの紐引き → リブ面内 (Y)。層面内。
- 材料 PETG (屋外は ASA)。壁 4 本 / インフィル 25 % / 上下 5 層。2 個同じ物を印刷。
- 天板 HP40 の下穴は反転印刷でベッド側 = 印刷後にそのまま熱圧入。内壁の M5 バカ穴は水平穴。

## 部品外の考慮

- **紐の掛け方**: (1) 掛け紐 Ø5: 端リブの穴 → 胴の下を回す → 反対側の穴 → 天板上で結ぶ (両端 2 本)。
  (2) ブライドル: 浮子端アイ → 外側ラグ Ø8 と デッキ側壁 Ø8 (Y ±108) の 2 点。
  紐を締めると胴がアーチ頂点に密着する (アセンブリはその状態で置いている)。
- **フェンダーが空気入り**なら日射で膨らむ。隙間 3 mm と掛け紐の伸びで吸収。
- クレードルを外すと**デッキ側壁の HP40 座が空く** → 輸送時は外して平積み (137 × 200 × 86 ×2)。
- 天板 HP40 の中央 Ø14 は胴の真上に開く。ケーブルを通すなら胴を避けて外壁側へ。

## 要確認

1. **フェンダー実測** → `fender_d` / `fender_len` / アイ形状 (最優先。アーチ・ラグ位置が動く)
2. 掛け紐の太さ (Ø7 穴で Ø5 まで)
3. 予備浮力不足 (`parent_fender.md`) でフェンダーを大型化する場合: `fender_d` を変えるだけで
   アーチ・胴中心・ラグが追従する。250 枠は `x_lug1 = 8 + 6 + d + 3 + 2 + 9 + 20 − 2 ≈ d + 46` で Ø200 まで
