AquaBeacon/mechanical/assemblies/parent_open/README.md

**印刷一式:** [parts/PRINT.md](parts/PRINT.md)（STL・数量・モディファイア） · **確認画像:** [_work/images/](_work/images/)

# 親機・開放フレーム＋カメラ／TD04Aマウント（2026-09-18）

今回印刷するのは以下の**6種類・計10個**。`parent_open_prints.zip`に印刷向きに回転済みのSTLをまとめた。ZIP内は1種類1ファイルなので、個数はスライサで指定する。古い全面底板 `parent_simple_deck`／`parent_clamped_deck` と旧円筒TD04Aクランプは今回使用しない。

|STL名|個数|用途|印刷時の外形 mm|
|---|---:|---|---|
|parent_open_frame|1|箱底の必要部分だけ支える開放フレーム|236×236×12|
|parent_clamp_bar|2|箱上面の押さえバー|236×24×12|
|parent_float_lug|4|左右2個ずつの浮子固定耳、φ10.5穴|24×32×44|
|parent_compact_carrier|1|カメラとTD04Aの共通取付台|210×88×67|
|parent_camera_mount|1|Osmo Action 6ケース用マウント|104×79.45×84.5|
|parent_td_bracket_jaw|1|TD04A付属金属ブラケットの押さえ板|50×14×8|

## 箱を固定する構造

全面底板を左右の24 mm幅の桟＋横桟2本へ変更。元の236 mm角底板に対して下部フレームの樹脂体積は約64%減。箱底の穴は使わず、上部バーと外側M5全ねじ4本で上下から挟む。箱全体を覆う印刷シェルはない。箱の蓋・外壁は購入防水箱が担う。

浮子取付耳と上部バーは前のクランプ案と同一。既に印刷していれば再利用できる。共通取付台はセンサー固定のため箱底から100 mm下まで出るが、揺れ止め支柱・フィン・錘は設けていない。蓋を開ける際は上側ナット4個とバー2本を外す。

## センサーマウント

カメラは既存のOsmo Action 6ケース用マウントを親機用にコピーし、90°回して下向きに固定。中心X=-48、取付基準Z=-66、取付面Y=0。固定穴は22×32 mmピッチのM5×4。ケース包絡95×45.9×75 mmと取付ツメ寸法は実物適合未確認。別のカメラ／裸のカメラを固定する形状ではない。

TD04Aは2026-09-17更新の写真・スキャン参考形状に合わせて配置。正面を下向き（−Z）にし、付属金属ブラケットの端を共通取付台と押さえ板で挟む。センサーの胴体を円筒と仮定する旧クランプは使わない。金属板への新規穴加工は不要。

押さえのM4ねじは36 mmピッチで、仮ブラケット幅24 mmの外側を通る。金属板厚2 mmを仮定し、14 mmの高さで挟む。押さえ位置X=55、Y=2、Z=-35。実物の金属板幅・厚さ・平らな部分の長さは**印刷前に確認が必要**。最新TD04A参照モデル自体も寸法保証がないため、この取付台は試作寸法。締付力・滑り止め・耐荷重は未評価。

## 別途必要な金具

|用途|金具と個数|
|---|---|
|箱の上下クランプ|M5全ねじ150 mm×4、M5ナット×8、外径10 mm座金×8、14×24×2 mmゴムパッド×4|
|浮子取付耳|M5×30×8、M5ナット×8、座金×8|
|共通取付台と下フレーム|M5×25×4、M5ナット×4、座金×4|
|カメラマウントと取付台|M5×25×4、M5ナット×4、座金×4|
|カメラのツメ軸|M5×25相当×1、二面幅8 mm・厚さ4 mm以下のM5ナット×1（ケース実物に合わせて確認）|
|TD04A金属ブラケット押さえ|M4×30×2、M4ナット×2、座金×2|
|浮子との接続|φ10.5穴に適した紐／アイボルト等。相手金具に合わせて選定|

金具は購入品で印刷しない。表示モデルはねじ山を省略し、TD用ナット・座金とカメラ軸ねじの表示は省略。共通取付台のM5ねじ頭はフレーム上面の深さ6 mm座ぐり内に収まる。箱を置く前に締めておく。ねじ長は上記板厚スタックに基づく初期値で、使用する頭・ナット・座金厚に合わせて確認する。

## 印刷と組立

1. ZIPの6種類を表の個数で印刷。PETG、0.4 mmノズル、0.20 mm層、壁6周、上下6層、40%インフィルを初期設定にする。
2. 共通取付台を下フレームにM5×25×4で固定する。取付台は箱の下に来る。
3. カメラマウントを取付台にM5×25×4で固定し、ケースのツメを軸ねじで固定する。
4. TD04A付属金属ブラケットを取付台と押さえ板で挟み、M4×30×2を均等に締める。振動面を下向きにする。
5. 浮子耳4個を付け、箱・全ねじ・上部バー・ゴムパッドを組む。
6. ケーブルは取付台の側面を回し、φ5の結束穴で張力を逃がす。プラグを穴へ通す前提や切断の指示ではない。既存ペネトレータへの接続方式は実ケーブルに合わせる。

STLは底面Z=0に配置済み。取付台は背面をベッドにし、カメラマウントは元の基台を下にして印刷する。浮子耳の横穴とカメラのツメ周辺はスライサで局所サポートの要否を確認する。下フレームは236 mm角で5 mmブリム込み246 mm。X1Cの禁止領域を含むスライスは未実施。

## 検証・データ

- 6種類の印刷STLは全て閉じた単一メッシュ。個別STEPは単一ソリッドで、生成時にSTLと外形・体積を照合。
- FreeCADで17部品（印刷部品、箱、浮子、センサー仮形状等）の配置を評価。印刷部品が関係する組合せの体積干渉は0件（0.1 mm³超を検出）。`solid_checks.json`参照。
- この検査はゴム・蓋の簡略参照、金具の干渉・工具アクセス、ケーブル、締付力・水密・浮力・カメラ画角を含まない。実物形状と滑り・樹脂の長期変形は別途確認する。
- `parent_open_structure.step`：印刷部品と購入品参考形状の組立STEP。金具・ゴム・簡略蓋は含まない。
- `parent_open_view.scad`：簡略金具を含む表示。配置の正は`placement.json`。
- `prints/`：印刷用STL。設計SCAD・STEPは`parts/parent/exterior/printed/<部品名>/`。

再生成：新規4種類を`build.ps1`でビルド後、`python spec/build_parent_open.py`。構造STEPと干渉確認はFreeCADコンソールで`spec/verify_parent_open.py`を実行する。
