AquaBeacon/mechanical/assemblies/quick_release_trials/print_jobs/README.md

# スライサプロジェクトの記録

`quick_release_prototypes_snap_male.3mf`は利用者がparts内へ追加したスライサプロジェクトを、このフォルダへそのまま移動したものです。内容は変更していません。2オブジェクトで、両方ともフィラメント1（PETG）を指定。元の設定は0.2 mm層、2周壁、15% infill、サポート有効。試作の推奨開始条件（5周壁・40% infill）とは異なるため、強度確認済みの設定とは扱いません。

3MFのSHA-256、移動元、材料・設定と移動時の差込オス／メスSTLのSHA-256はmanifest.jsonに記録しました。STLハッシュは当時の比較対象の記録で、3MF内メッシュとの完全一致を認定するものではありません。

今回の窓から突出する爪への修正でBのオス・メスが変更されています。この3MFは修正前の履歴で、現行形状の印刷用として使用しないでください。ファイルの内容と当時のハッシュは保持しています。最新の印刷用STLの入口は[../parts/PRINT.md](../parts/PRINT.md)です。

作業中に追加された`quick_release_prototypes_slide_female.3mf`も、partsからこのフォルダへ内容を変更せず移動しました。名前に反してA/B/Cとノブの7オブジェクト定義を含み、全てフィラメント1、2周壁・15% infillです。現行のA押さえの専用オブジェクトは含まれておらず、最新STLとの形状一致も未照合です。[個別の記録](quick_release_prototypes_slide_female.manifest.json)に3MFハッシュ、材料・設定、追加時のSTLハッシュを保存しました。最新の9種類9点はPRINT.mdから印刷してください。

2026-09-28: 固定ナット内蔵・手回しボルト版、厚いA/C上側板、斜面付きC爪・回転溝は保存済み3MFに含まれない。最新STLから再配置する。C金具はM3×40へ変更した。

2026-09-28: 作業中に追加された`quick_release_prototypes_twist_female.3mf`を内容を変更せずpartsから移動した。現行カム形状との一致は未照合。3MFハッシュ・設定・保存時のSTLハッシュは同名のmanifest.jsonに記録。最新STLを再読み込みして印刷する。

2026-10-01: くぼみ追加前にpartsへ置かれた`quick_release_prototypes_twist_male.3mf`を内容を変えず移動した。現行5.4×8.4×0.4 mmくぼみとの一致は未確認。同名のmanifest.jsonに3MFハッシュ・設定と移動時のSTLハッシュを記録。最新STLを再読み込みして印刷する。
