AquaBeacon/mechanical/assemblies/child_single_camera_topopt/gravity_audit.md

# 自重の表示・入力・探索実装の確認

2026-09-10。ユーザーの「分布自重のずれが原因では」という指摘を受けて確認。

- 荷重図の橙色G矢印は `spec/render_child_setup_loads.py` で設計空間中心から表示上ずらしている。実際の荷重点ではない。この位置はstudyにもソルバーにも渡らない。表示を明確化した。
- 全3部品のL1は `gravity.direction=[0,0,-1]`, `g_factor=3`。組立座標の下向き。ブリッジの `build_axis=Y` は造形・材料軸であり、重力をY方向へ回転する指定ではない。
- topopt `loadcase.py:451` 以下は `grid.solid` の各要素の自重を8頂点に均等分配する。部品外のG矢印位置への集中荷重ではない。
- **探索実装には別の問題がある。** `generative.py:340` はsetup.gridを使用し、431行で反復前に一度だけbuild_bcsを呼ぶ。`designspace.py:545` のgridは探索domainであり、探索中の密度変化に合わせた自重の再組立はない。従って探索中の自重は最終材料配置の自重と一致しない。形状への影響の程度は未検証。ソルバーコードは変更していない。
- 最終FEAは `generative.py:1075` で抽出形状maskのgridを作り、1083行で荷重を再組立する。報告済みの最終FEA自重は抽出形状に適用されている。
- ゲート最悪ケースL4（SF0.172）とコア最悪ケースL2h（SF1.120）はgravity指定なし。その最終FEAの強度不足を自重表示のずれだけで説明できない。ただし探索中の自重が得られた形状に影響した可能性は残る。

次の解析条件を確定する前に、探索中の自重の扱いを修正・検証する必要がある。密度に依存する自重を正しく扱うには荷重更新だけでなく最適化の感度も考慮する。現状では「補強だけが原因解決」とは断定しない。
