AquaBeacon/mechanical/spec/child_interior_reinforcement/PRINTED_REINFORCEMENT.md

> 2026-09-27現行: Bambu PLA Matte向け、60 mm根元・20 mm固定座・局所フランジ受け足、前側梁10 mm。印刷設定と解析の限界は spec/child_interior_reinforcement/PLA_MATTE_REVISION.md。以下の旧寸法・材料待ち記述は履歴です。

> 2026-09-27現行版：下リブ廃止、WetLink M10×5実配置、電池サービスねじをZ36へ移動。手順と検証は `spec/child_interior_reinforcement/SERVICE_REVISION.md`。以下は旧版の履歴を含みます。

# 印刷部品による根元補強（200 mm 内装）

現行版。追加の金属スリーブ・押さえ板を廃止。既存のM3ねじとスペーサを使用する。
LCDは配置から撤去済み。

## 変更

- 左右の耳を閉じたM3 Ø3.4穴、厚さ12 mmの座に変更。
- デッキ側の根元をX40..48.7、Z20..51の31 mm長の一体構造に変更。
- 根元のYZ断面はR3の凹側フィレット、R0.8の外周丸め。
- デッキ外形、スリット、露出する角形パッドなどにはR0.6を追加。
- 前側ブレースも閉じたM3穴、平らななべねじ座に変更。
- 位置決め面・ねじ穴・基板座などの機能面は寸法と接触を優先する。
  全ての稜線が丸まっているわけではない。円柱ボスの端面や座面の縁は残る。

## 検証

- t200デッキおよびブレースのSTLは水密・一体。
- STEPはSTLからのファセットソリッド。FreeCADで1 solid / valid、体積差0.001%未満を確認。
- 変更構造と隣接する非ねじ部品の干渉検査はINTERFERENCES []。
- 全体接触検査: FLOATING []。既存のケーブル包絡モデルの重なりが残るため、全体検査の終了コードは1。新しいデッキ／ブレースの非ねじ干渉はない。
- PCB取付穴12箇所はKiCad実基板と一致。
- 組立STEP配置検証: child_interior 72部品／child_vertical_assembly 79部品、いずれも0 NG。
- 容器に対するデッキ・ブレースの最小半径方向すきまは1 mm。
- OpenSCAD出力にはmanifold警告があったため、結合後のメッシュとSTEPを別途検証した。

## 強度は未判定

材料・搭載重量・荷重条件の回答待ち。安全率や許容締付トルクは未算出。
形状改善だけでは破損しないことを保証できない。ねじ締付力、積層方向、
造形条件を含めて解析し、実造形で締付および荷重試験を行う必要がある。
解析前の試作品として扱う。旧CRUSH_PROOF.mdは廃止した金属補強案の履歴。
300 mm版は本改訂の検証対象外。
