AquaBeacon/mechanical/parts/child/interior/printed/child_lcd_hinge_frame/child_lcd_hinge_frame.md

# child_lcd_hinge_frame

LCDドアの固定側Cフレーム。既存の上下LCD支持アーチへM3×2で固定し、左側M3ヒンジと右側M2.5ラッチを保持する。中央を大きく開けているため、LCDドアを開くとC-MAINのコネクタや部品へアクセスできる。

- 印刷方向: SCADの向きのまま平面をベッド側。サポート不要
- ヒンジ: M3×60部分ねじボルトまたはØ3 mm平行ピン、ワッシャ＋ナイロック
- ラッチ: M2.5×12低頭ねじ1本、フレーム側M2.5用ヒートセットインサート
- 抜け止め: ラッチねじのドア裏へ小径シリコンOリングを装着
- 操作: 内装を筒から70 mm以上引き出してから、ラッチ1本を緩めて約100°開く

筒内では開かないこと。閉じた状態でのみ耐圧容器へ挿入する。

## 2026-08-28 固定: 取付ラグの位置を修正

ラグがアーチと同じ Z 帯 (22..27 / 117..122) にあり、アーチに 2.6 mm 食い込んでいた。
ラグをアーチの**内側面**に載せる位置 (z 27..32 / 112..117、印刷座標 |y| 40..45) へ移し、
M3×10 なべを軸方向に通してアーチの下穴 Ø2.8 (0, 39.6) へセルフタップする。ラグ穴はラグ全長を貫通。
ヒンジピンは M3×60 頭付きから **M3 全ねじ 105 + ナット** (両アーチ受け) に変更。ナックルの穴 Ø3.4 はそのまま。
