AquaBeacon/mechanical/parts/parent/exterior/printed/parent_float_segment/parent_float_segment.md

# parent_float_segment — 親機 リング浮子 1/4 セグメント

> **廃止 (2026-09-04)**: 親機の浮子は市販円筒フェンダー ×2 (`parts/parent/exterior/cots/parent_fender/`)
> + `parent_float_cradle` に変更。本部品は参考として残す (印刷しない)。

| 項目 | 値 |
|---|---|
| 区分 | 親機 / 外装 / 3Dプリント |
| 設計ソース | `parent_float_segment.scad` |
| 個数 | 4 (1/4 リング ×4 で 1 個のリングになる) |
| 外形 | 150 × 150 × 80 mm |
| 体積 (プリント材) | 210.9 cm³ / 個 |
| STEP | 1 ソリッド / 17 面 |

## 役割

OD 300 / ID 140 / 高さ 80 のリングを 4 分割した**上面開放シェル**。
印刷後に 2 液発泡ウレタンを充填し、表面はエポキシ塗布する (仕様メモ準拠)。
中央開口 Ø140 に防水ボックスマウント (別途) が載る。

**全没排水量 4.42 L** (リング全体)。

## 主要寸法

| 変数 | 値 | 意味 |
|---|---|---|
| `ring_od / ring_id / ring_h` | 300 / 140 / 80 | リング |
| `wall / floor_t` | 3 / 3 | 側壁厚 / 底厚 |
| `end_t` | 8 | 端面 (角度方向) の壁厚 |
| `bolt_r / bolt_z / m5_d` | [95, 130] / 40 / 5.3 | 端面 M5 ×2 |
| `pin_r / pin_z / pin_d / pin_dp` | 112.5 / 20 / 8.3 / 12 | Ø8 ダウエル (市販ロッド) |

## インタフェース

| 相手 | 締結 |
|---|---|
| 隣接セグメント | 端面 M5 ×2 + Ø8 ダウエルピン ×1。ボルト/ナットは**上開口側から**工具アクセス |
| 防水ボックスマウント | 中央開口 Ø140 (**マウント自体は未設計**) |

## 干渉チェック (`.scad` 冒頭の assert)

- リング断面が薄すぎないこと
- ボルト/ピンの半径位置がリング内に収まること
- ボルト高さが妥当
- 端面でボルトとピンが接近しすぎないこと

## 印刷向き

このまま (開口が上)。壁は垂直・底は閉じているのでサポート不要。
bbox ~150×150 なので 220 角ベッドに収まる。

## 部品外の考慮

- **発泡ウレタン充填が防水の本体**。プリントシェルは型でしかない。
  充填不足の空隙は水没時に潰れる。充填後の**質量測定で密度を確認**すること。
- エポキシ塗布は**継ぎ目 (4 箇所) を跨いで**行うか、分割したまま塗るかで
  分解可否が変わる。跨いで塗ると 4 分割の意味がなくなる。方針を決めること。
- ボルト/ナットが上開口側にあるので、**発泡ウレタンで埋めてはいけない**。
  充填前にボルト部をマスキングする手順が要る。
- リングを浮力体にするので、**質量と排水量のバランス**が親機の喫水を決める。
  4.42 L の排水量に対し、機体総重量が超えると沈む。BOM 確定後に再計算すること。
- ケーブル (テザー) がリングを跨ぐ。**擦れ防止**の逃げが未設計。

## 要確認

1. 発泡ウレタンの密度と充填後の実質量
2. エポキシ塗布の方針 (分割維持 or 一体化)
3. 防水ボックスマウント (中央 Ø140) の設計 — **未着手**
4. 親機総重量 → 喫水の再計算
