AquaBeacon/mechanical/assemblies/child_single_camera_topopt/review.html

# 子機外装：setupと全17荷重ケース

2026-09-10 / この図はsetup時点の記録です。最適化結果はREADME.mdを参照。以下は最適化前の設計空間です。緑＝保持、赤＝材料を置けない領域、灰＝設計空間。荷重図の赤は力の矢印です。各ケースは別々に評価し、同時に全ケースの力を加える意味ではありません。

荷重・支持のボックス領域は保持ボクセルとの重なり部分へ適用されます。領域の一部が保持部から外れる警告があります。支持反力は未知量なので、入力荷重と混同せず青の固定箇所として示しています。保持部をすべて描くため、裏側の矢印も手前に透過表示しています。

## 機器・配線・手の除外領域

中央カメラ1台、右側縦向きライト1灯。カメラは柱を避けて前へ9mm移動。設計前端137mm、背面−110mmで奥行247mm。ユーザー承認済み構成。最適化の進行結果はREADME.mdを参照。 配線は仮の経路包絡で、最小曲げ半径は未確認です。

  

## コアフレーム：setup全領域



入力study / 3D setup / setupログ

## 可動ゲート（最新ラッチ）：setup全領域



入力study / 3D setup / setupログ

## カメラブリッジ：setup全領域



入力study / 3D setup / setupログ

## コアフレーム — L1 吊り下げ 3g



## コアフレーム — L2s 側面輸送荷重



## コアフレーム — L2h ヒンジ側への荷重



## コアフレーム — L2r 背面輸送荷重



## コアフレーム — L3 締付け荷重



## コアフレーム — L5 着底荷重



## コアフレーム — L6 持ち手の持上げ（仮条件）



## コアフレーム — L7 縦向きライトの荷重



## 可動ゲート（最新ラッチ） — L1 吊り下げ 3g



## 可動ゲート（最新ラッチ） — L2f 前面荷重



## 可動ゲート（最新ラッチ） — L2s ラッチ側への荷重



## 可動ゲート（最新ラッチ） — L3 締付け荷重



## 可動ゲート（最新ラッチ） — L4 前突モーメント



## カメラブリッジ — L1 吊り下げ 3g



## カメラブリッジ — L4 片側前面への荷重



## カメラブリッジ — L2s 片側側面への荷重



## カメラブリッジ — L6 カメラで持上げ
