AquaBeacon/mechanical/parts/child/exterior/printed/child_core_frame/archive/v4/child_core_frame.md

# child_core_frame — コアフレーム (ワニ顎の固定側 + 背骨)

外装フレーム再設計の「おおもとのフレーム」(R8)。旧 `child_shell_aft` の置き換え。
[再設計要件](../../../../../docs/子機外装フレーム再設計_要件.md) /
[改善要件 2026-09-04](../../../../../docs/子機外装_改善要件.md) (§3.1 / §3.3 / §3.6 / §3.7 を v4 で反映) /
アセンブリ `assemblies/child_frame2_assembly/`。

| 項目 | 値 |
|---|---|
| 個数 | 1 |
| 外形 | **152 × 128 × 235.5 mm** (x −80..72 / y −110..18 / z −17..218.5) |
| 体積 | **v4: 650.0 cm³** → PETG 約 520 g (v3 477.7。背面壁 t14 + HP2/3 座 + HP1 ペデスタルで +36%) |
| STEP | 1 ソリッド / 356 面 / watertight |

## 持っている機能

| 機能 | 諸元 |
|---|---|
| 顎の固定側半殻 (y≤0) | r58.35..64.35。上下ポケットで容器のキャップ (Ø120.3) / ドームリム (仮 Ø120.3) を捕捉 |
| ヒンジ | アフト側ナックル ×2 (z 13.4..85.1 / 115.9..187.6)。ゲート側 3 個の隙間に入る。ピン Ø5.4 @ (−72, 10) |
| **ゲート側クリアランス** (v4) | y ≥ 0 かつ r ≤ 64.35 の領域を差分で削り、ナックル角ブロックが `child_jaw_gate` の半殻に食い込まないようにした |
| **ヒンジピン抜け止めざぐり** (v4) | 上アフトナックル頂面 **z 187.6 から Ø10 × 深さ 4** (z 183.6..187.6)。残りナックル壁 (16−10)/2 = **3.0 mm** |
| ラッチ受け | M5 熱圧入インサート ×2 @ (62, y=0 面, z 40/170)、**深さ 14** (v4、旧 12)。ボス y −18..0 (旧 −16) |
| 吊り耳ボス ×2 | 頂面 z=218、M5 インサート ×2/枚 @ (±66, y −4/−16)。`child_lug` / `child_top_crown` が載る |
| パイロン | 側壁 x±(24..30) + **背面壁 t14 (y −101..−87)** + 屋根 z 182..190 (下面 45° ハンチ y −83..−51) |
| **HP1 ペデスタル** (v4) | 屋根の上に **x ±30、y −110..−60、z 190..218.5** の台。後端 9 mm (y −110..−101) は **45° ハンチ (z 181..190)** で背面壁の外面が支える。前端 y=−60 はシェル外面 (r64.35) と union |
| **HP1** (v4 で移設) | 座面 **z = 218.5**、法線 +Z、中心 **(0, −85)**。M5 インサート Ø6.4 × 深さ 9 ×4 @ (±20, −105/−65) + 中央 Ø14 (座面 → パイロン空洞まで貫通) + 向き矢印 (+Y) |
| **ペデスタル縦ケーブル穴 ×2** (v4) | **Ø12 @ (±18, −92)、z 174..218.5**。背面溝の上端 → 屋根 → 座面。溝が屋根で行き止まりにならないようにする |
| **HP2 / HP3** (v4) | 座面 **x = ±44**、法線 ±X、座中心 **(y −75, z 100)**。M5 インサート Ø6.4 × 深さ 9 ×4 @ (y −95/−55, z 80/120) + 中央ケーブル Ø14 貫通 (座面 → パイロン空洞 x<24) + 向き矢印 (+Y、deboss 0.6) |
| **背面ケーブル溝 ×2** (v4) | 幅 10 × 深さ 8、中心 **x = ±18** (溝 x 13..23)、**y −101..−93**、**z −17..182**。口に 45° 面取り 1 mm |
| **結束スロット** (v4) | 5.5 (x) × 3 (z)、軸 Y、溝底 y −93 → 空洞 y −87 を貫通。**z = 0 / 30 / 60 / 90 / 155** ×2 溝 |
| 取っ手 | 背面壁の手穴スロット 52×30 (z 115..145、上角 45°) を t14 壁に貫通 + 把持バー (z 145..175) |
| 下部ガードボス ×2 | シェル外面パッド r→70、方位角 210/330、M5 インサート ×2/枚 (径方向) @ z −9/+4 |
| 窓 ×4 (シェル) | 方位角 225/315、z [12,100] / [108,178]、45° 屋根 |
| 窓 ×4 (パイロン側壁) | **y −81..−59、z [28,70] / [130,168]**、四隅 45° 面取り 10 mm (v4 で t14 化と HP2/3 座を避けて移動) |

## v4 で決めた寸法とその理由

| 決めたこと | 値 | 理由 |
|---|---|---|
| HP1 をペデスタルで嵩上げ | 座面 z 190 → **218.5**、中心 y −75 → **−85** | 2026-09-04 のアセンブリ接触検査で、屋根直付けだと `xdcr_socket` の台座 60×60 と胴 r18 がシェル壁 (r58.35..64.35)・チューブ・ドーム押えリングに 3〜4 mm 食い込んでいた。座を容器の外へ持ち上げ、後ろへ 10 mm 逃がして解消 |
| ペデスタル前端 | y = −60 | z218.5 のドーム断面 (r ≈ 56.7 **仮**) から 3.3 mm。これ以上前に出せない |
| ペデスタル後端 | y = −110 (背面壁より 9 mm 後ろ) | HP40 の 40 ピッチ + Ø6.4 = 46.4 に座 50 を確保するため。**後端 9 mm は 45° ハンチ (z 181..190) で支える**のでサポートレス |
| 縦ケーブル穴 | Ø12 @ (±18, **−92**)、z 174..218.5 | 発注元指示は y=−97 だが、**HP1 後列インサート (±20, −105) と 0.95 mm 重なる** (中心間 8.25 < 6+3.2)。y=−92 なら中心間 13.15、残り肉 3.95 mm。溝 (y −101..−93) と空洞 (y −87〜) の両方に開くので機能は同じ |
| 屋根下面ハンチ | y **−83**..−51 (旧 −100..−51) | 縦ケーブル穴 (y −98..−86) から 3 mm 逃がす。切り詰めた後端 (y −101..−83) は背面壁 t14 が直接屋根を支えるので冗長 |
| ゲート食い込みの除去 | y ≥ 0 かつ r ≤ r_out を差分 | 接触検査でコアフレームの材料が **x −64.3..−64.0、y 0..5.4、z 13.7..187.6** でゲート半殻の中にあった (アフトナックル角ブロック x −80..−64 / y −8..18 の角がシェル外径の内側にはみ出していた、v3 からのバグ)。ナックル本体 (r > 64.35) と互い違い遊び 0.4 は不変 |
| HP2/3 座ブロック | x ±(30..44)、y −101..−50、z 72..128 | 座面 50×50 を確保しつつパイロン側壁 (外面 x=30) に直結。内前角に **45° 面取り 5 mm** を入れて、ブロック自体がチューブ内腔 r58.35 に一切入らないようにした (面取り無しだと角 (30,−50) が r58.31 で 0.04 mm 侵入し assert が止まる) |
| 溝口の面取り | 45° × **1 mm** (2 mm ではなく) | 溝外縁 x=23 + 面取り 1 = 24 が**パイロン側壁の足 (x 24..32, z −17..8) の内面と接する上限**。2 mm にすると足を 1 mm 削る |
| 結束スロット z | **0 / 30 / 60 / 90 / 155** | 30 mm ピッチのうち、手穴 (z 115..145) から 8 mm 以内に入る **z=120 と z=150 を省いた**。代わりに z=155 (手穴上端から 8.5 mm) を置いた。z=180 は屋根ハンチに塞がれてスロットにならない |
| 溝の上端 | **z 182** (屋根下面) | 屋根から上はペデスタルなので、そこは Ø12 の縦穴が受け持つ |
| 側壁窓 (pylon) の位置 | y −81..−59 / z [28,70]・[130,168] | 背面壁 t14 化で内面が y=−87 に来たので、既存 assert `pww_y[0] >= py_y1 + bw_t + 6` (= −81) を満たすため後端を移動。z は HP2/3 座ブロック (z 72..128) を ±2 mm 避けた。**四隅 45° 面取り 10 mm は維持** (v2 の SF1.59 対策) |
| ラッチ | インサート穴 **深さ 12 → 14**、ボス厚 16 → 18 | M5 ノブボルト (頭 Ø16) の先端逃げ。穴底の残り肉 4 mm。**ノブ頭 Ø16 を沈めるポケットは `child_jaw_gate` 側の責務** |
| 把持ブロック | 廃止 (背面壁に吸収) | 旧「取っ手ゾーンだけ y −101..−89 の 12 厚」は、背面壁が全高 t14 になったので不要 |

## インタフェース (二重定義 — 相手側と必ず同時に直す)

| 相手 | 共有値 |
|---|---|
| `child_jaw_gate` | 容器径・ポケット (`r_in/pkt_r/pb_*/pt_*`)、ヒンジ (`hinge_x/y, knu_*`)、ラッチ (`latch_hx=62, latch_z`)、**ノブボルト頭 Ø16 のポケット (ゲート側で彫る)**、**合わせ面 y=0 (コアフレームは y ≥ 0 に材料を出さない)** |
| `child_lug` / `child_top_crown` | ボス頂面 z218、M5 @ (±66, −4/−16) |
| `child_guard_ring` | ボス外面 r70、方位角 210/330、M5 @ z −9/+4 |
| **`xdcr_socket` (HP1)** | **座面 z = 218.5、中心 (0, −85)、M5 ピッチ 40 → (±20, −105/−65)、中央 Ø14、矢印 +Y**。ソケットは **child バリアント `base_w=50`** (発注元が 2026-09-04 に変更・再ビルド済み)。`placement.json` の `xdcr_socket` は **(0, −85, 218.5)** (発注元が更新済み、本ワーカーは未編集) |
| **`child_top_crown` / ユーザ設計ライトクランプ / `child_cable_cover` (HP2/HP3)** | **座面 x = ±44 (法線 ±X)、座中心 (y −75, z 100)、M5 ×4 @ (y −95/−55, z 80/120)、中央 Ø14、矢印 +Y、規格 HP40 = `scad/lib/hardpoint.scad`** |
| `child_cable_cover` (背面溝) | 溝 x ±18 (13..23)、幅 10 × 深 8、外面 y −101 / 溝底 y −93、z −17..182、結束スロット 5.5×3 @ z 0/30/60/90/155、ペデスタル縦穴 Ø12 @ (±18, −92) |

機械可読の値は `interfaces.json` の `provides` にも入れてある。

## 荷重と検証 (v4 確定・2026-09-04)

**トポロジー最適化** (`topo/`, 7595 ボクセル @4.14mm, filter 6.2, X 対称, 40 反復) は v3 のまま。
v4 の追加肉 (背面壁 t14、HP2/3 座、HP1 ペデスタル) は機能面なので最適化対象外。
幾何比較 `topo_cmp/` は v3 の「最適解ボクセルの 97.2% 包含」を維持 (肉は増える方向にしか変えていない)。

**FEA** (`fea_v4/`, voxel 1.73, `child_core_frame_topo.json` の 4 ケース。
改善要件 C6/Q2 により **L2 を 600 N → 300 N** に変更。L1 / L5 は据え置き):

| ケース | 荷重 | たわみ | 安全率 (最悪要素 / p99.5) | 判定 |
|---|---|---|---|---|
| L1 吊り上げ 3g (耳固定・搭載物自重) | 205 N | 0.489 mm | 5.17 / 30.07 | **PASS** |
| L2 輸送・側方 (C6 で 600→300) | 300 N | 0.120 mm | 6.09 / 28.02 | **PASS** |
| L2 輸送・後方 (C6 で 600→300) | 300 N | 0.116 mm | 9.89 / 31.91 | **PASS** |
| L5 着底 (ガードボス経由) | 600 N | 0.009 mm | 17.29 / 63.15 | **PASS** |

- 126,555 要素 / voxel 1.730 mm / 部品体積 655.3 cm³ (ボクセル値)。**4 ケースとも
  `mesh resolution` が PASS** (最薄 6.92 mm = 4.0 要素 / 典型 6.92 mm = 4.0 要素)。
  v3 では最薄局所が常に 2.8 要素で FAIL していた (45° 面取り先端を追うアーティファクト) が、
  背面壁 t14 化と HP2/3 座・ペデスタルで最薄部が厚くなり、v4 では素直に PASS する
- v3 (L2=600 N) との比較: 側方 SF 2.05→**6.09**、後方 4.13→**9.89**。荷重半減 (×2) に対して
  さらに肉が増えたぶん (×1.2〜1.5) が効いている。L1 は 4.26→5.17、L5 は 17.4→17.29 (ほぼ同じ)
- 最悪要素の位置: L1 = 吊り耳ボス根元 (±56, −21, 204)、L2 側方 = HP2/3 座ブロックの下端まわり
  (±31, −66, −2)、L2 後方 = HP2/3 座の前縁 (±45, −44, 100)、L5 = ガードボス。
  いずれも `max/p99.5` 比が 3.5〜5.0 の階段状アーティファクトなので、規約どおり **p99.5 で判定**
- **4 ケースは 2 回に分けて解いた** (L1+L2側方 → L2後方+L5)。1 回のバックグラウンド実行が
  セッションの時間上限を超えるため。STL・study 領域・voxel 1.730 は同一で、結果は
  `fea_v4/child_core_frame_fea.json` に 4 ケースぶん統合してある (`fea_v4/run.log` が生ログ)
- 閉形式 (フープ/ラグ/柱) は設計時に全て PASS 済み

## 印刷 (X1C)

| 項目 | 指示 |
|---|---|
| 材料 | **PETG** (`topopt` の直交異方性カード。約 520 g) |
| 姿勢 | **モデル姿勢のまま +Z up** (152 × 128 × 235.5)。`printability` **PASS**、オーバーハング **4.8%**、最薄断面 5.68 mm |
| 理由 | フープ荷重・L2 側方荷重が層面内 (`--load-axis 1,0,0` で cos = 0.00)。吊り耳を別部品化したので直立でよい |
| インフィル | **壁 4 周 / 上下 5 層 / gyroid 40%**。熱圧入インサートとボルト座の帯だけ **60%**: ① HP2/3 (x ±(28..46)、z 60..140)、② HP1 ペデスタル (z 188..218.5 全断面)、③ 背面壁 (y −101..−85 全高) |
| レイヤ | 0.2 mm、ノズル 0.4 mm |
| サポート | ① ナックル間隙、② 屋根下面 (ハンチ 45° 付きだが 28 mm ブリッジ)、③ **HP2/3 座ブロックの下面 (z=72 の水平オーバーハング、約 600 mm²/側)** にサポート。**HP1 ペデスタルの後端は 45° ハンチにしたのでサポート不要**。背面溝・溝口面取り・結束スロット (5.5 mm ブリッジ)・ペデスタル縦穴 Ø12 (垂直) もサポート不要。HP2/3 のインサート穴・中央 Ø14 は水平穴 (軸 X) だが Ø14 以下なのでブリッジで出る |
| 仕上げ | **窓の角は Fusion でフィレット R3 以上**を付けてから印刷する (FEA の角特異点対策、v3 からの継続指示) |

## 部品外の考慮

- **配線の正規ルート (§3.3)**: テザー / TD04A / ライトケーブルは背面溝 (x ±18) を通すが、
  **溝 (x 13..23) は取っ手の手穴 (z 115..145、x ±26) を横切る**。手穴の中をケーブルが走ると
  握った指がケーブルを直に押さえるので、**z 115..145 は溝を使わず、パイロン内空洞を迂回させる**:
  下から溝 → **z=90 のスロットで空洞へ入れる** → 空洞内 (y −87..−64) を手穴の裏側で上へ →
  **z=155 のスロットで溝へ戻す** → 溝の上端付近で **ペデスタル縦穴 Ø12 (±18, −92)** に入り、
  **座面 z218.5 へ抜ける** → HP1 中央 Ø14 経由で `xdcr_socket` 底へ。
  結束バンドは z 0/30/60/90 (溝側) と z 155 (溝復帰点)
- **HP2/3 のケーブル**: 座の中央 Ø14 → パイロン空洞 → 背面溝の結束スロット、が正規ルート
- **HP1 ペデスタルは突出物**: 座面 z218.5 はフレーム頂面 218 より 0.5 mm 高い。`child_top_crown`
  (カラー z218..245) と同じ高さ帯に入るので、**クラウン側の後方セクタが y −110..−60 / x ±30 を
  空けているか要確認** (改善要件 §3.5)
- **HP2/3 の座は突出物ではない**: 座面 x=±44 は包絡 (ラッチ側 x=72 / ヒンジ側 x=−80) の内側
- **内装アクセス**: 「ゲートを開けて容器を前方へ出してから」上フランジを抜く
  (ノブボルト 2 本 + 顎の開閉 ≈ 30 秒。v4 で蝶ボルト → ノブボルトに変更)
- ヒンジピン Ø5×240 は上から挿入する。**最上段の止め輪はゲート側ナックル頂面 (z218) に載る** —
  コアフレーム側のざぐり (z187.6) は下向き抜け止めの座

## 要確認

1. **`dome_r_ped = 56.7` は仮値** (z218.5 のドーム断面半径、発注元指定 2026-09-04)。ドーム実測が
   出たら `assert(abs(ped_y0) - dome_r_ped >= 3.0)` が生きるので、ペデスタル前端 y=−60 を再確認する
2. **ヒンジピン抜け止めざぐりの位置 (要判断)**: 改善要件 §3.7 は「コアフレーム頂面 z218 のざぐり」と
   書いているが、(−72, 10) の z218 は **`child_jaw_gate` の最上ナックル (z 188..218)** の材料で、
   コアフレームはそこに何も持っていない。v4 ではコアフレームの上アフトナックル頂面 (z 187.6) に彫った。
   このざぐりは床 z183.6 とゲート最上ナックル下面 z188 (遊び 0.4) の間に E リングを閉じ込めるので
   **軸方向の拘束としては上下とも効く**。問題は**組立て**で、ピンを抜いた状態でも z 183.6..187.6 へ
   横から手が入らないため、**この位置に E リングを後から嵌められない**。
   → 実用的な抜け止めは `child_jaw_gate` 最上ナックル頂面 (z218) のざぐり。**ゲート側で彫るか、
   ピンを段付きにするかの判断待ち**
3. **HP1 前列インサート (±20, −65) とペデスタル前面 (y=−60) の残り肉は 1.8 mm** (発注元の
   「≥ 2 mm」に 0.2 足りない)。HP40 のピッチ 40 + Ø6.4 = 46.4 に対し座の奥行きが 50 なので、
   前後とも 1.8 mm が上限 (2 mm には奥行き 52.8 が要る)。**z ≤ 218 ではシェル (r64.35) が前面を
   裏打ちして実効 7.0 mm** になるため、薄いのは最上部 0.5 mm の縁だけ。座を 52 深くしてよいか判断待ち
4. **ペデスタル縦穴を y=−97 → −92 に変更**した (上表の理由)。ケーブルカバー側の想定と合うか確認
5. M5 ノブボルトの頭 Ø16 ポケット (深さ 12) は `child_jaw_gate` 側で未実装
6. **溝の x 位置と手穴の矛盾 (要判断)**: 改善要件 §3.3 は「取っ手の**左右に**溝 ×2」と書きつつ
   「中心 x ±18」も指定しており、手穴 (x ±26) と必ず重なる。外へ逃がすとパイロン側壁 (x 24..30) と
   背面壁の端 (x ±36) に挟まれて置けない。v4 は **x ±18 のまま残し、手穴帯だけ空洞へ迂回させる運用**
   で解いた。物理的に離すなら手穴の半幅 26 を縮めるしかない
7. **HP2/3 座ブロック下面のサポート**: z=72 の水平オーバーハングを 45° 面取りでサポートレスにできるが、
   その分ブロックが z<72 へ伸びる (指定は z 72..128)。面取りを入れてよいか判断待ち
8. 熱圧入インサートの引抜き耐力 (吊り耳ボス・HP1/HP2/HP3 は実測推奨)
9. v4 で体積が +36% (477.7 → 650.0 cm³、PETG 約 520 g) 増えた。全備重量の見直しが要るか
10. ドームリム実寸 (`dome_ring_od/t` 仮) — gate と共通
