AquaBeacon/mechanical/parts/child/exterior/printed/dji_osmo_action6_mount/archive/integrated_bottom_support/dji_osmo_action6_mount.md

# DJI osmo Action 6固定部品

2026-09-09。ユーザー要望により、試験片・支持台検討・固定部品をこのフォルダに集約。現行モデルは `dji_osmo_action6_mount.scad`。以前の試験片と分割型検討は `archive/` に保管。印刷中の試験片の寸法は変更していない。

## 一体化と剛性改善

- ベース、爪受け、前後支持壁、左右リブ、3か所の接触座を**一つの造形体**に統合。
- ベース厚6→8 mm。支持脚を前後の幅84 mm・厚8 mmの壁に置換し、左右を厚8 mmリブで接続。独立支持脚の下穴・固定ねじと受けのM3締結を廃止。
- 支持接触座は幅16×奥行6 mm。前側2点と後側1点で支持。厚い壁から4 mmだけ突出する形とし、細長い独立支柱を廃止。
- 純正ねじの挿入軸に半径14 mmの逃げを左右リブへ設置。ねじ柄寸法は写真推定なので操作性は実物確認待ち。
- 機体固定は旧案同様22×32 mmピッチのM5穴4か所。壁を貫く径10.4 mmの頭・工具用逃げを設置。

これは剛性を高める形状変更であり、FEAや荷重試験による保証ではない。爪厚は実物の隙間に制約されるため、中央2.7 mm・溝3.3 mm・穴5.2 mmは試験片相当を維持。薄い爪、積層方向、ケース側の爪、ケース接触面も全体の剛性を制約する。

## 寸法と検証

外形104×54×36.2 mm、STL体積79.06 cm³。OpenSCADレンダリング成功、trimeshで閉じた単一連結メッシュを確認。STEPは1ソリッド・72面、STLとの外形差0.00 mm、体積差約0.1%。プレビュー目視済み。FreeCADのユーザー設定保存に環境上の警告が出たが、STEP出力と形状照合は成功した。

実測済み：ケース側爪厚3 mm、隙間3 mm、穴径5 mm、本体底面→穴中心12.5 mm。ねじ軸高さ24 mm、名目ケース底面36.5 mm。前検討モデルの32.5 mmより**4 mm高い**ため、既存カメラ高さを維持するにはブリッジとの再配置が必要。現行機体アセンブリにはまだ組み込んでいない。

## 残る適合確認

接触位置・ケース奥行45.9 mm・本体外形95×75 mmは仮。ヒンジや蓋合わせ面への干渉を避けた実測モデルには未到達。接触座は名目底面より0.3 mm低く、実物に合わせた硬質シム等で隙間を調整する必要がある。隙間があるままでは回転止めにならない。

浮き上がりを抑える解除可能な予圧押さえは未確定。純正ねじだけで支持面への予圧が得られるとは扱わない。したがって一体化した本体だけで「絶対にずれない」を満たしたとは判定しない。

純正ねじと受け側金属ナットは別途必要。ナット座はM5普通ナット仮定で二面幅8.2 mm・深さ4.2 mm、脱落止めは未設計。支持壁の剛性、爪強度、操作性、許容姿勢変化、着脱再現性、画角、ブリッジ干渉は実物と荷重条件確定後に検証する。

STLは改訂検討用。追加印刷は試験片結果と接触位置確認後。ベース下面を下にする場合、爪の横穴・ナット座に局所サポートまたは穴仕上げが必要になり得る。印刷条件・姿勢は強度検証前であり量産指定ではない。
