AquaBeacon/mechanical/parts/child/exterior/printed/dji_osmo_action6_mount/archive/osmo_cradle_study/osmo_cradle_study.md

# Osmo純正防水ケース 受け台の設計検討

2026-09-09。印刷待ちの間に進めた検討モデル。実機用の完成品ではない。

## 要求と構成

位置・角度ずれを抑え、取り外しを容易にする。純正ねじを使い、3枚爪受けを交換可能な別部品にする。ケースの前側2点・後側1点を支持し、底面形状に合わせて支持部品と硬質シムを交換する。支持位置は `pad_xy` で変更可能。試験片の結果は `fit` と穴径へ反映できる。

純正ねじは抜け止めを担当する。3点支持だけでは上向き荷重で接触が失われるため、これだけで回転止め完成とはしない。最終形は本体側の剛性のある接触面を選び、手で解除できる押さえで支持面への予圧を維持する。上面ラッチ、後蓋ヒンジ、シール合わせ面、レンズ窓を押さえない。写真だけでは上側の安全な接触位置を確定できず、押さえの形状と予圧量は未確定。柔らかいゴムだけで位置を決める方式は避ける。

## 実測と未確定の分離

| 寸法 | 状態 |
|---|---|
| ケース側爪厚3、間隔3、穴径5、底面→穴中心12.5 mm | ユーザー実測 |
| ケース95×45.9×75 mm | 図の概略値と旧公称値を混用した仮包絡。形状モデルではない |
| 支持位置 X=±30/Y=19、X=0/Y=-19 mm | 仮。後側支持がヒンジに当たらないか実物確認が必要 |
| 中央爪2.7、溝3.3、穴5.2 mm | 試作公差。印刷結果待ち |
| 純正ねじの露出17〜18 mm | 写真推定。ピッチ未確定 |
| ナット二面幅8.2、深さ4.2 mm | M5普通ナットを想定した座。脱落防止蓋は未設計 |

支持面は名目底面より0.3 mm下に配置してある。`shim` はこの隙間量で、初期モデルにシムそのものは含まない。隙間を残した状態では姿勢を拘束できない。実測の底面凹凸に合わせたシムと接触面設計が必要。

## 機体への取り付けを確認する際の注意

ベースは104×54×6 mm。既存マウントの22×32 mmピッチに相当するM5通し穴を配置しただけで、既存ブリッジへの適合は未検証。ねじ頭・座金・工具・支持脚と周辺構造の干渉、基線150 mm、レンズ中心高さ125 mm、画角、バンパとの収まりを再検証してから組み込む。既存アセンブリは変更していない。

このモデルの底面位置はベース下面から32.5 mm。従来はマウント座から30 mmを想定していたため、同じ座にそのまま置くと底面が2.5 mm上がる。さらに実レンズ中心高さが未測定なので、カメラ位置確定には使えない。

ベースと受けはM3通し穴4本で接続する検討形状。締結部品の長さ・ナット保持は未確定。支持脚は底面に径2.7 mm深さ10 mmの仮下穴を設けた。繰返し調整用の金属ねじインサート等は採用品確定後に変更する。

## 検証済み／未検証

`python build_study.py` によりbase / receiver / padを個別STL化。3種類すべて閉じた単一連結メッシュであることをtrimeshで検査し、`mesh_check.json`へ保存。組立PNGを目視確認。これらは形状健全性の確認であり、強度・嵌合・保持力を示さない。STLは検討用で、追加印刷は現試験片の結果と接触位置確認後。STEPは未生成。

## 実物での受入確認

1. 現在印刷中の試験片：手で差し込める、穴が合う、ねじが適合ナットにかかる、柄を回せる。
2. 本体支持：本体側の接触面だけに当たり、ヒンジとシール面を避け、3点とも接触する。
3. 予圧機構：押さえを解除すれば外せる。固定時は支持面から離れず、ケース変形やラッチ操作への影響がない。
4. 姿勢：使用荷重を決め、荷重前後の姿勢変化を測定。許容値は撮影・ステレオ校正要件から決定する。
5. 再現性：着脱を10回繰り返し、レンズ位置と姿勢のばらつきを記録。水中・温度変化での緩みも実使用前に確認する。

現段階で追加の測定要求を出さず、印刷結果を待つ。次の実物確認では支持点周辺の凹凸とケース本体側の押さえ可能位置をまとめて確認する。
