AquaBeacon/mechanical/assemblies/child_simple_assembly/verification.md

# 検証結果 — 2026-09-16 r2（外付けナット）

## 2026-09-17 r3追記

rear中央にM3ライト用40×40 mm穴と60×60×8 mmの座面を追加。frontのSTL・3MFは保存したSHA256と一致し、再印刷不要。rearのSTLは閉メッシュ・単一連結体、STEP出力はSTLの外形・体積照合を通過。組立STEPの読み戻しは8部品・0 NG。追加した4穴のボルト・ナット工具空間も含めて干渉検査合格（cad_checks.json、revision=r3_rear_light）。

rearのサポート付き実スライスは成功。**以下のFEA数値はr2の記録であり、r3 rearの強度を示さない。ライト用マウントと実機ライトの形状・荷重は未確定、r3強度解析は未実施。**

## 結論

**形状・組立確認用の試作設計。構造強度の合格判定は得られていない。**

## 形状

- 3個のSTLは閉メッシュ、法線整合、単一連結体。各部品STEPも有効な単一ソリッド。
- 耐圧容器との15組＋新規部品間3組、合計18組で交差体積0.01 mm³未満。
- M3マウント8穴、前後締結4本、ガード8本とナット／工具の合計76領域で不要な交差なし。
- ガードの受け面4か所は各320 mm²。枠下面・支柱上面の双方が受け面を形成することをCADで確認。
- ガードのナット厚4 mm、両側ワッシャ、外径10 mm工具の進入経路を容器装着状態で検査。埋め込み・熱圧入・先入れは不要。
- 組立STEPは8部品、欠落0。読み戻し配置検査も8部品すべて一致。
- 根拠：`cad_checks.json`、`mesh_checks.json`、`_work/logs/build_assembly.log`、`_work/logs/step_vs_stl.log`。
- 新規3部品のチューブ参照はユーザー確認内容で固定済み。リポジトリ全体の参照検査は40件中34件の既存未確認／変更検出で不合格（`_work/logs/interface_check.log`）。新規3件の指摘はない。

## 造形

X1C実用250³に3部品とも収まる。最小肉厚の自動検査は合格。
前後枠はY軸方向に積層し、機体Z方向の引張りを層面内に置く。
ただし3部品ともサポート面積15%の自動基準を超え、造形判定全体は不合格。
サポートを有効にしたBambu Studioの実スライスは3部品とも成功。設定と経路の検証は[印刷記録](../../print_jobs/child_simple/print_summary.json)、条件は[印刷手順](../../print_jobs/child_simple/START_HERE.md)を参照。実機造形は未確認。ガードはZ荷重と積層方向の一致も警告される。
圧縮荷重でも横荷重による層間曲げがあるため、この警告を強度合格に読み替えない。

## FEA：未収束の参考値

PETG異方性モデル、前後枠build_axis=Y、ガードbuild_axis=Z、要求安全率4、許容変位2 mm。
3段階（4 / 2 / 1 mm）で検査。以下は最細1 mmの出力であり、**最終強度値ではない**。
最悪要素とp99.5を併記する。p99.5だけでは合格判定しない。

| 部品／ケース | 最大変位mm | 最悪要素の安全率 | p99.5安全率 | メッシュ収束 |
|---|---:|---:|---:|---|
| front / mount_pull_100N | 0.099 | 14.20 | 45.64 | 不合格 |
| front / vessel_axial_300N | 1.495 | 2.39 | 11.97 | 不合格 |
| rear / mount_pull_100N | 0.201 | 6.28 | 33.03 | 不合格 |
| rear / vessel_axial_300N | 1.487 | 2.39 | 11.97 | 不合格 |
| guard / landing_300N | 0.324 | 9.90 | 28.62 | 不合格 |
| guard / transport_X_300N | 0.584 | 2.05 | 8.78 | 不合格 |
| guard / transport_Y_300N | 0.349 | 4.13 | 16.90 | 不合格 |

### 荷重と限界

- マウント：前後締結のボルト周辺を固定し、取付板に面外100 N。後付けマウントの質量が未定のため設計用仮定。
- 容器保持：各半枠の吊り穴周辺を固定し、下側保持帯へ300 N下向き。全備約6 kg×5gを各半枠に単独で掛ける保守的なケース。
- ガード：8個の取付ボルト周辺を固定し、下のリングへ着底300 N、横X/Y各300 N。段差の面接触による荷重分担は計算に入れず、ボルト拘束だけで検査する。
- ボルト周辺の固定パッチによる応力集中、細いM3穴の離散化、対称な応力集中点の入れ替わりが含まれる。
  これらは今回解消・検証しておらず、低い最悪要素安全率を無視する根拠にはできない。
- EVAの面接触、ねじ予荷重、部品間の滑り、衝撃、水中・長期使用は未計算。
- r1のナット先入れ型は`revisions/r1_captive_nut/`へ記録。以下のFEAはr2の形状で再実行した結果。未収束の数値から旧版との改善率は算出しない。

**実運用前に残る作業**：ドームリング実測、実物合わせ、最終マウント荷重の定義、締結接触を含む強度再検証と荷重試験。
解析入力は`child_simple_*_study.json`、結果は`fea_*_final/`に保存してある。
