AquaBeacon/mechanical/parts/child/exterior/printed/child_exterior_structural_frame/spec/validation_results.md

# フレームAの検証結果

2026-10-01、左右フレームAの外枠薄肉化と外側接合板の試作。**外枠底板12→4 mm・縦壁4→3 mmへ修正し、形状・取合い・実スライスを確認した。強度検証は未完了。** 接地とガードの奥行き45 mm、M3取付座、持ち手上辺と付け根を保持する。一体Aと接合板単体の細かい格子では暫定基準を満たすが、メッシュ収束が不合格で、独立CalculiX解析はメッシュ生成に失敗した。完成機・分割接合の安全率を認定しない。

## 納品形状

正本は同部品フォルダのSCAD・`design_parameters.json`、仕上げSTL、5種類の印刷STL/STEP。解析生メッシュは印刷一式へ入れない。4分割片各2個と接合板12個、合計5種類20個。金属はM3×50・Ø7×0.5ワッシャ・M3ナット各48個。

| 検査 | 結果・範囲 |
|---|---|
| OpenSCADと仕上げ処理 | 完了。最適化密度面を平滑化し、保持領域・穴・開口を復元 |
| 全6STL（非印刷一体Aを含む） | 閉メッシュ、整合した面向き、正体積の1ボディ、面積ゼロ三角形なし |
| 外枠の薄肉化 | 底板4・縦壁3・奥行き45。旧密度面の境界に残る微小な膜を除去し、実STLの断面とサンプル点で確認 |
| 下部通路 | 270×100 mmを奥行き45全体で確保。実開口294×112、R6 |
| 持ち手 | 上辺保持、指入れ100×40、通過矩形90×30 |
| 穴・工具・ナット | Aの44 M3穴、AF5.5ナット、ねじ先端Z3.5、Ø9接合工具包絡などの通路検査に合格 |
| クランプ | 現行連結クランプ実メッシュとの交差体積0 mm³。吊り穴への0.8 mm逃げを含む |
| C取合い | FRAME-A-C-M3-REV1の8穴／Aを新規定義。C完成形状・ガードとの干渉は未検証 |
| 印刷寸法 | 下側169.83×211.83×44.98、上側169.83×195.83×44.98、接合板約48×26×20 mm。ブリム5 mm込みで250³内 |
| フィレット | 面内外隅R3、板厚端R0.6、下部R6、上部R5。穴入口面取り0.6。外形近似誤差約0.025 mm |
| STEP | 5種類すべて読み戻しで有効・閉じた1ソリッド。STLとの外形差0.01 mm未満・体積差0.014%以下。ファセットソリッドで、同一平面の面だけを統合した入力を使う |
| 組立モデル | 左右のA・接合板・購入金属164項目、欠落0でSTEP/STLを出力 |

現行記録は `../_work/analysis/frame_a_rim_thickness/final_geometry_checks.json`、`clamp_contact_checks.json`、`step_coplanar_*.json`、`step_readback.json`。一体AのSHA-256は `cc3881cbaa98a39d76ff052e9597b16033279b23a97b6eb1c03b3e6be8b90e9e`。旧CAD・原本解析は `frame_a_compact_grip/` とその `input_history/before_rim_revision/`、境界処理の不採用案は現行ケースの `input_history/` に保持する。

## トポロジー最適化と一体Aの再解析

native topopt、3 mm格子、自由領域体積率0.24、フィルタ9 mm、MMA応力制約、安全率3、50反復。保持領域は目標体積の約63%。反復上限で終了し、最適化収束は主張しない。内部を単純な梁へ描き直さず、抽出表面を仕上げた。

今回MMAは再実行せず、この内部密度面を用いて外枠の保持領域を修正した。底板4/6/8 mmと奥行きの探索を2 mm格子で比較し、底板4・縦壁3・奥行き45を選ぶ。粗い格子の肉厚解像度不合格は探索にも残し、最終の細かい格子で強度・変位を別途判定する。探索原本は `rim_comparison.json` と `candidates/`。C上部Y260の荷重面だけは実座厚45に合わせてZ33〜45へ変更し、他の座はZ0〜12を維持した。最終解析はこの修正済み荷重面を使う。

旧外枠の境界膜を除去する際、持ち手付け根まで切削すると1 mm格子で横方向最大変位4.358 mm・最悪要素安全率1.648となり不採用とした。局所Y250以上のnativeのつなぎ目を保持すると最大変位0.857 mm・安全率9.518に回復する。この範囲は上部指入れ開口の上端に接し、100×40の開口と90×30の通過矩形を維持する。不採用案の原本は `input_history/unreinforced_grip_root/`、最終再解析は以下。

完成機10 kg、クランプ60%・C40%配分は暫定。全質量を取付部荷重へ配分したモデルであり、各部の分布自重・実重心を再現するものではない。PETG Basic TDSに基づく未測定定数を含む異方性材料カード、積層Z・ラスタX、100%インフィル、外周8、変位上限2 mm。ワッシャ荷重面はØ9。実ツールパスに対する材料校正は未実施。

穴付き一体Aを4/2/1 mmの3段階で解析した。GPUメモリ節約のため支持条件ごとの3グループでnative CLIを実行し、7ケースを元の順に集計する。以下は最細1 mm、約173万要素の結果。安全率は最悪要素の値であり、p99.5値だけで合格扱いにしない。

| ケース | 最大変位 mm | 最悪要素安全率 | 最細格子の暫定基準 |
|---|---:|---:|---|
| 持ち上げ98.07 N | 0.0391 | 54.43 | 満たす |
| 直立49.03 N | 0.0463 | 61.31 | 満たす |
| 横方向＋98.07 N | 0.8566 | 9.52 | 満たす |
| 横方向−98.07 N | 0.8566 | 9.99 | 満たす |
| C下向き39.23 N | 0.02295 | 112.92 | 満たす |
| C前後＋30 N | 0.01100 | 134.94 | 満たす |
| C前後−30 N | 0.01100 | 134.94 | 満たす |

**メッシュ収束は7ケースすべて不合格。** 応力変化5%・ホットスポット移動の判定を満たさない。一部の対称位置へのホットスポット移動も含むが、判定を除外しない。上表は条件付きの参考値。CalculiXへの独立再解析はGmsh HXTの3Dメッシュ生成で失敗し、独立ソルバーによる比較結果は得られていない。

現行原本は `../_work/analysis/frame_a_rim_thickness/final_fea_groups/` の3グループ。集計は同ケースの `final_fea/child_exterior_structural_frame_full_fea.json`、`*_fea_convergence.json`、`fine_mesh_thresholds.json`。各native実行の終了コード1は収束不合格を含むため、そのまま保持する。最悪要素SF3以上・変位2 mm以下・線形ソルバー収束を確認しても、メッシュ収束の不合格を上書きしない。

現行形状の独立CalculiX解析は、体積・表面を照合した同一平面統合メッシュでもGmshが8856枚の退化三角形を報告し、HXTの3Dメッシュ生成で失敗した。印刷STLで面積ゼロ三角形がないこととは別のGmshメッシュ生成判定である。独立解の結果は得られていない。`ccx.log`、`ccx_status.json`、`ccx_input_geometry.json` に記録する。

## 外側接合板

旧48×24×8 mm板は、単体面外荷重の最悪要素安全率2.33で採用しなかった。48×26×20 mmへ補強し、座深さ8 mm、工具穴Ø10、M3×50の位置を維持した。旧版と寸法探索は `../_work/analysis/splice_load_capacity/` に保存する。

新しい接合板単体に98.07 Nを与え、2/1/0.5 mmで解析した。荷重・拘束は4穴のØ7ワッシャ領域を使う単体代理モデル。最細格子は約16.6万要素。

| 方向 | 最大変位 mm | 最悪要素安全率 |
|---|---:|---:|
| 長手軸 | 0.00711 | 37.88 |
| 面内せん断± | 0.0373 | 9.23 |
| 面外± | 0.1018 | 3.41 |

最細格子の基準は満たすが、**全5ケースの収束が不合格**。独立CalculiX解析もGmshメッシュ生成で失敗した。分割ボルト接合の接触・摩擦・締付、ナット引抜き、PETGクリープはこのモデルで扱わない。原本は `../_work/analysis/splice_recessed_stock/`。

外枠改訂で接合板の寸法・荷重・材料条件は変更しない。再出力によるSTLのSHA変更については、旧解析時の保管STLとの外形差0・体積差約1.3×10⁻⁶ mm³、全頂点と面中心の表面差約2.3×10⁻⁷ mmを照合し、nativeの2/1/0.5 mm格子の原点と材料セルが完全一致したため、上記のボクセル解析を再利用する。Boolean対称差は0.035 mm³となり厳しい絶対許容差を超えたため、その判定も記録した。再利用の根拠はnative格子の完全一致であり、新しい独立解析の成功を意味しない。現行ケースの `splice_reuse_provenance.json` を参照。

## 実スライスと重量

インストール済みBambu Studioのnative CLIで、5種類すべてスライス成功・造形範囲内。3MFの配置行列は平行移動のみで、平置きZ・面内方向を保つ。X1 Carbon・0.4 mmノズル、PETG Basic、Textured PEI Plate、0.20 mm、外周8、100% aligned rectilinear・0°、外側ブリム5、通常自動サポート45°。

| 種類 | 個数 | 1個のスライサ材料 g | 1個の時間 h | 支持材 g |
|---|---:|---:|---:|---:|
| lower_minus | 2 | 328.06 | 7.66 | 1.44 |
| lower_plus | 2 | 328.29 | 7.69 | 1.46 |
| upper_minus | 2 | 707.62 | 15.94 | 7.16 |
| upper_plus | 2 | 707.73 | 15.98 | 7.19 |
| splice | 12 | 24.75 | 0.81 | 0.00 |

スライサ推定は左右一式約4.44 kg・104.2時間、ブリム・支持材込み。CAD体積と1.25 g/cm³の理論質量は片側A＋接合板6個で約2.32 kg・左右約4.63 kg、購入金属を除く。元の片側2.62 kgから11.5%軽量化した。値の差はメッシュ体積の全量と実生成ツールパスの推定量の違いであり、実測重量ではない。

nativeの支持材なし造形性判定はA分割片のオーバーハングを検出する。実スライスは支持材を生成する。支持材の場所・除去可能性・接合面の品質はスライサ成功だけでは検証できず未確認。造形前に支持材を確認し、造形後に開口・穴・ナット座・工具通路を清掃する。最低肉厚の粗い格子検査にも解像度の限界があるため、全細部の造形性を認定しない。

現行スライス原本は `../_work/analysis/frame_a_rim_thickness/slice/`。納品コピーとSTL/3MFハッシュ・設定・個数は `assemblies/child_exterior_structure/print_jobs/manifest.json`。実機で印刷・荷重試験を行った記録はない。
