AquaBeacon/mechanical/assemblies/child_single_camera_topopt/results.html

# 単眼カメラ・縦向きライト：最適化結果

更新 2026-09-10T19:13:25+09:00。未完成の材料配置です。製造用モデルではありません。状態と数値の一覧 · 配置・全荷重図

## カメラ取付部（初回3 mm）：未合格

最低安全率 2.82 / p99.5 8.04、最大変位 0.789 mm、max_iterations



詳細レポート · 解析結果JSON · 材料配置STL（製造用ではありません）

## 可動ゲート（初回3 mm）：未合格

最低安全率 0.17 / p99.5 0.40、最大変位 33.486 mm、max_iterations



詳細レポート · 解析結果JSON · 材料配置STL（製造用ではありません）

## コアフレーム（初回3 mm）：未合格

最低安全率 1.12 / p99.5 2.27、最大変位 3.934 mm、max_iterations



詳細レポート · 解析結果JSON · 材料配置STL（製造用ではありません）

## カメラ取付部（2 mm再計算）：未合格

最低安全率 6.33 / p99.5 29.25、最大変位 0.141 mm、max_iterations



詳細レポート · 解析結果JSON · 材料配置STL（製造用ではありません）
