AquaBeacon/mechanical/assemblies/parent_hand_service/wave_retention_physical_tests.csv

case | target | actual_mass_g | temperature_C | angle_period_acceleration_cycles | case_relative_displacement_mm | screw_or_connector_movement | result | notes
wave_X- | Record actual wave-like conditions; design reference resultant2g
wave_X+ | Record actual wave-like conditions; design reference resultant2g
wave_Y- | Record actual wave-like conditions; design reference resultant2g
wave_Y+ | Record actual wave-like conditions; design reference resultant2g
wave_Z- | Record actual wave-like conditions; design reference resultant2g
wave_Z+ | Record actual wave-like conditions; design reference resultant2g
MAIN_USB_X- | 20N; case-relative displacement<=0.2mm
MAIN_USB_X+ | 20N; case-relative displacement<=0.2mm
MAIN_USB_Y- | 20N; case-relative displacement<=0.2mm
MAIN_USB_Y+ | 20N; case-relative displacement<=0.2mm
MAIN_USB_Z- | 20N; case-relative displacement<=0.2mm
MAIN_USB_Z+ | 20N; case-relative displacement<=0.2mm
MAIN_SD_X- | 20N; case-relative displacement<=0.2mm
MAIN_SD_X+ | 20N; case-relative displacement<=0.2mm
MAIN_SD_Y- | 20N; case-relative displacement<=0.2mm
MAIN_SD_Y+ | 20N; case-relative displacement<=0.2mm
MAIN_SD_Z- | 20N; case-relative displacement<=0.2mm
MAIN_SD_Z+ | 20N; case-relative displacement<=0.2mm
SONY_SD_X- | 20N; case-relative displacement<=0.2mm
SONY_SD_X+ | 20N; case-relative displacement<=0.2mm
SONY_SD_Y- | 20N; case-relative displacement<=0.2mm
SONY_SD_Y+ | 20N; case-relative displacement<=0.2mm
SONY_SD_Z- | 20N; case-relative displacement<=0.2mm
SONY_SD_Z+ | 20N; case-relative displacement<=0.2mm
