AquaBeacon/mechanical/assemblies/parent_hand_service/print_jobs/history_case_screw_access_20261012/README.md

# 旧同軸リングの3MF

2026-10-12、工具アクセス改訂前の3MFをpartsから移動。内容は変更せず保存。現在のリングを印刷する際は現行parts/PRINT.mdのSTLを使う。

SHA-256: 534e72a2a685f90bbb8d610ba422583002b1b6f57a1bf83357a084ec7055b44c
