AquaBeacon/mechanical/assemblies/child_horizontal_plate_frame/print_jobs/history/imported_20261021/README.md

# 既存3MFの保管

parts直下にあった専用メスではない既存ライト用メスの3MFを元バイト列のまま移動。出所とSHAはmanifest.json。現在のSTL・材料・数量との適合は未認定。現行一式は../../../parts/PRINT.mdを参照。
