AquaBeacon/mechanical/assemblies/parent_exterior/print_jobs/history/qr_standing_before_snug/README.md

# 不採用スライス履歴

既定normal支持でサポートの実G-codeがY=-2.53 mmまで出たため印刷しない。スライサのbed_fits判定だけでは見落とす。現行はprint_jobs/qr_standing/parent_oneplate_frame/。
